unofficialImportFromGitlab-PPC/powerpc-laptop-mobo/Xpedition/Mas100n1 ACB_0001_0/Output/AutoCad/CCI02102020_0001 - Copia.jpg

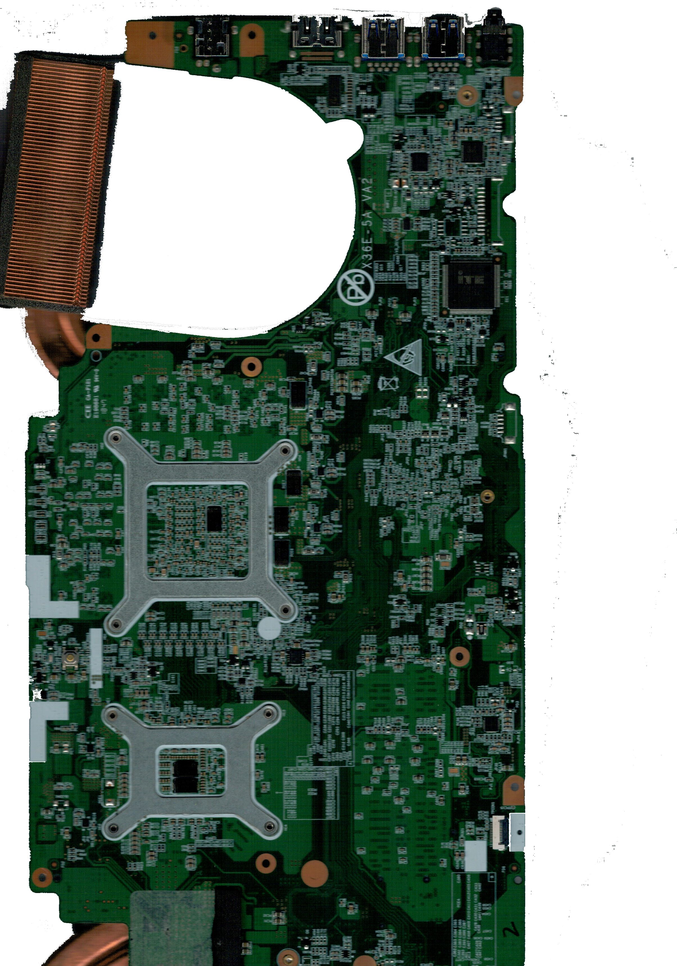
Xpedition/Mas100n1 ACB_0001_0/Output/AutoCad/CCI02102020_0001 - Copia.jpg
