unofficialImportFromGitlab-PPC/powerpc-laptop-mobo/README.md

Open Hardware PowerPC Notebook motherboard
https://www.powerpc-notebook.org/
https://www.powerprogress.org/
Copyright (C) 2018-2019-2020, Power Progress Community
CERN Open Hardware Licence v1.2
