unofficialImportFromGitlab-PPC/powerpc-laptop-mobo/Xpedition/Mas100n1 ACB_0001_0/Config/CCZSettings.txt

.FILETYPE CCZ_EXPORT_SETTINGS
.VERSION "VB99.1"
.DATE "02/20/2021 19:18:10"

!  This file contains settings for the most recent CCZ export session

.OUTPUT_FILE "D:\\PD-Master\\Mas\\Mas100n1 ACB_0001_0\\Output\\PCB Simulation\\Mas100n1 ACUBE_PORTABILE R_0.cce"
.UNITS mm

.CELL_LIBRARY 1

.HAZARDS 0

.MATERIALS 1

.UID 0

.INSTANCE_SPECIFIC_CELLS 1

.VARIANTS 1

.SCHEME "Default"
 ..SCHEME_LOCATION Local

 ..SCHEME_CHANGED 0
