unofficialImportFromGitlab-PPC/powerpc-laptop-mobo/Xpedition/Mas100n1 ACB_0001_0/Config/DXFSettings.txt

.FILETYPE DXF_EXPORT_SETTINGS
.VERSION "VB99.1"
.DATE "11/17/2020 17:44:55"

!  This file contains settings for the most recent DXF export session

.UNITS mm

.SCHEME "Default"
 ..SCHEME_LOCATION Local

.FILL_PADS 0

.BOARD_CONTENTS 0

.MIRROR_OUTPUT 0

.ITEM "Assembly Outlines Top"
 ..LAYER "Assembly_Outlines_Top"
 ..EXPORT 1

.ITEM "Board Outline"
 ..LAYER "Board_Outline"
 ..EXPORT 1
