unofficialImportFromGitlab-PPC/powerpc-laptop-mobo/Xpedition/Mas100n1 ACB_0001_0/Logic/classi segnali.docx

ddr3:

LEGGERE IL DOCUMENTO

Hardware and Layout Design Considerations for DDR3 SDRAM Memory Interfaces

EGNALI SD

SD_D0-SD_D3

SD_CLKS

SD-CMD

SEGNALI SD CON LUNGHEZZA INFERIORE A 10CM.

USB: Segnali USB a 90 ohm differenziali.

USB1_DP

USB1_DP

USB2_DP

USB2_DP

HUB_USB1_DP

HUB_USB1_DN

HUB_USB2_DP

HUB_USB2_DN

HUB_USB3_DP

HUB_USB3_DN

HUB_USB4_DP

HUB_USB4_DN

Segnali ethernet 100 ohm differenziali.

Segnali Ethernet:

TXRXP_A

TXRXM_A

TXRXP_B

TXRXM_B

TXRXP_C

TXRXM_C

TXRXP_D

TXRXM_D

Segnali PCIe

Segnali USB a 100 ohm differenziali.

USB3 90 OHM DIFFERENIALE

Video:

Display Port 100 ohm diferenziale.
