unofficialImportFromGitlab-PPC/powerpc-laptop-mobo/Xpedition/Mas100n1 ACB_0001_0/Logic/commenti/COMMENTI.docx

LAYER7

USB2_DP/DN è a 100 va fatta a 90 ohm

a 90 OHM VANNO FATTI ANCHE QUESTI:

HUB_USB1_DP/DN 90 OHM VANNO

USB_CAM_DN/DP

USB1_DN/DP

USB2_DN/DP

U2DM4/U2DP4

U2DM3/U2DP3

U2DM2/U2DP2

U2DM1/U2DP1

U3TXDP1/U3TXDN1

U3TXDP2/U3TXDN2

U3RXDP1/U3RXDN1

U3RXDP2/U3RXDN2

I CONDENSTATORI SOTTOSTANTI VANNO PIAZZATI VICINO A U1:

SEGNALI SATA, VANNO FATTI A 100 OHM

SATA_PCIE_RX0P/N

SATA_PCIE_RX1P/N

SEGNALI

PTX_0P/N E SATA_PCIE_TX0P/N

PTX_1PN E SATA_PCIE_TX1P/N

SATA_PECLKP/N

S3_TXP/N

S3_RXP/N

S2_TXP/N

S2_RXP/N

S1_TXP/N

S1_RXP/N

S0_TXP/N

S0_RXP/N
