unofficialImportFromGitlab-PPC/powerpc-laptop-mobo/Xpedition/Mas100n1 ACB_0001_0/Output/AutoCad/MisureSchedeSmartbook.pdf

## pin-out

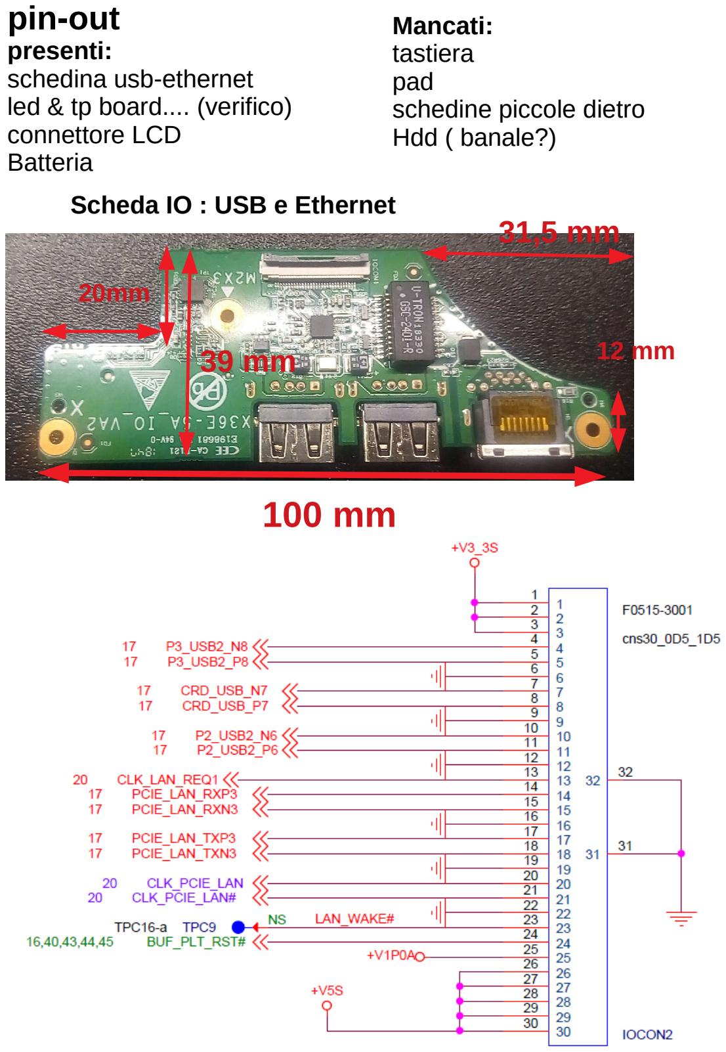
[picture p3: page 1]

presenti:
schedina usb-ethernet
led & tp board.... (verifico) connettore LCD
Batteria
Scheda IO : USB e Ethernet

100 mm

### 12 mm 39 mm

31,5 mm

20mm

Mancati:
tastiera
pad
schedine piccole dietro
Hdd ( banale?)

165 mm

8.5

LED & Touch Pad Board (davanti)

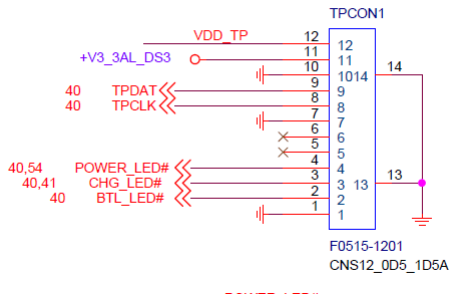
[picture p4: figure]

MXM 3.0 A 82x70mm

AMD E9172 MXM

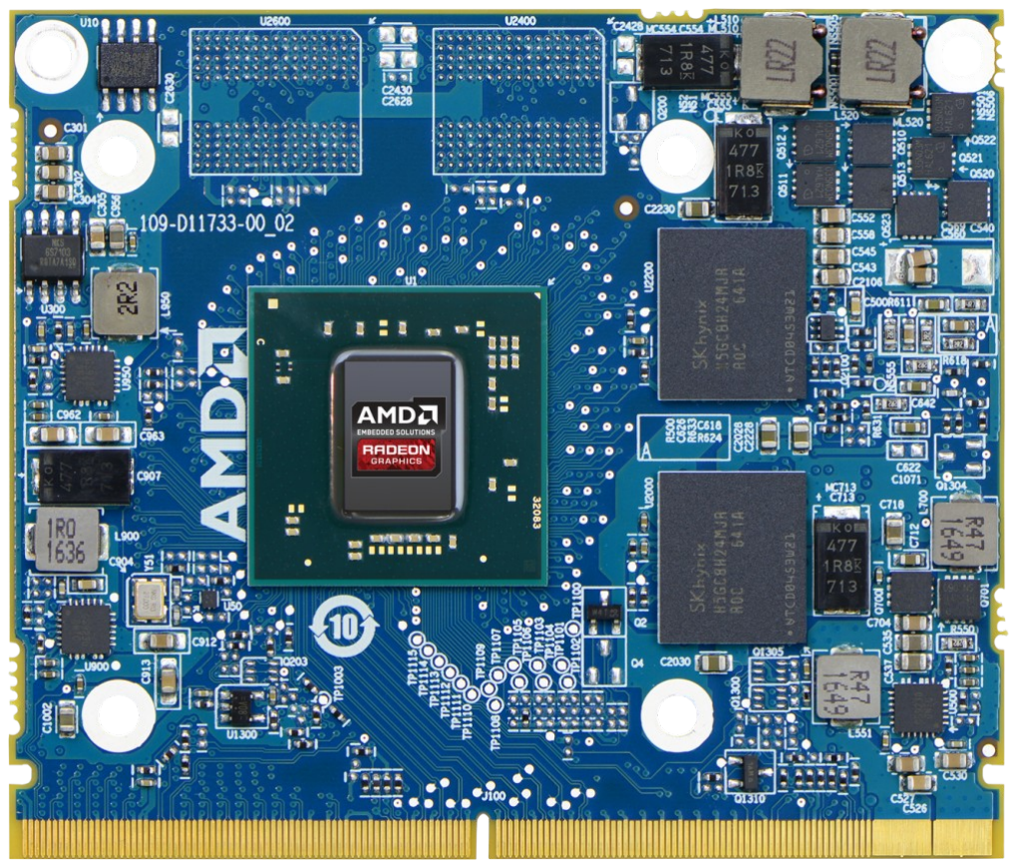
[picture p5: figure]

## Main Board

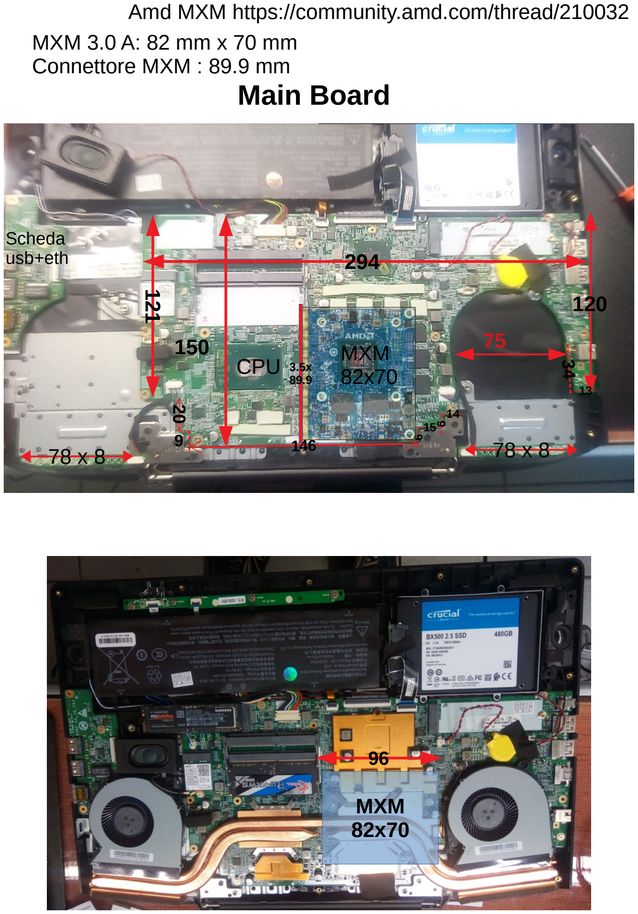
[picture p6: page 4]

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
MXM 3.0 A: 82 mm x 70 mm
Connettore MXM : 89.9 mm

96

Amd MXM https://community.amd.com/thread/210032

MXM
82x70

CPU

78 x 8 | 78 x 8

Scheda
usb+eth

MXM
82x70 ³.5x
89.9

pinout of LCD connector

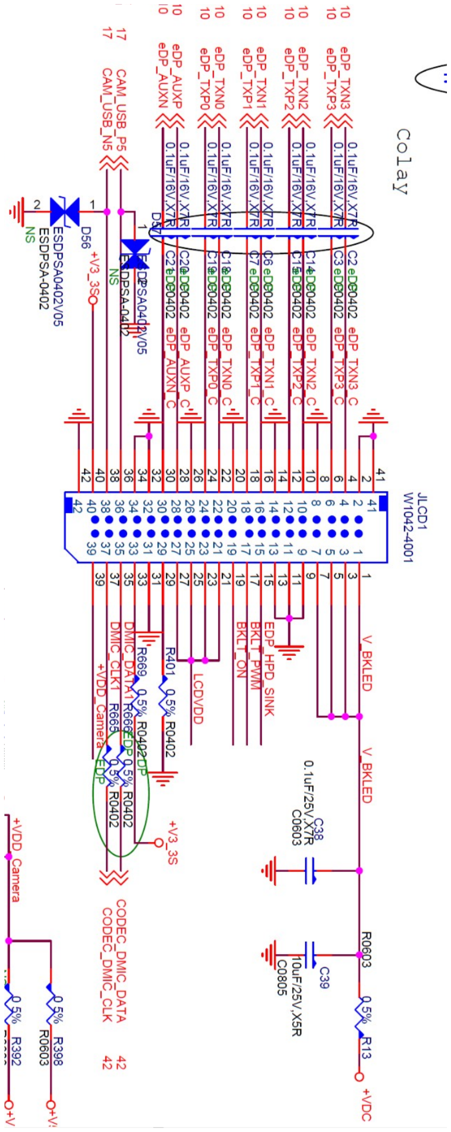
[picture p7: figure]
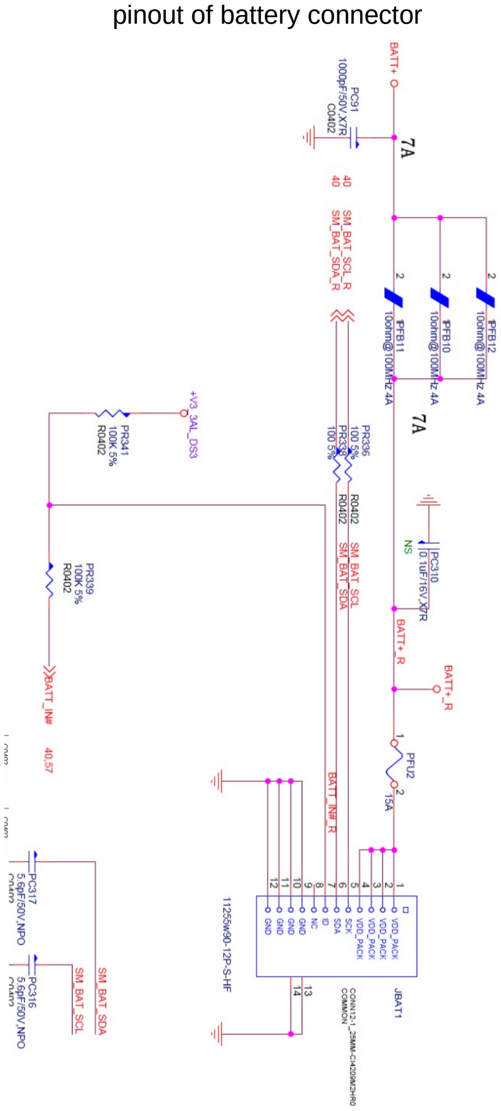
[picture p8: page 6]

pinout of battery connector

## Dissipatori

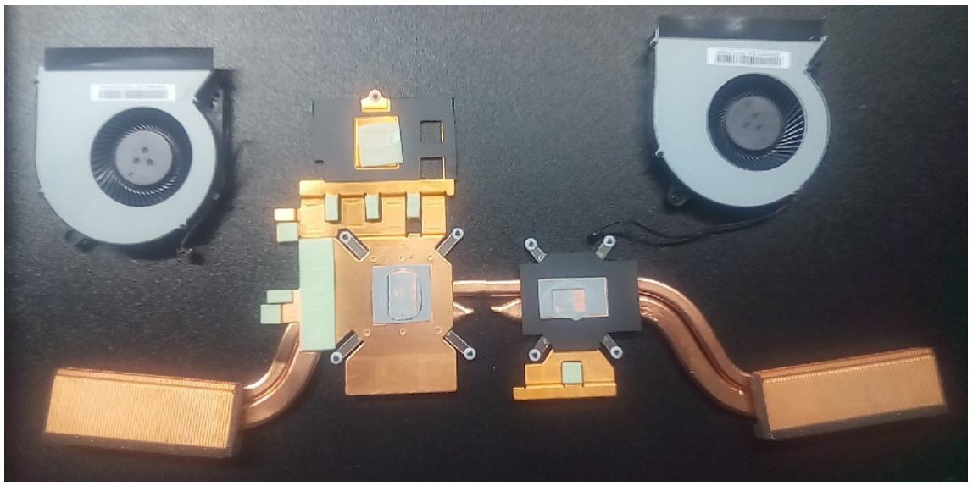
[picture p9: figure]
