unofficialImportFromGitlab-PPC/powerpc-laptop-mobo/Xpedition/Mas100n1 ACB_0001_0/Logic/commenti/LAN_PCIE_RXP_N.png

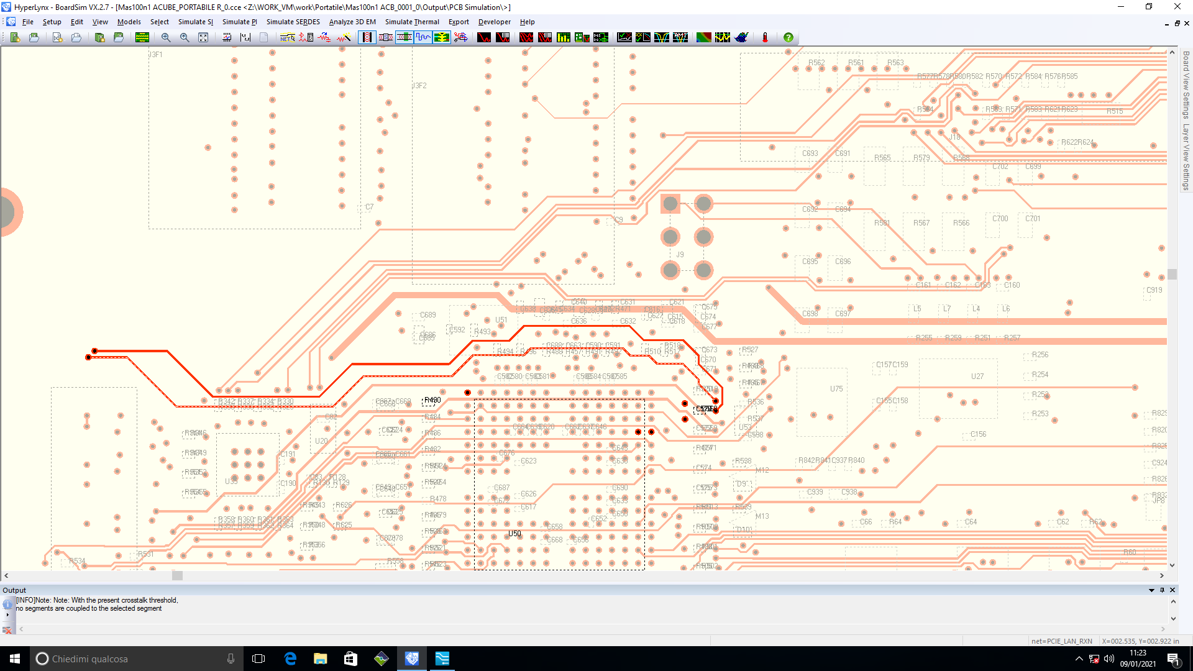
Xpedition/Mas100n1 ACB_0001_0/Logic/commenti/LAN_PCIE_RXP_N.png
