unofficialImportFromGitlab-PPC/powerpc-laptop-mobo/Xpedition/Mas100n1 ACB_0001_0/Logic/commenti/LAYER_10_NET2_FORO.png

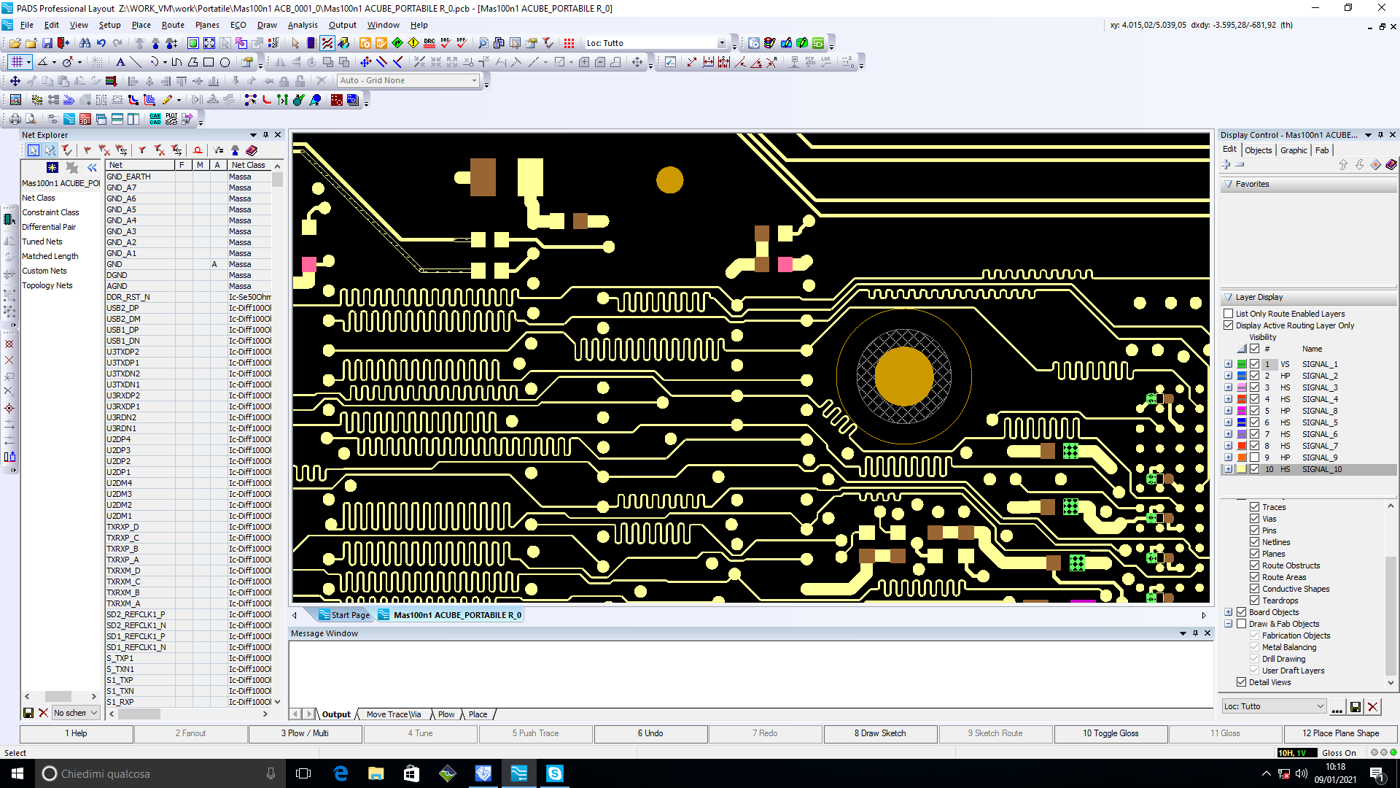
Xpedition/Mas100n1 ACB_0001_0/Logic/commenti/LAYER_10_NET2_FORO.png
