unofficialImportFromGitlab-PPC/powerpc-laptop-mobo/Xpedition/Mas100n1 ACB_0001_0/Logic/commenti/LFE_NET2_BORDO.png

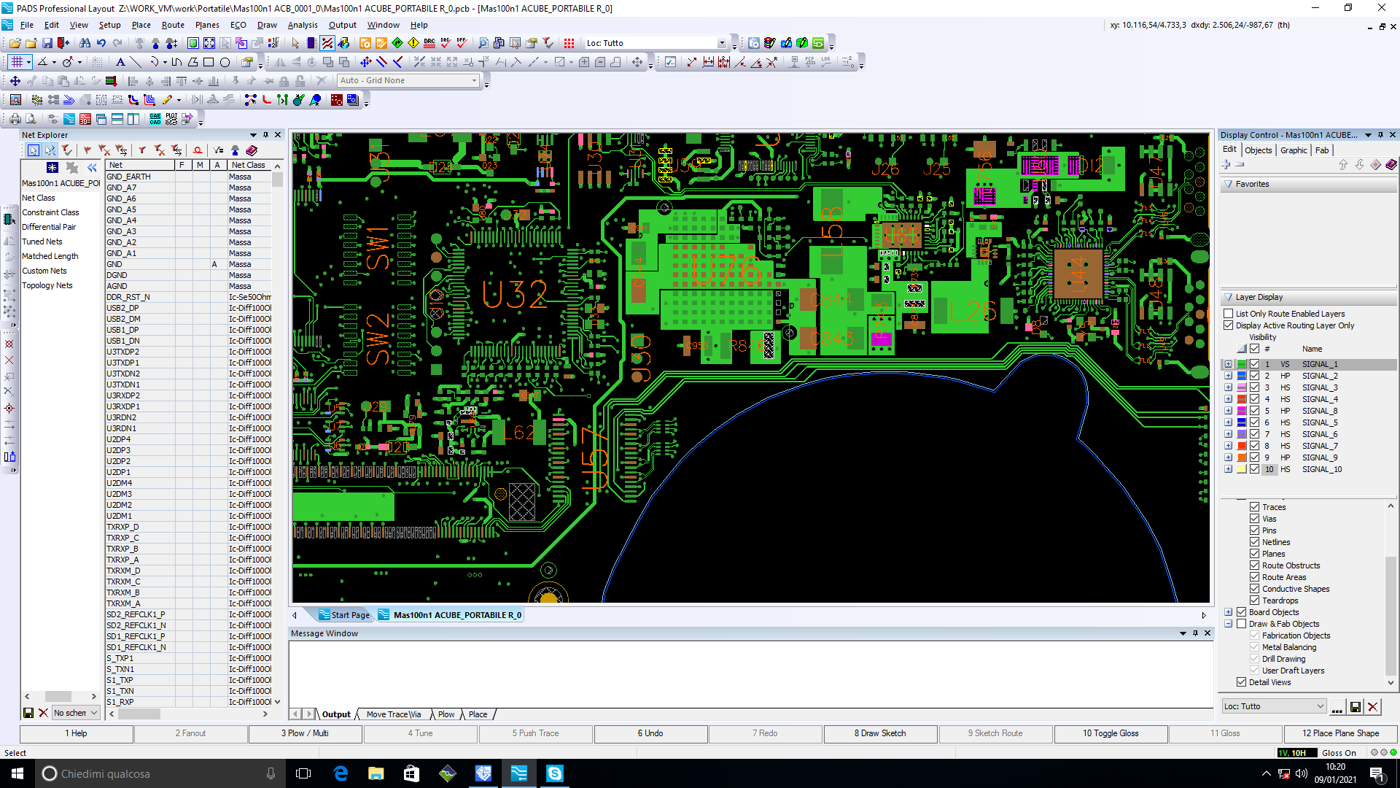
Xpedition/Mas100n1 ACB_0001_0/Logic/commenti/LFE_NET2_BORDO.png
