unofficialImportFromGitlab-PPC/powerpc-laptop-mobo/Xpedition/Mas100n1 ACB_0001_0/Logic/bom_portatile.ods

Item Number | Quantity | Part Reference | Value | Description | PCB Footprint | Manufacturer 1 | Manufacturer Part Number 1 | Distributor 1
1 | 9 | BATT1 BTH1 JP1 JP3 JP4 JP5 JP6 JP7 JP8 | 3V 5mAh | BATTERY LITHIUM COIN 3V 6.8mm Rechargable |  | Panasonic - BSG | ML-621S/ZTN | DIGIKEY (P007-ND)
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
16 | 4 | C209 C225 C235 C259 | 4,7nF | COND.CER. 4,7nF 50V 0402 X7R SMD | SMD_0402 | MURATA | GRM155R71H472KA01D | DIGIKEY(490-1308-2-ND)
17 | 23 | C211 C212 C214 C215 C216 C217 C218 C221 C226 C227 C231 C232 C233 C248 C249 C272 C273 C555 C588 C589 C985 C988 C990 | 100nF | COND.CER.100NF 50V 0603 X7R SMD | SMD_0603 | PANASONIC | ECJ1VB1H104K | CLAITRON LASI SILVESTAR S.R.L.
18 | 31 | C222 C223 C250 C251 C252 C274 C275 C276 C277 C278 C279 C283 C284 C288 C289 C290 C291 C292 C293 C294 C295 C296 C297 C298 C299 C300 C301 C302 C306 C307 C308 | 100NF | LCC - SMD/SMT 0201 0.1uF 10volts X7S +/-10% | SMD_0201 | TDK | C0603X7S1A104K030BC | MOUSER(810-C0603X7S1A104K )
19 | 10 | C229 C230 C245 C246 C267 C268 C345 C346 C366 C367 | 2.2UF | CAP CER 2.2UF 25V X5R 0402 | SMD_0402 | MURATA | GRM155R61E225ME15D | DIGIKEY(490-10457-2-ND)
20 | 6 | C247 C271 C347 C368 C845 C983 | 3,3NF | COND.CER. 3,3NF 50V 0402 X7R SMD | SMD_0402
21 | 12 | C282 C287 C305 C311 C703 C704 C705 C706 C707 C708 C709 C710 | 220NF | COND.CER. 220NF 10V 0402 X7R SMD | SMD_0402 | MURATA | GRM155R61A224KE19 | MURATA ELETTRONICA SPA
22 | 2 | C387 C392 | 27PF | CAP CER 27PF 50V 5% NP0 0402 | SMD_0402 | TDK | C1005C0G1H270J | DIGIKEY (445-1240-1-ND)
23 | 49 | C390 C395 C396 C397 C400 C401 C402 C405 C406 C409 C412 C413 C414 C415 C416 C417 C446 C450 C454 C458 C462 C468 C472 C473 C474 C475 C477 C478 C479 C482 C486 C531 C532 C533 C534 C535 C536 C537 C538 C539 C540 C541 C542 C543 C544 C545 C548 C549 C968 | 10NF | COND.CER. 10NF 50V 0402 X7R SMD | SMD_0402 | KEMET | C0402C103K5RACTU | TTI ITALY SRL
24 | 8 | C447 C451 C455 C459 C463 C469 C483 C487 | 1NF | COND.CER. 1NF 50V 0402 NPO SMD | SMD_0402 | YAGEO | 223858715523 | CLAITRON LASI SILVESTAR S.R.L.
25 | 2 | C464 C465 | 18PF | CAP CER 18PF 50V 5% NP0 0402 | SMD_0402 | TDK | C1005C0G1H180J | DIGIKEY (445-1238-1-ND)
26 | 1 | C488 | 100uF | CAP CER 100UF 6.3V 20% X5R 0805 | SMD_0805 | MURATA | GRM21BR60J107ME15L | FARNELL(2494476)
27 | 2 | C558 C559 | 8pF | CAP CER 8PF 50V C0G/NPO 0402 | SMD_0402 | yageo | CC0402DRNPO9BN8R0 | DIGIKEY (311-1639-1-ND)
28 | 1 | C597 | 150PF | COND.CER. 150PF 50V 0402 5% COG SMD | SMD_0402 | MURATA | GRM1555C1H151JD01D | MURATA ELETTRONICA SPA
29 | 4 | C599 C600 C601 C602 | 100uF | COND.CER.100uF 6,3V 1210 X5R 20% SMD | SMD_1210 | MURATA | GRM32ER60J107ME20L | MURATA ELETTRONICA SPA
30 | 4 | C609 C610 C611 C614 | 33PF | COND.CER. 33PF 50V 0402 5% COG SMD | SMD_0402 | Murata | GRM1555C1H330JZ01D_ | MURATA ELETTRONICA SPA
31 | 4 | C680 C764 C958 C981 | 22PF | COND.CER. 22PF 50V 0402 NPO 5% SMD | SMD_0402 | MURATA | GRM1555C1H220JZ01 | MURATA ELETTRONICA SPA
32 | 1 | C740 | 1NF | CAP CER 1000PF 2KV 20% X7R 1808 | SMD_1808 | AVX | 1808GC102MAT1A | DIGIKEY(709-1040-1-ND)
33 | 2 | C744 C761 | 10uF | COND.CER.10uF 6,3V 10% 0805 X5R SMD | SMD_0805 | KEMET | C0805C106K9PA!A | TTI ITALY SRL
34 | 2 | C745 C746 | 20PF | COND.CER. 20PF 50V 0402 NP0 SMD | SMD_0402 | MURATA | GRM1555C1H200JZ01D | MURATA ELETTRONICA SPA
35 | 1 | C756 | 220uF | CAP TANT 220UF 16V 10% 2917 | SMD_CASE_D | Kemet | T491D227K016ZT | DIGIKEY (399-5124-1-ND)
36 | 5 | C767 C768 C770 C771 C773 | 1uF | CAP CER 1UF 10V 10% X5R 0402 | SMD_0402 | MURATA | GRM155R61A105KE15D | DIGIKEY (490-3890-1-ND)
37 | 14 | C780 C781 C787 C789 C790 C791 C794 C795 C888 C891 C907 C908 C923 C924 | 100PF | COND.CER. 100PF 50V 0402 NPO 5% SMD | SMD_0402 | MURATA | GRM1555C1H101JD01D | MURATA ELETTRONICA SPA
38 | 2 | C783 C785 | 1UF | CAP CER 1.0UF 6.3V 10% X5R 0402 | SMD_0402 | MURATA | GRM155R60J105KE19D | DIGIKEY (490-1320-2-ND)
39 | 2 | C786 C788 | 100PF | 0402 100pF 50volts C0G 5% | SMD_0402 | MURATA | GRM1555C1H101JZ01D | MOUSER(81-GRM1555C1H101JZ1D)
40 | 8 | C796 C797 C798 C799 C833 C951 C956 C957 | 100uF | CAP CER 100UF 16V 20% X5R 1210 | SMD_1210 | Taiyo Yuden | EMK325ABJ107MM-T | DIGIKEY (587-3152-2-ND)
41 | 2 | C810 C811 | 2pF | CAP CER 2PF 50V C0G/NPO 0402 | SMD_0402 | yageo | CC0402CRNPO9BN2R0D | DIGIKEY(311-1006-2-ND)
42 | 2 | C838 C852 | 330pF | CAP CER 330PF 50V 5% C0G 0402 HiRel | SMD_0402 | TDK | CGJ2B2C0G1H331J050BA | DIGIKEY(445-8059-1-ND)
43 | 4 | C841 C843 C844 C846 | 470uF | COND.TANT. 470uF 2v CASE-GX SMD | SMD_CASE_GX | PANASONIC | EEF-GX0D471R | MOUSER(667-EEFGX0D471R)
44 | 3 | C847 C848 C849 | 22UF | CAP CER 22UF 16V 10% X5R 1206 | SMD_1206 | SAMSUNG | CL31A226KOHNNNE | DIGIKEY (1276-3048-2-ND)
45 | 1 | C850 | 2,2UF | CAP CER 2.2UF 25V X5R 0402 | SMD_0402 | Murata | GRM155R61E225ME15D | DIGIKEY ( 490-10457-2-N)
46 | 1 | C851 | 4,7UF | CAP CER 4.7UF 10V 20% X5R 0402 | SMD_0402 | TDK | C1005X5R1A475M050BC | DIGIKEY (445-8023-1-ND)
47 | 1 | C944 | 100uF | CAP ALUM 100UF 35V 20% SMD | SMD_6.3X6.3x6.1 | Panasonic | EEE-FT1V101AP | MOUSER (667-EEE-FT1V101AP)
48 | 3 | C962 C970 C973 | 100nF | COND.CER.100NF 25V 0603 X7R SMD | SMD_0603 | PHILIPS | PHY223891615649 | CAMEL ELETTRONICA SRL #
49 | 1 | C969 | 1,5nF | COND.CER. 1,5nF 50V 0402 X7R SMD | SMD_0402 | YAGEO | 04022R152J9B20D | CLAITRON LASI SILVESTAR S.R.L.
50 | 1 | C971 | 68NF | COND.CER. 68NF 50V 0402 X7R SMD | SMD_0402 | MURATA | GRM155R61C683KA01J | MURATA ELETTRONICA SPA
51 | 1 | C972 | 150NF | CAP CER 0.15UF 16V 10% X7R 0402 | SMD_0402 | TDK | C1005X7R1C154K050BC | DIGIKEY(445-5934-1-ND)
52 | 1 | C982 | 100uF | CAP ALUM 100UF 35V 20% SMD | SMD_8.3X8.3 | United chemi-Con | EMVY350ADA101MHA0G | DIGIKEY (565-2477-1-ND)
53 | 1 | C991 | 220NF | COND.CER. 220NF 10V 0402 X5R SMD | SMD_0402 | TAIYO YUDEN | LMK105BJ224KV-F | DIGIKEY(587-1228-1-ND)
54 | 2 | CN1 CN2 | 0483950003 | CONN RCP USB3.0 TYPEA 9POS TH RA MID mount | 9 PIN PTH | molex | 0483950003 | DIGIKEY(WM10415TR-ND)
55 | 11 | D1 D3 D4 D7 D9 D10 D13 D17 D18 D19 D22 | LED VERDE | LED CHIPLED VERDE 40mcd 570nm | SMD_0603 | DIALIGHT | 598-8070-107F | MOUSER(645-598-8070-107F)
56 | 1 | D2 | BAS116 | DIODO, ALTA VELOCITÀ, SOD123 | SOD123 | NXP | BAS116H,115 | FARNELL(2319131)
57 | 3 | D5 D6 D11 | BAT54 | DIODE SCHOTTKY 30V 200MA SOT-23 | SOT-23 | ZETEX | BAT54 | FARNELL (1467516)
58 | 1 | D8 | BAS70LT1G | DIODE SCHOTTKY 70V SOT23 | SOT-23 | ON_SEMI | BAS70LT1G | DIGIKEY (BAS70LT1GOSCT-ND)
59 | 1 | D12 | B340B-13-F | DIODE SCHOTTKY 40V 3A SMB | SMB | DIODES | B340B-13-F | DIGIKEY(B340B-FDIDKR-ND)
60 | 1 | D14 | MMBZ18 | DIODO, TVS ZENER DUAL, 18V, 40W, SOT23 | SOT_23 | MOTOROLA | MMBZ18VALT1G | DIGIKEY(MMBZ18VALT1GOSCT-ND)
61 | 1 | D15 | MBR140SFT1G | DIODE SCH PWR RECT 1A 40V SOD123 | sod123lf | ON SEMICONDUCTOR | MBR140SFT1G | DIGIKEY(MBR140SFT1GOSTR-ND)
62 | 1 | D16 | LED GIALLO | LED CHIPLED GIALLO 160Deg 6.5mcd | SMD_0603 | VISHAY | TLMY1000-GS08 | MOUSER(78-TLMY1000)
63 | 1 | D20 | LED ROSSO | LED CHIPLED ROSSO | SMD_0603 | KINGBRIGHT | APT1608SRCPRV | MOUSER(604-APT1608SRCPRV)
64 | 1 | D21 | BAS70-05-7-F | DIODE SCHOTTKY 70V 70MA SOT23 | SOT-23 | DIODES | BAS70-05-7-F | DIGIKEY(BAS70-05FDICT-ND)
65 | 3 | D23 D24 D25 | B130LAW-7-F | DIODE SCHOTTKY 30V 1A SOD123 | SOD-123 | DIODES | B130LAW-7-F | DIGIKEY (B130LAW-FDICT-ND)
66 | 1 | D26 | 1.5SMC36CA | 1.5SMC36A VARISTORE BIDIREZION. 36V SMD | SMC | LITTLEFUSE | 1.5SMC36CA | EBV ELEKTRONIK S.R.L.
67 | 2 | FL1 FL2 | NFM18PC105R0J3D | FILTER LC HIGH FREQ 1UF 0603 | SMD_0603 | MURATA | NFM18PC105R0J3D | DIGIKEY(490-6970-1-ND)
68 | 10 | FL3 FL4 FL5 FL6 FL7 FL8 FL9 FL10 FL11 FL12 | DLP11SN161SL2 | CHOKE COMMON MODE 90 OHM 0805 | SMD | MURATA | DLW21HN900SQ2L | DIGIKEY(490-1064-1-ND)
69 | 2 | FL13 FL14 | MCZ2010CH900L4T | CHOKE COMM MODE 90 OHM SMD HDMI | SMD | TDK | MCZ2010CH900L4T | DIGIKEY(445-9345-1-ND)
70 | 1 | FUSE1 | 0470.500DR | Surface Mount Fuses SMD FA 0.5A | SMD | LITTLEFUSE | 0470.500DR | MOUSER(576-0470.500DR )
71 | 1 | J1 | JMP 3 | STRIP MASC.1x3P CS.p=2 mm | PTH | 3M | 951103-8622-AR | DIGIKEY(3M9322-ND)
72 | 1 | J2 | DM3AT | CONN MICRO SD R/A PUSH-PULL SMD | SMD 9 PIN | HIROSE | DM3AT-SF | DIGIKEY (HR1964CT-ND)
73 | 1 | J3 | STRIP 16 | STRIP MASCH.2x8P CS.p=2.0mm SMT | 8X2P=2.0mm SMT | SAMTEC | TMMH-108-01-L-DV | FARNELL(2024017)
74 | 1 | J4 | SFW30R-1STE9LF | FFC e FPC 30P SIDE ENTRY SMT 1MM LOWER CONTACT | 30 PIN PASSO 1mm | AMPHENOL | SFW30R-1STE9LF | MOUSER(649-SFW30R-1STE9LF)
75 | 1 | J5 | 5051101292 | CONN FPC BOTTOM 12POS .5MM R/A | 12 PIN PASSO 0.5mm | MOLEX | 5051101292 | DIGIKEY(WM12368TR-ND)
76 | 1 | J6 | 0527460471 | CONN FFC/FPC 0.5MM 4POS R/A BOT CONT SMD | 4 PIN PASSO 0.5mm | MOLEX | 0527460471 | DIGIKEY(WM6768TR-ND)
77 | 2 | J7 J8 | SM12B-SRSS-TB(LF)(SN) | CONN HEADER FOT FPC 12x1POS 1MM SMD | 12 pin smd p=1mm | JST | SM12B-SRSS-TB(LF)(SN) | DIGIKEY(455-1812-2-ND)
78 | 1 | J9 | STRIP 2x3 | STRIP MASC.2x3P CS.p=2.54mm | 2.54mm | TE CONNECTIVITY / AMP | 9689567RL
79 | 1 | J10 | STRIP 8 | STRIP MASC.1x8P CS.p=2.54mm | PTH | SAMTEC | TSW-108-24-T-S | CLAITRON LASI SILVESTAR S.R.L.
80 | 1 | J11 | STRIP_14 | STRIP MASCH 1X14P p=2.54mm PTH | PTH | MOLEX | 0022284143 | DIGIKEY(WM50016-14-ND)
81 | 1 | J12 | MCV 1,5/12-G-3,5 | 12X1 3.5 | 12X1 3.5 | PHOENIX | MCV 1,5/12-G-3,5 | SAMTEC
82 | 1 | J13 | MDT180M01001 | Connettori PCI Express/PCI 67P SMT RCPT H1.8 M Key | 67 PIN PASSO 0.5mm | AMPHENOL | MDT180M01001 | MOUSER(523-MDT180M01001)
83 | 1 | J14 | 54132-3062 | CONN FPC/FFC .50mm 30 pos bot contact | 30 PIN PASSO 0.5mm | MOLEX | 54132-3062 | MOUSER(538-54132-3062)
84 | 1 | J15 | MDT180E01001 | Connettori PCI Express/PCI 67P SMT RCPT H1.8 E Key | 67 PIN PASSO 0.5mm | AMPHENOL | MDT180E01001 | MOUSER(523-MDT180E01001)
85 | 1 | J16 | MDT180B01001 | Connettori PCI Express/PCI 67P SMT RCPT H1.8 B Key | 67 PIN PASSO 0.5mm | AMPHENOL | MDT180B01001 | MOUSER(523-MDT180B01001)
86 | 1 | J17 | SIM Holder 6p | CONNECTOR SIM CARD W/OUT BOSS | SMD 6 PIN | AVX | 045036006211862+ | Mouser(581-045036006211862+)
87 | 1 | J18 | MM70-314-310B1-2-R300 | MXM3.0 CARD EDGE CONNECTOR | 324 PIN 0.5mm | JAE ELECTRONICS | MM70-314-310B1-2-R300 | MOUSER(656-MM70314310B12R)
88 | 1 | J19 | 2041481-1 | HDMI TYPE A RECEPT RA SMD OFFSET CONN | 19 PIN SMD | TE | 2041481-1 | MOUSER (571-2041481-1)
89 | 1 | J20 | DF13A-40DP-1.25V(55) | Terminali e capicorda 1.25MM V PIN HEADER 40P SMT | SMD 2X20 P_125MM | HIROSE | DF13A-40DP-1.25V(55) | DIGIKEY(H10166-ND)
90 | 1 | J21 | SJ-43504-SMT-TR | 3.5 PHONEJACK TRRS MID Mount | SMT | CUI Inc | SJ-43504-SMT-TR | DIGIKEY(CP-43504SJCT-ND - Cut )
91 | 3 | J22 J23 J24 | 0533980271 | HDR 2 CKT VERTICAL 1.25MM | 2P SMD | MOLEX | 0533980271 | DIGIKEY(WM7606CT-ND)
92 | 2 | J25 J26 | POM-5046P-C3310-R | MIC COND ANALOG OMNI -46DB 6MM D | 6X5_2 (mm) | PUI AUDIO | POM-5046P-C3310-R | DIGIKEY(668-1677-ND)
93 | 1 | J27 | 53780-1270 | Terminali e capicorda 1.25 WtB ssy 12Ckt | 1X12 1.25mm smd | MOLEX | 53780-1270 | MOUSER(538-53780-1270)
94 | 2 | J28 JP9 | JMP 3 | STRIP MASC.1x3P CS.p=2.54mm | PTH | SAMTEC | TLW-103-05-G-S | FARNELL(1668490)
95 | 3 | J29 J32 J33 | JMP 2 | STRIP MASC.1x2P P=2.54 H=7.62 | PTH | SAMTEC | TLW-102-05-G-S | FARNELL(1668488)
96 | 2 | J30 J31 | B3B-XH-A (LF)(SN) | CONN WIRE TO BOARD HEADER. VERTICAL. 3WAY | 3_PIN_PASSO_2.5mm | JST | B3B-XH-A (LF)(SN) | FARNELL (1516277)
97 | 1 | J34 | 694105309102 | CC WR-DC PwrJk CtrPnTHT Right Angled | JACK_PTH | WURTH | 694105309102 | MOUSER(710-694105309102)
98 | 1 | J3F1 | 2013022-1 | Connettori DIMM SEMI-HARD TRAY DDR3 204P 4H STD | 204 PIN PASSO 0.6mm | TE CONNECTIVITY | 2013022-1 | MOUSER(571-2013022-1)
99 | 1 | J3F2 | 2-2013310-1 | DIMM EMBOSS TAPE DDR3 204P 9.2H STD | 204 PIN PASSO 0.6mm | TE | 2-2013310-1 | MOUSER(571-2-2013310-1)
100 | 1 | JPS1 | SOLDER JUMPER X 2 | SODER JUMPER SU PCB | PCB
101 | 30 | L1 L2 L3 L4 L5 L6 L7 L8 L9 L10 L23 L27 L28 L29 L30 L32 L44 L45 L46 L47 L48 L49 L50 L51 L52 L53 L54 L55 L56 L57 | BLM18EG601SN1 | FERRITE BEAD 600ohm 500mA 0603 SMD | SMD_0603 | MURATA | BLM18EG601SN1 SMD | MURATA ELETTRONICA SPA
102 | 5 | L11 L12 L13 L14 L15 | HF70ACB201209-T | FERRITE CHIP 10 OHM 600MA 0805 | SMD_0805 | TDK | HF70ACB201209-T | DIGIKEY (445-6180-1-ND)
103 | 8 | L16 L17 L18 L20 L21 L22 L24 L25 | BLM15GG471SN1D | FERRITE CHIP 470 OHM 200MA 0402 | SMD_0402 | MURATA | BLM15GG471SN1D | DIGIKEY ( 490-5198-1-ND)
104 | 1 | L19 | 7427927161 | FERRITE BEAD 600R 0.25A 0402 | SMD_0402 | WURTH | 7427927161 | FARNELL (1961693)
105 | 1 | L26 | 3.3uH | INDUCTOR SHIELD PWR 3.3UH SMD | SMD_SRU1028 | BOURNS INC. | SRU1028-3R3Y | DIGIKEY (SRU1028-3R3YCT-ND)
106 | 1 | L31 | 1uH | Induttori fissi 1.0uH 2.08A 68mOhms Pwr Circuit Inductor | Ind_2016 | TDK | VLS201612CX-1R0M | MOUSER(810-VLS201612CX-1R0M )
107 | 1 | L33 | 15uH | INDUCTOR POWER .68UH 17A SMD 6.90mm x 6.90mm | SMD | WURTH | 744311068 | DIGIKEY(732-1149-1-ND)
108 | 10 | L34 L35 L36 L37 L38 L39 L40 L41 L42 L43 | BLM15AG121SN1D | FERRITE CHIP 120 OHM 500MA 0402 | SMD_0402 | MURATA | BLM15AG121SN1D | DIGIKEY (490-1005-2-ND)
109 | 1 | L58 | 270nH | Induttori fissi 270nH Shld 20% 35.5A 228mOhms | SMD_7_65X11mm | COILCRAFT | SLC1175-271MEB | MOUSER(994-SLC1175-271MEB)
110 | 4 | L60 L61 L62 L65 | 1uH | FIXED IND 1UH 11A 16.5 Mohm SMD | SMD | VISHAY | IHLP2525CZER1R0M01 | MOUSER(70-IHLP2525CZER1R0M0)
111 | 2 | L63 L64 | 2.2uH | FIXED IND 2.2UH 7A 16.5 Mohm SMD | SMD | VISHAY | IHLP2525CZER2R2M1 | MOUSER(70-IHLP2525CZER2R2)
112 | 1 | L66 | 10uH | Induttori fissi WE-HCI Flat 1050 10uH 7.2A | SMD_10_2X10_5 | WURTH | 7443251000 | MOUSER(710-7443251000)
113 | 1 | L67 | 22uH | INDUTTANZA 22uH 1,67A DR73-220 SMD | SMD_DR73 | COILTRONICS | DR73-220-R | CLAITRON LASI SILVESTAR S.R.L.
114 | 1 | L68 | ACM1513-551-2PL-TLHF | CHOKE COMM MODE 550 OHM 10A SMD | SMD | TDK | ACM1513-551-2PL-TLHF | DIGIKEY(445-9331-1-ND)
115 | 1 | M1 | MT8KTF51264HZ-1G6 |  | none
116 | 1 | M2 | MT8KTF51264HZ-1G6 |  | none
117 | 7 | M3 M4 M5 M6 M7 M8 M9 | DMN3730U-7 | DMN3730U-7 N 750mA 30V POWER MOS | SOT23 | DIOES | DMN3730U-7 | DIGIKEY(DMN3730U-7DICT-ND)
118 | 5 | M10 M11 M12 M13 M14 | FDV301N | FDV301N N CHANNEL DIGITAL FET | SOT23 | FAIRCHILD | FDV301N (ROHS COMPLIANT) | CLAITRON LASI SILVESTAR S.R.L
119 | 9 | Q1 Q2 Q14 Q15 Q16 Q17 Q18 Q19 Q20 | 2N7002L | TRAN NMOS 60V 115MA SOT23 | SOT23 | ON SEMICONDUCTORS | 2N7002LT1G | DIGIKEY(2N7002LT3GOSCT-ND)
120 | 1 | Q11 | SI4925DY | Trans MOSFET P-CH 30V 5.3A 8-Pin SOIC | SOIC_8 | ON SEMICONDUCTOR | SI4431ADY-T1 | ARROW (SI4431ADY-T1)
121 | 1 | Q3 | BC856BLT1G | TRANS PNP 65V 0.1A SOT23 | SOT_23 | ON SEMICONDUCTOR | BC856BLT1G | DIGIKEY(BC856BLT1GOSCT-ND)
122 | 1 | Q4 | BC847ALT1G | TRANS NPN 45V 0.1A SOT23 | SOT_23 | ON SEMI | BC847ALT1G | DIGIKEY (BC847ALT1GOSCT-ND)
123 | 4 | Q5 Q6 Q7 Q8 | NDC7002N | MOSFET 2N-CH 50V 0.51A SSOT6 | SSOT_6 | ON SEMI | NDC7002N | DIGIKEY (NDC7002NCT-ND)
124 | 1 | Q9 | BSR17A | TRANS NPN 40V 0.2A SOT-23 | SOT_23 | ON SEMI | BSR17A | DIGIKEY(BSR17ATR-ND)
125 | 1 | Q12 | SI4431ADY-T1 | Trans MOSFET P-CH 30V 5.3A 8-Pin SOIC | SOIC_8 | VISHAY | SI4431ADY-T1 | ARROEW (FDC645N)
126 | 1 | Q13 | FDC655BN | MOSFET N-CH 30V 6.3A 6-Pin TSOT-23 | TSOT-23 | ON SEMI | FDC655BN | ARROW (FDC655BN)
127 | 3 | Q21 Q22 Q23 | IRLML6346TRPBF | MOSFET N-CH 30V 3.4A SOT23 | SOT-23 | ON SEMI | IRLML6346TRPBF | DIGIKEY (IRLML6346TRPBFCT-ND)
128 | 2 | Q24 Q25 | SiR870DP | MOSFET 100V 60A 20W 6mohm @ 4.5V | PowerPAK-1212-8 | VISHAY | SiR870DP-T1-GE3 | DIGIKEY(SiR870DP-T1-GE3CT-ND)
129 | 85 | R1 R7 R8 R10 R12 R14 R16 R18 R20 R23 R24 R25 R26 R27 R28 R29 R30 R31 R32 R33 R34 R38 R39 R48 R50 R51 R52 R53 R54 R55 R60 R63 R71 R72 R73 R74 R76 R77 R78 R79 R80 R81 R82 R83 R84 R85 R86 R87 R88 R89 R90 R91 R92 R93 R94 R95 R100 R103 R104 R105 R106 R107 R108 R109 R116 R119 R120 R121 R126 R127 R129 R130 R158 R167 R182 R183 R184 R238 R262 R263 R419 R593 R594 R879 R881 | 4,7K | RESIS.CHIP 4,7K 5% 0402 SMD | SMD_0402 | ROYAL OHM | RESIS.CHIP 4,7K 5% 0402 SMD | CAMEL ELETTRONICA SRL #
130 | 30 | R2 R5 R56 R97 R98 R135 R193 R260 R401 R402 R403 R404 R409 R410 R411 R412 R544 R671 R672 R683 R684 R685 R691 R702 R704 R720 R722 R725 R834 R836 | 1K | RESIS.CHIP 1K 1% 0402 SMD | SMD_0402 | ROYAL OHM | RESIS.CHIP 1K 1% 0402 SMD | CAMEL ELETTRONICA SRL #
131 | 2 | R3 R4 | 187 | RESIS.CHIP 187R 1% 0402 SMD | SMD_0402 | BOURNS | CR0402-FX-1870GLF | DIGIKEY(CR0402-FX-1870GLF-ND)
132 | 27 | R6 R9 R11 R13 R15 R17 R19 R21 R22 R57 R58 R59 R65 R66 R67 R68 R69 R70 R646 R654 R742 R784 R791 R804 R807 R821 R825 | 20K | RESIS.CHIP 20K 1% 0402 SMD | SMD_0402 | YAGEO | RC0402FR-1320KL | MOUSER(603-RC0402FR-1320KL)
133 | 31 | R35 R36 R37 R40 R41 R42 R43 R44 R45 R46 R47 R61 R75 R194 R279 R473 R475 R476 R477 R478 R479 R480 R481 R483 R485 R487 R489 R491 R492 R703 R705 | 33 | RESIS.CHIP 33R 5% 0402 SMD | SMD_0402 | ROYAL OHM | RESIS.CHIP 33R 5% 0402 SMD | CAMEL ELETTRONICA SRL #
134 | 14 | R49 R62 R64 R110 R132 R133 R134 R136 R137 R138 R156 R733 R734 R835 | 10 | RESIS.CHIP 10R 5% 0402 SMD | SMD_0402 | ROYAL OHM | RESIS.CHIP 10R 5% 0402 SMD | CAMEL ELETTRONICA SRL #
135 | 6 | R96 R430 R538 R539 R833 R877 | 510 | RESIS.CHIP 510R 1% 0402 SMD | SMD_0402 | ROYAL OHM | RESIS.CHIP 510R 1% 0402 SMD | CAMEL ELETTRONICA SRL #
136 | 138 | R99 R111 R112 R113 R114 R115 R118 R122 R189 R197 R198 R199 R200 R204 R205 R206 R207 R217 R218 R223 R224 R225 R226 R278 R323 R326 R327 R339 R340 R341 R353 R356 R382 R385 R396 R397 R398 R399 R400 R405 R406 R407 R408 R415 R416 R422 R431 R447 R448 R452 R453 R482 R484 R486 R488 R490 R493 R494 R496 R497 R498 R499 R500 R501 R502 R503 R504 R505 R506 R507 R508 R509 R510 R511 R512 R513 R516 R517 R518 R519 R520 R521 R522 R523 R524 R525 R526 R527 R528 R529 R533 R535 R537 R543 R548 R564 R569 R583 R585 R591 R636 R642 R687 R688 R696 R697 R781 R788 R789 R790 R792 R794 R795 R796 R799 R803 R805 R808 R809 R811 R812 R813 R814 R818 R823 R827 R828 R829 R830 R831 R832 R839 R840 R842 R861 R867 R882 R883 | 10K | RESIS.CHIP 10K 1% 0402 SMD | SMD_0402 | ROYAL OHM | RESIS.CHIP 10K 1% 0402 SMD | CAMEL ELETTRONICA SRL #
137 | 4 | R101 R117 R125 R128 | 220K | RESIS.CHIP 220K 5% 0402 SMD | SMD_0402 | ROYAL OHM | RESIS.CHIP 220K 5% 0402 SMD | CAMEL ELETTRONICA SRL #
138 | 278 | R102 R123 R124 R139 R140 R141 R142 R143 R144 R145 R148 R149 R150 R151 R152 R153 R154 R155 R174 R175 R176 R177 R178 R179 R180 R181 R185 R186 R187 R188 R212 R215 R216 R220 R222 R227 R228 R231 R232 R233 R234 R235 R236 R237 R239 R240 R241 R242 R243 R244 R245 R246 R247 R248 R249 R250 R252 R253 R254 R256 R258 R265 R266 R267 R268 R269 R270 R271 R272 R273 R274 R275 R276 R277 R280 R281 R282 R283 R284 R285 R286 R287 R288 R289 R290 R291 R292 R293 R294 R295 R296 R297 R298 R299 R300 R301 R302 R303 R304 R305 R306 R307 R308 R309 R310 R311 R312 R313 R314 R315 R316 R317 R318 R319 R320 R321 R322 R324 R325 R328 R329 R330 R331 R332 R333 R334 R335 R336 R337 R338 R342 R343 R344 R345 R346 R347 R348 R349 R350 R351 R352 R354 R355 R357 R358 R359 R360 R361 R362 R363 R364 R370 R372 R383 R384 R386 R417 R418 R420 R421 R423 R425 R427 R428 R429 R432 R433 R434 R435 R436 R437 R441 R442 R443 R444 R445 R451 R454 R455 R456 R514 R515 R530 R531 R532 R534 R536 R545 R546 R547 R549 R550 R551 R552 R553 R554 R555 R556 R557 R570 R572 R576 R577 R578 R580 R582 R584 R586 R587 R590 R597 R598 R610 R611 R612 R613 R614 R615 R616 R617 R618 R619 R620 R621 R622 R623 R624 R625 R626 R627 R628 R629 R630 R631 R633 R634 R635 R637 R641 R644 R647 R648 R649 R650 R651 R656 R657 R667 R679 R681 R693 R695 R699 R701 R706 R709 R712 R713 R714 R716 R719 R721 R726 R727 R730 R731 R738 R745 R752 R754 R755 R756 R780 R785 R798 R802 R817 R822 | 0 | RESIS.CHIP 0R 5% 0402 SMD | SMD_0402 | ROYAL OHM | RESIS.CHIP 0R 5% 0402 SMD | CAMEL ELETTRONICA SRL #
139 | 2 | R146 R166 | 200 | RES 200 OHM 1/10W 1% 0402 SMD | SMD_0402 | PANASONIC | ERJ-2RKF2000X | DIGIKEY (P200LCT-ND)
140 | 2 | R147 R165 | 698R | RESIS.CHIP 698R 1% 0402 SMD | SMD_0402 | ROYAL OHM | RESIS.CHIP 698R 1% 0402 SMD | CAMEL ELETTRONICA SRL #
141 | 1 | R157 | 1,5K | RES 1,5K OHM 1/10W 1% 0402 SMD | SMD_0402
142 | 4 | R159 R160 R161 R163 | 82R | RESIS.CHIP 82R 1% 0402 SMD | SMD_0402 | Vishay/Dale | CRCW040282R0FKED | DIGIKEY(541-82.0LTR-ND)
143 | 4 | R162 R164 R168 R169 | 150R | RESIS.CHIP 150R 1% 0402 SMD | SMD_0402 | YAGEO | RC0402FR-07150RL | DIGIKEY(311-150LRTR-ND)
144 | 4 | R170 R171 R172 R173 | 130 | RESIS.CHIP 130R 1% 0402 SMD | SMD_0402 | BOURNS | CR0402-FX-1300GLF | DIGIKEY(CR0402-FX-1300GLFTR-ND)
145 | 37 | R190 R191 R192 R459 R460 R461 R462 R463 R464 R465 R466 R467 R468 R469 R470 R471 R472 R707 R708 R710 R711 R715 R717 R718 R723 R724 R728 R729 R732 R736 R737 R782 R786 R800 R806 R819 R820 | 49,9 | RESIS.CHIP 49,9R 1% 0402 SMD | SMD_0402 | NIC | NCR04F49R9TRF | MODULI ELETTRONICI E COMPONENTI spa
146 | 6 | R195 R668 R669 R674 R675 R885 | 22K | RESIS.CHIP 22K 5% 0402 SMD | SMD_0402 | ROYAL OHM | RESIS.CHIP 22K 5% 0402 SMD | CAMEL ELETTRONICA SRL #
147 | 13 | R196 R446 R558 R595 R596 R677 R680 R689 R690 R692 R694 R698 R700 | 47K | RESIS.CHIP 47K 1% 0402 SMD | SMD_0402 | ROYAL OHM | RESIS.CHIP 47K 1% 0402 SMD | CAMEL ELETTRONICA SRL #
148 | 12 | R201 R208 R209 R210 R211 R541 R542 R571 R749 R837 R852 R886 | 100K | RESIS.CHIP 100K 5% 0402 SMD | SMD_0402 | ROYAL OHM | RESIS.CHIP 100K 5% 0402 SMD | CAMEL ELETTRONICA SRL #
149 | 2 | R202 R387 | 12,1K | RESIS.CHIP 12,1K 1% 0402 SMD | SMD_0402 | ROYAL OHM | RESIS.CHIP 12,1K 1% 0402 SMD | CAMEL ELETTRONICA SRL #
150 | 2 | R203 R632 | 1M | RESIS.CHIP 1M 1% 0402 SMD | SMD_0402 | ROYAL OHM | RESIS.1M 1% 0402 SMD | CAMEL ELETTRONICA SRL #
151 | 4 | R213 R214 R219 R221 | 330 | RESIS.CHIP 330R 5% 0603 1/10W SMD | SMD_0603 | NIC | NRC06J331TRF | MODULI ELETTRONICI E COMPONENTI spa
152 | 12 | R229 R230 R376 R378 R380 R662 R870 R871 R872 R873 R874 R875 | 330 | RESIS.CHIP 330R 5% 0402 SMD | SMD_0402 | ROYAL OHM | RESIS.CHIP 330R 5% 0402 SMD | CAMEL ELETTRONICA SRL #
153 | 14 | R251 R255 R257 R259 R261 R264 R413 R414 R424 R608 R639 R863 R876 R880 | 100 | RESIS.CHIP 100R 5% 0402 SMD | SMD_0402 | ROYAL OHM | RESIS.CHIP 100R 5% 0402 SMD | CAMEL ELETTRONICA SRL #
154 | 4 | R365 R366 R367 R368 | 330m | Resistori rilevatori di corrente - SMD 1/8watt .33ohms 1% | SMD_0402 | VISHAY DALE | RCWE0402R330FKEA | MOUSER(71-RCWE0402R330FKEA)
155 | 4 | R369 R371 R373 R374 | 5.1 | RESIS.CHIP 5,1 1% 0402 SMD | SMD_0402 | yageo | RES SMD 5.1 OHM 1% 1/16W 0402 | Digikey(YAG3370TR-ND )
156 | 31 | R375 R377 R379 R438 R540 R561 R562 R563 R565 R566 R567 R568 R573 R574 R575 R579 R581 R588 R589 R609 R735 R779 R783 R797 R801 R815 R816 R847 R848 R849 R878 | 0 | RESIS. 0R 1/4W 1206 SMD E96 | SMD_1206 | ASJ | CR32000ZL | DIGIKEY(311-0.0ERTR-ND)
157 | 11 | R381 R388 R389 R390 R391 R392 R393 R394 R395 R658 R659 | 22 | RESIS.CHIP 22R 5% 0402 SMD | SMD_0402 | ROYAL OHM | RESIS.CHIP 22R 5% 0402 SMD | CAMEL ELETTRONICA SRL #
158 | 2 | R426 R864 | 6,04K | RESIS.CHIP 6K04 1% 0603 SMD | SMD_0603 | ROYAL OHM | RESIS.CHIP 6K04 1% 0603 SMD | CAMEL ELETTRONICA SRL #
159 | 1 | R439 | 51K | RESIS.CHIP 51K 1% 0402 SMD | SMD_0402 | ROYAL OHM | RESIS.CHIP 51K 1% 0402 SMD | CAMEL ELETTRONICA SRL #
160 | 1 | R440 | 68K | RESIS.CHIP 68K 1% 0402 SMD | SMD_0402 | ROYAL OHM | RESIS.68K 1% 0402 SMD | CAMEL ELETTRONICA SRL #
161 | 1 | R449 | 1,65K | RESIS.CHIP 1K65 1% 0402 SMD | SMD_0402 | PANASONIC | ERJ-2RKF1651X | DIGIKEY (P1.65KLTR-ND)
162 | 1 | R450 | 680 | RES SMD 680 OHM 1% 1/16W 0402 | SMD_0402 | YAGEO | RC0402FR-07680RL | DIGIKEY(311-680LRCT-ND)
163 | 3 | R457 R458 R474 | 1,43K | RESIS.CHIP 1,43K 1% 0402 SMD | SMD_0402 | ROYAL OHM | RESIS.CHIP 1,43K 1% 0402 SMD | CAMEL ELETTRONICA SRL #
164 | 1 | R495 | 475R | RESIS.CHIP 475R 1% 0402 SMD | SMD_0402 | PANASONIC ECG | ERJ-2RKF4750X ( COMP.) | DIGIKEY (P475LTR-ND)
165 | 1 | R559 | 120K | RESIS.CHIP 120K 1% 0402 SMD | SMD_0402 | WALSIN | WR04W1203FTL | MODULI ELETTRONICI E COMPONENTI spa
166 | 1 | R560 | 180K | RESIS.CHIP 180K 1% 0402 SMD | SMD_0402 | ROYAL OHM | RESIS.CHIP 180K 1% 0402 SMD | CAMEL ELETTRONICA SRL #
167 | 3 | R592 R855 R856 | 15K | RESIS.CHIP 15K 1% 0402 SMD | SMD_0402 | ROYAL OHM | RESIS.CHIP 15K 1% 0402 SMD | CAMEL ELETTRONICA SRL #
168 | 1 | R599 | 27K | RESIS.CHIP 27K 1% 0402 SMD | SMD_0402 | ROYAL OHM | RESIS.CHIP 27K 1% 0402 SMD | CAMEL ELETTRONICA SRL #
169 | 8 | R600 R601 R602 R603 R604 R605 R606 R607 | 5R6 | RESIS.CHIP 5.6 ohm 5% 0402 SMD | SMD_0402 | YAGEO | RC0402JR-075R6L | DIGIKEY(311-5.6JRDKR-ND)
170 | 1 | R638 | 39K | RESIS.CHIP 39K 1% 0402 SMD | SMD_0402 | BOURNS | CR0402-FX-3902GLF | DIGIKEY(CR0402-FX-3902GLF-ND)
171 | 8 | R640 R643 R645 R660 R661 R664 R682 R686 | 4,7K | RES 4.7K OHM 1/10W 1% 0402 SMD | SMD_0402 | PANASONIC | ERJ-2RKF4701X | DIGIKEY (P4.70KLCT-ND)
172 | 3 | R652 R850 R854 | 5,1K | RES SMD 5.1K OHM 1% 1/16W 0402 | SMD_0402 | Yageo | RC0402FR-075K1L | DIGIKEY (311-5.10KLRCT-ND)
173 | 1 | R653 | 10,7K | RESIS.CHIP 10,7K 1% 0603 E96 | SMD_0603 | ROYAL OHM | RESIS.CHIP 10,7K 1% 0603 E96 | CAMEL ELETTRONICA SRL #
174 | 2 | R655 R858 | 1,21K | RESIS.CHIP 1,21K 1% 0603 SMD | SMD_0603 | ROYAL OHM | RES.1K21 1% 0603 SMD | CAMEL ELETTRONICA SRL #
175 | 1 | R663 | 2K | RESIS.CHIP 2K 1% 0402 SMD | SMD_0402 | ROYAL OHM | RESIS.CHIP 2K 1% 0402 SMD | CAMEL ELETTRONICA SRL #
176 | 4 | R665 R666 R676 R678 | 75 | RESIS.CHIP 75R 1% 0402 SMD | SMD_0402 | KAMAYA | RMC1/16SK75R0FTH | MODULI ELETTRONICI E COMPONENTI spa
177 | 2 | R670 R673 | 2K2 | RESIS.CHIP2K2 1% 0402 SMD | SMD_0402 | yageo | RT0402DRD072K2L | DIGIKEY(RT0402DRD072K2L-ND )
178 | 3 | R739 R750 R751 | 10K | RESIS.CHIP 10K 5% 0402 SMD | SMD_0402 | ROYAL OHM | RESIS.CHIP 10K 5% 0402 SMD | CAMEL ELETTRONICA SRL #
179 | 2 | R740 R741 | 1,5 | RESIS.CHIP 1,5OHM 1% 0402 SMD | SMD_0402 | WELWYN | ASC0402-1R5FT10 | FARNELL(2078842 )
180 | 1 | R743 | 0R | RESIS. CHIP 0R 1/4W 1% 2010 SMD | SMD_2010 | VISHAY | CRCW20100000Z0EF | FARNELL(1653190)
181 | 1 | R744 | 30,1K | RESIS.CHIP 30K1 1% 0402 SMD | SMD_0402 | ROYAL OHM | RESIS.CHIP 30K1 1% 0402 SMD | CAMEL ELETTRONICA SRL #
182 | 3 | R746 R747 R748 | 1K | RESIS.CHIP 1K 5% 0402 SMD | SMD_0402 | ROYAL OHM | RESIS.CHIP 1K 5% 0402 SMD | CAMEL ELETTRONICA SRL #
183 | 1 | R753 | 56,2K | RESIS.CHIP 56,2K 1% 0402 SMD | SMD_0402 | ROYAL OHM | RESIS.CHIP 56,2K 1% 0402 SMD | CAMEL ELETTRONICA SRL #
184 | 1 | R787 | 7,5K | RES 7,5K OHM 1/10W 1% 0402 SMD | SMD_0402 | BOURNS | CR0402-FX-7501GLF | DIGIKEY (CR0402-FX-7501GLFTR-ND)
185 | 1 | R793 | 12,4K | RESIS.CHIP 12,4K 1% 0402 SMD | SMD_0402 | ROYAL OHM | RESIS.CHIP 12,4K 1% 0402 SMD | CAMEL ELETTRONICA SRL #
186 | 1 | R810 | 31,6K | RESIS.CHIP 31,6K 1% 0402 SMD | SMD_0402 | VISHAY/DALE | CRCW040231K6FKED | DIGIKEY (541-31.6KLCT-ND)
187 | 1 | R824 | 45,3K | RESIS.CHIP 45,3K 1% 0402 SMD | SMD_0402 | panasonic | ERJ-2RKF4532X | DIGIKEY(P45.3KLCT-ND)
188 | 1 | R826 | 73,2K | RESIS.CHIP 73K2 1% 0402 SMD | SMD_0402 | PANASONIC | ERJ-2RKF7322X | DIGIKEY (P73.2KLCT-ND)
189 | 1 | R838 | 4,32K | RESIS.CHIP 4,32K 0402 1% SMD | SMD_0402 | PANASONIC | ERJ-2RKF4321X | DIGIKEY (P4.32KLDKR-ND)
190 | 1 | R841 | 30.9K | RESIS.CHIP 30.9K 1% 0402 SMD | SMD_0402 | BOURNS | ERJ-1GNF3092C | DIGIKEY( P122921CT-ND)
191 | 2 | R843 R846 | 0R | Thick Film Resistors 0OHM 1WATT 5% | SMD_2512 | bourns | CR2512-J/-000ELF | MOUSER(652-CR2512-J/-000ELF)
192 | 2 | R844 R845 | 51,1K | RESIS.CHIP 51K1 1% 0402 SMD | SMD_0402 | ROYAL OHM | CAMEL ELETTRONICA SRL #
193 | 1 | R851 | 392K | RES 392K OHM 1/10W 1% 0402 SMD | SMD_0402 | VISHAY | CRCW0402392KFKED | DIGIKEY(541-392KLTR-ND)
194 | 1 | R853 | 28mOhm | Current Sense Resistors - SMD 0.028 Ohm 1% 1W | SMD_2512 | VISHAY | WSL2512R0280FEA18 | DIGIKEY(WSLH-.028TR-ND)
195 | 1 | R857 | 13,7K | RESIS.CHIP 13,7K 1% 0402 SMD | SMD_0402 | PANASONIC | ERJ-2RKF1372X | DIGIKEY(P13.7KLCT-ND)
196 | 1 | R859 | 25mOhm | Current Sense Resistors - SMD 0.025 Ohm 1% 1W | SMD_2512 | VISHAY | WSL2512R0250FEA18 | DIGIKEY(WSLH-.025CT-ND)
197 | 1 | R860 | 54,9K | RESIS.CHIP 54,9K 1% 0603 SMD E96 | SMD_0603 | ROYAL OHM | CHIP RES.54K9 0603 1% | CAMEL ELETTRONICA SRL #
198 | 1 | R862 | 1,13K | RESIS.CHIP 1,13K 1% 0402 SMD | SMD_0402 | YAGEO | RC0402FR-071K13L | DIGIKEY(YAG3032CT-ND)
199 | 1 | R865 | 10K | RESIS.CHIP 10K 1% 0603 SMD | SMD_0603 | ROYAL OHM | RES.10K 0603 1% SMD | CAMEL ELETTRONICA SRL #
200 | 2 | R866 R868 | 33,2K | RESIS.CHIP 33K2 1% 0603 SMD | SMD_0603 | ROYAL OHM | RESIS.CHIP 33K2 1% 0603 SMD | CAMEL ELETTRONICA SRL #
201 | 1 | R869 | 10 | RESIS.CHIP 10R 1% 0603 SMD | SMD_0603 | ROYAL OHM | RESIS.CHIP 10R 1% 0603 SMD | CAMEL ELETTRONICA SRL #
202 | 1 | R884 | 0,005 | RES 0.005 OHM 2W 1% 2512 SMD | SMD_2512 | YAGEO | PA2512FKF7W0R005E | DIGIKEY (YAG2145CT-ND)
203 | 1 | R887 | 1,02M | RESIS.CHIP 1,02M 1% 0402 SMD | SMD_0402 | VISHAY | CRCW04021M02FKED | DIGIKEY (541-1.02MLCT-ND)
204 | 1 | R888 | 127K | RESIS.CHIP 127K 1% 0402 SMD | SMD_0402 | PANASONIC | ERJ-2RKF1273X | DIGIKEY (P127KLCT-ND)
205 | 1 | R889 | 22,1K | RESIS.CHIP 22,1K 1% 0402 SMD | SMD_0402 | KAMAYA | RMC1/16SK2212FT | MODULI ELETTRONICI E COMPONENTI spa
206 | 2 | SW1 SW2 | TDA08H0SB1R | SWITCH DIP SIP HALF 8POS SMD | 2X8 PASSO 1.27mm | C&k | TDA08H0SB1R | MOUSER(611-TDA08H0SB1R)
234 | 1 | TVS1 | IP4221CZ6-S,115 | TVS ESD Dual INTEG ESD Protection SPI | XSON-6 | NXP | IP4221CZ6-S,115 | MOUSER(771-IP4221CZ6-S,115 )
235 | 1 | U2 | SN74LVC16373ADGGR | IC TRANS D-TYP LATCH 3ST 48TSSOP | TSSOP-48 | TEXAS | SN74LVC16373ADGGR | DIGIKEY(296-13241-1-ND)
236 | 1 | U3 | MT28EW01GABA1HJS-0AAT | NOR Flash EW-SERIES FLASH NOR SLC 64MX16 TSOP | TSOP-56 | MICRON | MT28EW01GABA1HJS-0AAT | MOUSER(340-279939-TRAY)
237 | 1 | U4 | MT29F4G08ABADAWP-IT:D | IC NAND FLASH 4GB 3.3V 48-TSOP LONGEVITY | TSOP_48 | MICRON | MT29F4G08ABADAWP-IT:D | AVNET EXPRESS
238 | 3 | U5 U6 U7 | SN74LVC1G86DCKT | Porte logiche SNGL 2 Input Exclusive OR Gate | sc70-5 | TEXAS | SN74LVC1G86DCKT | MOUSER(595-SN74LVC1G86DCKT)
239 | 6 | U8 U10 U11 U16 U26 U28 | TXS0104E | BIDIRECTIONAL VOLTAGE-LEVEL TRANSLATOR | TSSOP14 | TEXAS | TXS0104EPWR | TI.COM
240 | 1 | U9 | S25FL256SAGMFI000 | IC FLASH 256M SPI 133MHZ 16SOIC | SOIC_16 | CYPRESS | S25FL256SAGMFI000 | DIGIKEY(1274-1003-ND)
241 | 2 | U12 U13 | RCLAMP0524J.TCT | TVS DIODE 5V 15V SLP2710P8 | 10-UFDFN | SEMTEC | RCLAMP0524J.TCT | DIGIKEY(RCLAMP0524JCT-ND)
242 | \ | U14 U15 | FXLP34P5X | IC TRANSLATOR DUAL 4BIT 16-DQFN | SC70-5 | ON SEMI | FXL4TD245BQX | DIGIKEY (FXL4TD245BQXCT-ND)
243 | 4 | U17 U18 U19 U20 | PCA9306DCT | IC VOLT-LEVEL TRANSLATOR | 8-SSOP | TEXAS | PCA9306DCT | DIGIKEY(296-18509-1-ND)
244 | 1 | U1 | T2080NXN8PTB | QRIQ MPU 1.87GT/s DDR3/3L 4x10GE | BGA896 | NXP | T2080NXN8PTB | MOUSER(841-T2080NXN8PTB)
245 | 1 | U21 | 859S0212BGILF | 2:2 Differential-to-LVPECL/LVDS Clock Multiplexer | TSSOP-16 | RENESAS | 859S0212BGILF | AVNET(859S0212BGILF)
246 | 1 | U22 | 24MHZ | OSCILLATOR 24.000MHZ 1.8-3.3V 50ppm SMD | SMD_5.0x3.2 | ABRACOM | ASFLMB-24.000MHZ-LC-T | DIGIKEY(535-11768-1-ND)
247 | 1 | U23 | USB2514-AEZC | IC USB 2.0 4PORT HUB CTLR 64QFN | QFN36 | MICROCHIP | USB2514B-AEZC | DIGIKEY(886-USB2514B-AEZC)
248 | 1 | U24 | SK5126 | Industrial usb keyborad controller | QFN-48-EP | Sprintek | SK5126-LT AP2191SG-13 | SPRINGTEK
249 | 3 | U25 U39 U40 | SRV05-4 | TVS Diode Array5VWM 17.5VC USB | SOT23-6 | SEMTEC | SRV05-4.TCT | DIGIKEY (SRV05-4CT-ND)
250 | 1 | U27 | MAX3232ECPWR | IC RS232 3V-5.5V DRVR 16-TSSOP | TSSOP16 | TEXAS | MAX3232ECPWR | DIGIKEY (296-19263-2-ND)
251 | 1 | U29 | DS1339U-33+ | IC RTC CLK/CALENDAR I2C 8-USOP | USOP8 | MAXIM | DS1339U-33+ | DIGIKEY(DS1339U-33+-ND)
252 | 1 | U30 | AT24C256C-SSHL-B | EEPROM 256K (32K X 8), 2-WI 1.8V | SOIC-8 | MICROCHIP | AT24C256C-SSHL-B | MOUSER(556-AT24C256C-SSHL-B)
253 | 1 | U31 | ADT7481ARM | 2 CH TEMP SNSR/ALARM 2 WIRE | MSOP-10 | ON SEMI | ADT7481ARMZ-REEL | MOUSER(863-ADT7481ARMZ-REEL)
254 | 1 | U32 | LCMXO640C-3TN100C | CPLD 640 LUTS 74 I/O 100 TQFP | 100-LQFP | LATTICE | LCMXO640C-3TN100C LCMXO256C-3TN100C | MOUSER(842-MXO640C3TN100C)
255 | 1 | U33 | 50MHZ | Oscillator 50Mhz SMD 3.2x2.5mm 4 Pads 1.8V | SMD_3.2x2.5 | ABRACOM | ASE3-50.000MHZ-KT | DIGIKEY(535-9554-1-ND)
256 | 1 | U34 | PCA9532 | LED DRIVER, PWM, 400KHZ, TSSOP-24 | 24-TSSOP | NXP | PCA9532PW,112 | FARNELL(2400469)
257 | 1 | U35 | TCA6424ARGJR | I/O Expander 24 I²C, SMBus 32-UQFN | 32-UQFN | TEXAS | TCA6424ARGJR | DIGIKEY( 296-27844-1-ND)
258 | 1 | U36 | NLSV1T34AMX1TCG | IC XLATOR 1BIT NON-INV 6ULLGA | 6-XFLGA | ON SEMI | NLSV1T34AMX1TCG | DIGIKEY (NLSV1T34AMX1TCGOSTR-ND)
259 | 1 | U37 | TPS72012DRVT | IC REG LDO 1.2V 0.35A 6SON | 6SON | TEXAS | TPS72012DRVT | DIGIKEY (296-25807-2-ND)
260 | 1 | U38 | KSZ9031RNXCA | Gigabit Ethernet Transceiver with RGMII, WOL | QFN48 | MICREL | KSZ9031RNXCA | MOUSER(998-KSZ9031RNXCA)
261 | 1 | U41 | SN74LVC2G07DBVR | Buffer e line driver Dual w/ Open-Drain | SOT-26 | TEXAS | SN74LVC2G07DBVR | MOUSER(595-SN74LVC2G07DBVR)
262 | 1 | U42 | 88SE9235 | Two-Lane PCIe 2.0 to Four-Port 6 | 76-pin QFN LBGA-196 | MARVELL | 88SE9235 | MARVELL(88SE9235A1-NAA2C000) | \
263 | 1 | U43 | RT8058GQW | IC REG BUCK ADJUSTABLE 2A 16WQFN | QFN16 | Richtek | RT8058GQW | DIGIKEY (1028-1000-1-ND)
264 | 1 | U44 | UPD720201K8-701-BAC-A | Speed Host Controller USB 3.0 3.3V | QFN_68 | RENESAS | UPD720201K8-701-BAC-A | ARROW(UPD720201K8-701-BAC-A)
265 | 1 | U45 | MX25L512EMI-10G | IC FLASH 512K SPI 104MHZ 8SOP | SOP-8 | MACRONIX | MX25L512EMI-10G | DIGIKEY(1092-1110-ND)
266 | 2 | U46 U49 | RCLAMP3346P.TNT | High speed ESD protection LOW CAPACITANCE | 7-UDFN | SEMTECH | RCLAMP3346P.TNT | DIGIKEY(RCLAMP3346P.TNTCT-ND)
267 | 2 | U47 U48 | AP2191SG-13 | usb distribuzione alimentazione 1.5A 2.7V-5.5V | SOIC8 | DIODES | AP2191SG-13 | MOUSER(621-AP2191SG-13)
268 | 1 | U50 | PI7C9X2G612GP | PCI 6 Ports 6Lanes PCIE2 Packet Switch | LBGA_196 | DIODES | PI7C9X2G612GPCNJE | MOUSER( 729-PI7C9X2G612GPCNJ )
269 | 1 | U51 | 25AA256 | IC SPI EEPROM 256KBIT 10MHZ 8SOIC | SOIC8 | MICROCHIP | 25AA256-I/SN | DIGIKEY (25AA256-I/SN-ND)
270 | 1 | U52 | TPS79633 | IC REG LDO 3.3V 1A SOT223-6 | SOT223-6 | TEXAS | TPS79633DCQR | DIGIKEY(296-13766-1-ND)
271 | 1 | U53 | 32.768kHZ | Oscillator 32.768kHZ 25ppm 1.8V SMD 3225 | SMD_3.2x2.5 | CTS | TC32M5I32K7680 | DIGIKEY(CTX1181CT-ND)
272 | 1 | U54 | FDC6331L | LOAD SWITCH INT 8VIN SSOT-6 | SOT_6 | FAIRCHILD | FDC6331L | DIGIKEY (FDC6331LCT-ND)
273 | 1 | U55 | m2m air | MIM m2m air Telit | VQFN-8 | Telit
274 | 1 | U56 | TPS62067 | IC REG BUCK SYNC ADJ 2A 8WSON | WSON8 | TEXAS | TPS62067DSGT | DIGIKEY (296-27205-1-ND)
275 | 1 | U57 | CM2020-01TR | IC XMTR HDMI ESD PROTECTION 5V TSSOP38 | tssop38 | ON SEMI | CM2020-01TR | DIGIKEY(CM2020-01TROSCT-ND)
276 | 1 | U58 | CM9882A | CODEC AUDIO CM9882A | LQFP48 | CMEDIA | CM9882A | CMEDIA
277 | 1 | U59 | M24C32 | EEPROM EEPROM S I2C 32k | SOIC8 | ST | M24C32-WMN6TP | MOUSER(511-M24C32-WMN6TP)
278 | 1 | U60 | TPS5430MDDAREP | IC REG BUCK ADJ 3A 8SOPWRPAD HiRel | 8-SOIC | TEXAS | TPS5430MDDAREP | DIGIKEY (ey 296-24266-1-ND)
279 | 1 | U61 | CM8828 | High Performance PCI Express Audio Processor | LQFP-80 | CMEDIA | CM8828 | CMEDIA
280 | 1 | U62 | 66,6MHZ | MEMS OSC XO 66.6600MHZ H/LV-CMOS | SMD_3.2x2.5 | SiTIME | SIT1602BC-23-18S-66.660000D | DIGIKEY(1473-SIT1602BC-23-18S-66.660000D-ND)
281 | 1 | U63 | 133,33MHZ | MEMS OSC XO 133.3300MHZ LVCMOS | SMD_2.5x2.0 | SiTIME | SIT8009AC-12-18E-133.330000E | DIGIKEY(1473-SIT8009AC-12-18E-133.330000E-ND)
282 | 1 | U64 | 9FGV0641 | PCIe Gen1–4 clock generation for Riser Cards | 40-VFQFPN | IDT | 9FGV0641 | IDT
283 | 1 | U65 | TPS544B20RVFT | IC REG BUCK ADJ 20A 40LQFN | LQFN40 | TEXAS | TPS544B20RVFT | DIGIKEY(296-37876-1-ND)
284 | 6 | U67 U68 U69 U70 U71 U72 | TPS56637RPAR | 4.5-V to 28-V input, 6-A synchronous buck | VQFN10 | TEXAS | TPS56637RPAR | MOUSER(595-TPS56637RPAR)
285 | 1 | U73 | TPS51200DRCR | IC CONV DDR DDR2 DDR3 10SON | SON10 | TEXAS | TPS51200DRCR | DIGIKEY (296-26978-1-ND)
286 | 1 | U74 | MIC47100YMME | LDO 1A High Speed, Low Vin LDO | MSOP8 | microchip | MIC47100YMME | MOUSER(998-MIC47100YMME)
287 | 1 | U75 | MIC39102YM | LDO 1.0A 1.0% Fixed Voltage LDO | SOIC8 | microchip | MIC39102YM | MOUSER(998-MIC39102YM)
288 | 1 | U76 | LTM4613IV#PBF | Ultralow EMI, 36V, 8A Step-down Module | LGA-133 | ANALOG | LTM4613IV#PBF | MOUSER(584-LTM4613IV#PBF)
289 | 1 | U77 | LTC4100EG#PBF | IC SMART BATTERY CHARGER 24-SSOP | 24-SSOP | ANALOG | LTC4100EG#PBF LTC4100EG#PBF | DIGIKEY(LTC4100EG#PBF-ND)
290 | 1 | U78 | LT1129CS8-3.3#PBF | IC REG LINEAR 3.3V 700MA 8SOIC | SOIC8 | ANALOG | LT1129CS8-3.3#PBF | DIGIKEY(LT1129CS8-3.3#PBF-ND)
291 | 1 | U79 | NCP571SN09T1G | IC REG LINEAR 0.9V 150MA 5TSOP | SOT-223 | ON SEMI | NCP571SN09T1G | DIGIKEY (NCP571SN09T1GOSCT-ND)
292 | 1 | U80 | MIC811SUY-TR | MPU VOLTAGE MONITOR | SOT-143 | MICROCHIP | MIC811SUY-TR | DIGIKEY(576-1325-6-ND)
293 | 1 | U81 | LTC4368CDD-1#PBF | SURGE SUPPRESSIONE ADJ | 10DFN | LINEAR | LTC4368CDD-1#PBF | DIGIKEY(LTC4368CDD-1#PBF-ND)
294 | 2 | XJP1 XJP2 | SHUNT | SHUNT | NONE
295 | 2 | Y1 Y5 | 24MHz | CRYSTAL 24MHZ 10PF SMD | SMD_2.5x3.2 | CTS | 403C11A24M00000 | DIGIKEY(CTX849CT-ND)
296 | 1 | Y2 | 32,768KHz | CRYSTAL 32.768KHZ 12.5PF SMD | SMD_3215 | TXC | 9HT10-32.768KBZF-T | DIGIKEY(887-1573-1-ND)
297 | 3 | Y3 Y4 Y7 | 25MHz | CRYSTAL 25.000 MHZ 20PF SMD | SMD_5.0x3.2 | ECS | ECS-250-20-30B-TR (ROHS COMPLIANT) | DIGIKEY (XC1124CT-ND)
298 | 1 | Y6 | 24,576MHz | QUARZO 24,576MHz HC49/USM4 CL16 FUNZ.SMD | SMD_HC49/US | MEGATEC (Cod.Forn:QSXTM24576UG55LSF) | HC49/USM4-024M5760000UR (ROHS COMPLIANT) | MODULI ELETTRONICI E COMPONENTI spa
