unofficialImportFromGitlab-PPC/powerpc-laptop-mobo/Xpedition/Mas100n1 ACB_0001_0/Logic/PORTATILE_1_1_BOM_new.ods

Sheet: MAIN_BOM
 |  |  | Project | Description |  | Version | Revision
 |  |  | JCB_000_1 | Jcube Jetson Nano Carrier Board |  | 1 | 1
 |  |  |  |  |  |  |  | Name / Signature |  |  |  |  |  |  | Date
 |  |  |  |  |  |  | Revised | S.mascetti
Revision history |  |  |  |  |  |  | Verified | S.mascetti
Rev. |  | Date | Description |  |  |  | Approved | S.mascetti
 |  |  |  |  |  |  |  | Number of boards in production: |  |  |  |  |  |  | 10
 |  |  |  |  |  |  |  |  |  |  | TOT. | TOT. |  | TOT. | TOT.
 |  |  |  |  |  |  |  |  |  |  | € 0,000 | 0,000% |  | € 0,000 | 0,000%
 |  |  |  |  |  |  |  |  |  |  |  |  |  |  |  | STOCK STATUS
ITEM | QTY | DESIGN REFERENCE | VALUE | DESCRIPTION | PACKAGE | MANUFACTURER | MANUFACTURER P/N | DISTRIBUTOR | DISTRIBUTOR P/N | SINGLE ITEM PRICE | BOARD ITEM PRICE | ITEM INCIDENCE | SINGLE ITEM PRICE | BOARD ITEM PRICE | ITEM INCIDENCE | ITEMS | ITEMS | ITEMS | NOTES
 |  |  |  |  |  |  |  |  |  | (200 pcs.) | (200 pcs.) | (200 pcs.) | (1K pcs.) | (1K pcs.) | (1K pcs.) | to ORDER | in ORDER | in STOCK
1 | 2 | BATT1 BTH1 | 3V 5mAh | BATTERY LITHIUM COIN 3V 6.8mm Rechargable |  | Panasonic - BSG | ML-621S/ZTN | DIGIKEY (P007-ND)
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
26 | 1 | C594 | 1NF | CAP CER 1000PF 2KV 20% X7R 1808 | SMD_1808 | AVX | 1808GC102MAT1A | DIGIKEY(709-1040-1-ND)
27 | 2 | C686 C687 | 2pF | CAP CER 2PF 50V C0G/NPO 0402 | SMD_0402 | yageo | CC0402CRNPO9BN2R0D | DIGIKEY(311-1006-2-ND)
28 | 9 | C914 C1207 C1208 C1209 C1210 C1261 C1262 C1322 C1345 | 100uF | CAP CER 100UF 16V 20% X5R 1210 | SMD_1210 | Taiyo Yuden | EMK325ABJ107MM-T | DIGIKEY (587-3152-2-ND)
29 | 3 | C927 C935 C938 | 100nF | COND.CER.100NF 25V 0603 X7R SMD | SMD_0603 | PHILIPS | PHY223891615649 | CAMEL ELETTRONICA SRL #
30 | 1 | C934 | 1,5nF | COND.CER. 1,5nF 50V 0402 X7R SMD | SMD_0402 | YAGEO | 04022R152J9B20D | CLAITRON LASI SILVESTAR S.R.L.
31 | 1 | C936 | 68NF | COND.CER. 68NF 50V 0402 X7R SMD | SMD_0402 | MURATA | GRM155R61C683KA01J | MURATA ELETTRONICA SPA
32 | 1 | C937 | 150NF | CAP CER 0.15UF 16V 10% X7R 0402 | SMD_0402 | TDK | C1005X7R1C154K050BC | DIGIKEY(445-5934-1-ND)
33 | 4 | C946 C1179 C1239 C1263 | 22PF | COND.CER. 22PF 50V 0402 NPO 5% SMD | SMD_0402 | MURATA | GRM1555C1H220JZ01 | MURATA ELETTRONICA SPA
34 | 1 | C947 | 100uF | CAP ALUM 100UF 35V 20% SMD | SMD_8.3X8.3 | United chemi-Con | EMVY350ADA101MHA0G | DIGIKEY (565-2477-1-ND)
35 | 1 | C956 | 220NF | COND.CER. 220NF 10V 0402 X5R SMD | SMD_0402 | TAIYO YUDEN | LMK105BJ224KV-F | DIGIKEY(587-1228-1-ND)
36 | 7 | C977 C983 C996 C1039 C1041 C1126 C1158 | 1UF | CAP CER 1UF 6.3V 10% X5R 0402 AUTOMOTIVE | SMD_0402 | Taiyo Yuden | JMK105BJ105KVHF | DIGIKEY (587-3766-1-ND)
37 | 1 | C1043 | 150PF | COND.CER. 150PF 50V 0402 5% COG SMD | SMD_0402 | MURATA | GRM1555C1H151JD01D | MURATA ELETTRONICA SPA
38 | 4 | C1075 C1076 C1077 C1078 | 100uF | COND.CER.100uF 6,3V 1210 X5R 20% SMD | SMD_1210 | MURATA | GRM32ER60J107ME20L | MURATA ELETTRONICA SPA
39 | 4 | C1081 C1082 C1083 C1086 | 33PF | COND.CER. 33PF 50V 0402 5% COG SMD | SMD_0402 | Murata | GRM1555C1H330JZ01D_ | MURATA ELETTRONICA SPA
40 | 2 | C1159 C1176 | 10uF | COND.CER.10uF 6,3V 10% 0805 X5R SMD | SMD_0805 | KEMET | C0805C106K9PA!A | TTI ITALY SRL
41 | 2 | C1160 C1161 | 20PF | COND.CER. 20PF 50V 0402 NP0 SMD | SMD_0402 | MURATA | GRM1555C1H200JZ01D | MURATA ELETTRONICA SPA
42 | 1 | C1171 | 220uF | CAP TANT 220UF 16V 10% 2917 | SMD_CASE_D | Kemet | T491D227K016ZT | DIGIKEY (399-5124-1-ND)
43 | 5 | C1182 C1183 C1185 C1186 C1188 | 1uF | CAP CER 1UF 10V 10% X5R 0402 | SMD_0402 | MURATA | GRM155R61A105KE15D | DIGIKEY (490-3890-1-ND)
44 | 14 | C1195 C1196 C1199 C1200 C1201 C1202 C1205 C1206 C1283 C1284 C1299 C1300 C1315 C1316 | 100PF | COND.CER. 100PF 50V 0402 NPO 5% SMD | SMD_0402 | MURATA | GRM1555C1H101JD01D | MURATA ELETTRONICA SPA
45 | 2 | C1226 C1227 | 12PF | COND.CER.12PF 50V 0402 NPO/COG SMD | SMD_0402 | MURATA | GRM1555C1H120JZ01D | MURATA ELETTRONICA SPA
46 | 1 | C1254 | 100uF | CAP ALUM 100UF 35V 20% SMD | SMD_6.3X6.3x6.1 | Panasonic | EEE-FT1V101AP | MOUSER (667-EEE-FT1V101AP)
47 | 2 | C1265 C1266 | 1UF | CAP CER 1.0UF 6.3V 10% X5R 0402 | SMD_0402 | MURATA | GRM155R60J105KE19D | DIGIKEY (490-1320-2-ND)
48 | 2 | C1267 C1268 | 100PF | 0402 100pF 50volts C0G 5% | SMD_0402 | MURATA | GRM1555C1H101JZ01D | MOUSER(81-GRM1555C1H101JZ1D)
49 | 4 | C1327 C1339 C1350 C1362 | 330pF | CAP CER 330PF 50V 5% C0G 0402 HiRel | SMD_0402 | TDK | CGJ2B2C0G1H331J050BA | DIGIKEY(445-8059-1-ND)
50 | 6 | C1328 C1329 C1351 C1352 C1363 C1364 | 470uF | COND.TANT. 470uF 2v CASE-GX SMD | SMD_CASE_GX | PANASONIC | EEF-GX0D471R | MOUSER(667-EEFGX0D471R)
51 | 6 | C1330 C1331 C1333 C1354 C1355 C1356 | 22UF | CAP CER 22UF 16V 10% X5R 1206 | SMD_1206 | SAMSUNG | CL31A226KOHNNNE | DIGIKEY (1276-3048-2-ND)
52 | 2 | C1337 C1360 | 2,2UF | CAP CER 2.2UF 25V X5R 0402 | SMD_0402 | Murata | GRM155R61E225ME15D | DIGIKEY ( 490-10457-2-N)
53 | 2 | C1338 C1361 | 4,7UF | CAP CER 4.7UF 10V 20% X5R 0402 | SMD_0402 | TDK | C1005X5R1A475M050BC | DIGIKEY (445-8023-1-ND)
54 | 2 | CN3 CN4 | SS-52000-01 | CONN RCPT USB3.0 TYPEA 9POS R/A | 9 PIN PTH | STEWARD | BT | DIGIKEY(380-1409-ND)
55 | 11 | D1 D21 D22 D23 D25 D32 D33 D37 D38 D39 D40 | LED VERDE | LED CHIPLED VERDE 40mcd 570nm | SMD_0603 | DIALIGHT | 598-8070-107F | MOUSER(645-598-8070-107F)
56 | 3 | D4 D5 D11 | BAT54 | DIODE SCHOTTKY 30V 200MA SOT-23 | SOT-23 | ZETEX | BAT54 | FARNELL (1467516)
57 | 1 | D6 | BAS70LT1G | DIODE SCHOTTKY 70V SOT23 | SOT-23 | ON_SEMI | BAS70LT1G | DIGIKEY (BAS70LT1GOSCT-ND)
58 | 1 | D17 | MMBZ18 | DIODO, TVS ZENER DUAL, 18V, 40W, SOT23 | SOT_23 | MOTOROLA | MMBZ18VALT1G | DIGIKEY(MMBZ18VALT1GOSCT-ND)
59 | 1 | D18 | MBR140SFT1G | DIODE SCH PWR RECT 1A 40V SOD123 | sod123lf | ON SEMICONDUCTOR | MBR140SFT1G | DIGIKEY(MBR140SFT1GOSTR-ND)
60 | 1 | D19 | BAS70-05-7-F | DIODE SCHOTTKY 70V 70MA SOT23 | SOT-23 | DIODES | BAS70-05-7-F | DIGIKEY(BAS70-05FDICT-ND)
61 | 1 | D20 | LED GIALLO | LED CHIPLED GIALLO 160Deg 6.5mcd | SMD_0603 | VISHAY | TLMY1000-GS08 | MOUSER(78-TLMY1000)
62 | 1 | D24 | LED ROSSO | LED CHIPLED ROSSO | SMD_0603 | KINGBRIGHT | APT1608SRCPRV | MOUSER(604-APT1608SRCPRV)
63 | 3 | D26 D27 D28 | B130LAW-7-F | DIODE SCHOTTKY 30V 1A SOD123 | SOD-123 | DIODES | B130LAW-7-F | DIGIKEY (B130LAW-FDICT-ND)
64 | 1 | D29 | 1.5SMC36CA | 1.5SMC36A VARISTORE BIDIREZION. 36V SMD | SMC | LITTLEFUSE | 1.5SMC36CA | EBV ELEKTRONIK S.R.L.
65 | 1 | D41 | B340B-13-F | DIODE SCHOTTKY 40V 3A SMB | SMB | DIODES | B340B-13-F | DIGIKEY(B340B-FDIDKR-ND)
66 | 1 | D42 | BAS116 | DIODO, ALTA VELOCITÀ, SOD123 | SOD123 | NXP | BAS116H,115 | FARNELL(2319131)
67 | 2 | FL1 FL2 | MCZ2010CH900L4T | CHOKE COMM MODE 90 OHM SMD HDMI | SMD | TDK | MCZ2010CH900L4T | DIGIKEY(445-9345-1-ND)
68 | 10 | FL4 FL6 FL8 FL10 FL11 FL12 FL14 FL17 FL18 FL19 | DLP11SN161SL2 | CHOKE COMMON MODE 90 OHM 0805 | SMD | MURATA | DLW21HN900SQ2L | DIGIKEY(490-1064-1-ND)
69 | 2 | FL20 FL21 | NFM18PC105R0J3D | FILTER LC HIGH FREQ 1UF 0603 | SMD_0603 | MURATA | NFM18PC105R0J3D | DIGIKEY(490-6970-1-ND)
70 | 1 | FUSE1 | 0470.500DR | Surface Mount Fuses SMD FA 0.5A | SMD | LITTLEFUSE | 0470.500DR | MOUSER(576-0470.500DR )
71 | 1 | J1 | JMP 3 | STRIP MASC.1x3P CS.p=2 mm | PTH | 3M | 951103-8622-AR | DIGIKEY(3M9322-ND)
72 | 1 | J2 | SD Card Socket | SD Card Socket TYCO | SMD 9 PIN | MOLEX | 54794-0978 | CLAITRON LASI SILVESTAR S.R.L.
73 | 1 | J3 | STRIP 16 | STRIP MASCH.2x8P CS.p=2.0mm SMT | 8X2P=2.0mm SMT | SAMTEC | TMMH-108-01-L-DV | FARNELL(2024017)
74 | 2 | J3F1 J3F2 | 2013022-1 | Connettori DIMM SEMI-HARD TRAY DDR3 204P 4H STD | 204 PIN PASSO 0.6mm | TE CONNECTIVITY | 2013022-1 | MOUSER(571-2013022-1)
75 | 1 | J5 | STRIP 2x3 | STRIP MASC.2x3P CS.p=2.54mm | 2.54mm | TE CONNECTIVITY / AMP | 9689567RL
76 | 1 | J11 | MM70-314-310B1-2-R300 | MXM3.0 CARD EDGE CONNECTOR | 324 PIN 0.5mm | JAE ELECTRONICS | MM70-314-310B1-2-R300 | MOUSER(656-MM70314310B12R)
77 | 1 | J12 | DF13A-40DP-1.25V(55) | Terminali e capicorda 1.25MM V PIN HEADER 40P SMT | SMD 2X20 P_125MM | HIROSE | DF13A-40DP-1.25V(55) | DIGIKEY(H10166-ND)
78 | 1 | J13 | 10029449-111RLF | HDMI TYPE A RECEPT RA SMD | 19 PIN SMD | FCI | 10029449-111RLF | MOUSER (649-10029449-111RLF)
79 | 1 | J19 | 53780-1270 | Terminali e capicorda 1.25 WtB ssy 12Ckt | 1X12 1.25mm smd | MOLEX | 53780-1270 | MOUSER(538-53780-1270)
80 | 3 | J20 J22 J25 | JMP 2 | STRIP MASC.1x2P P=2.54 H=7.62 | PTH | SAMTEC | TLW-102-05-G-S | FARNELL(1668488)
81 | 2 | J21 J23 | B3B-XH-A (LF)(SN) | CONN WIRE TO BOARD HEADER. VERTICAL. 3WAY | 3_PIN_PASSO_2.5mm | JST | B3B-XH-A (LF)(SN) | FARNELL (1516277)
82 | 1 | J27 | PJ-002AH-SMT-TR | CONN POWER JACK 2.1X5.5MM HI CUR | Jack SMD 2.1x5.5 PJ-037A | CUI | PJ-002AH-SMT-TR PJ-037A | DIGIKEY(CP-002AHPJTR-ND)
83 | 1 | J29 | MDT180M01001 | Connettori PCI Express/PCI 67P SMT RCPT H1.8 M Key | 67 PIN PASSO 0.5mm | AMPHENOL | MDT180M01001 | MOUSER(523-MDT180M01001)
84 | 2 | J31 J32 | POM-5246P-R | MIC COND ANALOG OMNI -48DB | PTH_2_PIN | PUI INC | POM-5246P-R | DIGIKEY(668-1312-ND)
85 | 3 | J33 J50 J55 | DS1020-02-02MVT1 | HDR 2 CKT Right-Angle 1.25MM | 2P SMD | CONNFLY | DS1020-02-02MVT1 | Rudcom
86 | 1 | J40 | MDT180E01001 | Connettori PCI Express/PCI 67P SMT RCPT H1.8 E Key | 67 PIN PASSO 0.5mm | AMPHENOL | MDT180E01001 | MOUSER(523-MDT180E01001)
87 | 1 | J41 | STRIP 8 | STRIP MASC.1x8P CS.p=2.54mm | PTH | SAMTEC | TSW-108-24-T-S | CLAITRON LASI SILVESTAR S.R.L.
88 | 1 | J42 | MDT180B01001 | Connettori PCI Express/PCI 67P SMT RCPT H1.8 B Key | 67 PIN PASSO 0.5mm | AMPHENOL | MDT180B01001 | MOUSER(523-MDT180B01001)
89 | 1 | J43 | SIM Holder 6p | CONNECTOR SIM CARD W/OUT BOSS | SMD 6 PIN | AVX | 045036006211862+ | Mouser(581-045036006211862+)
90 | 1 | J44 | SFW30R-1STE9LF | FFC e FPC 30P SIDE ENTRY SMT 1MM LOWER CONTACT | 30 PIN PASSO 1mm | AMPHENOL | SFW30R-1STE9LF | MOUSER(649-SFW30R-1STE9LF)
91 | 1 | J45 | HEADER 12 | STRIP FEMM.1x12P CS.p=2.54mm SMT | 12X1P=2.54mm SMT | SAMTEC | SSM-112-L-SV | DIGIKEY(SAM1148-12-ND )
92 | 1 | J46 | F1013-0402 | STRIP MASC.1x6P CS.p=2.54mm | PTH | SAMTEC | TSW-106-24-T-S | CLAITRON LASI SILVESTAR S.R.L.
93 | 1 | J47 | MCV 1,5/12-G-3,5 | 12X1 3.5 | 12X1 3.5 | PHOENIX | MCV 1,5/12-G-3,5 | SAMTEC
94 | 1 | J48 | SJ-435107RS | 3.5 PHONEJACK TRRS WITH SWITCH | PTH | CUI Inc | SJ-435107RS | MOUSER(490-SJ-435107RS)
95 | 2 | J51 J52 | SWF-0810H17 | STRIP MASCH.1x12P CS.p=2.0mm SMT | 12X1P=2.0mm SMT | SAMTEC | TMM-112-01-G-S | FARNELL(1668553)
96 | 1 | J53 | 54132-3062 | CONN FPC/FFC .50mm 30 pos bot contact | 30 PIN PASSO 0.5mm | MOLEX | 54132-3062 | MOUSER(538-54132-3062)
97 | 1 | J54 | STRIP_14 | STRIP MASCH 1X14P p=2.54mm PTH | PTH | MOLEX | 0022284143 | DIGIKEY(WM50016-14-ND)
98 | 2 | J56 JP1 | JMP 3 | STRIP MASC.1x3P CS.p=2.54mm | PTH | SAMTEC | TLW-103-05-G-S | FARNELL(1668490)
99 | 1 | JPS1 | SOLDER JUMPER X 2 | SODER JUMPER SU PCB | PCB
100 | 5 | L3 L4 L5 L6 L7 | HF70ACB201209-T | FERRITE CHIP 10 OHM 600MA 0805 | SMD_0805 | TDK | HF70ACB201209-T | DIGIKEY (445-6180-1-ND)
101 | 8 | L8 L9 L10 L11 L12 L13 L15 L16 | BLM15GG471SN1D | FERRITE CHIP 470 OHM 200MA 0402 | SMD_0402 | MURATA | BLM15GG471SN1D | DIGIKEY ( 490-5198-1-ND)
102 | 30 | L14 L44 L56 L57 L58 L59 L60 L61 L62 L63 L64 L66 L67 L68 L69 L70 L71 L72 L73 L74 L75 L76 L77 L78 L80 L81 L82 L83 L84 L85 | BLM18EG601SN1 | FERRITE BEAD 600ohm 500mA 0603 SMD | SMD_0603 | MURATA | BLM18EG601SN1 SMD | MURATA ELETTRONICA SPA
103 | 1 | L17 | 3.3uH | INDUCTOR SHIELD PWR 3.3UH SMD | SMD_SRU1028 | BOURNS INC. | SRU1028-3R3Y | DIGIKEY (SRU1028-3R3YCT-ND)
104 | 1 | L40 | 10uH | Induttori fissi WE-HCI Flat 1050 10uH 7.2A | SMD_10_2X10_5 | WURTH | 7443251000 | MOUSER(710-7443251000)
105 | 1 | L41 | 22uH | INDUTTANZA 22uH 1,67A DR73-220 SMD | SMD_DR73 | COILTRONICS | DR73-220-R | CLAITRON LASI SILVESTAR S.R.L.
106 | 1 | L42 | ACM1513-551-2PL-TLHF | CHOKE COMM MODE 550 OHM 10A SMD | SMD | TDK | ACM1513-551-2PL-TLHF | DIGIKEY(445-9331-1-ND)
107 | 1 | L45 | 15uH | INDUCTOR POWER .68UH 17A SMD 6.90mm x 6.90mm | SMD | WURTH | 744311068 | DIGIKEY(732-1149-1-ND)
108 | 10 | L46 L47 L48 L49 L50 L51 L52 L53 L54 L55 | BLM15AG121SN1D | FERRITE CHIP 120 OHM 500MA 0402 | SMD_0402 | MURATA | BLM15AG121SN1D | DIGIKEY (490-1005-2-ND)
109 | 1 | L65 | 1uH | Induttori fissi 1.0uH 2.08A 68mOhms Pwr Circuit Inductor | Ind_2016 | TDK | VLS201612CX-1R0M | MOUSER(810-VLS201612CX-1R0M )
110 | 4 | L86 L87 L88 L91 | 1uH | FIXED IND 1UH 11A 16.5 Mohm SMD | SMD | VISHAY | IHLP2525CZER1R0M01 | MOUSER(70-IHLP2525CZER1R0M0)
111 | 2 | L89 L90 | 2.2uH | FIXED IND 2.2UH 7A 16.5 Mohm SMD | SMD | VISHAY | IHLP2525CZER2R2M1 | MOUSER(70-IHLP2525CZER2R2)
112 | 1 | L92 | 7427927161 | FERRITE BEAD 600R 0.25A 0402 | SMD_0402 | WURTH | 7427927161 | FARNELL (1961693)
113 | 2 | L93 L94 | 270nH | Induttori fissi 270nH Shld 20% 35.5A 228mOhms | SMD_7_65X11mm | COILCRAFT | SLC1175-271MEB | MOUSER(994-SLC1175-271MEB)
114 | 1 | M1 | MT8KTF51264HZ-1G6 |  | none
115 | 5 | M2 M3 M13 M14 M15 | FDV301N | FDV301N N CHANNEL DIGITAL FET | SOT23 | FAIRCHILD | FDV301N (ROHS COMPLIANT) | CLAITRON LASI SILVESTAR S.R.L
116 | 1 | M16 | MT8KTF51264HZ-1G6 |  | none
117 | 7 | M17 M18 M19 M20 M21 M22 M23 | DMN3730U-7 | DMN3730U-7 N 750mA 30V POWER MOS | SOT23 | DIOES | DMN3730U-7 | DIGIKEY(DMN3730U-7DICT-ND)
118 | 1 | Q6 | SI4431ADY-T1 | Trans MOSFET P-CH 30V 5.3A 8-Pin SOIC | SOIC_8 | VISHAY | SI4431ADY-T1 | ARROEW (FDC645N)
119 | 1 | Q7 | FDC655BN | MOSFET N-CH 30V 6.3A 6-Pin TSOT-23 | TSOT-23 | ON SEMI | FDC655BN | ARROW (FDC655BN)
120 | 9 | Q8 Q9 Q10 Q11 Q12 Q13 Q14 Q21 Q22 | 2N7002L | TRAN NMOS 60V 115MA SOT23 | SOT23 | ON SEMICONDUCTORS | 2N7002LT1G | DIGIKEY(2N7002LT3GOSCT-ND)
121 | 3 | Q16 Q17 Q18 | IRLML6346TRPBF | MOSFET N-CH 30V 3.4A SOT23 | SOT-23 | ON SEMI | IRLML6346TRPBF | DIGIKEY (IRLML6346TRPBFCT-ND)
122 | 2 | Q19 Q20 | SiR870DP | MOSFET 100V 60A 20W 6mohm @ 4.5V | PowerPAK-1212-8 | VISHAY | SiR870DP-T1-GE3 | DIGIKEY(SiR870DP-T1-GE3CT-ND)
123 | 1 | Q23 | BC856BLT1G | TRANS PNP 65V 0.1A SOT23 | SOT_23 | ON SEMICONDUCTOR | BC856BLT1G | DIGIKEY(BC856BLT1GOSCT-ND)
124 | 1 | Q24 | BC847ALT1G | TRANS NPN 45V 0.1A SOT23 | SOT_23 | ON SEMI | BC847ALT1G | DIGIKEY (BC847ALT1GOSCT-ND)
125 | 4 | Q25 Q26 Q27 Q28 | NDC7002N | MOSFET 2N-CH 50V 0.51A SSOT6 | SSOT_6 | ON SEMI | NDC7002N | DIGIKEY (NDC7002NCT-ND)
126 | 2 | Q29 Q30 | BSR17A | TRANS NPN 40V 0.2A SOT-23 | SOT_23 | ON SEMI | BSR17A | DIGIKEY ( DIGIKEY(BSR17ATR-ND)
127 | 1 | Q5 | SI4925DY | Trans MOSFET P-CH 30V 5.3A 8-Pin SOIC | SOIC_8 | ON SEMICONDUCTOR | SI4431ADY-T1 | ARROW (SI4431ADY-T1)
128 | 85 | R1 R5 R7 R9 R11 R13 R15 R17 R19 R22 R23 R24 R25 R26 R27 R28 R29 R30 R31 R32 R33 R38 R39 R47 R49 R50 R51 R52 R53 R54 R59 R69 R70 R71 R73 R74 R75 R76 R77 R78 R81 R82 R83 R84 R85 R86 R87 R88 R89 R90 R91 R92 R93 R98 R99 R100 R101 R102 R103 R107 R110 R113 R115 R137 R150 R167 R168 R169 R187 R188 R246 R336 R337 R649 R651 R736 R737 R739 R740 R742 R743 R952 R1217 R1218 R1219 | 4,7K | RESIS.CHIP 4,7K 5% 0402 SMD | SMD_0402 | ROYAL OHM | RESIS.CHIP 4,7K 5% 0402 SMD | CAMEL ELETTRONICA SRL #
129 | 30 | R2 R55 R95 R96 R118 R178 R186 R227 R228 R229 R230 R235 R236 R237 R238 R428 R430 R453 R455 R458 R593 R598 R688 R694 R845 R938 R1103 R1104 R1115 R1116 | 1K | RESIS.CHIP 1K 1% 0402 SMD | SMD_0402 | ROYAL OHM | RESIS.CHIP 1K 1% 0402 SMD | CAMEL ELETTRONICA SRL #
130 | 2 | R3 R4 | 187 | RESIS.CHIP 187R 1% 0402 SMD | SMD_0402 | BOURNS | CR0402-FX-1870GLF | DIGIKEY(CR0402-FX-1870GLF-ND)
131 | 28 | R6 R8 R10 R12 R14 R16 R18 R20 R21 R56 R57 R58 R63 R64 R65 R66 R67 R68 R1079 R1086 R1229 R1236 R1248 R1252 R1265 R1270 R1291 R1313 | 20K | RESIS.CHIP 20K 1% 0402 SMD | SMD_0402 | YAGEO | RC0402FR-1320KL | MOUSER(603-RC0402FR-1320KL)
132 | 31 | R34 R35 R36 R37 R40 R41 R42 R43 R44 R45 R46 R60 R72 R179 R429 R431 R778 R962 R963 R964 R965 R966 R967 R968 R969 R970 R971 R973 R974 R975 R988 | 33 | RESIS.CHIP 33R 5% 0402 SMD | SMD_0402 | ROYAL OHM | RESIS.CHIP 33R 5% 0402 SMD | CAMEL ELETTRONICA SRL #
133 | 14 | R48 R61 R62 R105 R119 R120 R121 R122 R123 R124 R135 R466 R467 R589 | 10 | RESIS.CHIP 10R 5% 0402 SMD | SMD_0402 | ROYAL OHM | RESIS.CHIP 10R 5% 0402 SMD | CAMEL ELETTRONICA SRL #
134 | 6 | R94 R647 R907 R908 R909 R910 | 510 | RESIS.CHIP 510R 1% 0402 SMD | SMD_0402 | ROYAL OHM | RESIS.CHIP 510R 1% 0402 SMD | CAMEL ELETTRONICA SRL #
135 | 138 | R97 R104 R106 R108 R109 R111 R112 R114 R174 R207 R210 R222 R223 R224 R225 R226 R231 R232 R233 R234 R242 R243 R247 R260 R261 R274 R275 R318 R320 R324 R327 R333 R602 R605 R608 R636 R652 R653 R662 R703 R705 R731 R777 R830 R831 R832 R838 R844 R849 R895 R898 R923 R925 R927 R929 R930 R931 R942 R943 R992 R993 R994 R995 R996 R998 R1004 R1006 R1007 R1009 R1012 R1015 R1016 R1017 R1018 R1019 R1020 R1042 R1043 R1044 R1069 R1074 R1118 R1119 R1126 R1127 R1132 R1150 R1151 R1152 R1153 R1157 R1158 R1159 R1160 R1165 R1166 R1176 R1177 R1178 R1179 R1180 R1181 R1182 R1183 R1184 R1185 R1186 R1187 R1188 R1189 R1190 R1191 R1192 R1226 R1232 R1234 R1235 R1237 R1239 R1240 R1241 R1246 R1249 R1251 R1253 R1254 R1256 R1257 R1258 R1259 R1263 R1267 R1272 R1273 R1274 R1275 R1276 R1277 | 10K | RESIS.CHIP 10K 1% 0402 SMD | SMD_0402 | ROYAL OHM | RESIS.CHIP 10K 1% 0402 SMD | CAMEL ELETTRONICA SRL #
136 | 285 | R117 R198 R199 R208 R209 R211 R244 R245 R248 R250 R252 R253 R254 R273 R277 R281 R315 R316 R317 R322 R323 R325 R328 R329 R330 R331 R334 R340 R341 R440 R441 R444 R445 R448 R449 R452 R454 R459 R460 R463 R464 R663 R665 R666 R701 R704 R707 R708 R716 R732 R733 R744 R745 R746 R747 R748 R749 R750 R751 R752 R753 R754 R755 R756 R757 R758 R759 R760 R761 R762 R763 R764 R765 R766 R767 R768 R769 R770 R771 R772 R773 R774 R775 R776 R779 R780 R781 R782 R783 R784 R785 R786 R787 R788 R789 R790 R791 R792 R793 R794 R795 R796 R797 R798 R801 R802 R803 R804 R805 R806 R807 R808 R811 R812 R813 R814 R815 R816 R817 R818 R819 R820 R821 R822 R823 R824 R829 R833 R834 R836 R837 R846 R847 R848 R851 R852 R853 R854 R855 R856 R857 R858 R859 R860 R870 R873 R874 R876 R878 R879 R880 R881 R882 R883 R884 R885 R886 R887 R888 R889 R890 R891 R892 R893 R894 R896 R897 R899 R900 R901 R902 R903 R904 R905 R906 R911 R912 R913 R914 R915 R916 R917 R918 R919 R920 R921 R922 R924 R926 R928 R932 R933 R940 R946 R947 R948 R949 R950 R951 R953 R954 R955 R956 R957 R958 R959 R960 R961 R1029 R1032 R1047 R1048 R1049 R1050 R1051 R1052 R1053 R1054 R1055 R1056 R1057 R1060 R1061 R1062 R1063 R1065 R1066 R1068 R1071 R1075 R1077 R1080 R1081 R1082 R1088 R1089 R1099 R1111 R1113 R1123 R1125 R1129 R1131 R1133 R1134 R1143 R1144 R1145 R1146 R1147 R1167 R1168 R1169 R1170 R1171 R1193 R1215 R1216 R1220 R1221 R1222 R1223 R1225 R1231 R1242 R1247 R1262 R1266 R1278 R1279 R1280 R1281 R1282 R1287 R1293 R1299 R1302 R1303 R1304 R1309 R1315 R1322 R1324 R1325 R1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 | 0 | RESIS.CHIP 0R 5% 0402 SMD | SMD_0402 | ROYAL OHM | RESIS.CHIP 0R 5% 0402 SMD | CAMEL ELETTRONICA SRL #
137 | 2 | R131 R146 | 200 | RES 200 OHM 1/10W 1% 0402 SMD | SMD_0402 | PANASONIC | ERJ-2RKF2000X | DIGIKEY (P200LCT-ND)
138 | 2 | R132 R147 | 698R | RESIS.CHIP 698R 1% 0402 SMD | SMD_0402 | ROYAL OHM | RESIS.CHIP 698R 1% 0402 SMD | CAMEL ELETTRONICA SRL #
139 | 1 | R136 | 1,5K | RES 1,5K OHM 1/10W 1% 0402 SMD | SMD_0402
140 | 4 | R140 R141 R142 R144 | 82R | RESIS.CHIP 82R 1% 0402 SMD | SMD_0402 | Vishay/Dale | CRCW040282R0FKED | DIGIKEY(541-82.0LTR-ND)
141 | 4 | R143 R145 R148 R149 | 150R | RESIS.CHIP 150R 1% 0402 SMD | SMD_0402 | YAGEO | RC0402FR-07150RL | DIGIKEY(311-150LRTR-ND)
142 | 4 | R151 R152 R153 R154 | 130 | RESIS.CHIP 130R 1% 0402 SMD | SMD_0402 | BOURNS | CR0402-FX-1300GLF | DIGIKEY(CR0402-FX-1300GLFTR-ND)
143 | 39 | R175 R176 R177 R439 R442 R443 R446 R447 R450 R451 R456 R457 R461 R462 R465 R976 R977 R978 R979 R980 R981 R982 R983 R984 R985 R986 R987 R989 R990 R1227 R1233 R1244 R1250 R1264 R1268 R1284 R1286 R1306 R1308 | 49,9 | RESIS.CHIP 49,9R 1% 0402 SMD | SMD_0402 | NIC | NCR04F49R9TRF | MODULI ELETTRONICI E COMPONENTI spa
144 | 14 | R180 R181 R182 R183 R189 R190 R239 R240 R249 R343 R632 R645 R650 R1072 | 100 | RESIS.CHIP 100R 5% 0402 SMD | SMD_0402 | ROYAL OHM | RESIS.CHIP 100R 5% 0402 SMD | CAMEL ELETTRONICA SRL #
145 | 4 | R193 R194 R195 R196 | 330m | Resistori rilevatori di corrente - SMD 1/8watt .33ohms 1% | SMD_0402 | VISHAY DALE | RCWE0402R330FKEA | MOUSER(71-RCWE0402R330FKEA)
146 | 4 | R197 R200 R201 R202 | 5.1 | RESIS.CHIP 5,1 1% 0402 SMD | SMD_0402 | yageo | RES SMD 5.1 OHM 1% 1/16W 0402 | Digikey(YAG3370TR-ND )
147 | 12 | R203 R204 R205 R639 R640 R641 R642 R643 R644 R944 R945 R1094 | 330 | RESIS.CHIP 330R 5% 0402 SMD | SMD_0402 | ROYAL OHM | RESIS.CHIP 330R 5% 0402 SMD | CAMEL ELETTRONICA SRL #
148 | 11 | R206 R214 R215 R216 R217 R218 R219 R220 R221 R1090 R1091 | 22 | RESIS.CHIP 22R 5% 0402 SMD | SMD_0402 | ROYAL OHM | RESIS.CHIP 22R 5% 0402 SMD | CAMEL ELETTRONICA SRL #
149 | 2 | R212 R1155 | 12,1K | RESIS.CHIP 12,1K 1% 0402 SMD | SMD_0402 | ROYAL OHM | RESIS.CHIP 12,1K 1% 0402 SMD | CAMEL ELETTRONICA SRL #
150 | 2 | R251 R633 | 6,04K | RESIS.CHIP 6K04 1% 0603 SMD | SMD_0603 | ROYAL OHM | RESIS.CHIP 6K04 1% 0603 SMD | CAMEL ELETTRONICA SRL #
151 | 32 | R256 R321 R332 R648 R841 R1045 R1046 R1194 R1195 R1196 R1197 R1198 R1199 R1200 R1201 R1202 R1203 R1204 R1205 R1206 R1207 R1208 R1209 R1210 R1224 R1228 R1243 R1245 R1260 R1261 R1283 R1305 | 0 | RESIS. 0R 1/4W 1206 SMD E96 | SMD_1206 | YAGEO | RC1206JR-070RL | DIGIKEY(311-0.0ERTR-ND)
152 | 1 | R257 | 51K | RESIS.CHIP 51K 1% 0402 SMD | SMD_0402 | ROYAL OHM | RESIS.CHIP 51K 1% 0402 SMD | CAMEL ELETTRONICA SRL #
153 | 1 | R258 | 68K | RESIS.CHIP 68K 1% 0402 SMD | SMD_0402 | ROYAL OHM | RESIS.68K 1% 0402 SMD | CAMEL ELETTRONICA SRL #
154 | 13 | R259 R338 R339 R1109 R1112 R1120 R1121 R1122 R1124 R1128 R1130 R1149 R1172 | 47K | RESIS.CHIP 47K 1% 0402 SMD | SMD_0402 | ROYAL OHM | RESIS.CHIP 47K 1% 0402 SMD | CAMEL ELETTRONICA SRL #
155 | 1 | R262 | 1,65K | RESIS.CHIP 1K65 1% 0402 SMD | SMD_0402 | PANASONIC | ERJ-2RKF1651X | DIGIKEY (P1.65KLTR-ND)
156 | 1 | R263 | 680 | RES SMD 680 OHM 1% 1/16W 0402 | SMD_0402 | YAGEO | RC0402FR-07680RL | DIGIKEY(311-680LRCT-ND)
157 | 3 | R289 R972 R1175 | 1,43K | RESIS.CHIP 1,43K 1% 0402 SMD | SMD_0402 | ROYAL OHM | RESIS.CHIP 1,43K 1% 0402 SMD | CAMEL ELETTRONICA SRL #
158 | 1 | R299 | 475R | RESIS.CHIP 475R 1% 0402 SMD | SMD_0402 | PANASONIC ECG | ERJ-2RKF4750X ( COMP.) | DIGIKEY (P475LTR-ND)
159 | 13 | R326 R599 R622 R656 R842 R843 R1154 R1161 R1162 R1163 R1164 R1297 R1319 | 100K | RESIS.CHIP 100K 5% 0402 SMD | SMD_0402 | ROYAL OHM | RESIS.CHIP 100K 5% 0402 SMD | CAMEL ELETTRONICA SRL #
160 | 3 | R335 R625 R626 | 15K | RESIS.CHIP 15K 1% 0402 SMD | SMD_0402 | ROYAL OHM | RESIS.CHIP 15K 1% 0402 SMD | CAMEL ELETTRONICA SRL #
161 | 1 | R342 | 27K | RESIS.CHIP 27K 1% 0402 SMD | SMD_0402 | ROYAL OHM | RESIS.CHIP 27K 1% 0402 SMD | CAMEL ELETTRONICA SRL #
162 | 1 | R600 | 4,32K | RESIS.CHIP 4,32K 0402 1% SMD | SMD_0402 | PANASONIC | ERJ-2RKF4321X | DIGIKEY (P4.32KLDKR-ND)
163 | 1 | R606 | 30.9K | RESIS.CHIP 30.9K 1% 0402 SMD | SMD_0402 | BOURNS | ERJ-1GNF3092C | DIGIKEY( P122921CT-ND)
164 | 2 | R609 R610 | 0R | Thick Film Resistors 0OHM 1WATT 5% | SMD_2512 | bourns | CR2512-J/-000ELF | MOUSER(652-CR2512-J/-000ELF)
165 | 1 | R623 | 28mOhm | Current Sense Resistors - SMD 0.028 Ohm 1% 1W | SMD_2512 | VISHAY | WSL2512R0280FEA18 | DIGIKEY(WSLH-.028TR-ND)
166 | 3 | R624 R1083 R1213 | 5,1K | RES SMD 5.1K OHM 1% 1/16W 0402 | SMD_0402 | Yageo | RC0402FR-075K1L | DIGIKEY (311-5.10KLRCT-ND)
167 | 1 | R627 | 13,7K | RESIS.CHIP 13,7K 1% 0402 SMD | SMD_0402 | PANASONIC | ERJ-2RKF1372X | DIGIKEY(P13.7KLCT-ND)
168 | 2 | R628 R1087 | 1,21K | RESIS.CHIP 1,21K 1% 0603 SMD | SMD_0603 | ROYAL OHM | RES.1K21 1% 0603 SMD | CAMEL ELETTRONICA SRL #
169 | 1 | R629 | 25mOhm | Current Sense Resistors - SMD 0.025 Ohm 1% 1W | SMD_2512 | VISHAY | WSL2512R0250FEA18 | DIGIKEY(WSLH-.025CT-ND)
170 | 1 | R630 | 54,9K | RESIS.CHIP 54,9K 1% 0603 SMD E96 | SMD_0603 | ROYAL OHM | CHIP RES.54K9 0603 1% | CAMEL ELETTRONICA SRL #
171 | 1 | R631 | 1,13K | RESIS.CHIP 1,13K 1% 0402 SMD | SMD_0402 | YAGEO | RC0402FR-071K13L | DIGIKEY(YAG3032CT-ND)
172 | 1 | R634 | 10K | RESIS.CHIP 10K 1% 0603 SMD | SMD_0603 | ROYAL OHM | RES.10K 0603 1% SMD | CAMEL ELETTRONICA SRL #
173 | 2 | R635 R637 | 33,2K | RESIS.CHIP 33K2 1% 0603 SMD | SMD_0603 | ROYAL OHM | RESIS.CHIP 33K2 1% 0603 SMD | CAMEL ELETTRONICA SRL #
174 | 1 | R638 | 10 | RESIS.CHIP 10R 1% 0603 SMD | SMD_0603 | ROYAL OHM | RESIS.CHIP 10R 1% 0603 SMD | CAMEL ELETTRONICA SRL #
175 | 1 | R654 | 0,005 | RES 0.005 OHM 2W 1% 2512 SMD | SMD_2512 | YAGEO | PA2512FKF7W0R005E | DIGIKEY (YAG2145CT-ND)
176 | 6 | R655 R1100 R1101 R1106 R1107 R1148 | 22K | RESIS.CHIP 22K 5% 0402 SMD | SMD_0402 | ROYAL OHM | RESIS.CHIP 22K 5% 0402 SMD | CAMEL ELETTRONICA SRL #
177 | 1 | R657 | 1,02M | RESIS.CHIP 1,02M 1% 0402 SMD | SMD_0402 | VISHAY | CRCW04021M02FKED | DIGIKEY (541-1.02MLCT-ND)
178 | 1 | R658 | 127K | RESIS.CHIP 127K 1% 0402 SMD | SMD_0402 | PANASONIC | ERJ-2RKF1273X | DIGIKEY (P127KLCT-ND)
179 | 1 | R659 | 22,1K | RESIS.CHIP 22,1K 1% 0402 SMD | SMD_0402 | KAMAYA | RMC1/16SK2212FT | MODULI ELETTRONICI E COMPONENTI spa
180 | 4 | R709 R710 R939 R941 | 330 | RESIS.CHIP 330R 5% 0603 1/10W SMD | SMD_0603 | NIC | NRC06J331TRF | MODULI ELETTRONICI E COMPONENTI spa
181 | 4 | R734 R735 R738 R741 | 220K | RESIS.CHIP 220K 5% 0402 SMD | SMD_0402 | ROYAL OHM | RESIS.CHIP 220K 5% 0402 SMD | CAMEL ELETTRONICA SRL #
182 | 2 | R1064 R1156 | 1M | RESIS.CHIP 1M 1% 0402 SMD | SMD_0402 | ROYAL OHM | RESIS.1M 1% 0402 SMD | CAMEL ELETTRONICA SRL #
183 | 1 | R1070 | 39K | RESIS.CHIP 39K 1% 0402 SMD | SMD_0402 | BOURNS | CR0402-FX-3902GLF | DIGIKEY(CR0402-FX-3902GLF-ND)
184 | 8 | R1073 R1076 R1078 R1092 R1093 R1097 R1114 R1117 | 4,7K | RES 4.7K OHM 1/10W 1% 0402 SMD | SMD_0402 | PANASONIC | ERJ-2RKF4701X | DIGIKEY (P4.70KLCT-ND)
185 | 1 | R1084 | 10,7K | RESIS.CHIP 10,7K 1% 0603 E96 | SMD_0603 | ROYAL OHM | RESIS.CHIP 10,7K 1% 0603 E96 | CAMEL ELETTRONICA SRL #
186 | 1 | R1095 | 2K | RESIS.CHIP 2K 1% 0402 SMD | SMD_0402 | ROYAL OHM | RESIS.CHIP 2K 1% 0402 SMD | CAMEL ELETTRONICA SRL #
187 | 4 | R1096 R1098 R1108 R1110 | 75 | RESIS.CHIP 75R 1% 0402 SMD | SMD_0402 | KAMAYA | RMC1/16SK75R0FTH | MODULI ELETTRONICI E COMPONENTI spa
188 | 2 | R1102 R1105 | 2K2 | RESIS.CHIP2K2 1% 0402 SMD | SMD_0402 | yageo | RT0402DRD072K2L | DIGIKEY(RT0402DRD072K2L-ND )
189 | 8 | R1135 R1136 R1137 R1138 R1139 R1140 R1141 R1142 | 5R6 | RESIS.CHIP 5.6 ohm 5% 0402 SMD | SMD_0402 | YAGEO | RC0402JR-075R6L | DIGIKEY(311-5.6JRDKR-ND)
190 | 1 | R1173 | 120K | RESIS.CHIP 120K 1% 0402 SMD | SMD_0402 | WALSIN | WR04W1203FTL | MODULI ELETTRONICI E COMPONENTI spa
191 | 1 | R1174 | 180K | RESIS.CHIP 180K 1% 0402 SMD | SMD_0402 | ROYAL OHM | RESIS.CHIP 180K 1% 0402 SMD | CAMEL ELETTRONICA SRL #
192 | 2 | R1211 R1212 | 51,1K | RESIS.CHIP 51K1 1% 0402 SMD | SMD_0402 | ROYAL OHM | CAMEL ELETTRONICA SRL #
193 | 1 | R1214 | 392K | RES 392K OHM 1/10W 1% 0402 SMD | SMD_0402 | VISHAY | CRCW0402392KFKED | DIGIKEY(541-392KLTR-ND)
194 | 1 | R1230 | 7,5K | RES 7,5K OHM 1/10W 1% 0402 SMD | SMD_0402 | BOURNS | CR0402-FX-7501GLF | DIGIKEY (CR0402-FX-7501GLFTR-ND)
195 | 1 | R1238 | 12,4K | RESIS.CHIP 12,4K 1% 0402 SMD | SMD_0402 | ROYAL OHM | RESIS.CHIP 12,4K 1% 0402 SMD | CAMEL ELETTRONICA SRL #
196 | 1 | R1255 | 31,6K | RESIS.CHIP 31,6K 1% 0402 SMD | SMD_0402 | VISHAY/DALE | CRCW040231K6FKED | DIGIKEY (541-31.6KLCT-ND)
197 | 1 | R1269 | 45,3K | RESIS.CHIP 45,3K 1% 0402 SMD | SMD_0402 | panasonic | ERJ-2RKF4532X | DIGIKEY(P45.3KLCT-ND)
198 | 1 | R1271 | 73,2K | RESIS.CHIP 73K2 1% 0402 SMD | SMD_0402 | PANASONIC | ERJ-2RKF7322X | DIGIKEY (P73.2KLCT-ND)
199 | 2 | R1285 R1307 | 0R | RESIS. CHIP 0R 1/4W 1% 2010 SMD | SMD_2010 | VISHAY | CRCW20100000Z0EF | FARNELL(1653190)
200 | 6 | R1288 R1298 R1300 R1310 R1320 R1321 | 10K | RESIS.CHIP 10K 5% 0402 SMD | SMD_0402 | ROYAL OHM | RESIS.CHIP 10K 5% 0402 SMD | CAMEL ELETTRONICA SRL #
201 | 4 | R1289 R1290 R1311 R1312 | 1,5 | RESIS.CHIP 1,5OHM 1% 0402 SMD | SMD_0402 | WELWYN | ASC0402-1R5FT10 | FARNELL(2078842 )
202 | 2 | R1292 R1314 | 30,1K | RESIS.CHIP 30K1 1% 0402 SMD | SMD_0402 | ROYAL OHM | RESIS.CHIP 30K1 1% 0402 SMD | CAMEL ELETTRONICA SRL #
203 | 6 | R1294 R1295 R1296 R1316 R1317 R1318 | 1K | RESIS.CHIP 1K 5% 0402 SMD | SMD_0402 | ROYAL OHM | RESIS.CHIP 1K 5% 0402 SMD | CAMEL ELETTRONICA SRL #
204 | 2 | R1301 R1323 | 56,2K | RESIS.CHIP 56,2K 1% 0402 SMD | SMD_0402 | ROYAL OHM | RESIS.CHIP 56,2K 1% 0402 SMD | CAMEL ELETTRONICA SRL #
205 | 2 | SW1 SW2 | TDA08H0SB1R | SWITCH DIP SIP HALF 8POS SMD | 2X8 PASSO 1.27mm | C&k | TDA08H0SB1R | MOUSER(611-TDA08H0SB1R)
233 | 1 | TVS1 | IP4221CZ6-S,115 | TVS ESD Dual INTEG ESD Protection SPI | XSON-6 | NXP | IP4221CZ6-S,115 | MOUSER(771-IP4221CZ6-S,115 )
234 | 1 | U1 | 88SE9235 | Two-Lane PCIe 2.0 to Four-Port 6 | 76-pin QFN | MARVELL | 88SE9235 | MARVELL(88SE9235A1-NAA2C000)
235 | 1 | U105 | PI7C9X2G612GP | PCI 6 Ports 6Lanes PCIE2 Packet Switch | LBGA_196 | DIODES | PI7C9X2G612GPCNJE | MOUSER( 729-PI7C9X2G612GPCNJ )
236 | 1 | U2 | SN74LVC16373ADGGR | IC TRANS D-TYP LATCH 3ST 48TSSOP | TSSOP-48 | TEXAS | SN74LVC16373ADGGR | DIGIKEY(296-13241-1-ND)
237 | 1 | U3 | MT28EW01GABA1HJS-0AAT | NOR Flash EW-SERIES FLASH NOR SLC 64MX16 TSOP | TSOP-56 | MICRON | MT28EW01GABA1HJS-0AAT | MOUSER(340-279939-TRAY)
238 | 1 | U4 | MT29F4G08ABADAWP-IT:D | IC NAND FLASH 4GB 3.3V 48-TSOP LONGEVITY | TSOP_48 | MICRON | MT29F4G08ABADAWP-IT:D | AVNET EXPRESS
239 | 3 | U5 U6 U7 | SN74LVC1G86DCKT | Porte logiche SNGL 2 Input Exclusive OR Gate | sc70-5 | TEXAS | SN74LVC1G86DCKT | MOUSER(595-SN74LVC1G86DCKT)
240 | 6 | U8 U10 U12 U17 U24 U97 | TXS0104E | BIDIRECTIONAL VOLTAGE-LEVEL TRANSLATOR | TSSOP14 | TEXAS | TXS0104EPWR | TI.COM
241 | 1 | U9 | S25FL256SAGMFI000 | IC FLASH 256M SPI 133MHZ 16SOIC | SOIC_16 | CYPRESS | S25FL256SAGMFI000 | DIGIKEY(1274-1003-ND)
242 | 2 | U13 U14 | RCLAMP0524J.TCT | TVS DIODE 5V 15V SLP2710P8 | 10-UFDFN | SEMTEC | RCLAMP0524J.TCT | DIGIKEY(RCLAMP0524JCT-ND)
243 | 2 | U15 U16 | FXLP34P5X | IC TRANSLATOR DUAL 4BIT 16-DQFN | SC70-5 | ON SEMI | FXL4TD245BQX | DIGIKEY (FXL4TD245BQXCT-ND)
244 | 1 | U23 | MAX3232ECPWR | IC RS232 3V-5.5V DRVR 16-TSSOP | TSSOP16 | TEXAS | MAX3232ECPWR | DIGIKEY (296-19263-2-ND)
245 | 1 | U25 | DS1339U-33+ | IC RTC CLK/CALENDAR I2C 8-USOP | USOP8 | MAXIM | DS1339U-33+ | DIGIKEY(DS1339U-33+-ND)
246 | 1 | U26 | AT24C256C-SSHL-B | EEPROM 256K (32K X 8), 2-WI 1.8V | SOIC-8 | MICROCHIP | AT24C256C-SSHL-B | MOUSER(556-AT24C256C-SSHL-B)
247 | 1 | U27 | ADT7481ARM | 2 CH TEMP SNSR/ALARM 2 WIRE | MSOP-10 | ON SEMI | ADT7481ARMZ-REEL | MOUSER(863-ADT7481ARMZ-REEL)
248 | 1 | U28 | NLSV1T34AMX1TCG | IC XLATOR 1BIT NON-INV 6ULLGA | 6-XFLGA | ON SEMI | NLSV1T34AMX1TCG | DIGIKEY (NLSV1T34AMX1TCGOSTR-ND)
249 | 1 | U29 | TPS72012DRVT | IC REG LDO 1.2V 0.35A 6SON | 6SON | TEXAS | TPS72012DRVT | DIGIKEY (296-25807-2-ND)
250 | 1 | U30 | KSZ9031RNXCA | Gigabit Ethernet Transceiver with RGMII, WOL | QFN48 | MICREL | KSZ9031RNXCA | MOUSER(998-KSZ9031RNXCA)
251 | 3 | U31 U32 U103 | SRV05-4 | TVS Diode Array5VWM 17.5VC USB | SOT23-6 | SEMTEC | SRV05-4.TCT | DIGIKEY (SRV05-4CT-ND)
252 | 1 | U33 | SN74LVC2G07DBVR | Buffer e line driver Dual w/ Open-Drain | SOT-26 | TEXAS | SN74LVC2G07DBVR | MOUSER(595-SN74LVC2G07DBVR)
253 | 1 | U35 | RT8058GQW | IC REG BUCK ADJUSTABLE 2A 16WQFN | QFN16 | Richtek | RT8058GQW | DIGIKEY (1028-1000-1-ND)
254 | 1 | U36 | UPD720201K8-701-BAC-A | Speed Host Controller USB 3.0 3.3V | QFN_68 | RENESAS | UPD720201K8-701-BAC-A | ARROW(UPD720201K8-701-BAC-A)
255 | 1 | U37 | MX25L512EMI-10G | IC FLASH 512K SPI 104MHZ 8SOP | SOP-8 | MACRONIX | MX25L512EMI-10G | DIGIKEY(1092-1110-ND)
256 | 2 | U40 U41 | AP2191SG-13 | usb distribuzione alimentazione 1.5A 2.7V-5.5V | SOIC8 | DIODES | AP2191SG-13 | MOUSER(621-AP2191SG-13)
257 | 1 | U46 | CM2020-01TR | IC XMTR HDMI ESD PROTECTION 5V TSSOP38 | tssop38 | ON SEMI | CM2020-01TR | DIGIKEY(CM2020-01TROSCT-ND)
258 | 1 | U54 | 9FGV0641 | PCIe Gen1–4 clock generation for Riser Cards | 40-VFQFPN | IDT | 9FGV0641 | IDT
259 | 1 | U68 | TPS51200DRCR | IC CONV DDR DDR2 DDR3 10SON | SON10 | TEXAS | TPS51200DRCR | DIGIKEY (296-26978-1-ND)
260 | 1 | U69 | MIC47100YMME | LDO 1A High Speed, Low Vin LDO | MSOP8 | microchip | MIC47100YMME | MOUSER(998-MIC47100YMME)
261 | 1 | U72 | MIC39102YM | LDO 1.0A 1.0% Fixed Voltage LDO | SOIC8 | microchip | MIC39102YM | MOUSER(998-MIC39102YM)
262 | 1 | U74 | LTC4100EG#PBF | IC SMART BATTERY CHARGER 24-SSOP | 24-SSOP | ANALOG | LTC4100EG#PBF LTC4100EG#PBF | DIGIKEY(LTC4100EG#PBF-ND)
263 | 1 | U75 | LT1129CS8-3.3#PBF | IC REG LINEAR 3.3V 700MA 8SOIC | SOIC8 | ANALOG | LT1129CS8-3.3#PBF | DIGIKEY(LT1129CS8-3.3#PBF-ND)
264 | 1 | U76 | NCP571SN09T1G | IC REG LINEAR 0.9V 150MA 5TSOP | SOT-223 | ON SEMI | NCP571SN09T1G | DIGIKEY (NCP571SN09T1GOSCT-ND)
265 | 1 | U77 | MIC811SUY-TR | MPU VOLTAGE MONITOR | SOT-143 | MICROCHIP | MIC811SUY-TR | DIGIKEY(576-1325-6-ND)
266 | 1 | U78 | LTC4368CDD-1#PBF | SURGE SUPPRESSIONE ADJ | 10DFN | LINEAR | LTC4368CDD-1#PBF | DIGIKEY(LTC4368CDD-1#PBF-ND)
267 | 2 | U80 U82 | RCLAMP3346P.TNT | High speed ESD protection LOW CAPACITANCE | 7-UDFN | SEMTECH | RCLAMP3346P.TNT | DIGIKEY(RCLAMP3346P.TNTCT-ND)
268 | 1 | U90 | TPS79633 | IC REG LDO 3.3V 1A SOT223-6 | SOT223-6 | TEXAS | TPS79633DCQR | DIGIKEY(296-13766-1-ND)
269 | 4 | U91 U92 U93 U94 | PCA9306DCT | IC VOLT-LEVEL TRANSLATOR | 8-SSOP | TEXAS | PCA9306DCT | DIGIKEY(296-18509-1-ND)
270 | 1 | U95 | LCMXO640C-3TN100C | CPLD 640 LUTS 74 I/O 100 TQFP | 100-LQFP | LATTICE | LCMXO640C-3TN100C LCMXO256C-3TN100C | MOUSER(842-MXO640C3TN100C)
271 | 1 | U96 | 50MHZ | Oscillator 50Mhz SMD 3.2x2.5mm 4 Pads 1.8V | SMD_3.2x2.5 | ABRACOM | ASE3-50.000MHZ-KT | DIGIKEY(535-9554-1-ND)
272 | 1 | U98 | 32.768kHZ | Oscillator 32.768kHZ 25ppm 1.8V SMD 3225 | SMD_3.2x2.5 | CTS | TC32M5I32K7680 | DIGIKEY(CTX1181CT-ND)
273 | 1 | U99 | FDC6331L | LOAD SWITCH INT 8VIN SSOT-6 | SOT_6 | FAIRCHILD | FDC6331L | DIGIKEY (FDC6331LCT-ND)
274 | 1 | U100 | m2m air | MIM m2m air Telit | VQFN-8 | Telit
275 | 1 | U101 | TCA6424ARGJR | I/O Expander 24 I²C, SMBus 32-UQFN | 32-UQFN | TEXAS | TCA6424ARGJR | DIGIKEY( 296-27844-1-ND)
276 | 1 | U102 | PCA9532 | LED DRIVER, PWM, 400KHZ, TSSOP-24 | 24-TSSOP | NXP | PCA9532PW,112 | FARNELL(2400469)
277 | 1 | U104 | SK5126 | Industrial usb keyborad controller | QFN-48 | Sprintek | SK5126-LT AP2191SG-13 | SPRINGTEK
278 | 1 | U106 | 25AA256 | IC SPI EEPROM 256KBIT 10MHZ 8SOIC | SOIC8 | MICROCHIP | 25AA256-I/SN | DIGIKEY (25AA256-I/SN-ND)
279 | 1 | U107 | CM9882A | CODEC AUDIO CM9882A | LQFP48 | CMEDIA | CM9882A | CMEDIA
280 | 1 | U108 | M24C32 | EEPROM EEPROM S I2C 32k | SOIC8 | ST | M24C32-WMN6TP | MOUSER(511-M24C32-WMN6TP)
281 | 1 | U109 | TPS5430MDDAREP | IC REG BUCK ADJ 3A 8SOPWRPAD HiRel | 8-SOIC | TEXAS | TPS5430MDDAREP | DIGIKEY (ey 296-24266-1-ND)
282 | 1 | U110 | CM8828 | High Performance PCI Express Audio Processor | LQFP-80 | CMEDIA | CM8828 | CMEDIA
283 | 1 | U111 | USB2514-AEZC | IC USB 2.0 4PORT HUB CTLR 64QFN | QFN36 | MICROCHIP | USB2514B-AEZC | DIGIKEY(886-USB2514B-AEZC)
284 | 1 | U112 | TPS62067 | IC REG BUCK SYNC ADJ 2A 8WSON | WSON8 | TEXAS | TPS62067DSGT | DIGIKEY (296-27205-1-ND)
285 | 1 | U113 | LTM4613IV#PBF | Ultralow EMI, 36V, 8A Step-down Module | LGA-133 | ANALOG | LTM4613IV#PBF | MOUSER(584-LTM4613IV#PBF)
286 | 1 | U114 | 859S0212BGILF | 2:2 Differential-to-LVPECL/LVDS Clock Multiplexer | TSSOP-16 | RENESAS | 859S0212BGILF | AVNET(859S0212BGILF)
287 | 1 | U116 | 66,6MHZ | MEMS OSC XO 66.6600MHZ H/LV-CMOS | SMD_3.2x2.5 | SiTIME | SIT1602BC-23-18S-66.660000D | DIGIKEY(1473-SIT1602BC-23-18S-66.660000D-ND)
288 | 1 | U117 | 133,33MHZ | MEMS OSC XO 133.3300MHZ LVCMOS | SMD_2.5x2.0 | SiTIME | SIT8009AC-12-18E-133.330000E | DIGIKEY(1473-SIT8009AC-12-18E-133.330000E-ND)
289 | 6 | U118 U119 U120 U121 U122 U123 | TPS56637RPAR | 4.5-V to 28-V input, 6-A synchronous buck | VQFN10 | TEXAS | TPS56637RPAR | MOUSER(595-TPS56637RPAR)
290 | 1 | U124 | 24MHZ | OSCILLATOR 24.000MHZ 1.8-3.3V 50ppm SMD | SMD_5.0x3.2 | ABRACOM | ASFLMB-24.000MHZ-LC-T | DIGIKEY(535-11768-1-ND)
291 | 2 | U125 U126 | TPS544B20RVFT | IC REG BUCK ADJ 20A 40LQFN | LQFN40 | TEXAS | TPS544B20RVFT | DIGIKEY(296-37876-1-ND)
292 | 1 | U1 | T2080NXN8PTB | QRIQ MPU 1.87GT/s DDR3/3L 4x10GE | BGA896 | NXP | T2080NXN8PTB | MOUSER(841-T2080NXN8PTB)
293 | 2 | XJP1 XJP2 | SHUNT | SHUNT | NONE
294 | 1 | Y1 | 32,768KHz | CRYSTAL 32.768KHZ 12.5PF SMD | SMD_3215 | TXC | 9HT10-32.768KBZF-T | DIGIKEY(887-1573-1-ND)
295 | 3 | Y2 Y3 Y7 | 25MHz | CRYSTAL 25.000 MHZ 20PF SMD | SMD_5.0x3.2 | ECS | ECS-250-20-30B-TR (ROHS COMPLIANT) | DIGIKEY (XC1124CT-ND)
296 | 2 | Y4 Y9 | 24MHz | CRYSTAL 24MHZ 10PF SMD | SMD_2.5x3.2 | CTS | 403C11A24M00000 | DIGIKEY(CTX849CT-ND)
297 | 1 | Y10 | 24,576MHz | QUARZO 24,576MHz HC49/USM4 CL16 FUNZ.SMD | SMD_HC49/US | MEGATEC (Cod.Forn:QSXTM24576UG55LSF) | HC49/USM4-024M5760000UR (ROHS COMPLIANT) | MODULI ELETTRONICI E COMPONENTI spa

Sheet: NOT_MOUNTED_COMPONENTS
ITEM | QTY | DESIGN REFERENCE | VALUE | DESCRIPTION | PACKAGE | MANUFACTURER P/N | MANUFACTURER | DISTRIBUTER | DISTRIBUTER P/N | STATUS
83 | 0 | L17 | X | X | X | X | X | X
97 | 0 | R1 R511 R512 R578 R579 R713 R714 R717 R718 R719 R720 R749 R751 R753 R755 R757 R759 R761 R763 R765 R767 | X | X | X | X | X | X
105 | 0 | R11 | X | X | X | X | X | X
124 | 0 | R90 R91 R92 R140 R143 R146 R149 R153 R154 R157 R158 R160 R161 R164 R165 R169 R170 R175 R179 R182 R649 R661 | X | X | X | X | X | X
143 | 0 | R270 R327 R384 | X | X | X | X | X | X
151 | 0 | R457 | X | X | X | X | X | X
158 | 0 | R510 | X | X | X | X | X | X
