unofficialImportFromGitlab-PPC/powerpc-laptop-mobo/KiCAD/openPPCnotebook/Mas100n1 ACUBE_PORTABILE R_0.csv

Id | Designator | Package | Quantity | Designation | Supplier and ref
1 | C114,R370,R755,C136,C368,R215,R514,C933,R196,R751,R362,C113,R166,C57,C552,R594,C556,R320,C577,C123,R605,R607,R351,C578,C557,R100,R606,R199,R879,R157,C134,R527,R185,C898,R665,C304,R345,R284,R217,C528,R86,R505,C934,R146,R852,R507,R288,R240,R837,R500,R482,R23,C149,R178,C319,R50,R273,R287,C65,R51,C513,R483,C553,R104,R235,C509,C579,R538,R192,R636,C120,C894,R129,R492,C561,R224,R77,R55,C907,R195,R752,R454,R742,R663,C521,R267,R481,R856,R134,C845,R608,R189,R4,R476,R496,R239,R493,R516,C58,R299,R440,R357,R317,R498,R643,R443,R313,R753,C634,R232,R559,C653,R158,C773,C267,R671,R53,R365,R165,R117,C575,C531,R333,R446,R526,C247,R9,C936,C129,C310,R200,C963,R181,C574,R804,R294,R188,R98,R198,C118,R462,R455,R477,R639,C512,R220,R364,R229,R89,C164,R625,R444,R658,R153,C511,C570,R101,R11,R202,R353,R140,R241,R329,C576,R445,C115,R480,R736,R520,C975,R367,R13,R656,R236,C418,R22,R81,C130,R218,R19,C801,R309,C547,R510,R756,R230,R626,C137,C895,C143,R327,C789,R137,R522,R491,R347,R350,R154,R338,R517,C771,L39,R490,R344,R754,R132,R803,C655,R359,C766,C535,R228,R275,R441,C642,R838,C151,C638,C117,R839,R156,R800,C805,C622,C781,R172,R237,R508,C140,C287,R204,R811,C311,R372,R471,R133,R495,C121,R511,R85,R366,R227,R670,C546,R539,C851,R280,R238,C282,R504,R336,C595,R173,R604,R634,R862,C116,C150,R265,C765,R461,C61,R601,R809,R855,R234,R488,C852,R78,C148,R484,R141,R197,R332,R207,R447,R354,R136,R290,C681,R602,R130,R222,R737,R186,C514,R190,R603,R525,R80,R494,C127,R666,R458,C128,R315,R535,R6,R798,R835,C733,R302,R799,R125,R497,R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 | RC0402 | 1420 | RC0402
2 | C194,C208,C941,C258,C192,C930,C312,C313,C744,C198,C684,C224,C199,C315,C682,C234,C897,C314,C761,C202,C203,C905,C683,C27,L14,C699,C564,C711,C201,C950,C989,C918,C913,C917,C831,C701,C942,C25,C949,C197,C692,C693,C702,C885,C832,C713,C741,C896,C518,C196,C200,C195,C26,C488,C193,C953,C714,C2,C691,C3,C696,C694,C880,L15,C698,C881,L13,C4,C984,C952,C497,C566,C517,C563,C946,C700,C496,C947,C986,C567,C504,C712,C886,C519,C697,L11,C904,C695,C987,L12,C931,C912 | RC0805 | 92 | RC0805
3 | C782,C215,L54,C829,C679,C248,C628,C615,C231,L53,C211,C926,C927,C321,C273,L30,C758,C309,C762,C666,C179,C635,C660,C674,R860,C589,C977,L2,C216,C935,C892,L45,C685,C834,C670,C588,C212,L44,C976,R653,C893,C654,C362,L46,L28,C520,L55,C303,L29,R858,C641,C142,C759,C555,L52,C177,C757,C233,C962,C280,L8,L1,L48,L10,C792,L27,C793,C648,L32,L9,C784,C285,C210,L4,C990,C221,C966,C877,L7,C166,R219,C260,C938,C214,C985,C272,R866,C916,C249,C922,R214,R426,C227,L50,C188,C830,R869,C218,L23,C388,C967,C411,C839,C217,R865,R864,C320,C878,L49,C960,C236,C973,C965,C835,C750,C884,C970,C974,R213,C228,C737,C925,L51,C979,C748,L57,C909,L47,R655,C814,C964,C394,C399,R221,C822,L3,C408,C404,C915,C226,C889,C522,C902,C232,C988,C753,L6,L56,C186,C901,C181,C131,R868,C825,L5 | RC0603 | 155 | RC0603
4 | TP119,TP13,TP19,TP27,TP73,TP110,TP14,TP99,TP65,TP112,TP17,TP29,TP16,TP121,TP69,TP111,TP133,TP74,TP33,TP31,TP67,TP72,TP71,TP34,TP94,TP100,TP64,TP113,TP68,TP20,TP24,TP124,TP114,TP98,TP25,TP28,TP116,TP30,TP97,TP12,TP21,TP115,TP32,TP117,TP95,TP131,TP120,TP101,TP123,TP130,TP122,TP118,TP127,TP129,TP26,TP128,TP18,TP103,TP126,TP66,TP15,TP70,TP75,TP125,TP96,TP88,TP6,TP77,TP41,TP10,TP57,TP108,TP90,TP23,TP102,TP59,TP49,TP82,TP62,TP47,TP87,TP7,TP109,TP40,TP81,TP60,TP9,TP92,TP36,TP55,TP44,TP107,TP105,TP104,TP45,TP63,TP93,TP106,TP85,TP50,TP91,TP78,TP35,TP3,TP84,TP43,TP86,TP8,TP1,TP132,TP54,TP4,TP51,TP48,TP89,TP46,TP56,TP22,TP53,TP76,TP58,TP37,TP42,TP11,TP80,TP83,TP2,TP61,TP52,TP5,TP79,TP39,TP38 | CMP-TestPoint30 | 133 | AE-TESTPOINT
5 | R375,R377,R379,R735,R878,C847,R849,R779,R588,R797,R847,R848,R609,R540,R801,R783,R816,C849,R565,R575,R566,R589,R568,R438,R581,R563,R573,R610,R515,R579,R561,C848,R815,R567,R574,R562 | RC1206 | 36 | RC1206
6 | D8,M6,Q17,M4,Q22,Q21,Q19,Q15,M7,Q3,M14,D14,Q4,Q18,M9,M3,Q1,M8,Q16,D21,Q23,M5,Q2,Q9,D11,M11,D5,Q20,D6,M10,M13,Q14,M12 | SOT-23 | 33 | SOT-23
7 | U2 | TSSOP-48 | 1 | TSSOP-48
8 | CN1,CN2 | MOLEX-USB-483950003 | 2 | MOLEX-USB-483950003
9 | Q13 | TSOT-6 | 1 | TSOT-6
10 | C95,C100,C110,C98,C94,C109,C93,C88,C92,C86,C99,C90,C97,C87,C84,C104,C89,C112,C96,C111,C85,C592,C264,C220,C668,C658,C251,C242,C327,C302,C265,C361,C279,C102,C623,C676,C278,C360,C277,C354,C672,C243,C383,C330,C650,C349,C377,C307,C581,C295,C292,C299,C290,C238,C626,C585,C250,C294,C322,C374,C372,C261,C348,C637,C244,C329,C375,C107,C276,C270,C324,C334,C274,C297,C105,C223,C323,C219,C643,C283,C376,C369,C275,C262,C306,C664,C213,C269,C359,C652,C293,C353,C106,C584,C630,C101,C583,C331,C662,C325,C384,C351,C371,C103,C288,C289,C255,C301,C363,C381,C328,C687,C254,C646,C266,C580,C241,C253,C357,C352,C656,C350,C582,C690,C639,C379,C333,C373,C326,C587,C308,C336,C298,C256,C370,C380,C364,C239,C252,C296,C620,C291,C240,C257,C108,C222,C356,C378,C358,C335,C332,C237,C300,C355,C284,C617,C633,C586,C263 | RC0201 | 159 | RC0201
11 | U19,U17,U18,U20 | SSOP-8 | 4 | SSOP-8
12 | U49,U46 | RCLAMP3346P | 2 | RCLAMP3346P
13 | U26,U16,U28,U11,U10,U8 | TSSOP-14 | 6 | TSSOP-14
14 | D10,D1,D7,D20,D3,D17,D22,D9,D4,D18,D19,D13,D16 | LED0603-AK | 13 | LED0603-AK
15 | U74 | MSOP-8-EP | 1 | MSOP-8-EP
16 | U77 | SSOP-24 | 1 | SSOP-24
17 | FL14,FL13 | EMI-MCZ2010CH | 2 | EMI-MCZ2010CH
18 | FL3,FL4,FL7,FL5,FL6,FL8,FL12,FL10,FL11,FL9 | EMI-DLW21 | 10 | EMI-DLW21
19 | BTH1 | BATT-BH3098 | 1 | BATT-BH3098
20 | J29,J33,J32 | PIN-100mls-2 | 3 | PIN-100MLS-2
21 | SW1,SW2 | DSW-GDH8 | 2 | DSW-GDH8
22 | ,,,,,,,,,,, | Vite2.4-met | 12 | Comment
23 | ,,,,,,,,,,,, |  | 13
24 | J3F2 | TE-2-2013310-1 | 1 | TE-2-2013310-1
25 | D2,D23,D25,D24 | SOD123-AK | 4 | SOD123-AK
26 | J6 | MOLEX-52746-4 | 1 | MOLEX-52746-4
27 | J12 | MOLEX-52271-12 | 1 | MOLEX-52271-12
28 | Q7,Q8,Q6,Q5 | SSOT6-P-0_95 | 4 | SSOT-6
29 | J13,J15,J16 | FCI-MDT180M01001 | 3 | FCI-MDT180M01001
30 | U50 | LGA-196-15X15-FAN | 1 | LGA-196-15X15
31 | U25,U41,U39,U40 | SOT-23-6 | 4 | SOT-23-6
32 | Q12,U30,U59,Q11,U48,U47,U78,U51,U75 | SO-8 | 9 | SO-8
33 | U21,U27 | TSSOP-16 | 2 | TSSOP-16
34 | J11 | PIN-100mls-14 | 1 | PIN-100MLS-14
35 | L67 | IND-COILTRONICS-DR73 | 1 | IND-COILTRONICS-DR73
36 | C843,C756,C844,C841,C846 | TANT-D | 5 | TANT-D
37 | U44 | QFN-68-EP_8x8 | 1 | QFN-68-EP_8X8
38 | U1 | PBGA896-0_8MM-25X25-FAN | 1 | PBGA896-0_8MM-25X25
39 | U60 | SO-8-EXPOSED-PAD | 1 | SO-8-EXPOSED-PAD
40 | C797,C833,C956,C799,C796,C798,C957,C602,C601,C600,C951,C599 | RC1210 | 12 | RC1210
41 | J31,J30 | JST-B3B-XH-A1-3 | 2 | JST-B3B-XH-A1-3
42 | U61 | LQFP-80-0_4 | 1 | LQFP-80-0_4
43 | J7,J8 | JST-SM12B-SRSS-TB | 2 | JST-SM12B-SRSS-TB
44 | R853,R846,R859,R884,R843 | RC2512 | 5 | RC2512
45 | U56 | WSON-8-2_1x2_1 | 1 | WSON-8-2_1X2_1
46 | U23 | QFN-36-6x6-EP | 1 | QFN-36-6X6-EP
47 | FL2,FL1 | EMI-NFM18-0603 | 2 | EMI-NFM18-0603
48 | U15,U14,U6,U7,U5 | SC-70-5 | 5 | SC-70-5
49 | C944 | CE-6_3x6_3 | 1 | CE-6_3X6_3
50 | J3 | SAMTEC-TMMH-108-01-L-DV-16 | 1 | SAMTEC-TMMH-108-01-L-DV-16
51 |  | qewqw4e | 1 | Comment
52 | J18 | PCI-MM70-314-310B1-2-R300 | 1 | PCI-MM70-314-310B1-2-R300
53 | J1 | PIN-2mm-3 | 1 | PIN-2MM-3
54 | L26 | IND-BOURNS-SRU1028 | 1 | IND-BOURNS-SRU1028
55 | U80 | SOT-143 | 1 | SOT-143
56 | J9 | PIN-100mls-6DL | 1 | PIN-100MLS-6DL
57 | L31 | IND-TDK-VLS-2016 | 1 | IND-TDK-VLS-2016
58 | U57 | TSSOP-38 | 1 | TSSOP-38
59 | U31 | MSOP-10 | 1 | MSOP-10
60 | U79 | TSOP-5 | 1 | TSOP-5
61 | J25,J26 | POM-5046P-C3310-R | 2 | POM-5046P-C3310-R
62 | U3 | TSOP-56 | 1 | TSOP-56
63 | J20 | HIROSE-DF13A-40DP-1_25V | 1 | HIROSE-DF13A-40DP-1_25
64 | J3F1 | TE-2013022-1 | 1 | TE-2013022-1
65 | U35 | QFN-32-EP | 1 | QFN-32-EP
66 | J19 | TE-HDMI-571-2041481-1 | 1 | TE-HDMI-571-2041481-1
67 | J24,J23,J22 | MOLEX-53398-2 | 3 | MOLEX-53398-2
68 | Y1,U62,Y5,U33,U53 | XC-CTS-632 | 5 | XC-CTS-632
69 | U29 | USOP-8 | 1 | USOP-8
70 | J4 | FCI-SFW30R | 1 | FCI-SFW30R
71 | U65 | LQFN-40-EP-7_1X5_1 | 1 | LQFN-40-EP-7_1X5_1
72 | U34 | TSSOP-24 | 1 | TSSOP-24
73 | C740 | RC1808 | 1 | RC1808
74 | L62,L63,L60,L65,L61,L64 | IND-VISHAY-IHLP2525 | 6 | IND-VISHAY-IHLP2525
75 | R743 | RC2010 | 1 | RC2010
76 | L66 | IND-WE-7443251000 | 1 | IND-WE-7443251000
77 | J10 | PIN-100mls-8 | 1 | PIN-100MLS-8
78 | U63 | XC-OSC-NZ2520S | 1 | XC-OSC-NZ2520S
79 | J5 | MOLEX-50511-12 | 1 | MOLEX-50511-12
80 | JP9,J28 | PIN-100mls-3 | 2 | PIN-100MLS-3
81 | U32 | LQfp-100 | 1 | LQFP-100
82 | J34 | WE-JACK-694105309102 | 1 | WE-JACK-694105309102
83 | U52 | SOT-223-6 | 1 | SOT-223-6
84 | U76 | LGA-133-15X15 | 1 | LGA-133-15X15
85 | U73 | VSON-10-3_1x3_1 | 1 | VSON-10-3_1X3_1
86 | J27 | MOLEX-53780-12 | 1 | MOLEX-53780-12
87 | C982 | CE-8x8_3 | 1 | CE-8X8_3
88 | Y6 | XC-HC49S | 1 | XC-HC49S
89 | D12 | SMB-AK | 1 | SMB-AK
90 | U24,U38 | QFN-48-EP | 2 | QFN-48-EP
91 | J21 | CUI-SJ-43504-SMT-TR | 1 | CUI-SJ-43504-SMT-TR
92 | U69,U72,U71,U70,U68,U67 | VQFN-10-3_1x3_1 | 6 | VQFN-10-3_1X3_1
93 | U22 | XC-ABM3B | 1 | XC-ABM3B
94 | U43 | QFN-16-3X3-EP | 1 | QFN-16-3X3-EP
95 | U58 | LQFP-48 | 1 | LQFP-48
96 | Y2 | XC-ABS07 | 1 | XC-ABS07
97 | L58 | IND-BOURNS-SLC1175 | 1 | IND-BOURNS-SLC1175
98 | J2 | HIROSE-DM3-AT | 1 | HIROSE-DM3-AT
99 | U4 | TSop-48 | 1 | TSOP-48
100 | JP6,JP5,JP4,JP7,JP3,JP1,JP8 | NODO_50-buried | 7 | NODO
101 | U37 | WSON-6-2_1X2_1 | 1 | WSON-6-2_1X2_1
102 | U64 | QFN-40-5X5-P0_4-EP | 1 | QFN-40-5X5-P0_4-EP
103 | U36 | ULLGA-6-1_45X1 | 1 | ULLGA-6-1_45X1
104 | Y7,Y4,Y3 | XC-CSX2 | 3 | XC-CSX2
105 | D26 | SMC-AK | 1 | SMC-AK
106 | JPS1 | JPS2-MINI | 1 | JMPS2
107 | U13,U12 | SLP2710 | 2 | SLP2710
108 | U55 | VQFN-8-5X6 | 1 | VQFN-8-5X6
109 | Q25,Q24 | QFN-8-POWERPAK | 2 | QFN-8-POWERPAK
110 | L33 | IND-WE-744311068 | 1 | IND-WE-744311068
111 | U9 | SO-16 | 1 | SO-16
112 | TVS1 | SOT-886 | 1 | SOT-886
113 | D15 | SOD123-F-AK-NXP | 1 | SOD123-F-AK-NXP
114 | U45 | SOP-8 | 1 | SOP-8
115 | U54 | SSOT6-P-0_95 | 1 | SSOT6-P-0_95
116 | J14 | MOLEX-54132-060-30 | 1 | MOLEX-54132-060-30
117 | J17 | AVX-SIM-045036006211862 | 1 | AVX-SIM-045036006211862
118 | U81 | DFN-10-3_0x3_0 | 1 | DFN-10-3_0X3_0
119 | FUSE1 | FUSE-SMF-430 | 1 | FUSE-SMF-430
120 | U42 | QFN-76-EP_9x9 | 1 | QFN-76-EP_9X9
121 | L68 | IND-TDK-ACM1513 | 1 | IND-TDK-ACM1513
