unofficialImportFromGitlab-PPC/powerpc-laptop-mobo/Xpedition/Mas100n1 ACB_0001_0/Output/AutoCad/DIMA_max.dxf

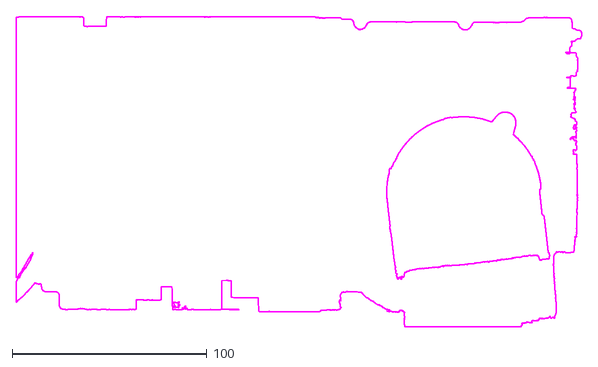
[picture p14: CAD file, 2022-08-12]
Xpedition/Mas100n1 ACB_0001_0/Output/AutoCad/DIMA_max.dxf
290.7 x 159.4
