unofficialImportFromGitlab-PPC/powerpc-laptop-mobo/Xpedition/Mas100n1 ACB_0001_0/Output/AutoCad/CCI02102020_0001-Copia.dxf

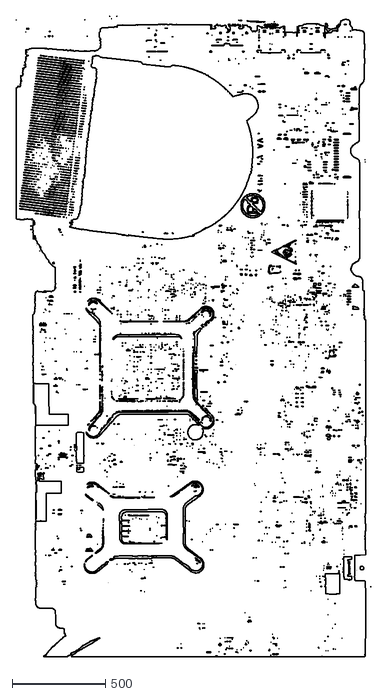
[picture p15: CAD file, 2022-08-12]
Xpedition/Mas100n1 ACB_0001_0/Output/AutoCad/CCI02102020_0001-Copia.dxf
1897.0 x 3427.0
