unofficialImportFromGitlab-PPC/powerpc-laptop-mobo/(list of files, cad)

Other CAD files:
Xpedition/Mas100n1 ACB_0001_0/Logic/DataSheet/Print2CAD-Amphenol_CMDT180XXX001-1-1157111.dwg
Xpedition/Mas100n1 ACB_0001_0/Logic/DataSheet/Amphenol_CMDT180XXX001-1-1157111.dxf
Xpedition/Mas100n1 ACB_0001_0/Output/AutoCad/Mas100n1 ACUBE_PORTABILE R_0.dxf
Xpedition/Mas100n1 ACB_0001_0/Output/AutoCad/dima.dxf
OrCAD/symbols/avx-sim-045036006211862.psm
OrCAD/symbols/batt-bh3098.psm
OrCAD/symbols/ce-6_3x6_3.psm
OrCAD/symbols/ce-8x8_3.psm
OrCAD/symbols/cmp-testpoint30.psm
OrCAD/symbols/cui-sj-43504-smt-tr.psm
OrCAD/symbols/dfn-10-3_0x3_0.psm
OrCAD/symbols/dsw-gdh8.psm
OrCAD/symbols/emi-dlw21.psm
OrCAD/symbols/emi-mcz2010ch.psm
OrCAD/symbols/emi-nfm18-0603.psm
OrCAD/symbols/fci-mdt180m01001.psm
OrCAD/symbols/fci-sfw30r.psm
OrCAD/symbols/fuse-smf-430.psm
OrCAD/symbols/hirose-df13a-40dp-1_25v.psm
OrCAD/symbols/hirose-dm3-at.psm
OrCAD/symbols/ind-bourns-slc1175.psm
OrCAD/symbols/ind-bourns-sru1028.psm
OrCAD/symbols/ind-coiltronics-dr73.psm
OrCAD/symbols/ind-tdk-acm1513.psm
OrCAD/symbols/ind-tdk-vls-2016.psm
OrCAD/symbols/ind-vishay-ihlp2525.psm
OrCAD/symbols/ind-we-744311068.psm
OrCAD/symbols/ind-we-7443251000.psm
OrCAD/symbols/jps2-mini.psm
OrCAD/symbols/jst-b3b-xh-a1-3.psm
OrCAD/symbols/jst-sm12b-srss-tb.psm
OrCAD/symbols/led0603-ak.psm
OrCAD/symbols/lga-133-15x15.psm
OrCAD/symbols/lga-196-15x15-fan.psm
OrCAD/symbols/lqfn-40-ep-7_1x5_1.psm
OrCAD/symbols/lqfp-100.psm
OrCAD/symbols/lqfp-48.psm
OrCAD/symbols/lqfp-80-0_4.psm
OrCAD/symbols/molex-50511-12.psm
OrCAD/symbols/molex-52271-12.psm
OrCAD/symbols/molex-52746-4.psm
OrCAD/symbols/molex-53398-2.psm
OrCAD/symbols/molex-53780-12.psm
OrCAD/symbols/molex-54132-060-30.psm
OrCAD/symbols/molex-usb-483950003.psm
OrCAD/symbols/msop-10.psm
OrCAD/symbols/msop-8-ep.psm
OrCAD/symbols/nodo_50-buried.psm
OrCAD/symbols/pbga896-0_8mm-25x25-fan.psm
OrCAD/symbols/pci-mm70-314-310b1-2-r300.psm
OrCAD/symbols/pin-100mls-14.psm
OrCAD/symbols/pin-100mls-2.psm
OrCAD/symbols/pin-100mls-3.psm
OrCAD/symbols/pin-100mls-6dl.psm
OrCAD/symbols/pin-100mls-8.psm
OrCAD/symbols/pin-2mm-3.psm
OrCAD/symbols/pom-5046p-c3310-r.psm
OrCAD/symbols/qfn-16-3x3-ep.psm
OrCAD/symbols/qfn-32-ep.psm
OrCAD/symbols/qfn-36-6x6-ep.psm
OrCAD/symbols/qfn-40-5x5-p0_4-ep.psm
OrCAD/symbols/qfn-48-ep.psm
OrCAD/symbols/qfn-68-ep_8x8.psm
OrCAD/symbols/qfn-76-ep_9x9.psm
OrCAD/symbols/qfn-8-powerpak.psm
OrCAD/symbols/rc0201.psm
OrCAD/symbols/rc0402.psm
OrCAD/symbols/rc0603.psm
OrCAD/symbols/rc0805.psm
OrCAD/symbols/rc1206.psm
OrCAD/symbols/rc1210.psm
OrCAD/symbols/rc1808.psm
OrCAD/symbols/rc2010.psm
OrCAD/symbols/rc2512.psm
OrCAD/symbols/rclamp3346p.psm
OrCAD/symbols/samtec-tmmh-108-01-l-dv-16.psm
OrCAD/symbols/sc-70-5.psm
OrCAD/symbols/slp2710.psm
OrCAD/symbols/smb-ak.psm
OrCAD/symbols/smc-ak.psm
OrCAD/symbols/so-16.psm
OrCAD/symbols/so-8-exposed-pad.psm
OrCAD/symbols/so-8.psm
OrCAD/symbols/sod123-ak.psm
OrCAD/symbols/sod123-f-ak-nxp.psm
OrCAD/symbols/sop-8.psm
OrCAD/symbols/sot-143.psm
OrCAD/symbols/sot-223-6.psm
OrCAD/symbols/sot-23-6.psm
OrCAD/symbols/sot-23.psm
OrCAD/symbols/sot-886.psm
OrCAD/symbols/ssop-24.psm
OrCAD/symbols/ssop-8.psm
OrCAD/symbols/ssot6-p-0_95.psm
OrCAD/symbols/tant-d.psm
OrCAD/symbols/te-2-2013310-1.psm
OrCAD/symbols/te-2013022-1.psm
OrCAD/symbols/te-hdmi-571-2041481-1.psm
OrCAD/symbols/tsop-48.psm
OrCAD/symbols/tsop-5.psm
OrCAD/symbols/tsop-56.psm
OrCAD/symbols/tsot-6.psm
OrCAD/symbols/tssop-14.psm
OrCAD/symbols/tssop-16.psm
OrCAD/symbols/tssop-24.psm
OrCAD/symbols/tssop-38.psm
OrCAD/symbols/tssop-48.psm
OrCAD/symbols/ullga-6-1_45x1.psm
OrCAD/symbols/usop-8.psm
OrCAD/symbols/vqfn-10-3_1x3_1.psm
OrCAD/symbols/vqfn-8-5x6.psm
OrCAD/symbols/vson-10-3_1x3_1.psm
OrCAD/symbols/we-jack-694105309102.psm
OrCAD/symbols/wson-6-2_1x2_1.psm
OrCAD/symbols/wson-8-2_1x2_1.psm
OrCAD/symbols/xc-abm3b.psm
OrCAD/symbols/xc-abs07.psm
OrCAD/symbols/xc-csx2.psm
OrCAD/symbols/xc-cts-632.psm
OrCAD/symbols/xc-hc49s.psm
OrCAD/symbols/xc-osc-nz2520s.psm
