unofficialImportFromGitlab-PPC/powerpc-laptop-mobo/PDF_design/PPC_notebook_electrical_schematics_v0.6.pdf

# Version Control

# Version

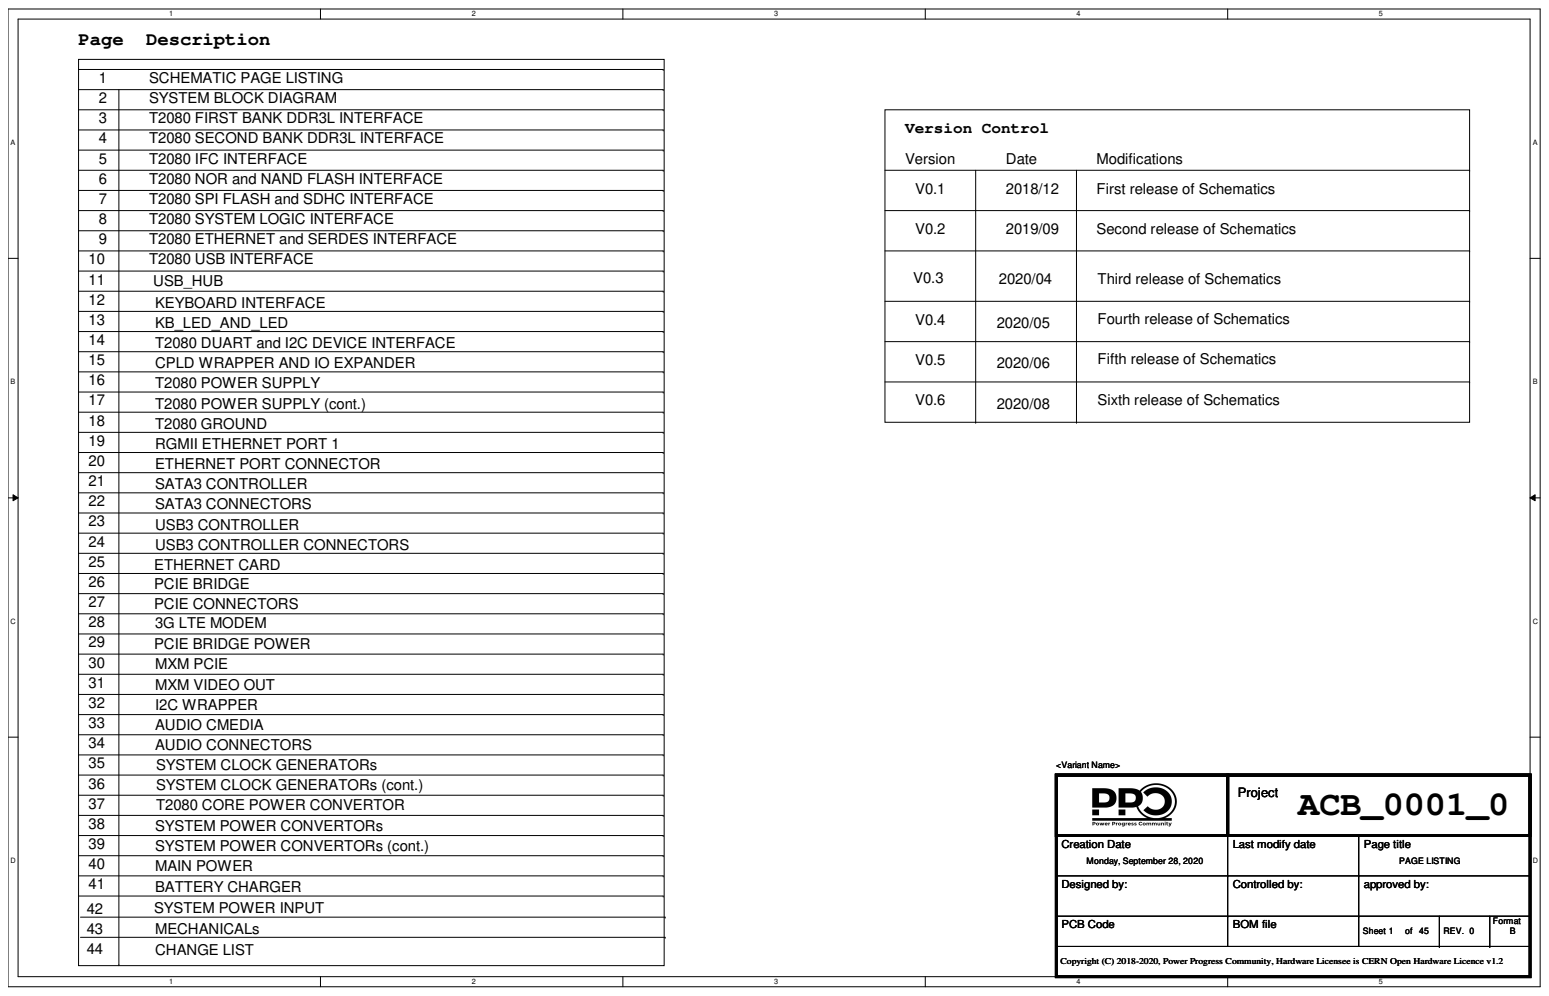
[picture p16: page 1]
Date; Modifications; Page; Description; SCHEMATIC PAGE LISTING; ACB_0001_0; Second release of Schematics; USB_HUB; Third release of Schematics; Fourth release of Schematics; Sixth release of Schematics; Project; Creation Date; Last modify date; Designed by:; Controlled by:; approved by:; PCB Code; BOM file; Sheet; REV.; Format; Page title; PAGE LISTING; Monday, September 28, 2020; <Variant Name>

SYSTEM BLOCK DIAGRAM
T2080 FIRST BANK DDR3L INTERFACE
T2080 SECOND BANK DDR3L INTERFACE
T2080 IFC INTERFACE
T2080 NOR and NAND FLASH INTERFACE
T2080 SPI FLASH and SDHC INTERFACE
T2080 SYSTEM LOGIC INTERFACE
T2080 ETHERNET and SERDES INTERFACE
T2080 USB INTERFACE
KEYBOARD INTERFACE
KB_LED_AND_LED
T2080 DUART and I2C DEVICE INTERFACE
CPLD WRAPPER AND IO EXPANDER
T2080 POWER SUPPLY
T2080 POWER SUPPLY (cont.)
T2080 GROUND
RGMII ETHERNET PORT 1
ETHERNET PORT CONNECTOR
SATA3 CONTROLLER
SATA3 CONNECTORS
USB3 CONTROLLER
USB3 CONTROLLER CONNECTORS
ETHERNET CARD
PCIE BRIDGE
PCIE CONNECTORS
3G LTE MODEM
PCIE BRIDGE POWER
MXM PCIE
MXM VIDEO OUT
I2C WRAPPER
AUDIO CMEDIA
AUDIO CONNECTORS
SYSTEM CLOCK GENERATORs
SYSTEM CLOCK GENERATORs (cont.)
T2080 CORE POWER CONVERTOR
SYSTEM POWER CONVERTORs
SYSTEM POWER CONVERTORs (cont.)

First release of Schematics

Fifth release of Schematics

MAIN POWER
BATTERY CHARGER
SYSTEM POWER INPUT
MECHANICALs
CHANGE LIST

Copyright (C) 2018-2020, Power Progress Community, Hardware Licensee is CERN Open Hardware Licence v1.2

# SYSTEM BLOCK DIAGRAM

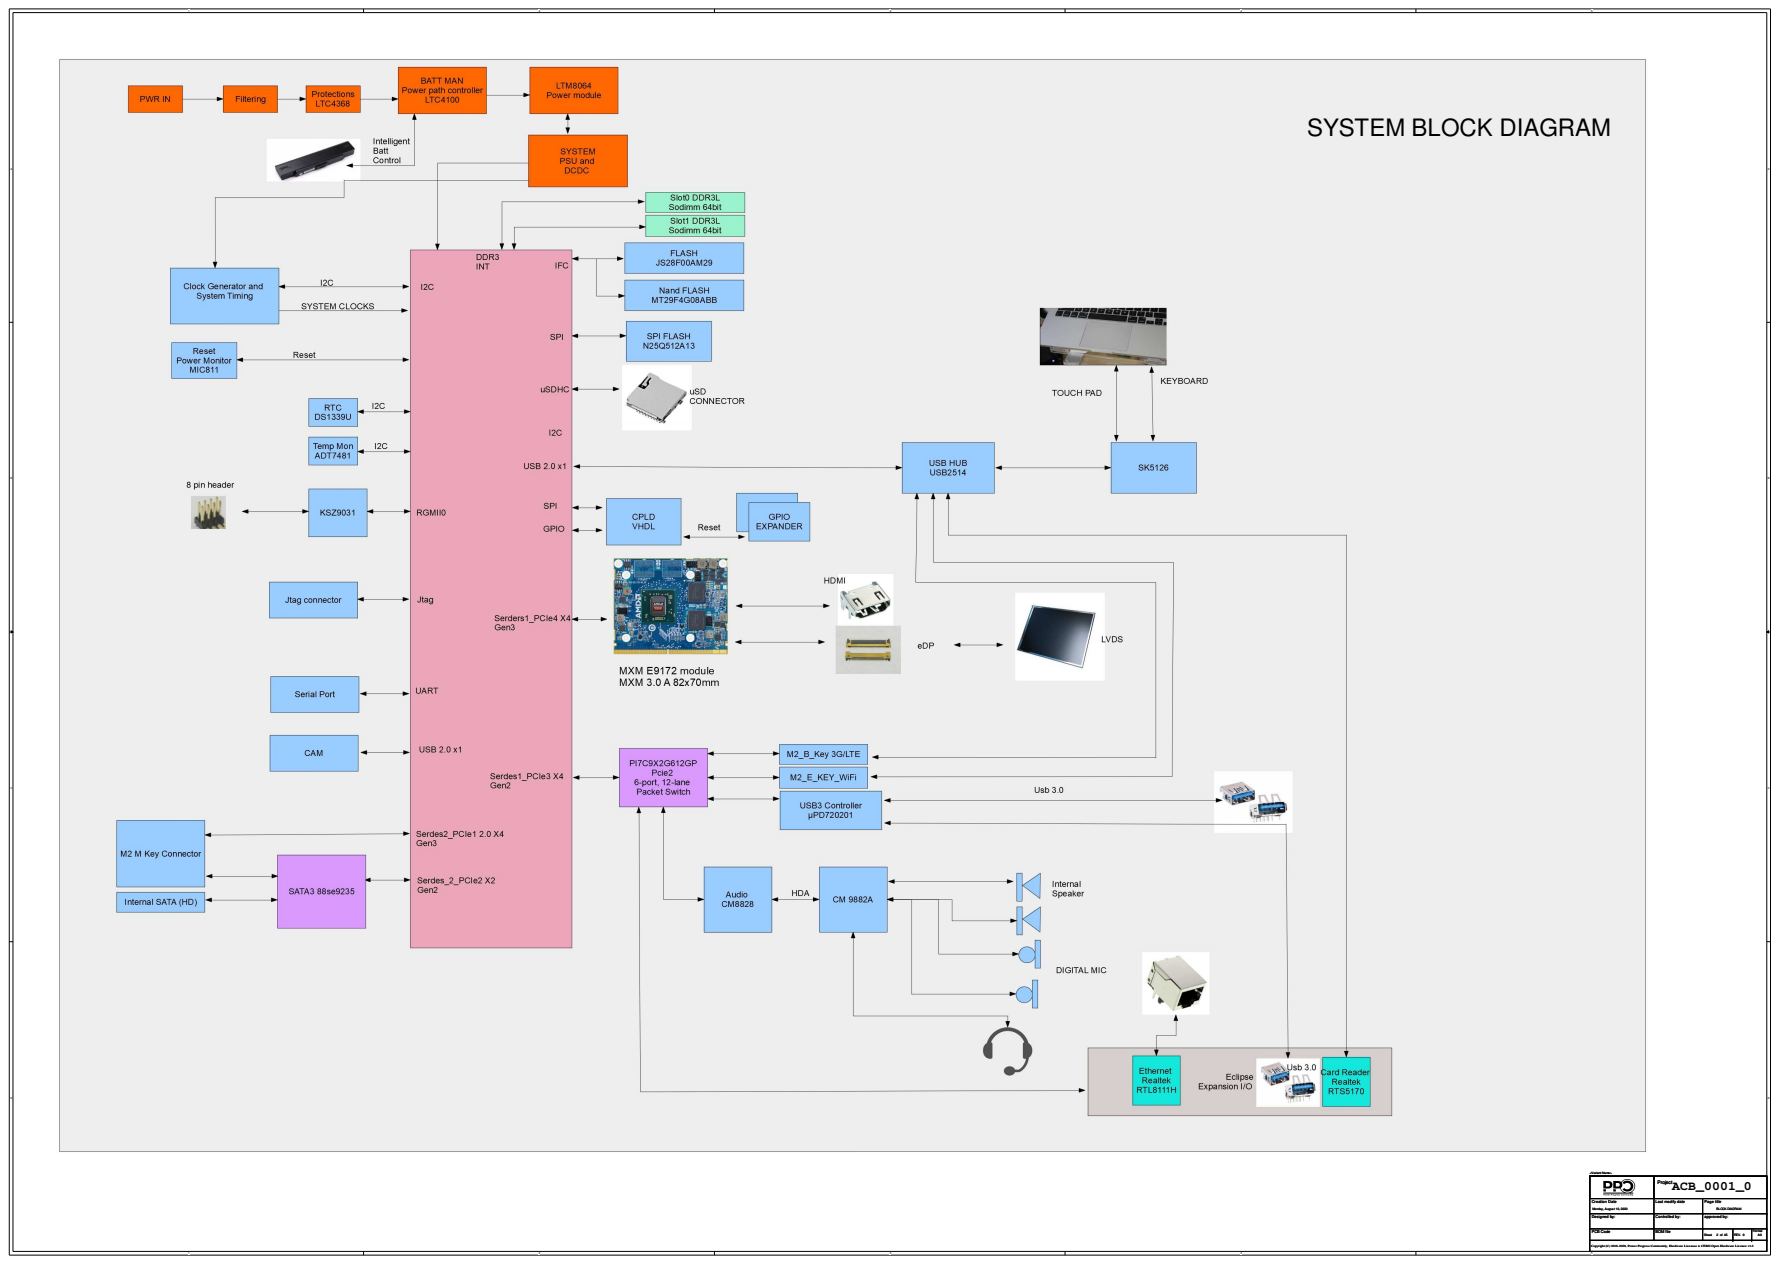
[picture p17: page 2]
ACB_0001_0 Project; Creation Date; Last modify date; Designed by:; Controlled by:; approved by:; PCB Code; BOM file; Sheet; REV.; Format; Page title; BLOCK DIAGRAM; Monday, August 10, 2020; <Variant Name>; Project

Copyright (C) 2018-2020, Power Progress Community, Hardware Licensee is CERN Open Hardware Licence v1.2

# T2080 DDR3L MEMORY INTERFACE

## 1.35V DDR3L SDRAM SODIMM

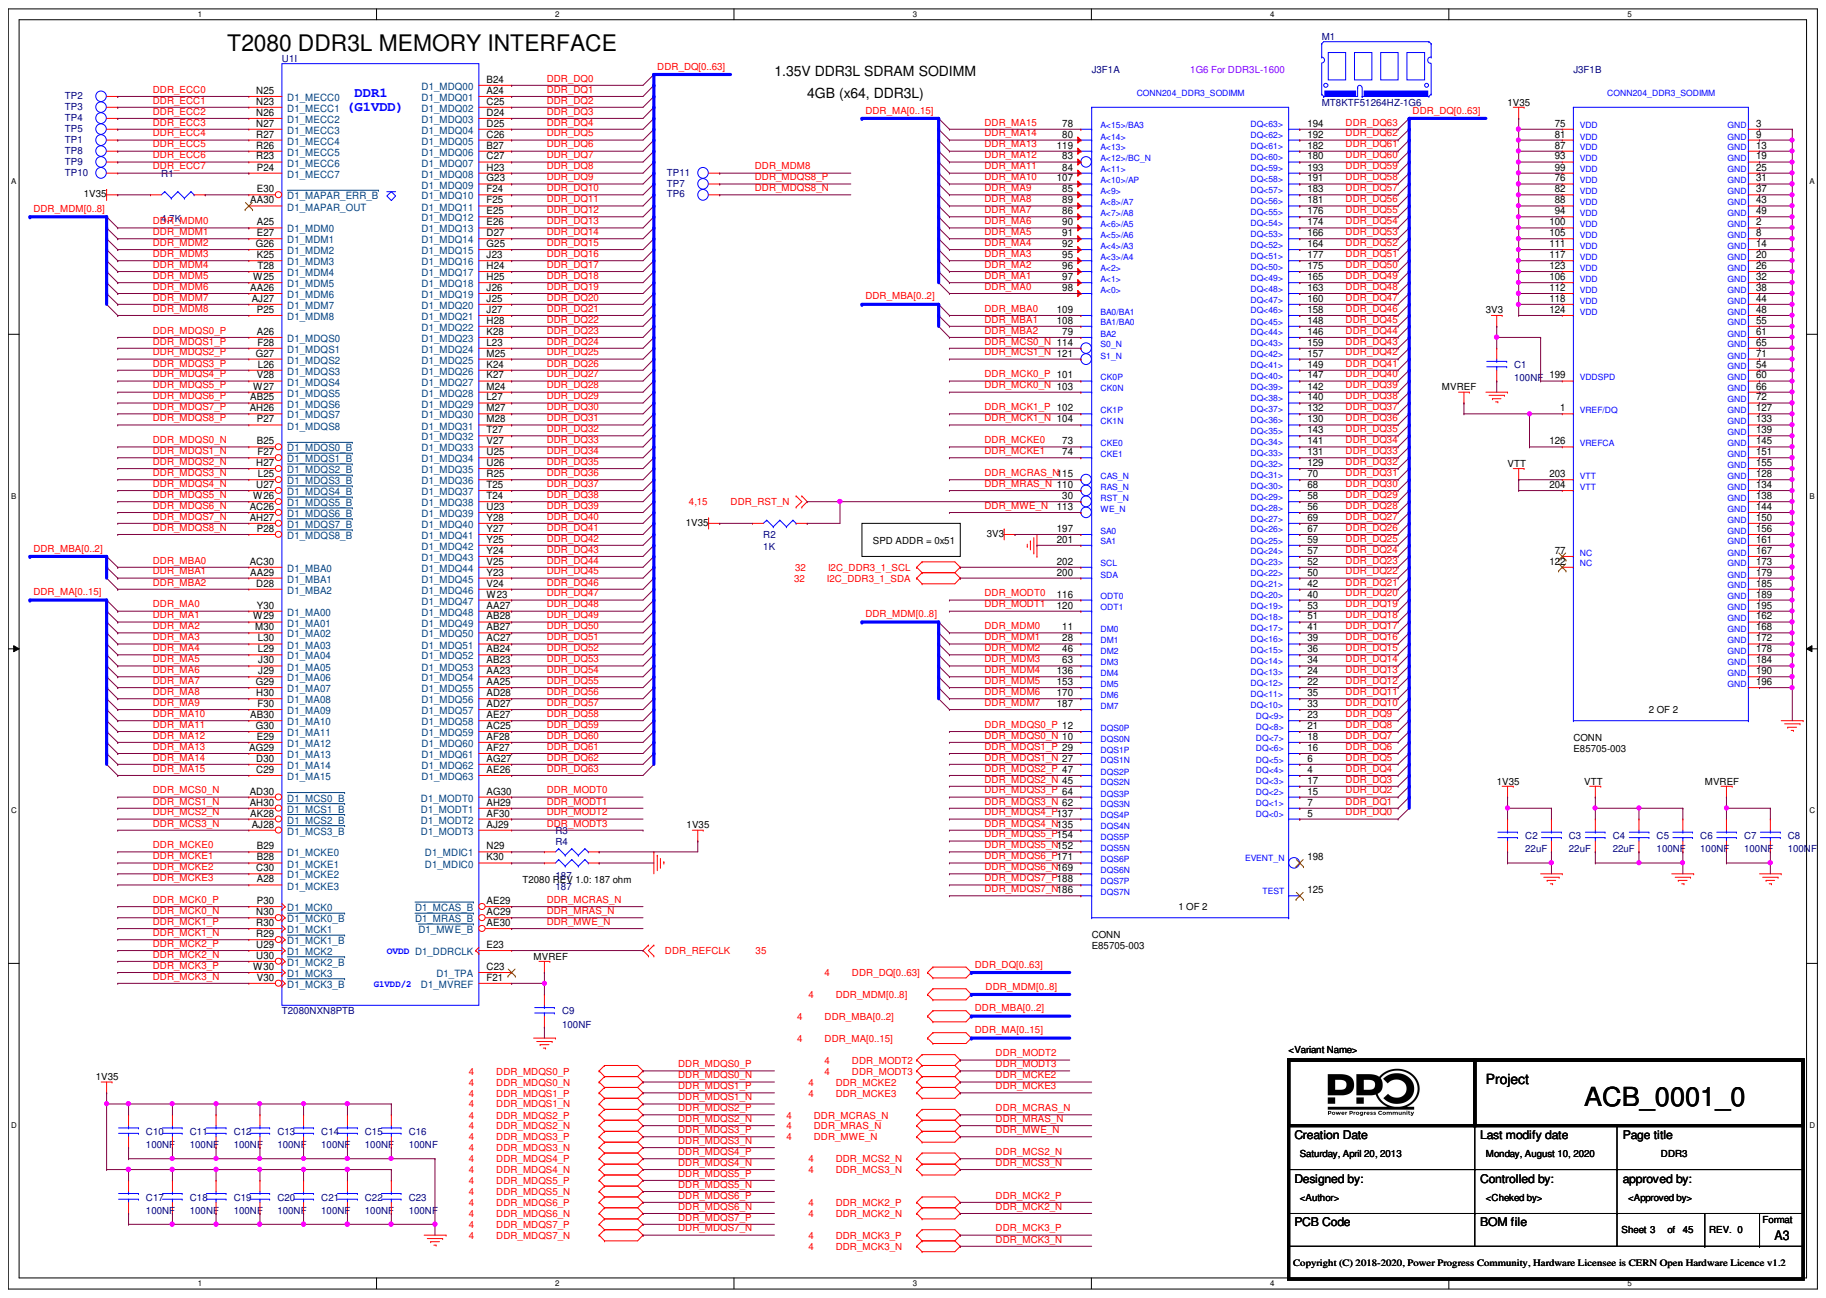
[picture p18: page 3]

81 | 9
87 | 13
93 | 19
99 | 25
76 | 31
82 | 37
88 | 43
94 | 49
100 | 2
105 | 8
111 | 14
117 | 20
123 | 26
106 | 32
112 | 38
118 | 44
124 | 48

Copyright (C) 2018-2020, Power Progress Community, Hardware Licensee is CERN Open Hardware Licence v1.2

A | A

## 4GB (x64, DDR3L)

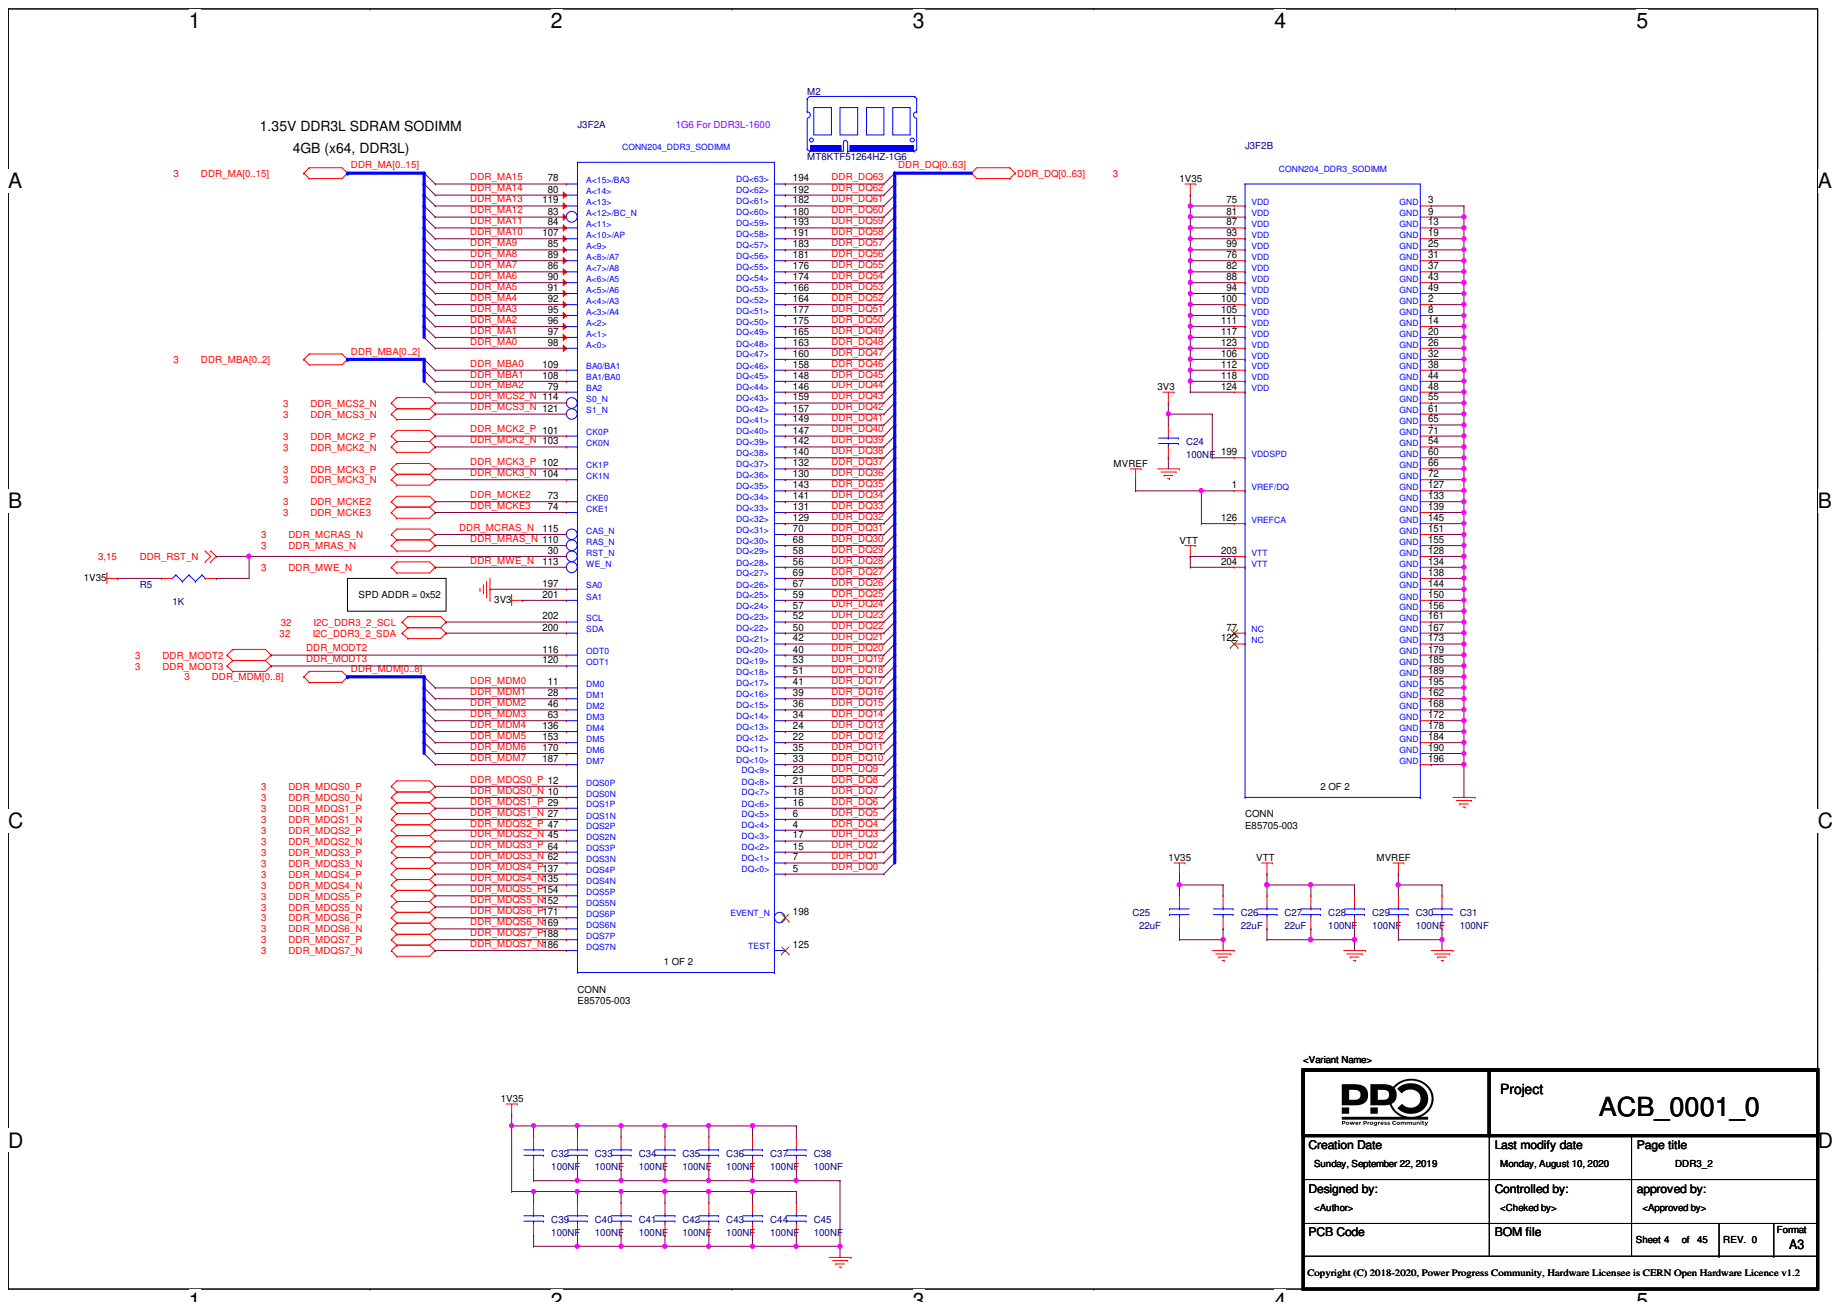
[picture p19: page 4]
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

# T2080 IFC INTERFACE

## T2080 RESET CONFIGURATION

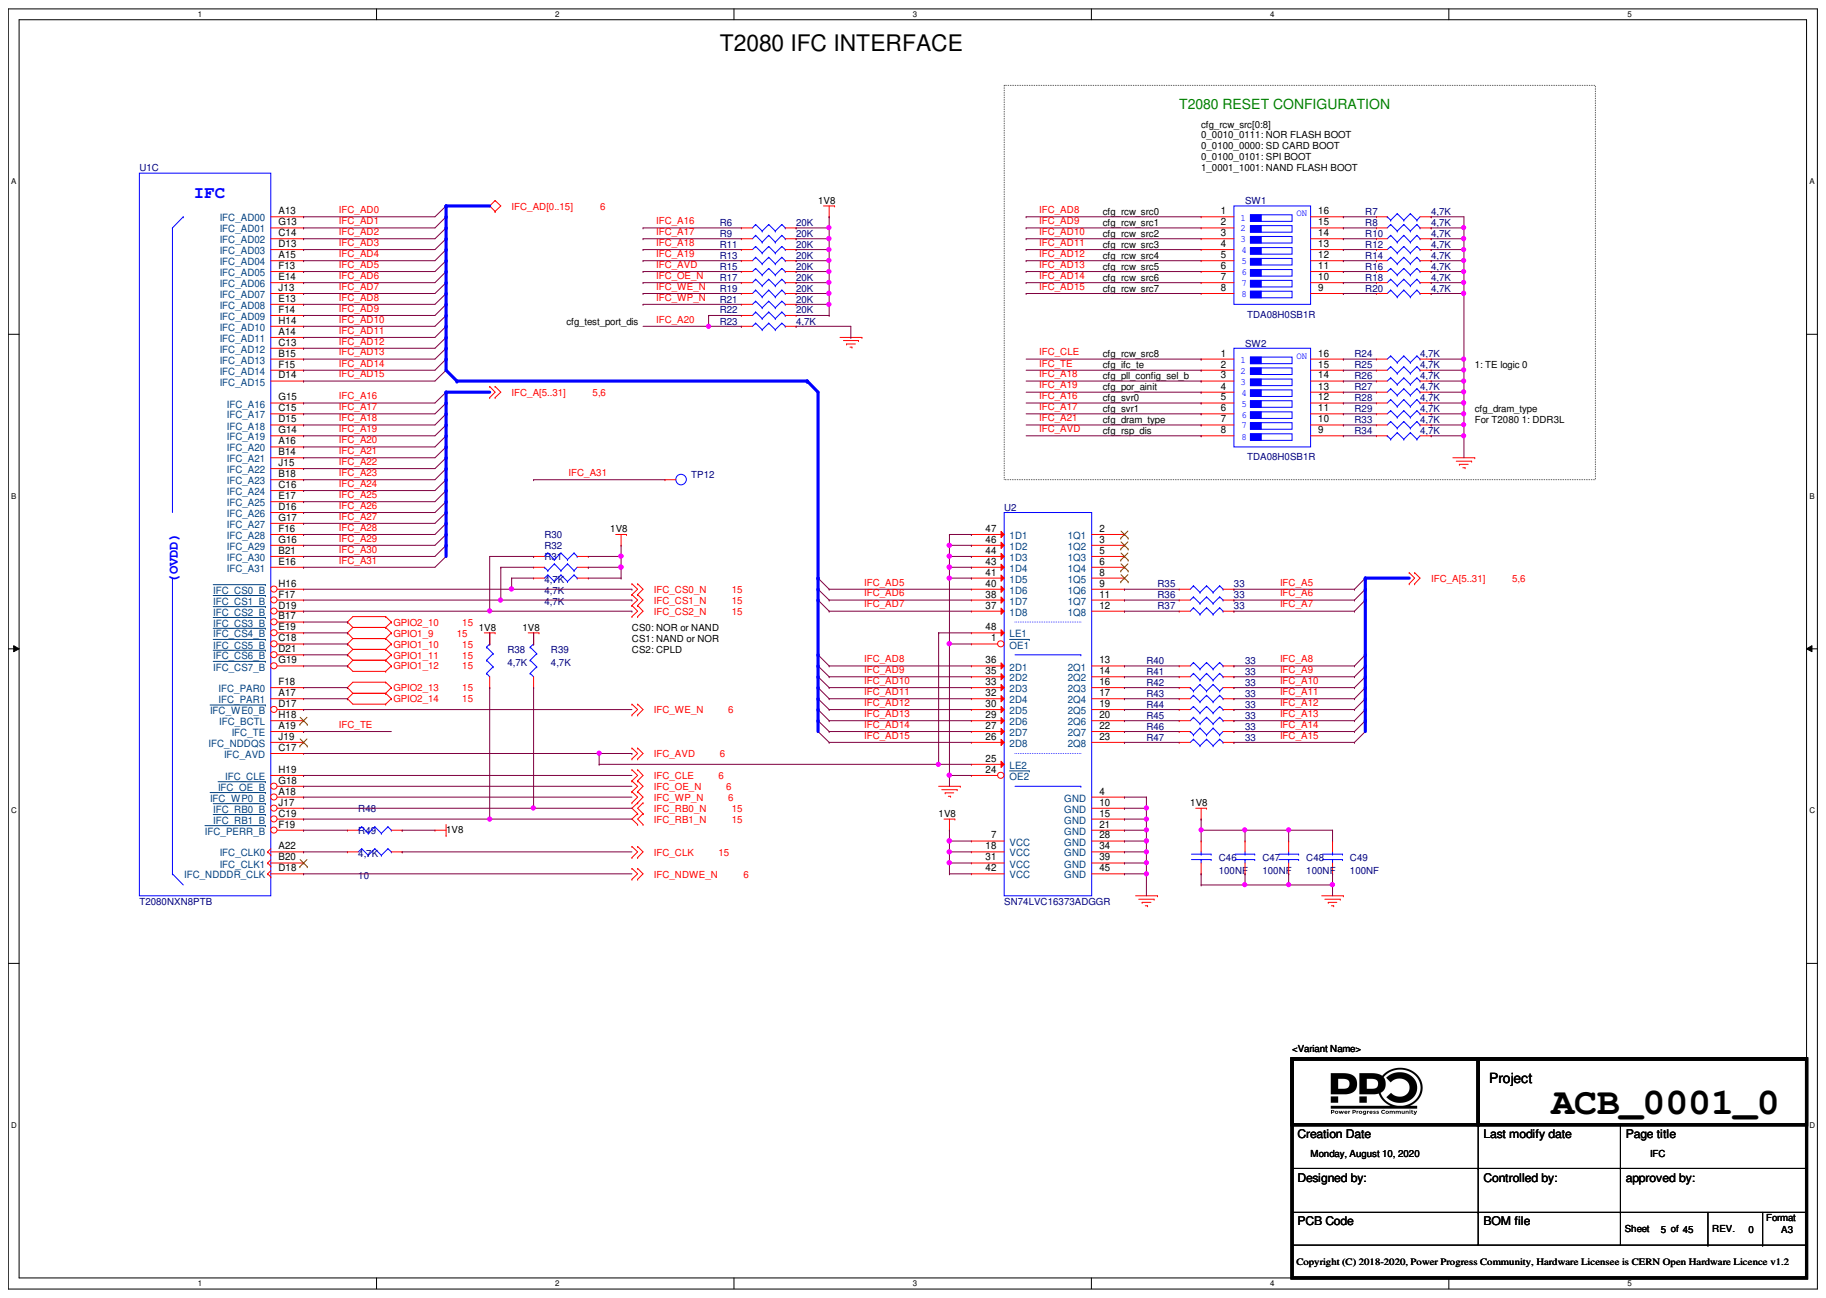
[picture p20: page 5]

## 128MB 16-BIT NOR FLASH

# T2080 NOR and NAND FLASH INTERFACE

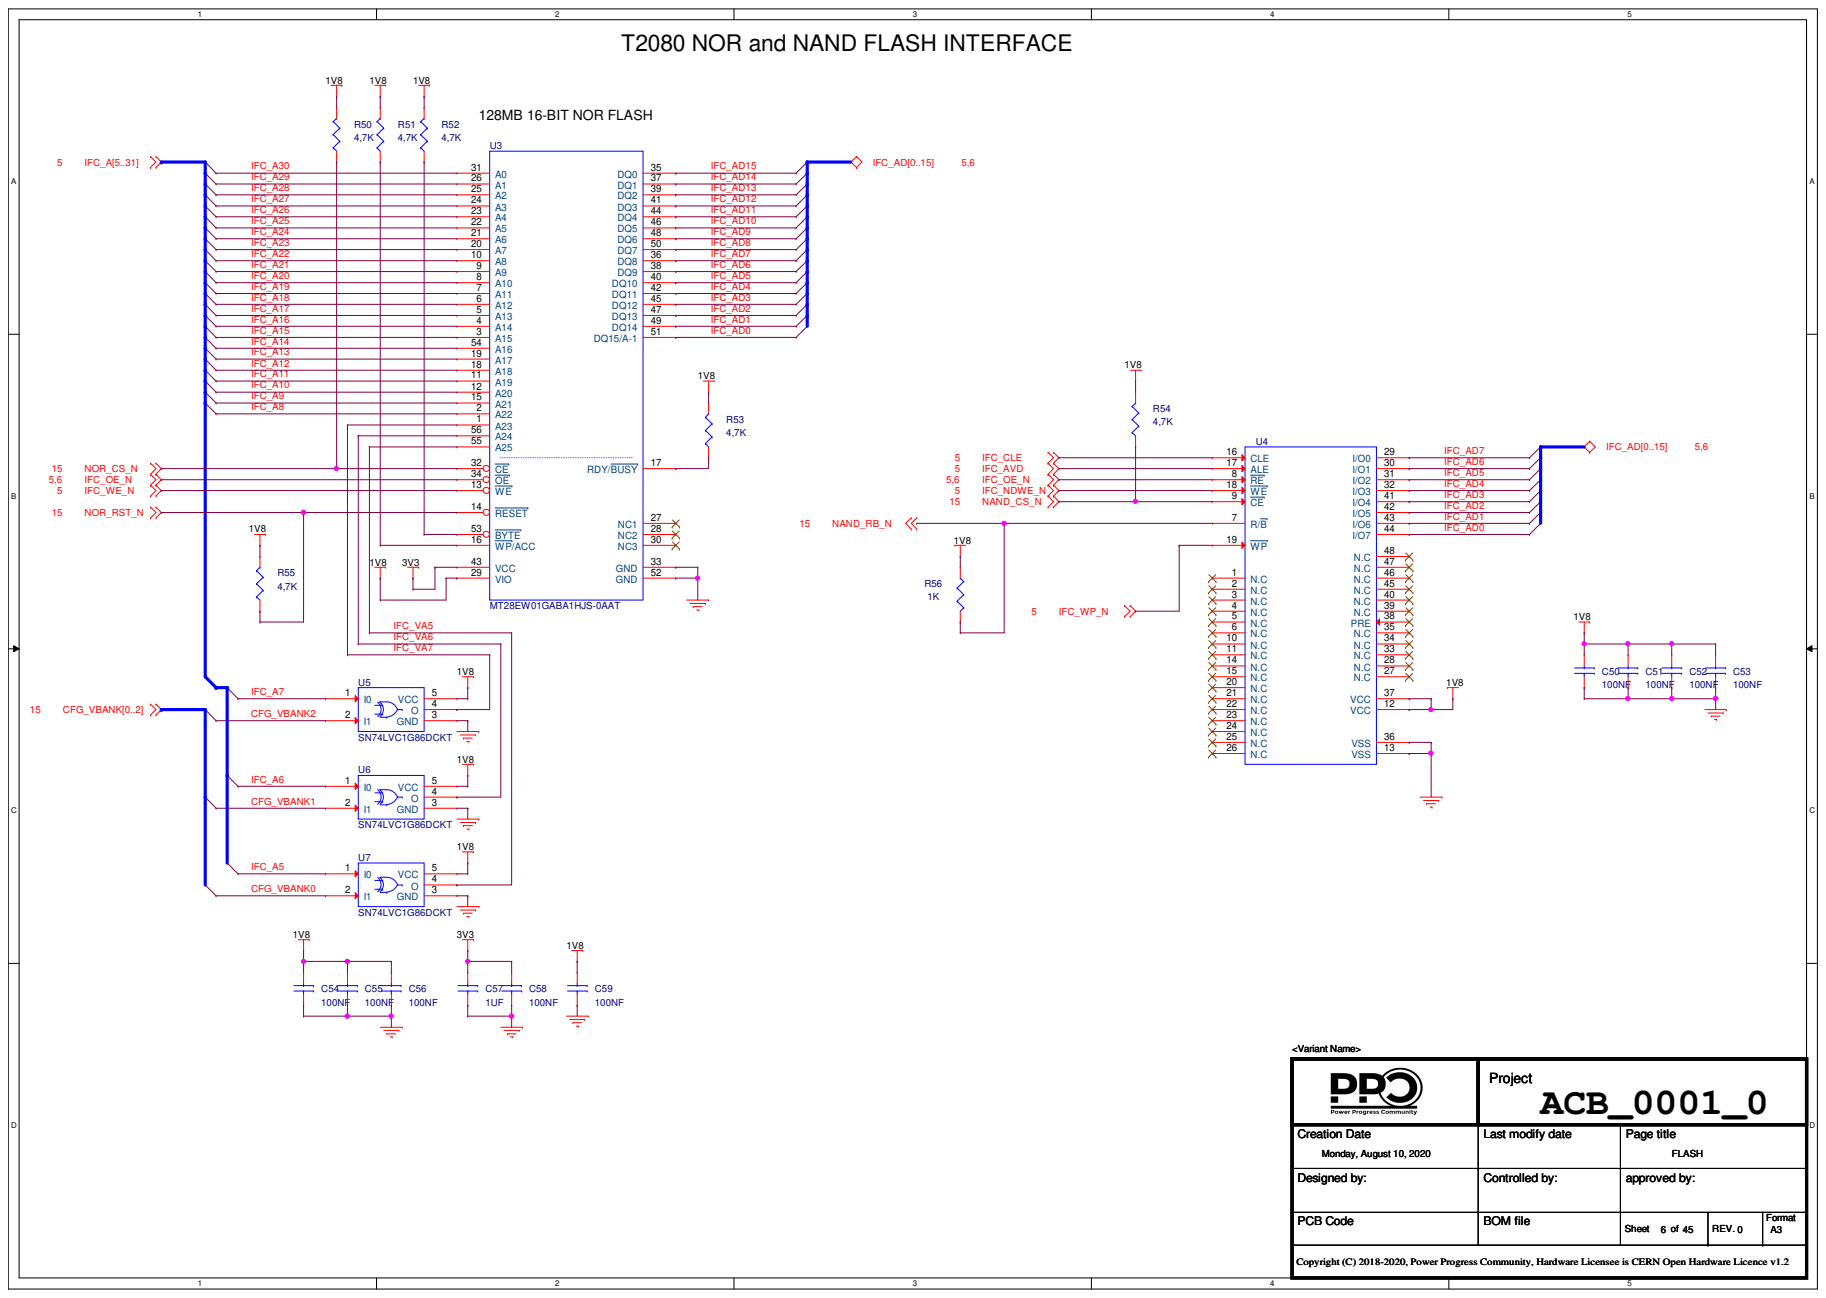
[picture p21: page 6]

## 64MB SERIAL FLASH

# T2080 SPI FLASH and SDHC INTERFACE

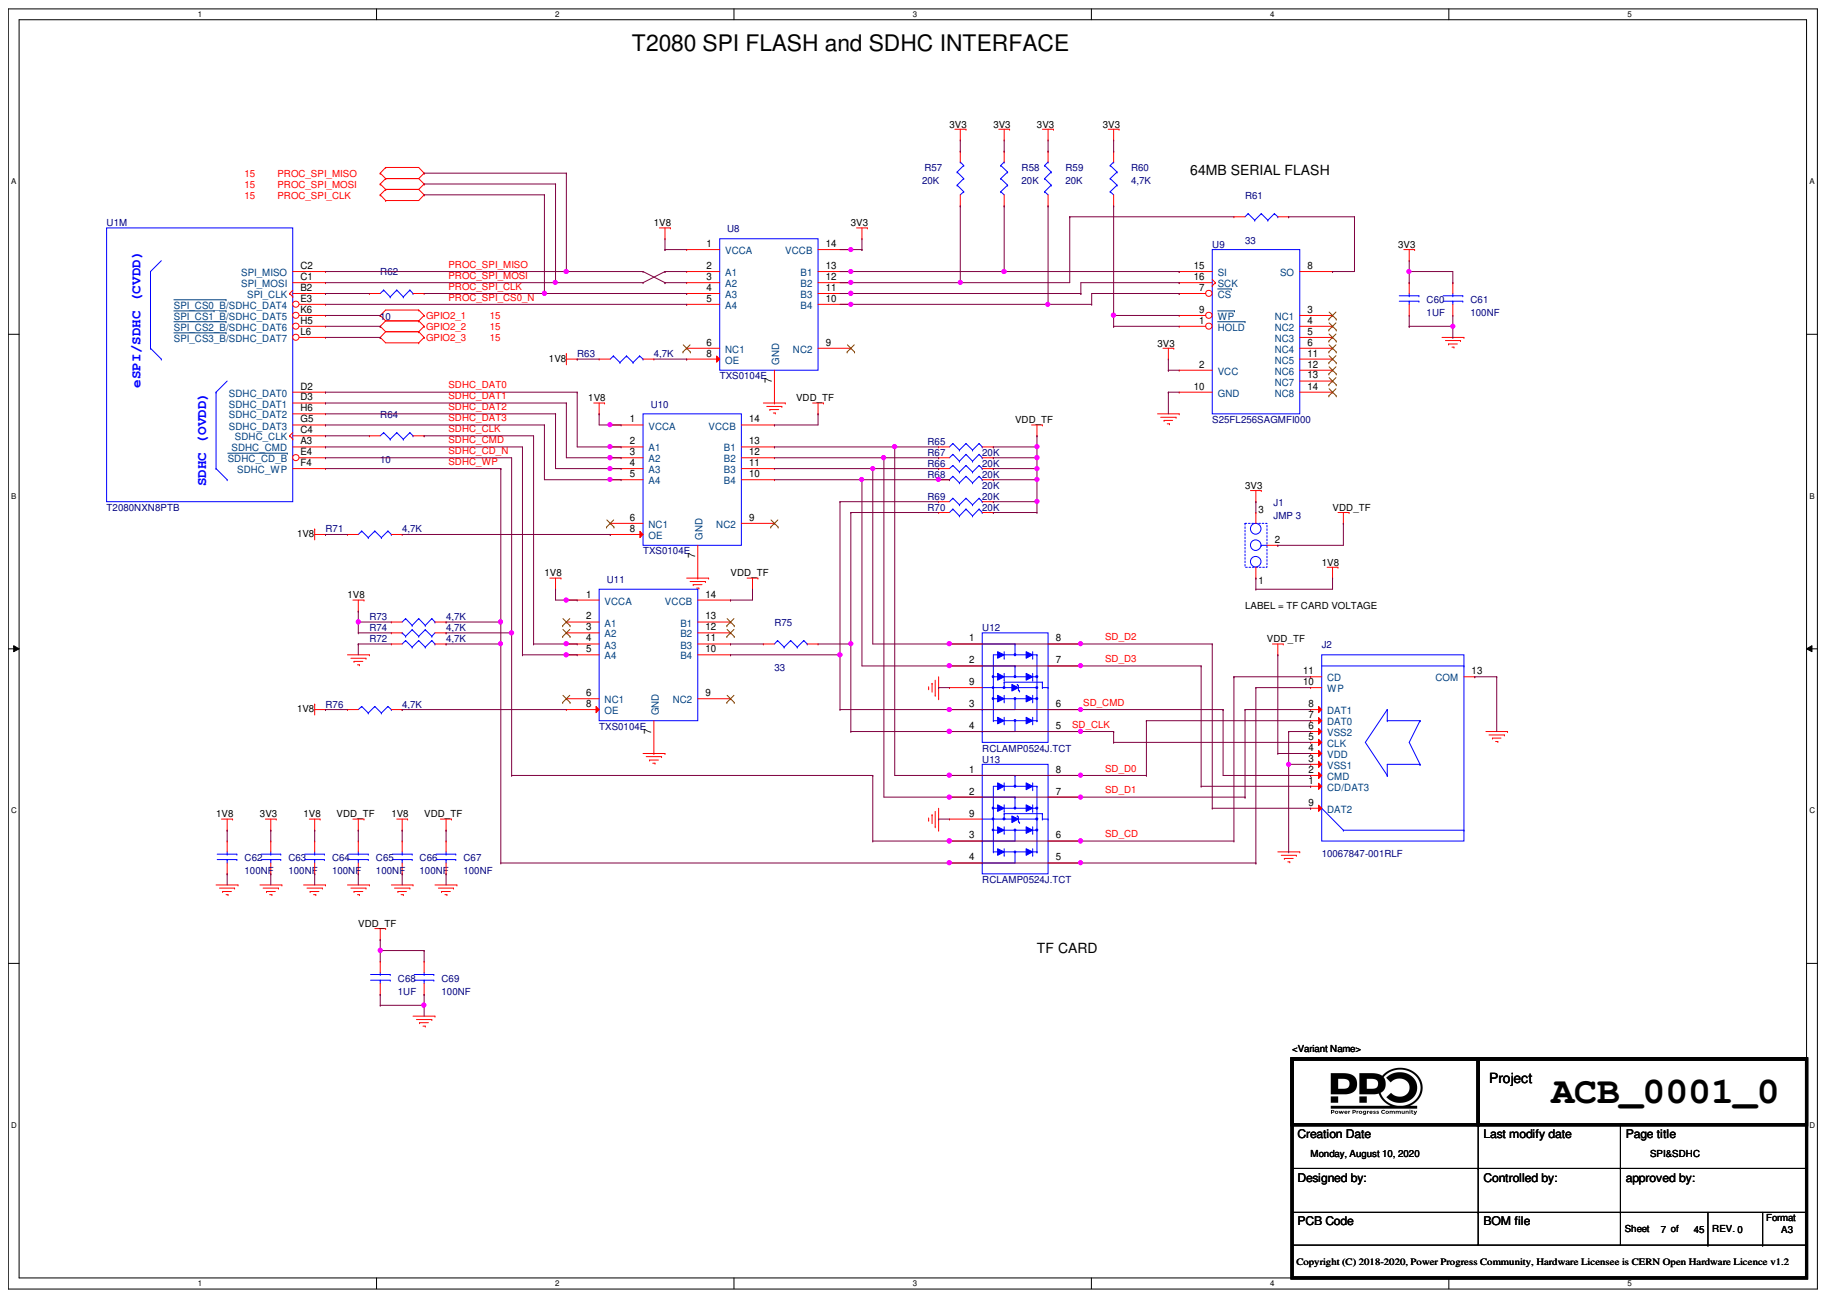
[picture p22: page 7]

LABEL = TF CARD VOLTAGE

# T2080 SYSTEM LOGIC INTERFACE

# CNTR & MISC

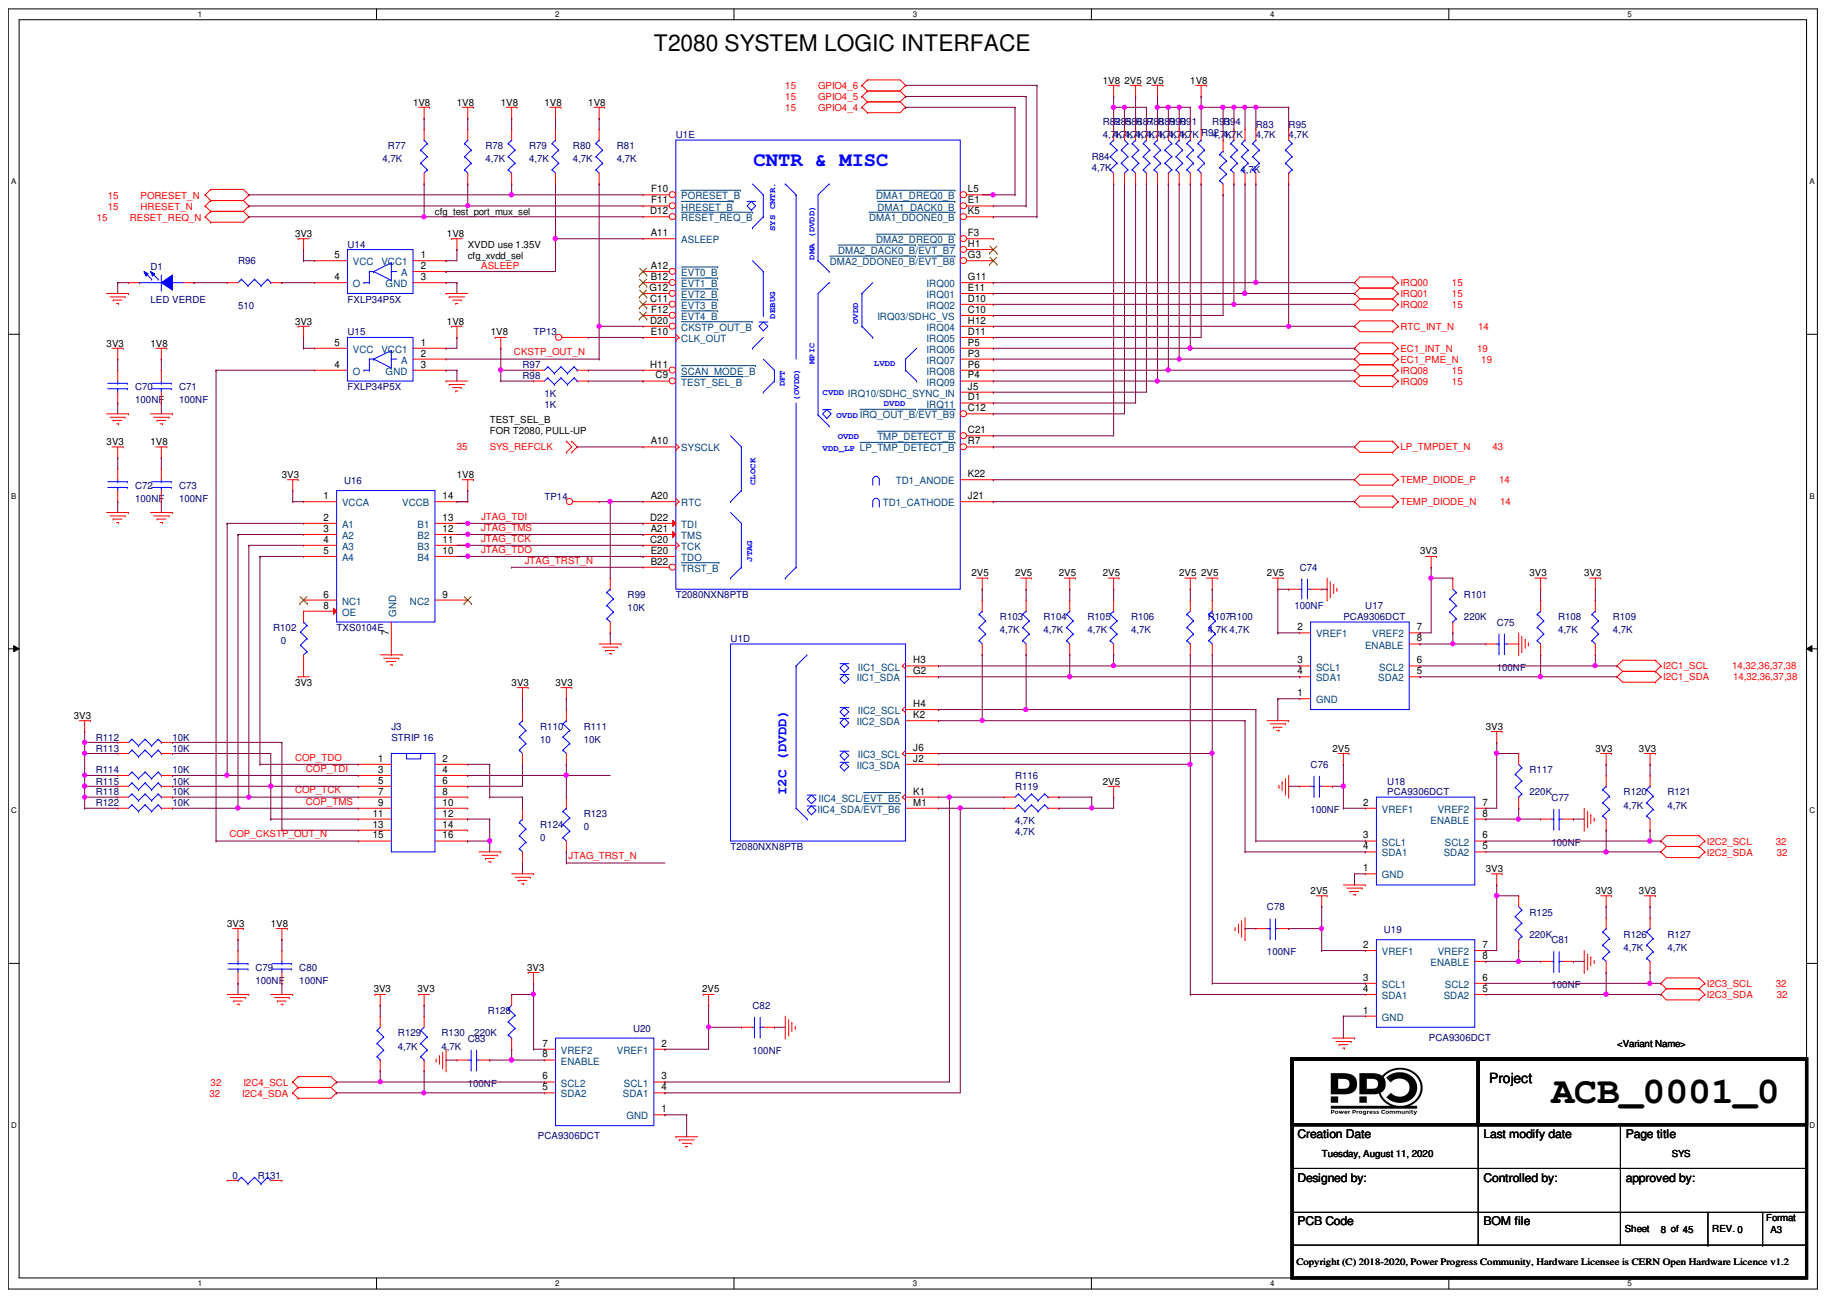
[picture p23: page 8]

COP_TCK 7
COP_TMS 9

# T2080 ETHERNET and SERDES INTERFACE

### SERDES 1

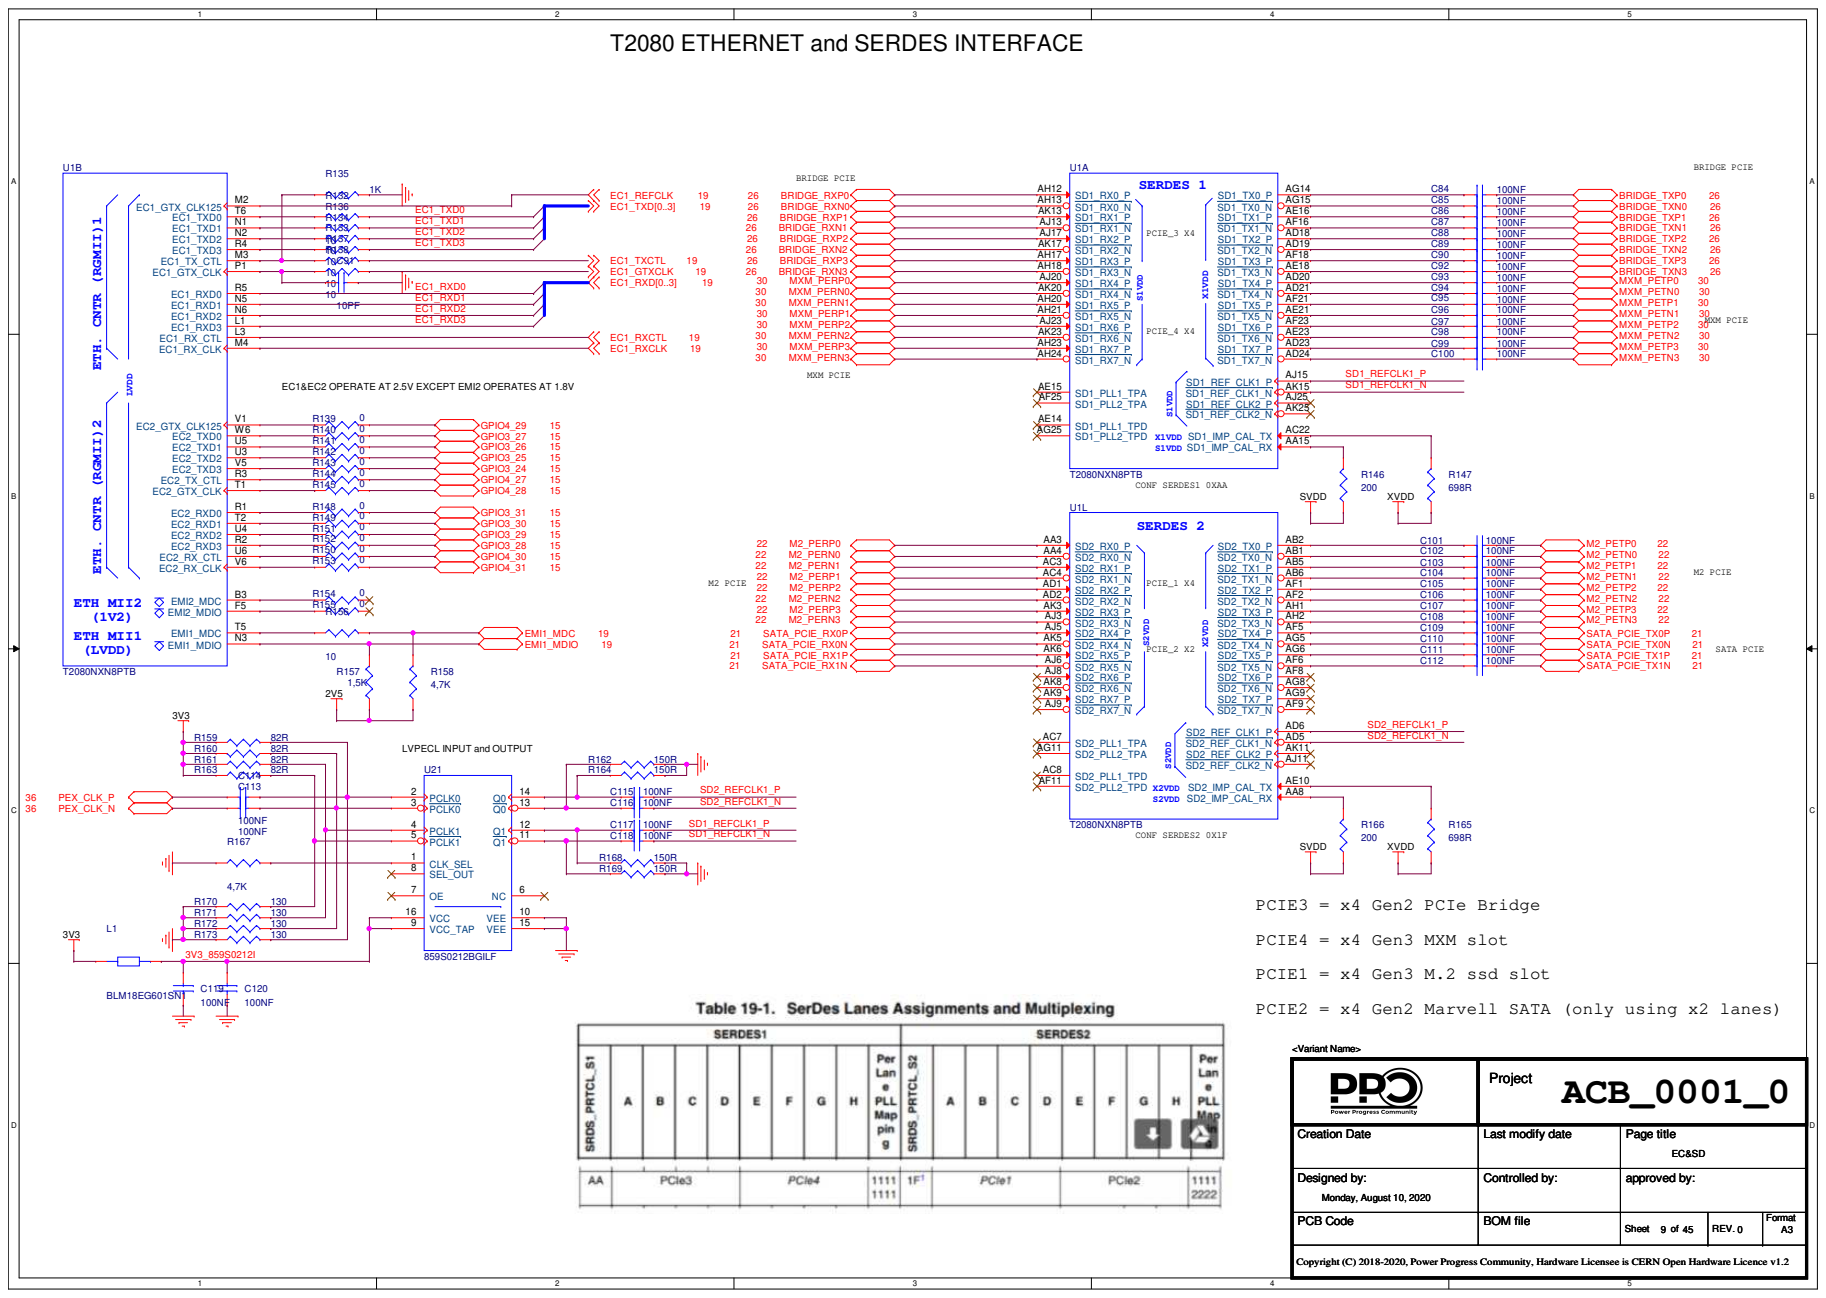
[picture p24: page 9]

ETH. CNTR (RGMII)1 ETH. CNTR (RGMII)2

EC1&EC2 OPERATE AT 2.5V EXCEPT EMI2 OPERATES AT 1.8V

LVPECL INPUT and OUTPUT

PCIE2 = x4 Gen2 Marvell SATA (only using x2 lanes)

# T2080 USB INTERFACE

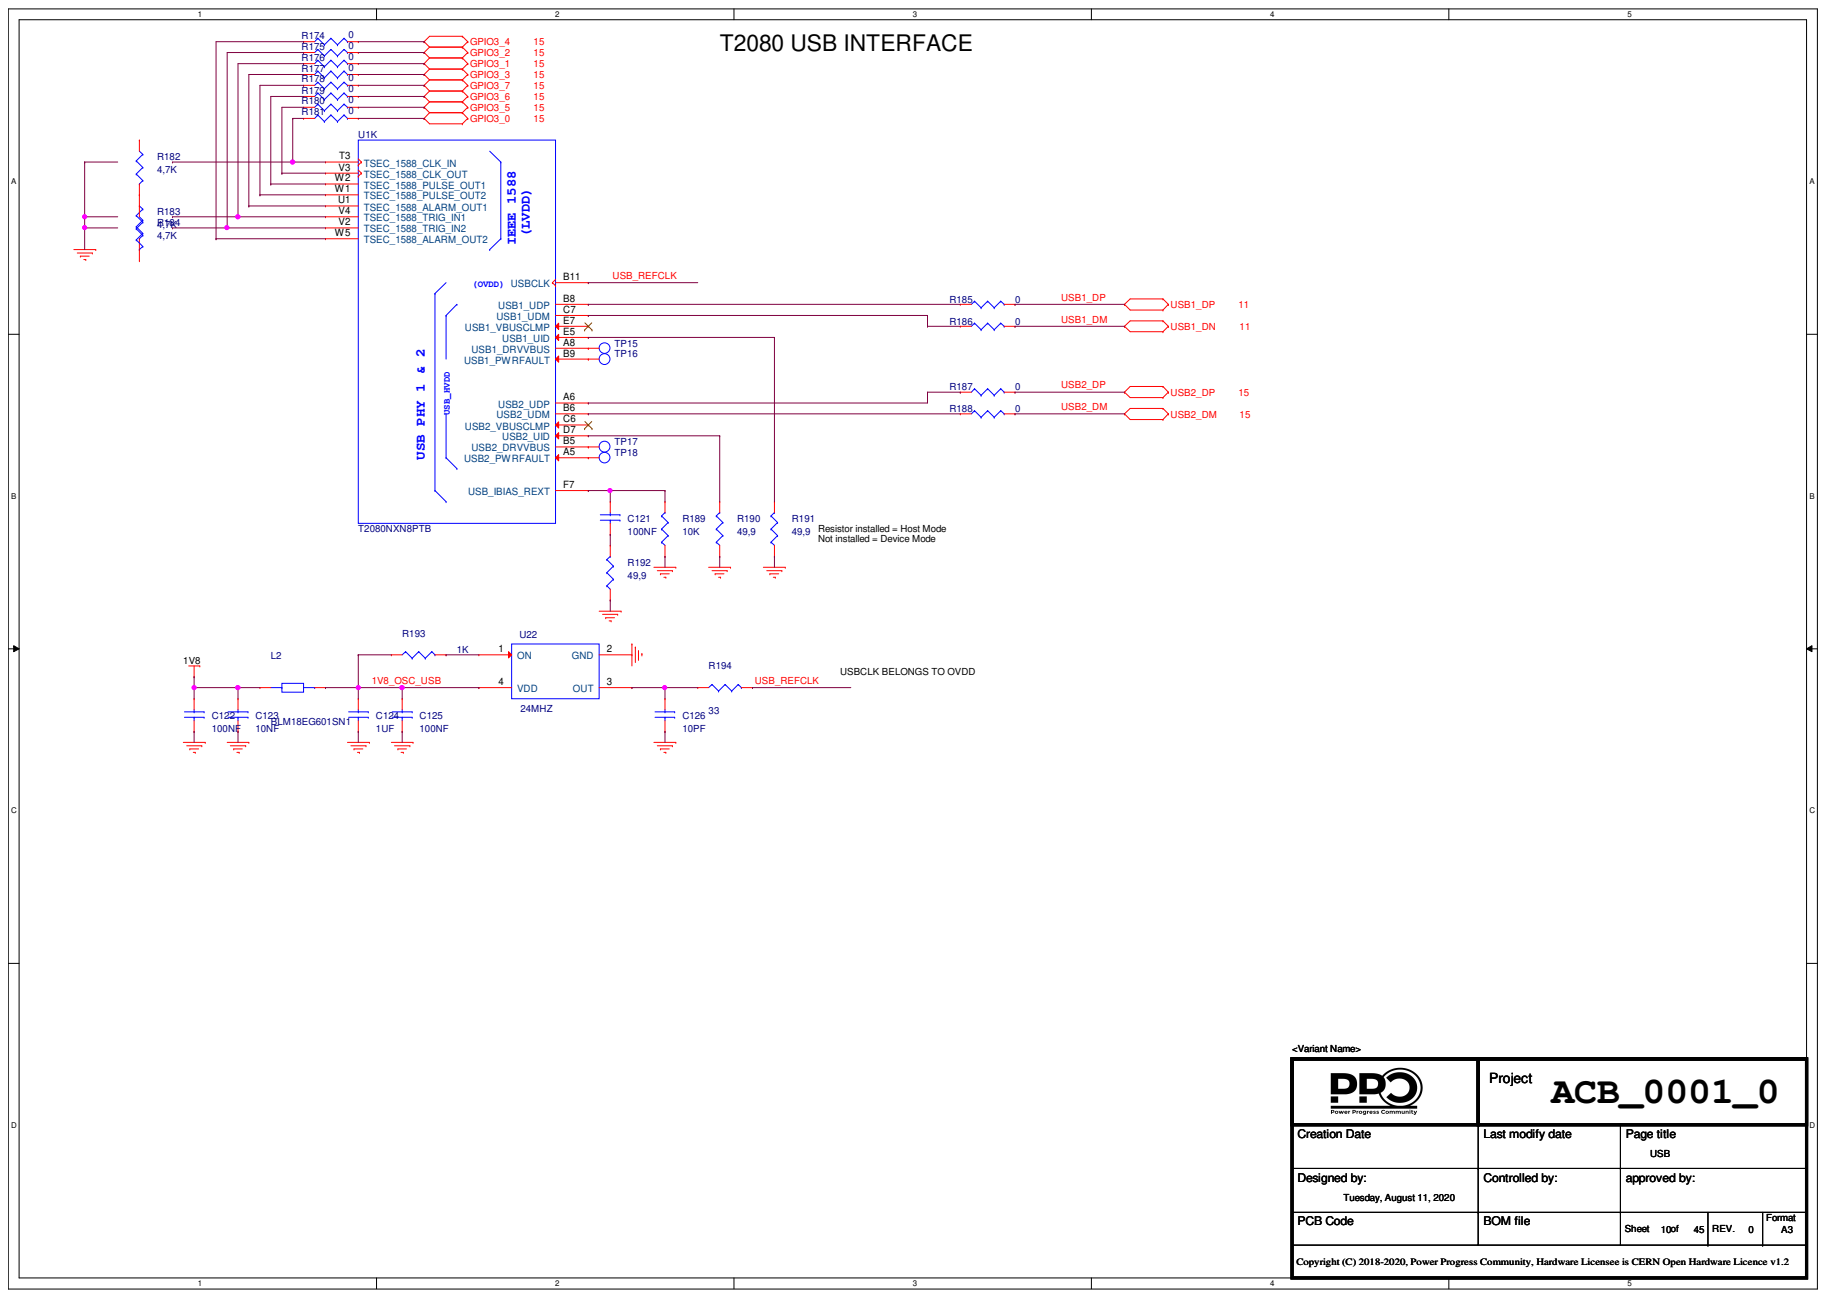
[picture p25: page 10]

Resistor installed = Host Mode
Not installed = Device Mode

USBCLK BELONGS TO OVDD

# HUB USB

# KB CONTROLLER

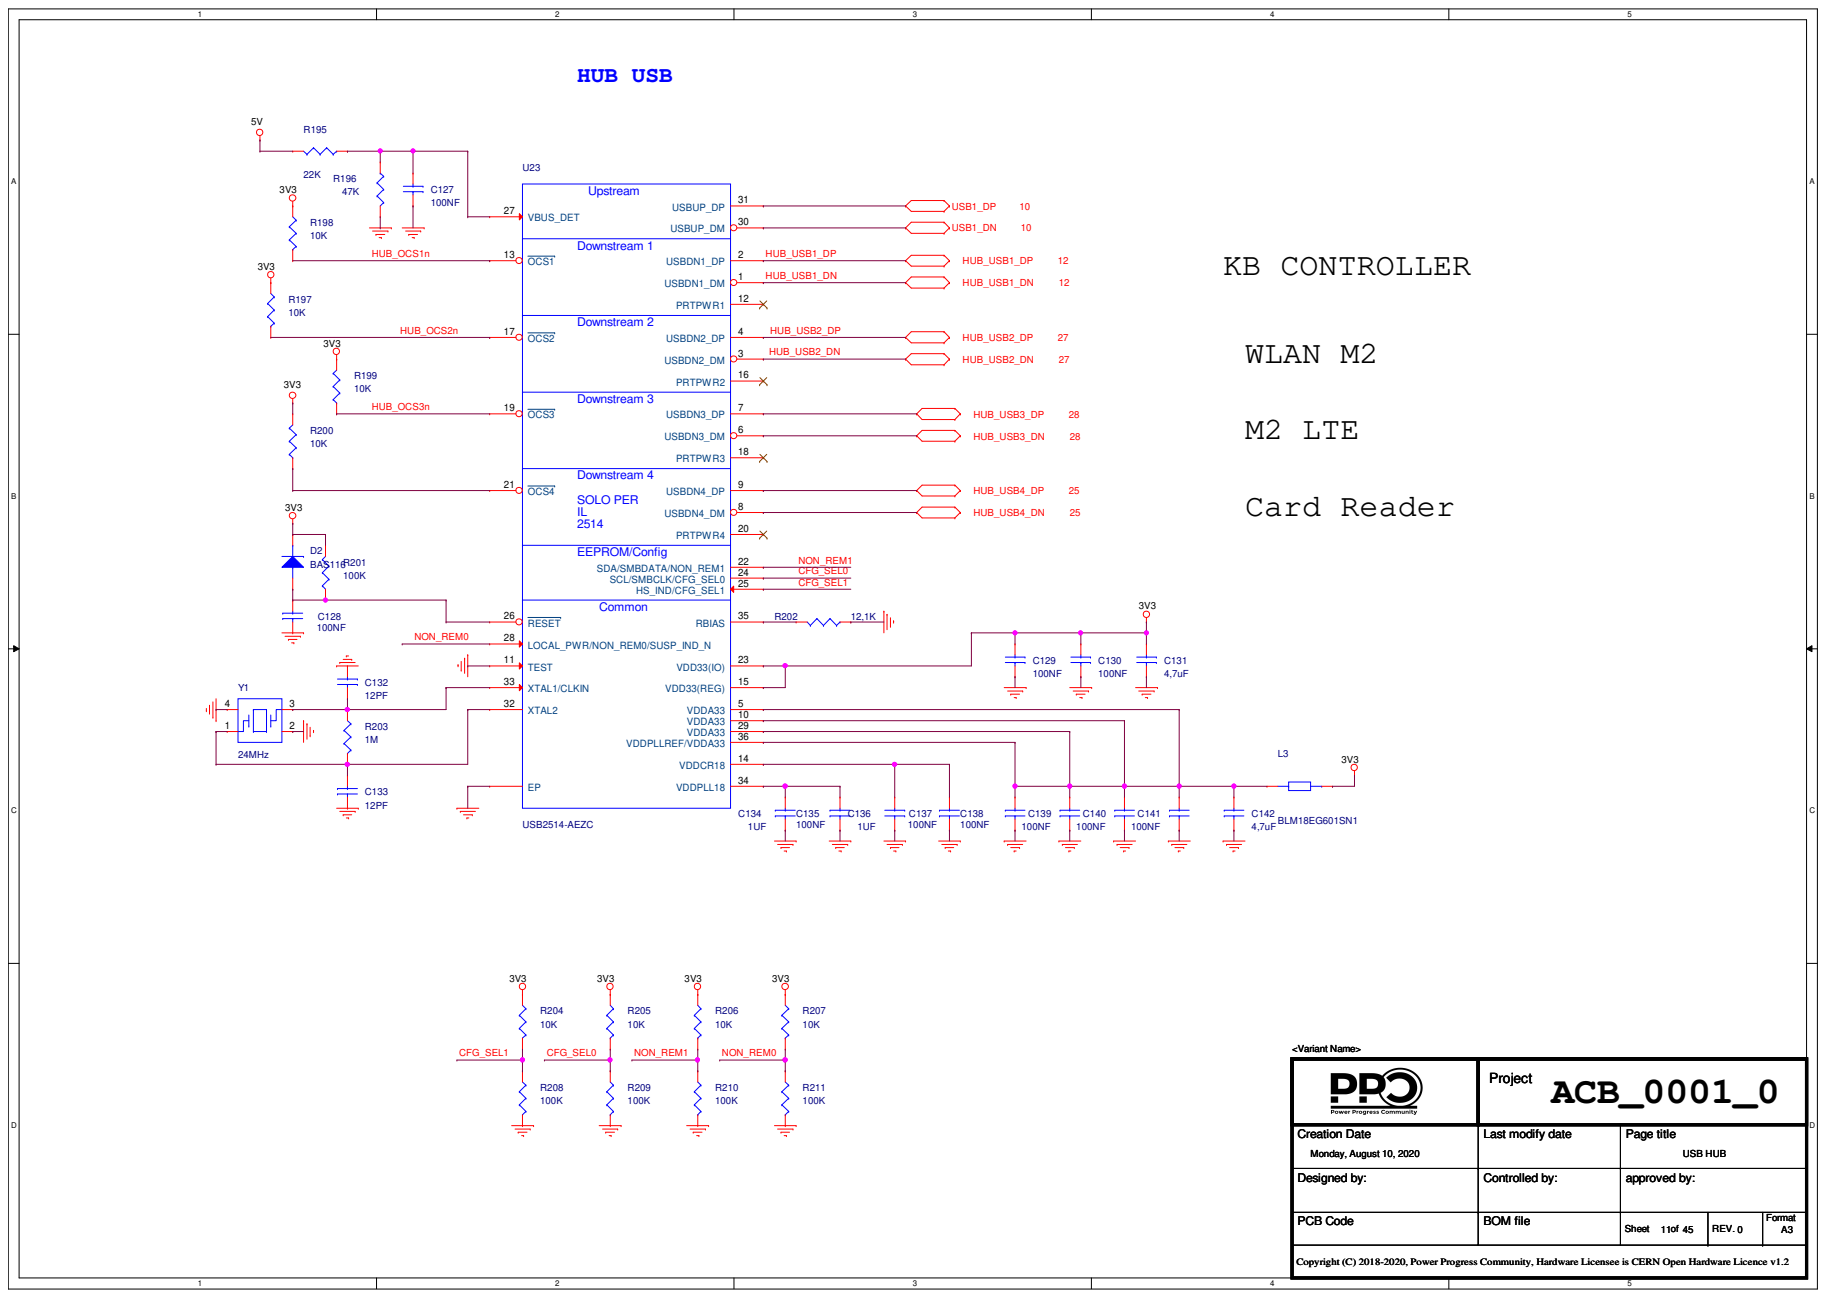
[picture p26: page 11]

A | A

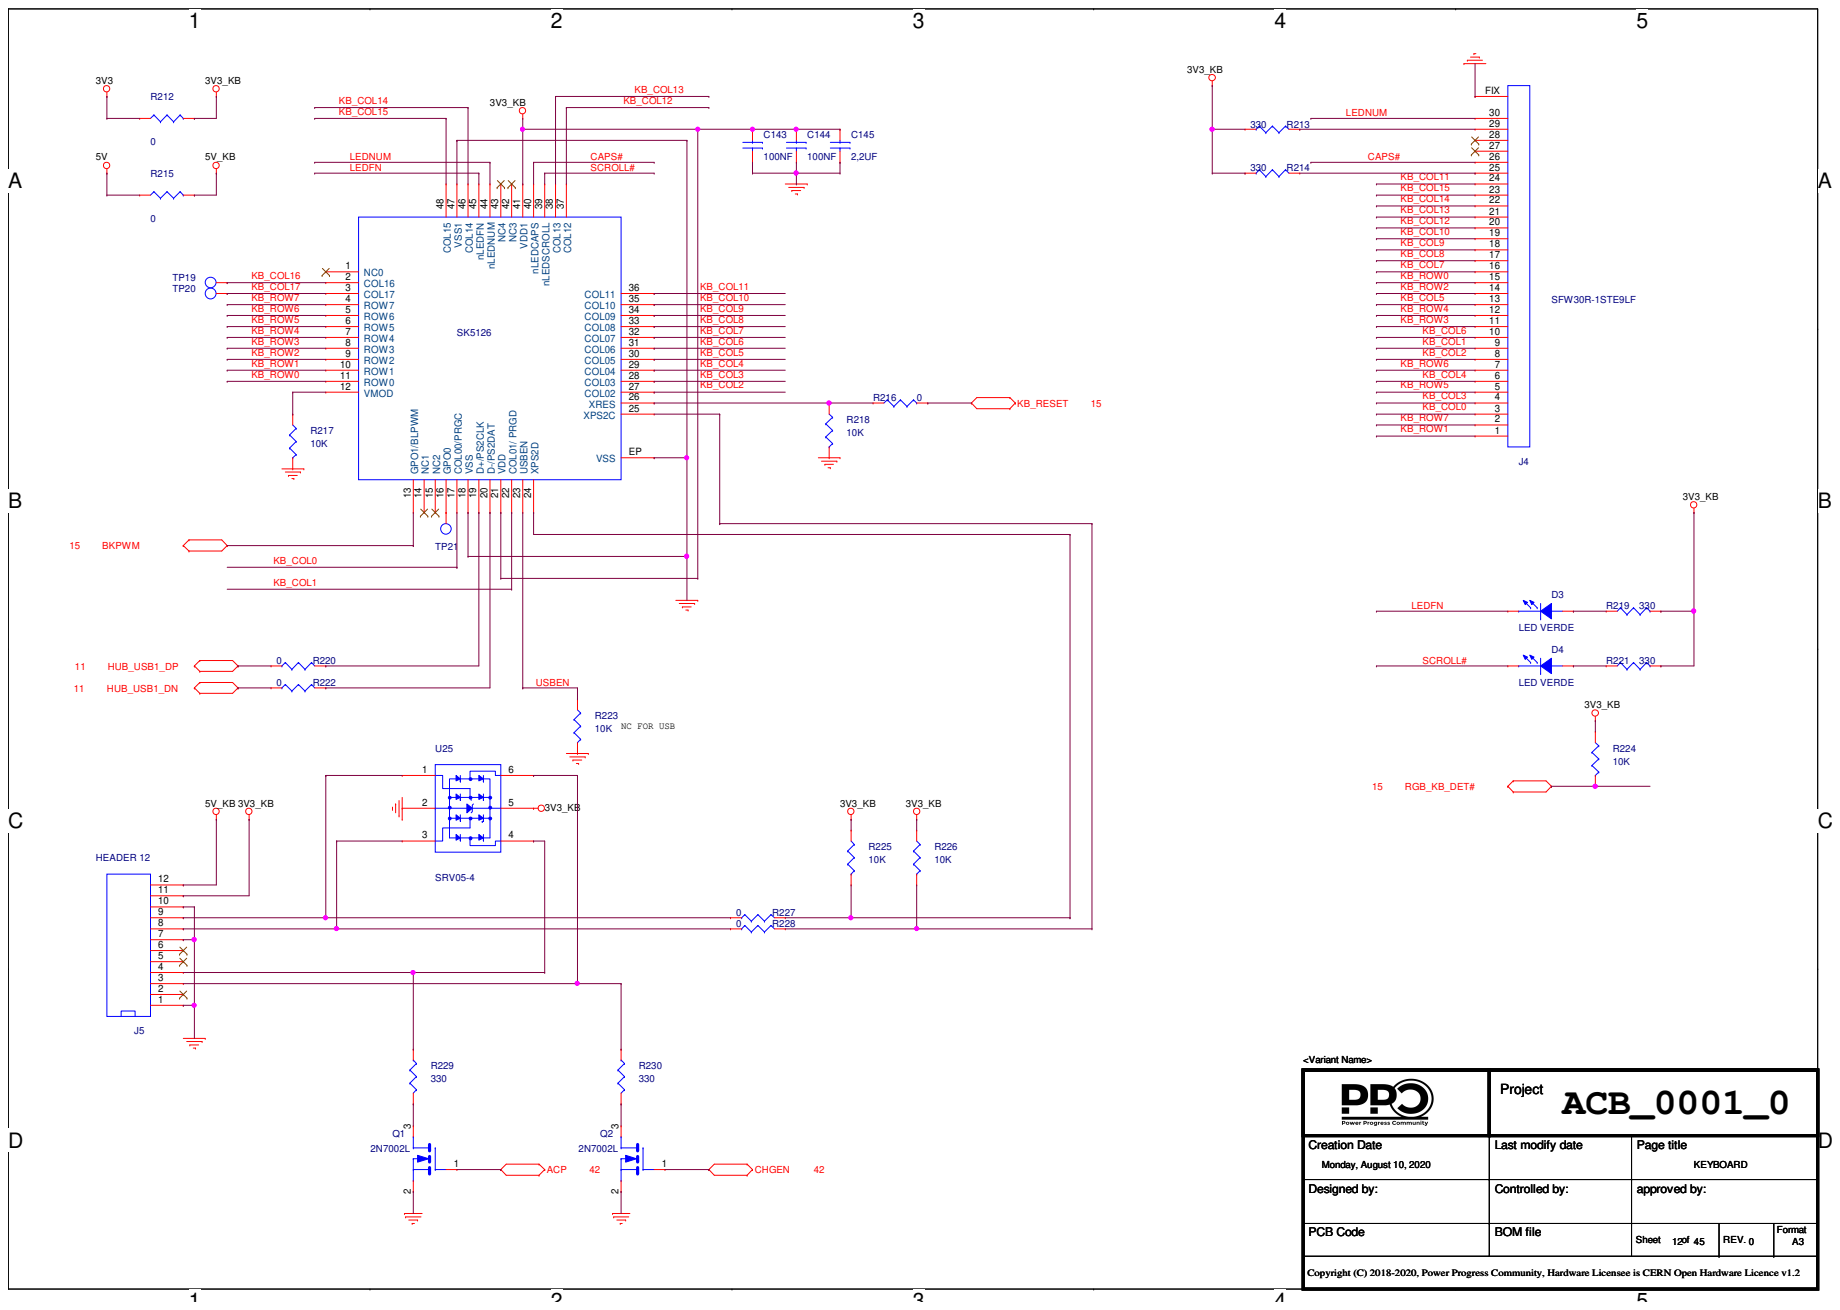
[picture p27: page 12]

A | A

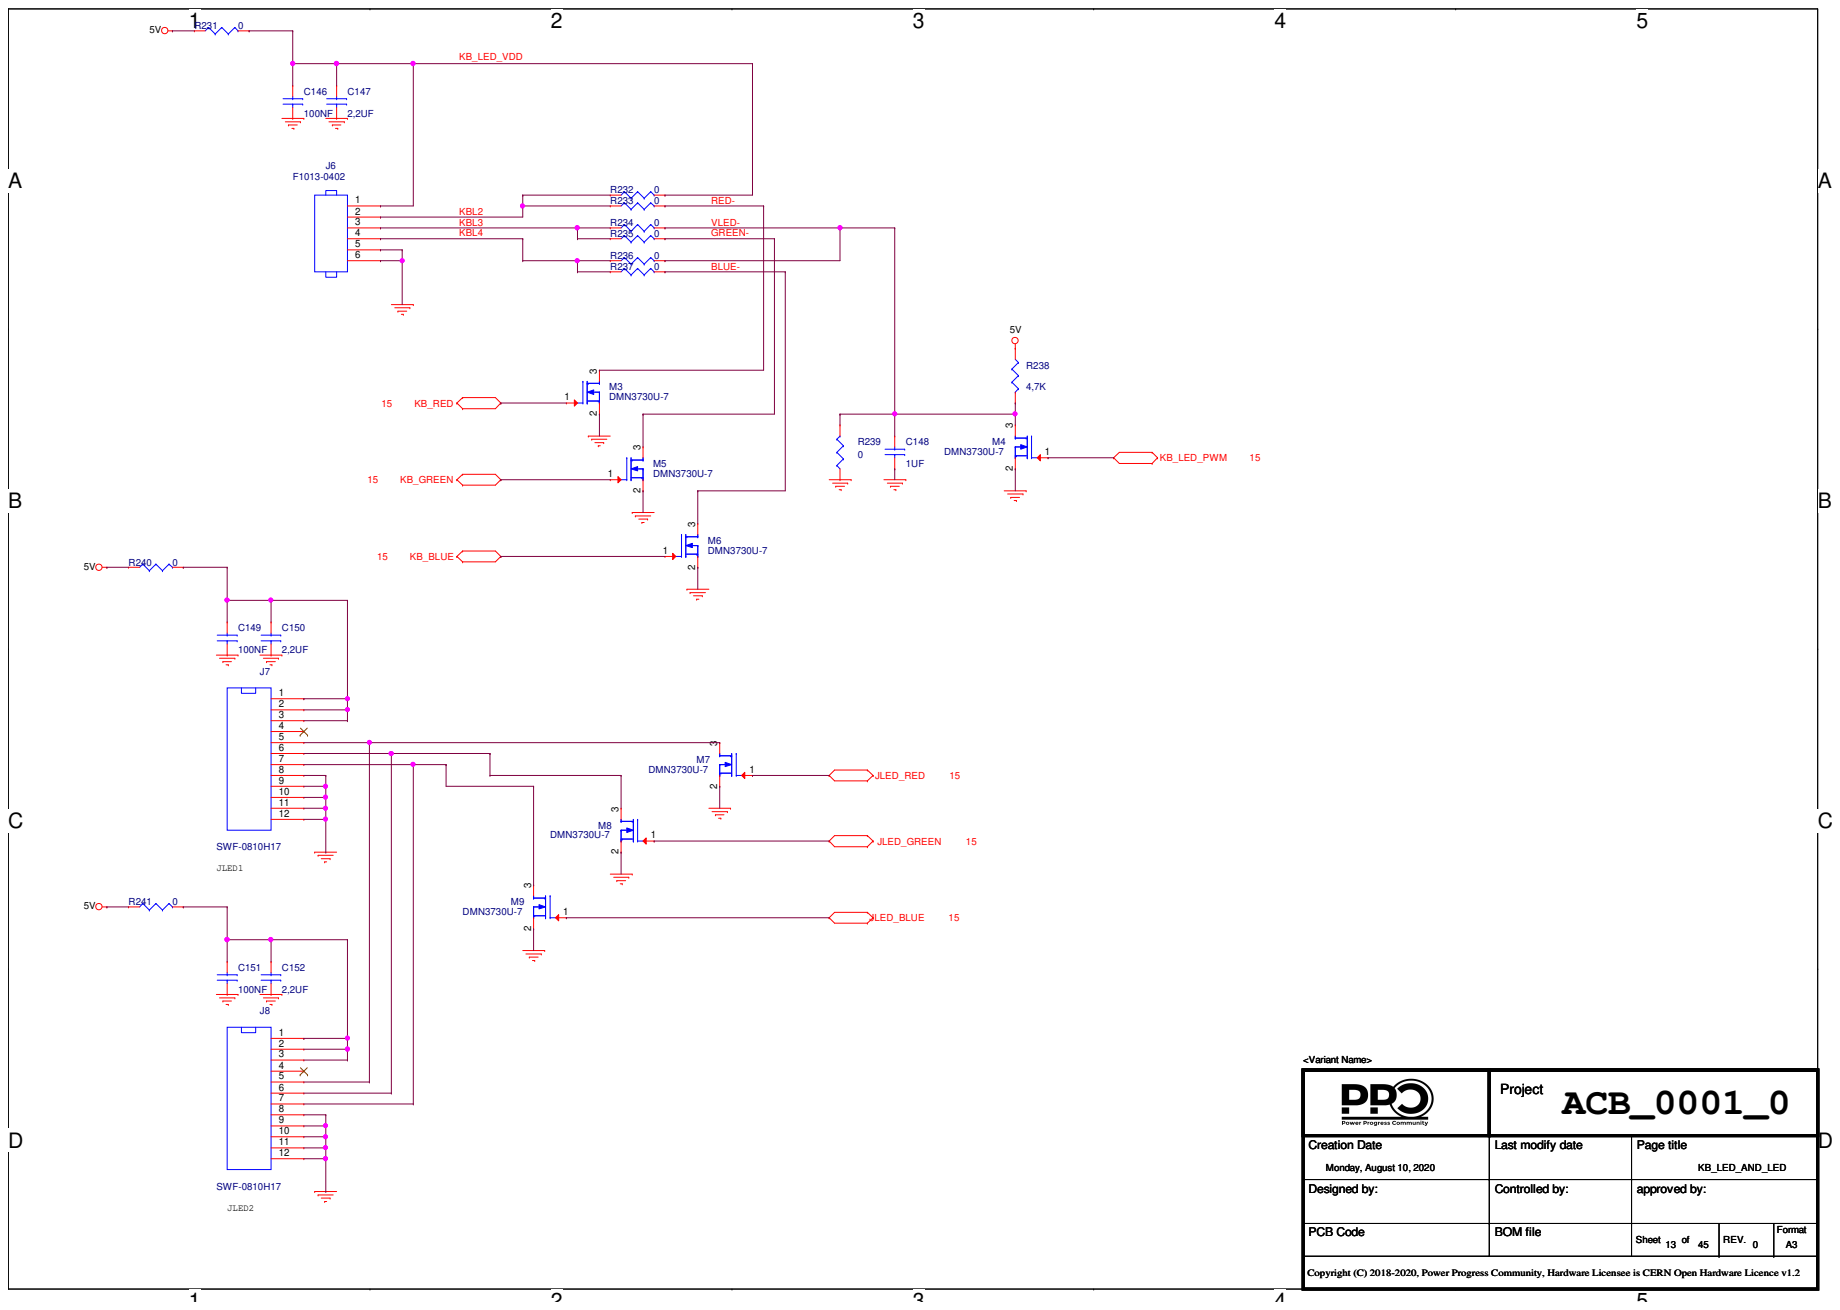
[picture p28: page 13]

# T2080 DUART and I2C DEVICE INTERFACE

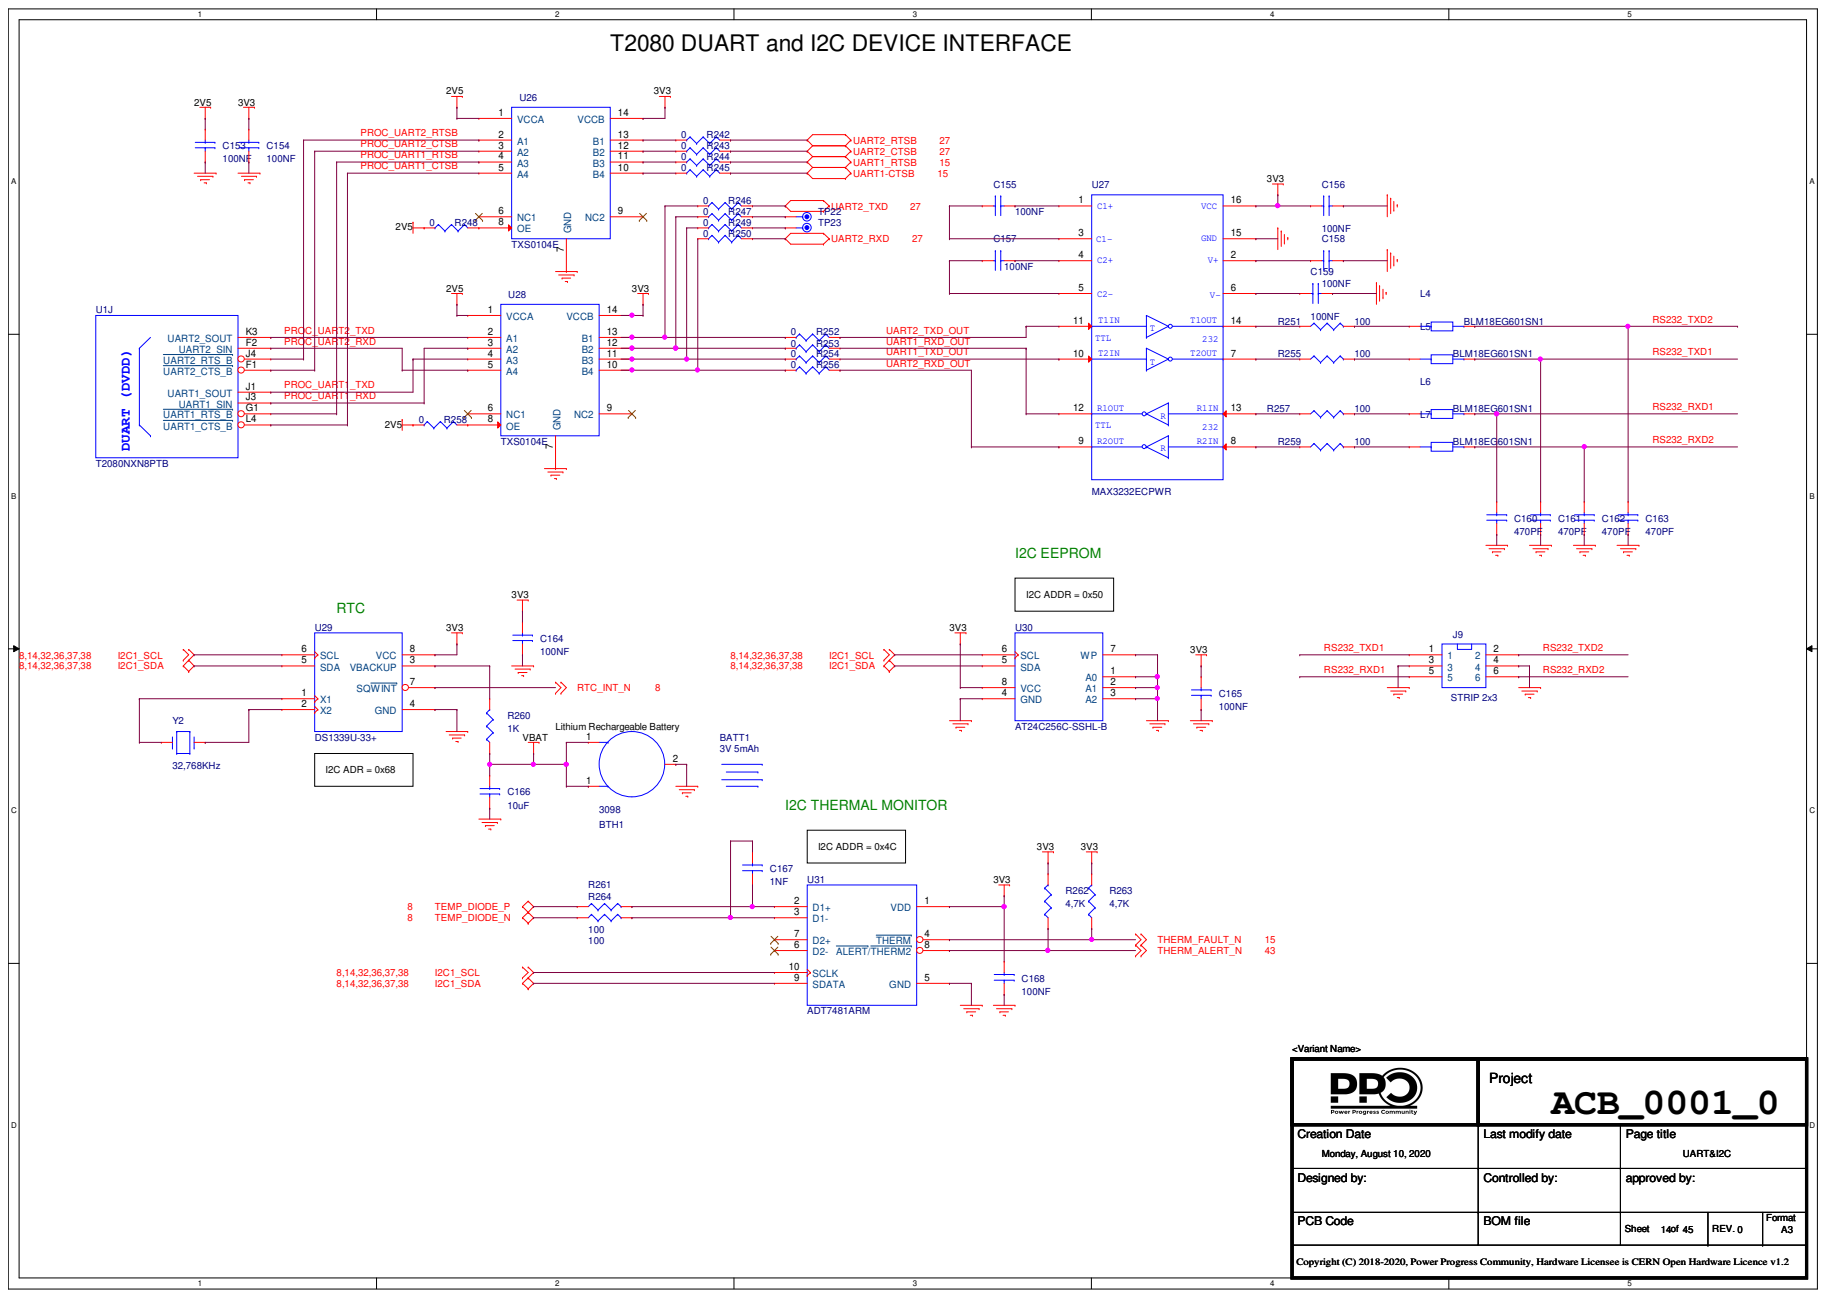
[picture p29: page 14]

A

A

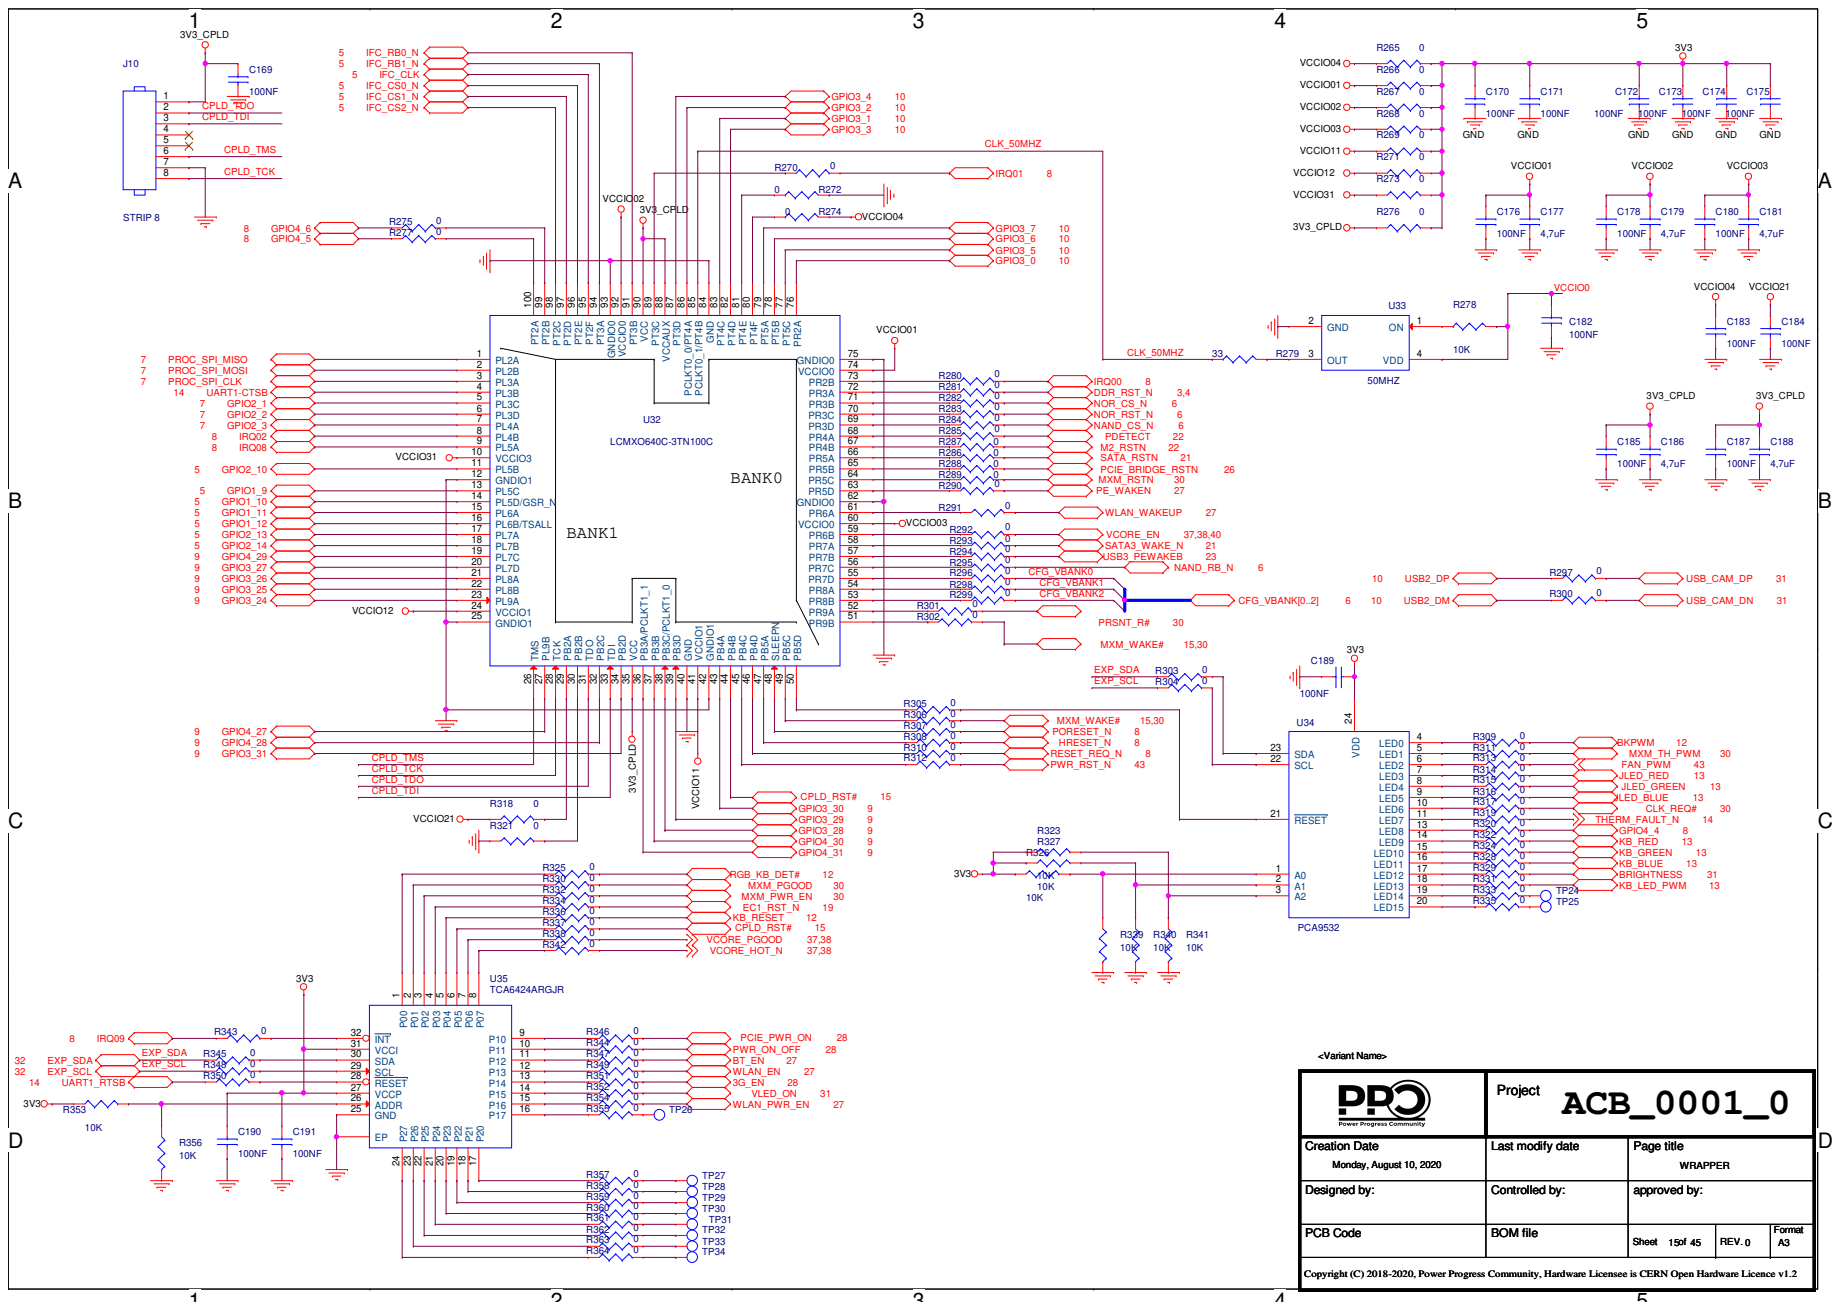
[picture p30: page 15]

# T2080 POWER SUPPLY

PS

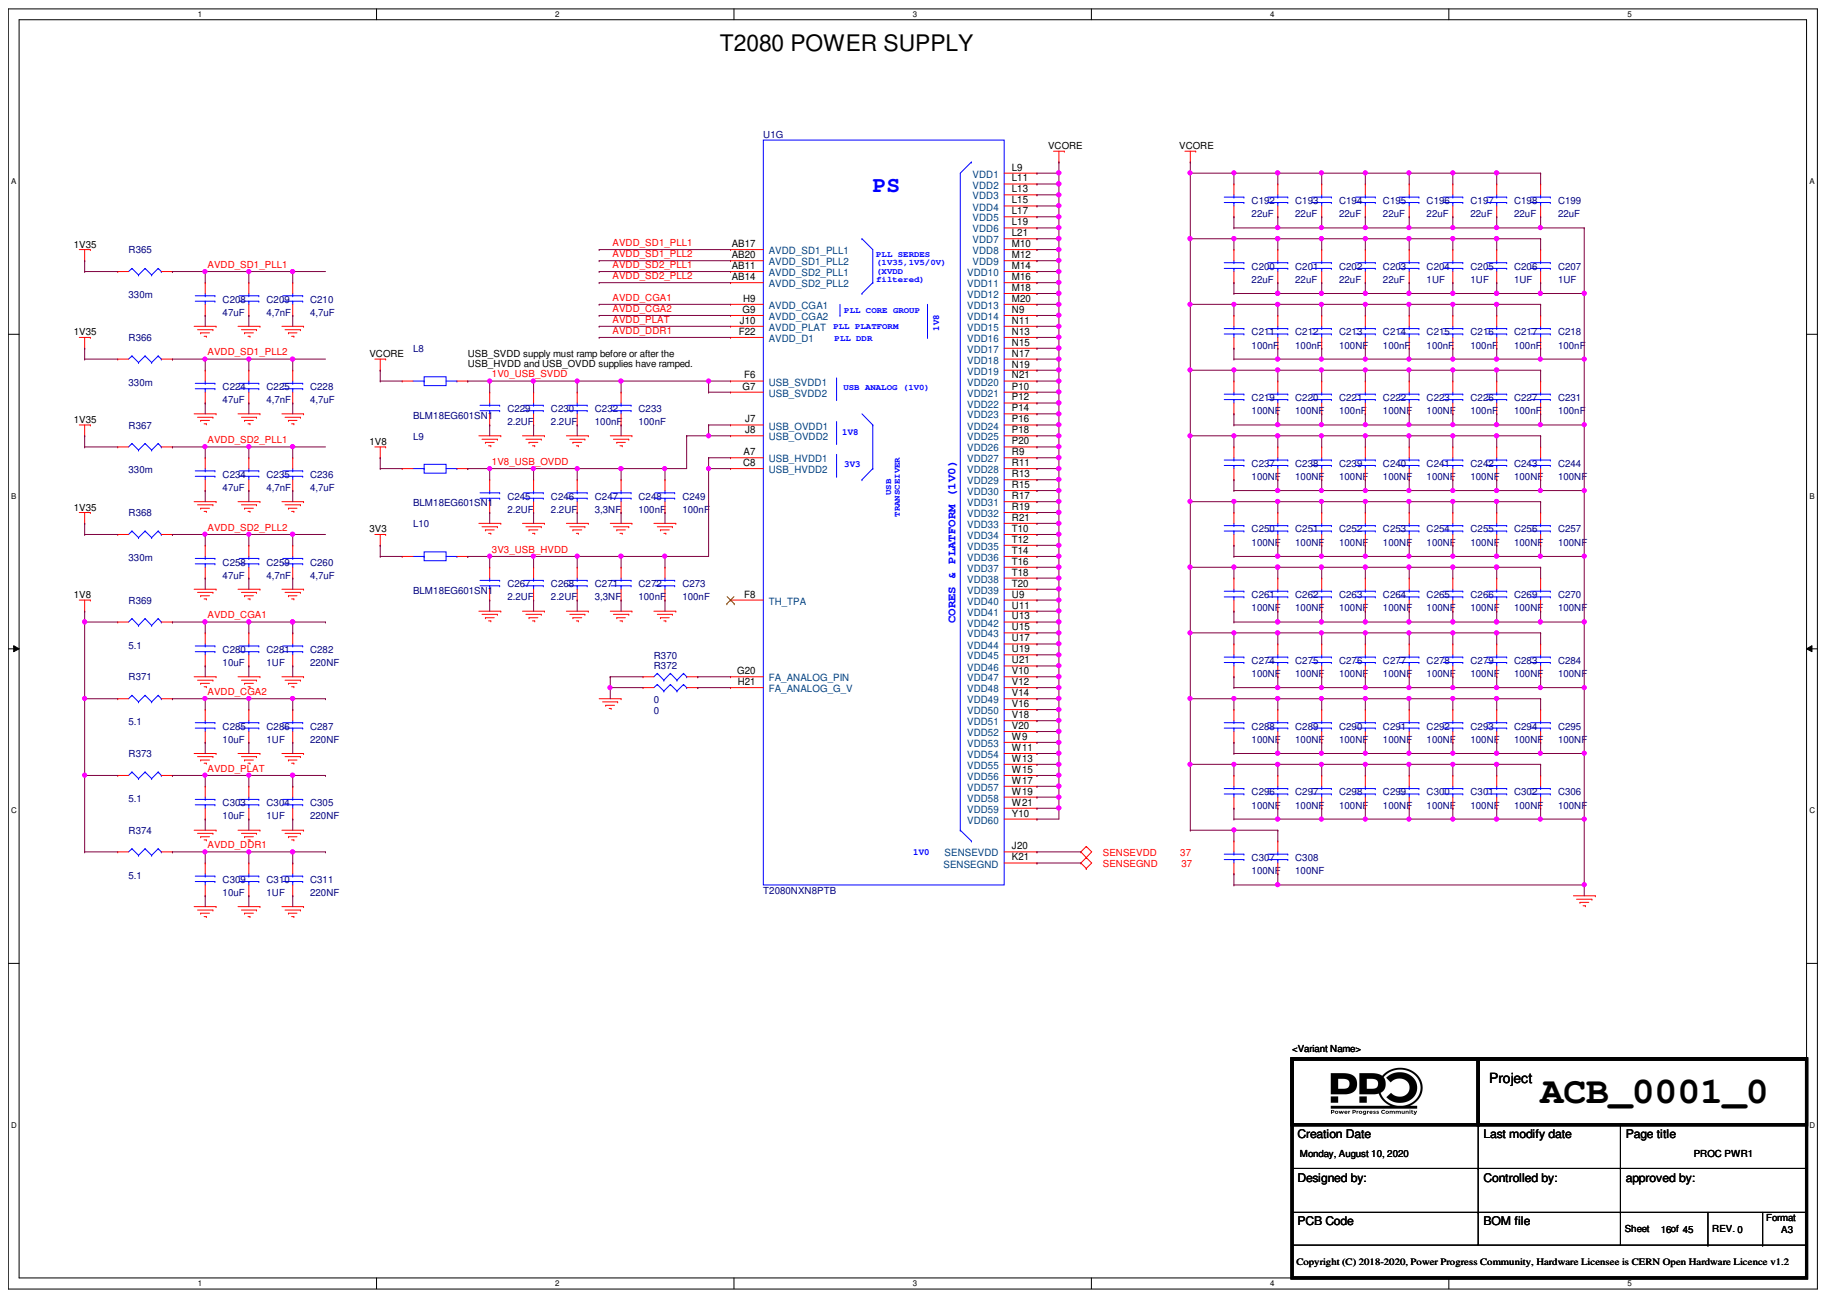
[picture p31: page 16]

USB_SVDD supply must ramp before or after the
USB_HVDD and USB_OVDD supplies have ramped.
1V0_USB_SVDD

# T2080 POWER SUPPLY (cont.)

PS

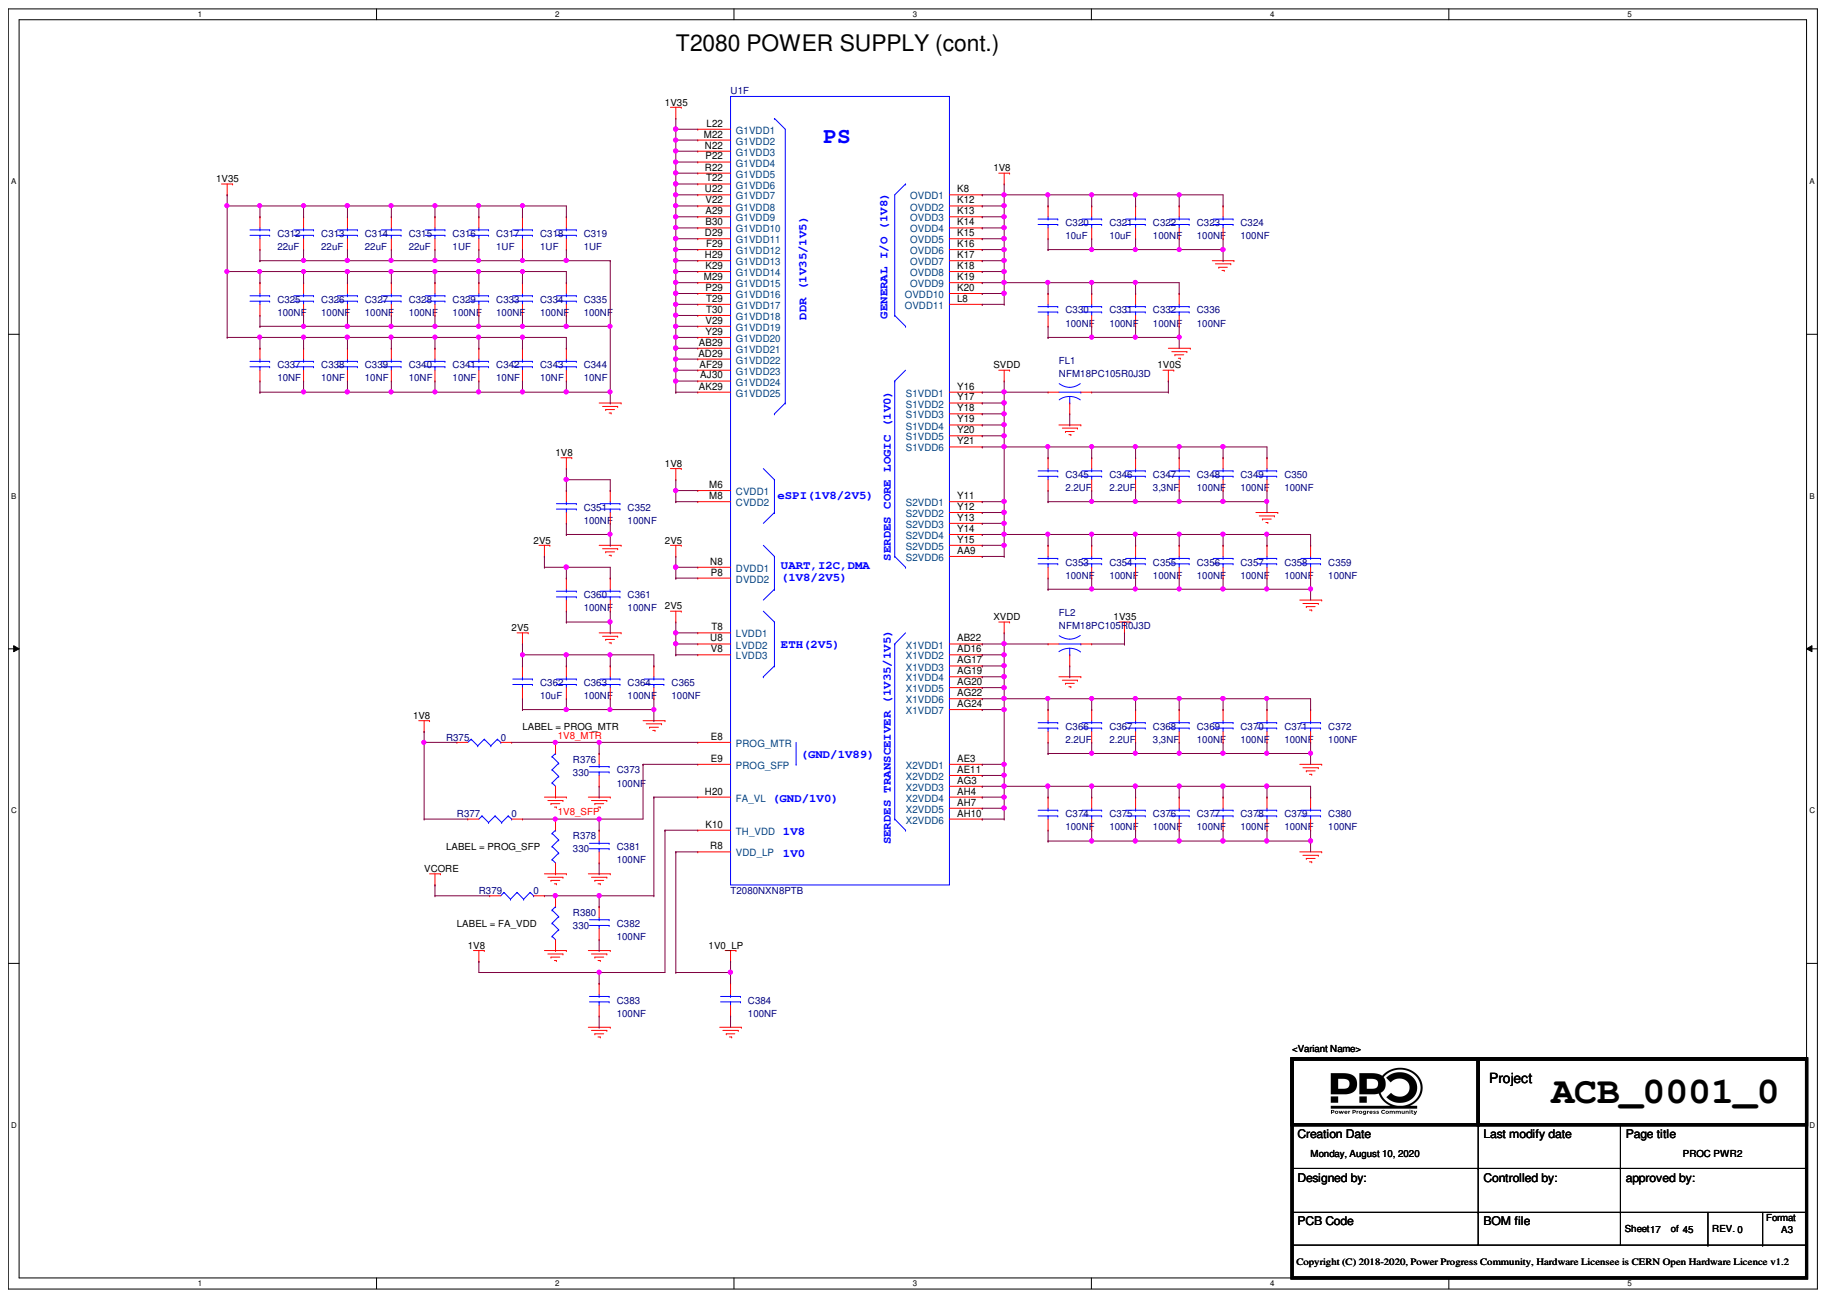
[picture p32: page 17]

GENERAL I/O (1V8) SERDES CORE LOGIC (1V0) SERDES TRANSCEIVER (1V35/1V5) (GND/1V89) (GND/1V0)

# T2080 GROUND

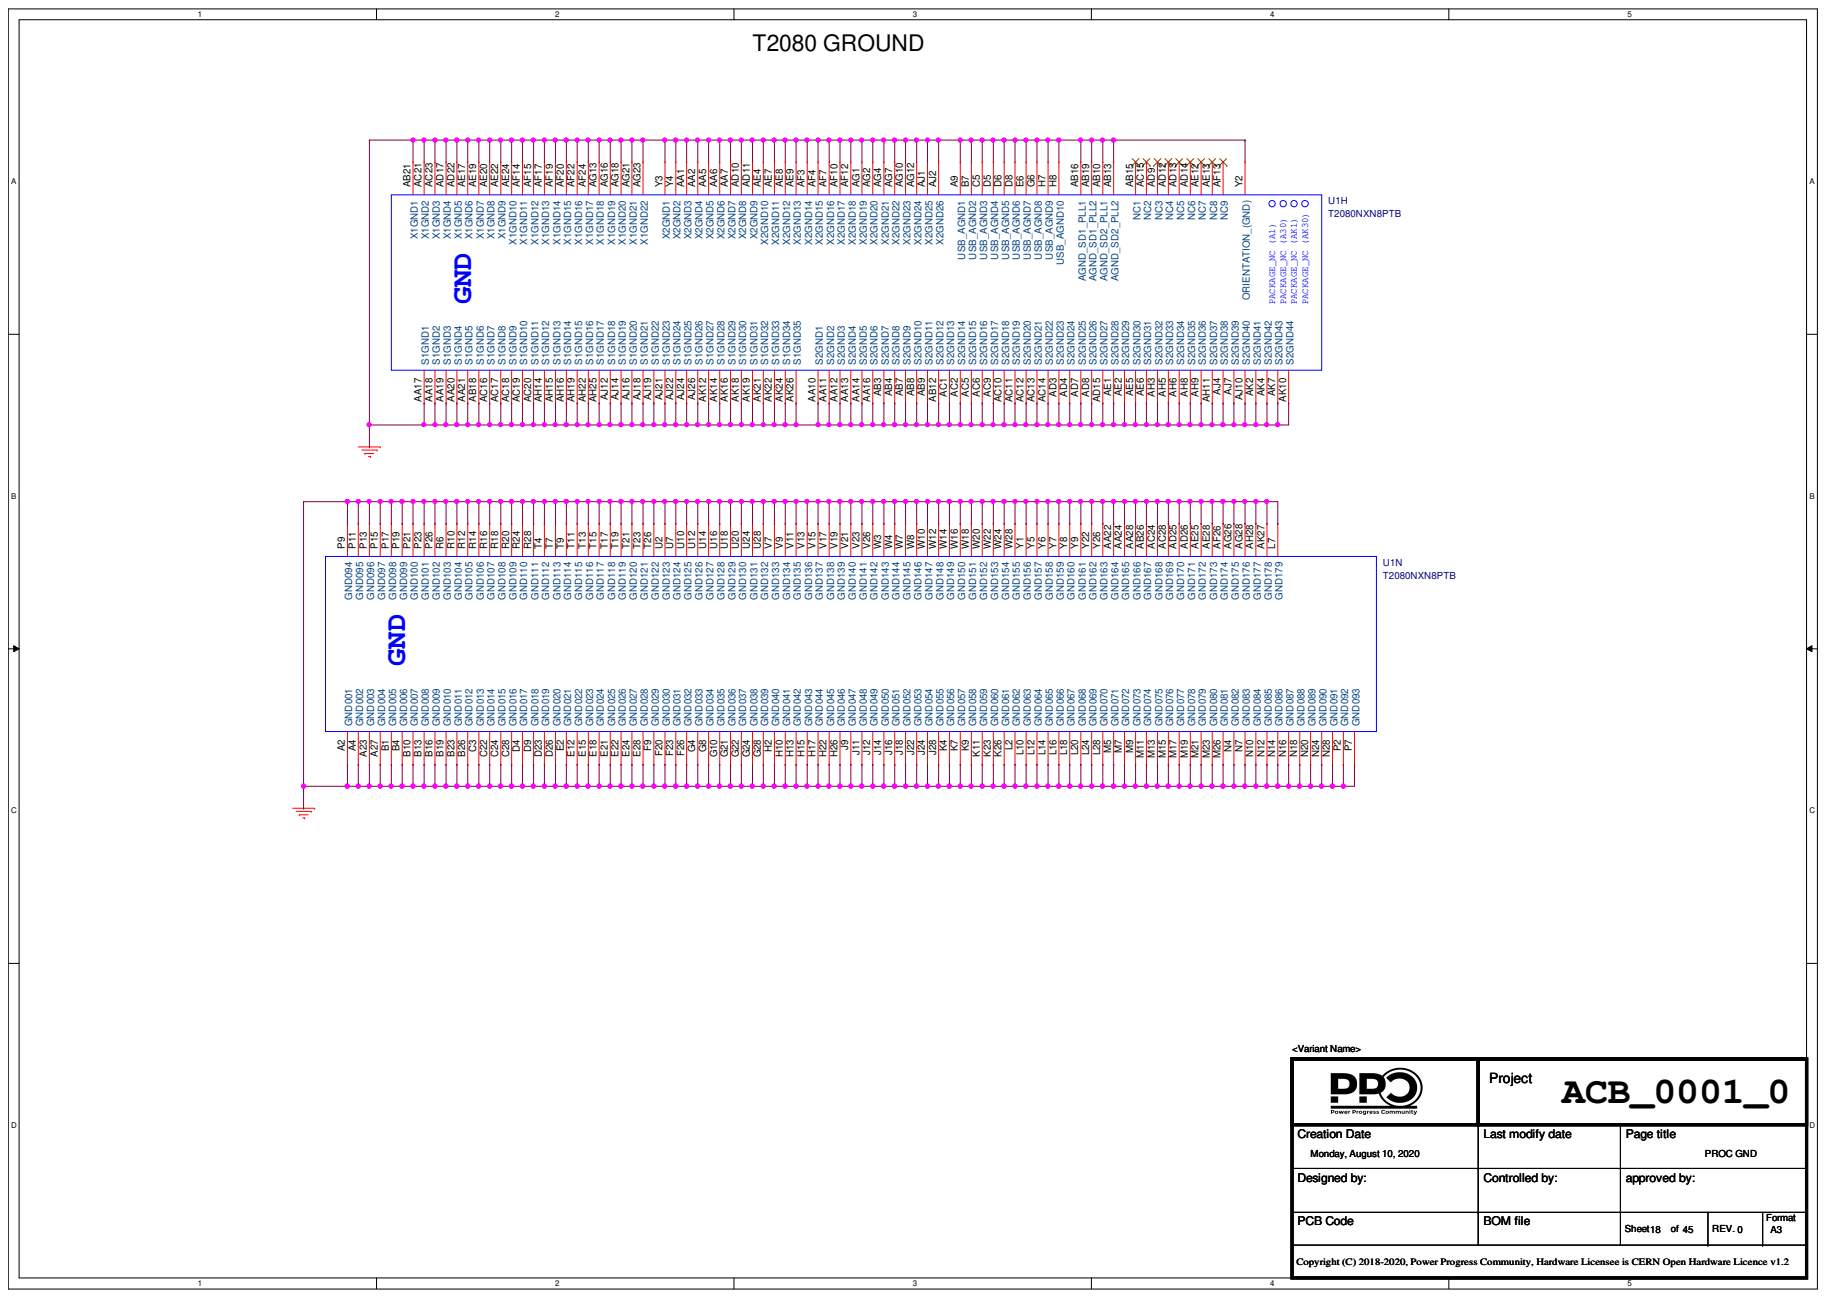
[picture p33: page 18]

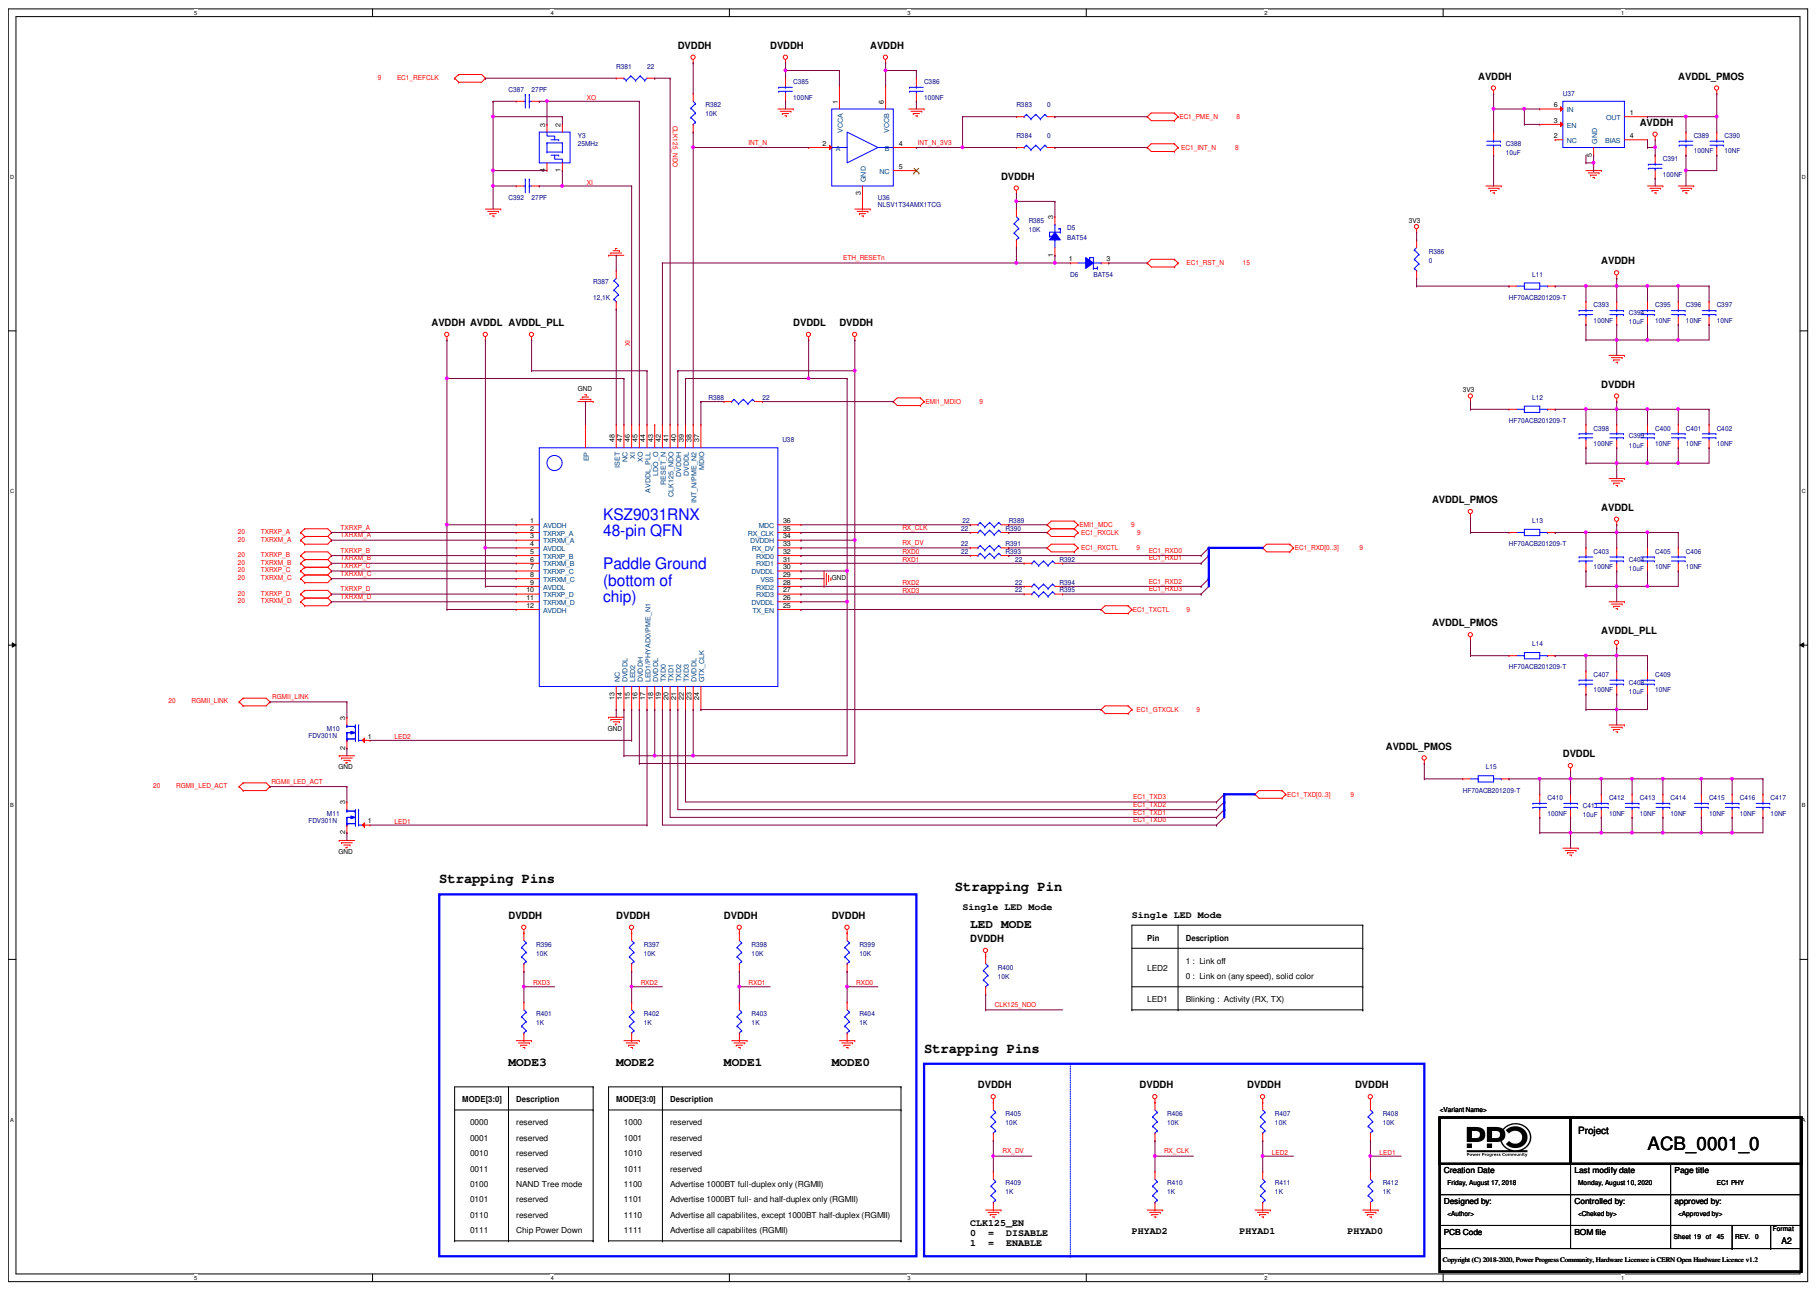
[picture p34: page 19]

Pin | Description

LED2 | 1 : Link off 0 : Link on (any speed), solid color

Blinking : Activity (RX, TX)

reserved
Advertise 1000BT full-duplex only (RGMII)
Advertise 1000BT full- and half-duplex only (RGMII)
Advertise all capabilites, except 1000BT half-duplex (RGMII)

D | D

# Gigabit Ethernet

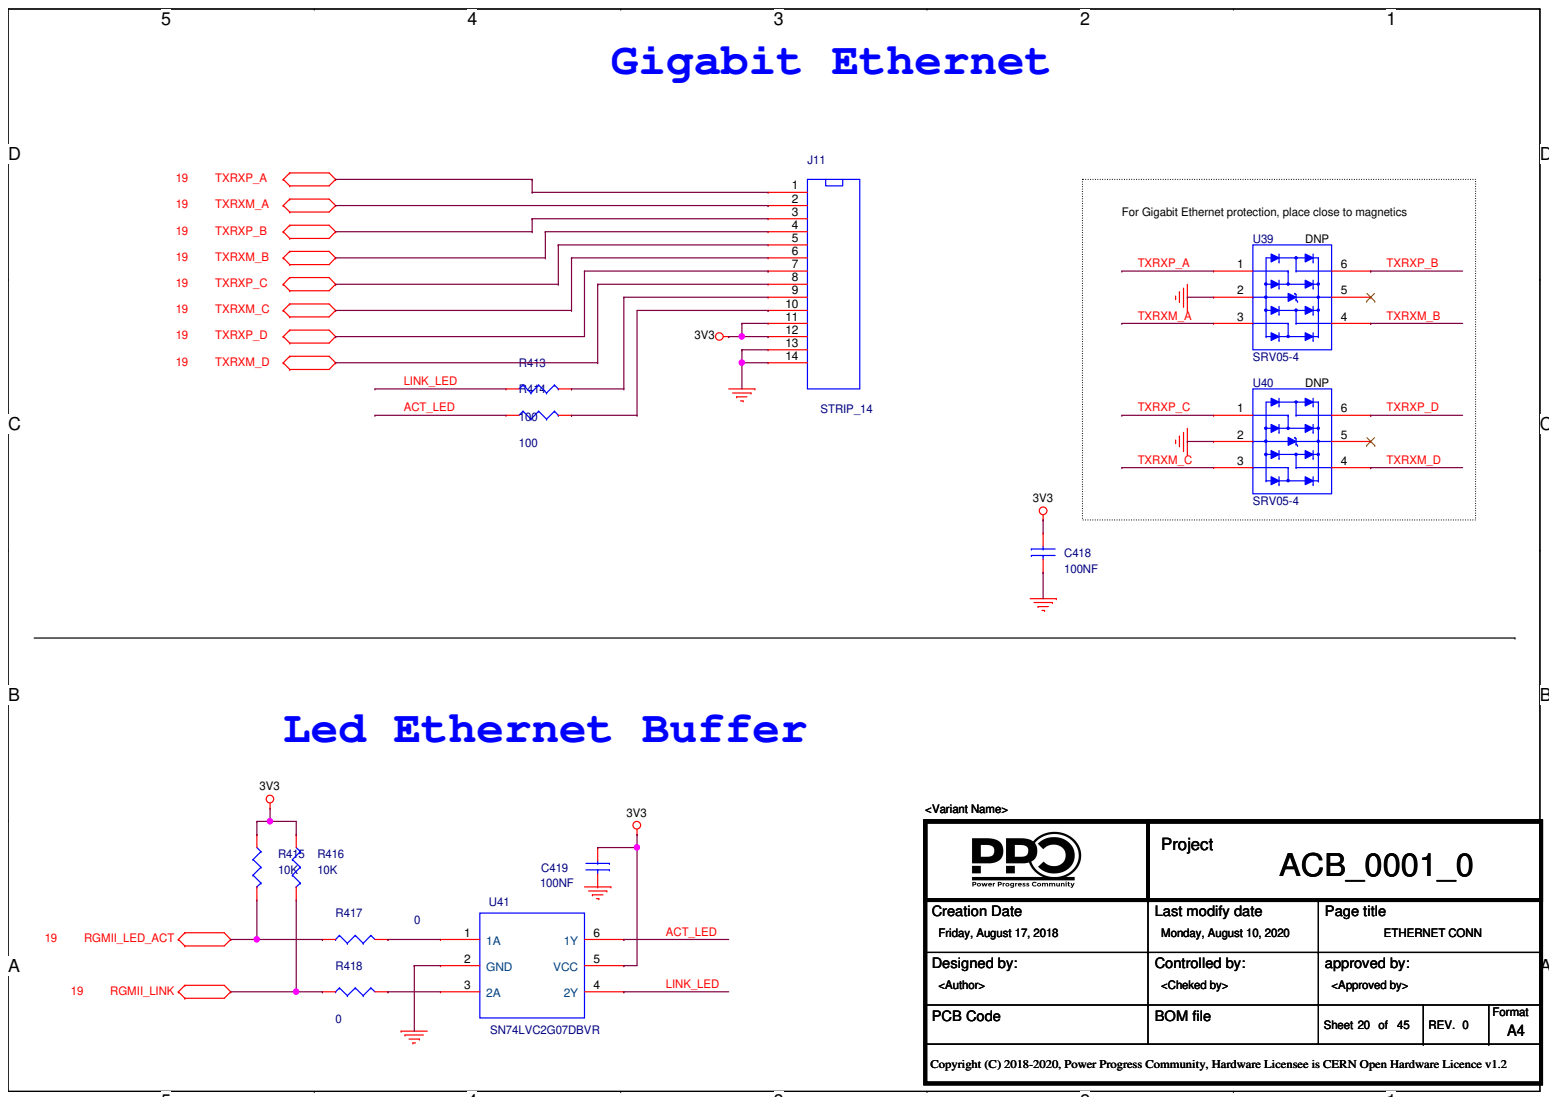
[picture p35: page 20]

For Gigabit Ethernet protection, place close to magnetics

# MagniPlus -SATA Interface

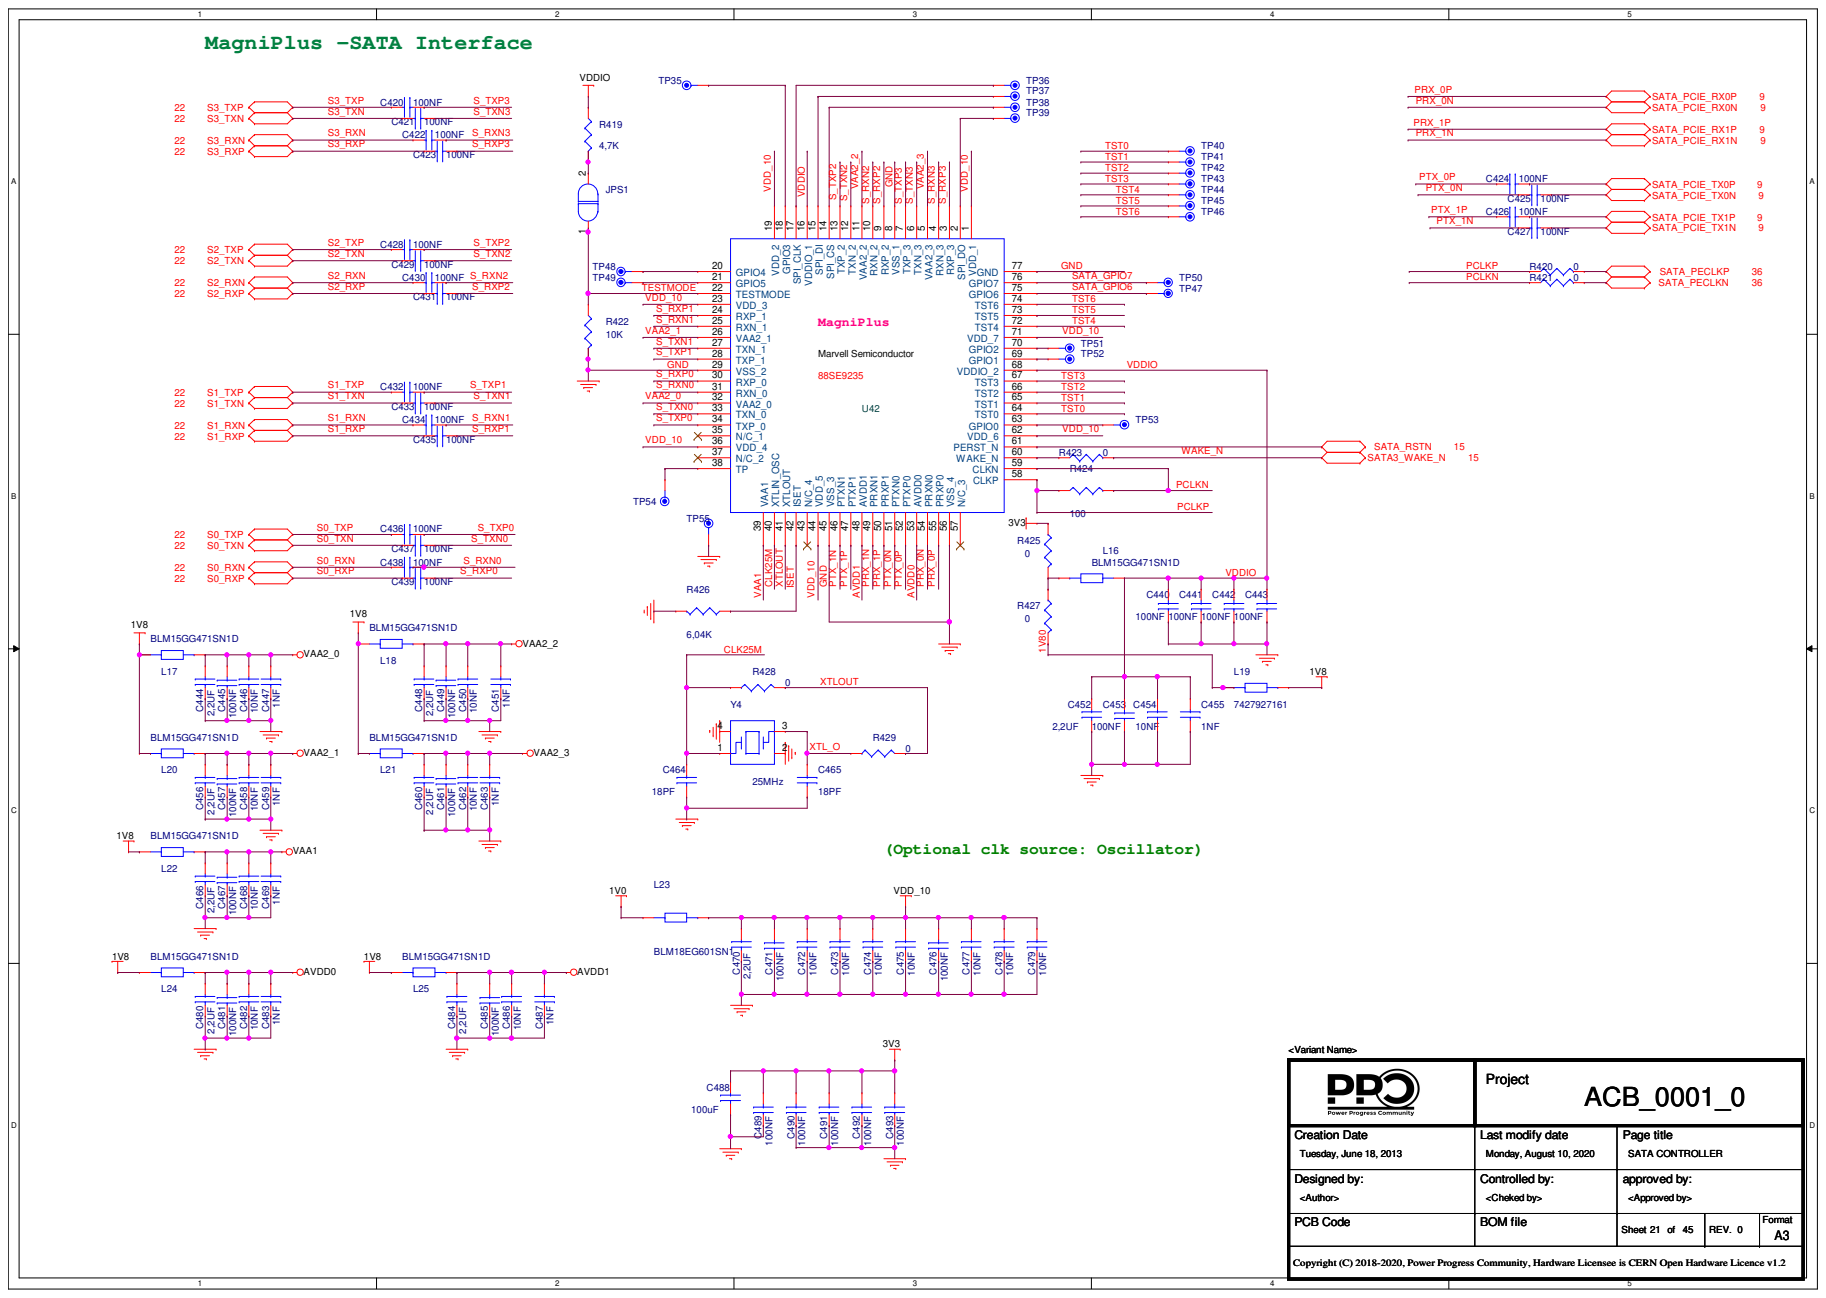
[picture p36: page 21]

(Optional clk source: Oscillator)

A | A

# HDD CONNECTOR

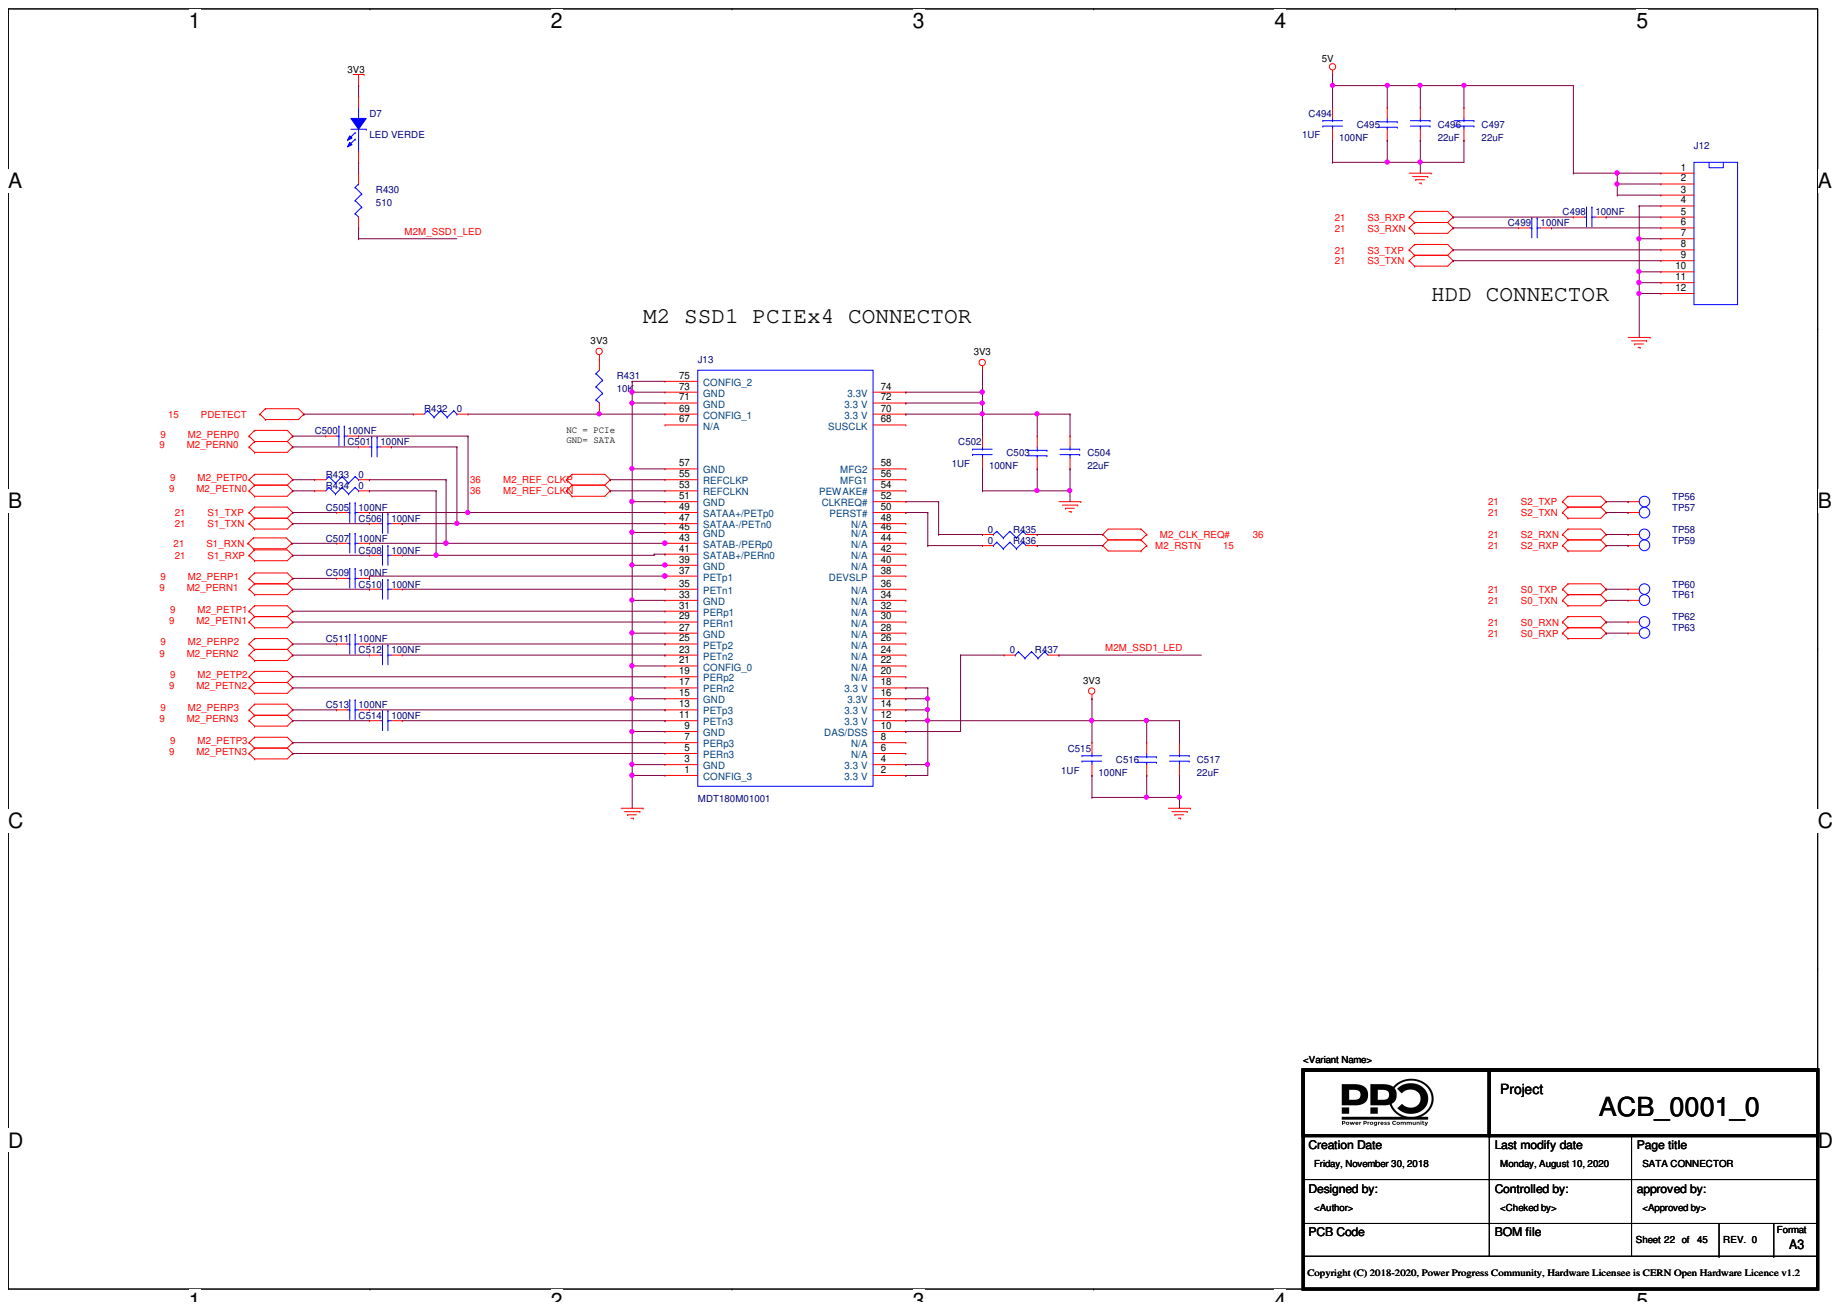
[picture p37: page 22]

### Power Regulator

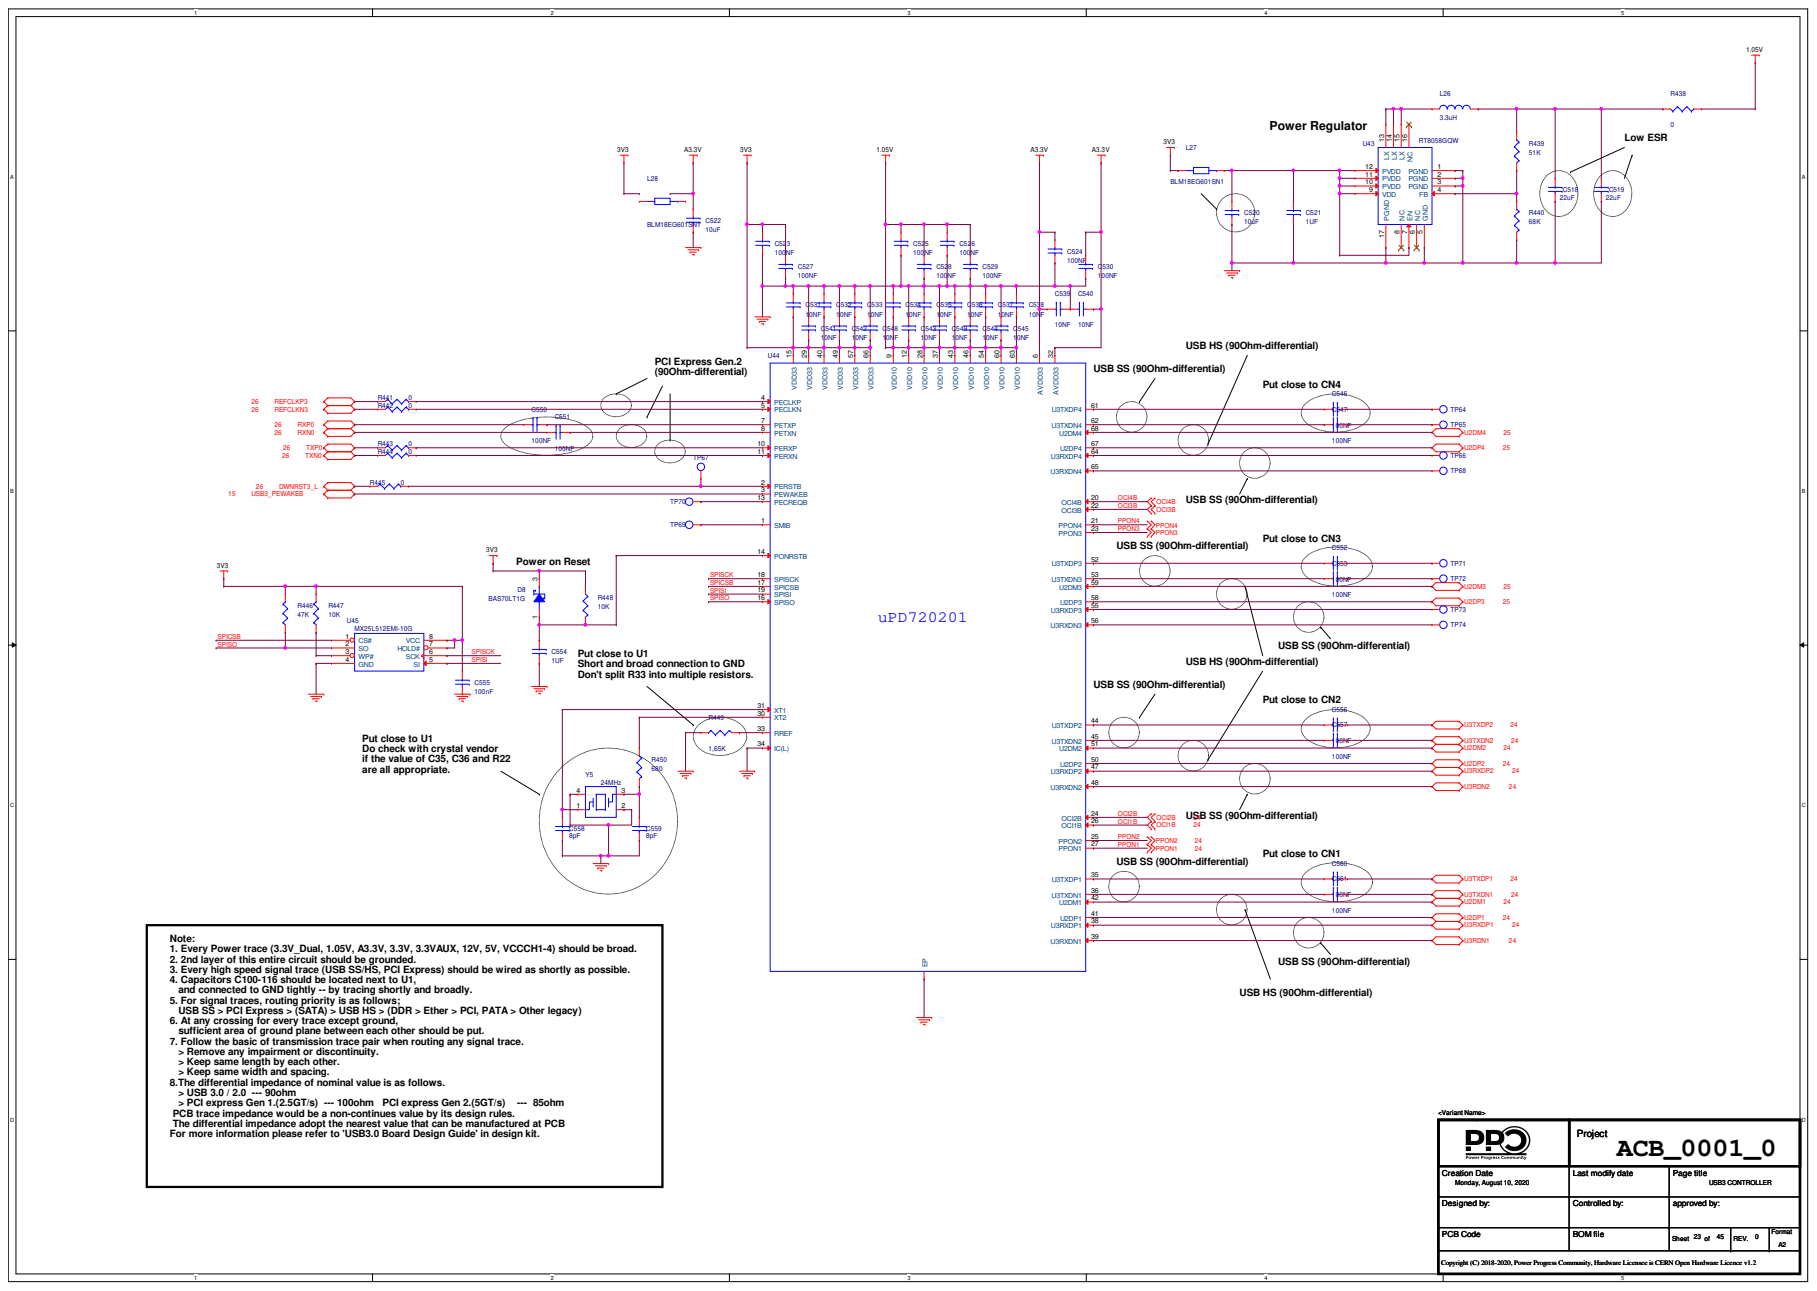
[picture p38: page 23]

Put close to U1
Short and broad connection to GND
Don't split R33 into multiple resistors.

Do check with crystal vendor
if the value of C35, C36 and R22
are all appropriate.

Note:
1. Every Power trace (3.3V_Dual, 1.05V, A3.3V, 3.3V, 3.3VAUX, 12V, 5V, VCCCH1-4) should be broad.
2. 2nd layer of this entire circuit should be grounded.
3. Every high speed signal trace (USB SS/HS, PCI Express) should be wired as shortly as possible.
4. Capacitors C100-116 should be located next to U1,
and connected to GND tightly -- by tracing shortly and broadly.
5. For signal traces, routing priority is as follows;
USB SS > PCI Express > (SATA) > USB HS > (DDR > Ether > PCI, PATA > Other legacy)
6. At any crossing for every trace except ground,
sufficient area of ground plane between each other should be put.
7. Follow the basic of transmission trace pair when routing any signal trace.
> Remove any impairment or discontinuity.
> Keep same length by each other.
> Keep same width and spacing.
8.The differential impedance of nominal value is as follows.
> USB 3.0 / 2.0 --- 90ohm
PCB trace impedance would be a non-continues value by its design rules.
The differential impedance adopt the nearest value that can be manufactured at PCB
For more information please refer to 'USB3.0 Board Design Guide' in design kit.

# SS/CL

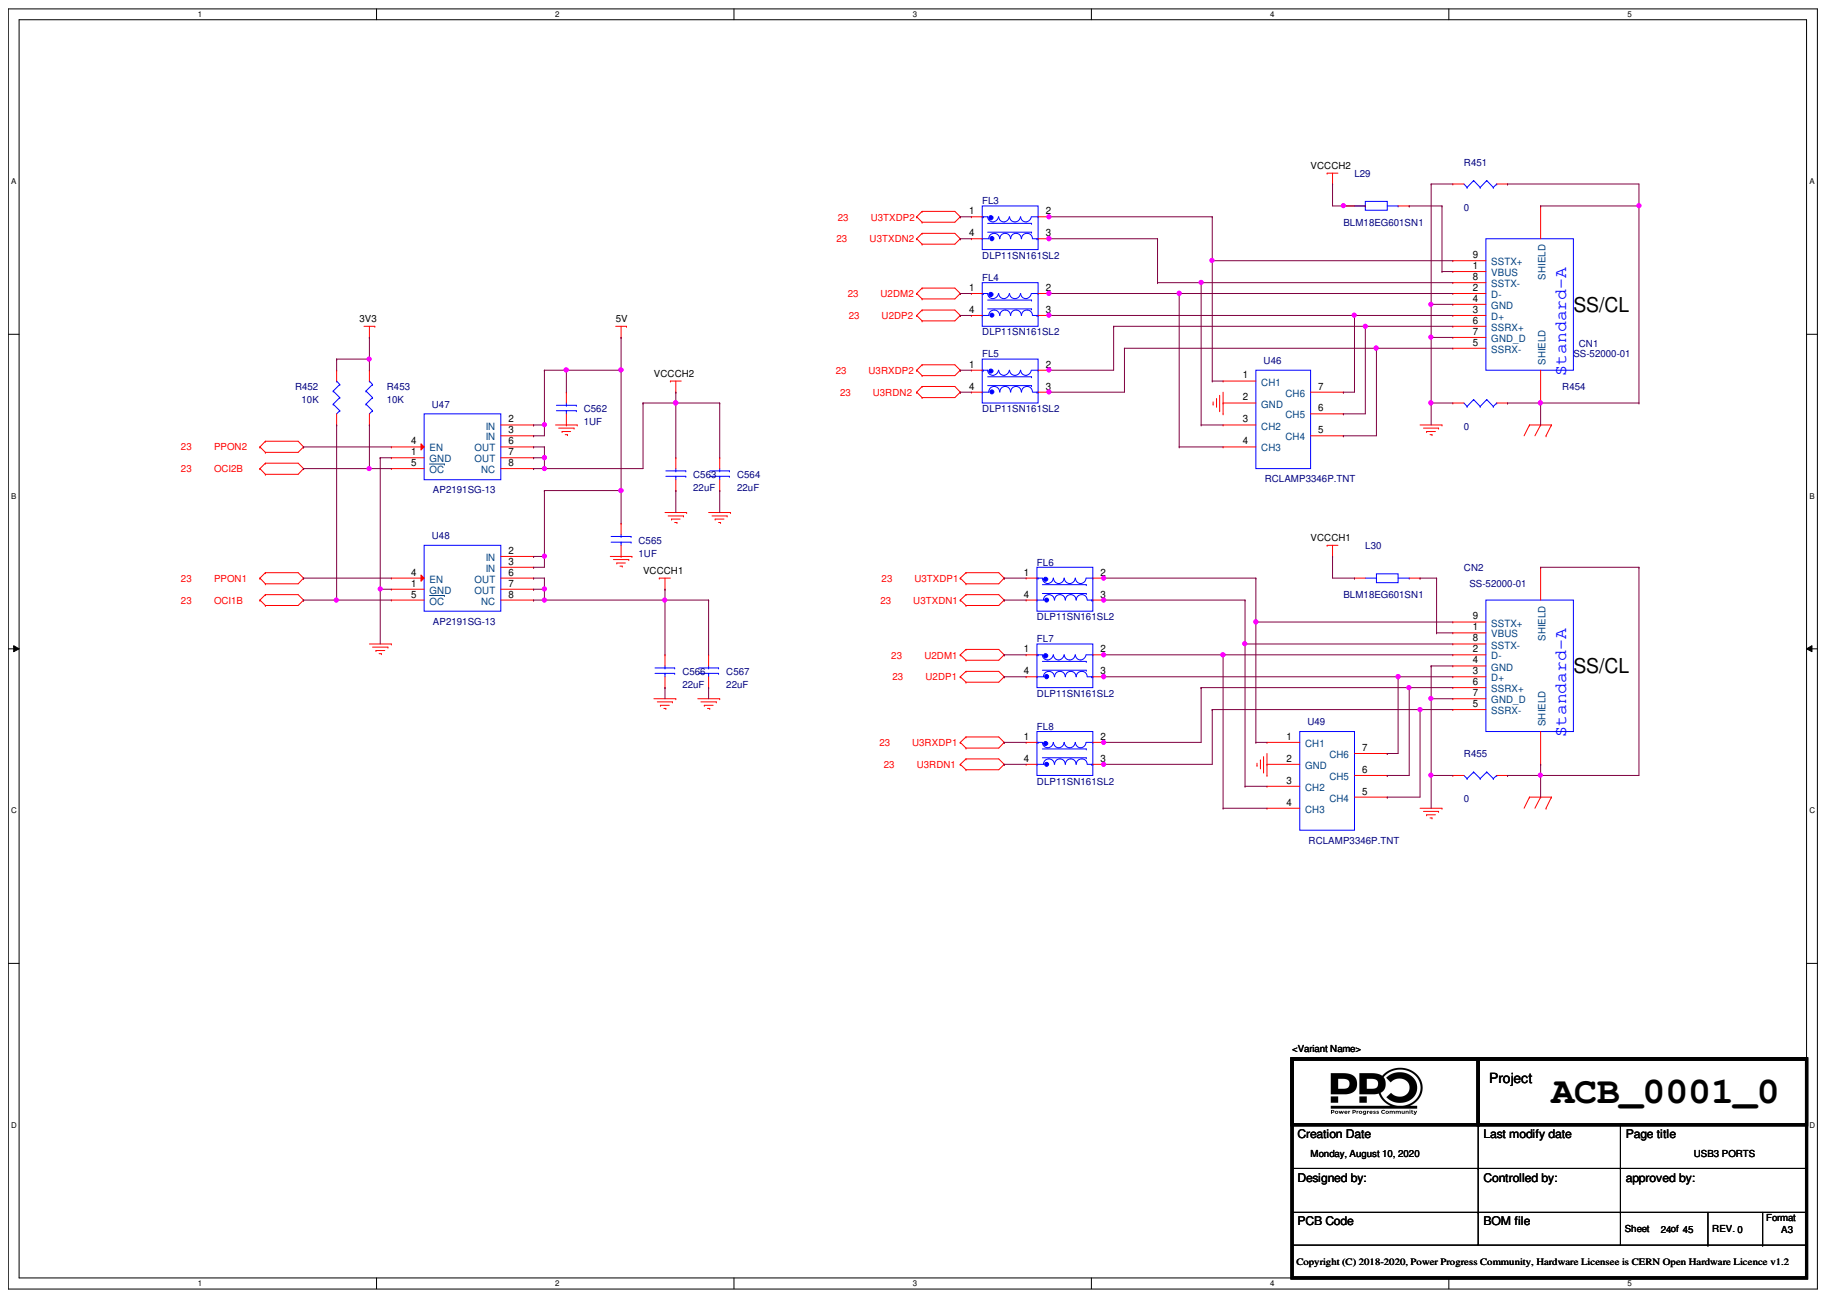
[picture p39: page 24]

Standard-A CN1 SS-52000-01 VBUS 1 D- 2 D+ 3 GND_D 7 SSRX- 5 SSRX+ 6 GND 4 SSTX- 8 SSTX+ 9

3V3

## 23 U2DM4

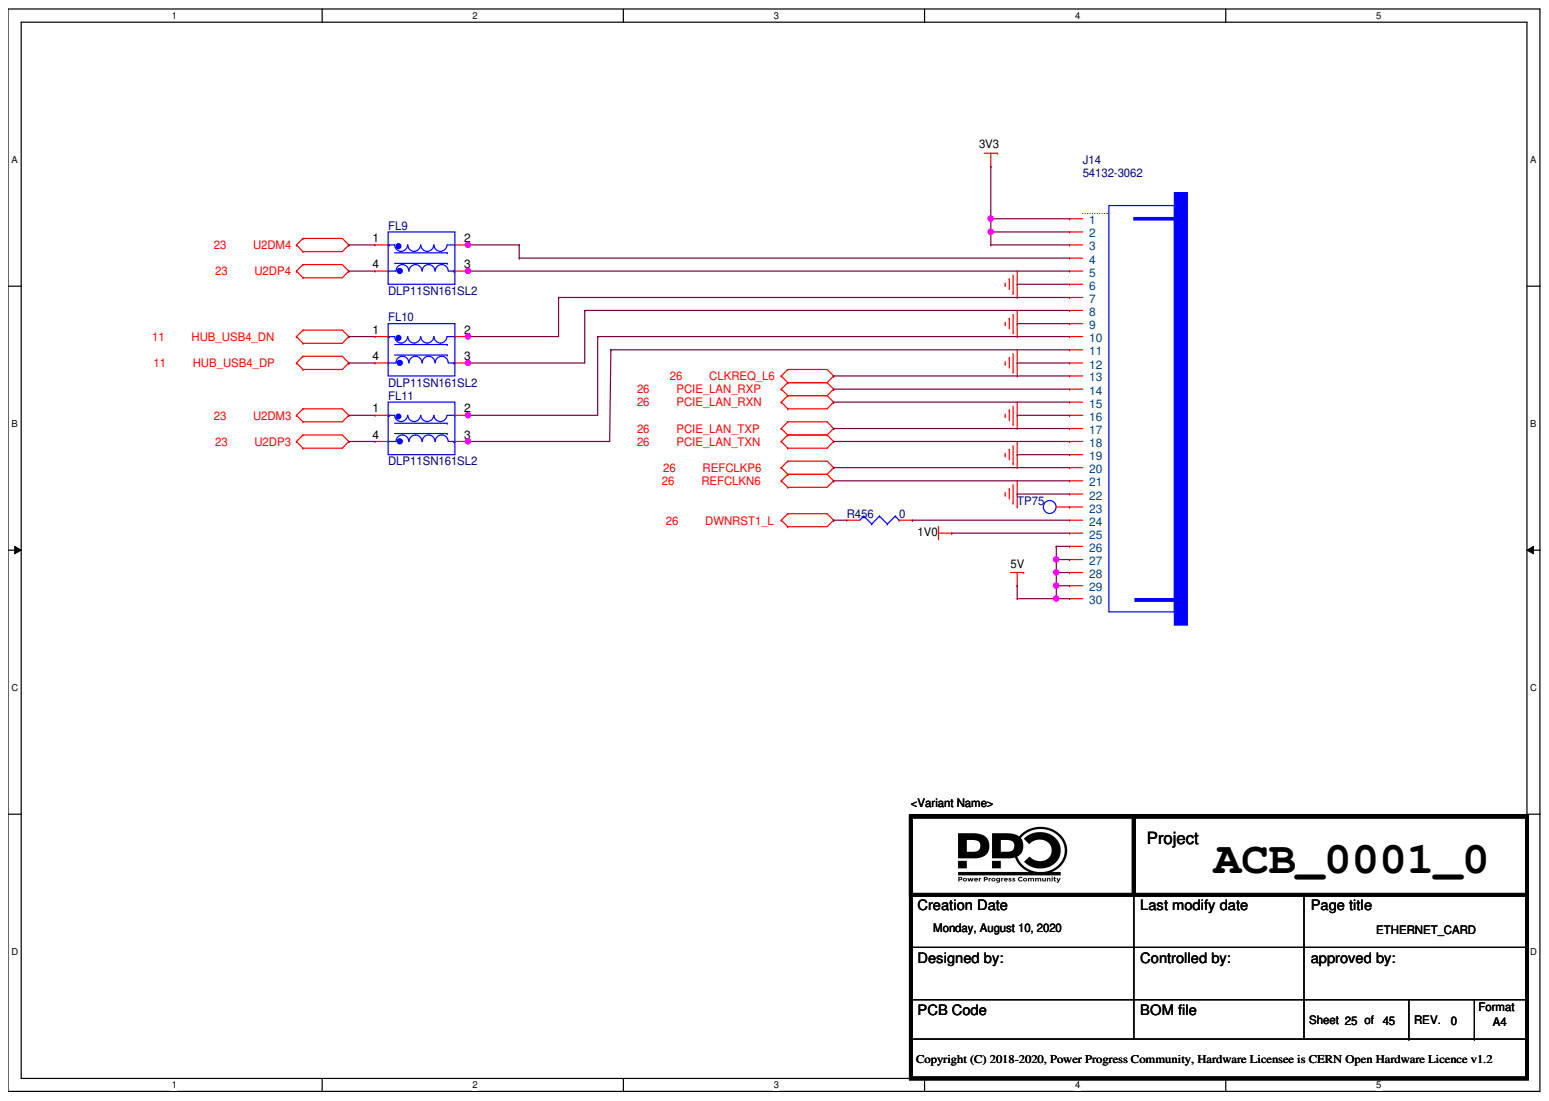
[picture p40: page 25]
ACB_0001_0; PCIE_LAN_RXP; PCIE_LAN_RXN; PCIE_LAN_TXP; PCIE_LAN_TXN; REFCLKN6; REFCLKP6; CLKREQ_L6; DWNRST1_L; HUB_USB4_DN; HUB_USB4_DP; Project; Creation Date; Last modify date; Designed by:; Controlled by:; approved by:; PCB Code; BOM file; Sheet; REV.; Format; Page title; ETHERNET_CARD; Monday, August 10, 2020; <Variant Name>; DLP11SN161SL2

### DOWN_STREAM_PORT

### Port1: lane4-7

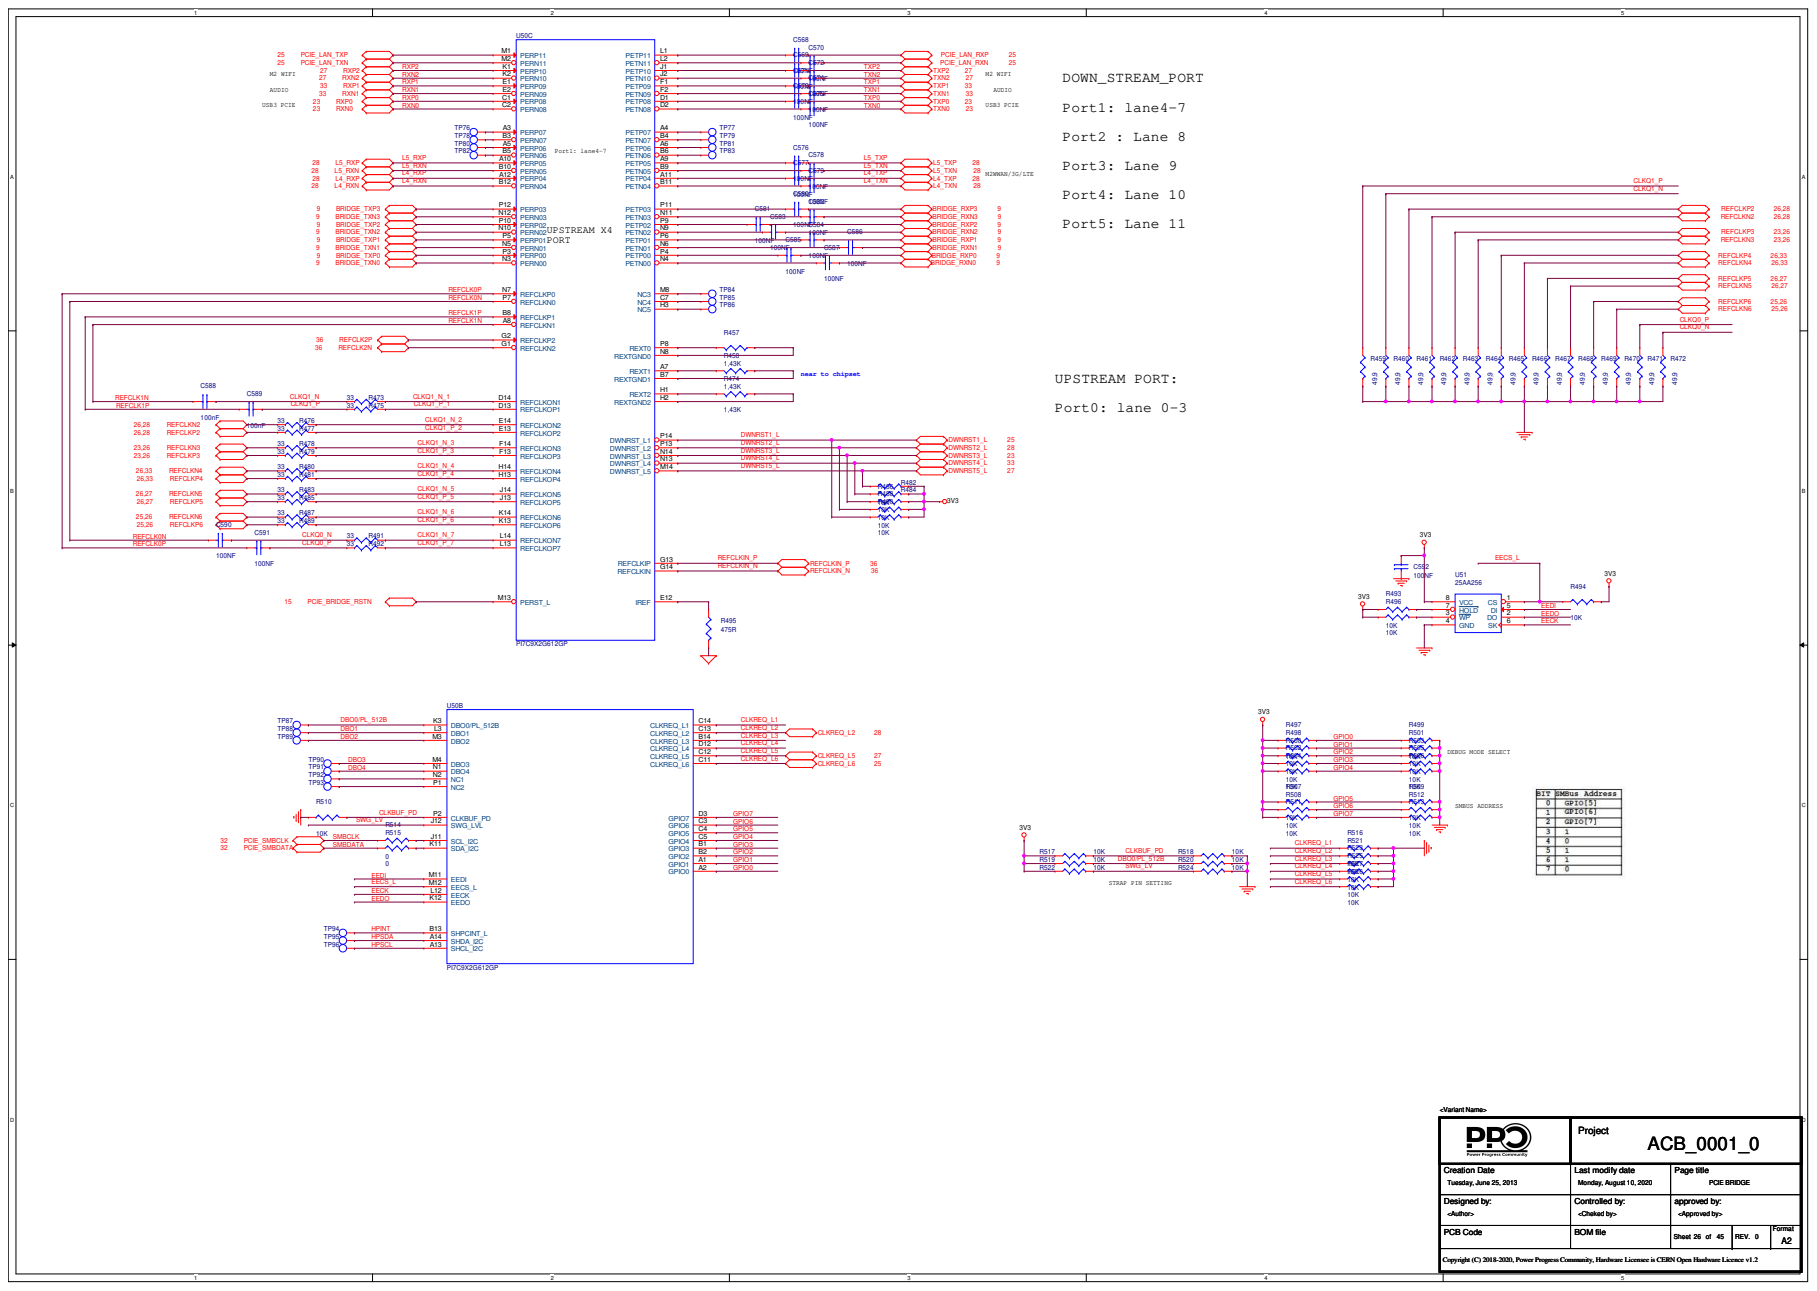
[picture p41: page 26]

A | A

# M2 WLAN+BT PCIEx1 CONNECTOR

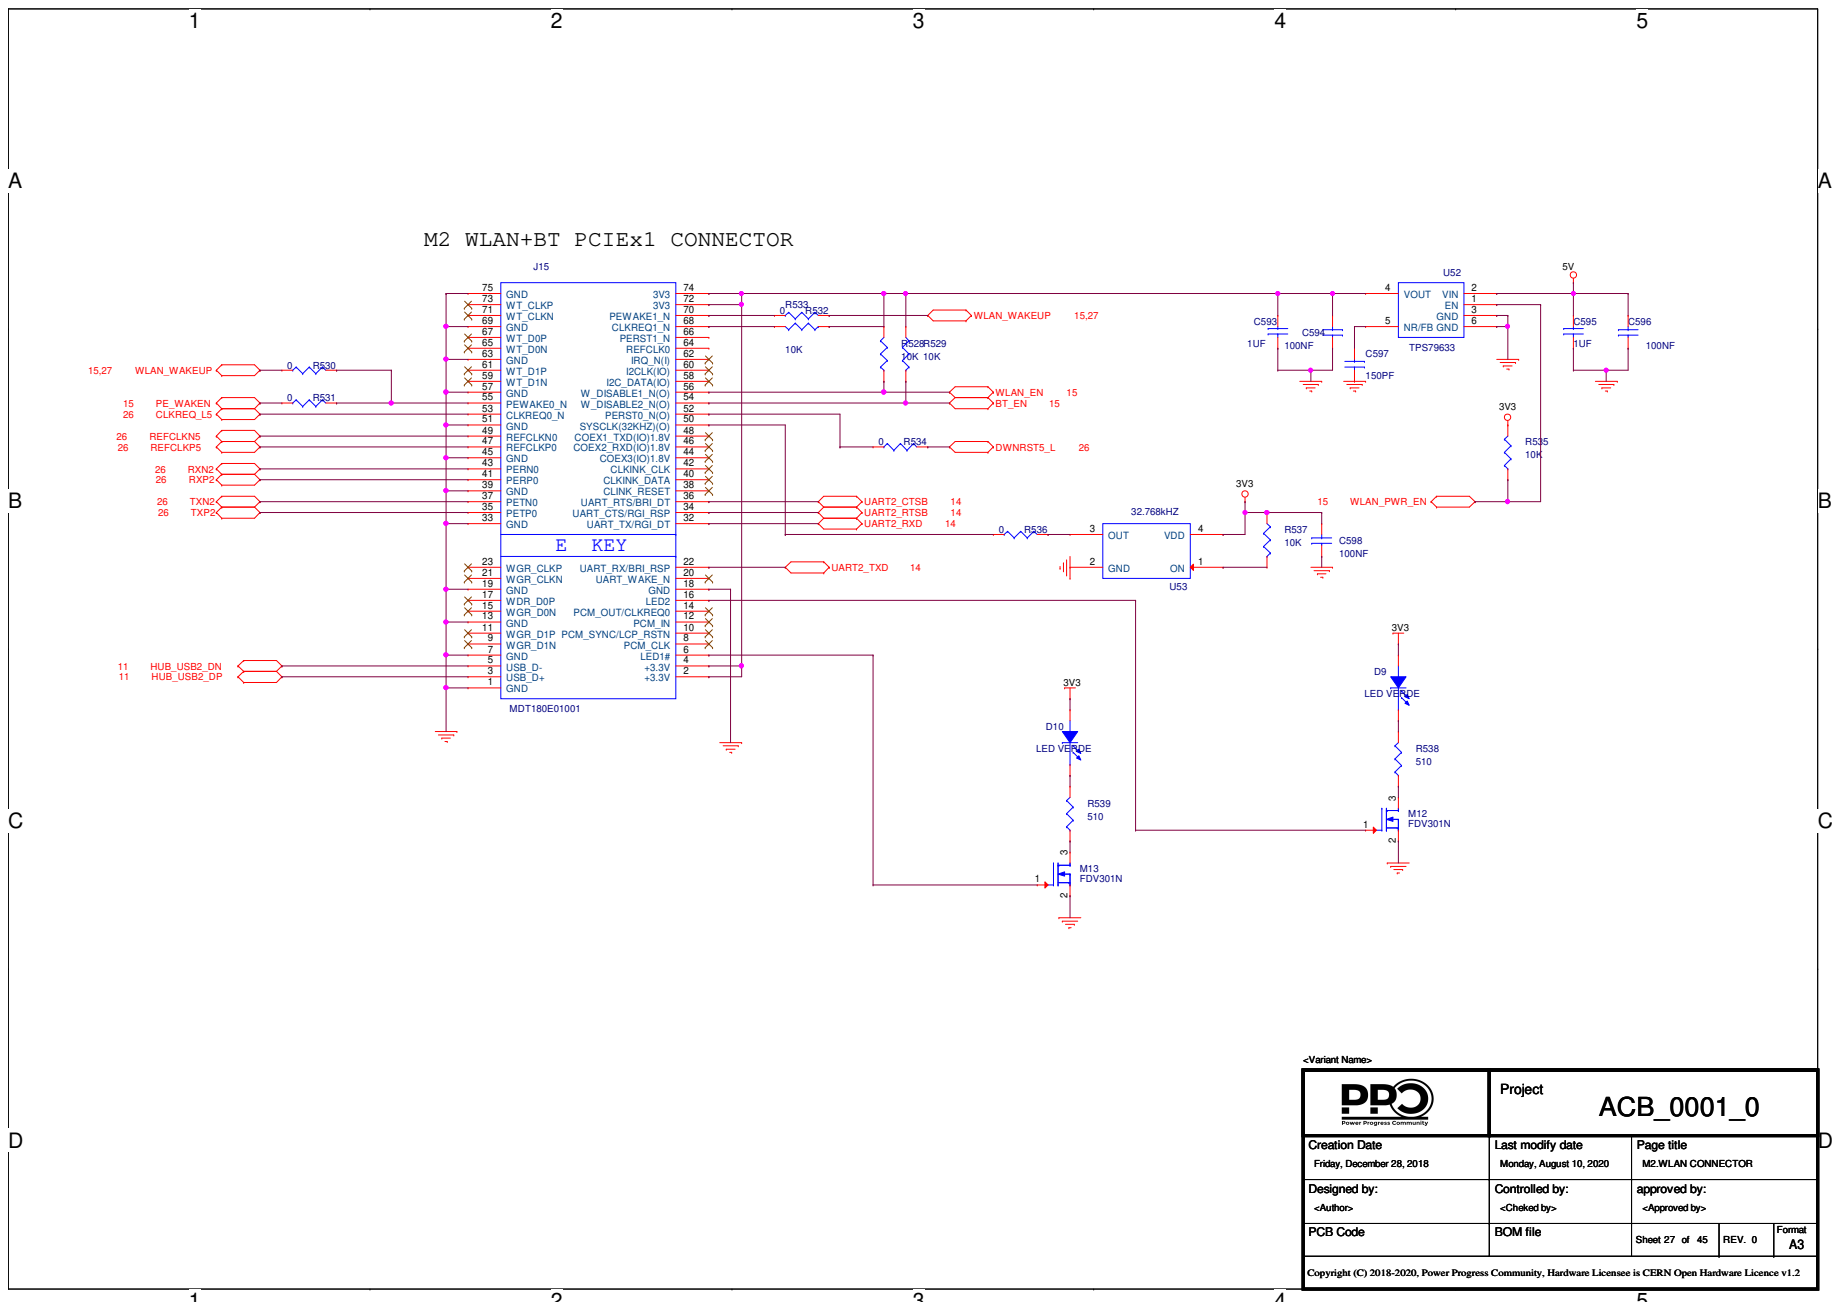
[picture p42: page 27]

A | A

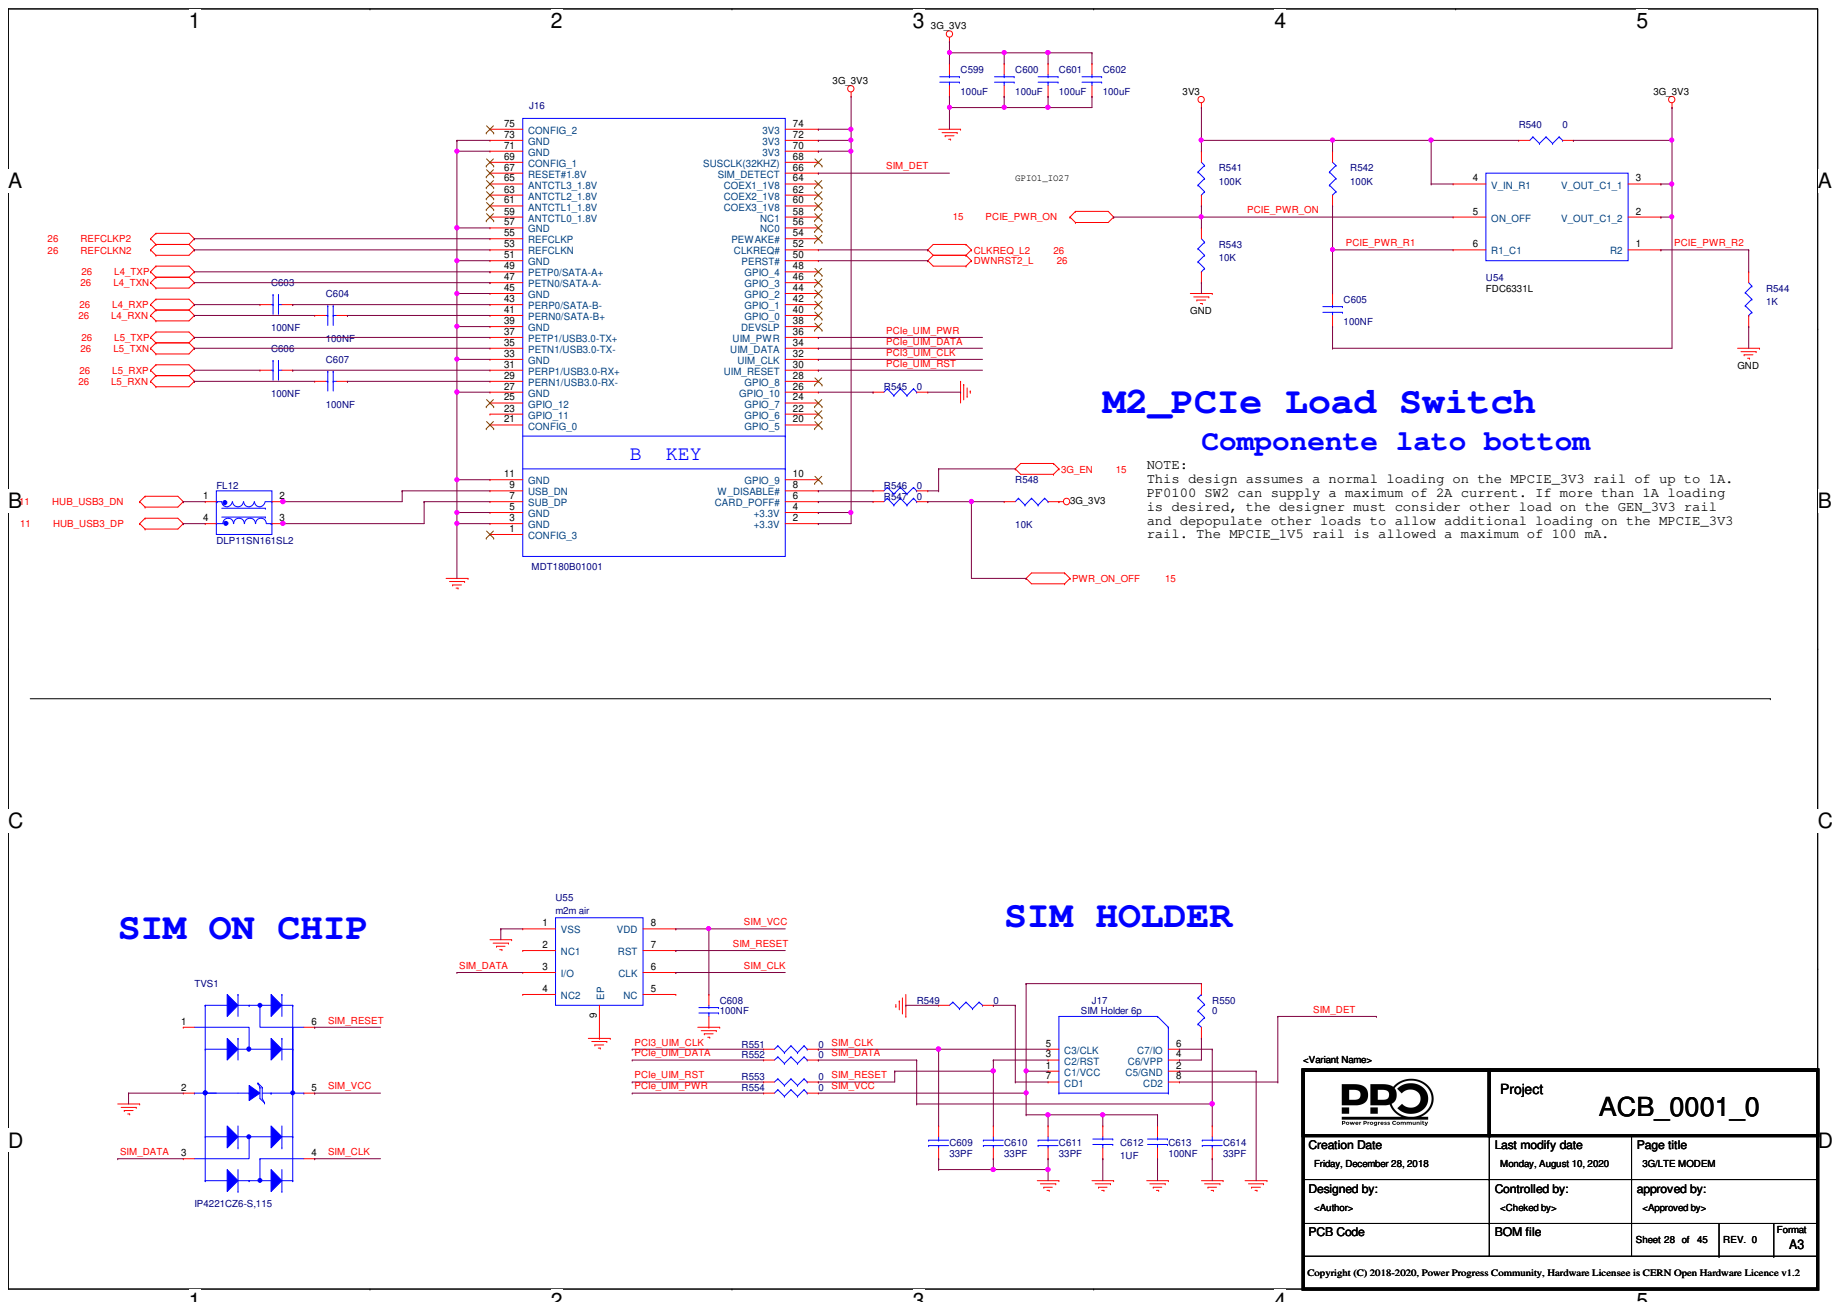
[picture p43: page 28]

NOTE:
This design assumes a normal loading on the MPCIE_3V3 rail of up to 1A.
PF0100 SW2 can supply a maximum of 2A current. If more than 1A loading
is desired, the designer must consider other load on the GEN_3V3 rail
and depopulate other loads to allow additional loading on the MPCIE_3V3
rail. The MPCIE_1V5 rail is allowed a maximum of 100 mA.

# 1.0V Decoupling Capacitors

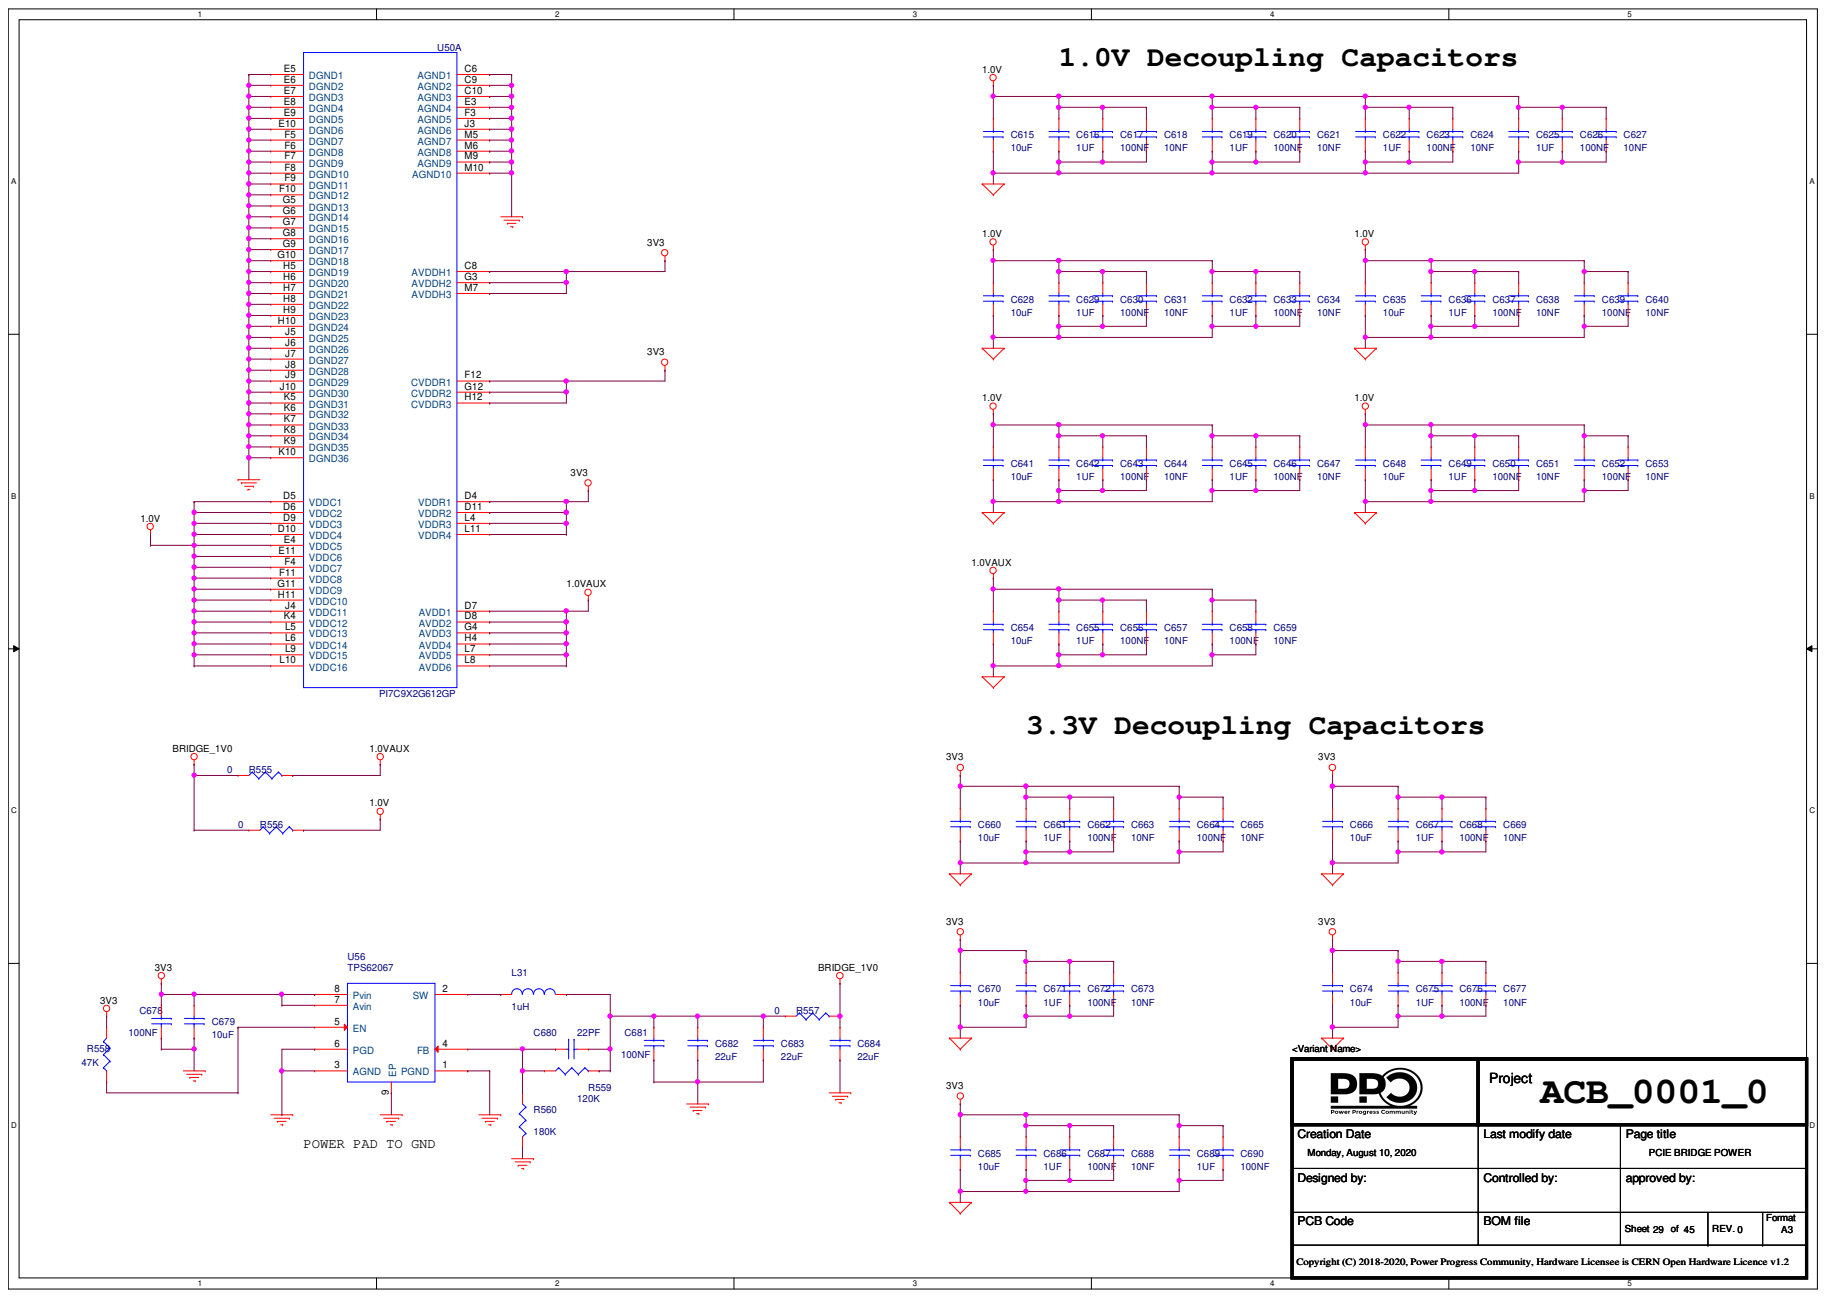
[picture p44: page 29]

POWER PAD TO GND

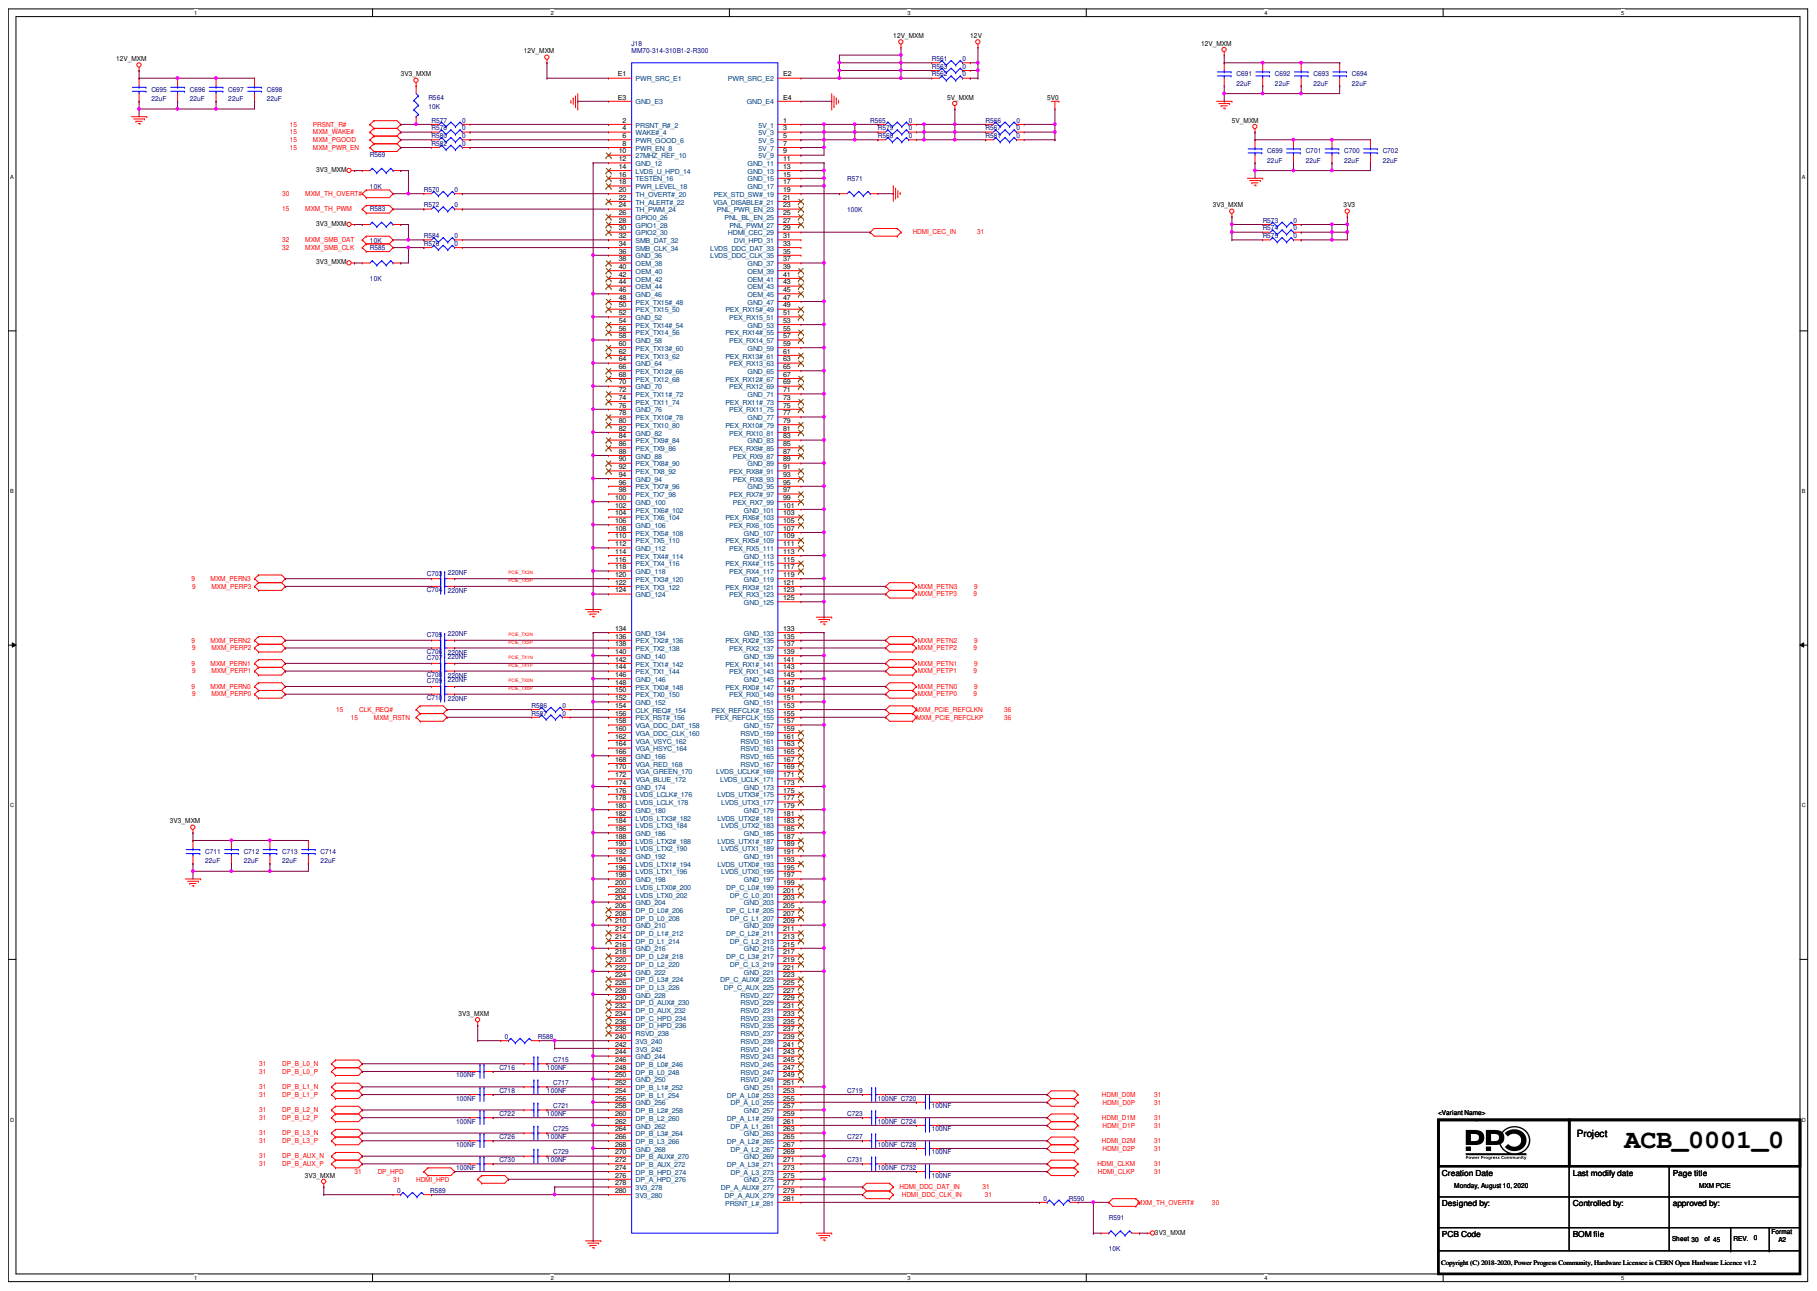
[picture p45: page 30]

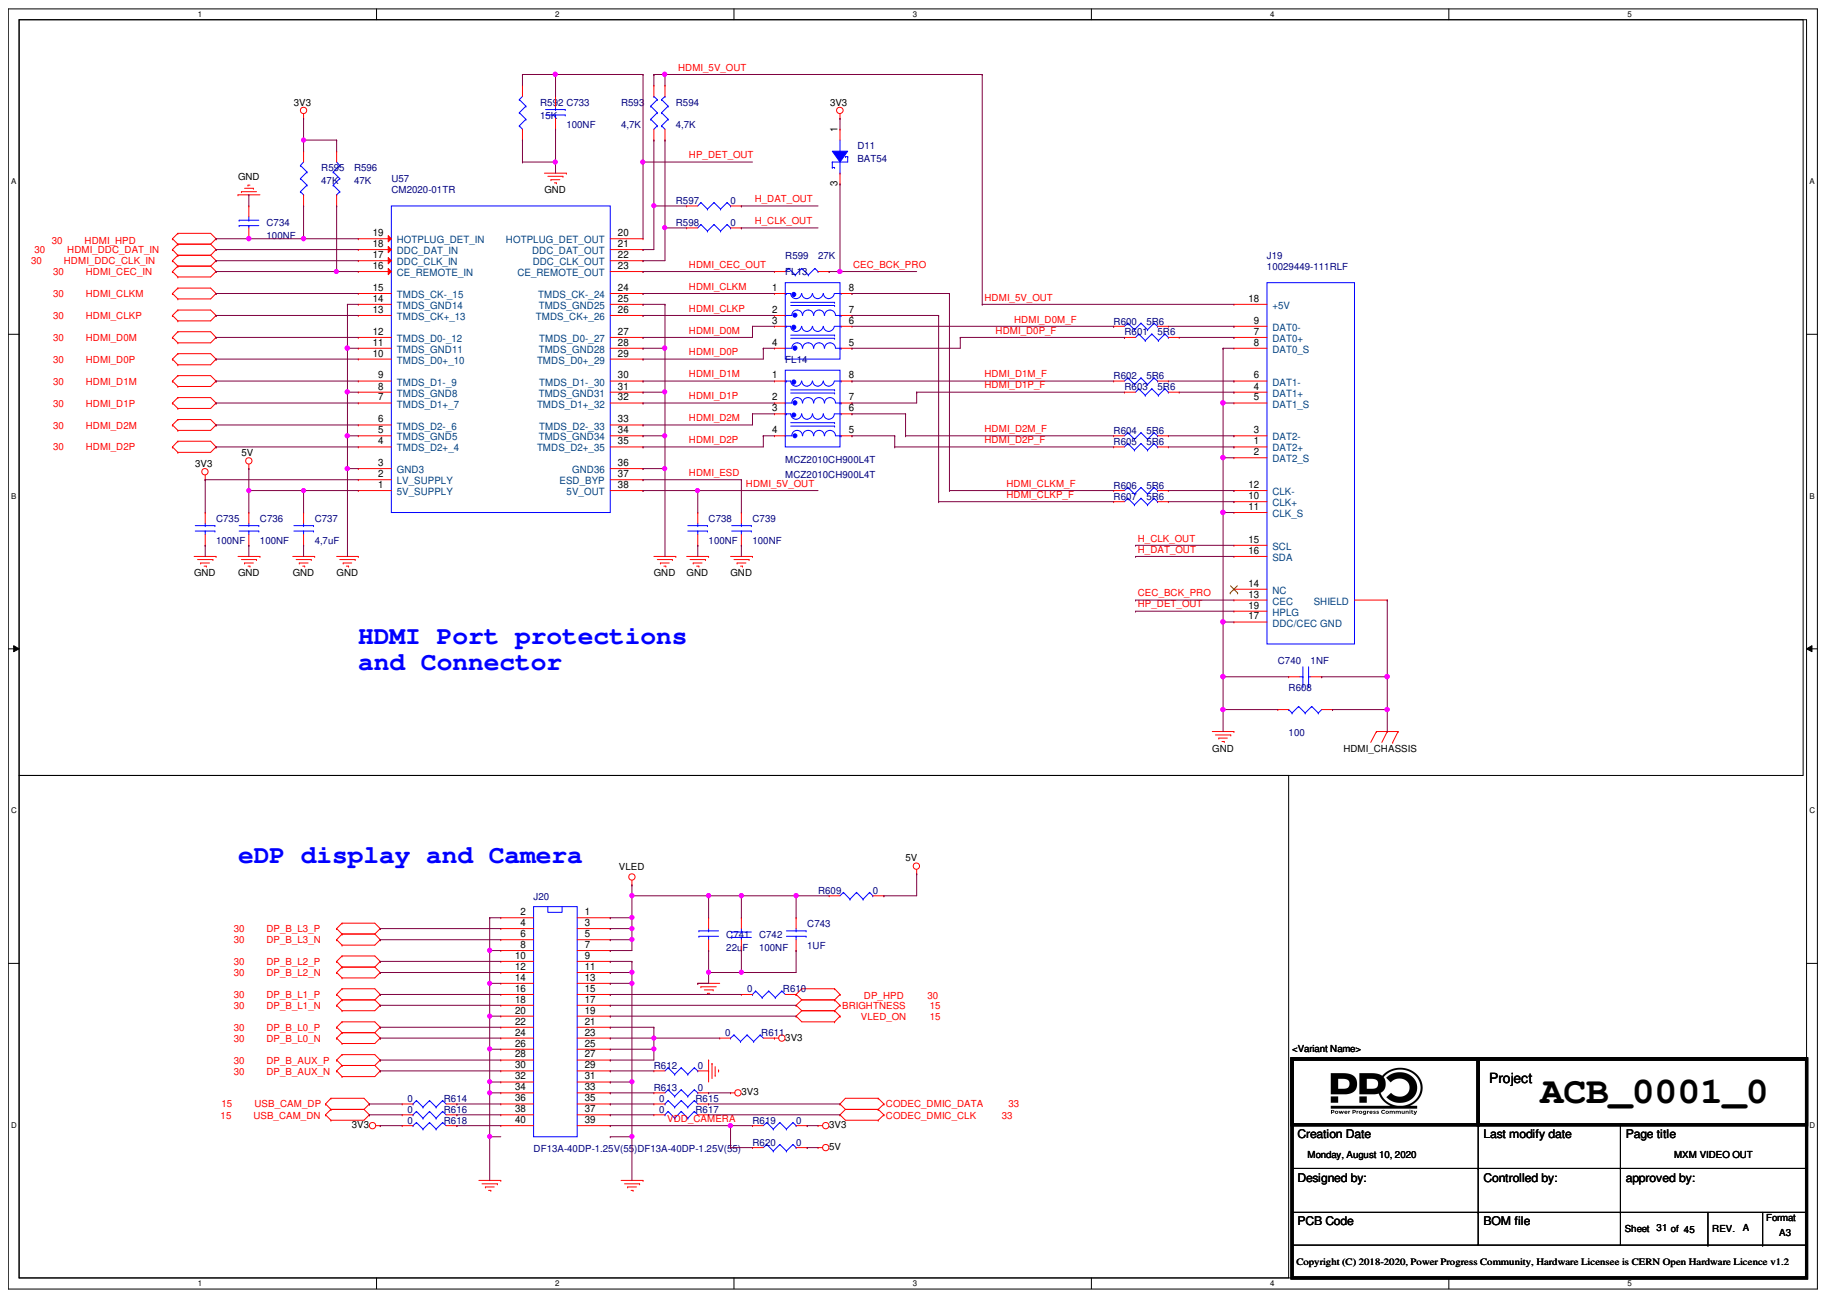
[picture p46: page 31]

eDP display and Camera

8 | I2C2_SCL
8 | I2C2_SDA

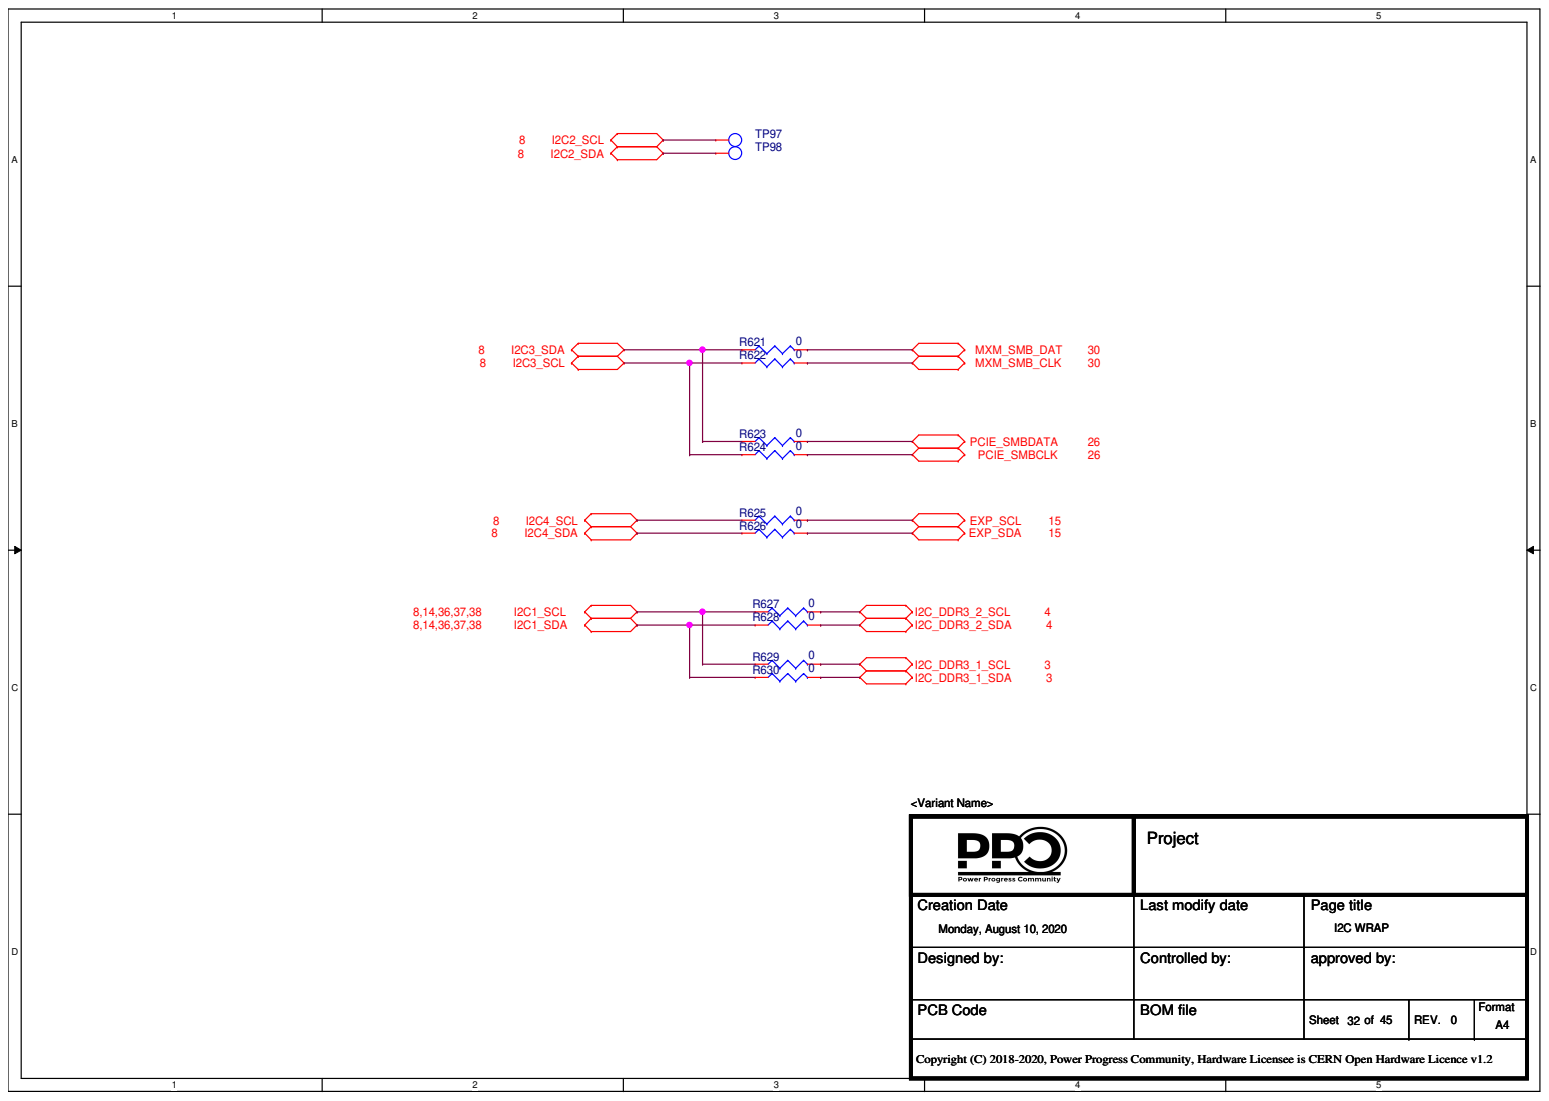
[picture p47: page 32]

Anti-pop noise Ctrl.

## CRYSTAL

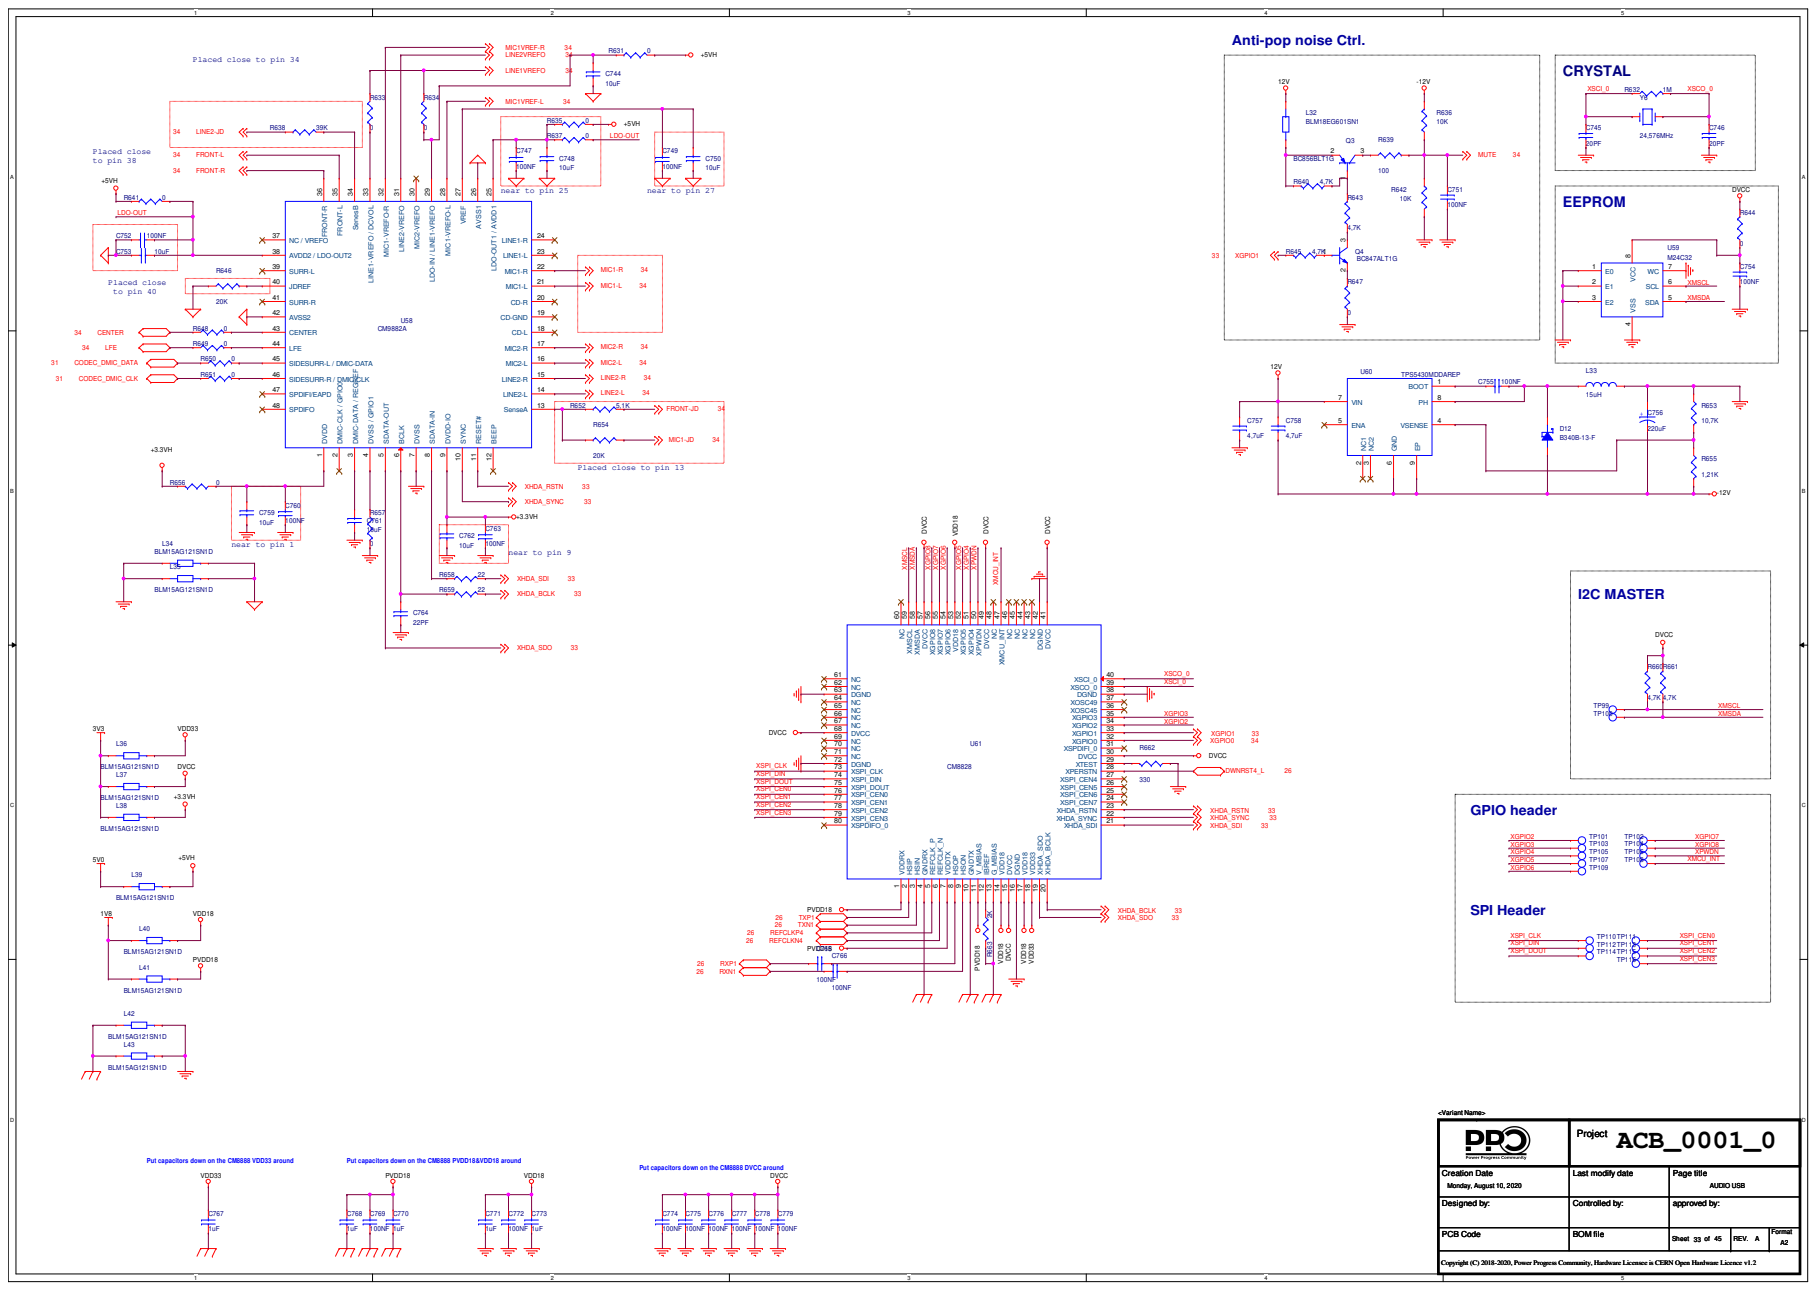
[picture p48: page 33]

Placed close to pin 34

Placed close to pin 13

Put capacitors down on the CM8888 VDD33 around

Put capacitors down on the CM8888 PVDD18&VDD18 around

Put capacitors down on the CM8888 DVCC around

# EXTERNAL JACK

# EXT MIC IN

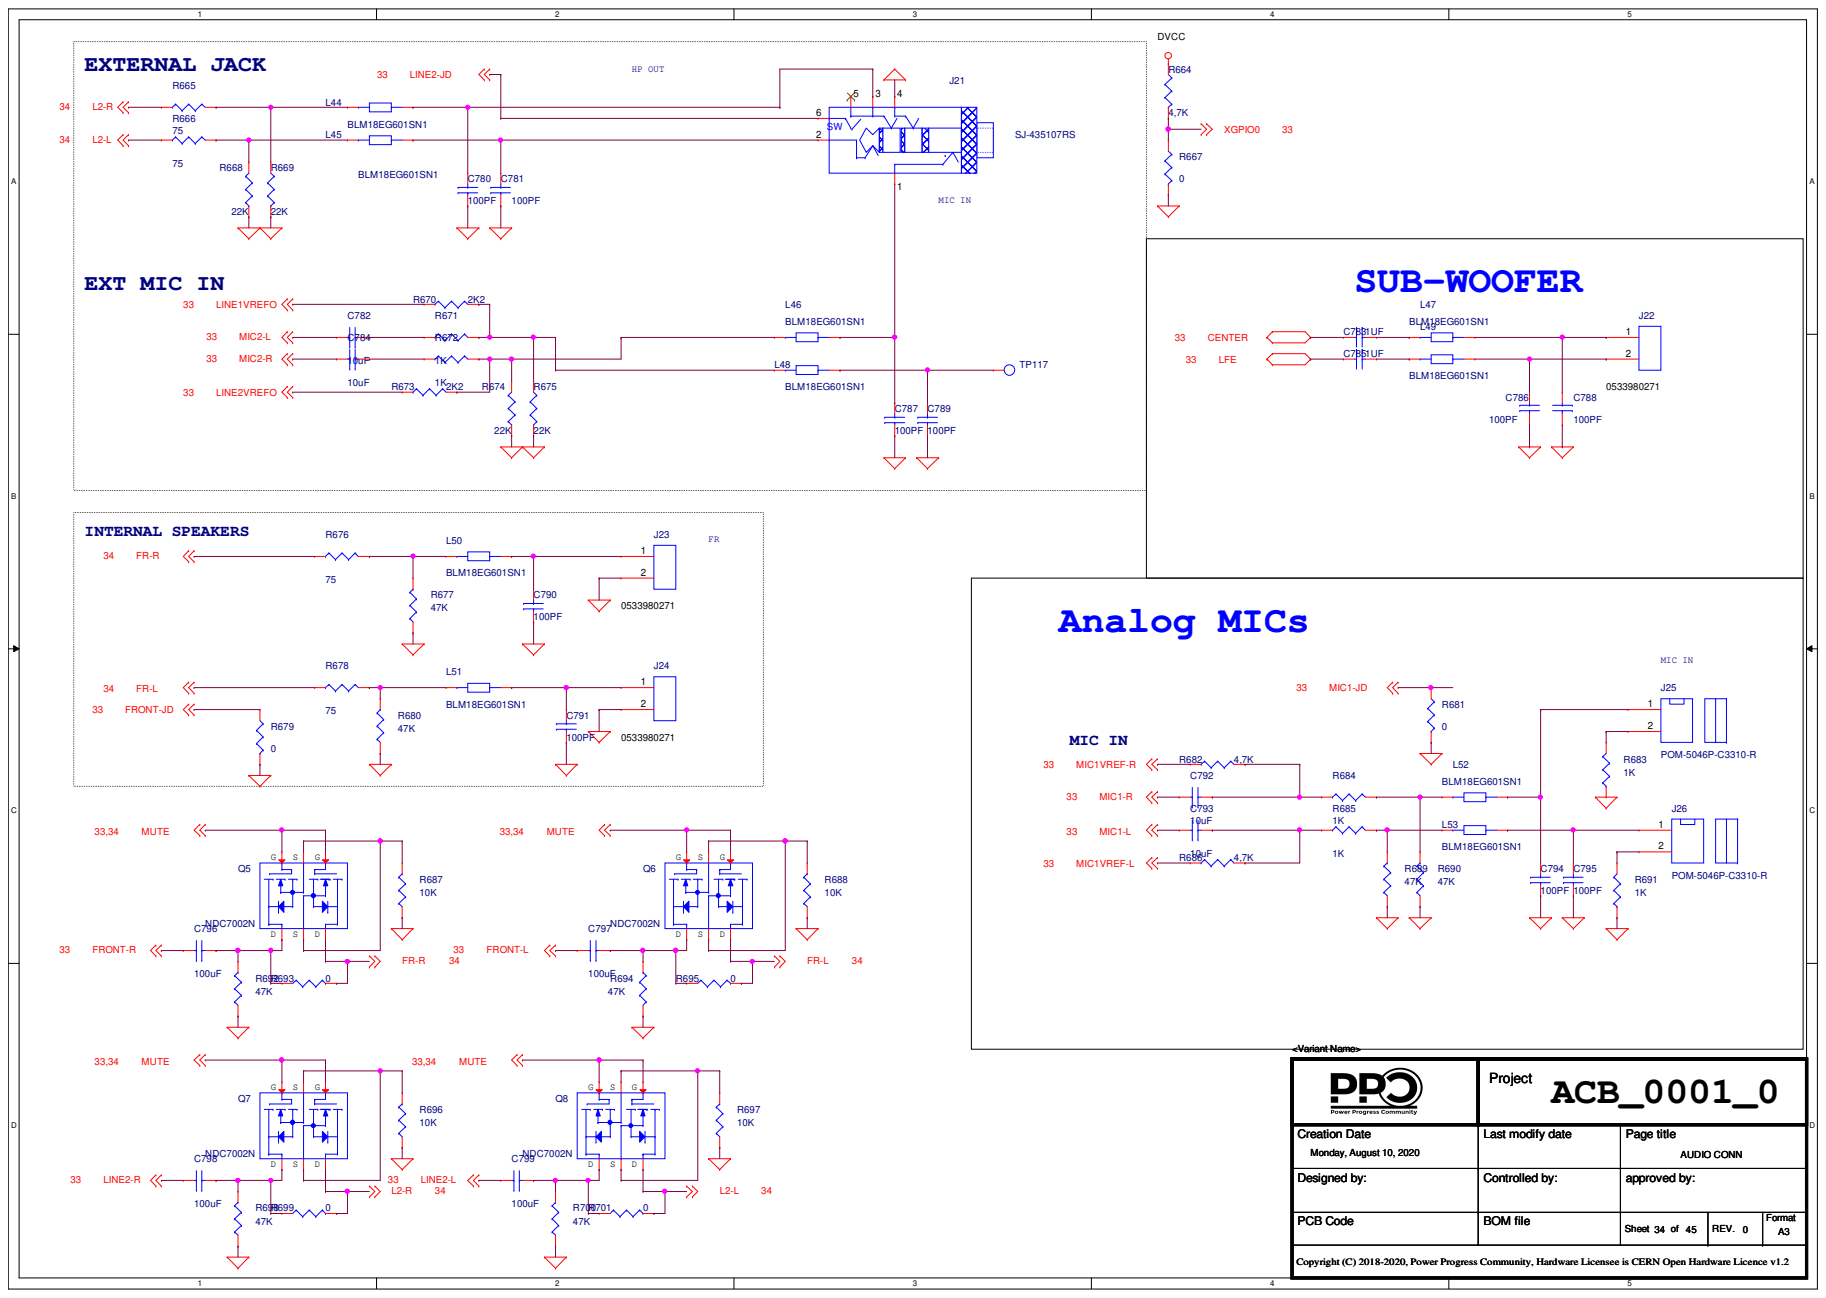
[picture p49: page 34]

# SYSTEM CLOCK GENERATORs

1V8

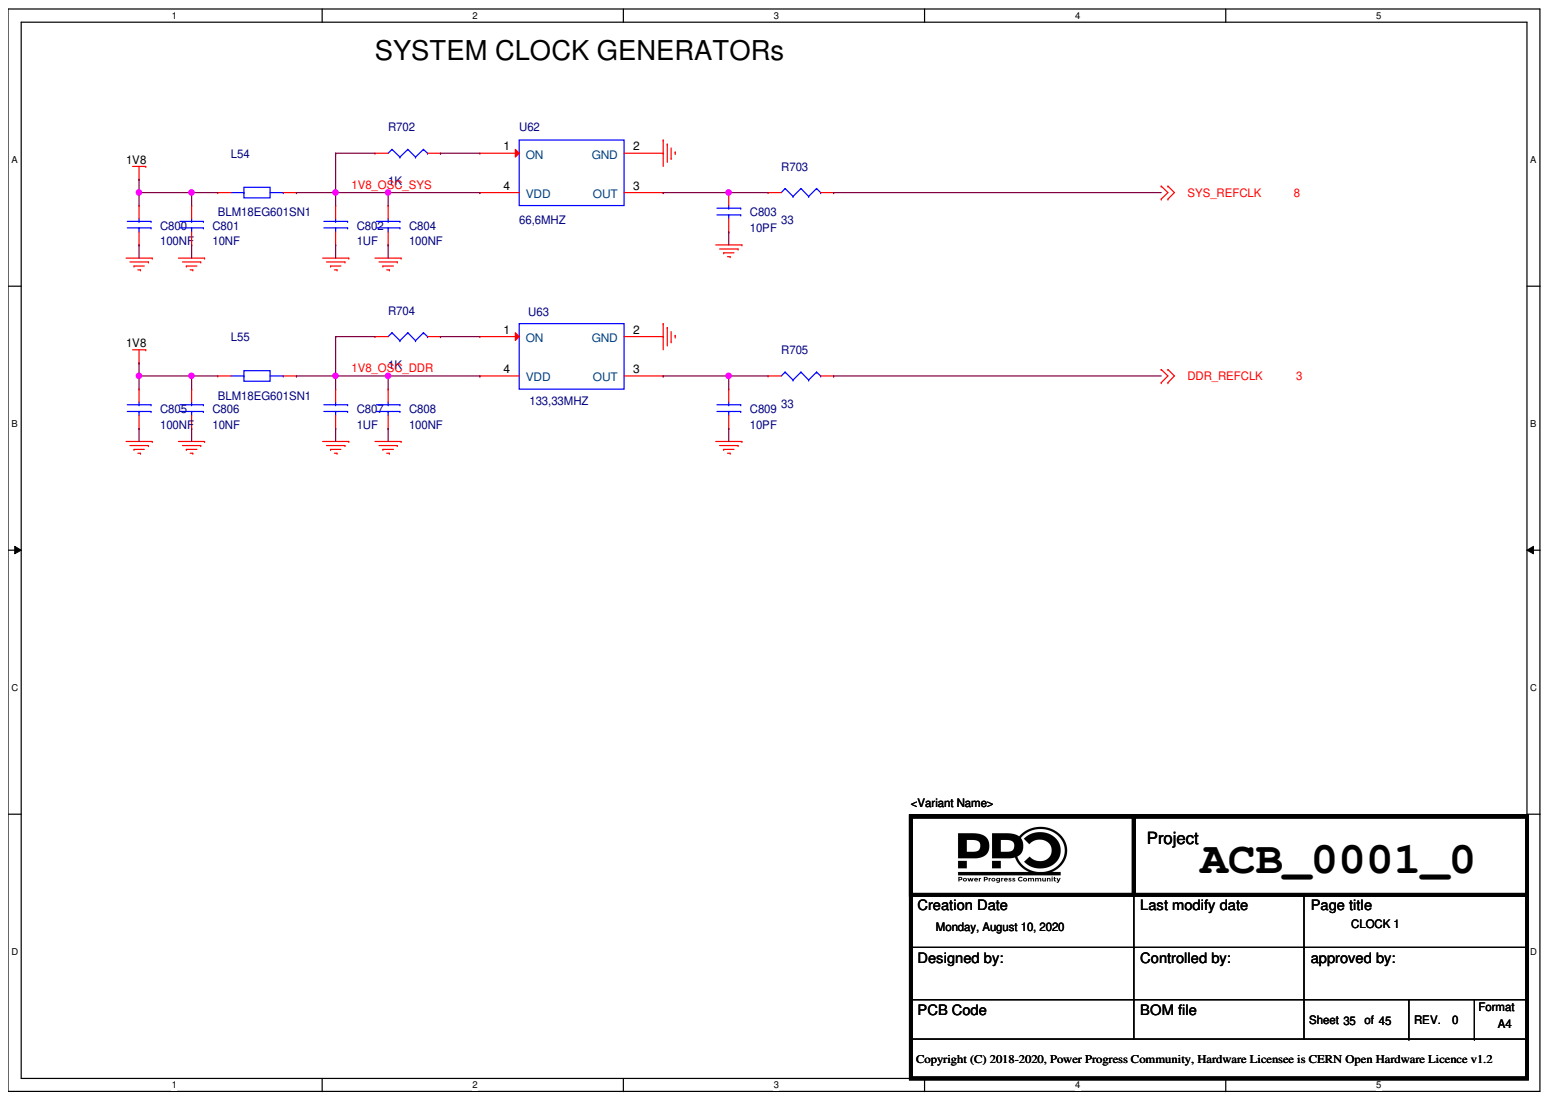
[picture p50: page 35]

# SYSTEM CLOCK GENERATORs (cont.)

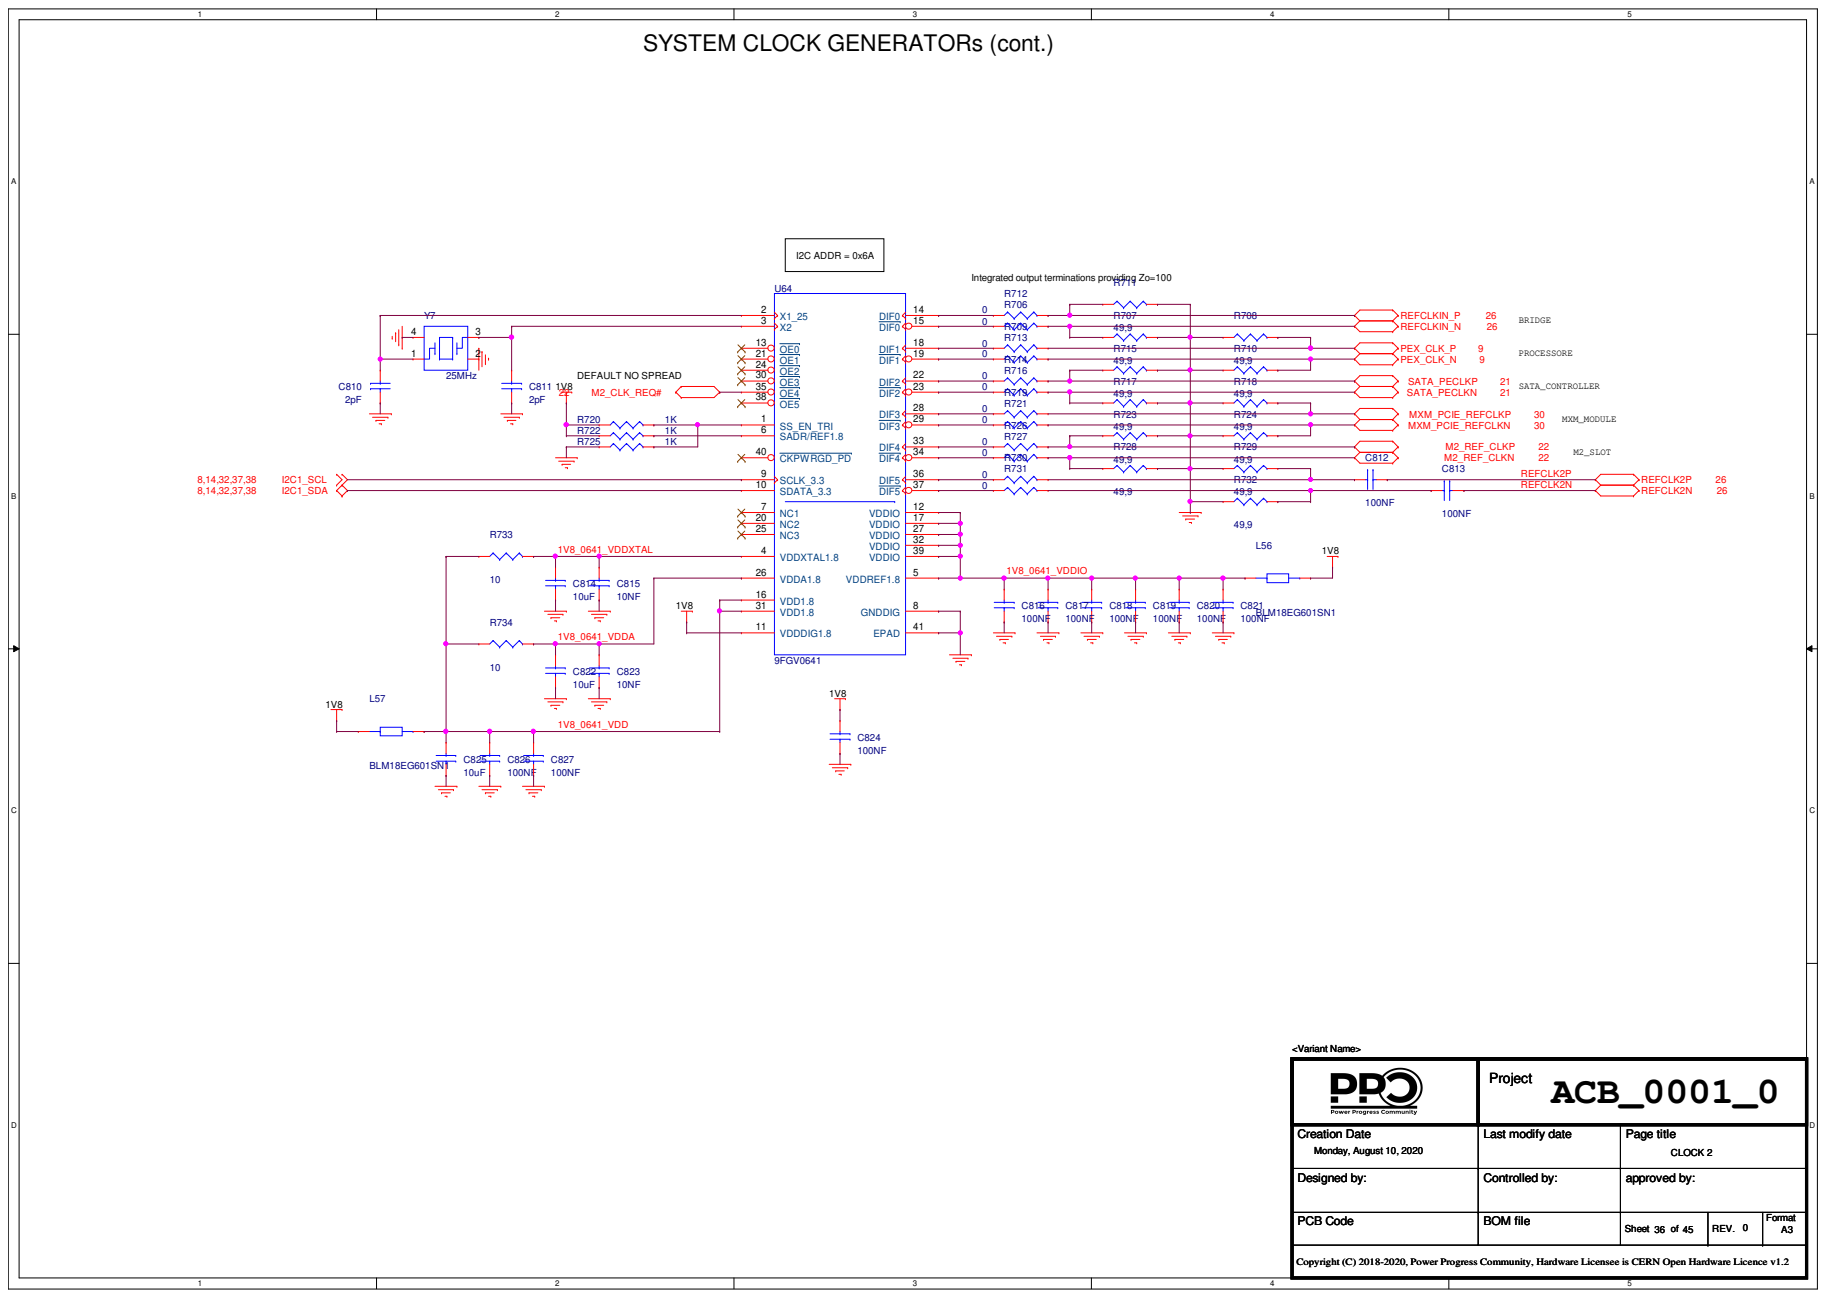
[picture p51: page 36]

Integrated output terminations providing Zo=100

# T2080 CORE POWER CONVERTOR

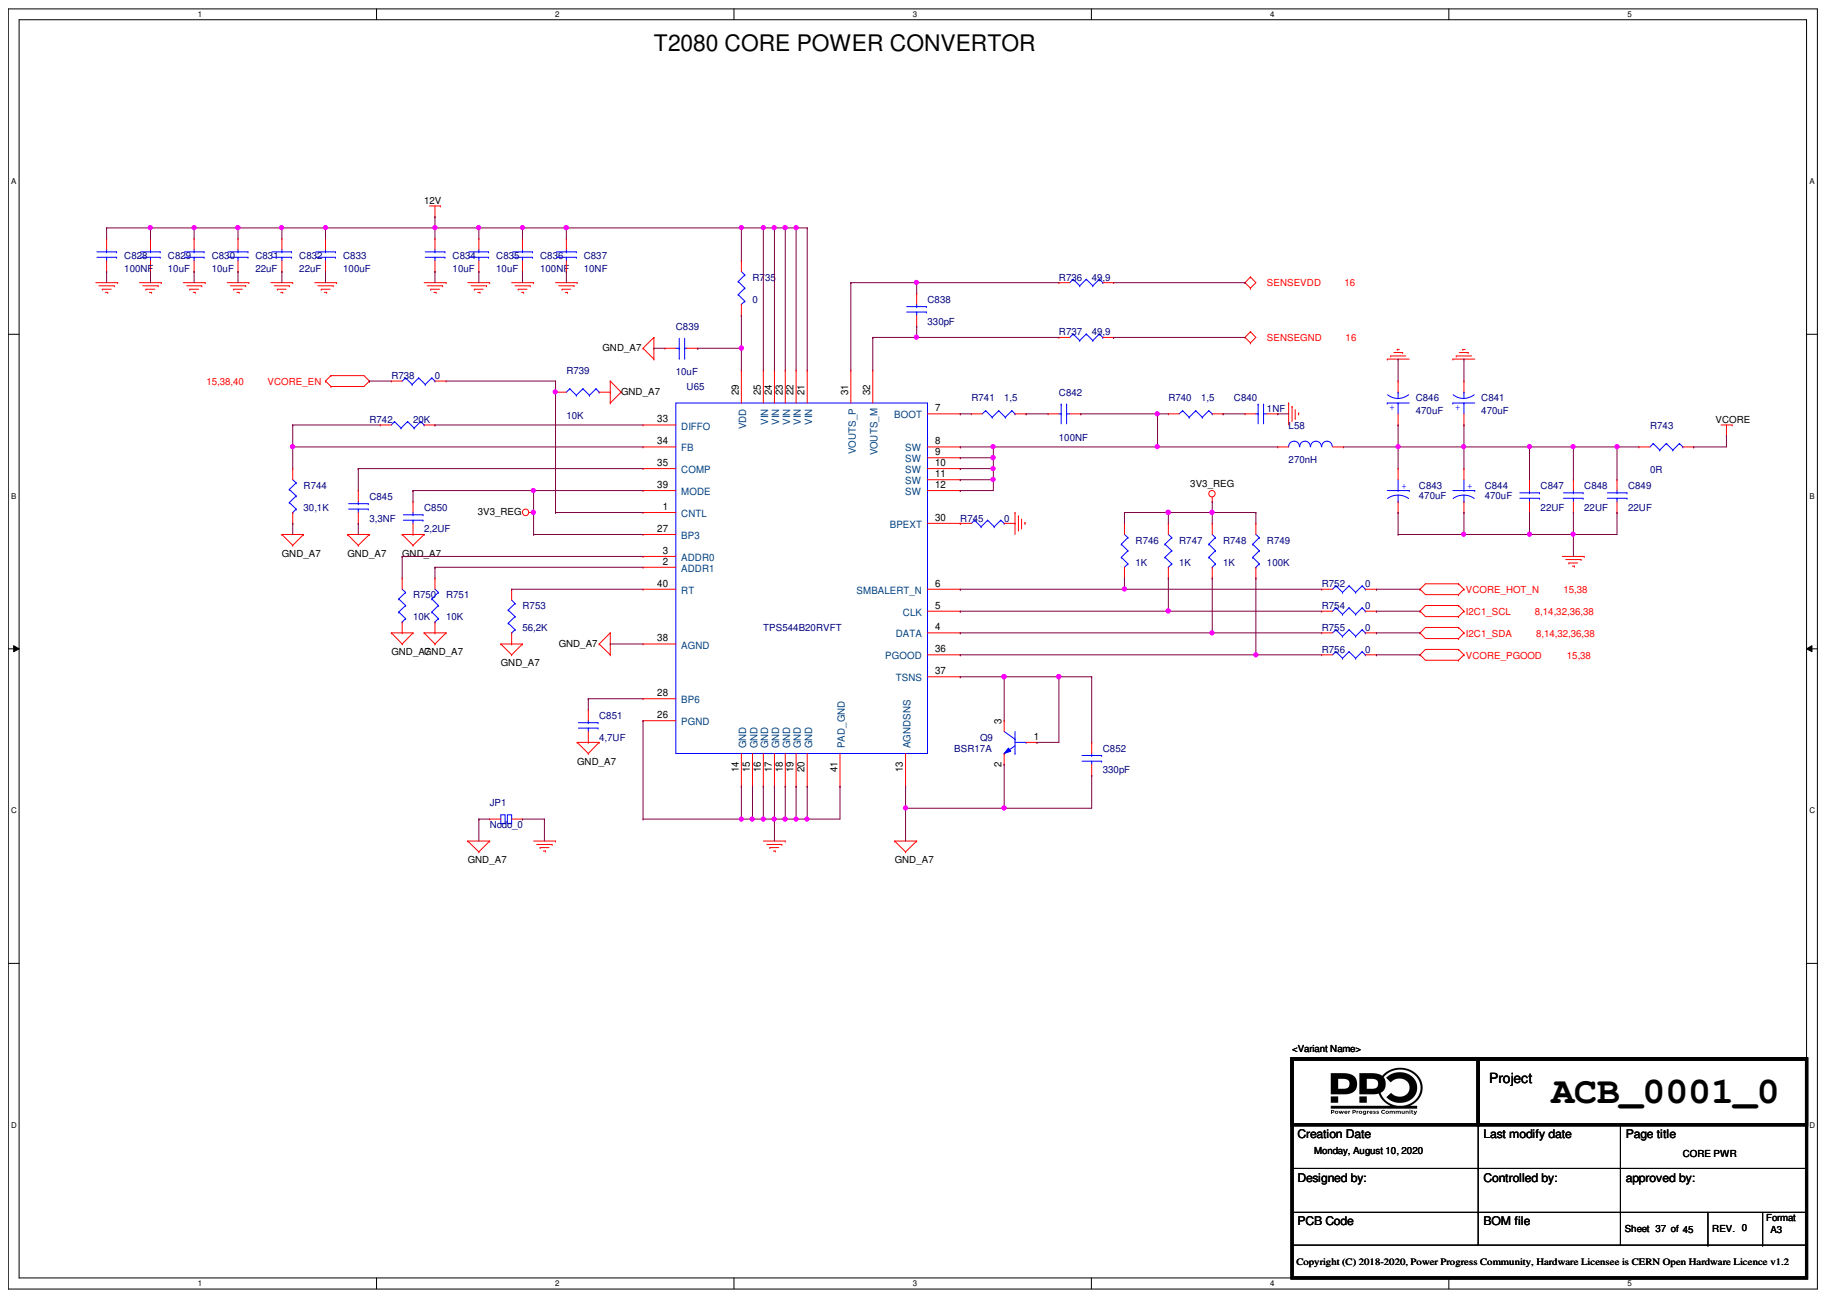
[picture p52: page 37]

# SYSTEM POWER CONVERTORs

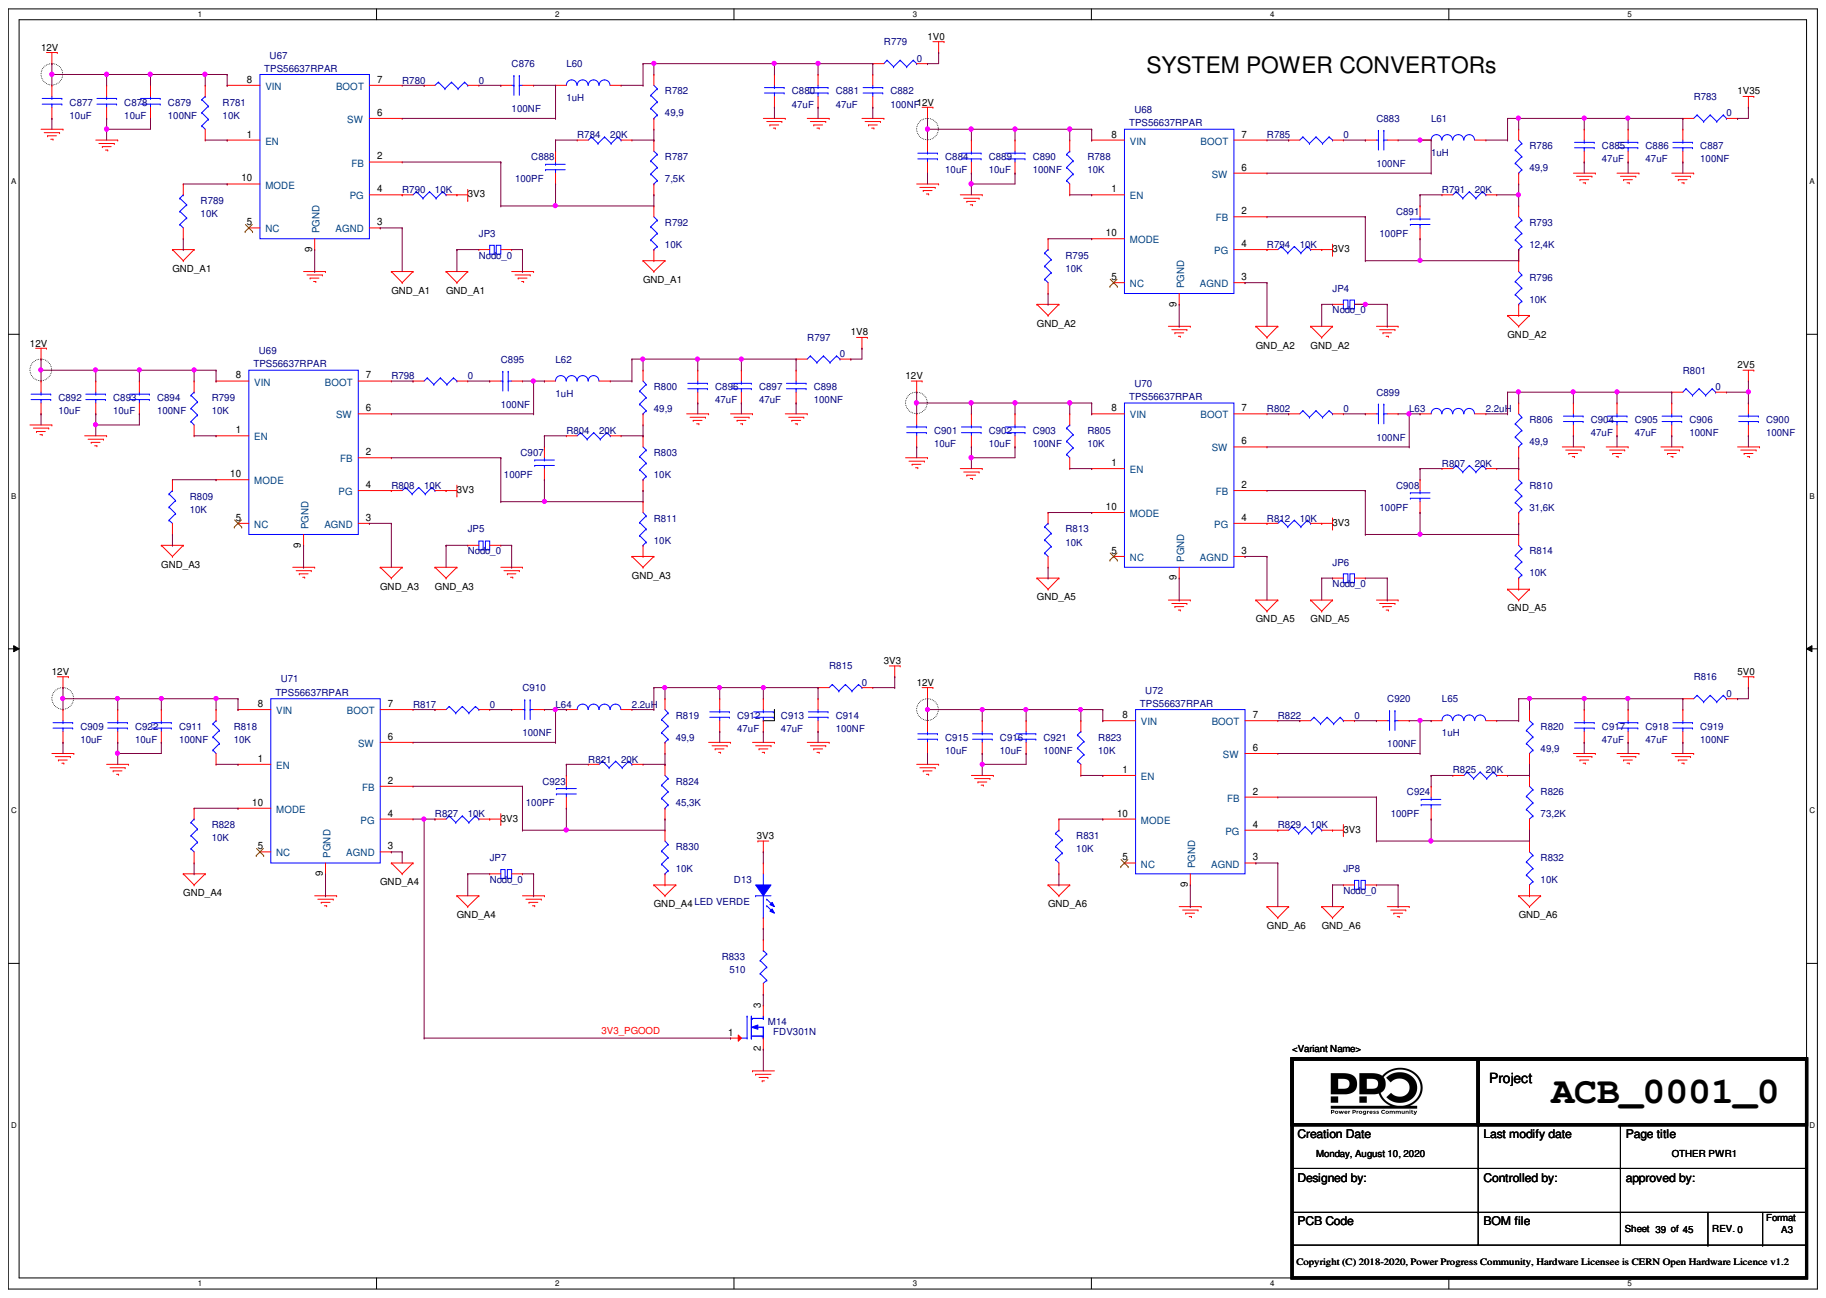
[picture p53: page 38]

# SYSTEM POWER CONVERTORs (cont.)

## COPPER ISLAND

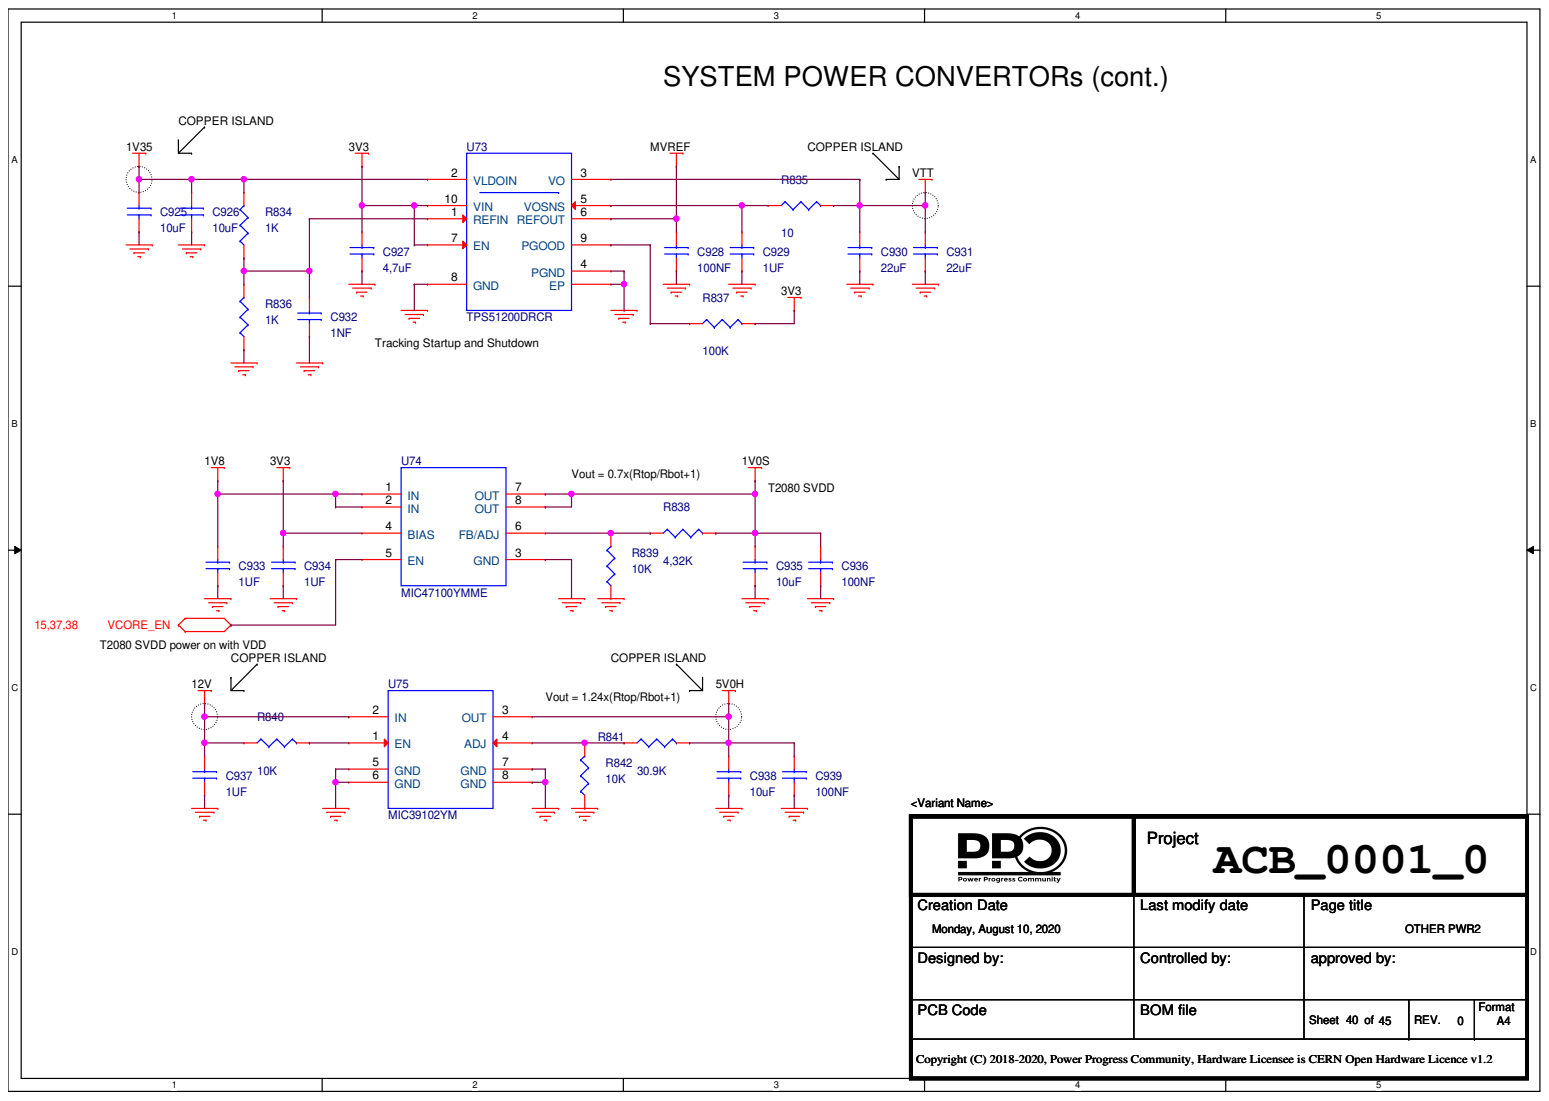
[picture p54: page 39]

Tracking Startup and Shutdown

T2080 SVDD power on with VDD

12V 8A

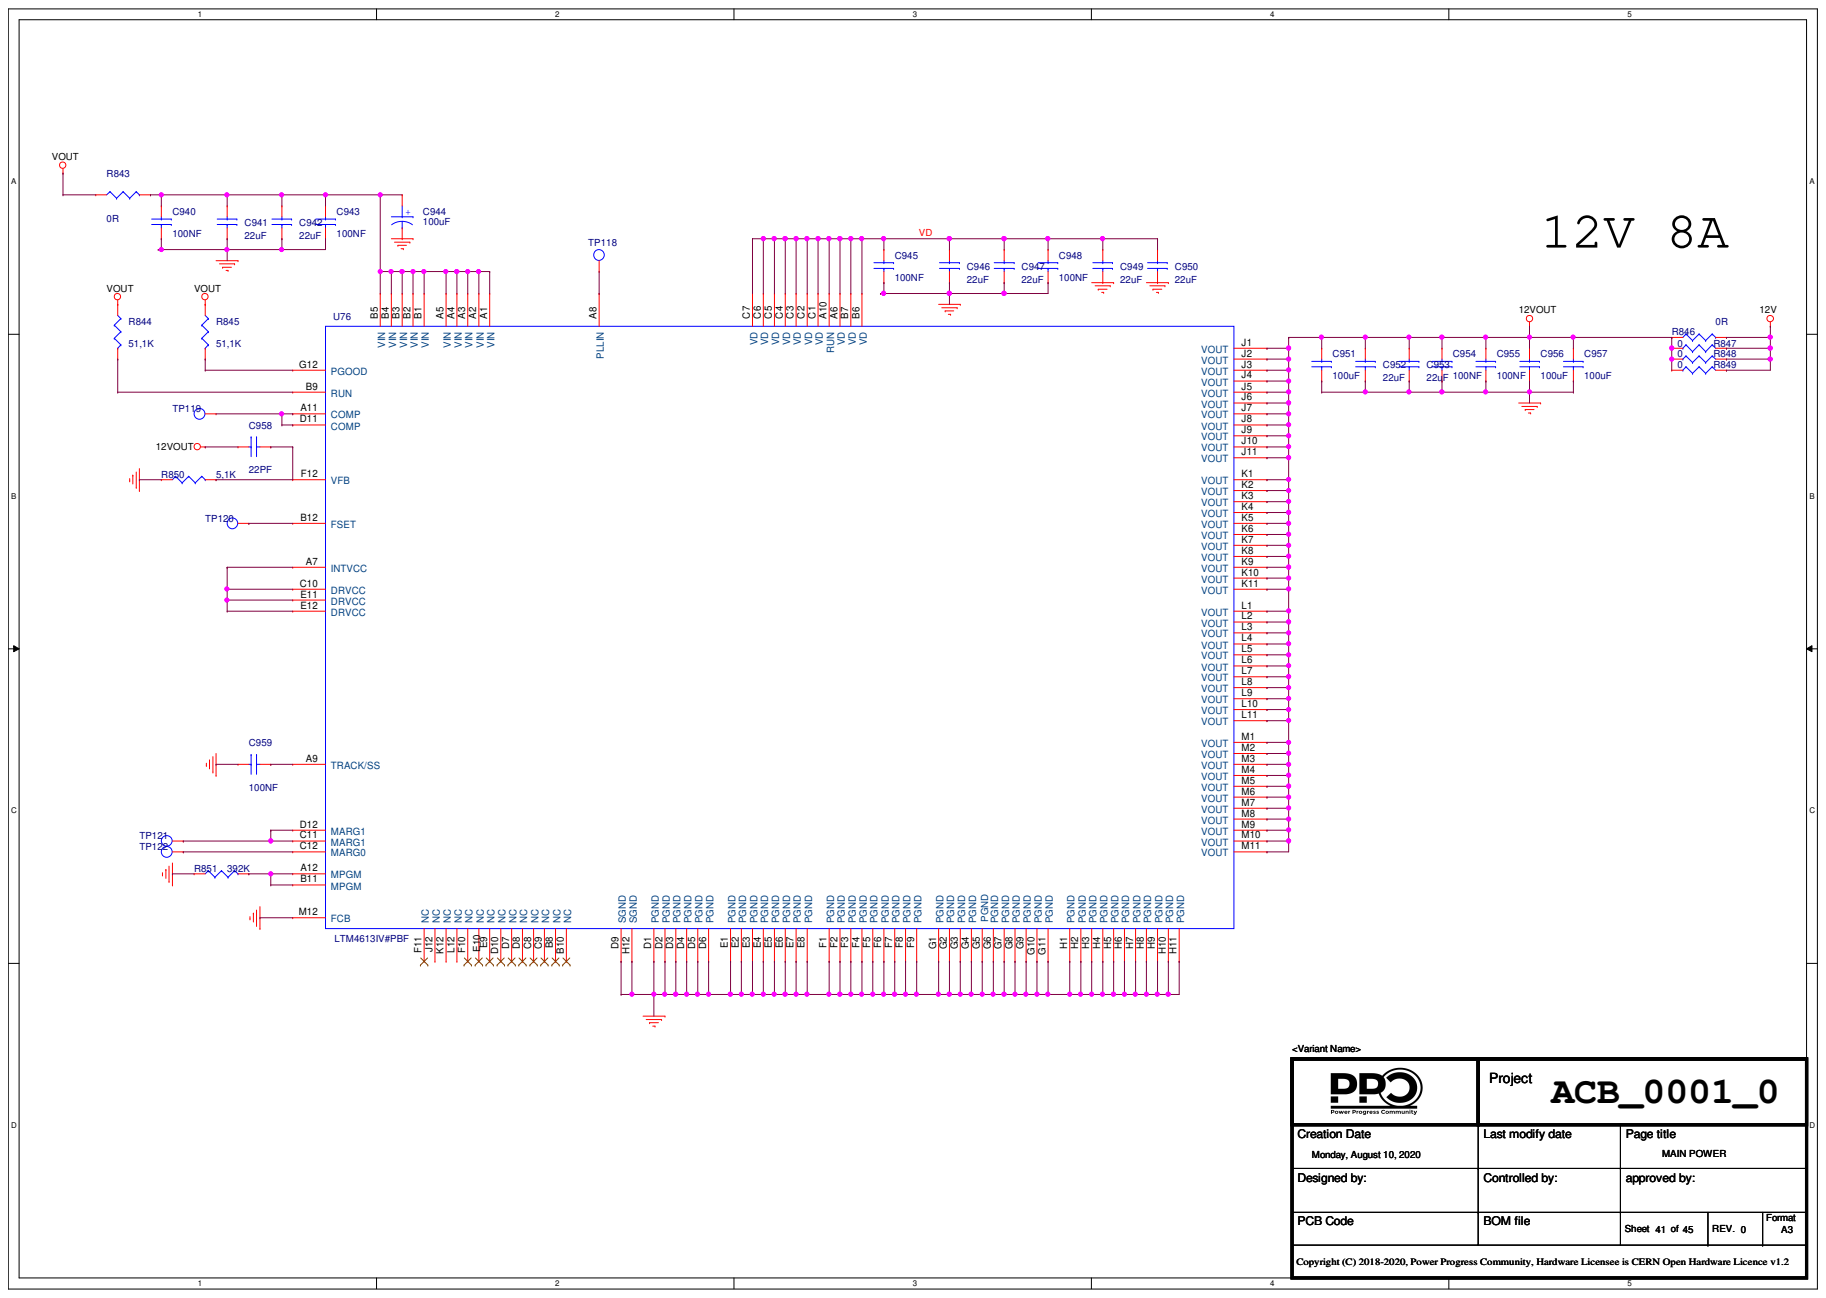
[picture p55: page 40]

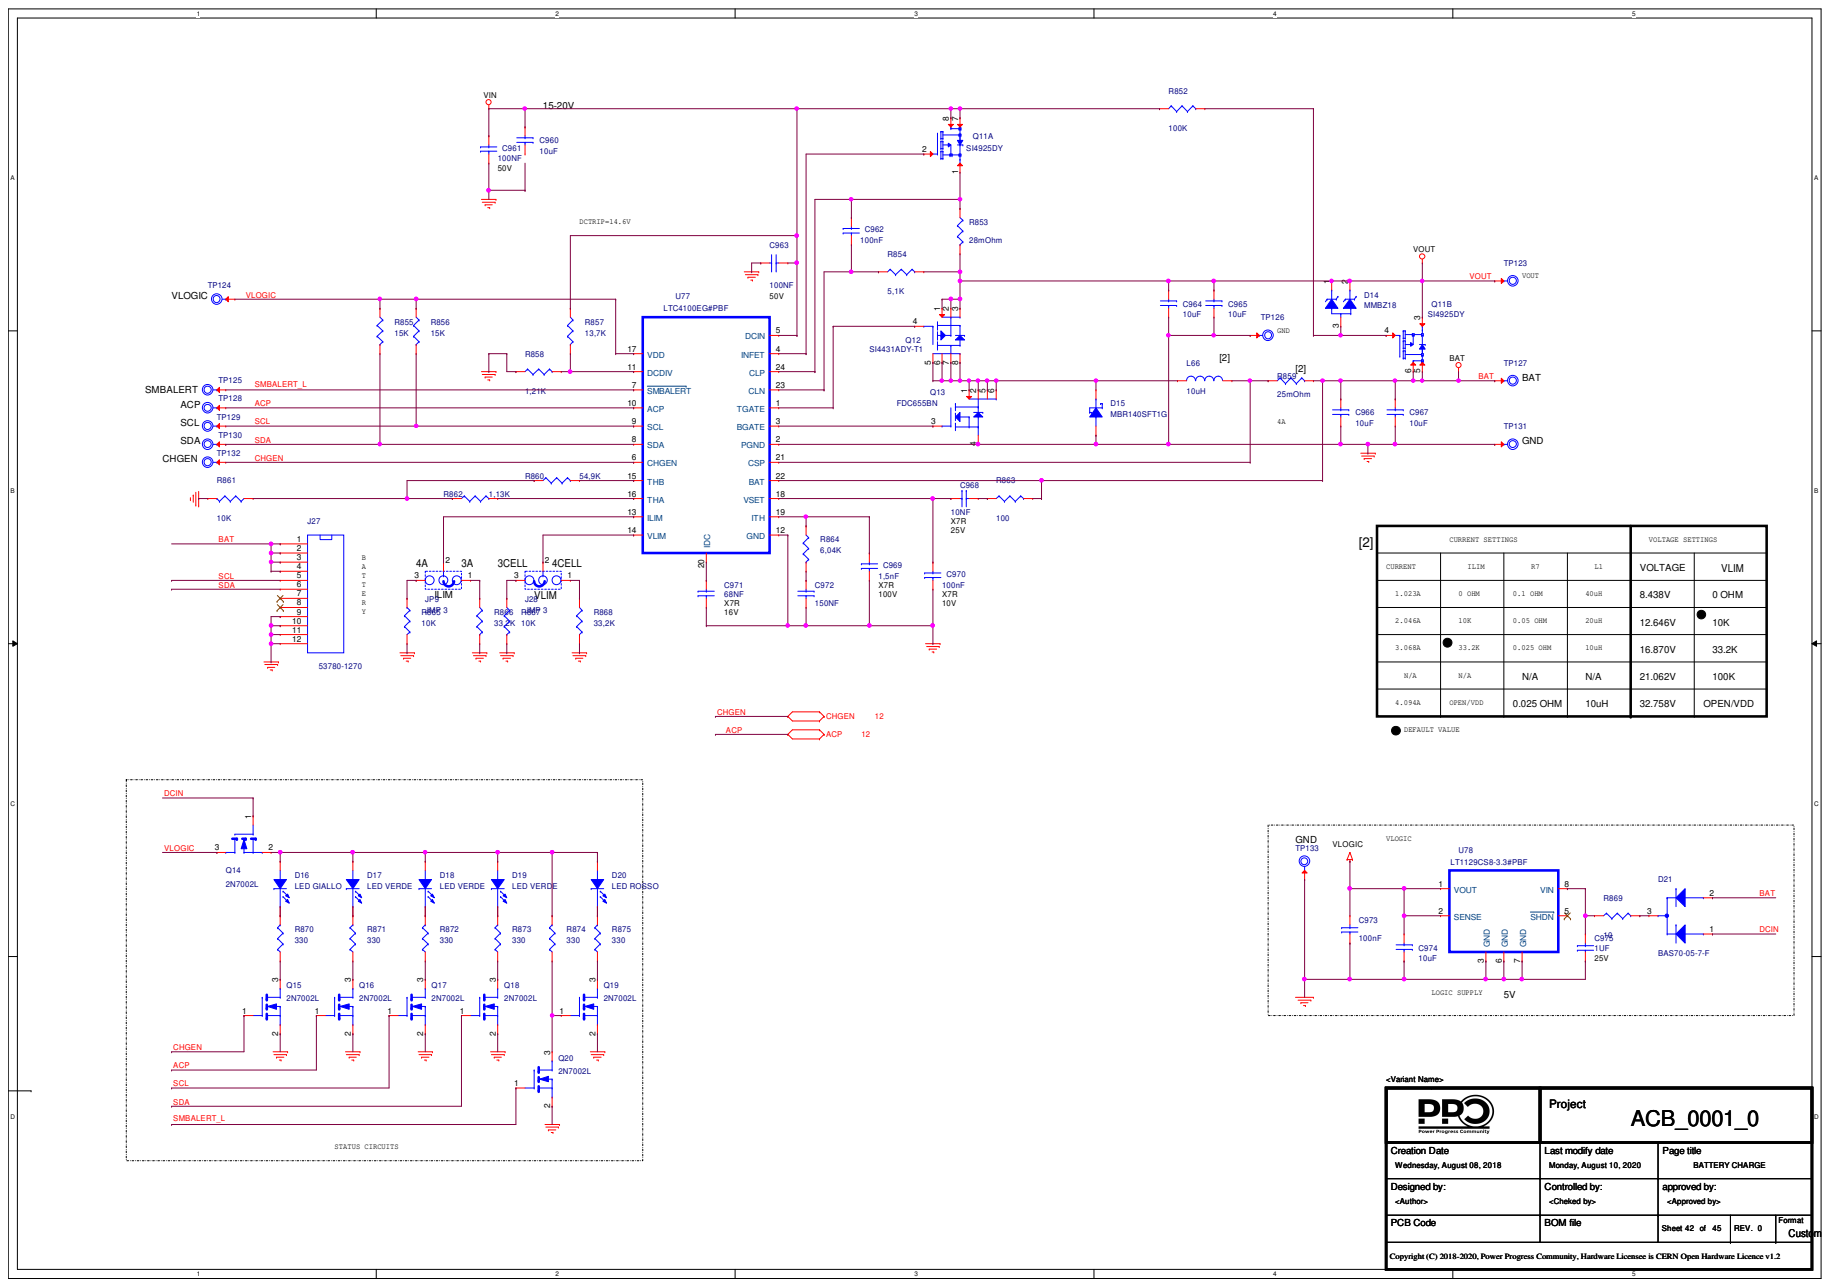
[picture p56: page 41]

# SYSTEM POWER INPUT

## REMOTE RESET

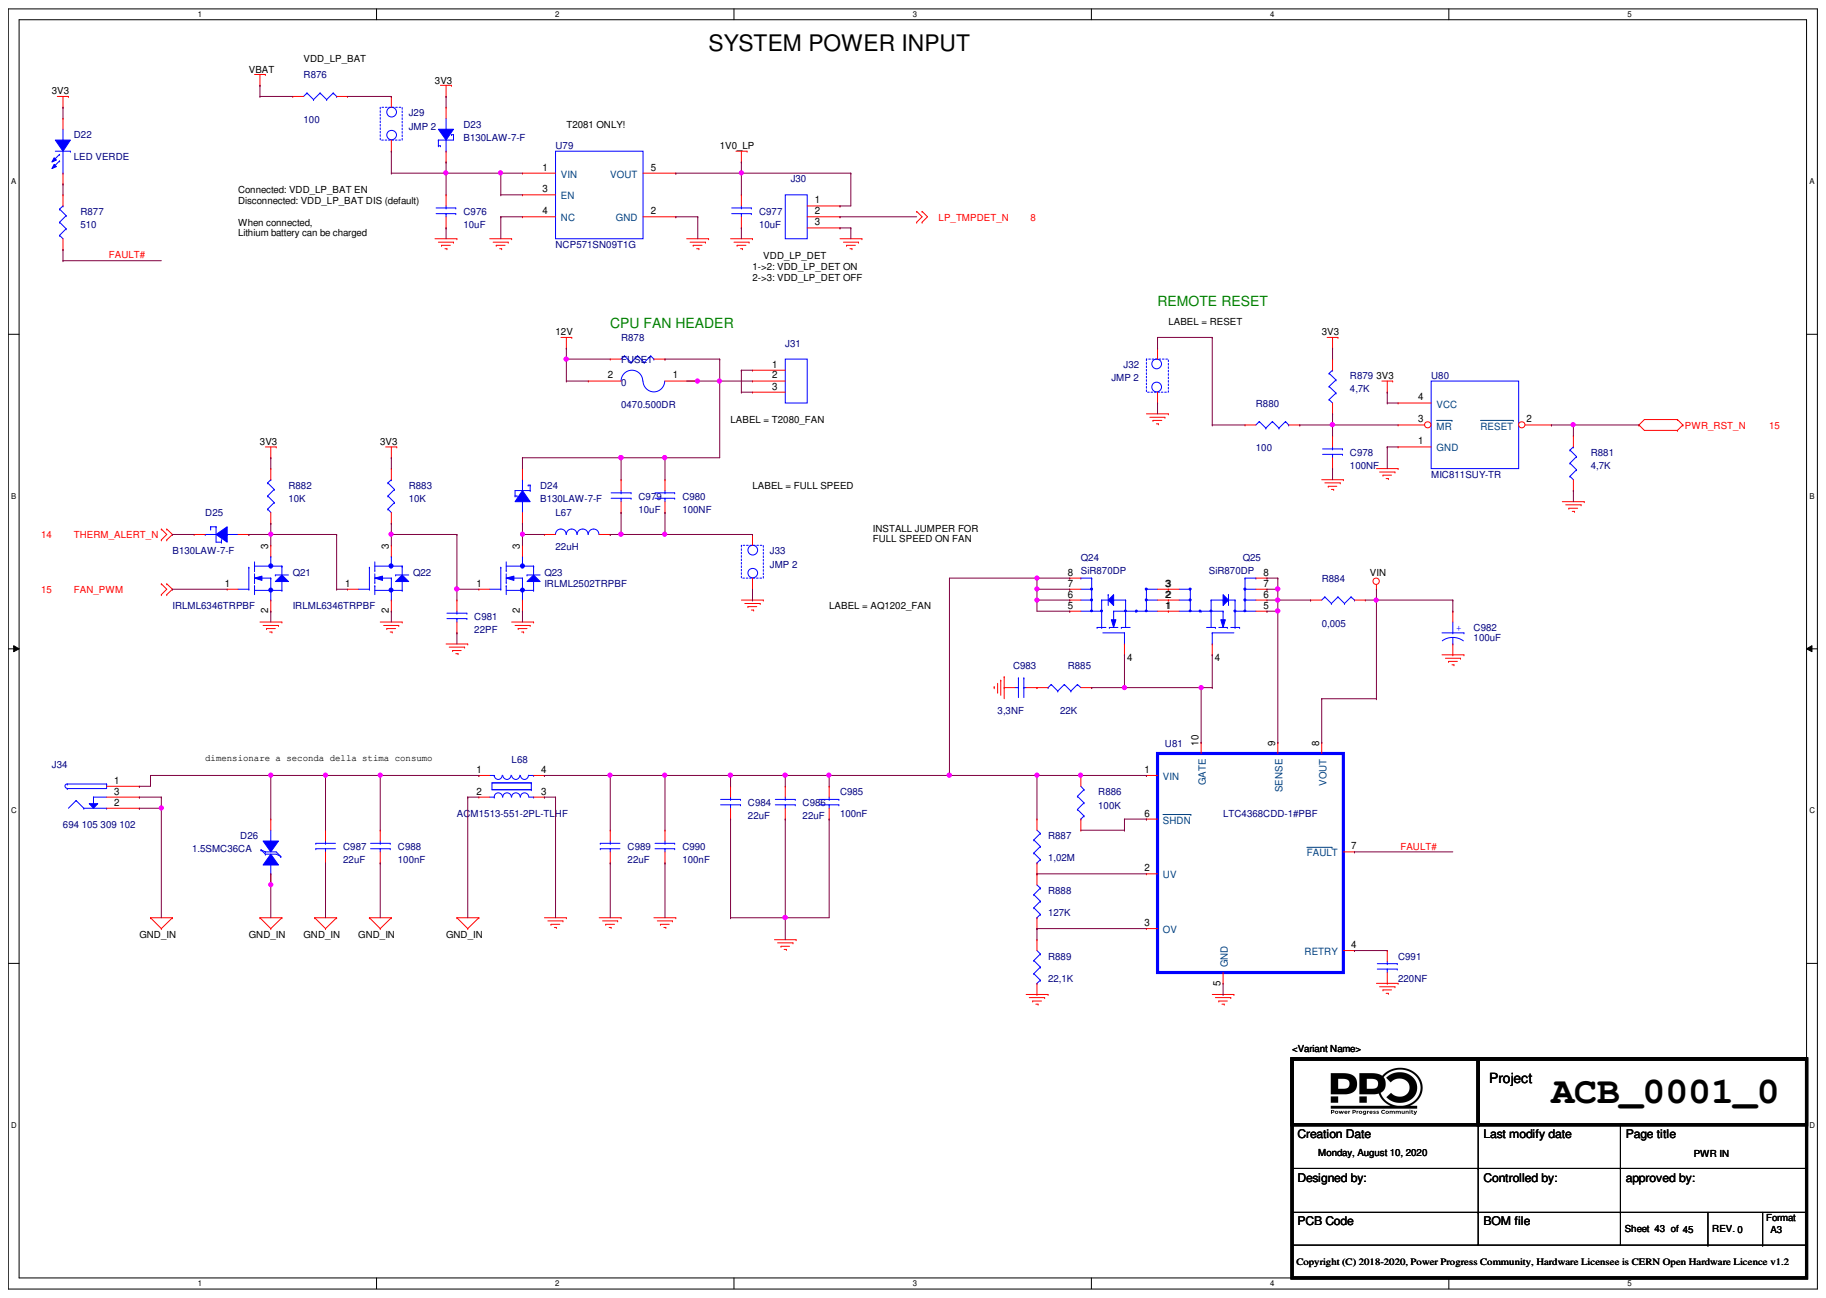
[picture p57: page 42]

When connected,
Lithium battery can be charged

INSTALL JUMPER FOR
FULL SPEED ON FAN

dimensionare a seconda della stima consumo

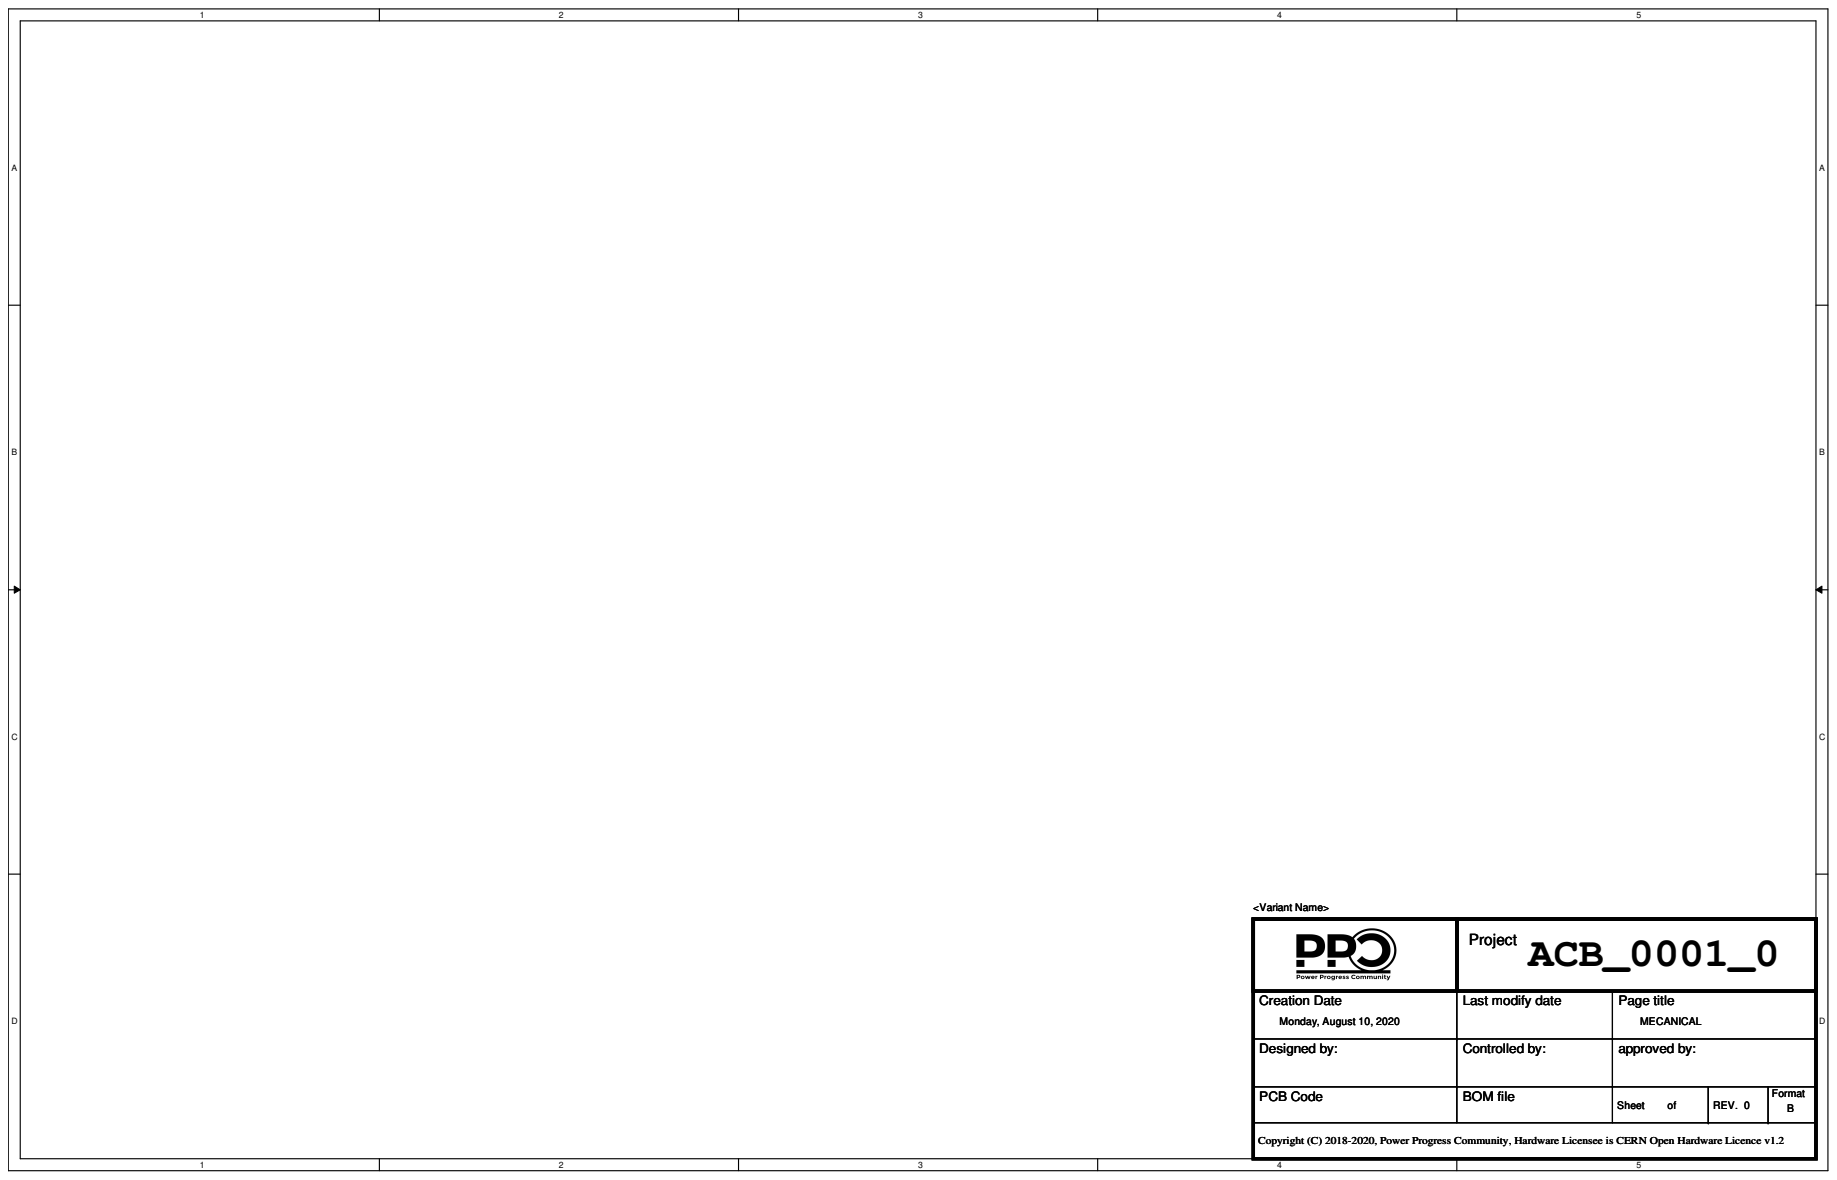
[picture p58: page 43]
ACB_0001_0 Project; Creation Date; Last modify date; Designed by:; Controlled by:; approved by:; PCB Code; BOM file; Sheet; REV.; Format; Page title; MECANICAL; Monday, August 10, 2020; <Variant Name>; Project

Copyright (C) 2018-2020, Power Progress Community, Hardware Licensee is CERN Open Hardware Licence v1.2

# CHANGE LIST

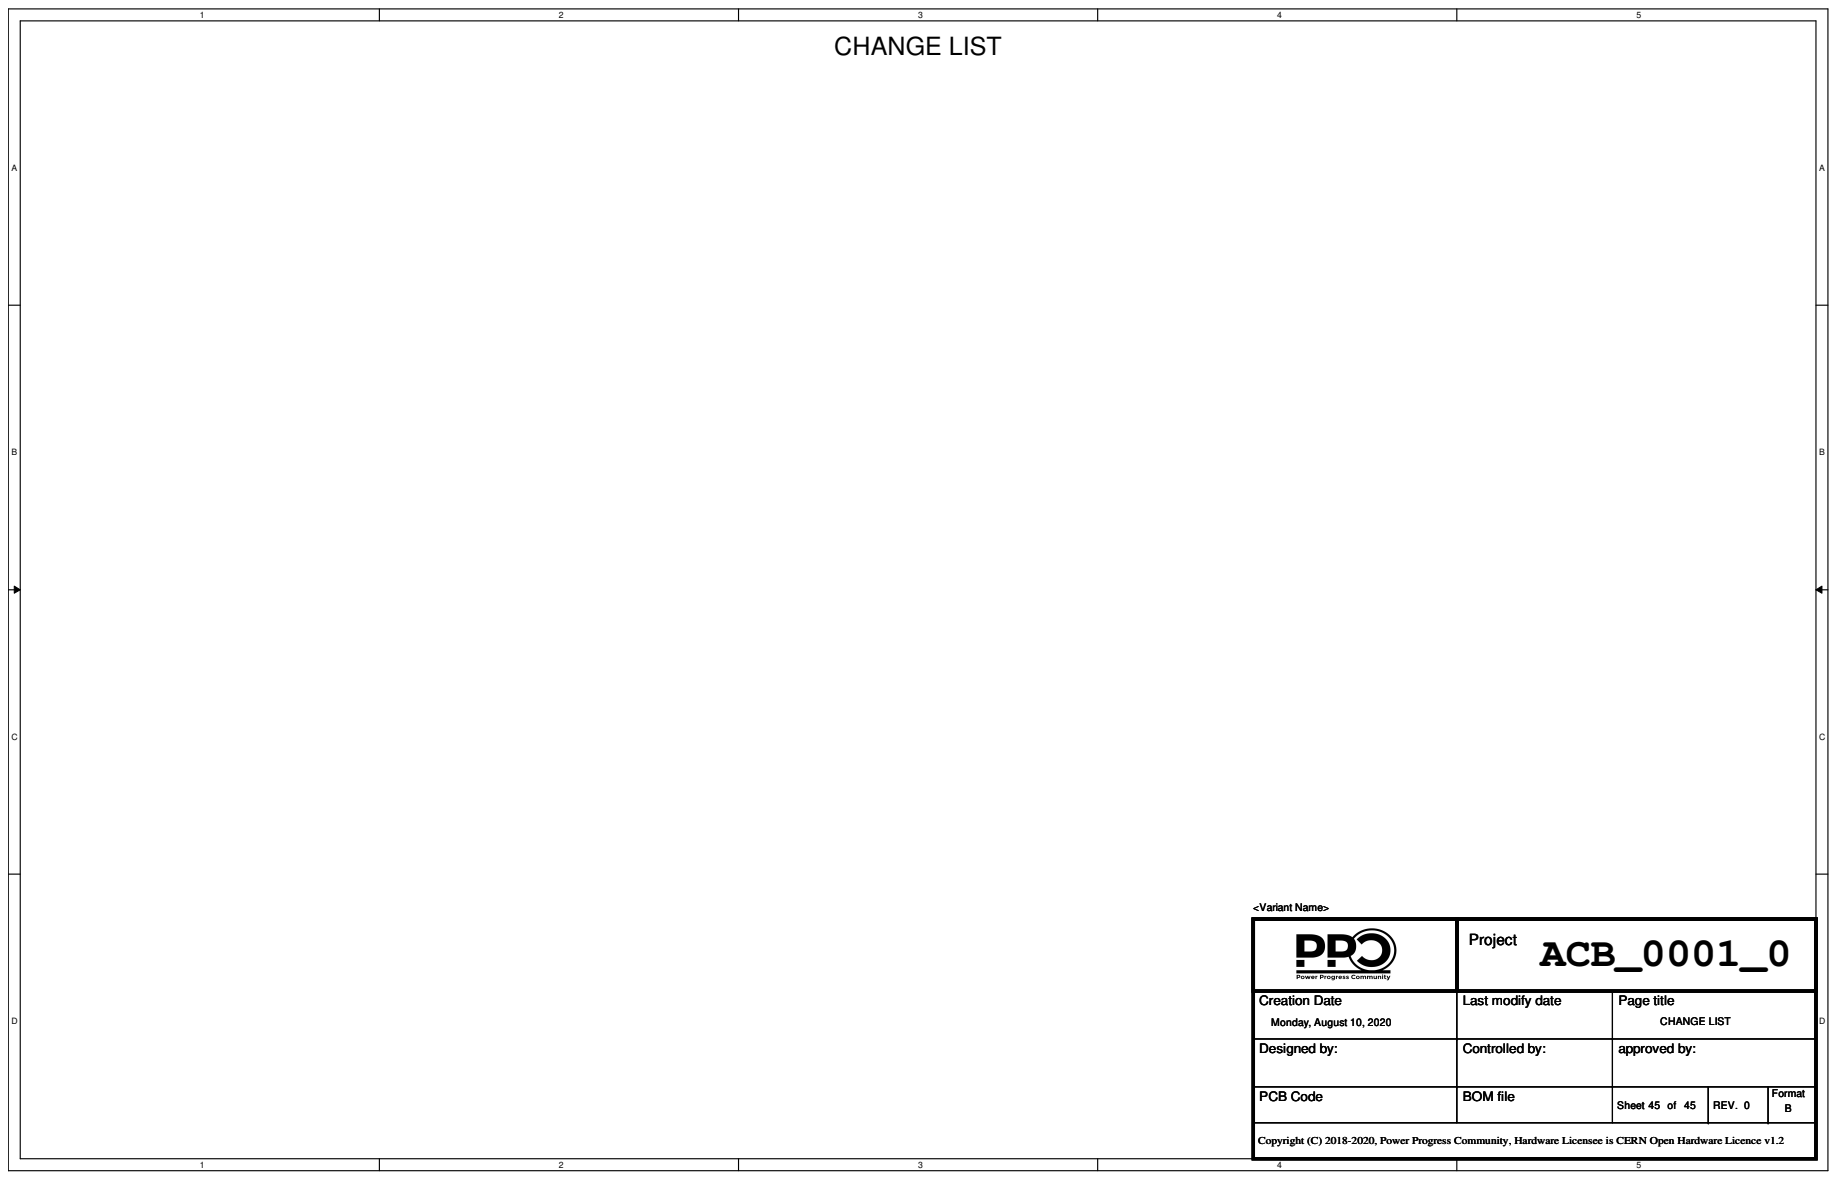
[picture p59: page 44]
ACB_0001_0 Project; Creation Date; Last modify date; Designed by:; Controlled by:; approved by:; PCB Code; BOM file; Sheet; REV.; Format; Page title; CHANGE LIST; Monday, August 10, 2020; <Variant Name>; Project

Copyright (C) 2018-2020, Power Progress Community, Hardware Licensee is CERN Open Hardware Licence v1.2
