unofficialImportFromGitlab-PPC/powerpc-laptop-mobo/Xpedition/Mas100n1 ACB_0001_0/Output/AutoCad/Mas100n1 ACUBE_PORTABILE R_0 Model (1).pdf

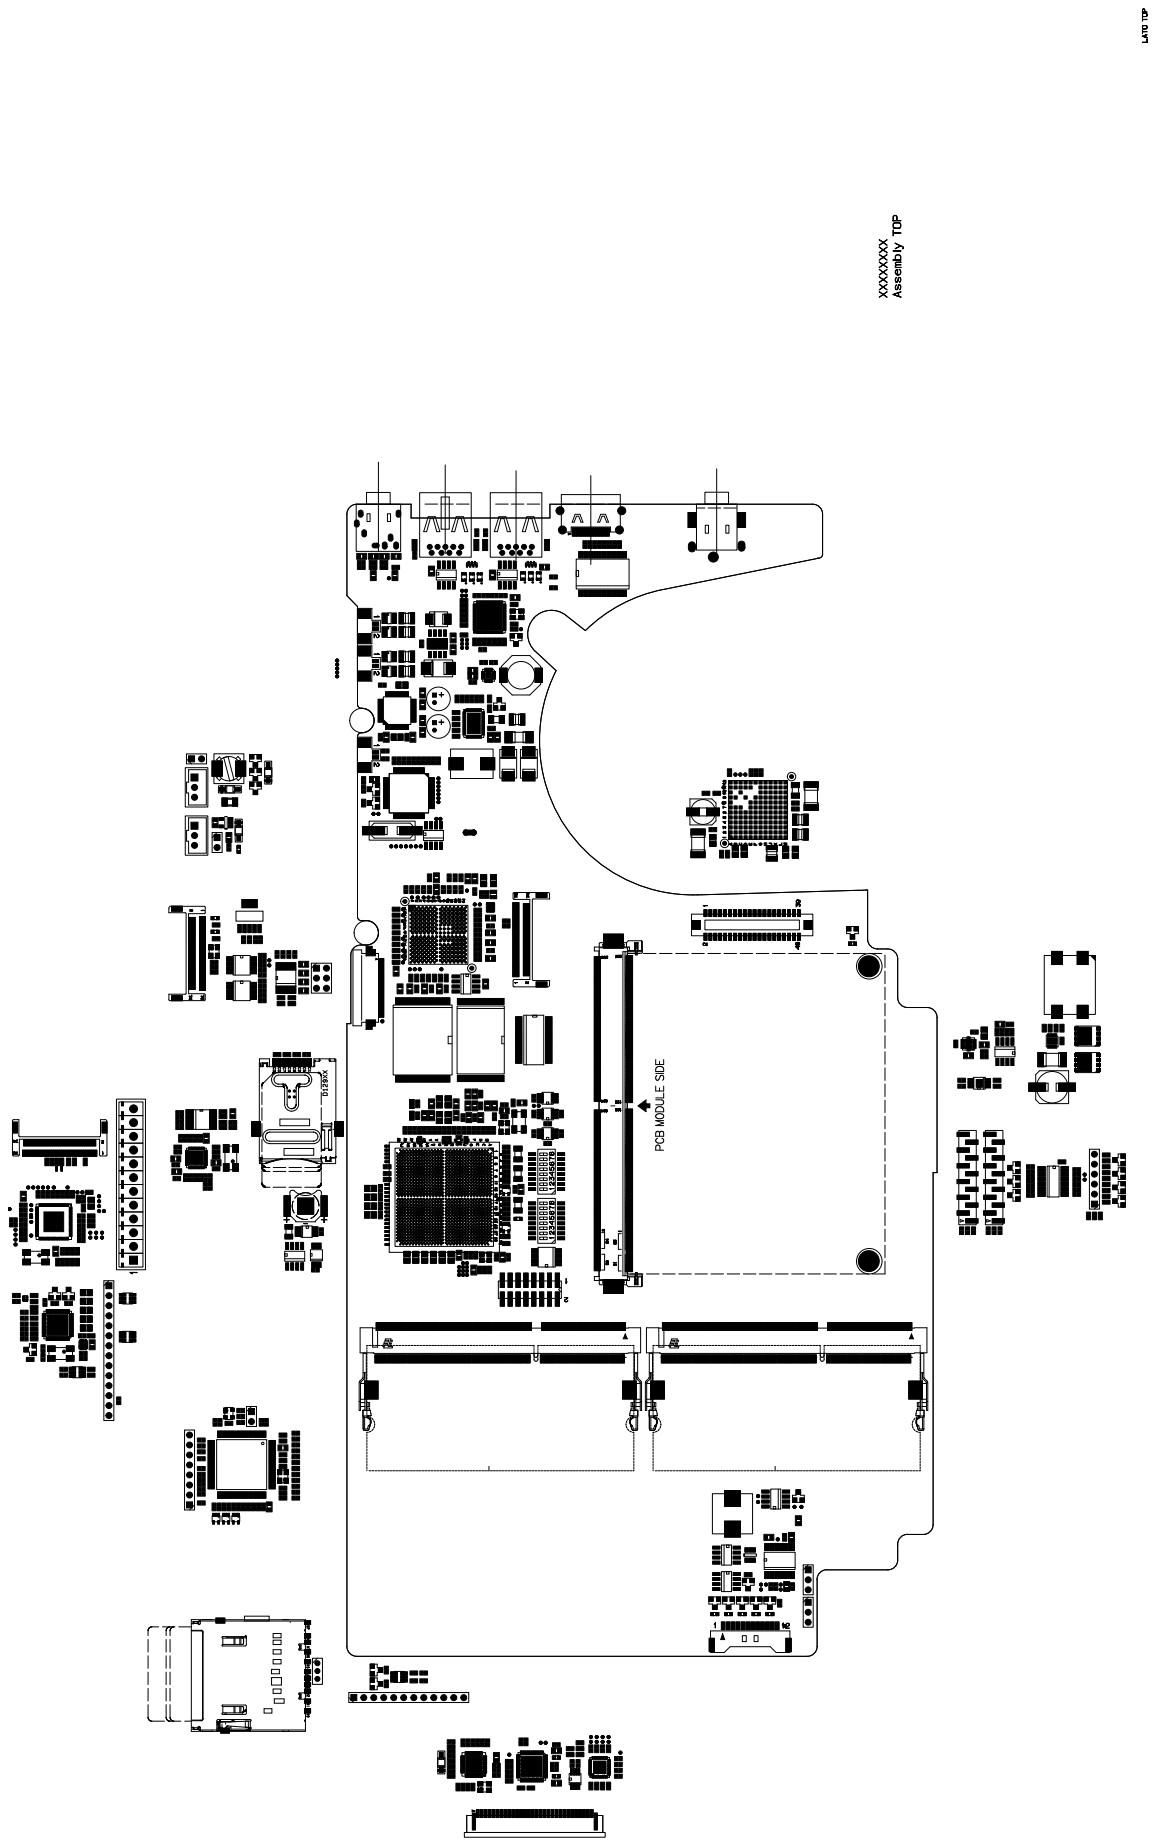
[picture p60: page 1]
LATO TOP; XXXXXXXX; Assembly TOP

PCB MODULE SIDE

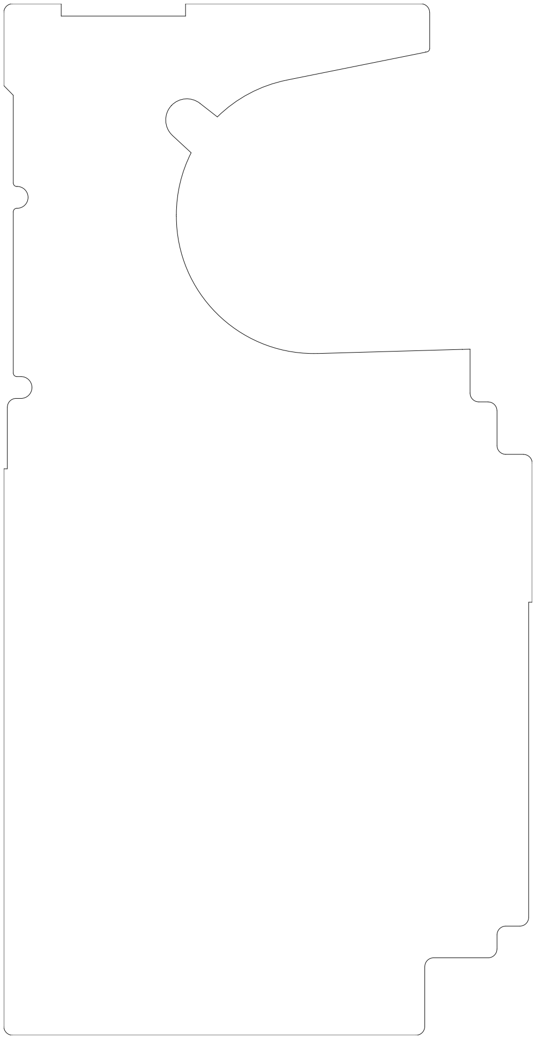
[picture p61: figure]
