unofficialImportFromGitlab-PPC/powerpc-laptop-mobo/PDF_design/PPC_NOTEBOOK_PCB_board_layout_notes.pdf

R735U76

CN1

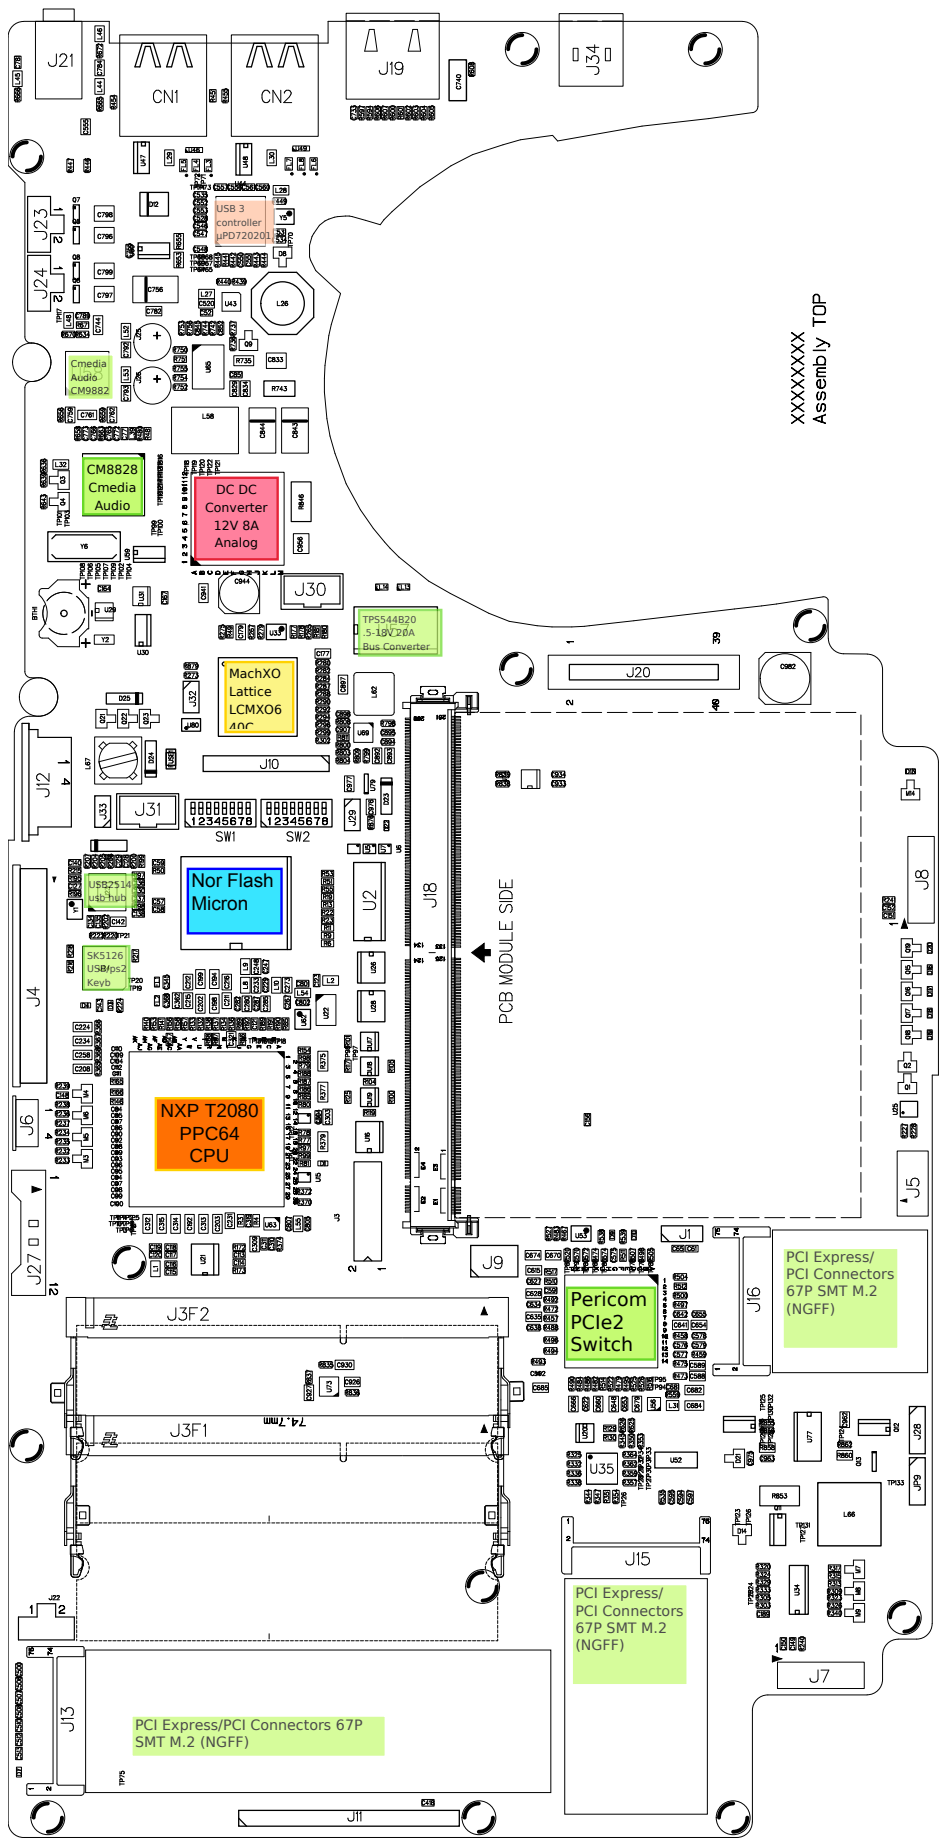
[picture p62: page 1]

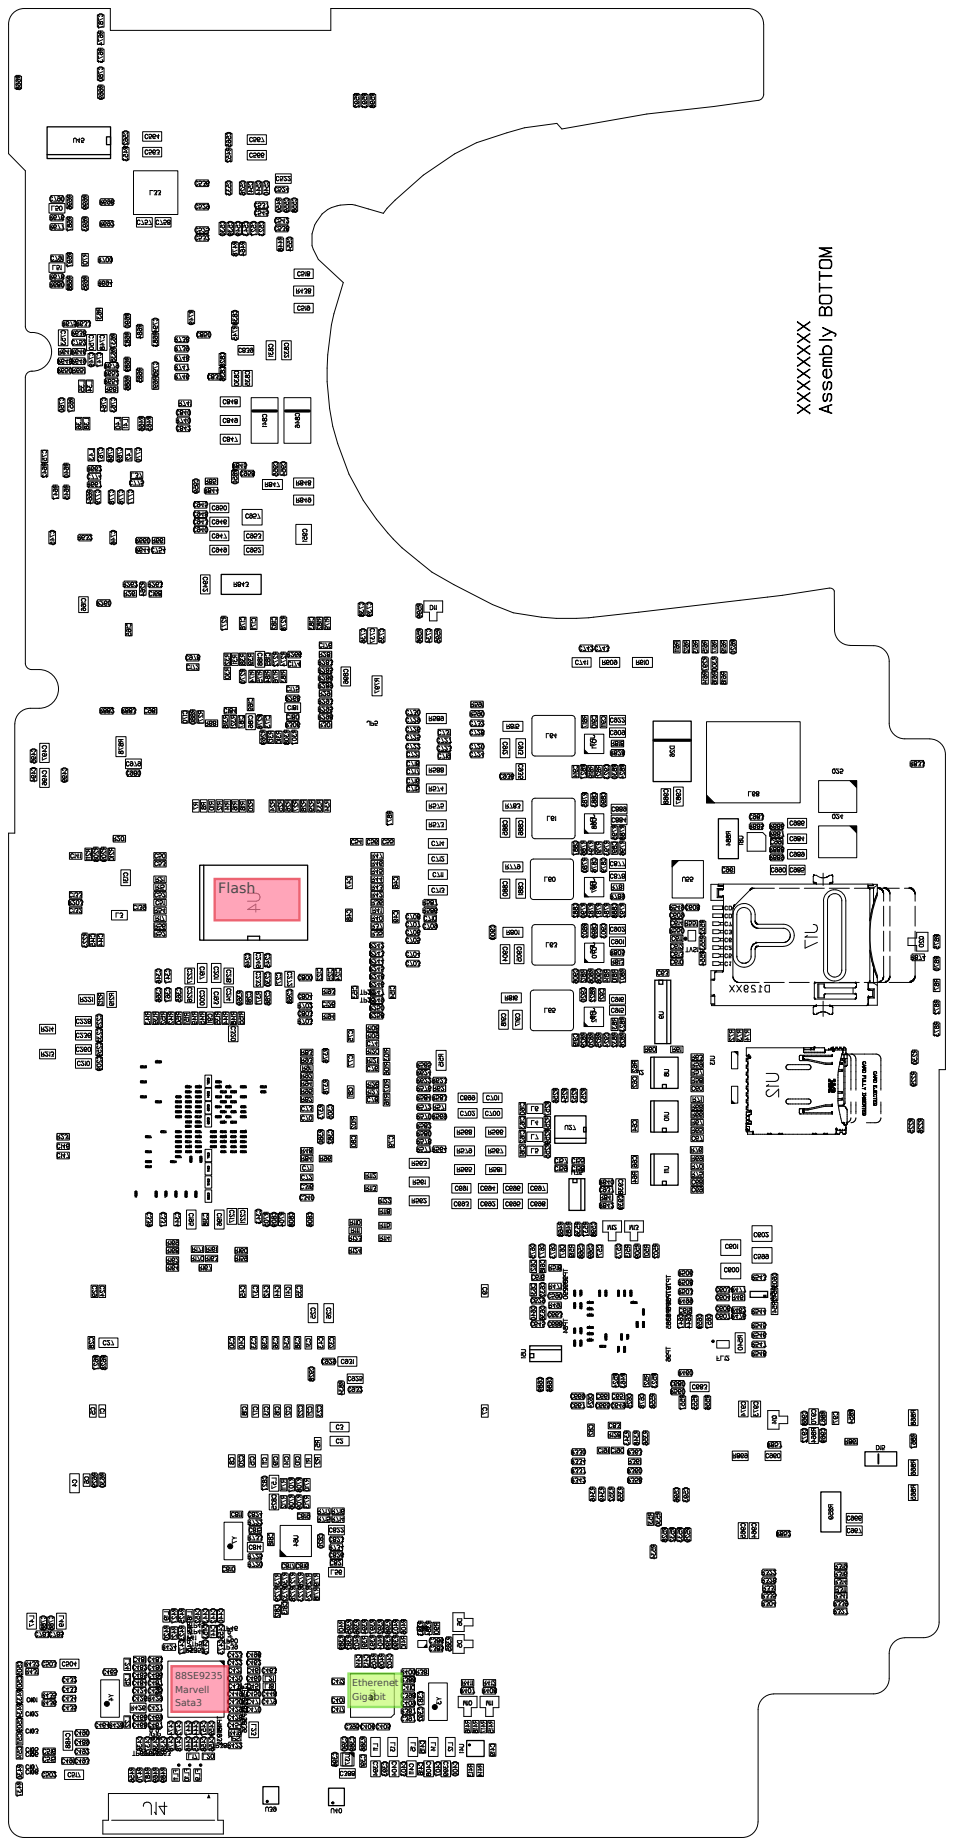
[picture p63: page 2]
