unofficialImportFromGitlab-PPC/powerpc-laptop-mobo/Xpedition/Mas100n1 ACB_0001_0/Output/PDF/Mas100n1 ACUBE_PORTABILE R_0 Montaggio.pdf

L58

C797

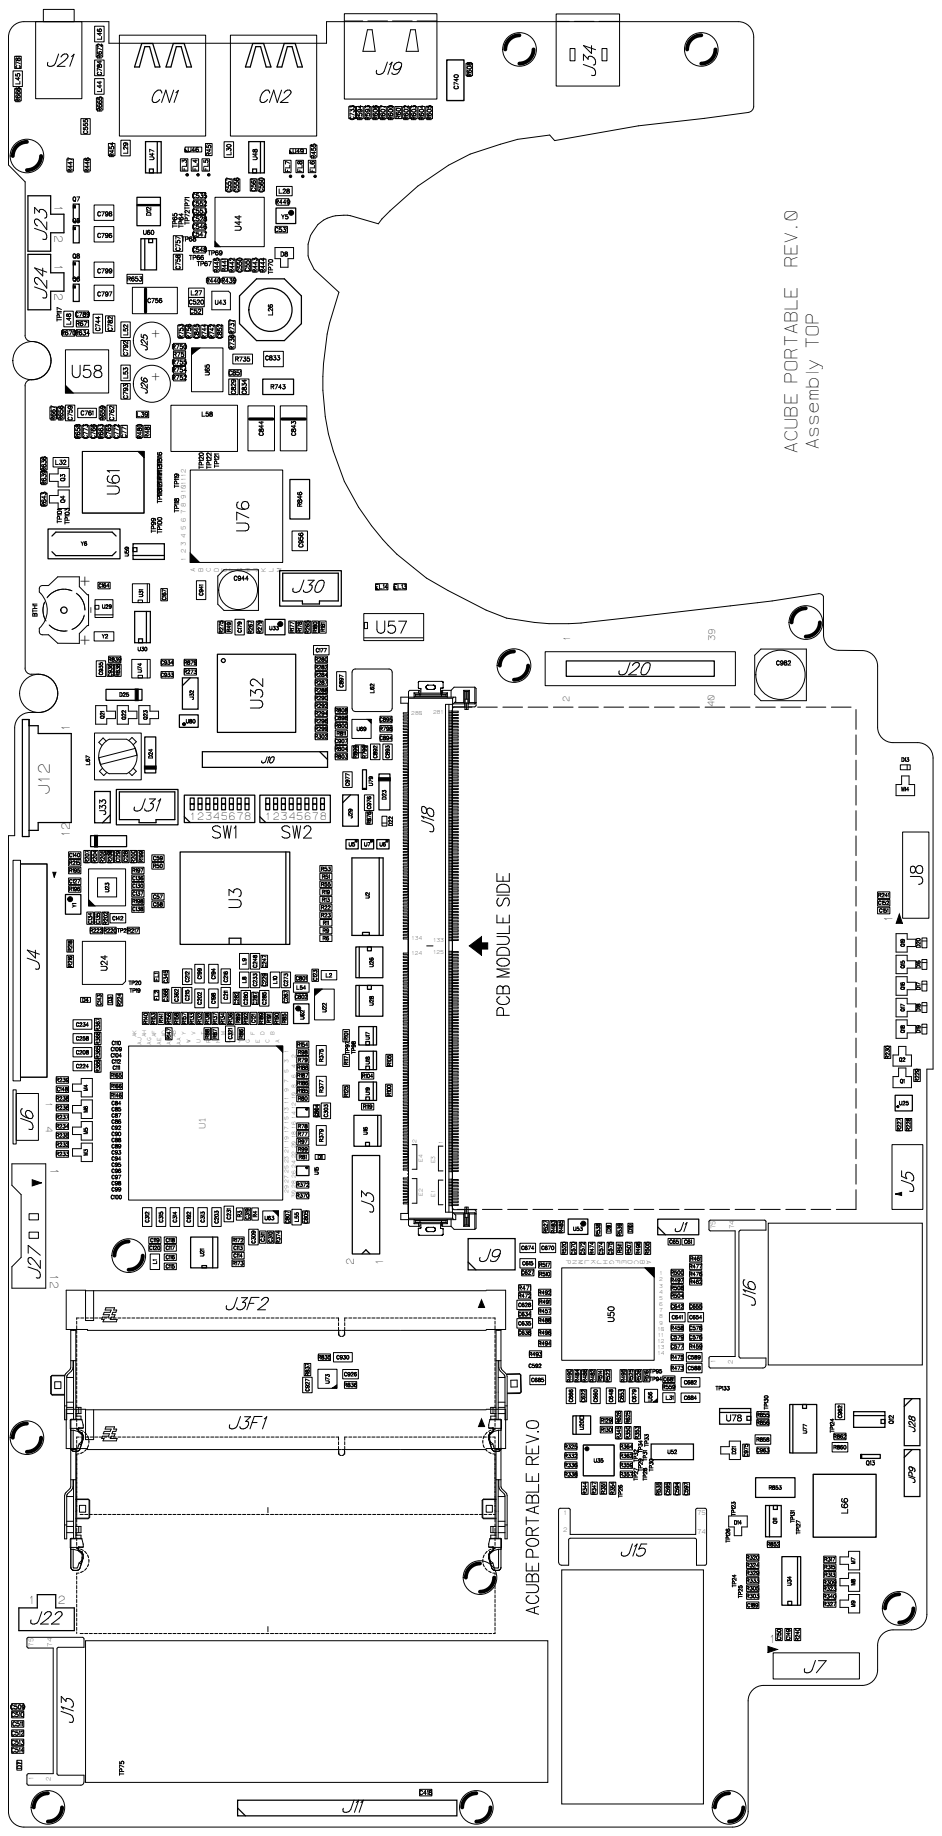
[picture p64: page 1]

R528

C967

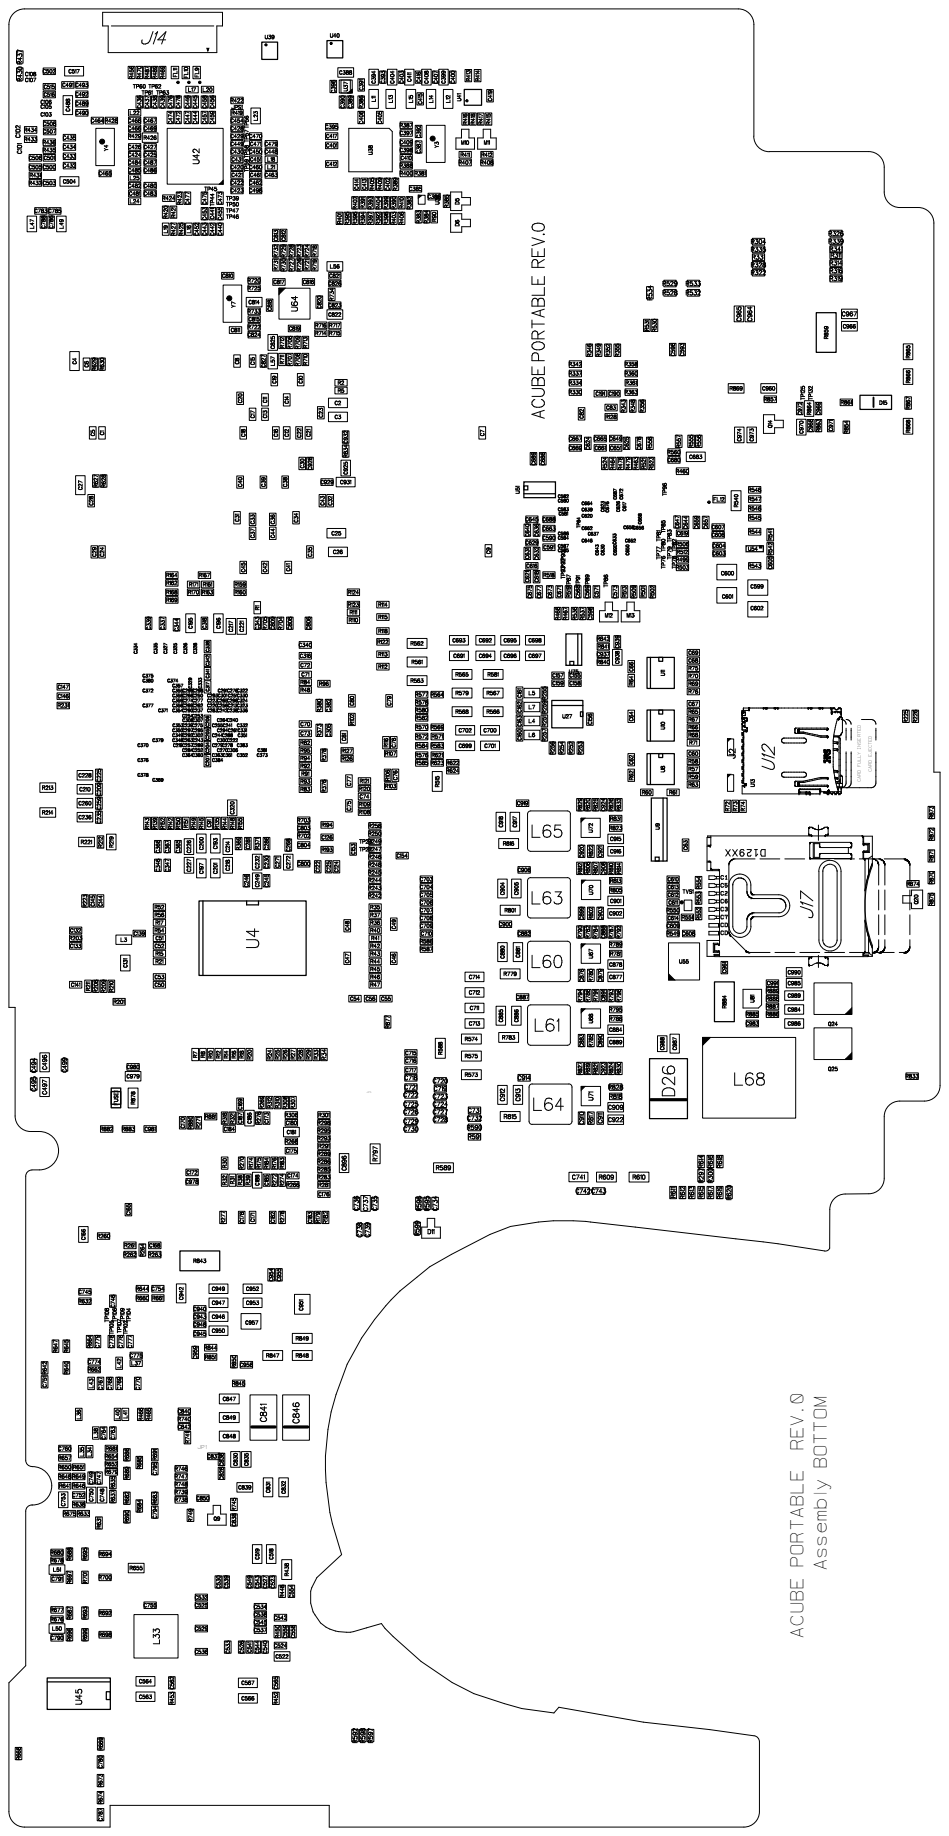
[picture p65: page 2]
