unofficialImportFromGitlab-PPC/powerpc-laptop-mobo/Xpedition/Mas100n1 ACB_0001_0/Output/PDF/Mas100n1 ACUBE_PORTABILE R_0.pdf

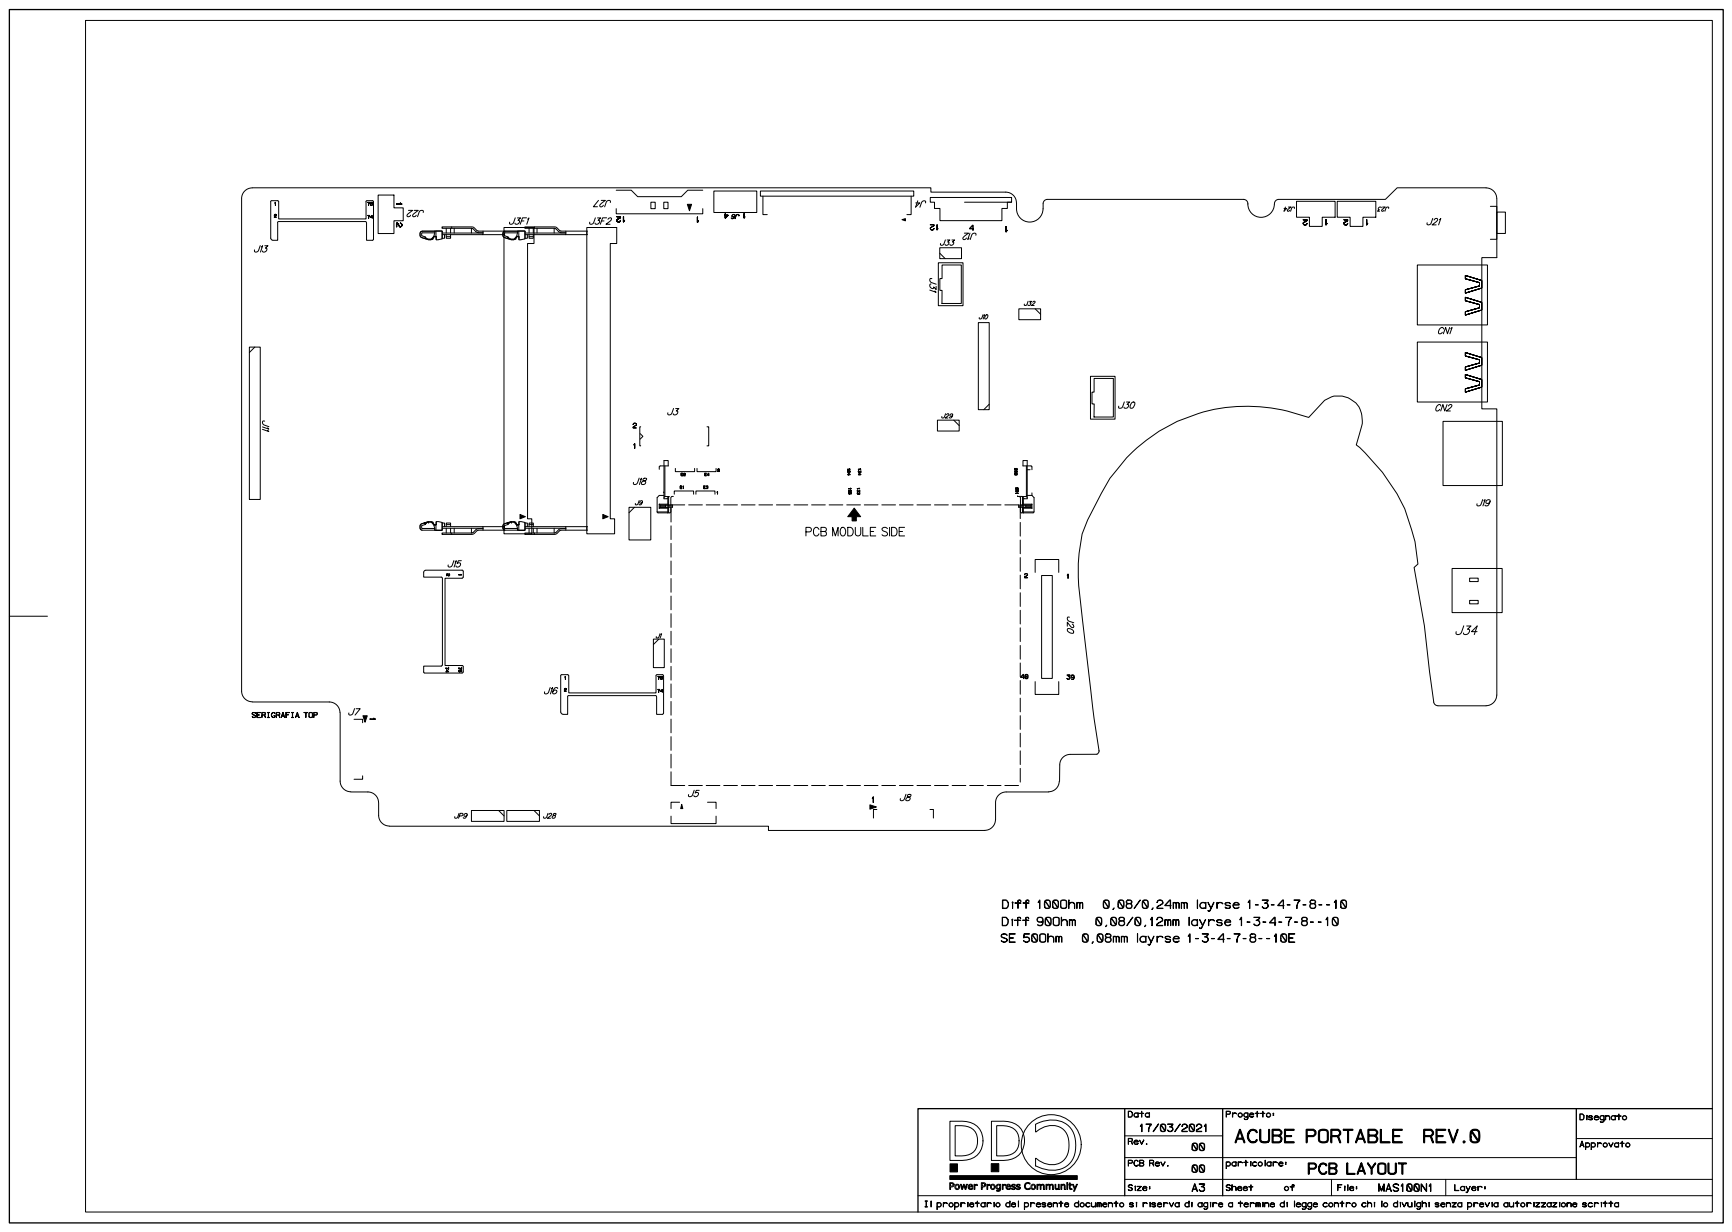
[picture p66: page 1]

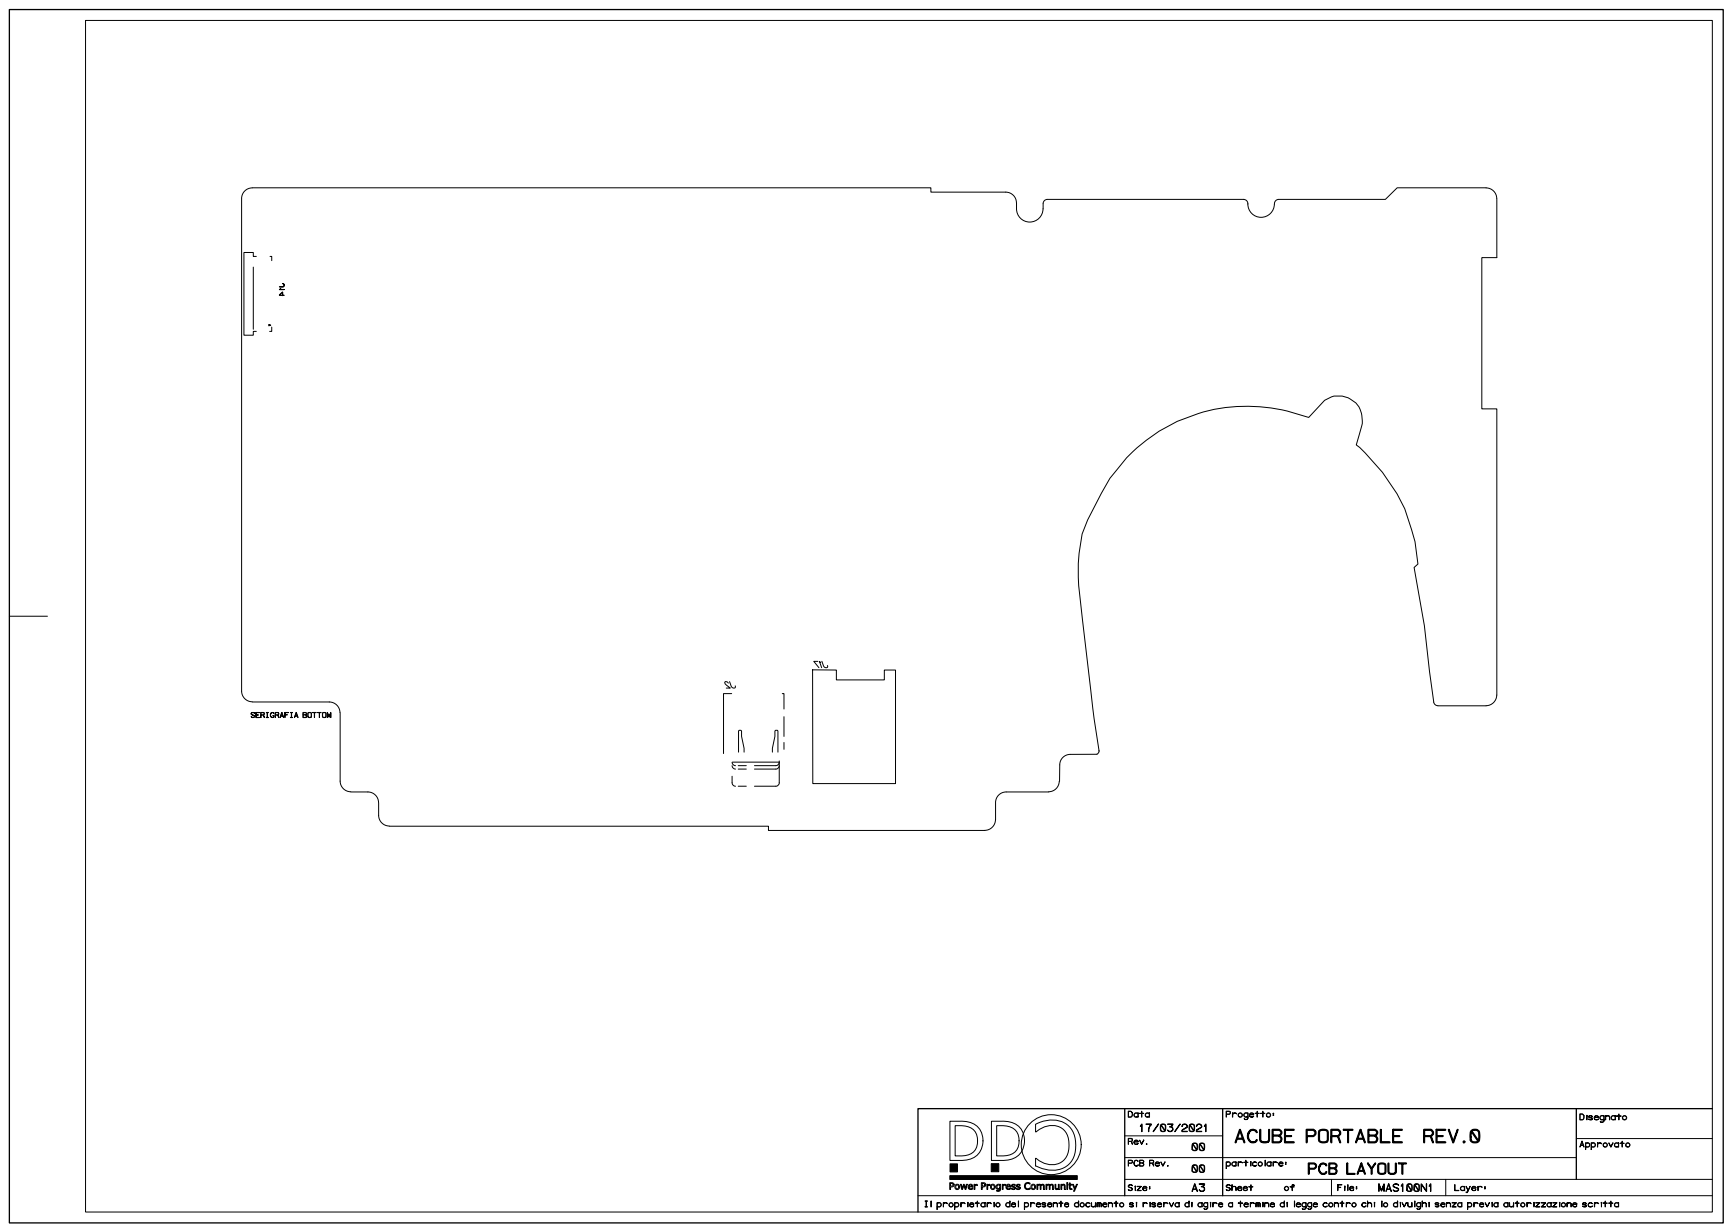
[picture p67: page 2]

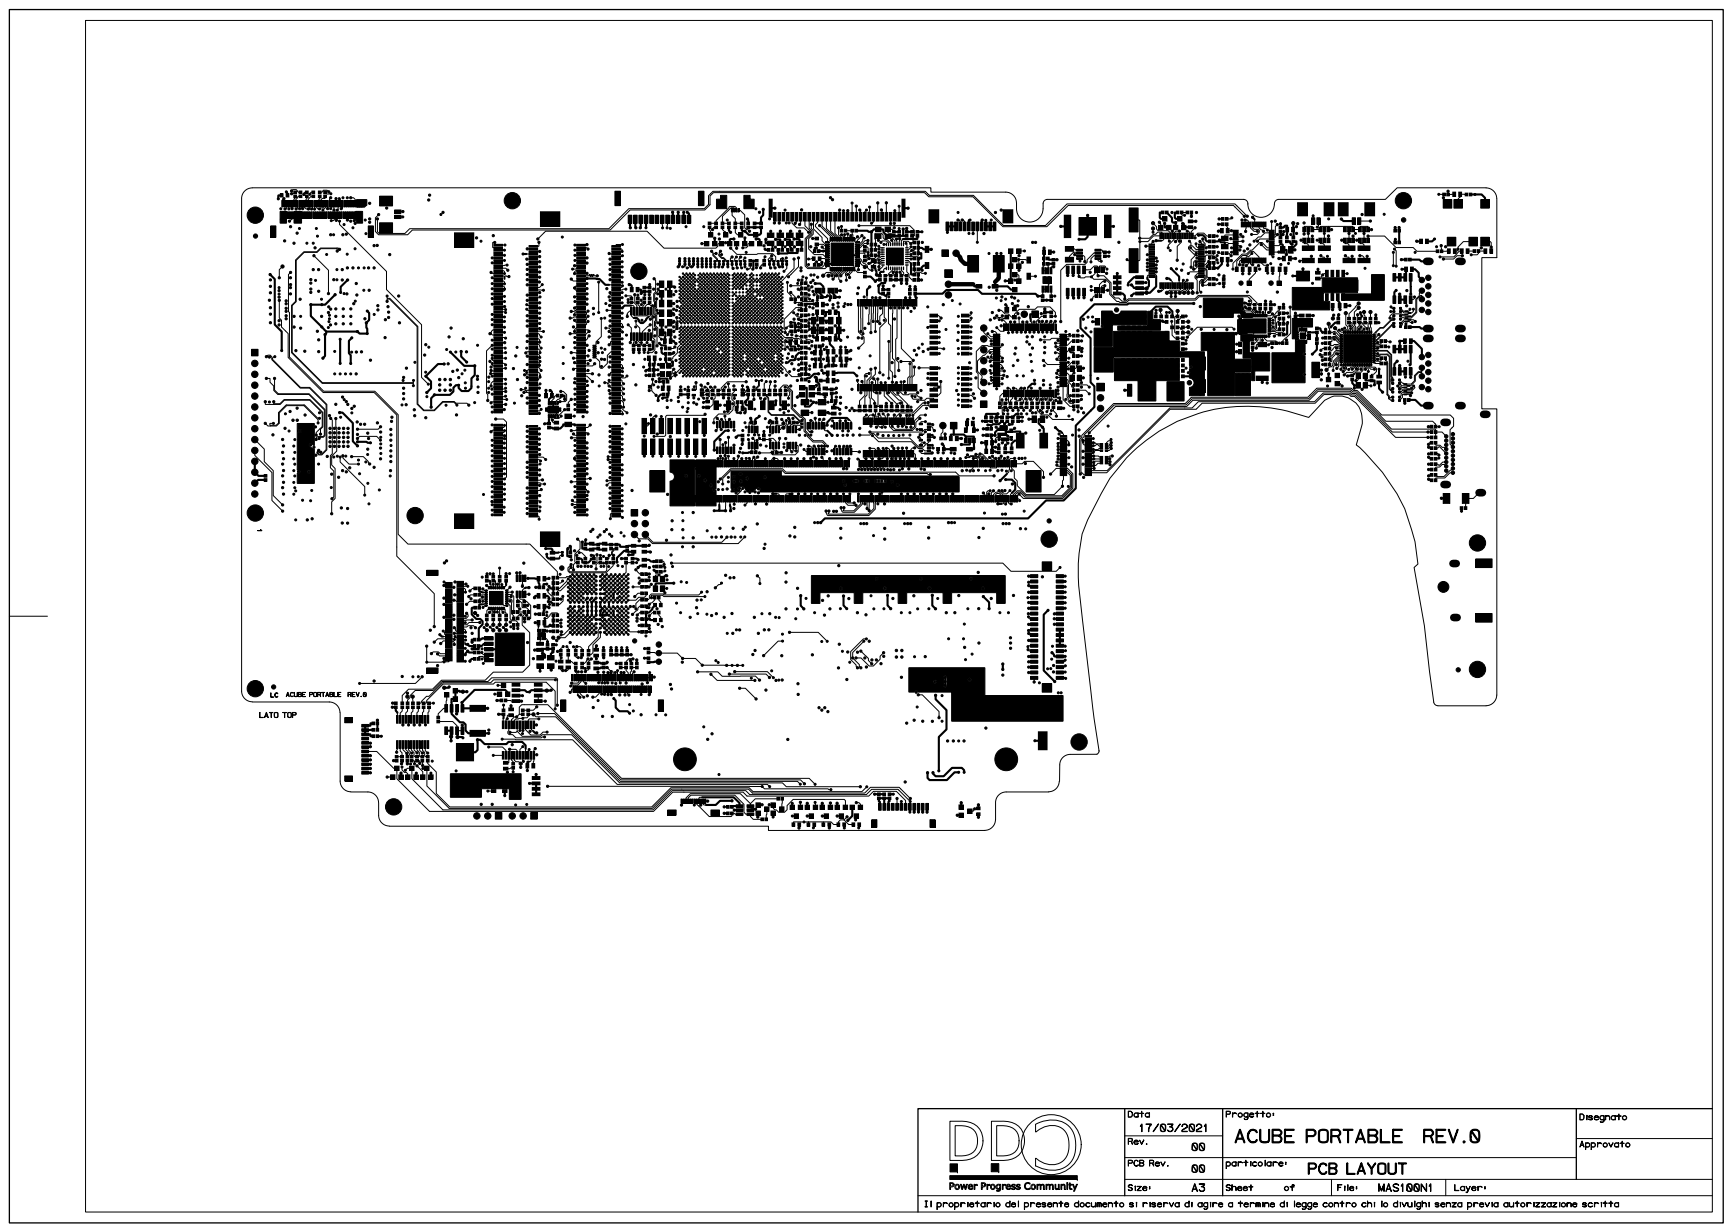
[picture p68: page 3]

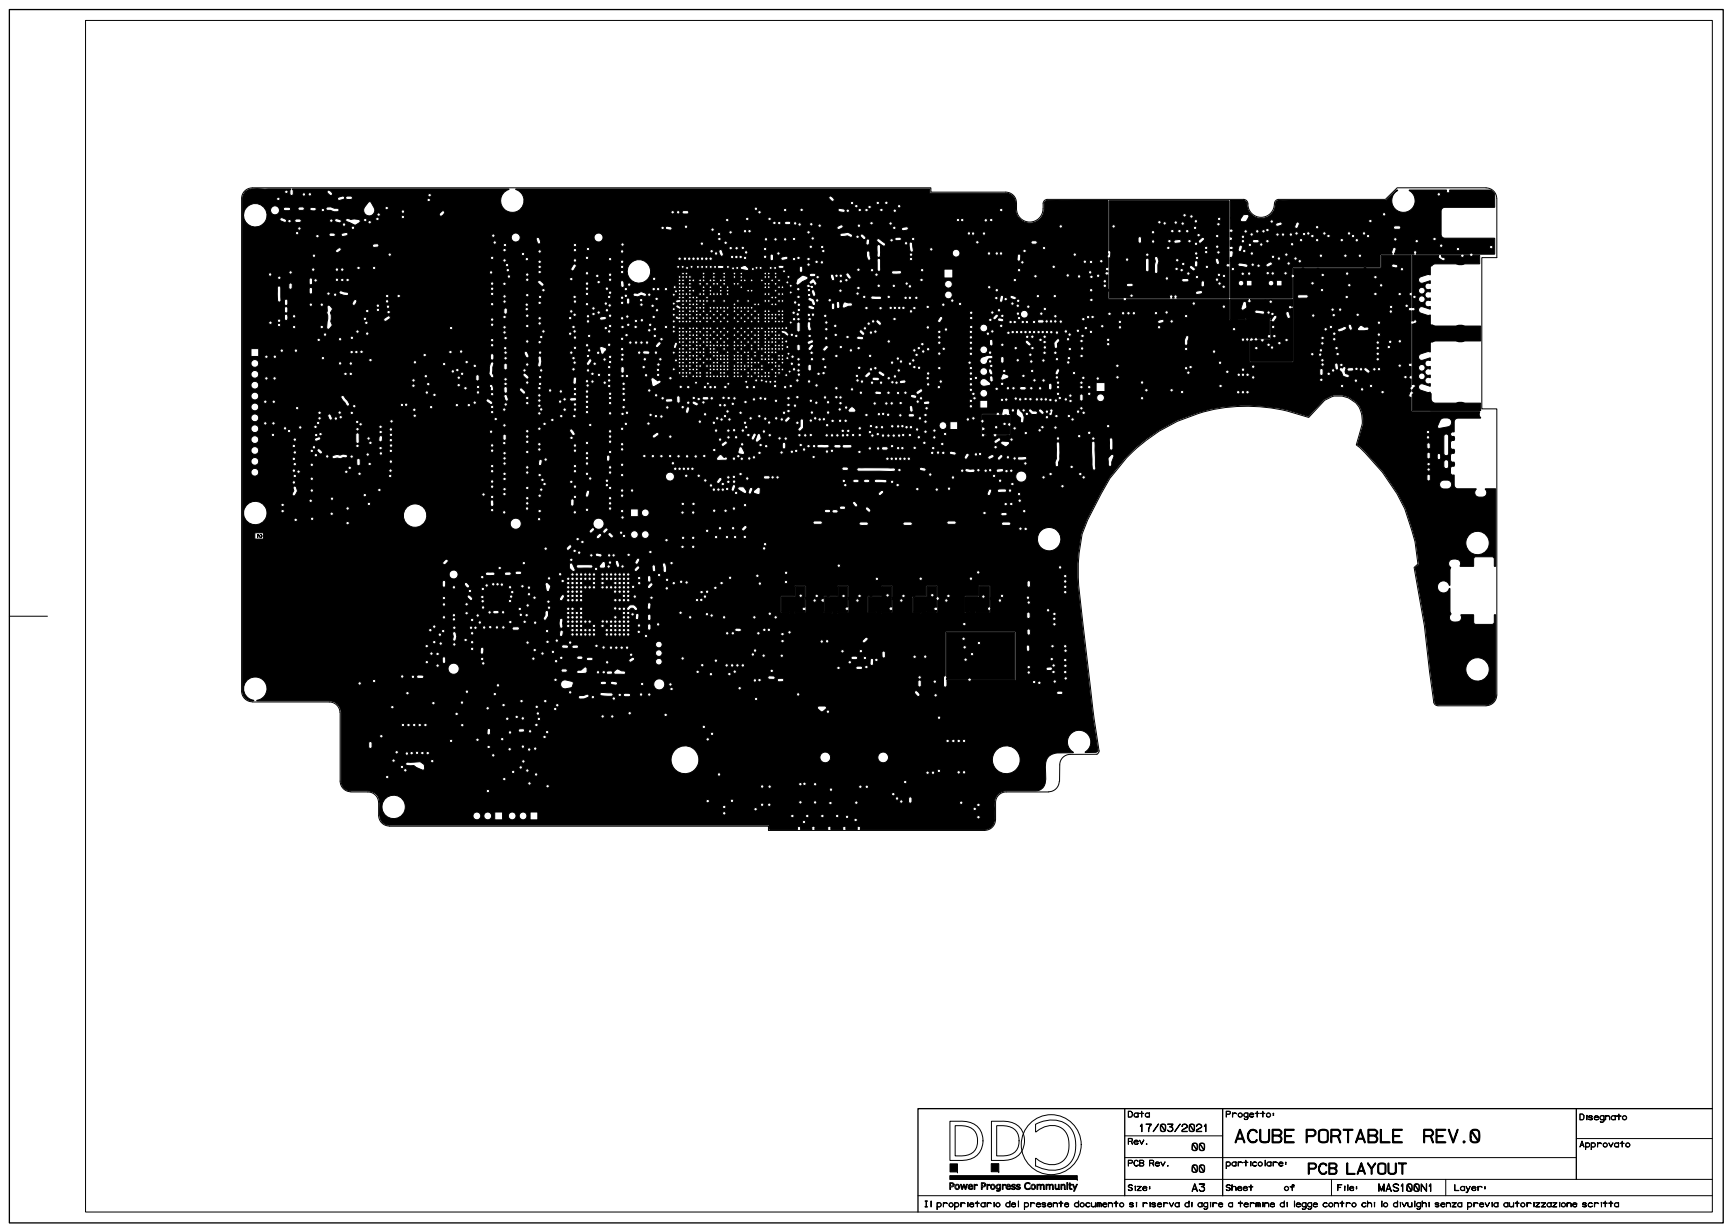
[picture p69: page 4]

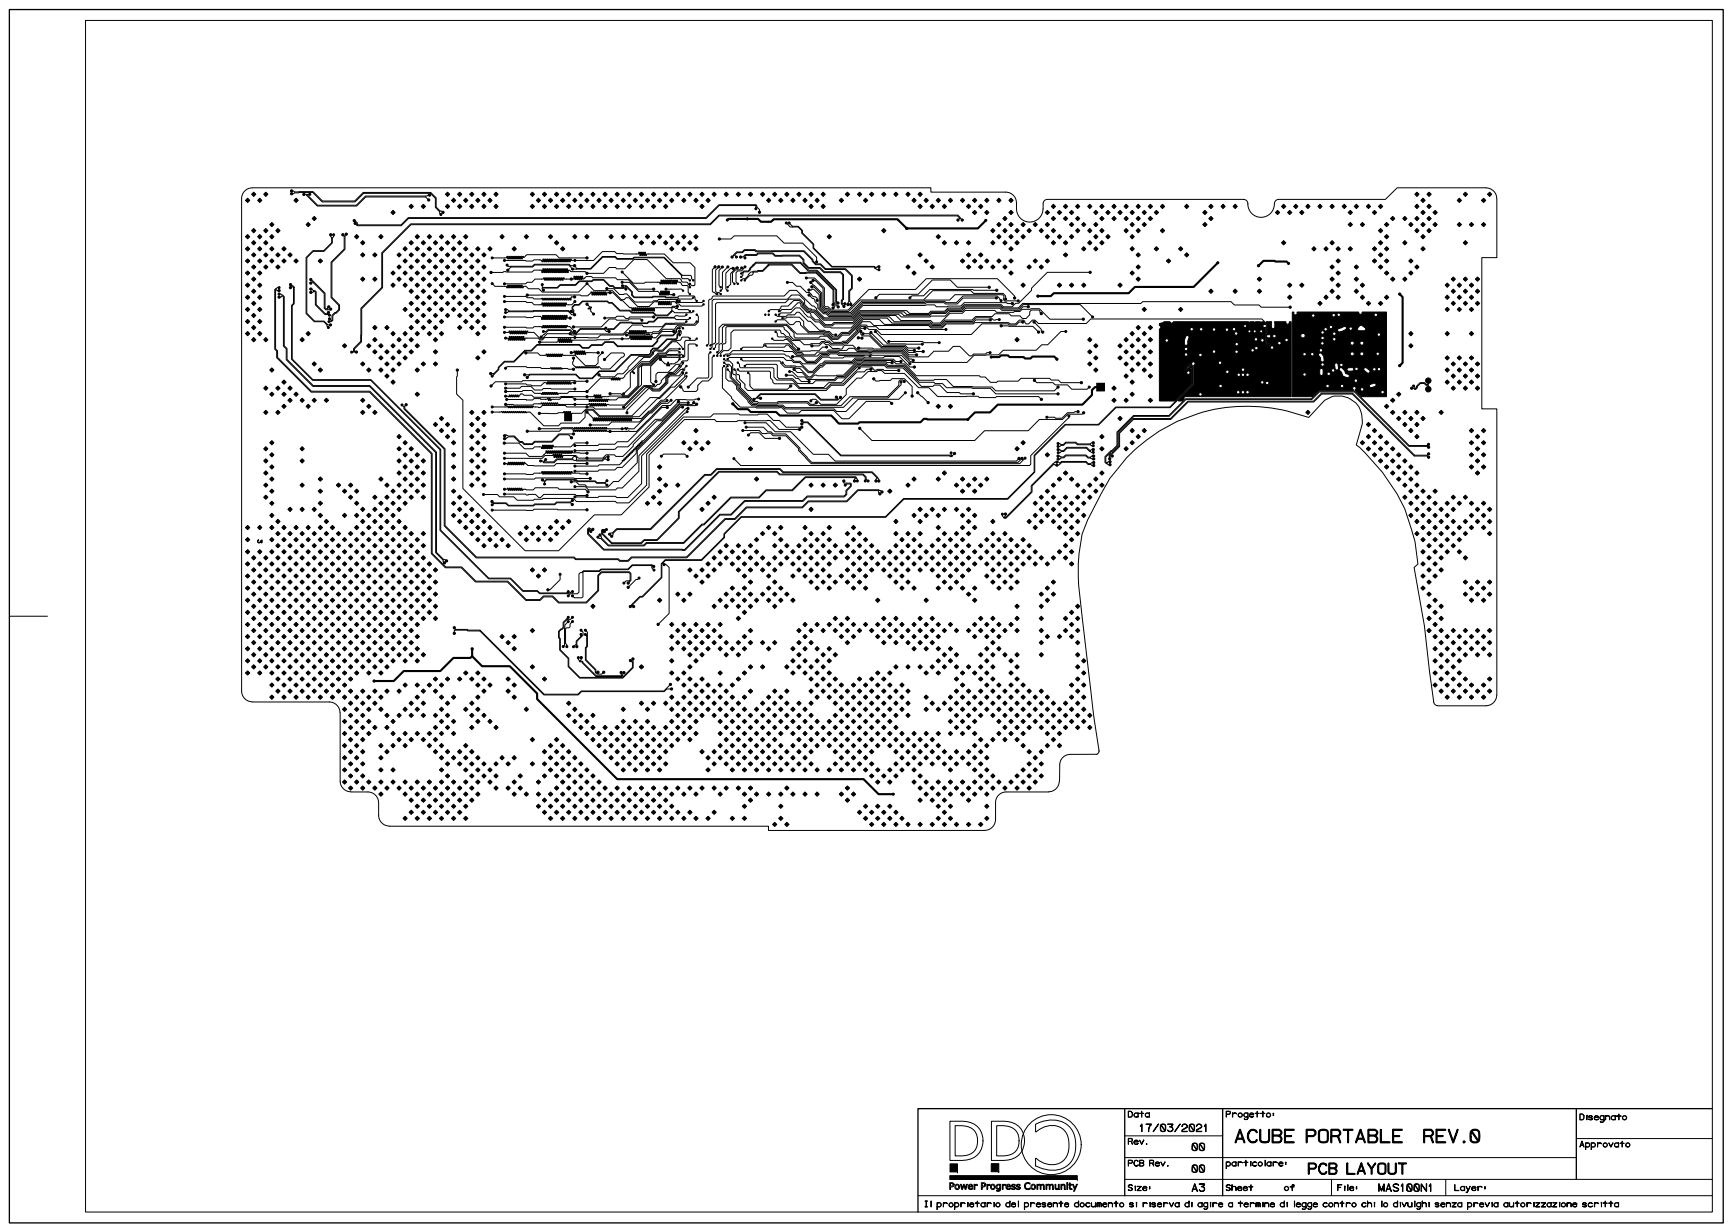
[picture p70: page 5]

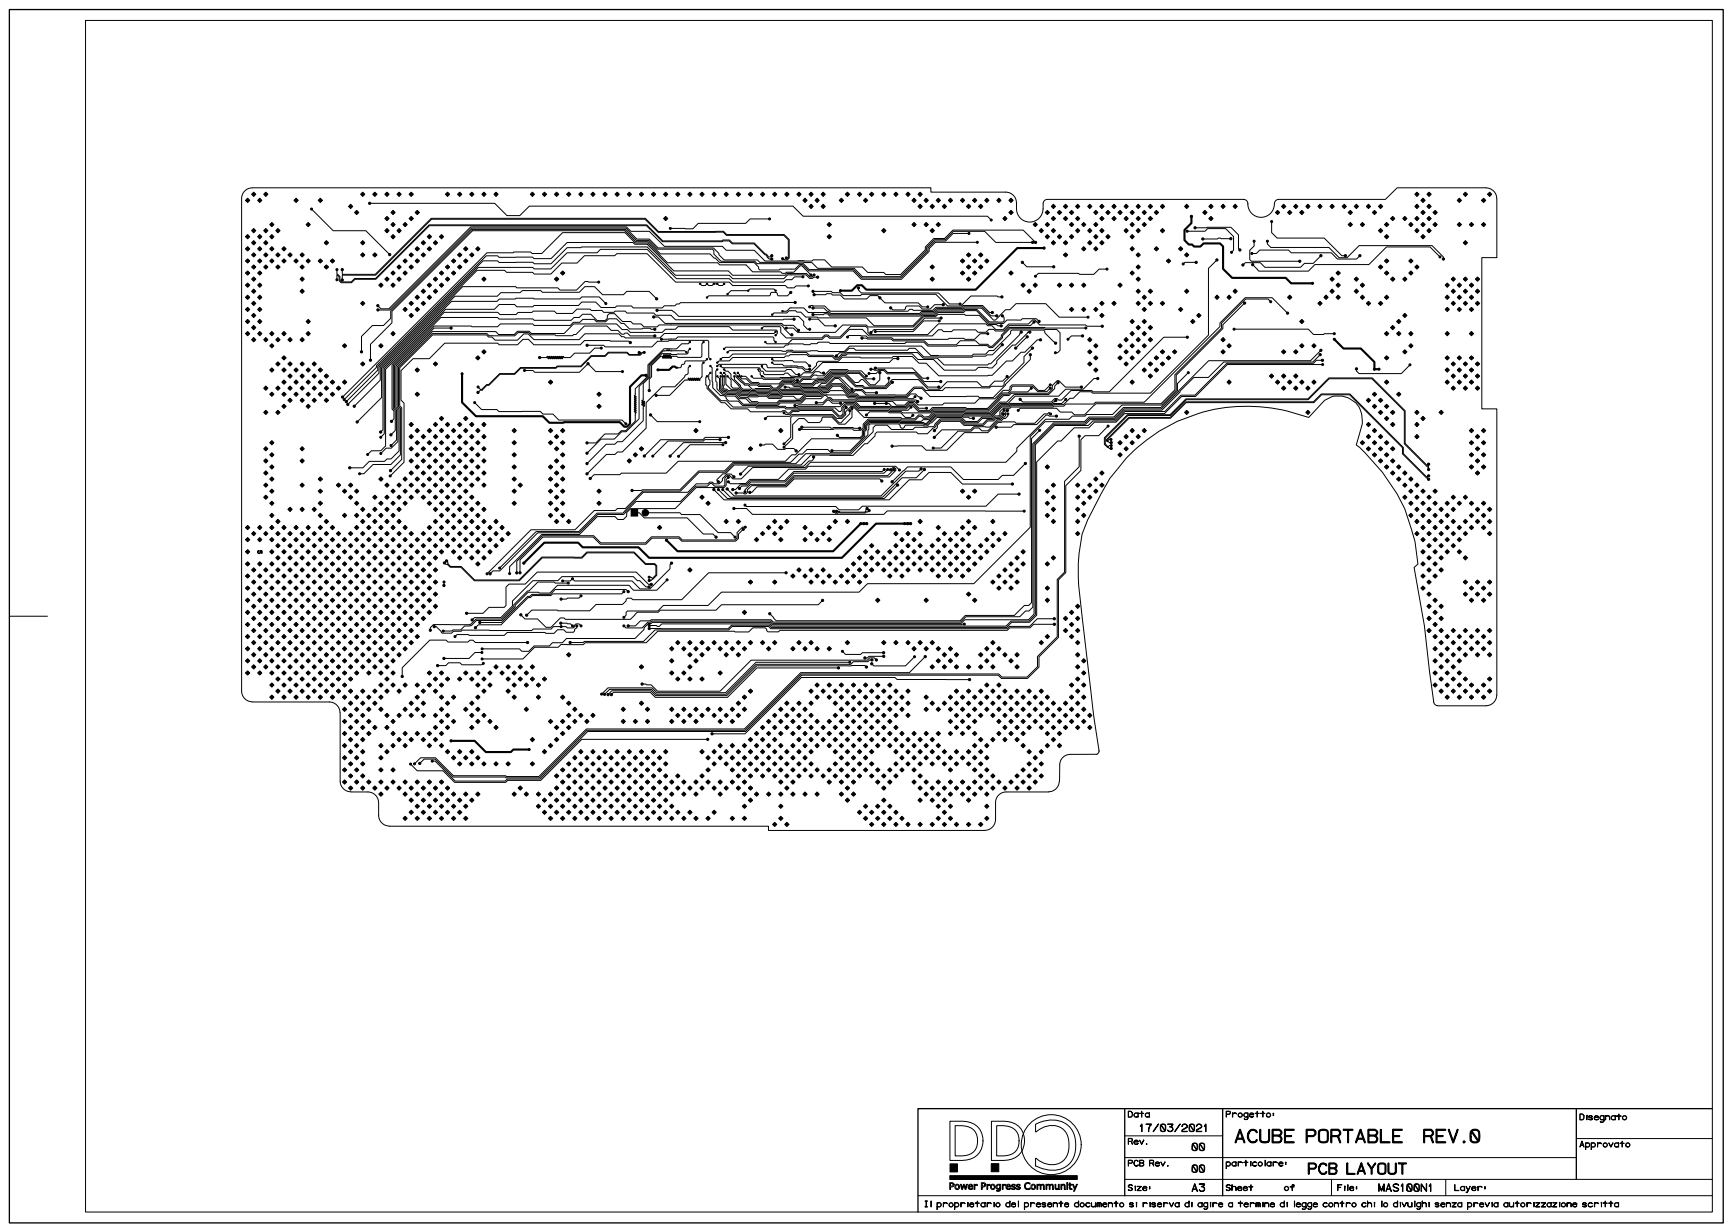
[picture p71: page 6]

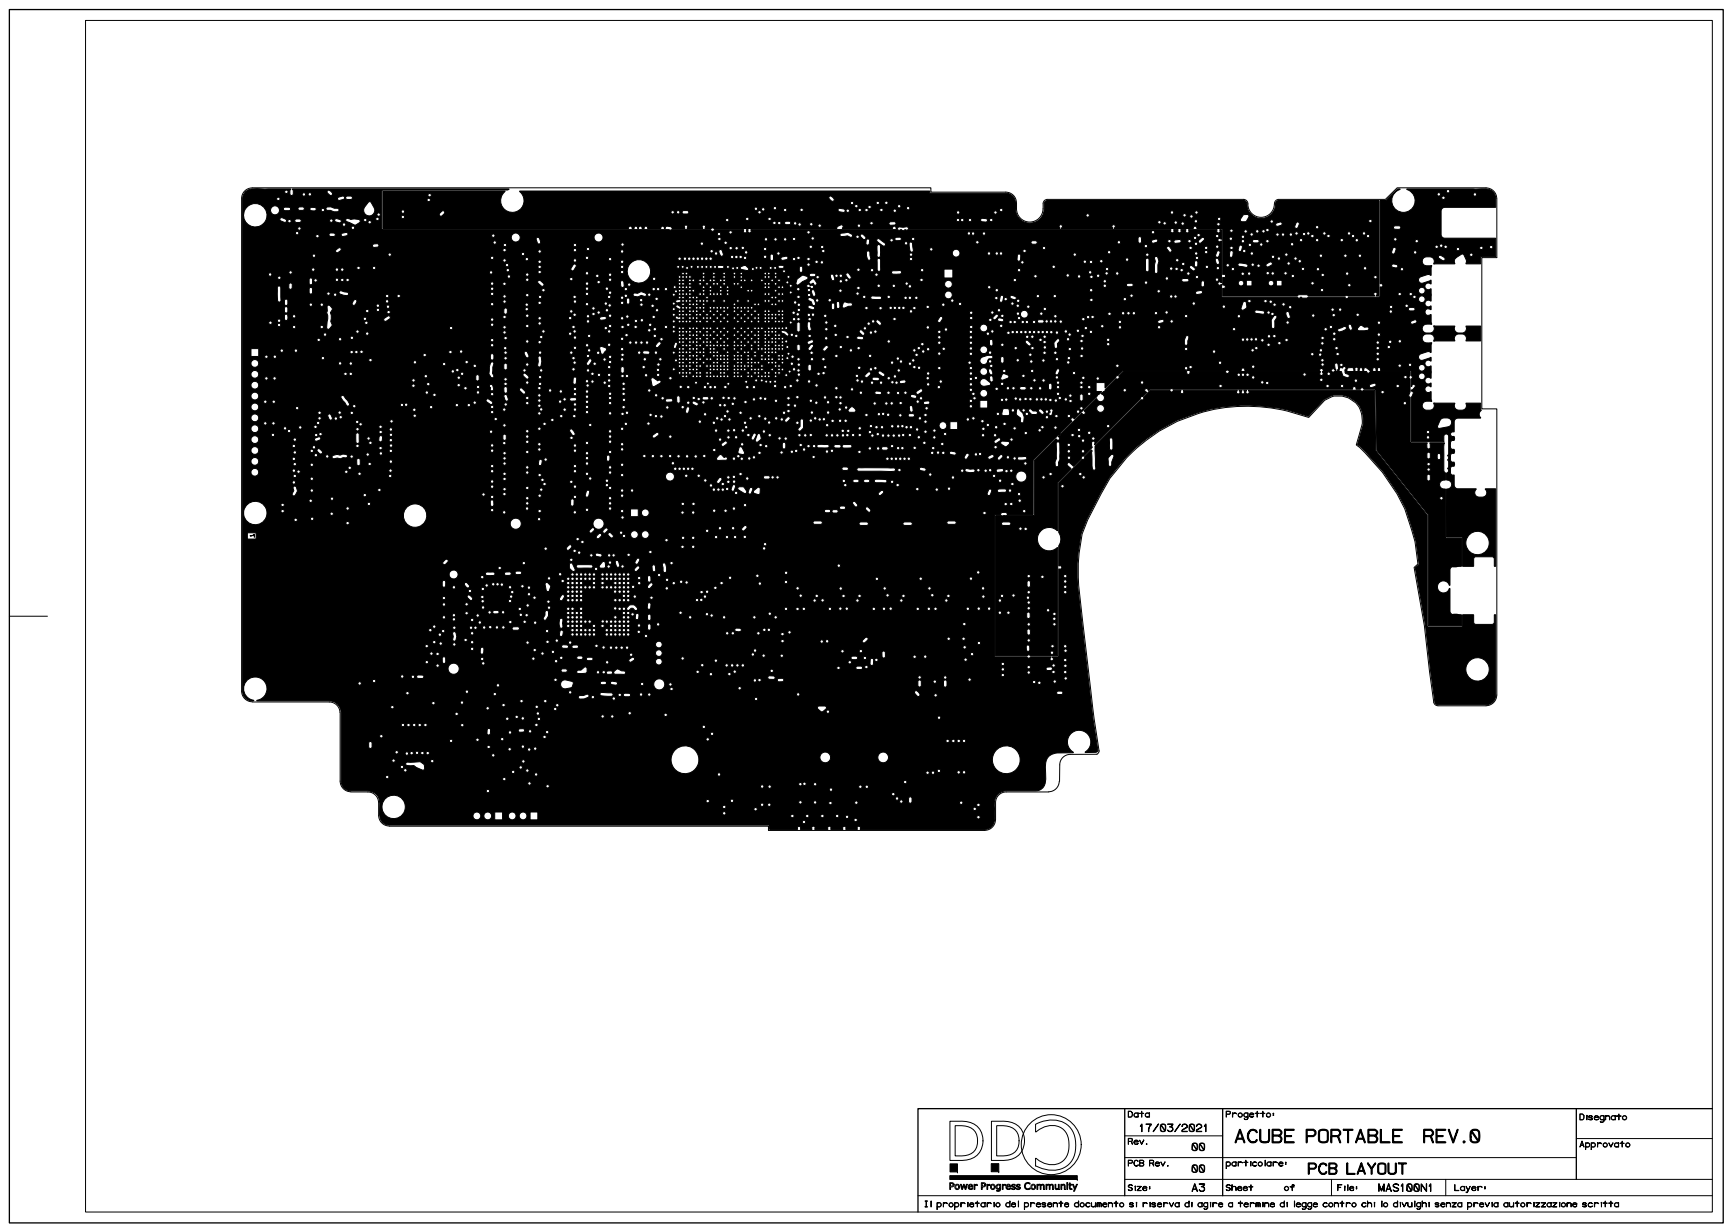
[picture p72: page 7]

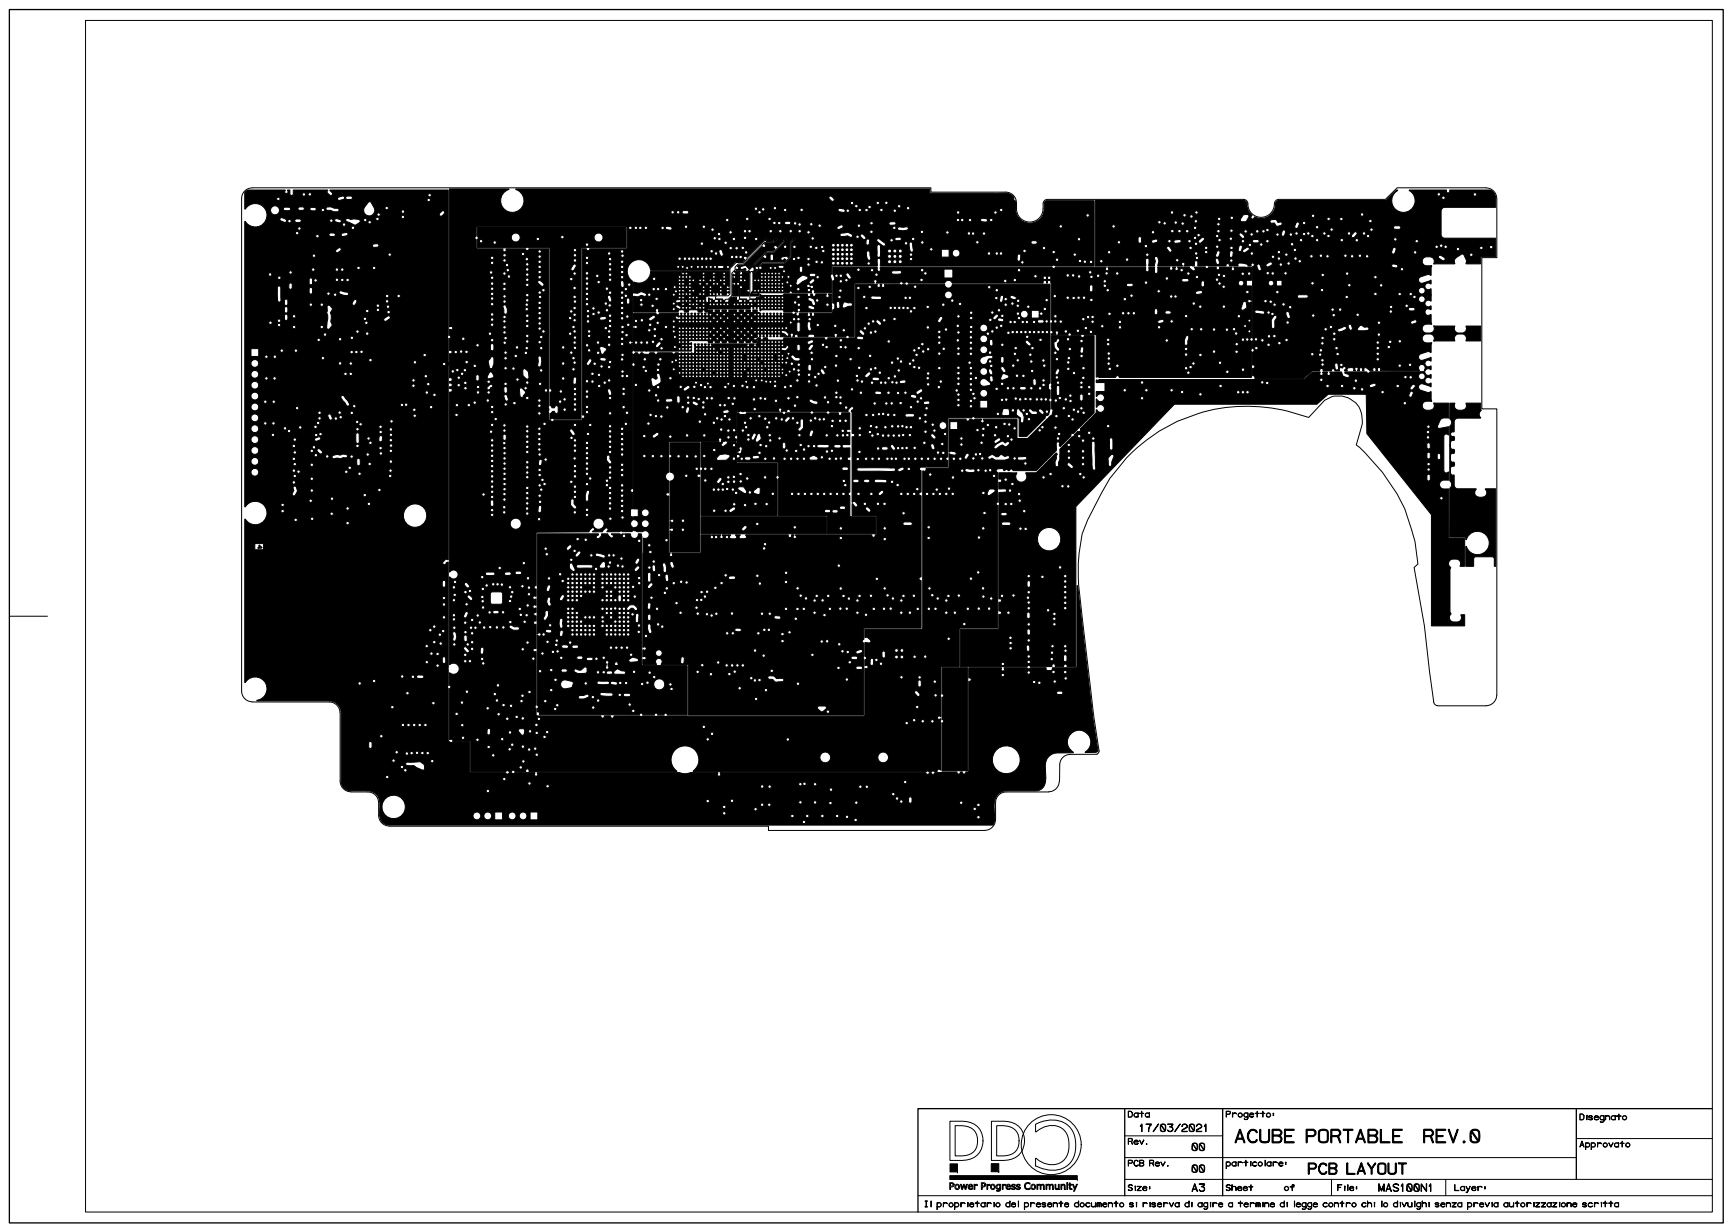
[picture p73: page 8]

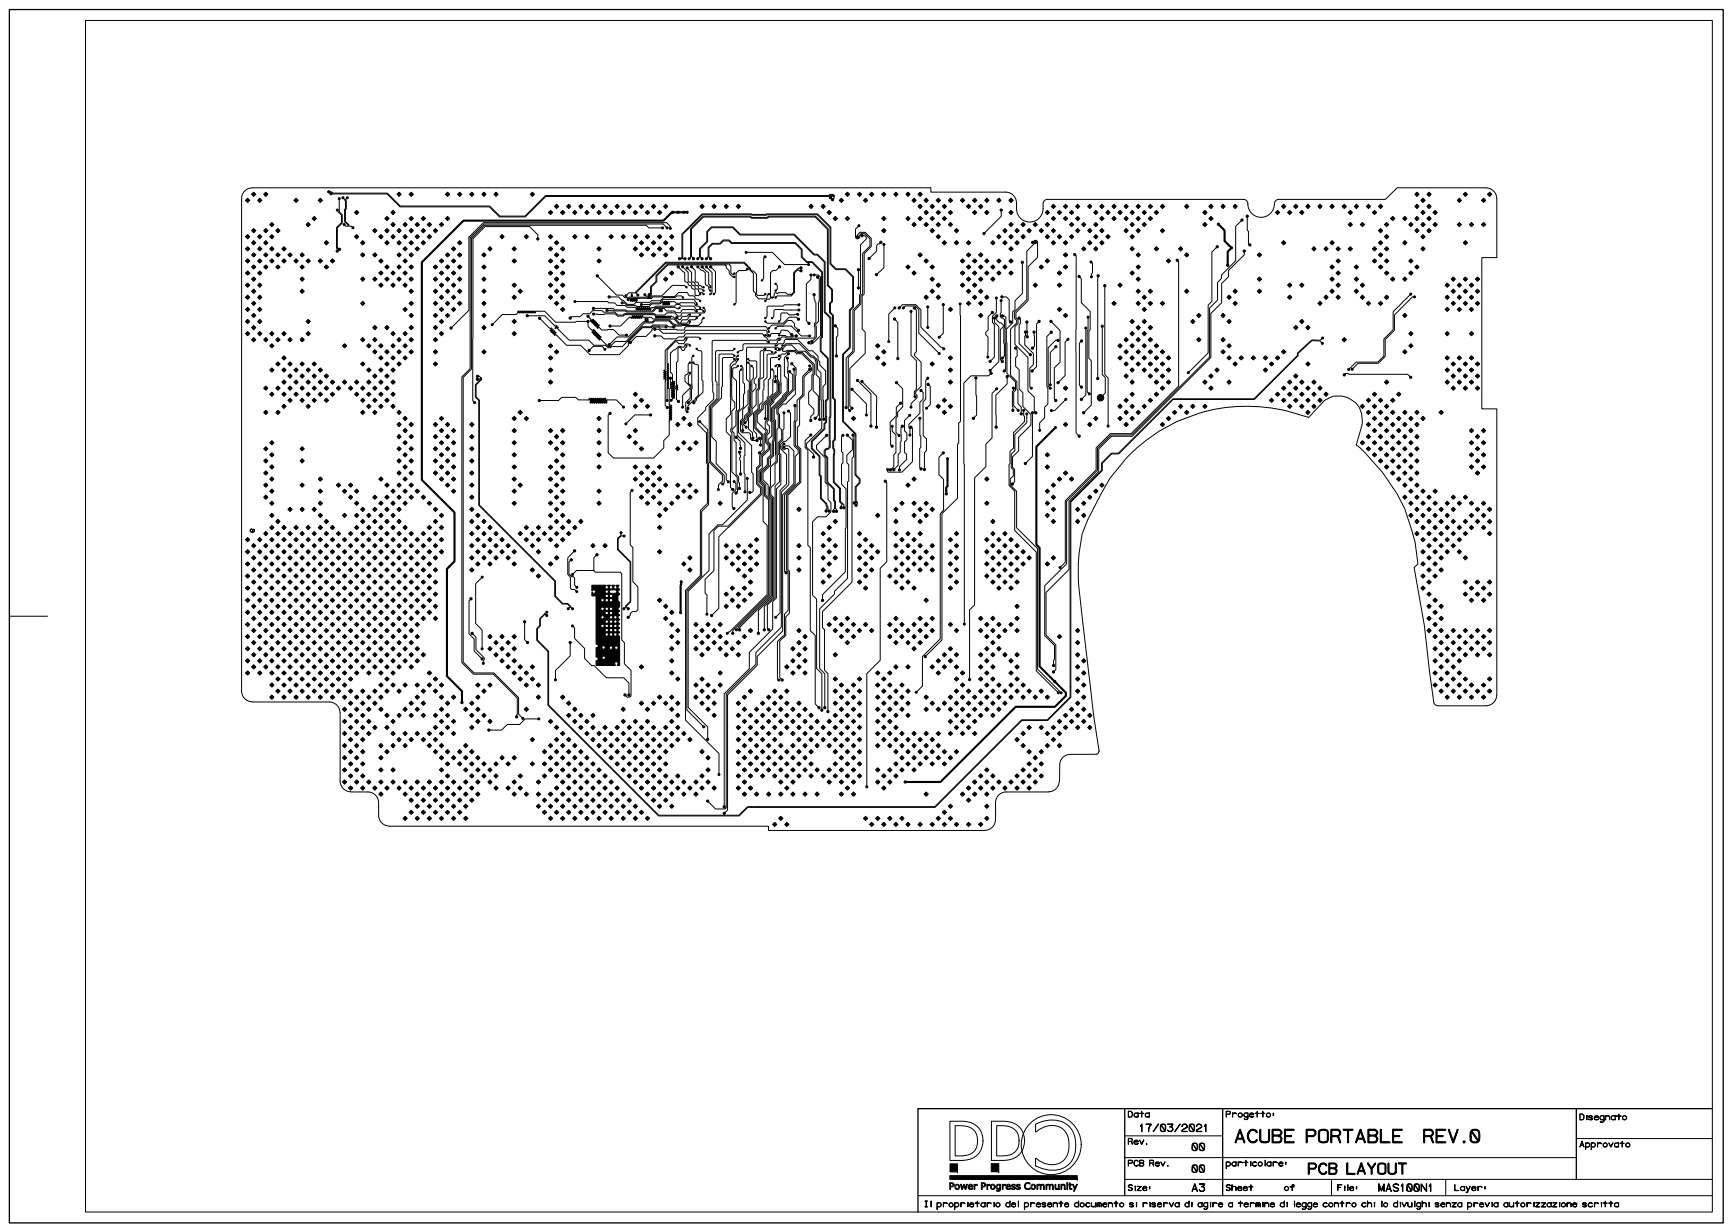
[picture p74: page 9]

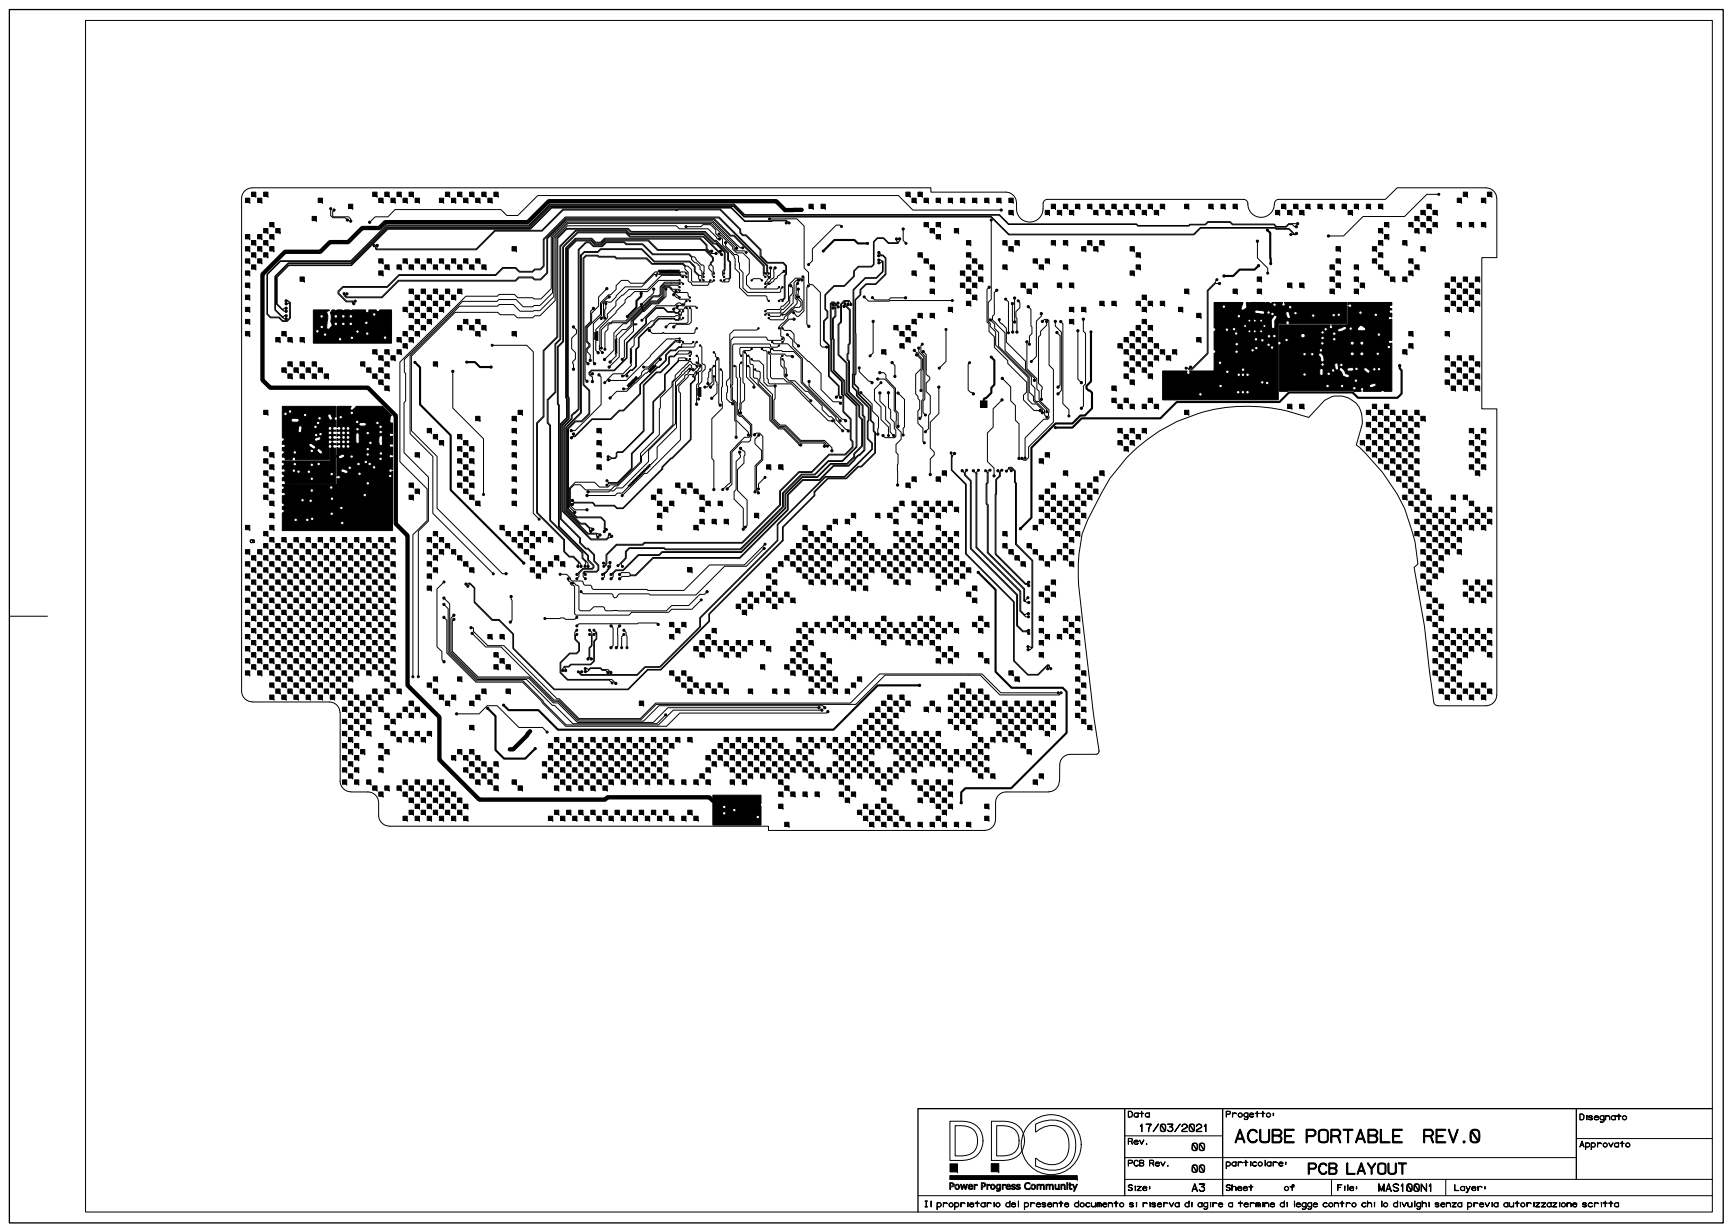
[picture p75: page 10]

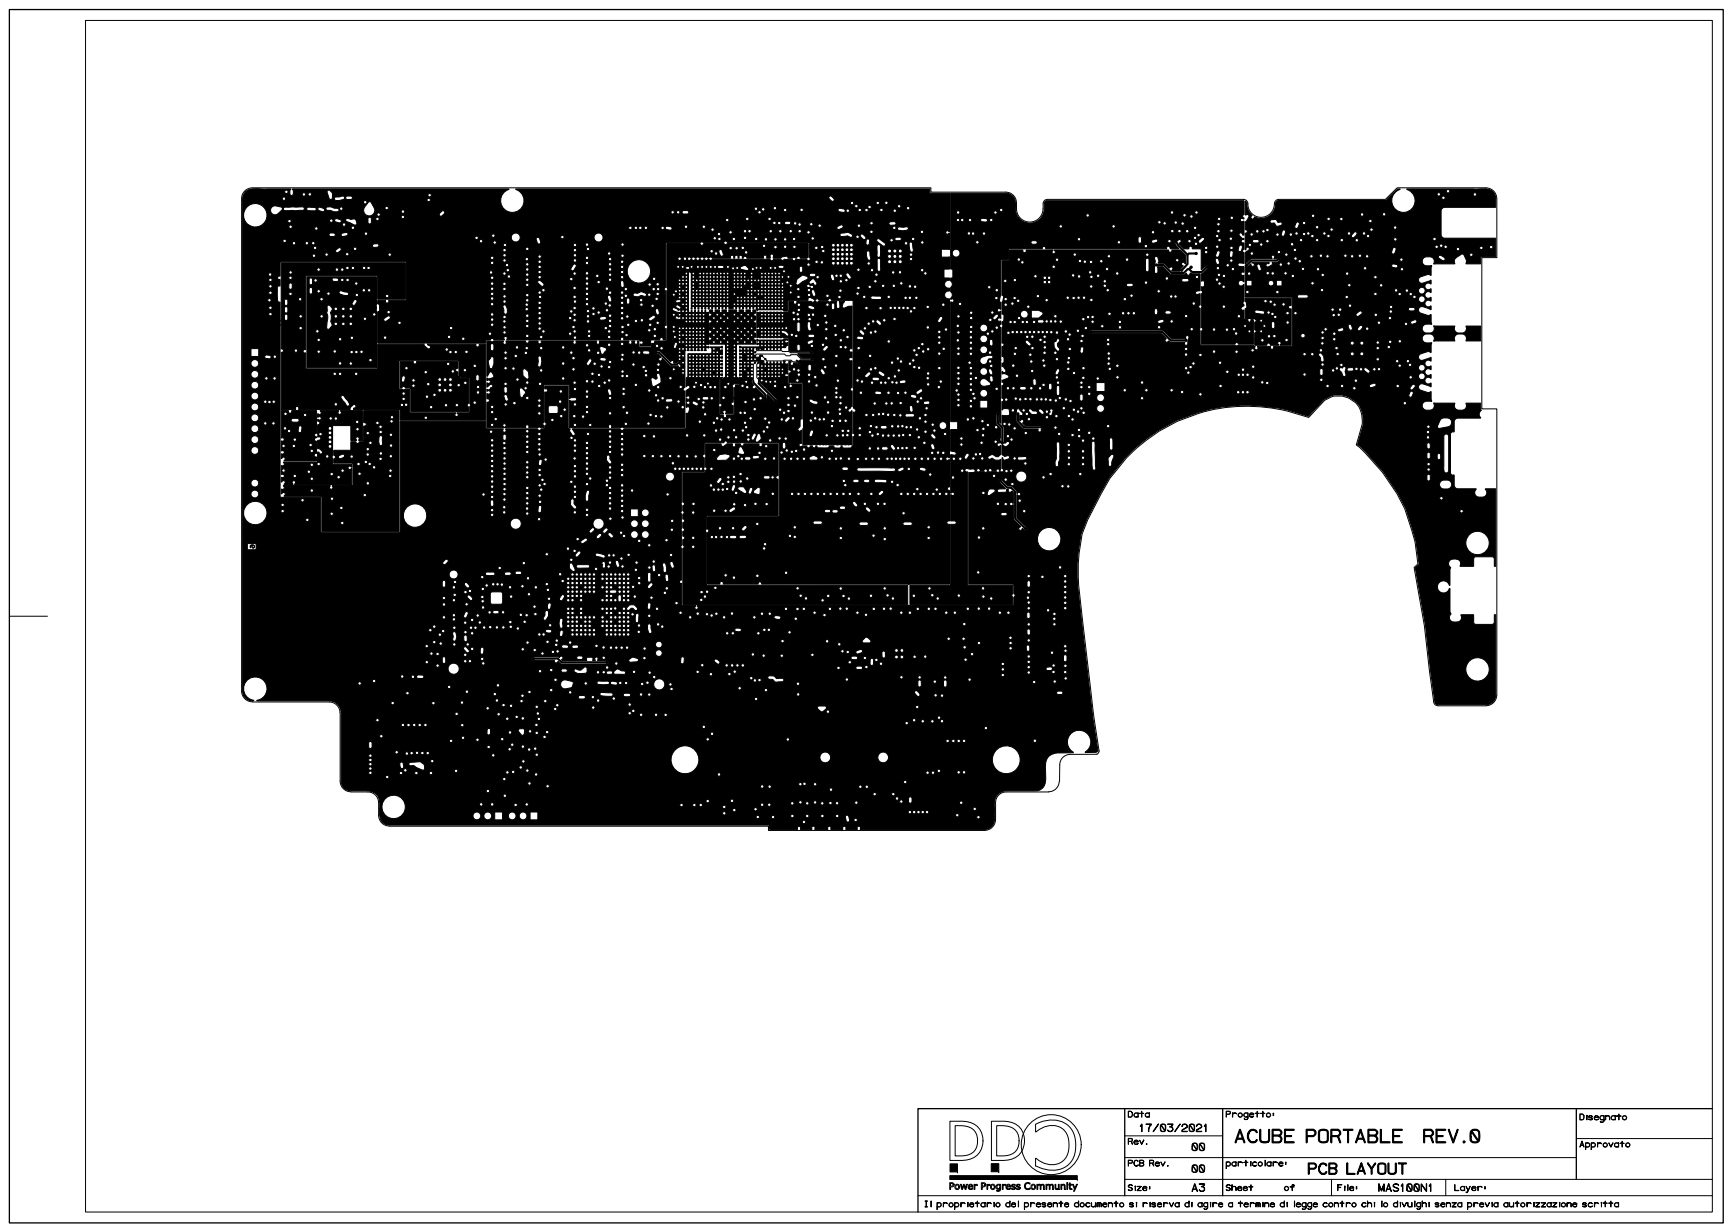
[picture p76: page 11]

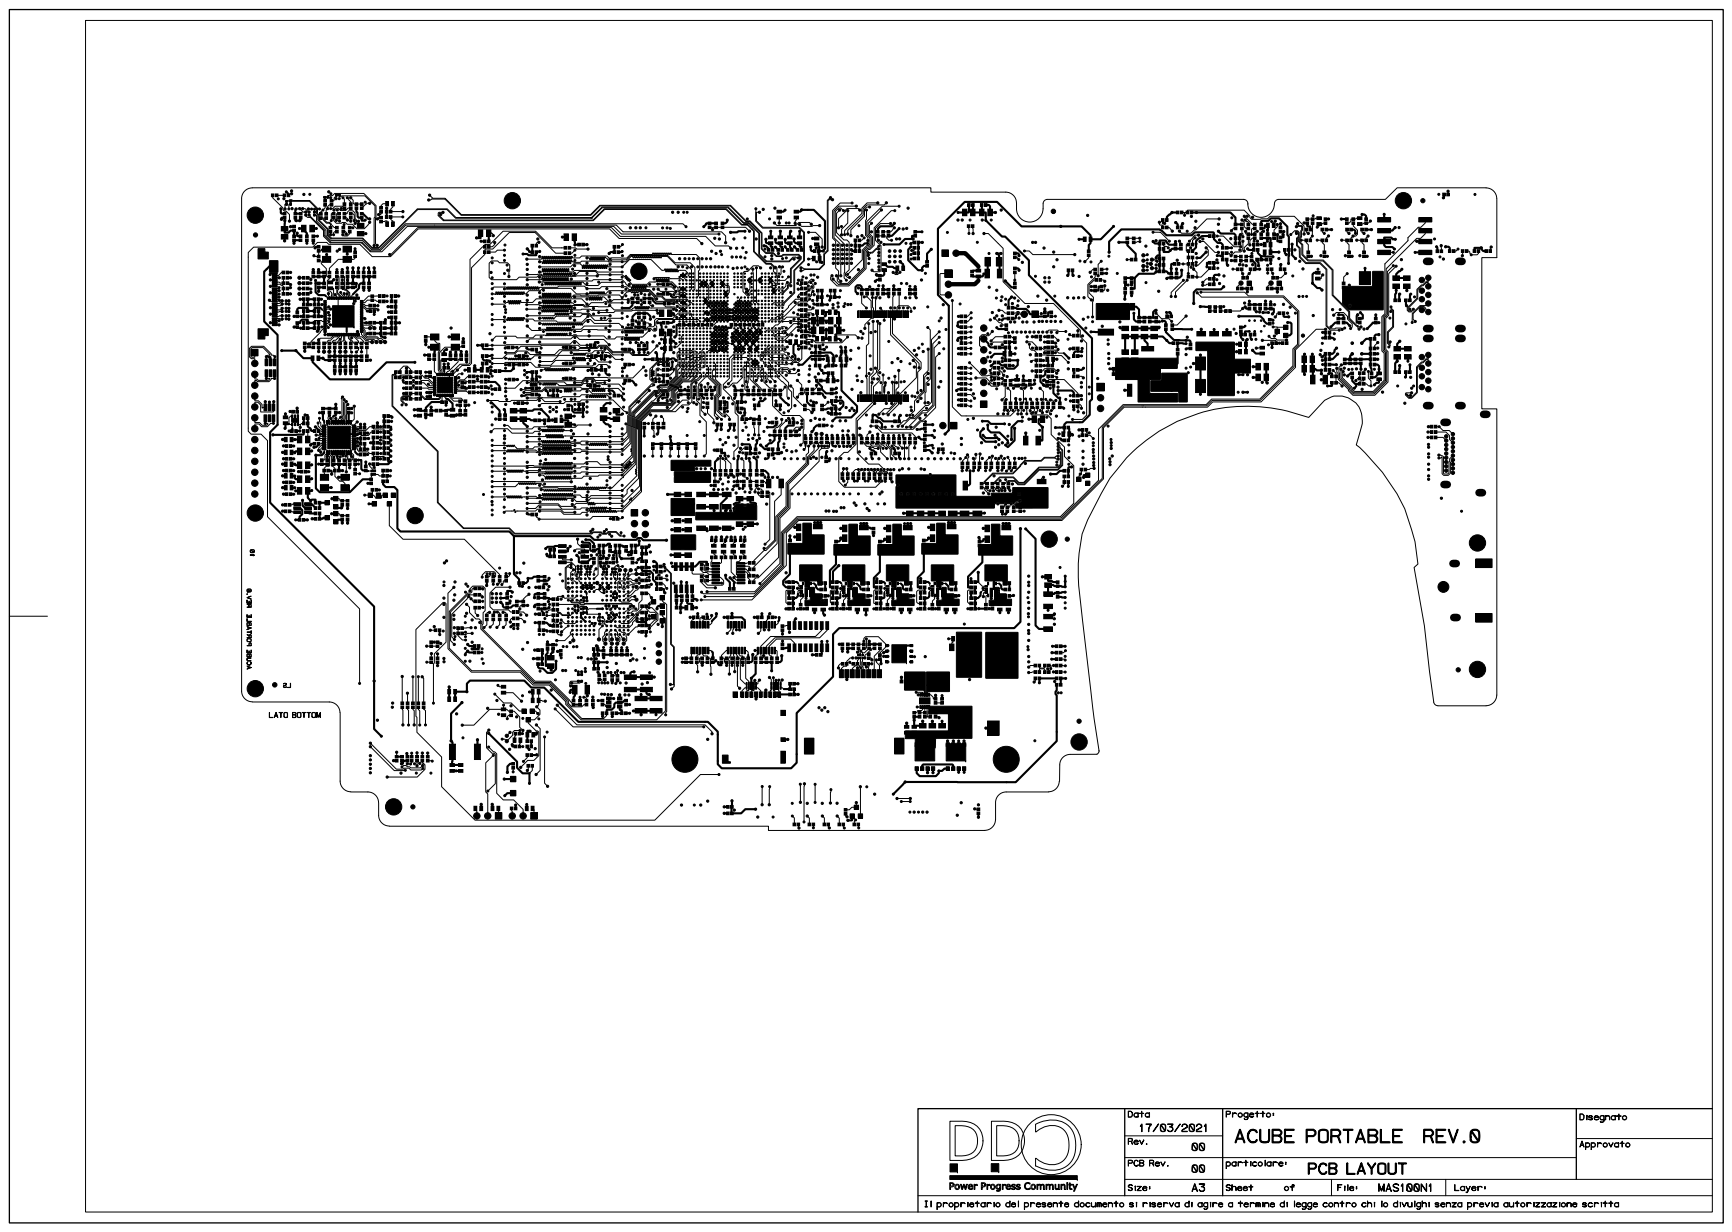
[picture p77: page 12]

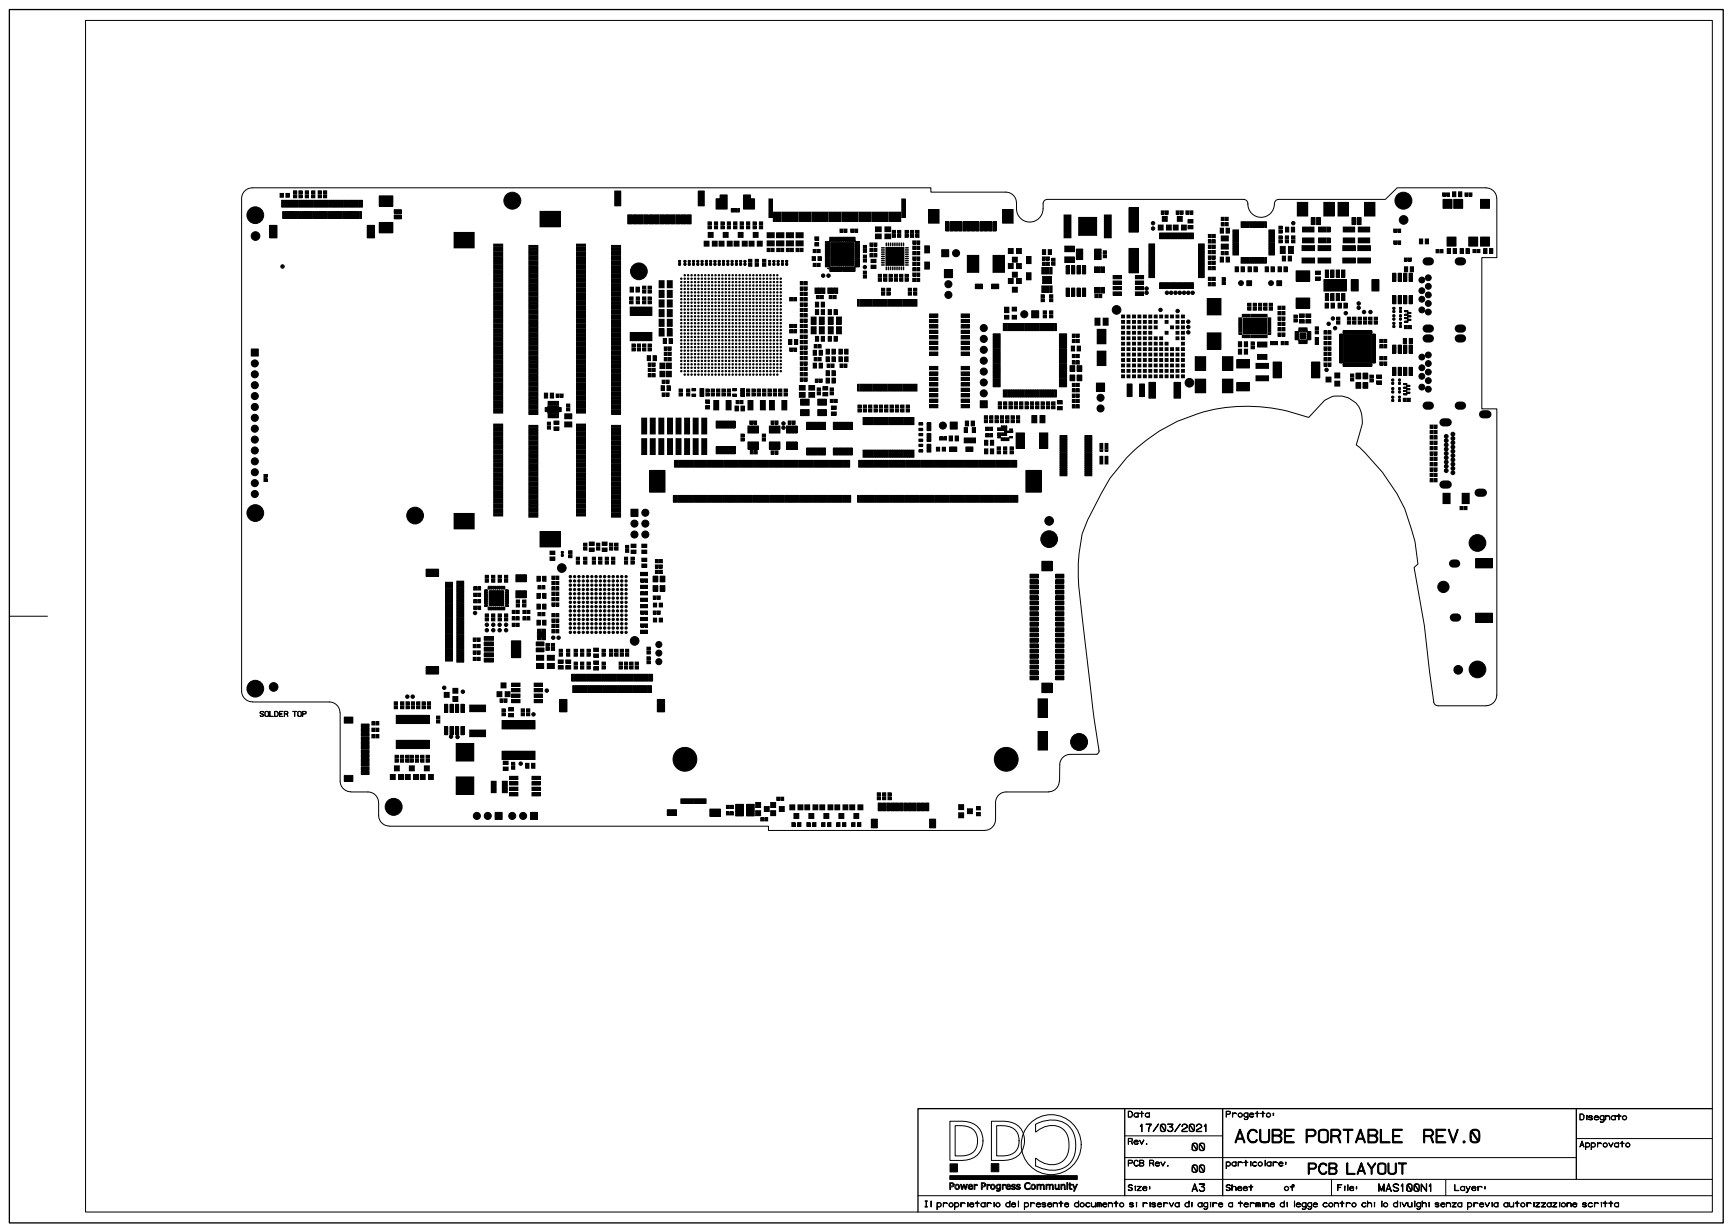
[picture p78: page 13]

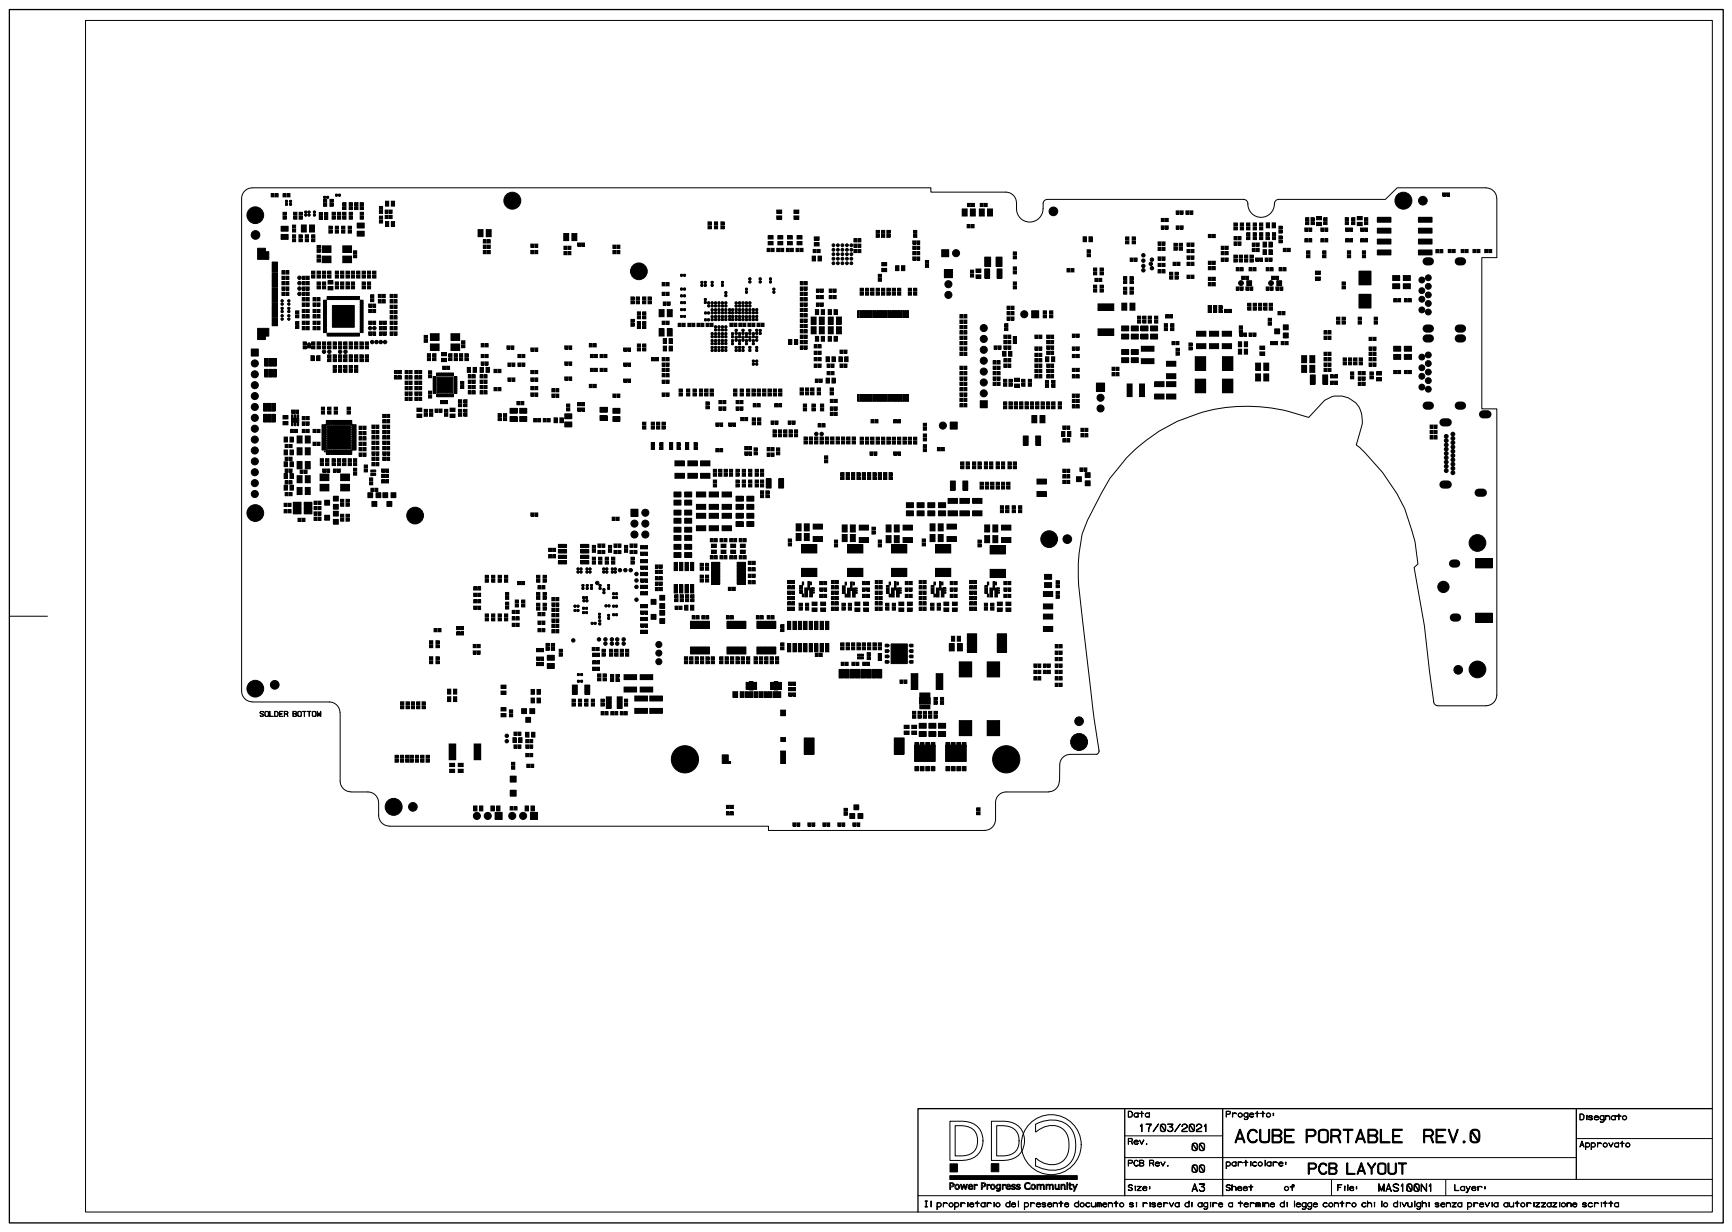
[picture p79: page 14]

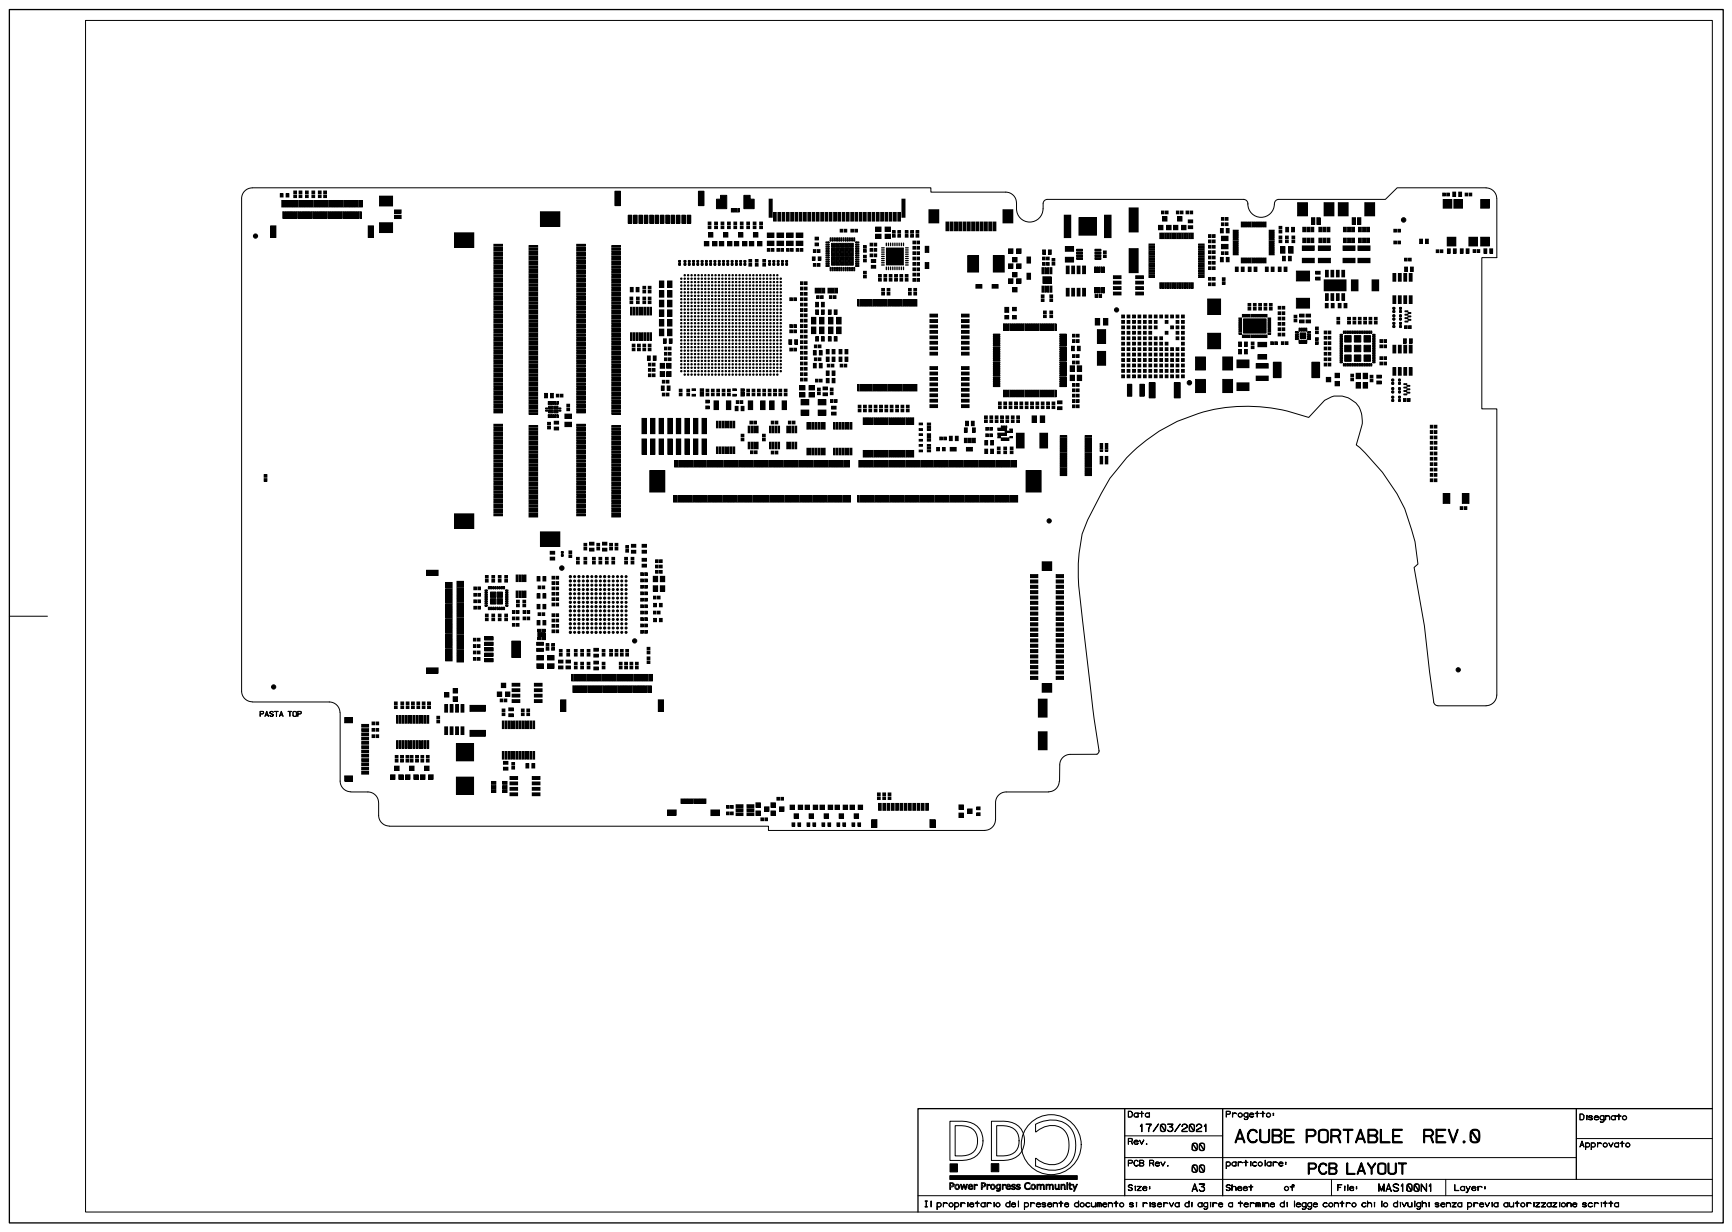
[picture p80: page 15]

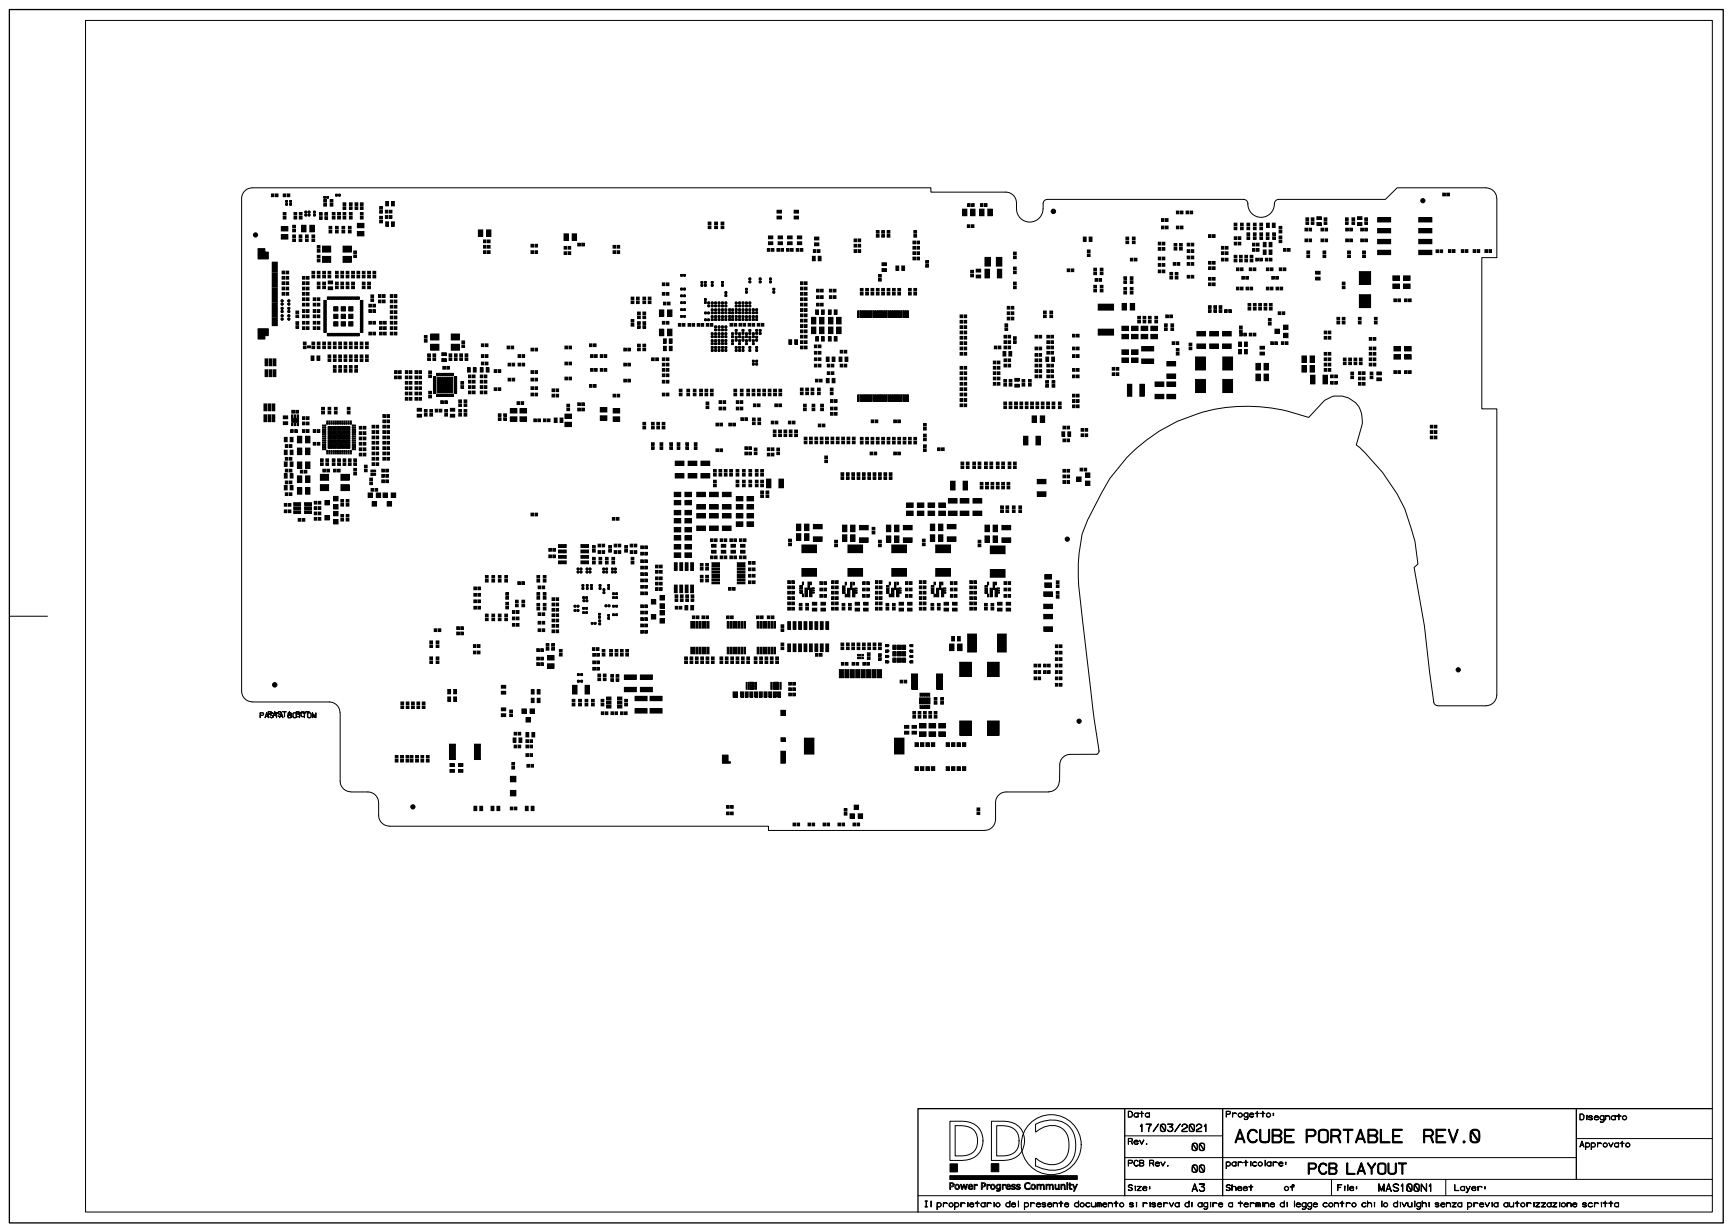
[picture p81: page 16]

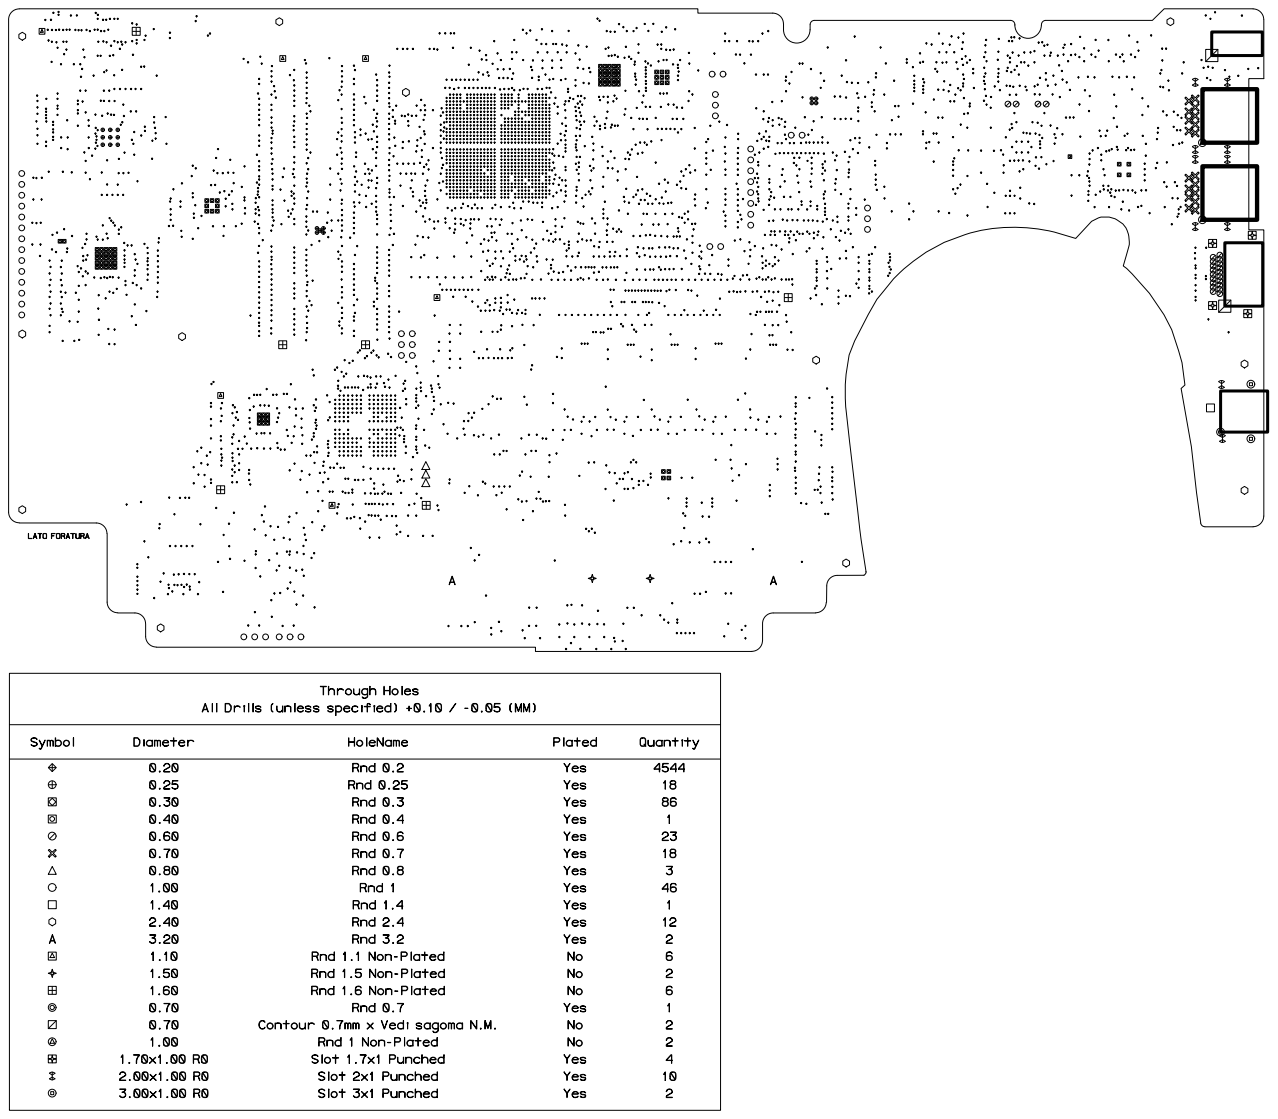
[picture p82: page 17]
