unofficialImportFromGitlab-PPC/powerpc-laptop-mobo/PDF_design/PPC_notebook_electrical_schematics_v0.1.pdf

# Version Control

# Version

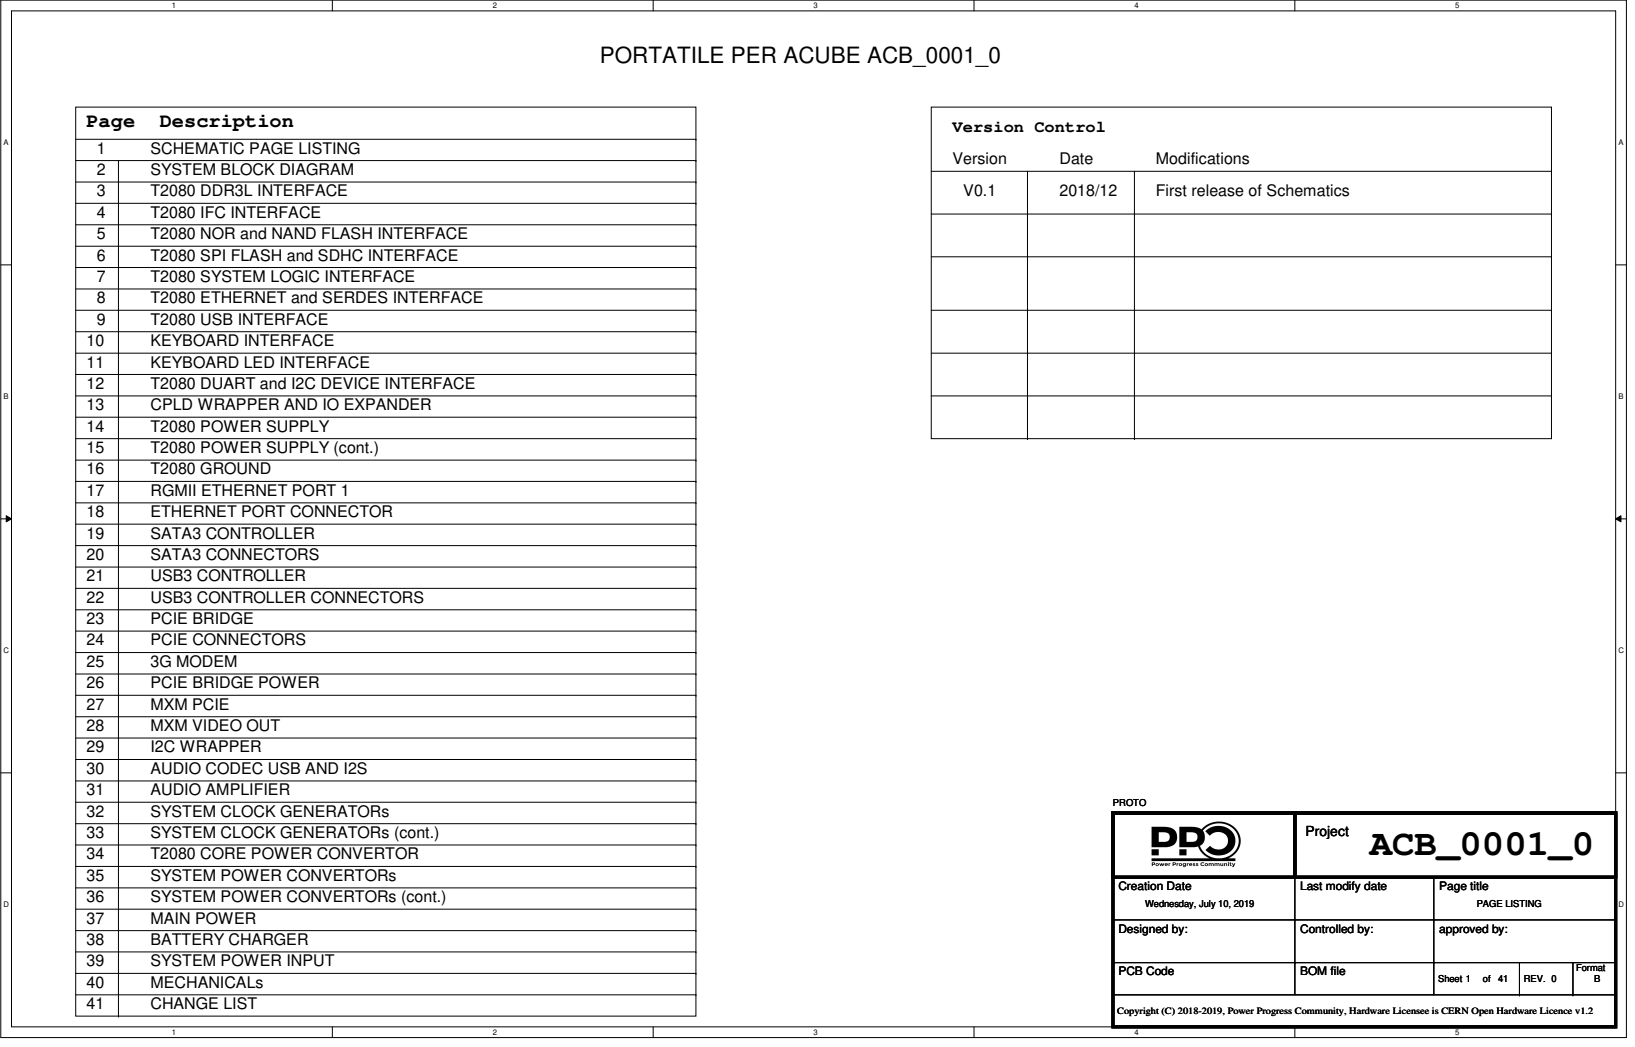
[picture p83: page 1]
Date; Modifications; Page; Description; SCHEMATIC PAGE LISTING; ACB_0001_0; MECHANICALs CHANGE LIST; Project; Creation Date; Last modify date; Designed by:; Controlled by:; approved by:; PCB Code; BOM file; Sheet; REV.; Format; Page title; PAGE LISTING; Wednesday, July 10, 2019; PROTO

PORTATILE PER ACUBE ACB_0001_0

SYSTEM BLOCK DIAGRAM
T2080 DDR3L INTERFACE
T2080 IFC INTERFACE
T2080 NOR and NAND FLASH INTERFACE
T2080 SPI FLASH and SDHC INTERFACE
T2080 SYSTEM LOGIC INTERFACE
T2080 ETHERNET and SERDES INTERFACE
T2080 USB INTERFACE
KEYBOARD INTERFACE
KEYBOARD LED INTERFACE
T2080 DUART and I2C DEVICE INTERFACE
CPLD WRAPPER AND IO EXPANDER
T2080 POWER SUPPLY
T2080 POWER SUPPLY (cont.)
T2080 GROUND
RGMII ETHERNET PORT 1
ETHERNET PORT CONNECTOR
SATA3 CONTROLLER
SATA3 CONNECTORS
USB3 CONTROLLER
USB3 CONTROLLER CONNECTORS
PCIE BRIDGE
PCIE CONNECTORS
3G MODEM
PCIE BRIDGE POWER
MXM PCIE
MXM VIDEO OUT
I2C WRAPPER
AUDIO CODEC USB AND I2S
AUDIO AMPLIFIER
SYSTEM CLOCK GENERATORs
SYSTEM CLOCK GENERATORs (cont.)
T2080 CORE POWER CONVERTOR
SYSTEM POWER CONVERTORs
SYSTEM POWER CONVERTORs (cont.)
MAIN POWER
BATTERY CHARGER
SYSTEM POWER INPUT

First release of Schematics

Copyright (C) 2018-2019, Power Progress Community, Hardware Licensee is CERN Open Hardware Licence v1.2

# SYSTEM BLOCK DIAGRAM

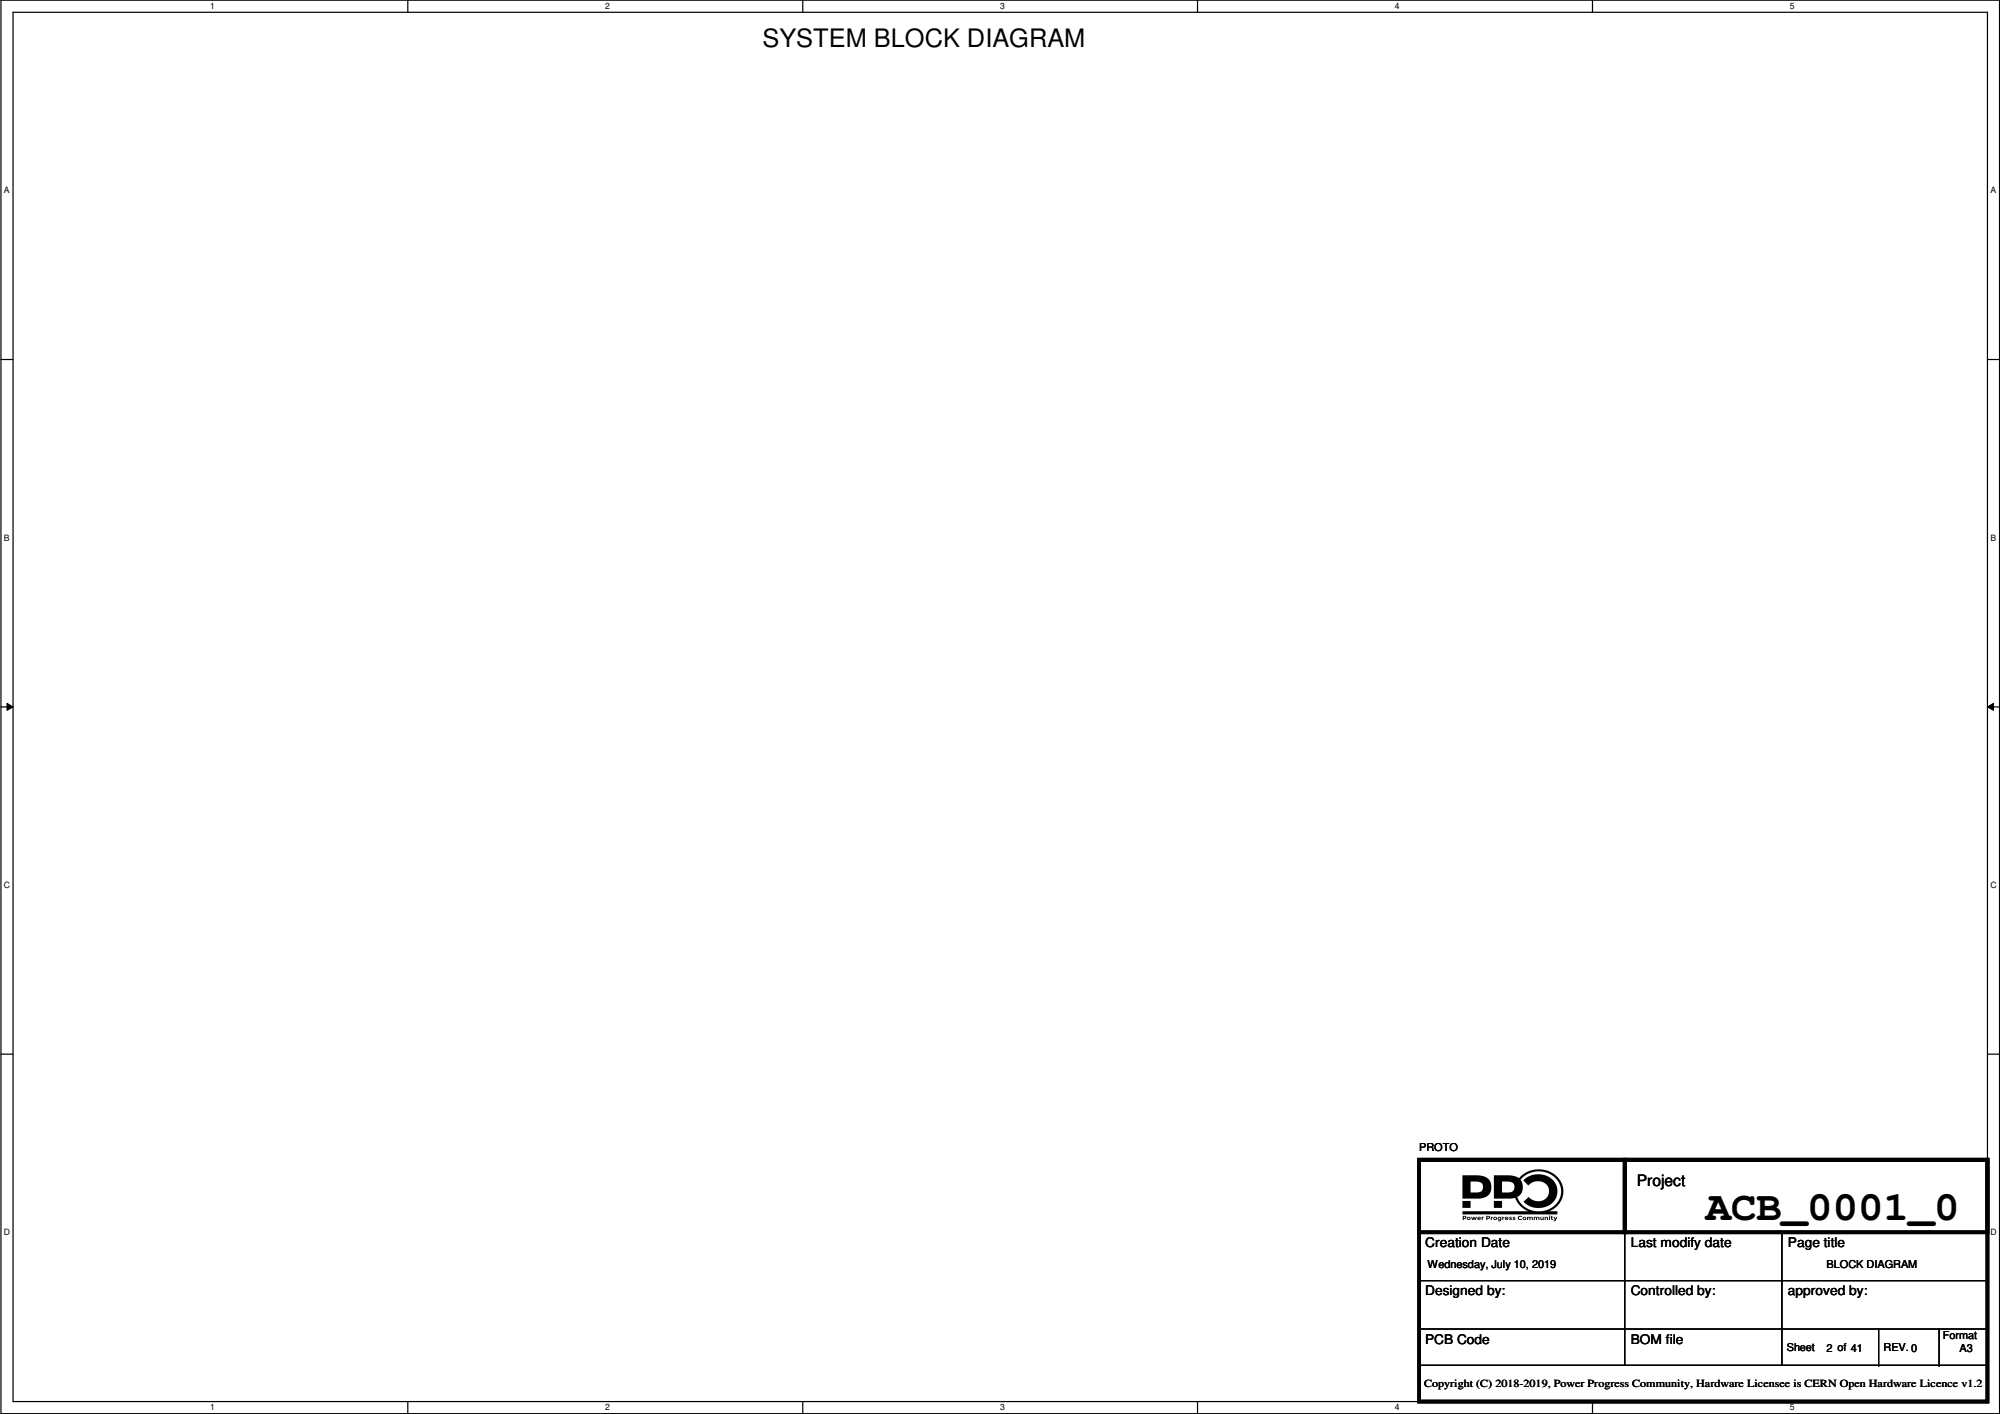
[picture p84: page 2]
ACB_0001_0; Project; Creation Date; Last modify date; Designed by:; Controlled by:; approved by:; PCB Code; BOM file; Sheet; REV.; Format; Page title; BLOCK DIAGRAM; Wednesday, July 10, 2019; PROTO

Copyright (C) 2018-2019, Power Progress Community, Hardware Licensee is CERN Open Hardware Licence v1.2

# T2080 DDR3L MEMORY INTERFACE

## 1.35V DDR3L SDRAM SODIMM

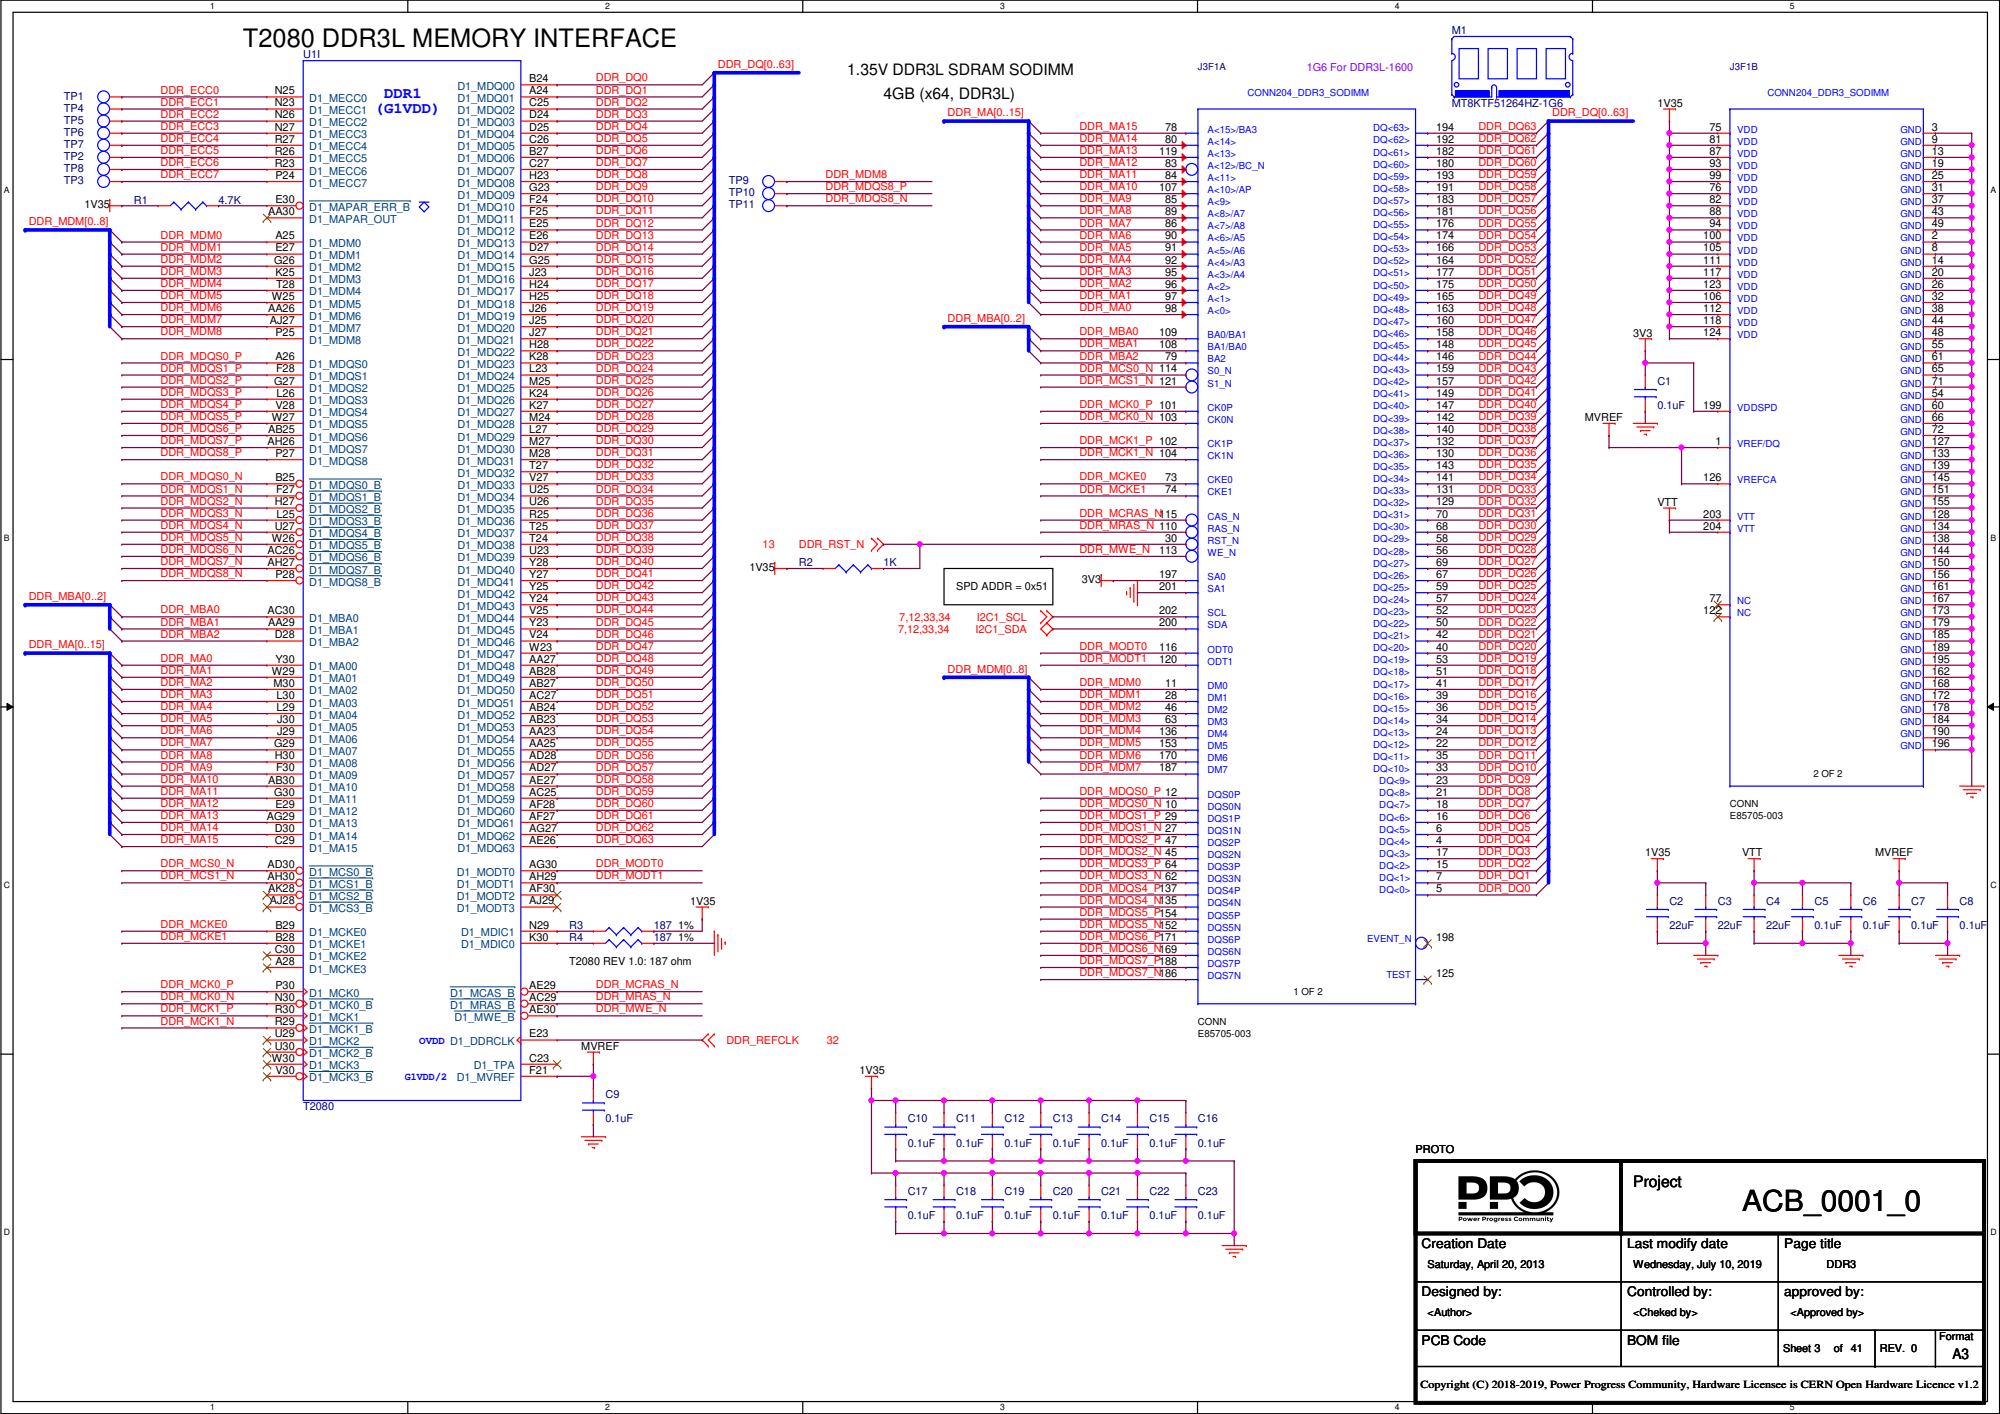
[picture p85: page 3]

# T2080 IFC INTERFACE

## T2080 RESET CONFIGURATION

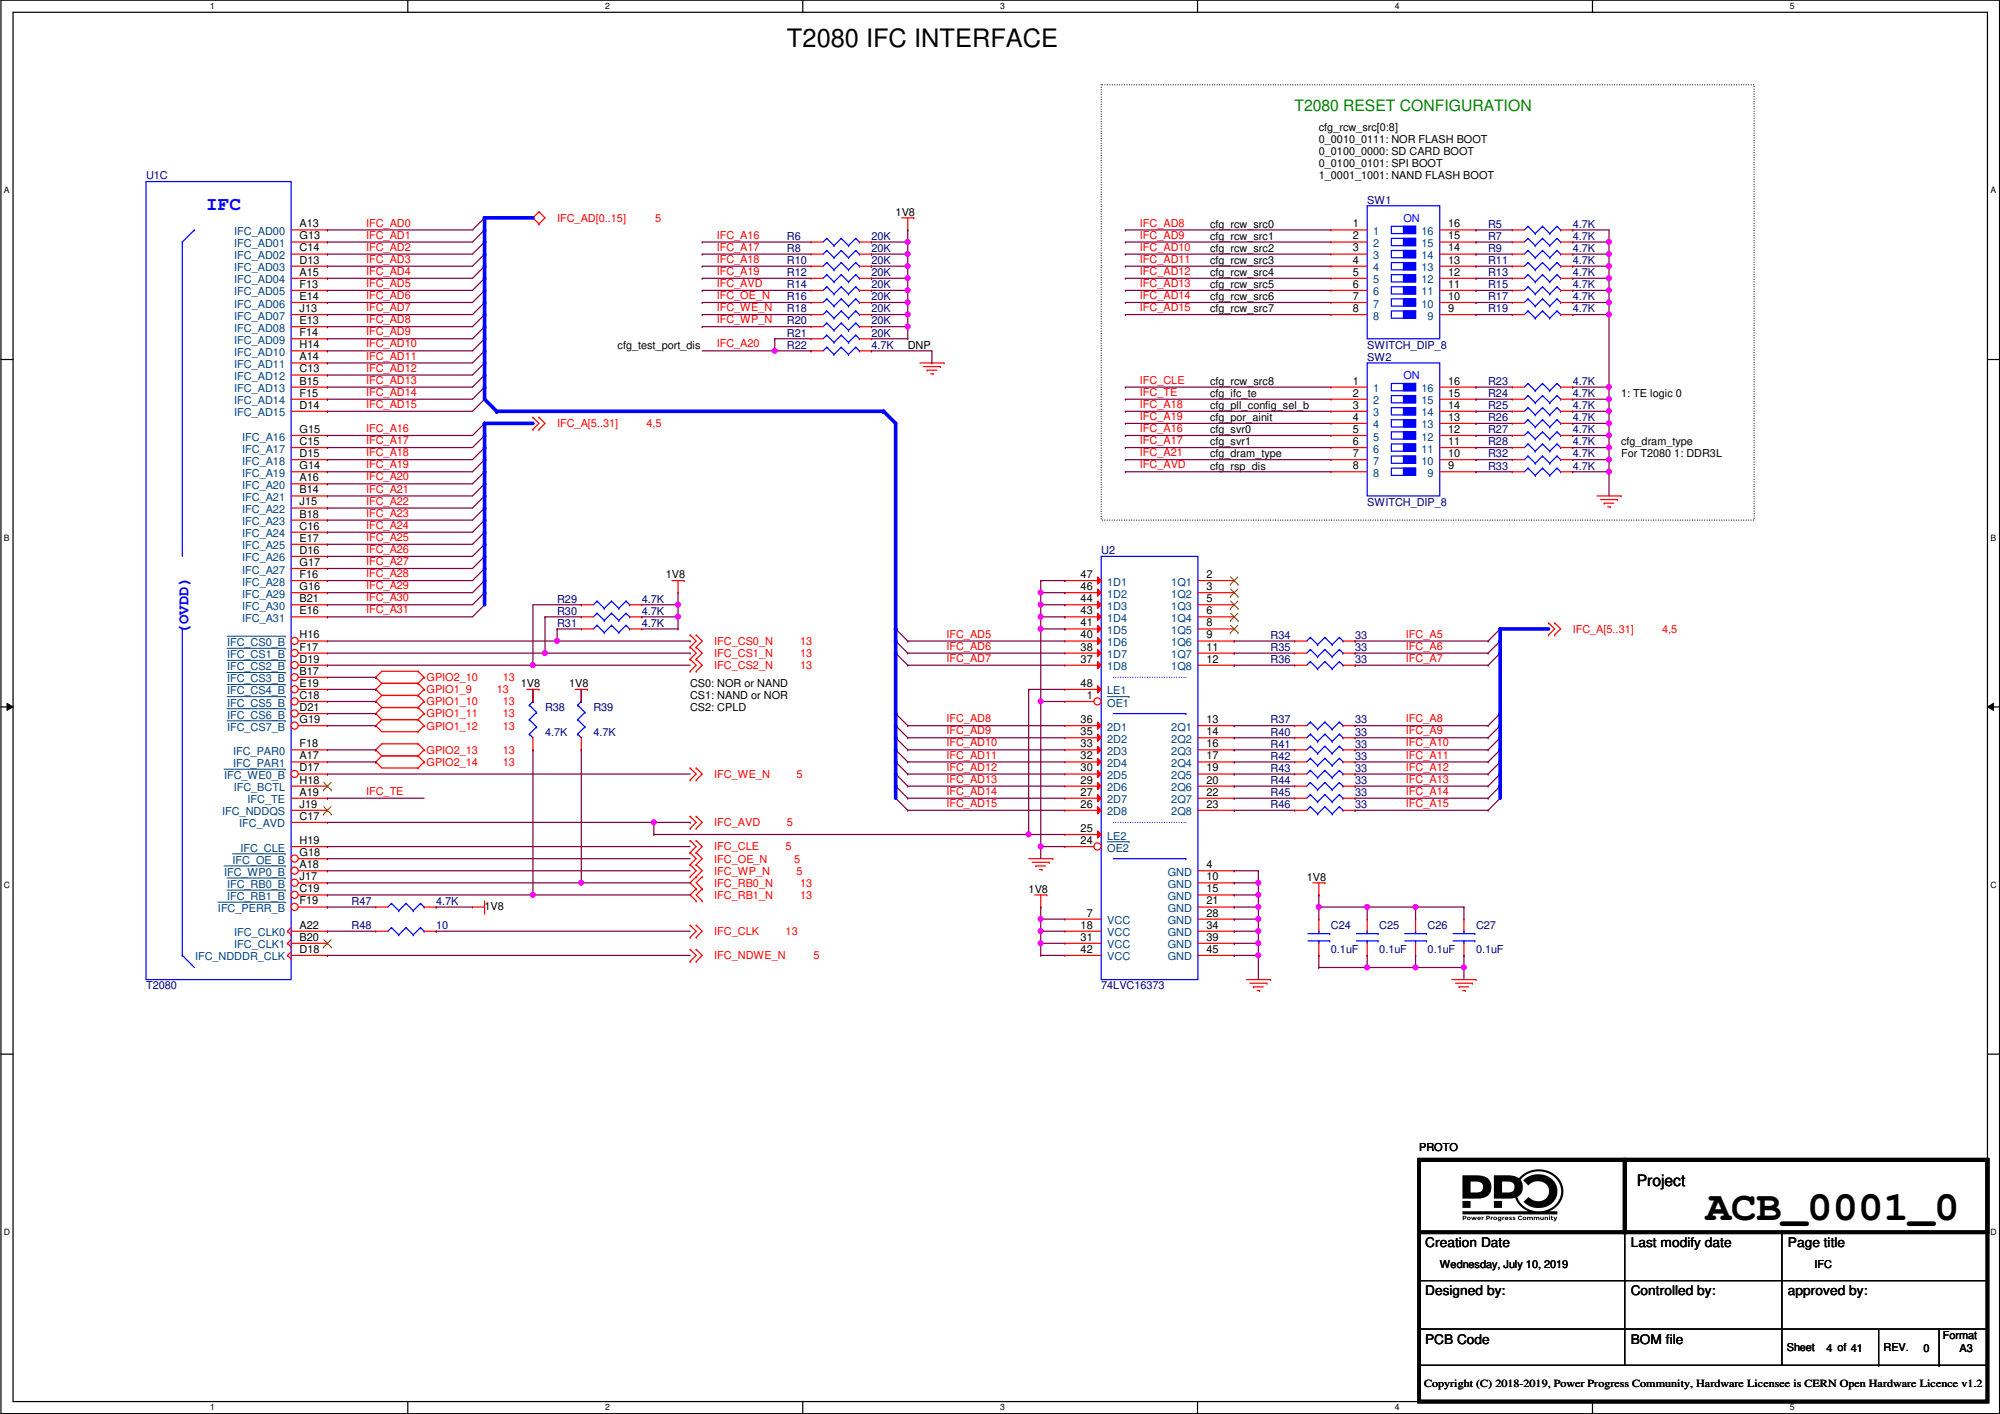
[picture p86: page 4]

## 128MB 16-BIT NOR FLASH

# T2080 NOR and NAND FLASH INTERFACE

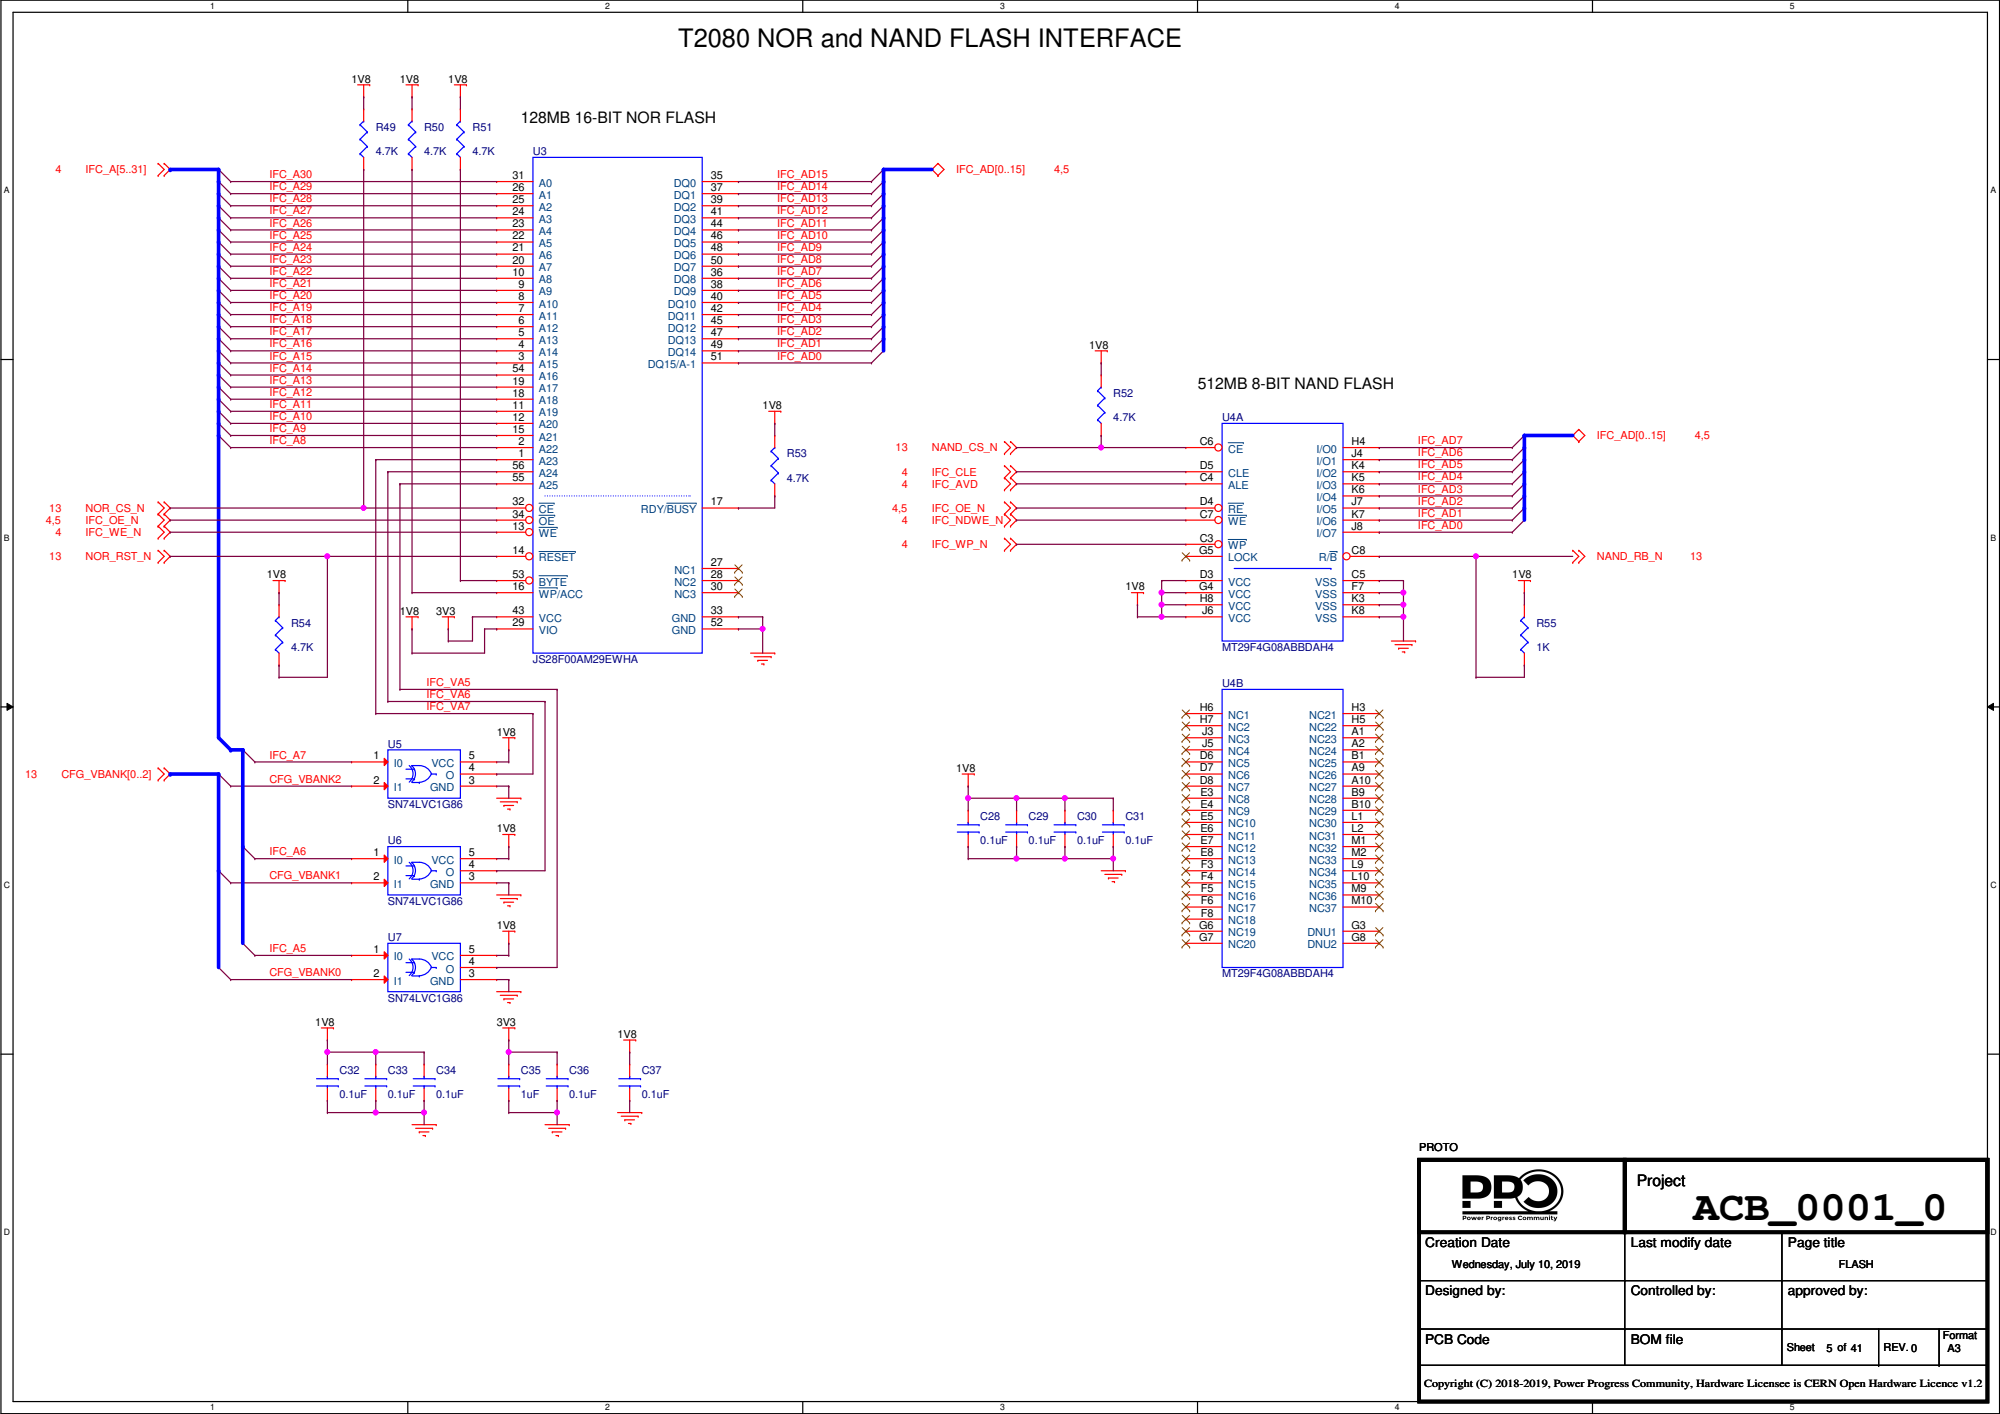
[picture p87: page 5]

## 64MB SERIAL FLASH

# T2080 SPI FLASH and SDHC INTERFACE

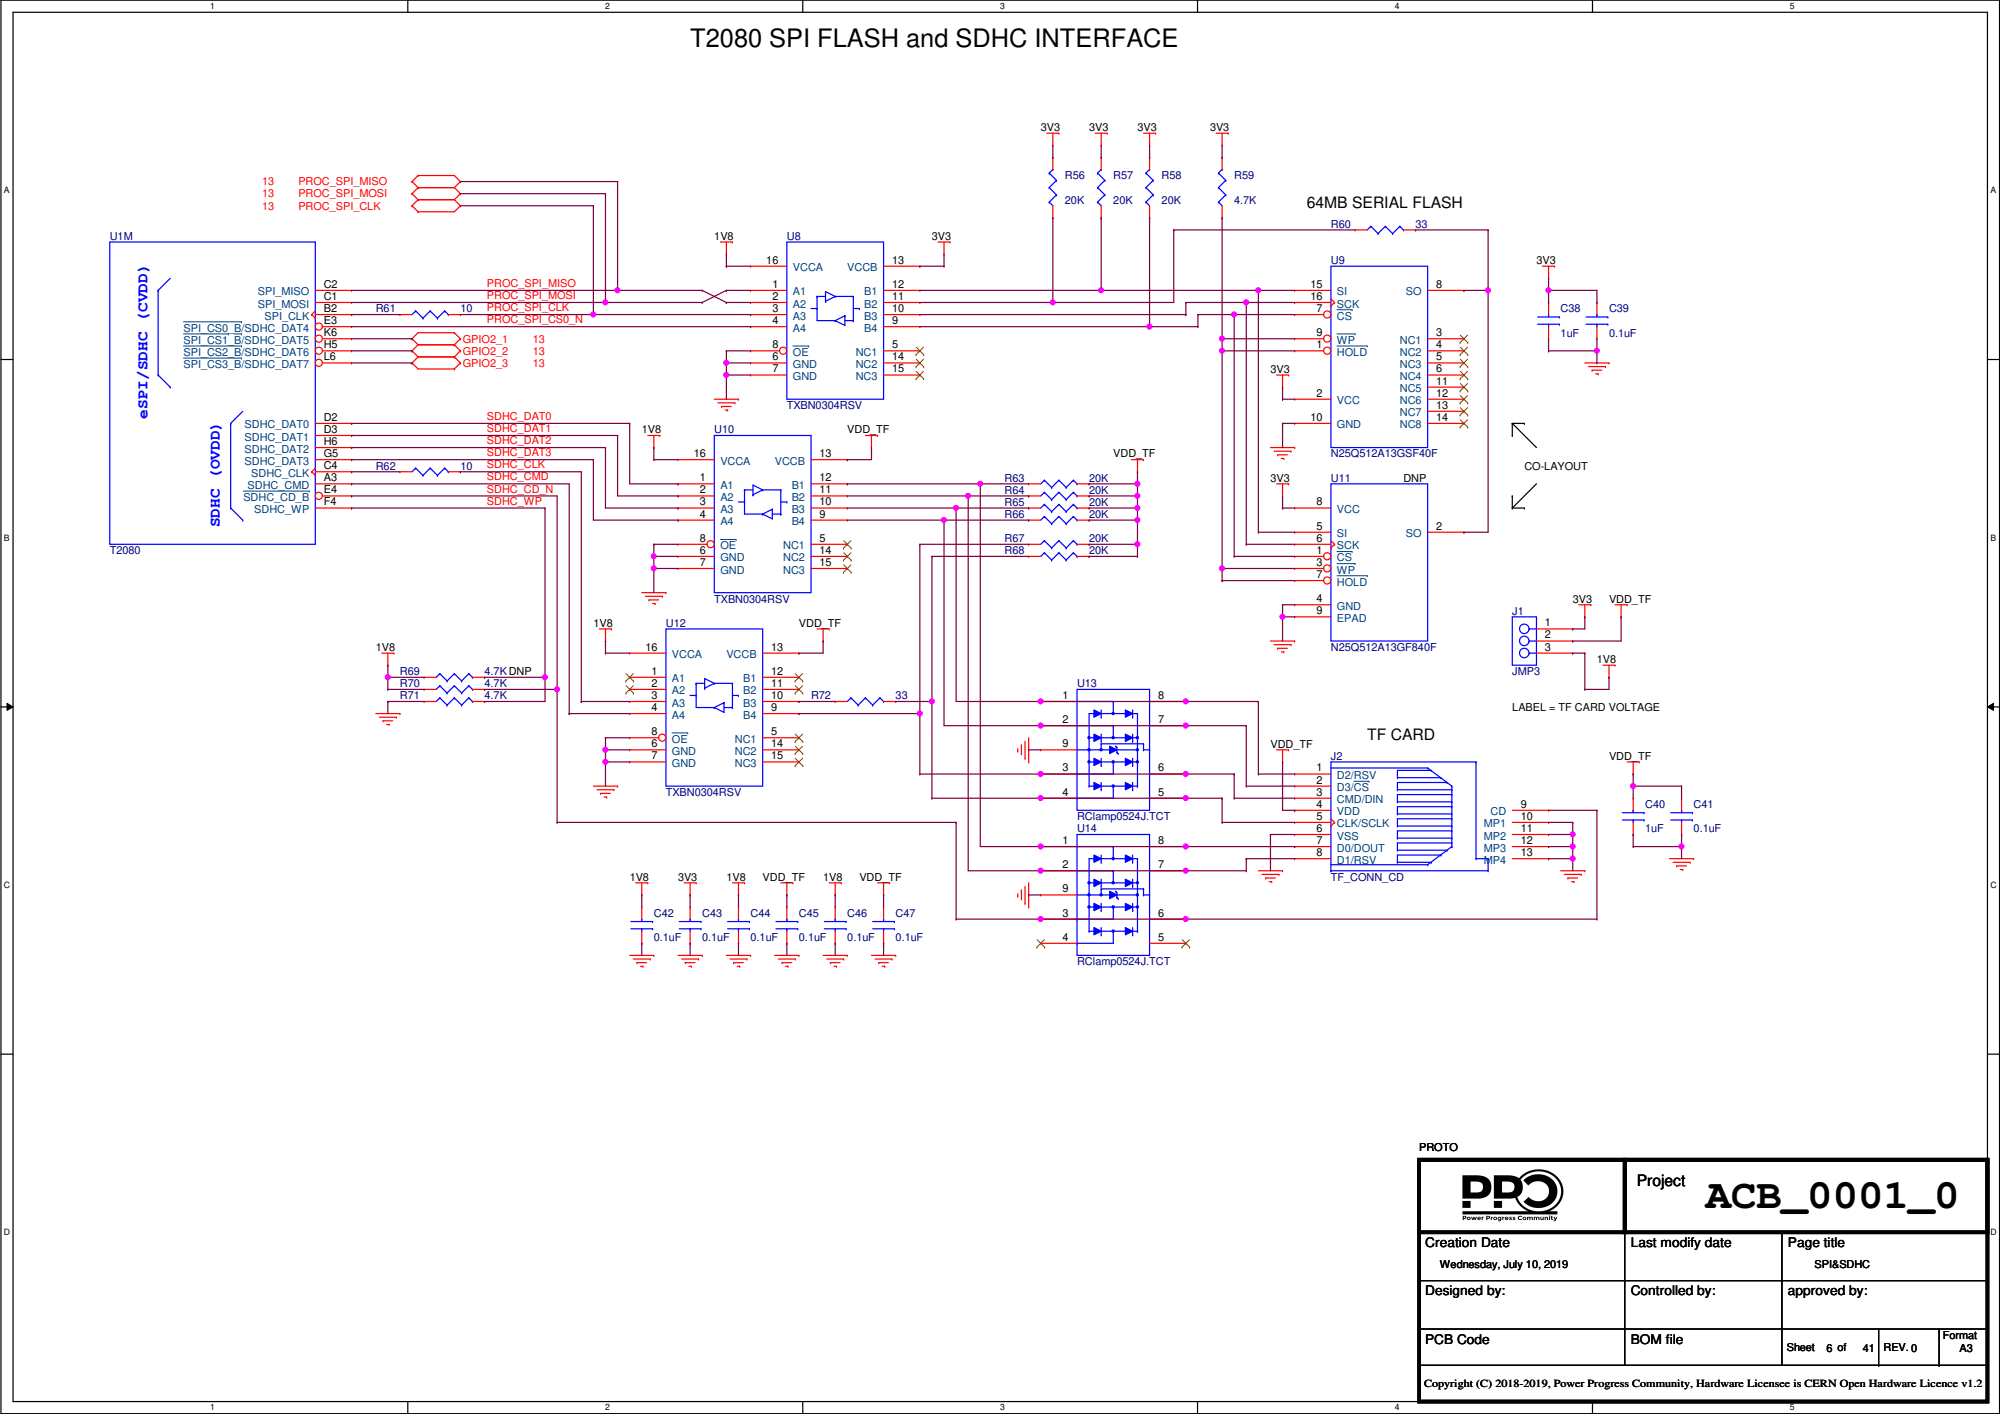
[picture p88: page 6]

SCK 16

CS 7 WP 9 HOLD 1 3V3 3V3

LABEL = TF CARD VOLTAGE

D1/RSV 8

TF_CONN_CD 6

# T2080 SYSTEM LOGIC INTERFACE

# CNTR & MISC

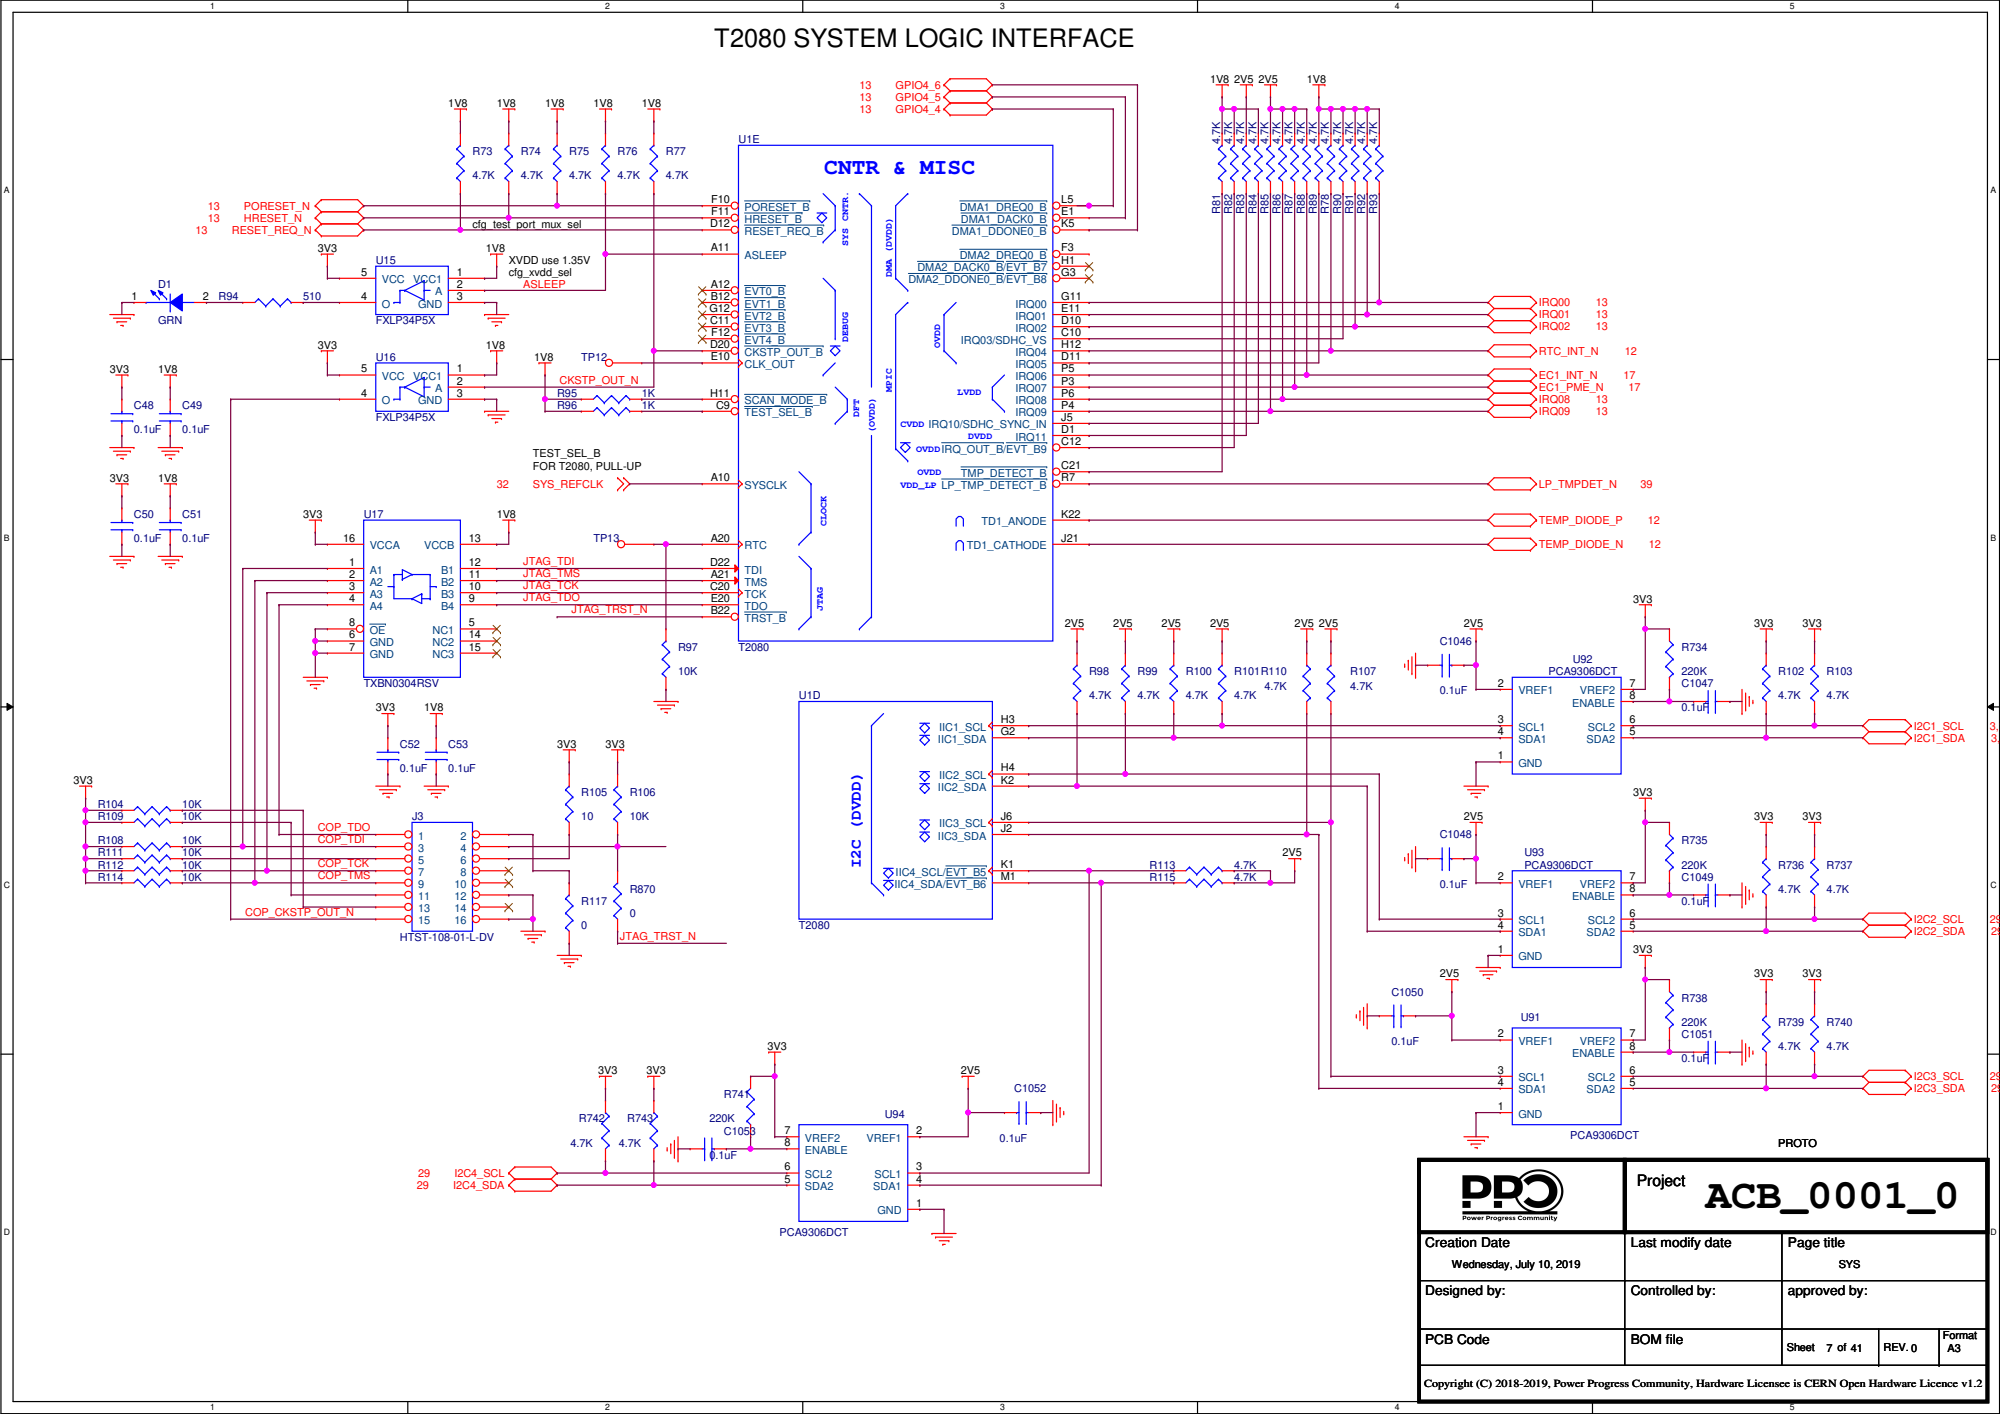
[picture p89: page 7]

COP_TCK
COP_TMS

# T2080 ETHERNET and SERDES INTERFACE

## SERDES 1

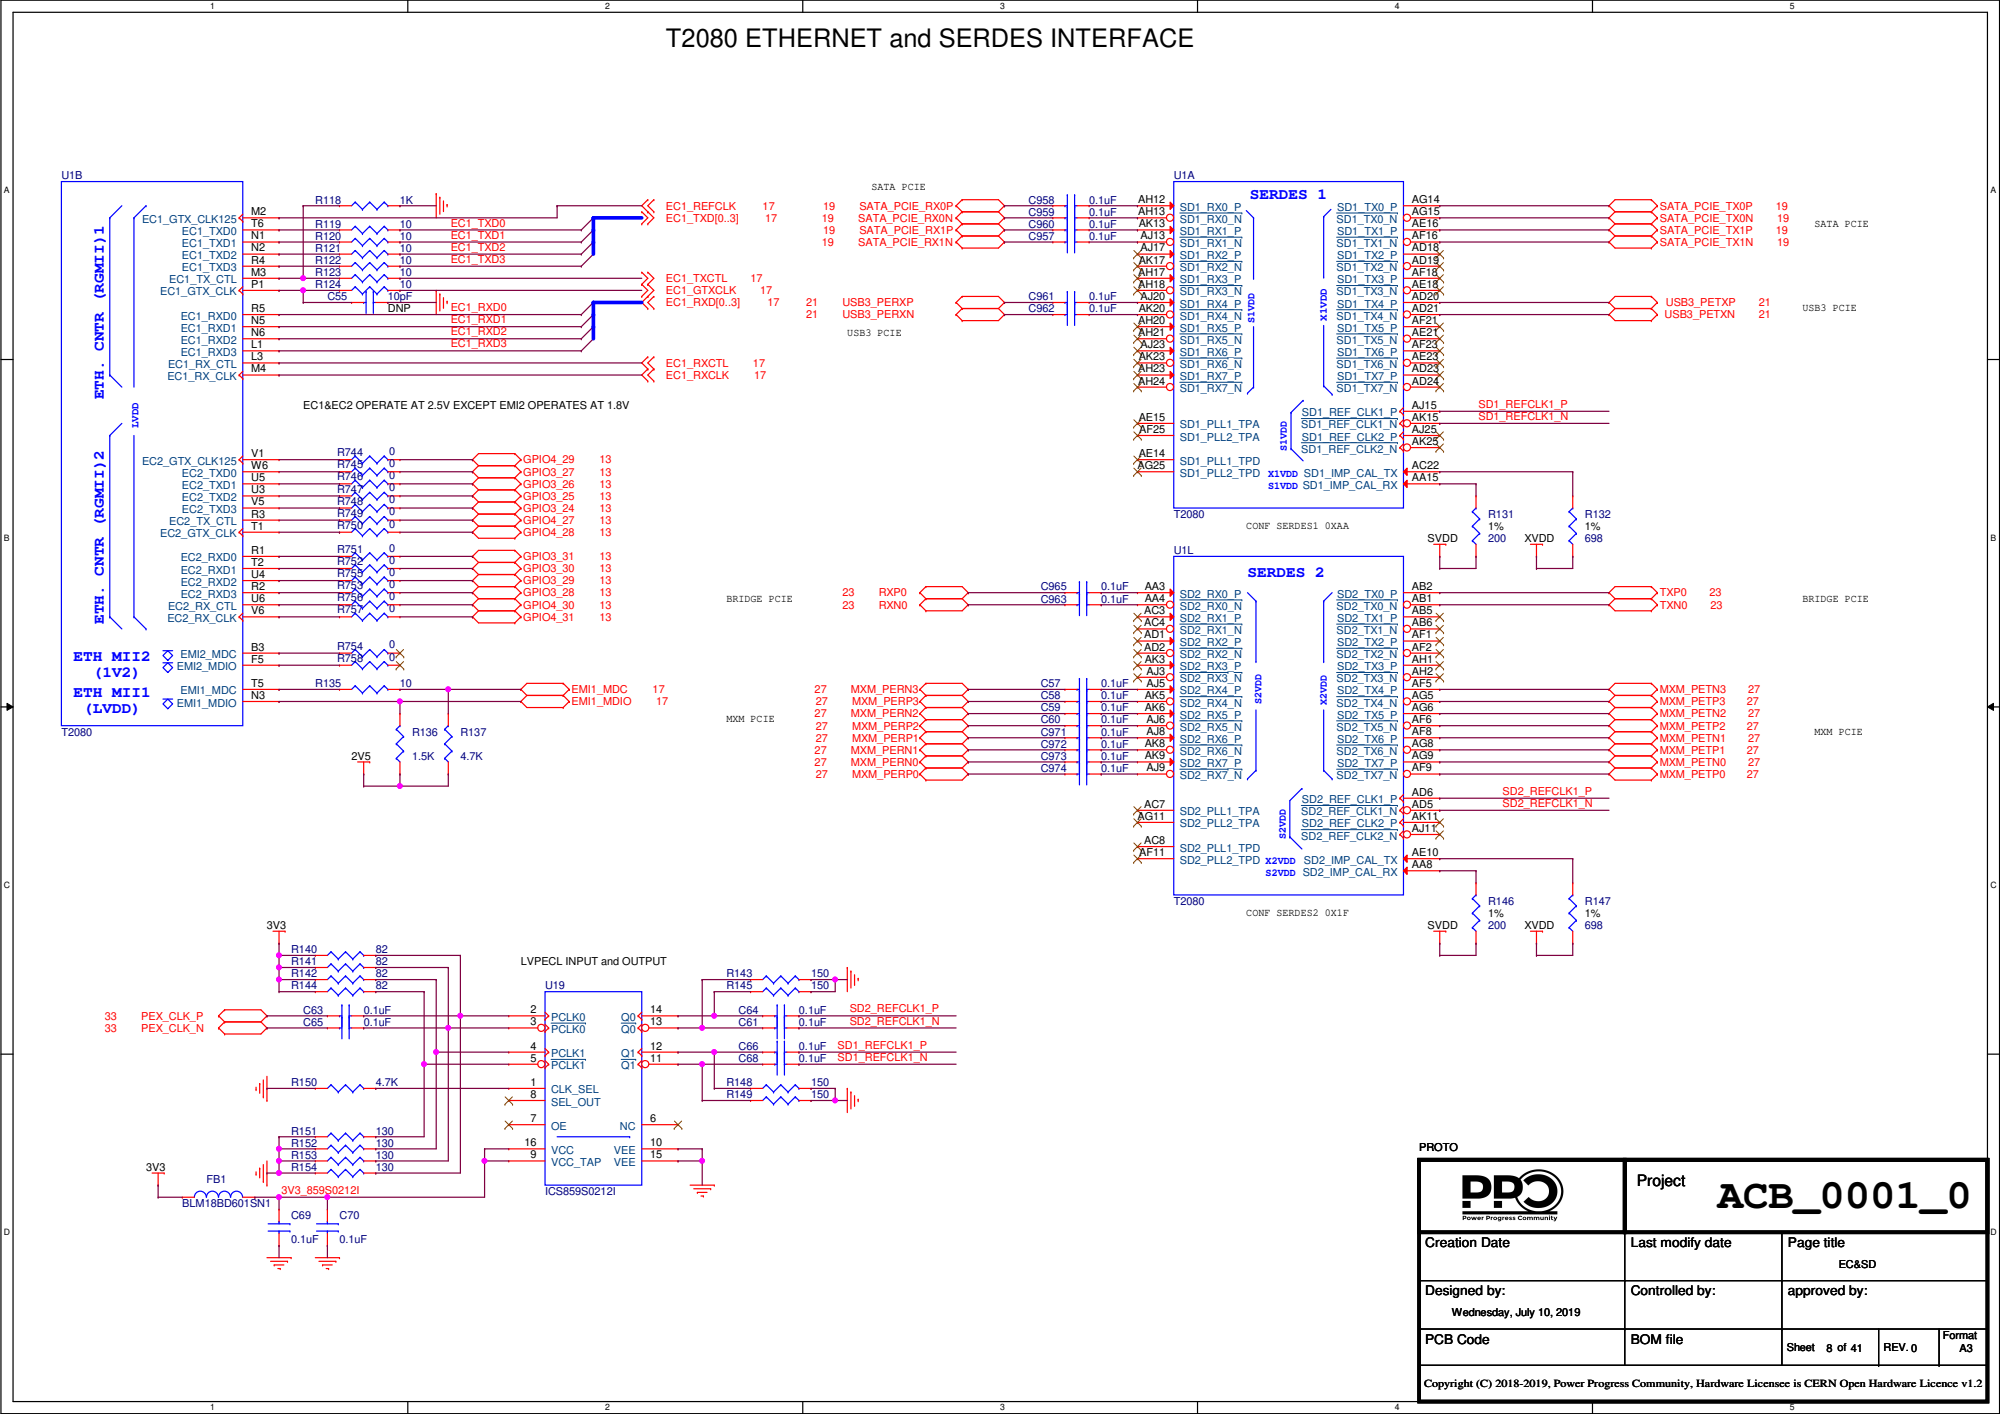
[picture p90: page 8]

ETH. CNTR (RGMII)1 ETH. CNTR (RGMII)2

EC1&EC2 OPERATE AT 2.5V EXCEPT EMI2 OPERATES AT 1.8V

LVPECL INPUT and OUTPUT

# T2080 USB INTERFACE

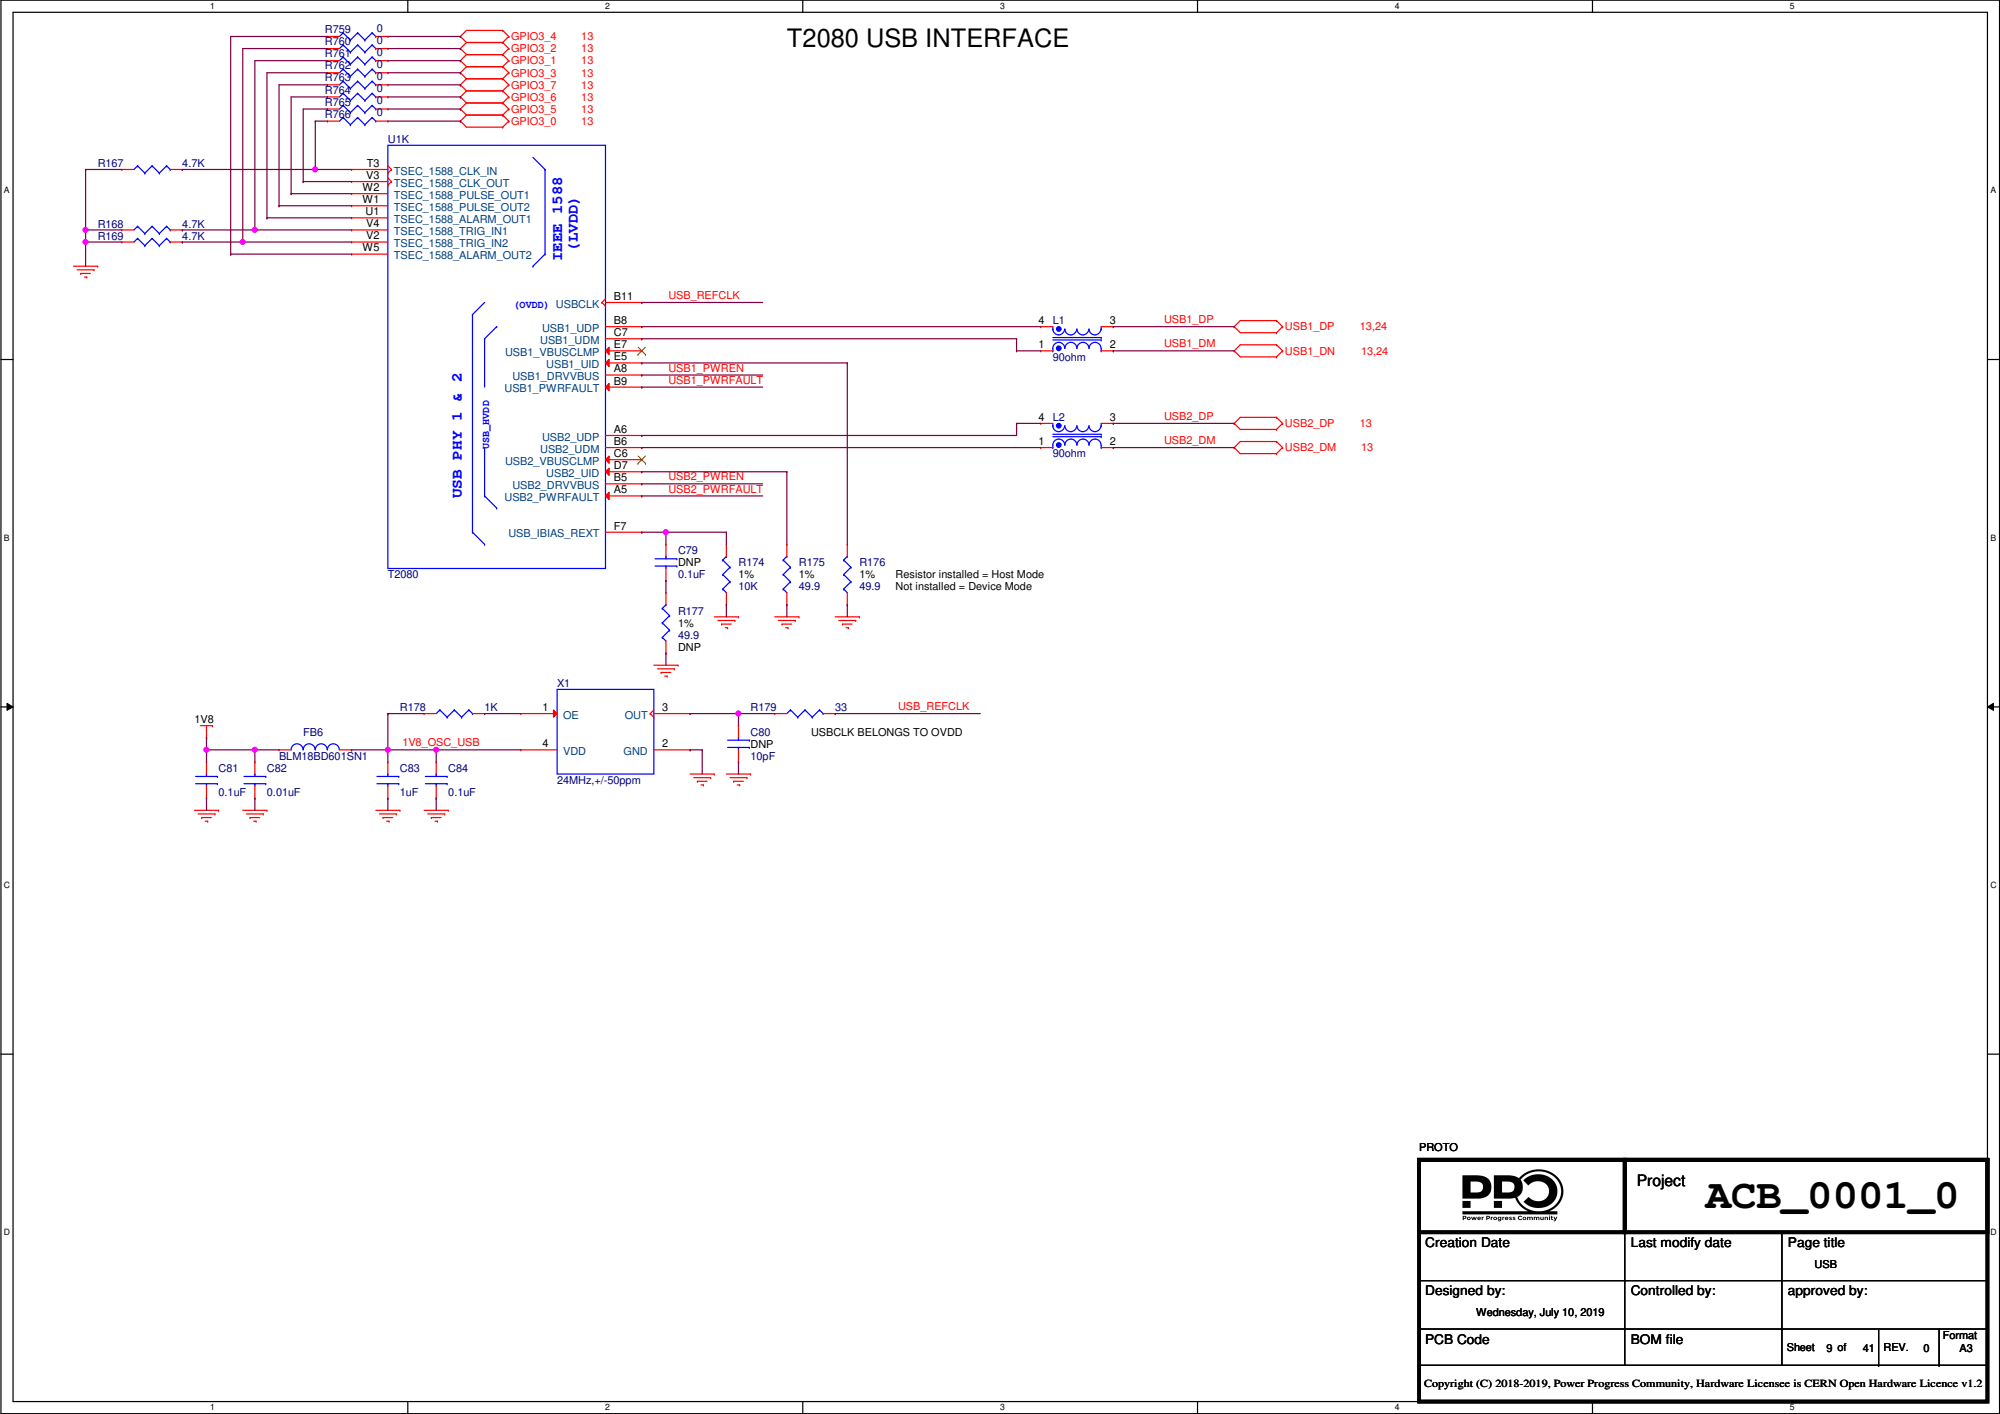
[picture p91: page 9]

Resistor installed = Host Mode
Not installed = Device Mode

USBCLK BELONGS TO OVDD

1 | 2 | 3 | 4 | 5
A | A

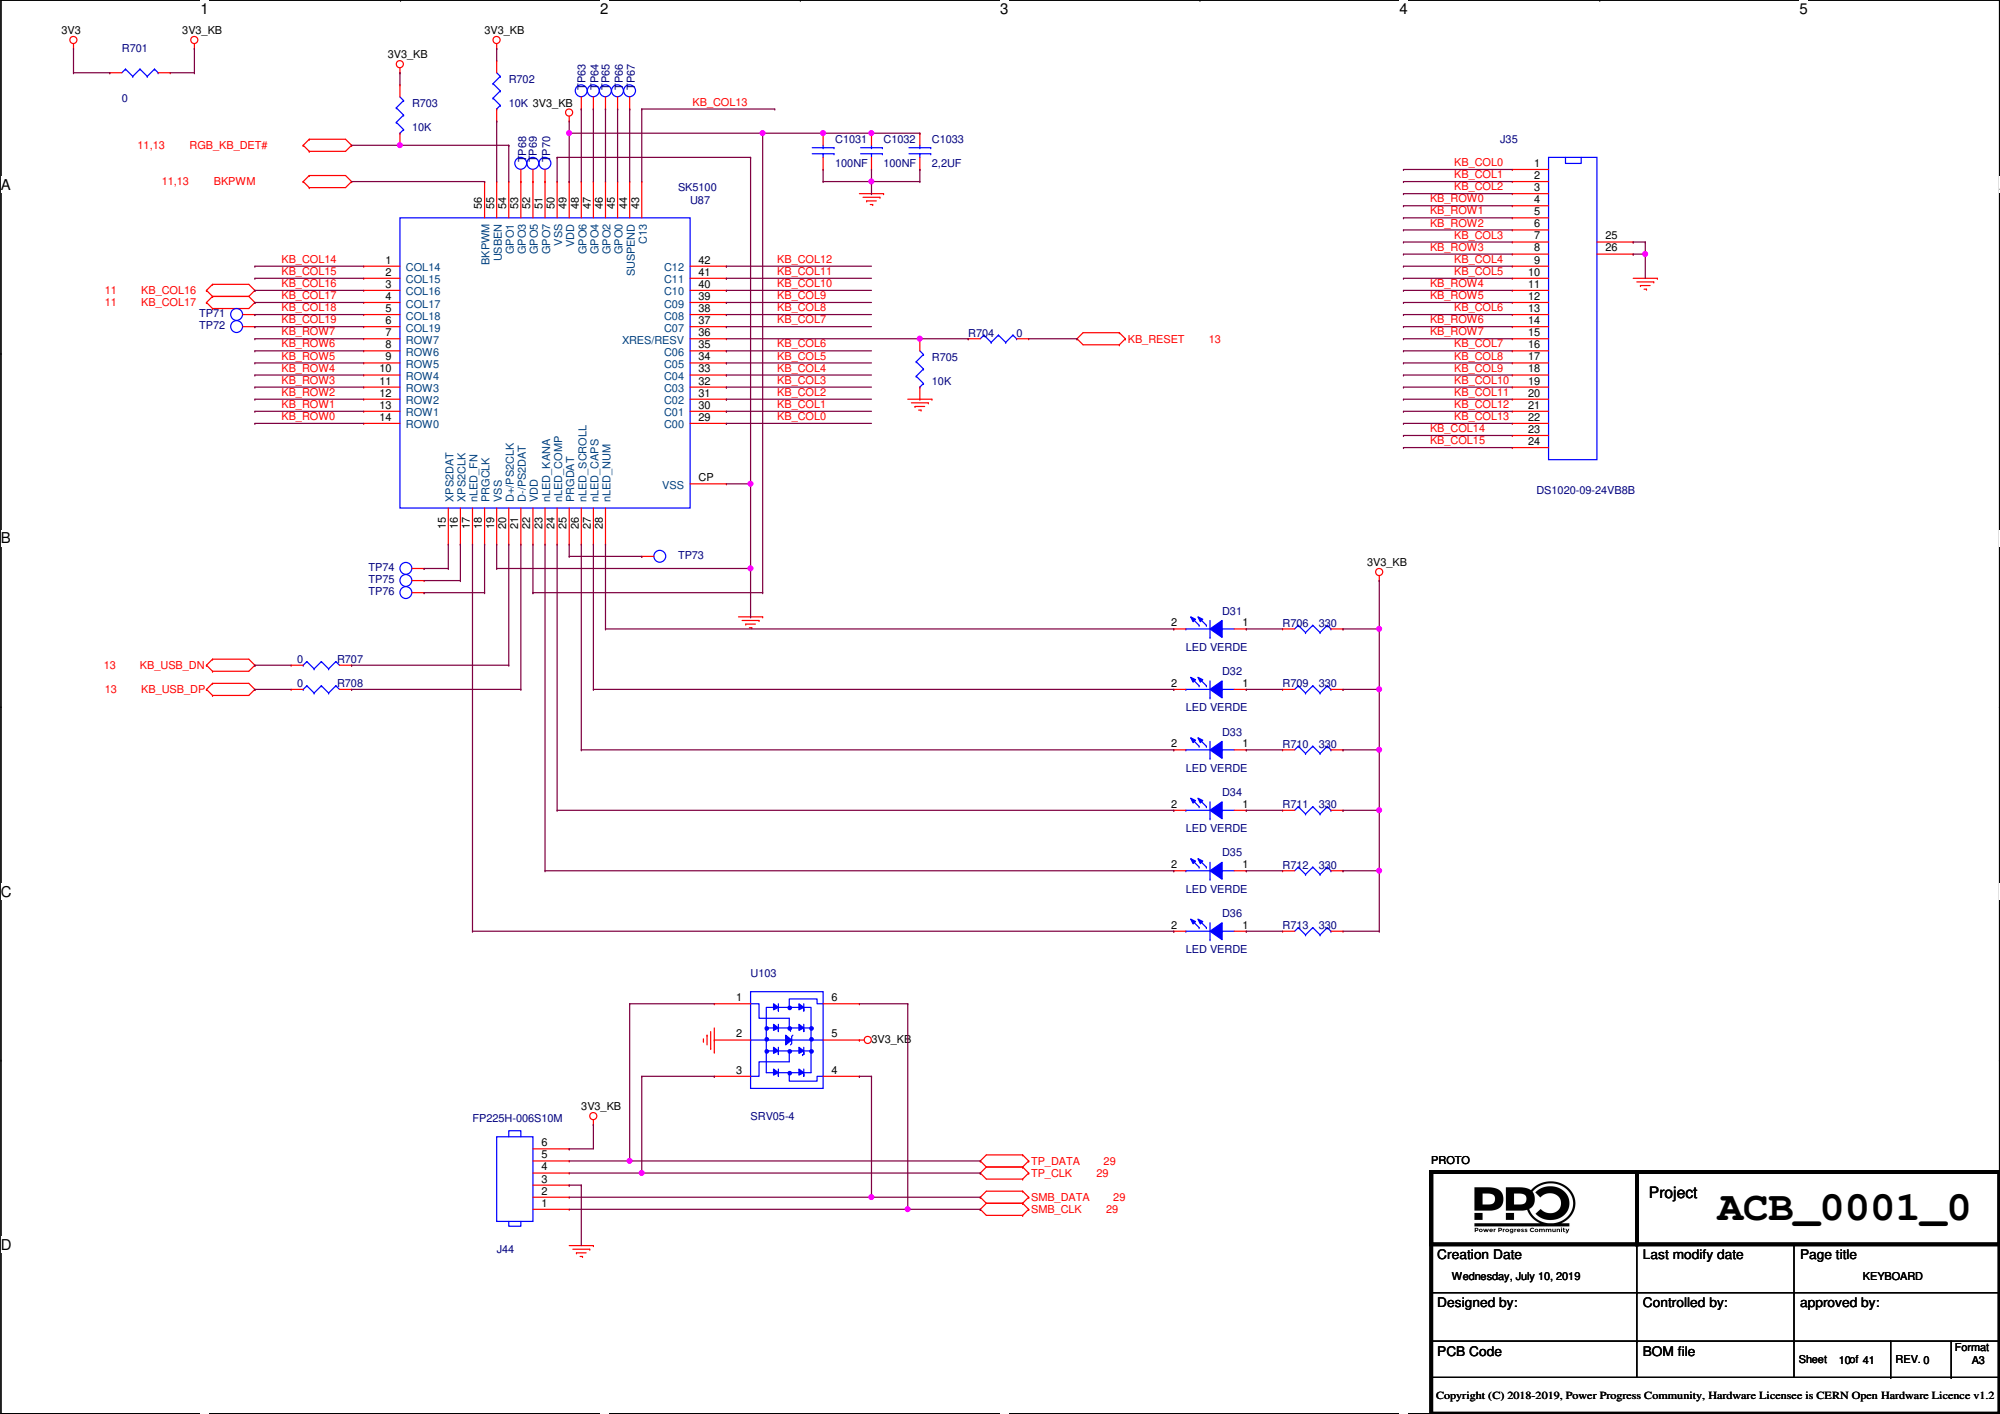
[picture p92: page 10]

A | A
5V

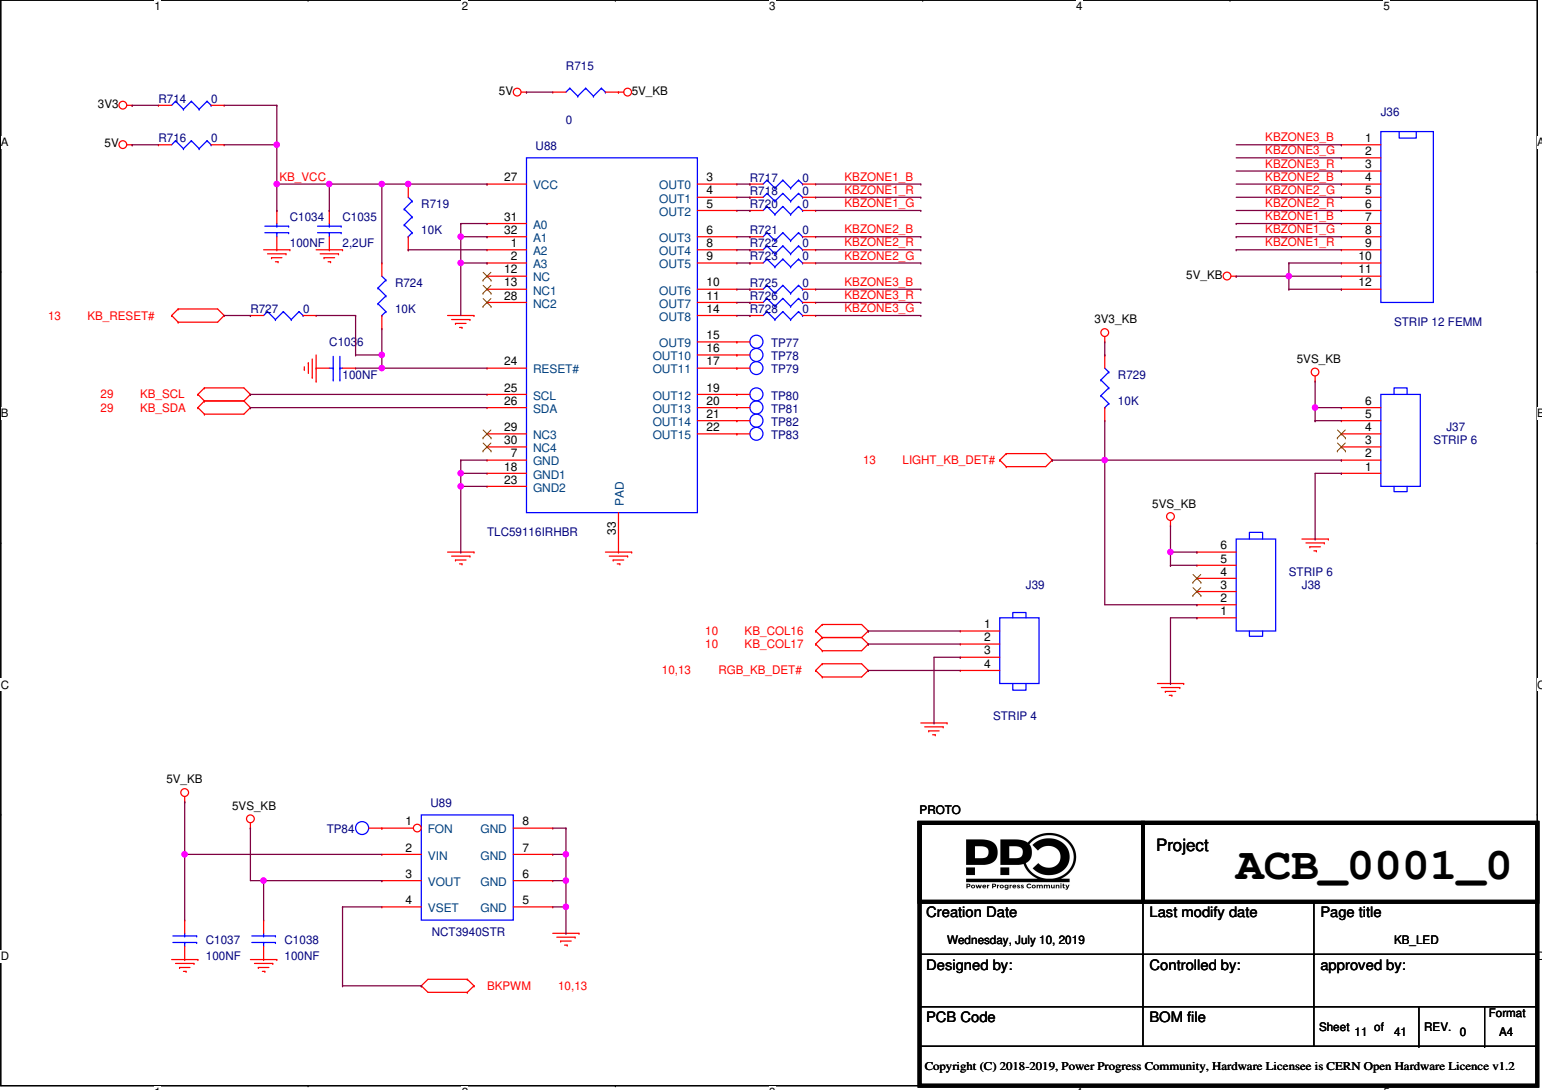
[picture p93: page 11]

# T2080 DUART and I2C DEVICE INTERFACE

### RS-232 XCVR

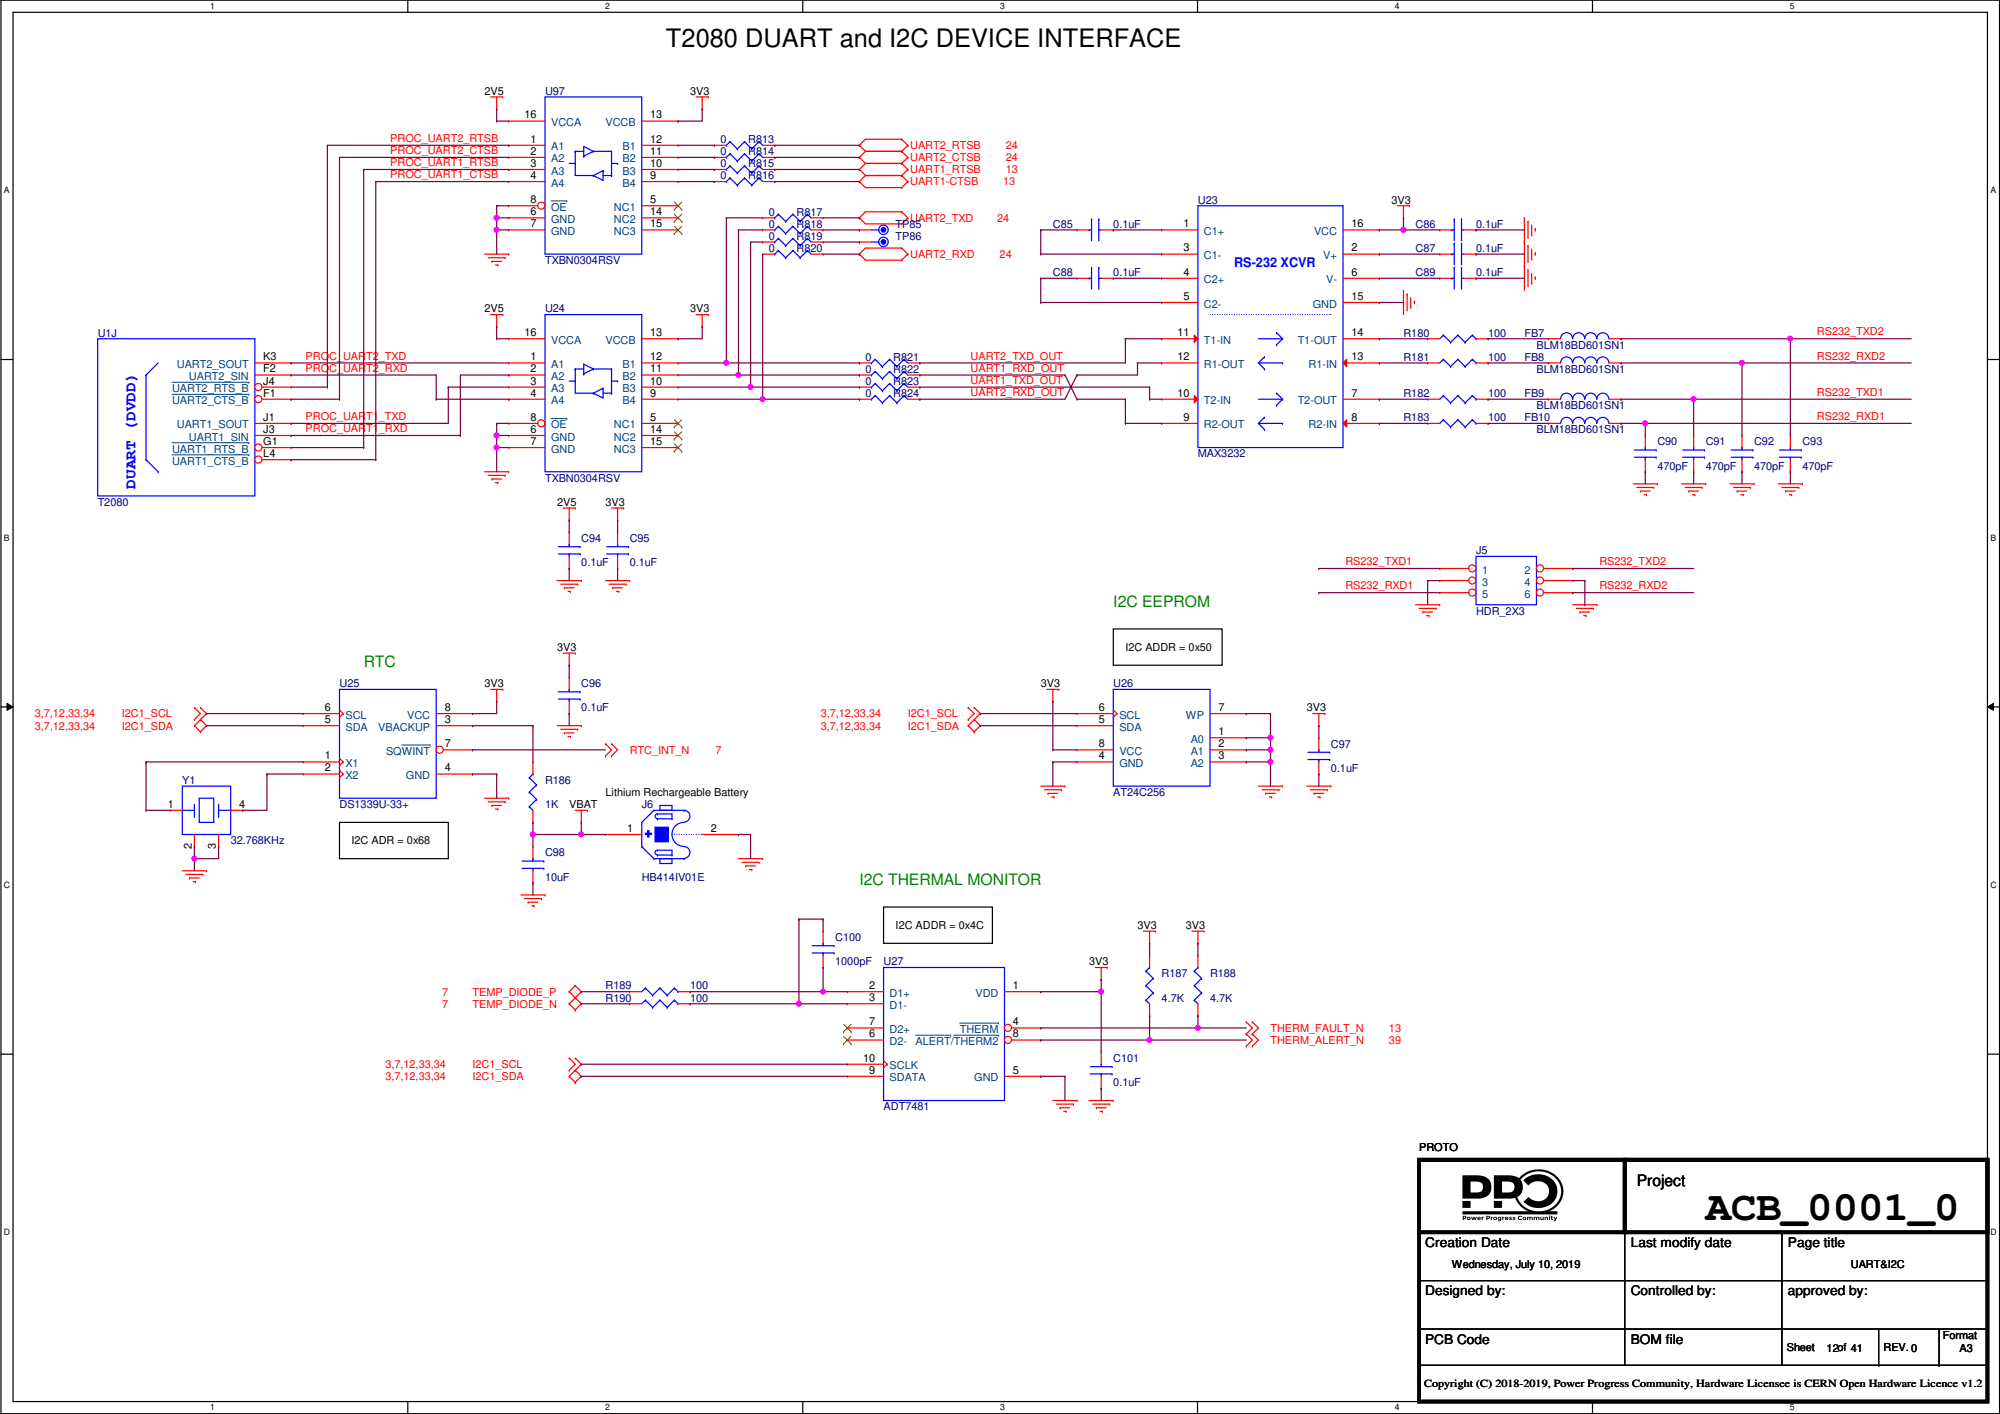
[picture p94: page 12]

1 | 2 | 3 | 4 | 5

A

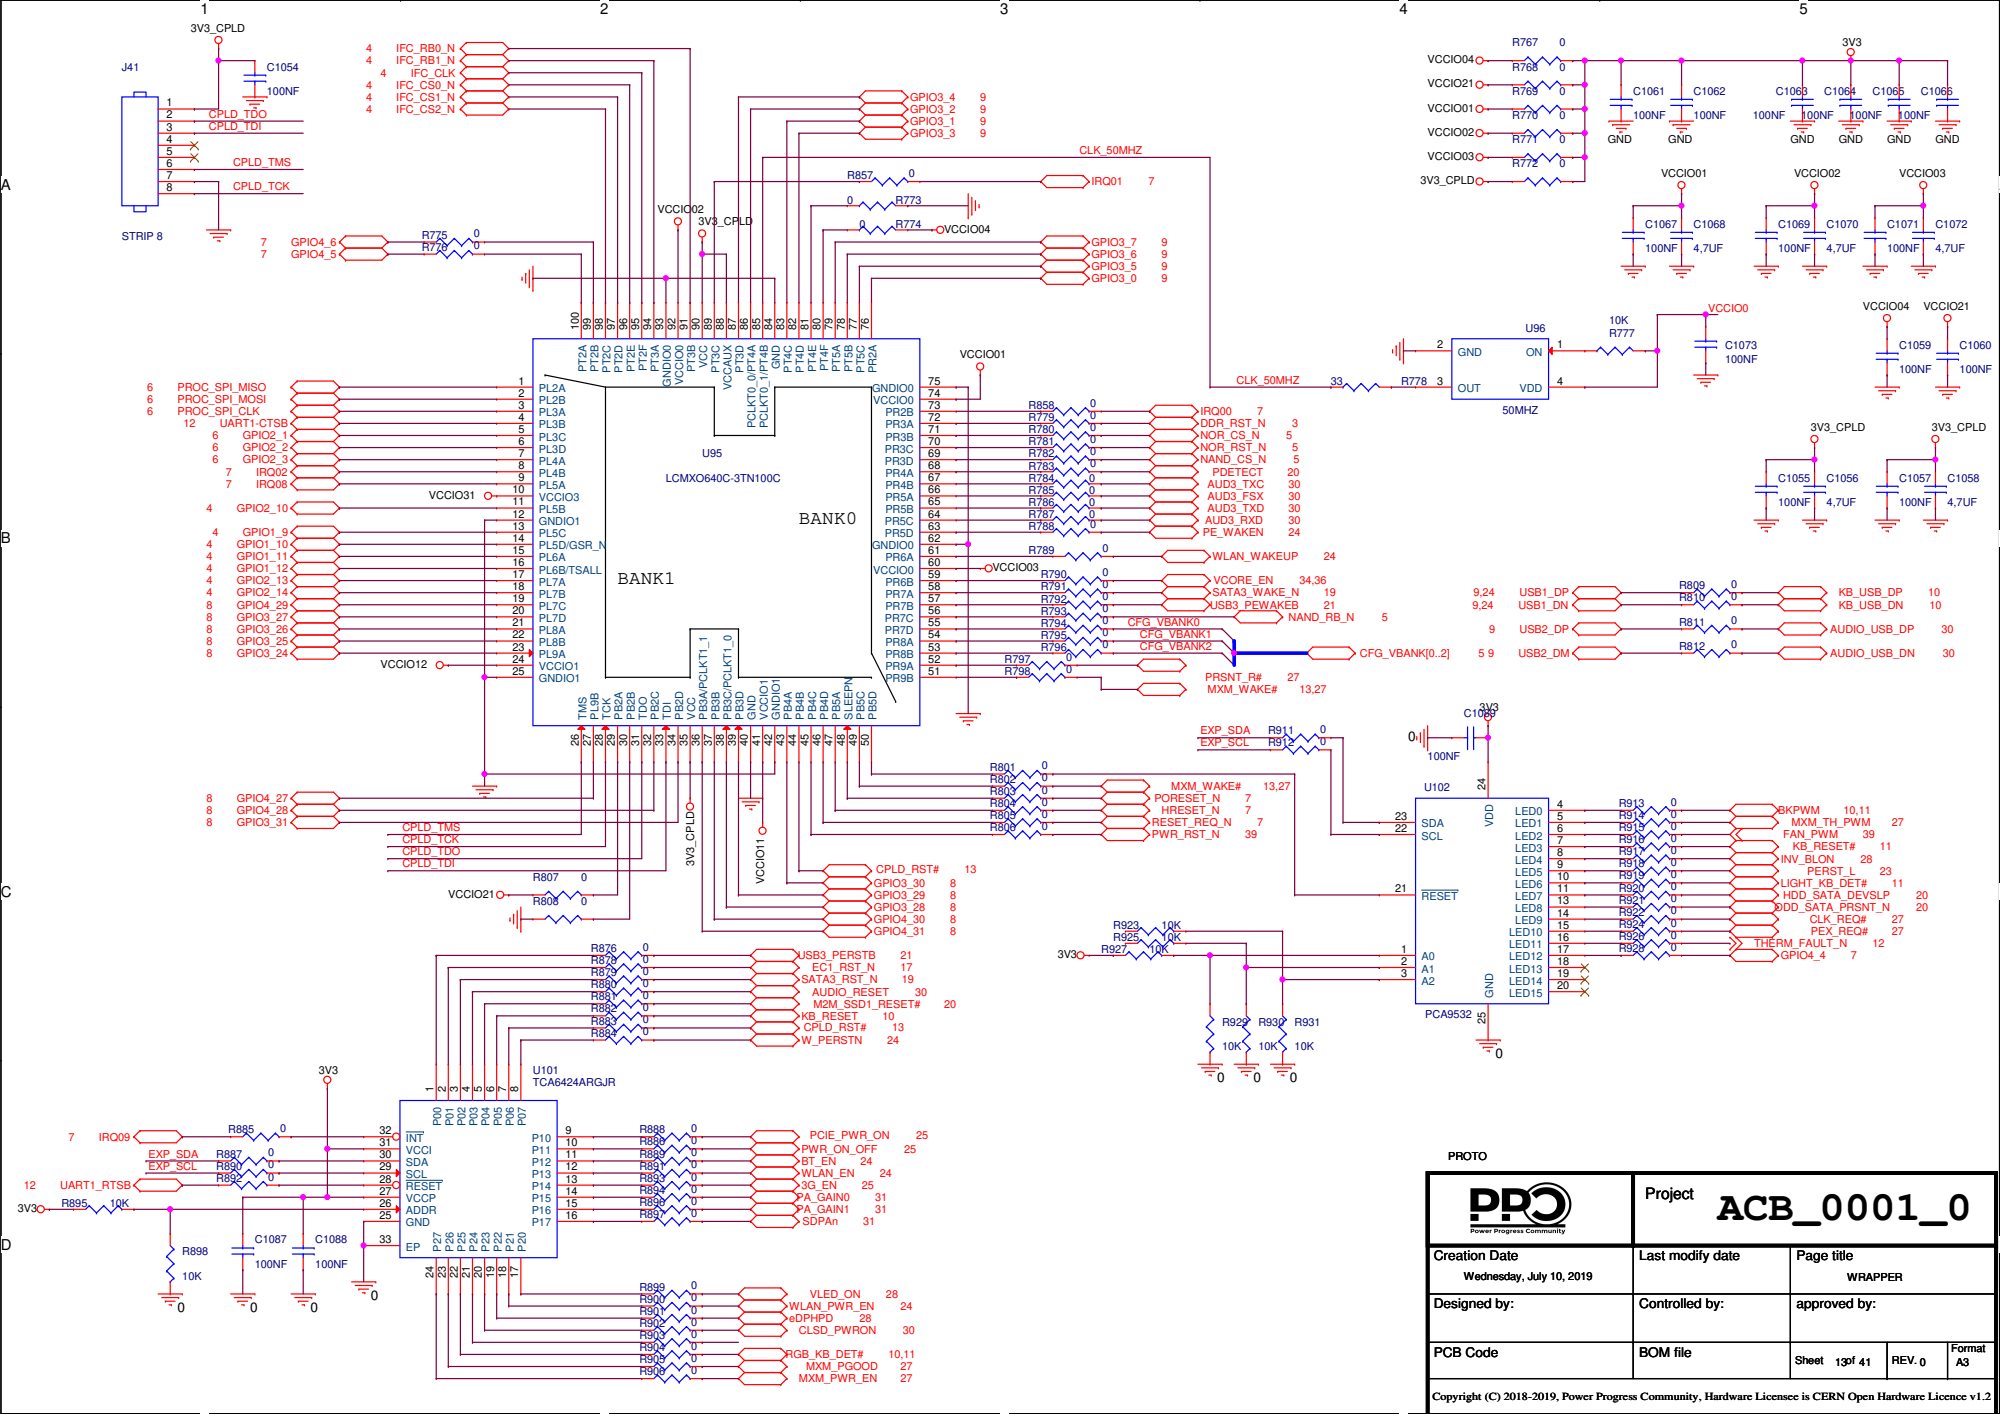
[picture p95: page 13]

# T2080 POWER SUPPLY

PS

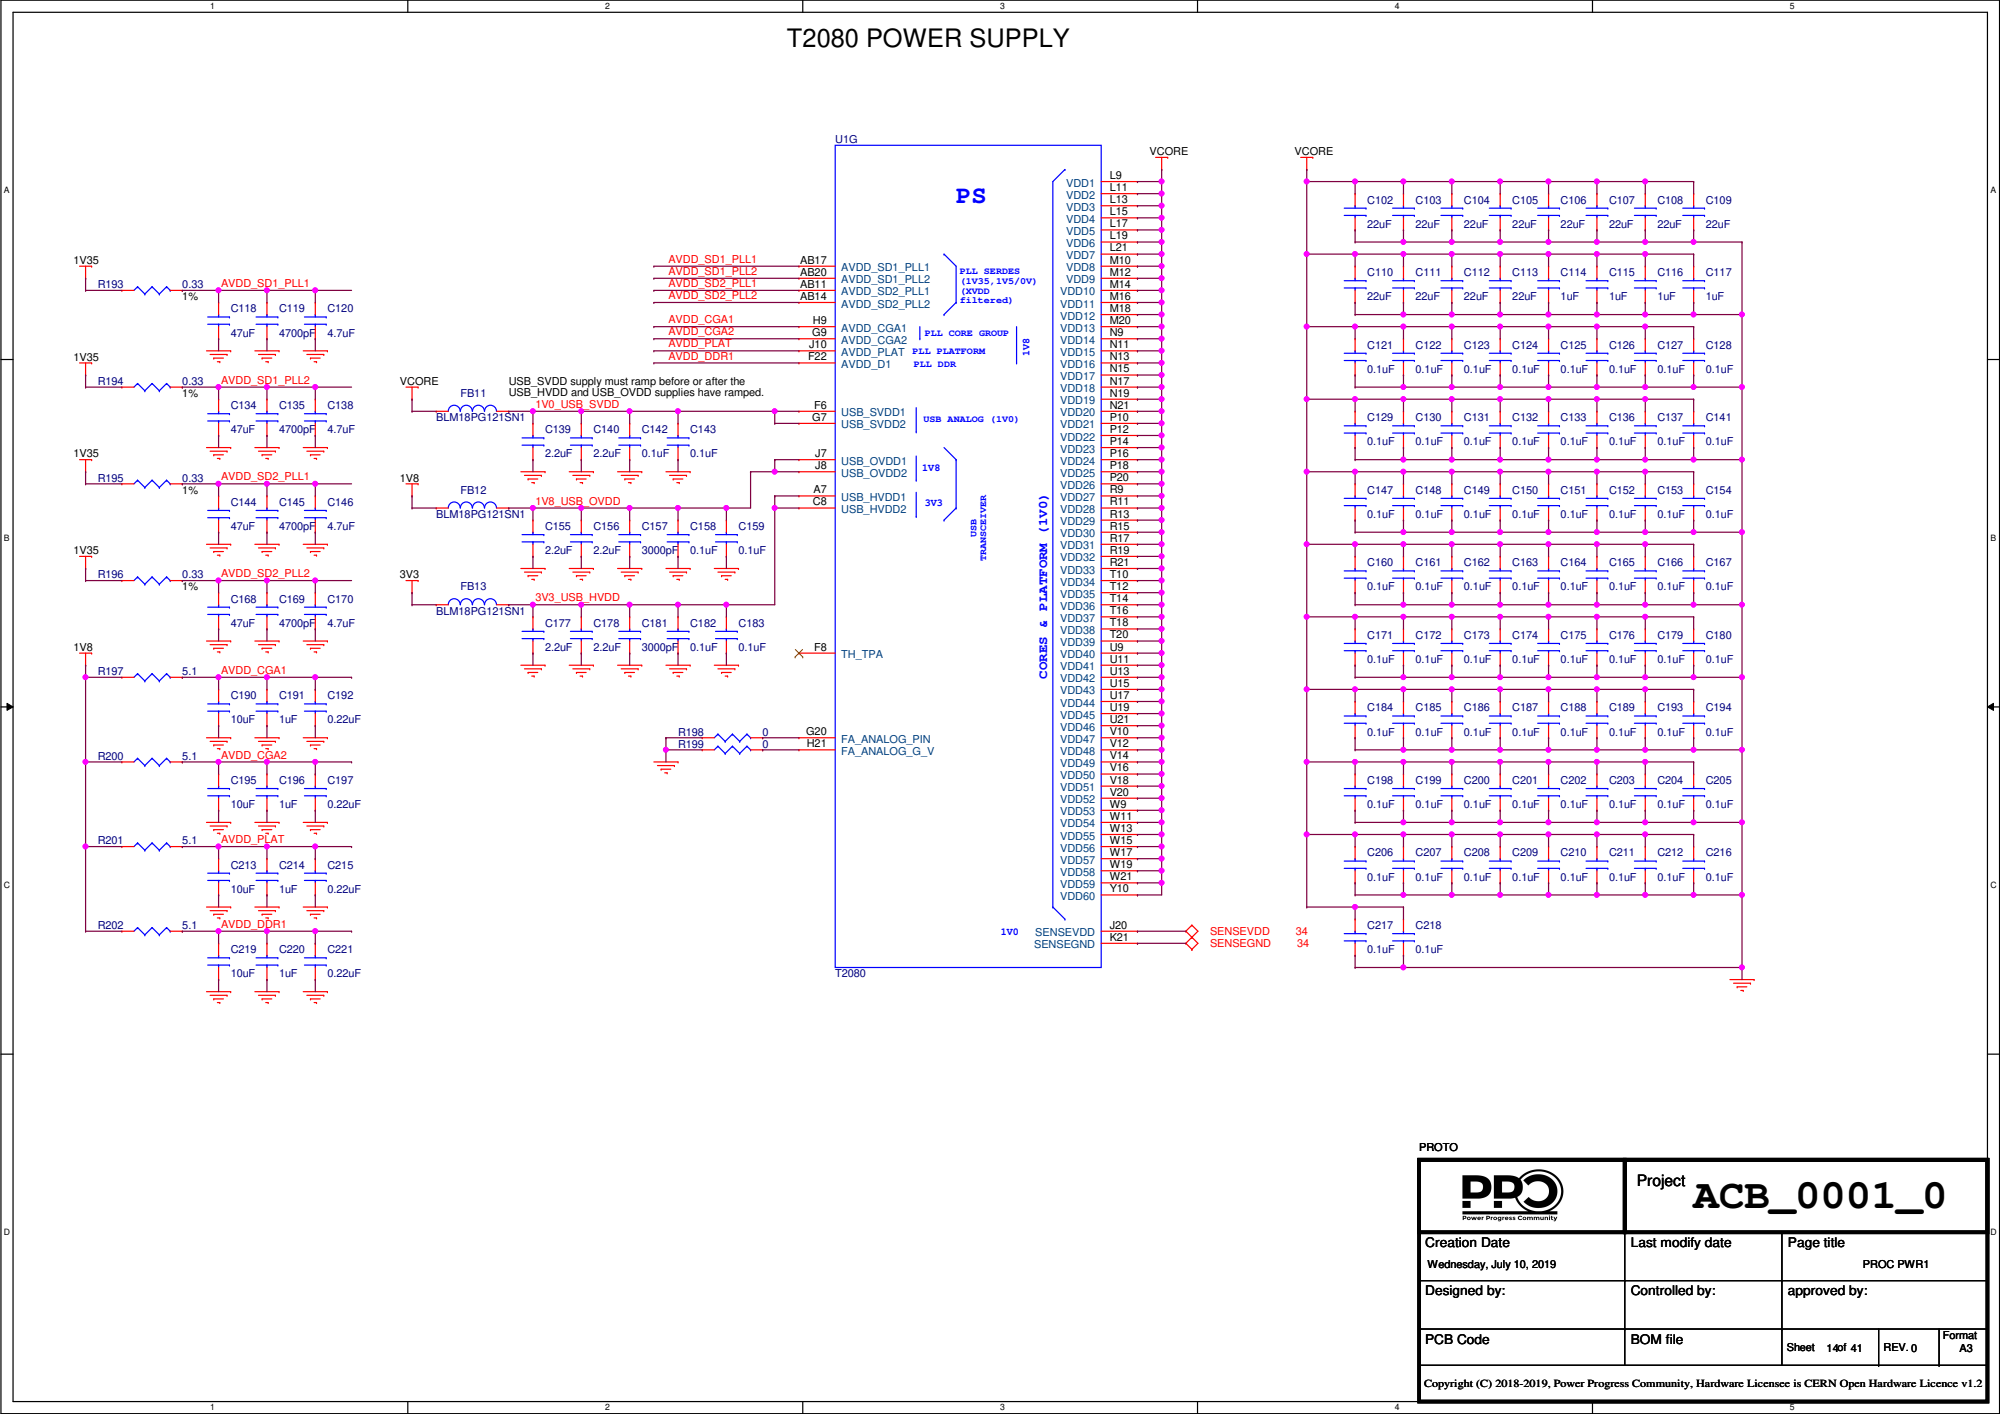
[picture p96: page 14]

USB_SVDD supply must ramp before or after the
USB_HVDD and USB_OVDD supplies have ramped.
1V0_USB_SVDD

# T2080 POWER SUPPLY (cont.)

PS

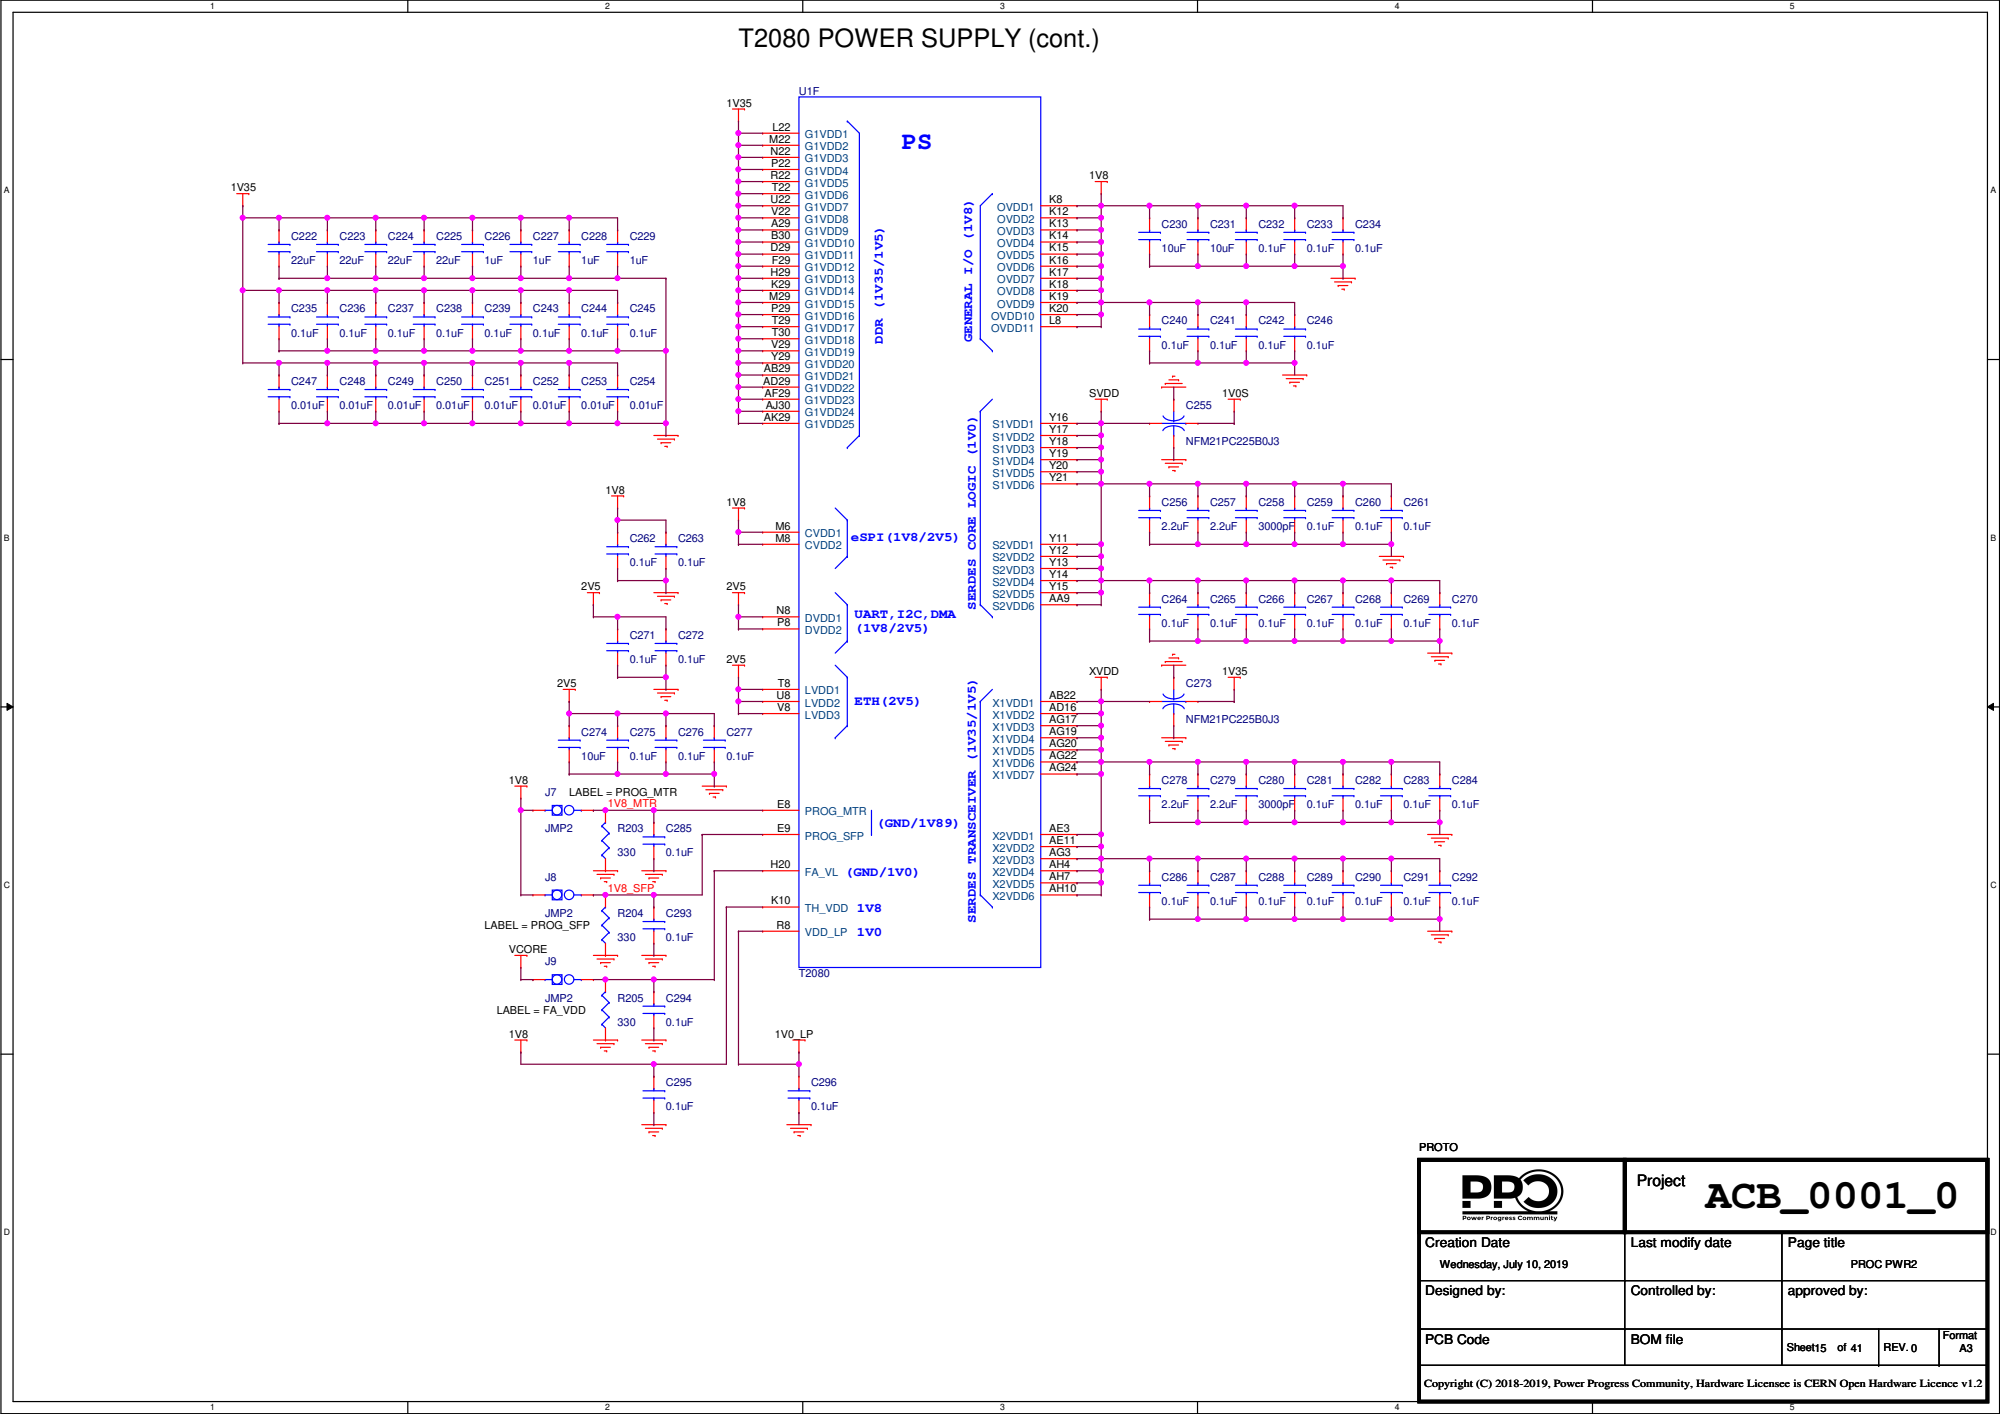
[picture p97: page 15]

GENERAL I/O (1V8) SERDES CORE LOGIC (1V0) SERDES TRANSCEIVER (1V35/1V5) (GND/1V89) (GND/1V0)

# GND

# GND

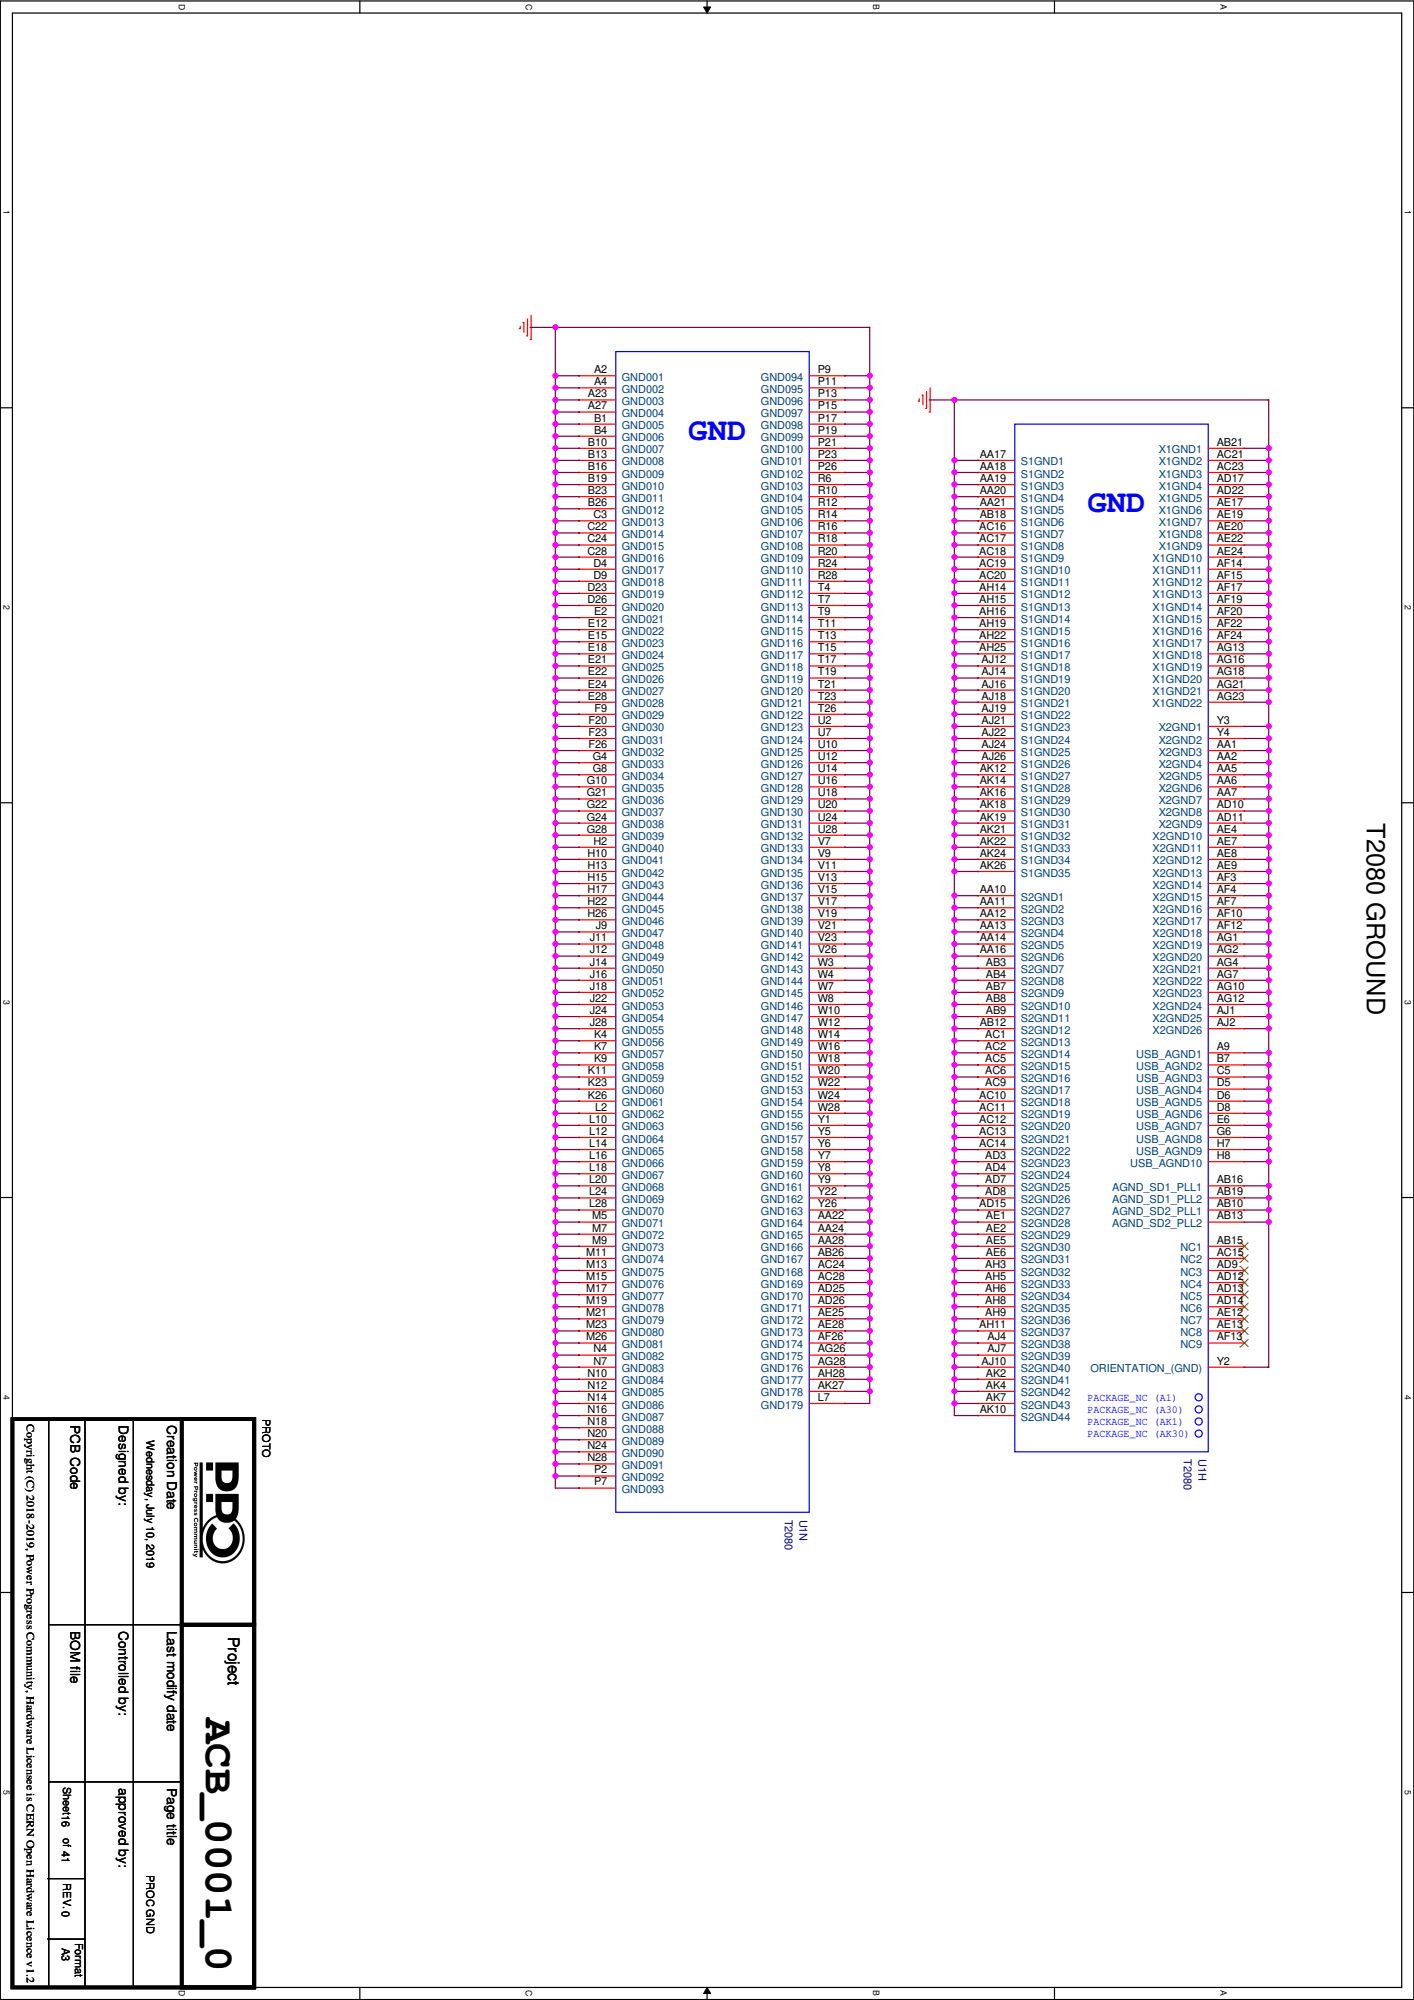
[picture p98: page 16]

Copyright (C) 2018-2019, Power Progress Community, Hardware Licensee is CERN Open Hardware Licence v1.2

PCB Code BOM file

Designed by: Controlled by: approved by:

Creation Date Last modify date

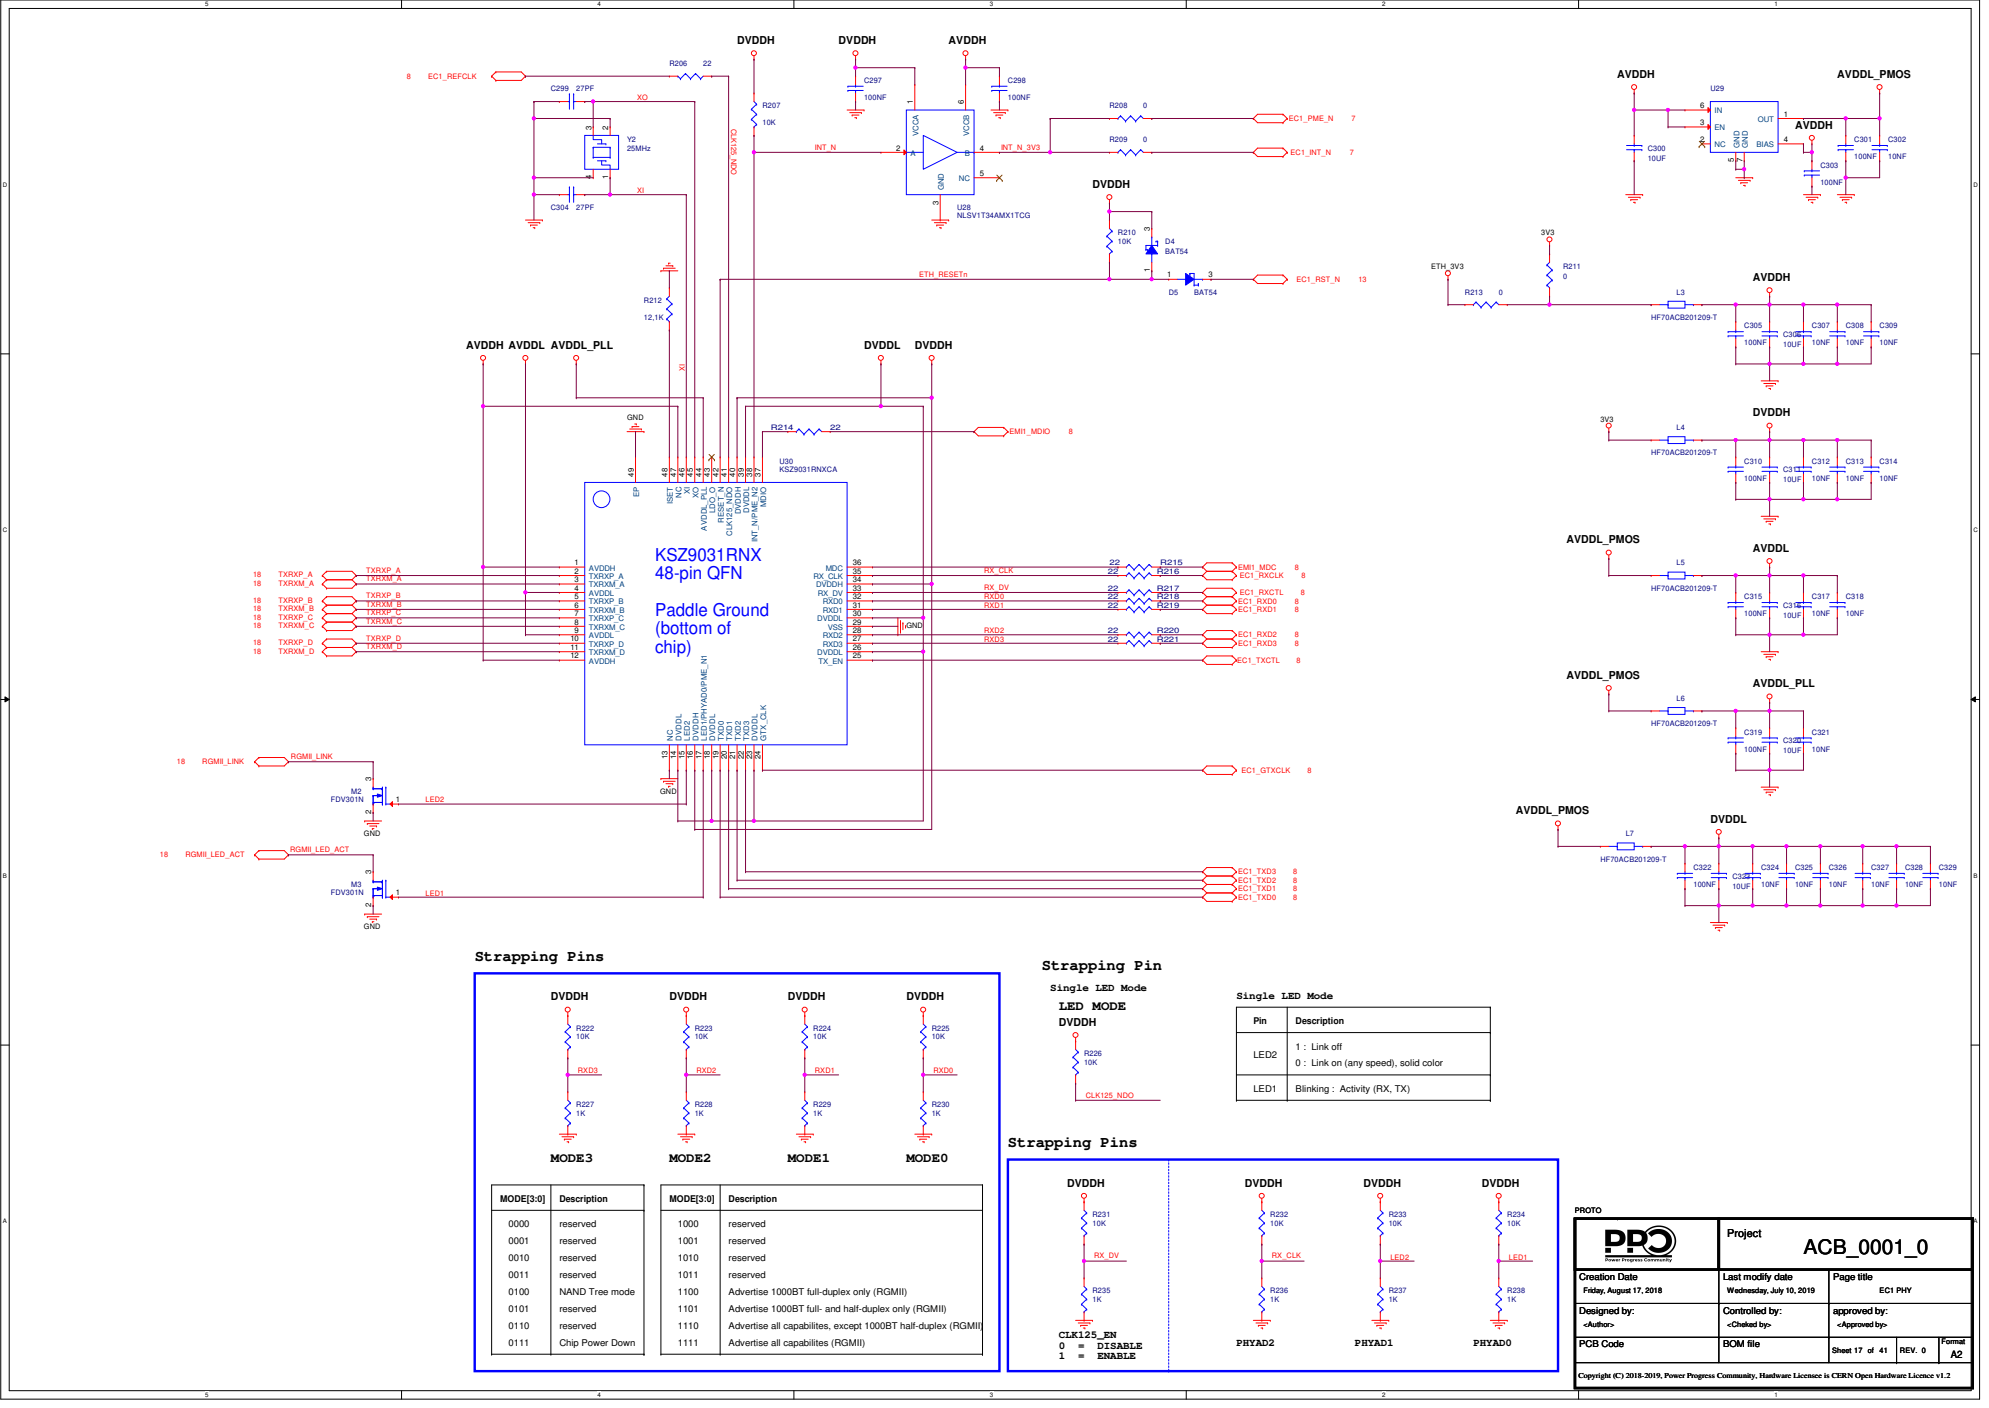
[picture p99: page 17]

Pin | Description

LED2 | 1 : Link off 0 : Link on (any speed), solid color

Blinking : Activity (RX, TX)

reserved
Advertise 1000BT full-duplex only (RGMII)
Advertise 1000BT full- and half-duplex only (RGMII)

Advertise all capabilites, except 1000BT half-duplex (RGMII)

D | D

# Gigabit Ethernet

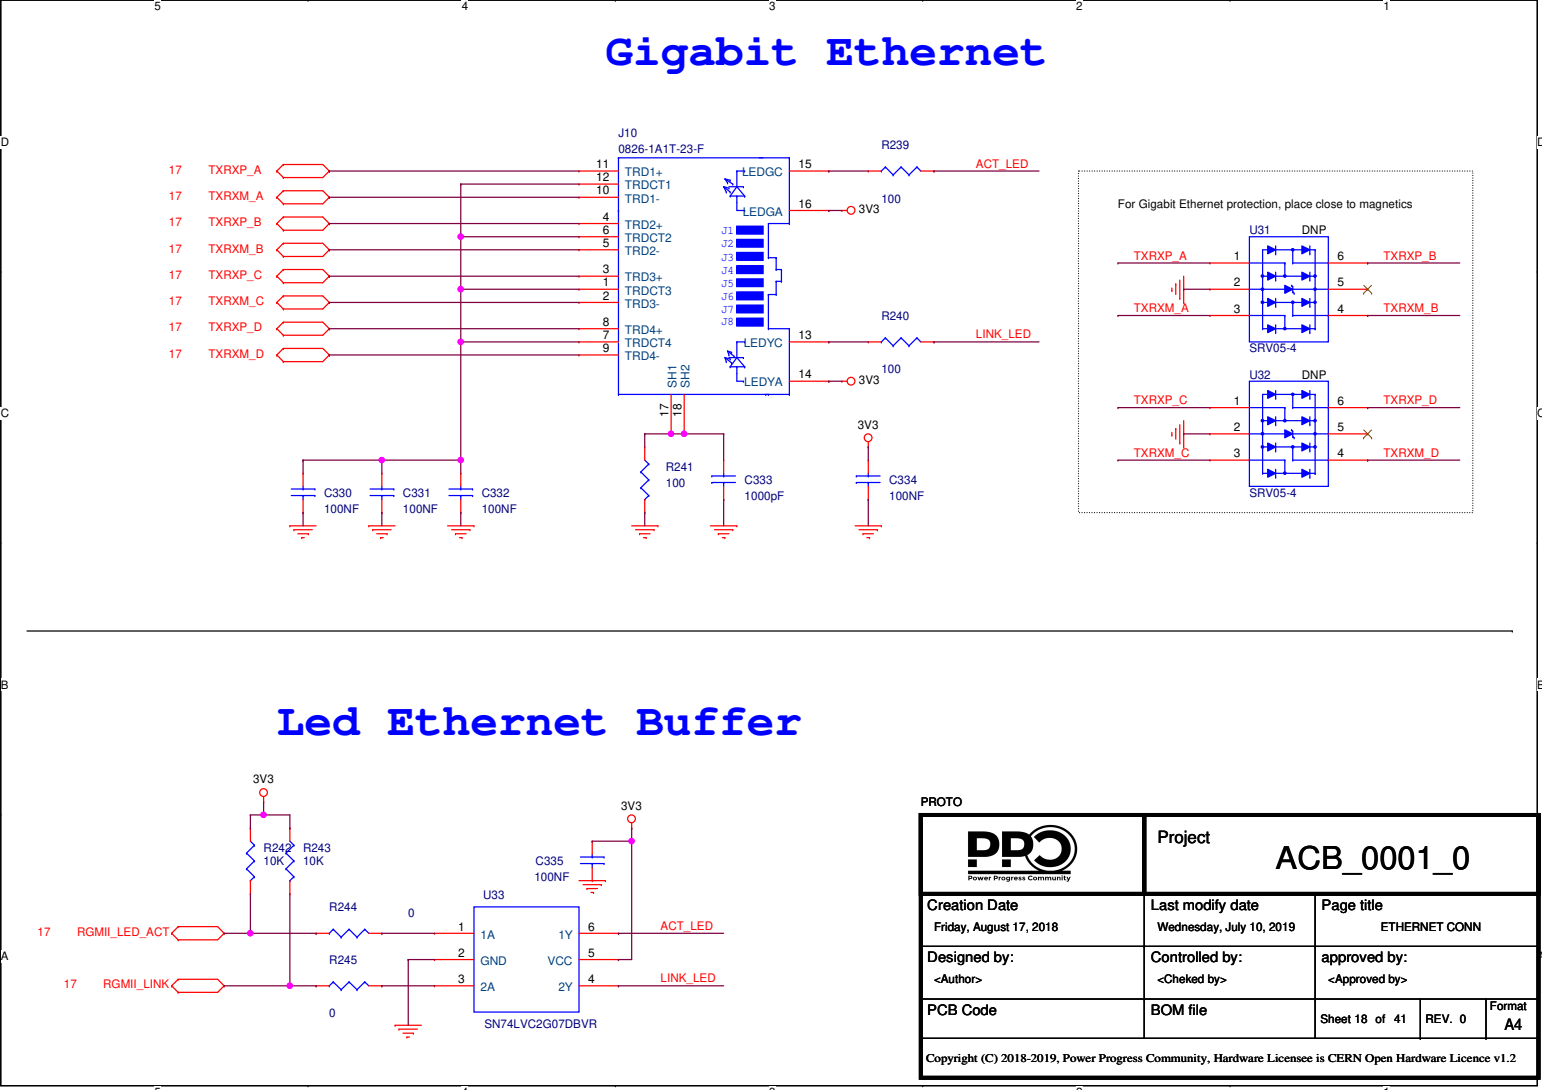
[picture p100: page 18]

For Gigabit Ethernet protection, place close to magnetics

# MagniPlus -SATA Interface

### MagniPlus

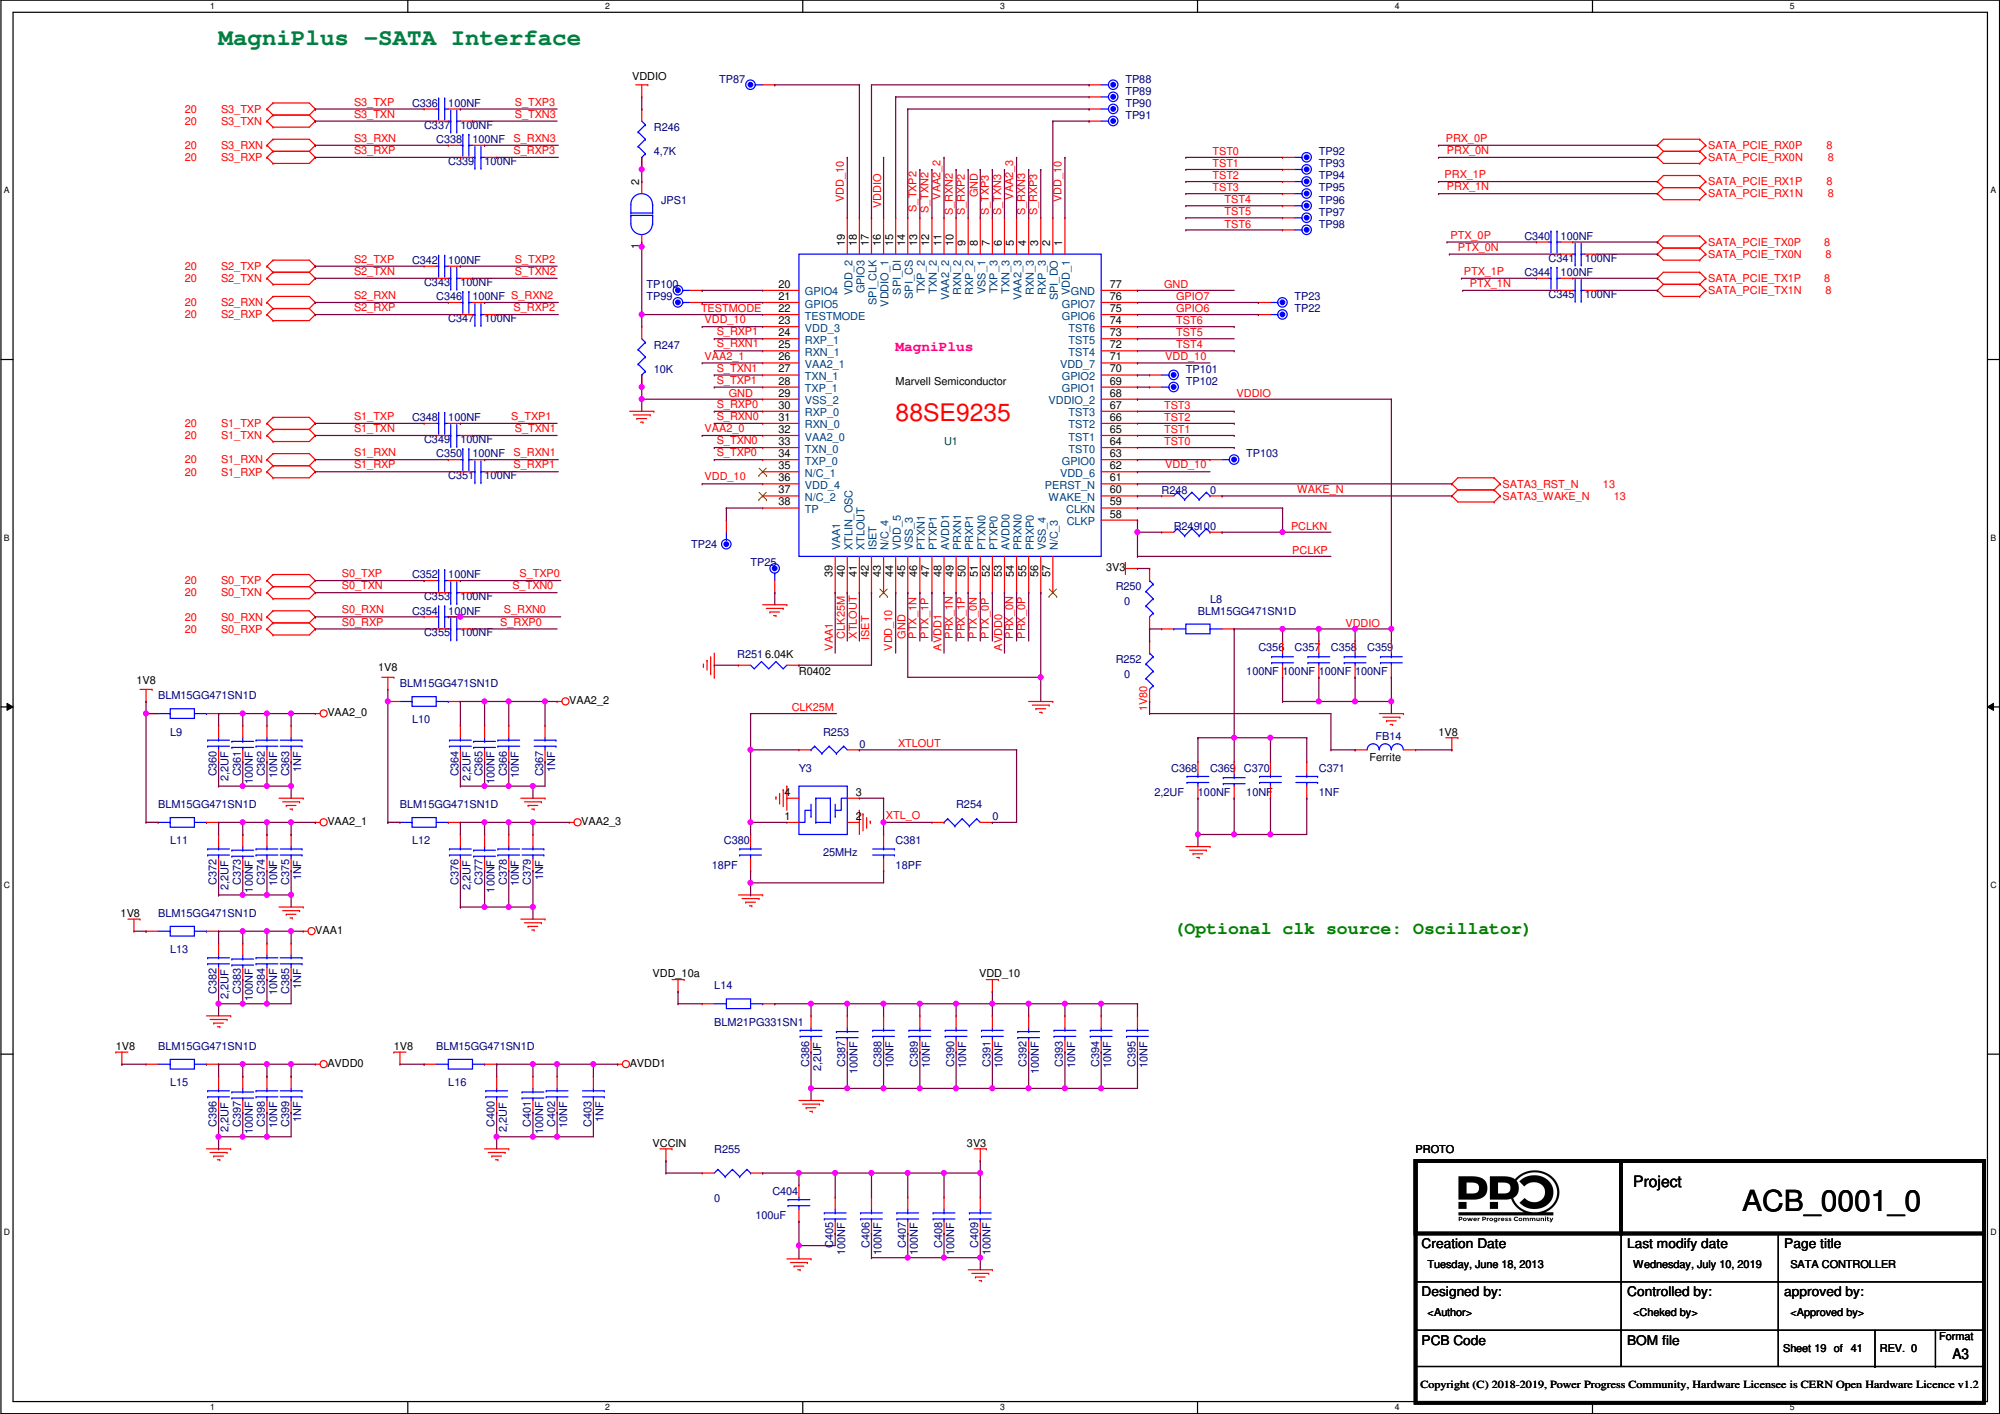
[picture p101: page 19]

(Optional clk source: Oscillator)

1 | 2 | 3 | 4 | 5
A | A

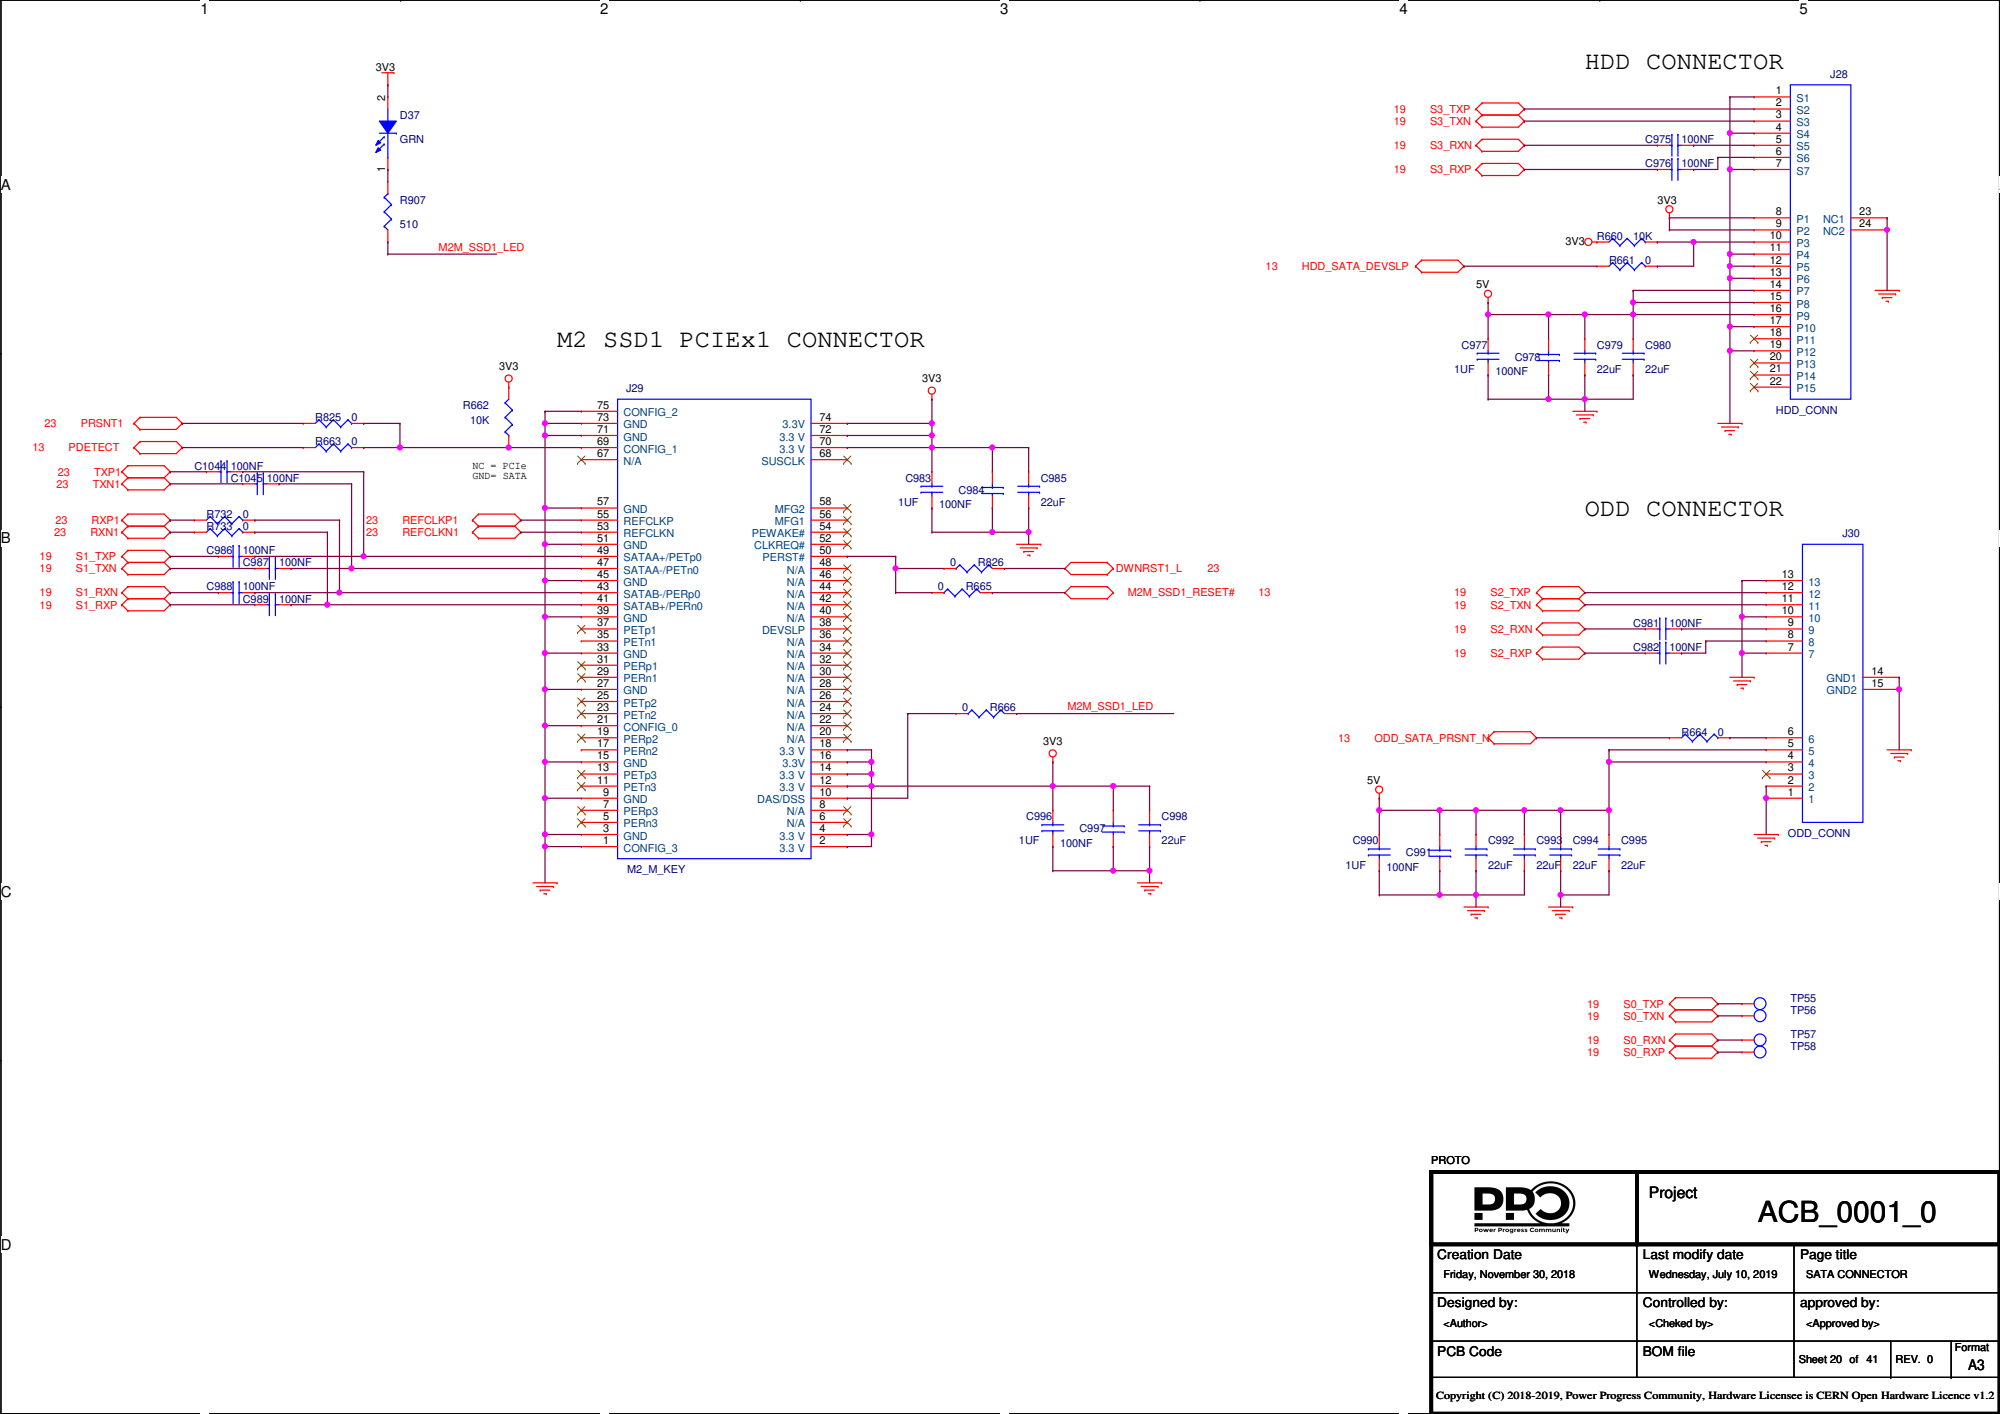
[picture p102: page 20]

### Power Regulator

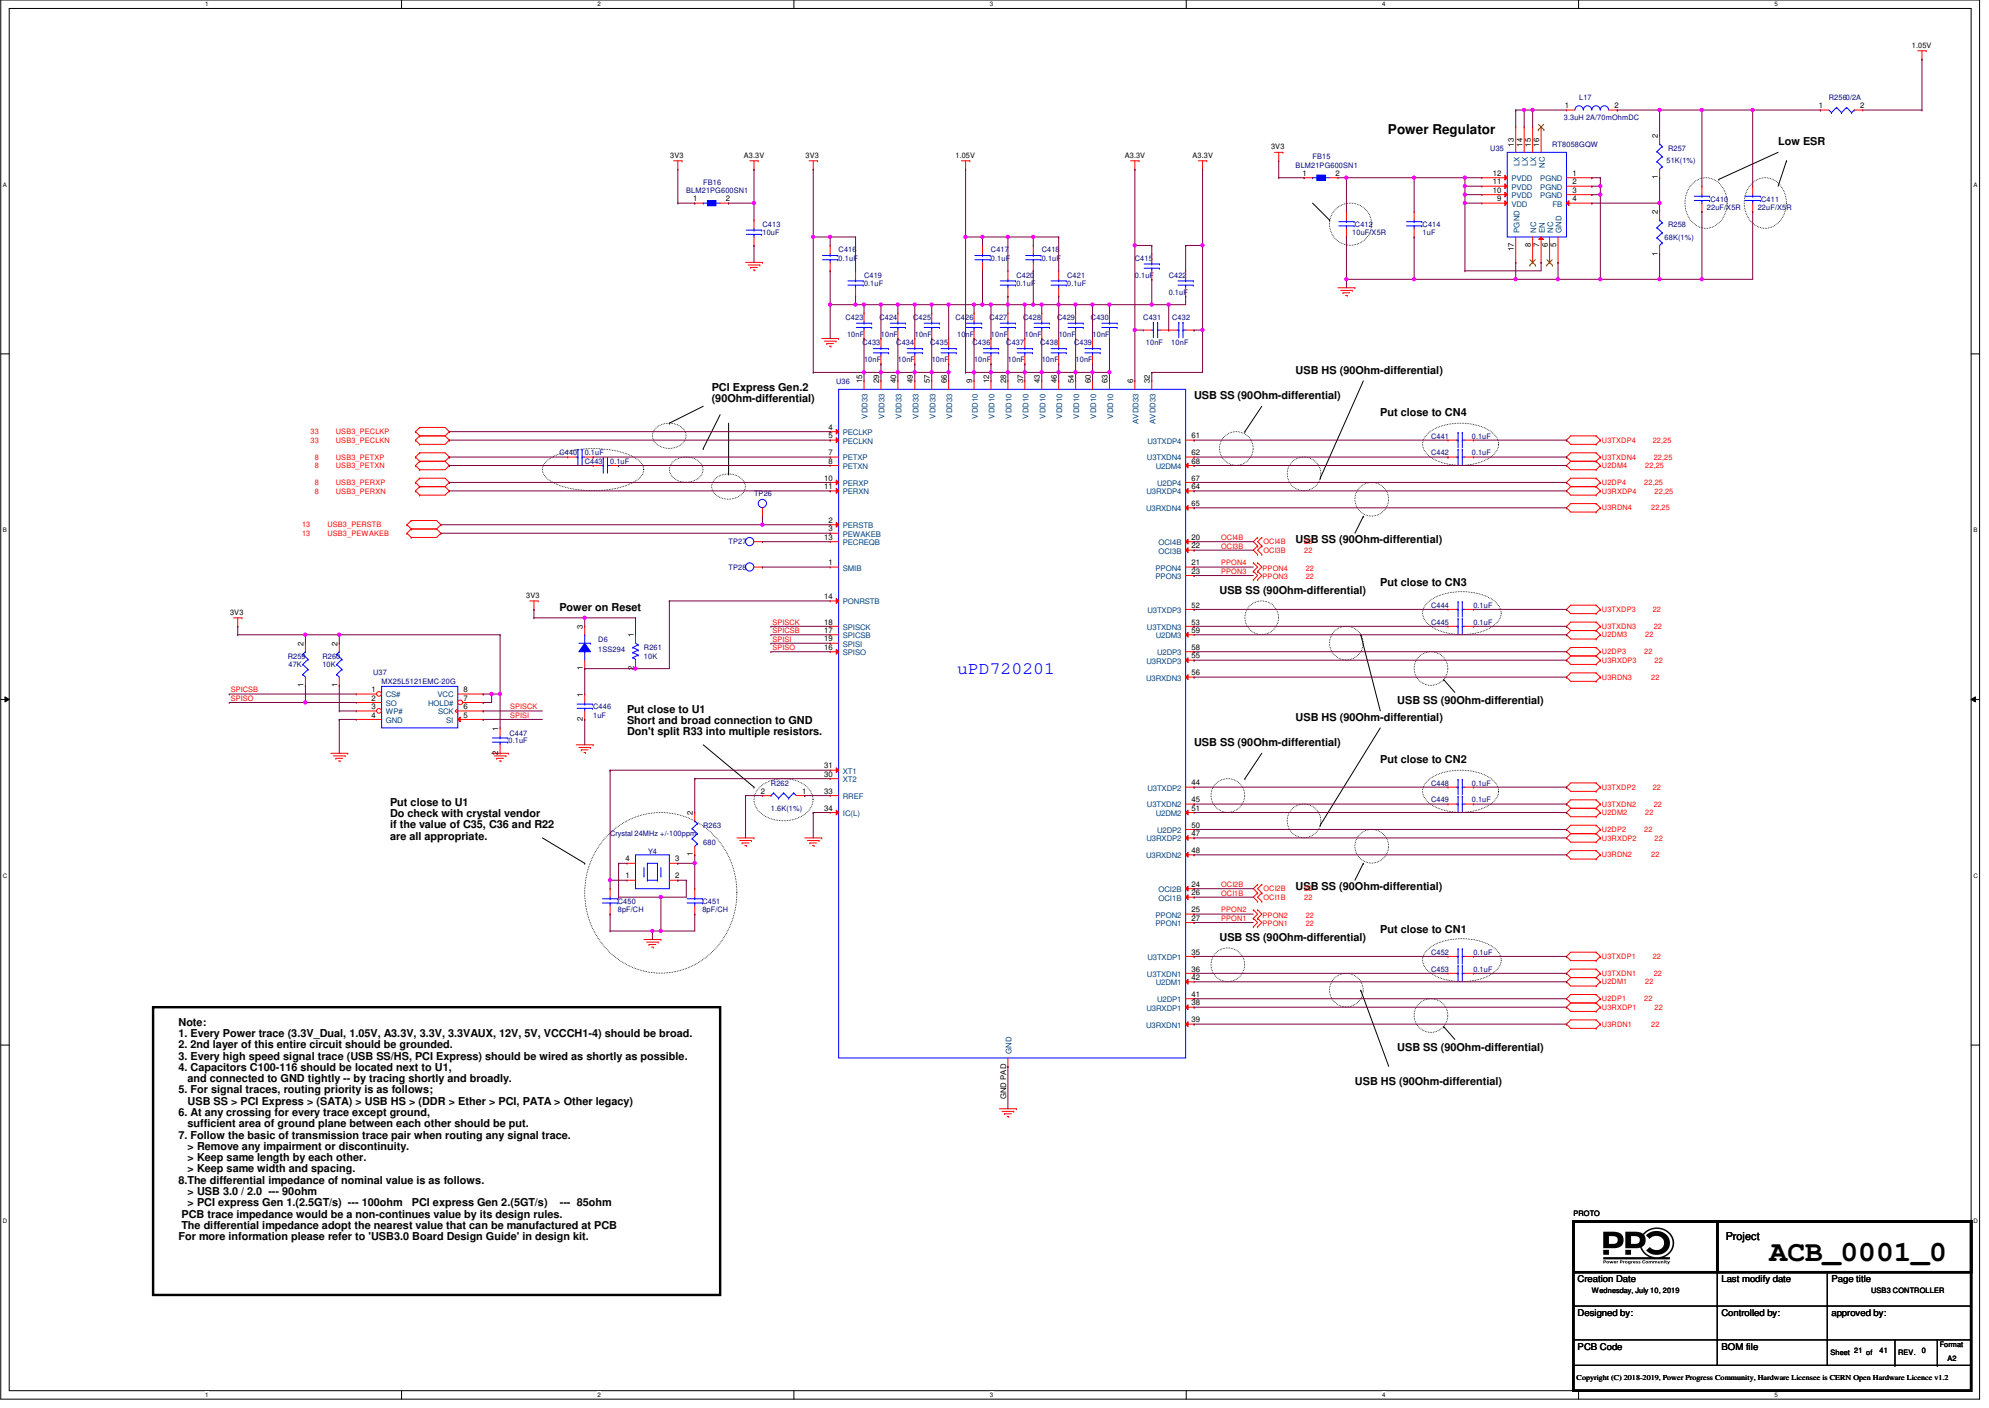
[picture p103: page 21]

Put close to U1
Short and broad connection to GND
Don't split R33 into multiple resistors.

Do check with crystal vendor
if the value of C35, C36 and R22
are all appropriate.

Note:
1. Every Power trace (3.3V_Dual, 1.05V, A3.3V, 3.3V, 3.3VAUX, 12V, 5V, VCCCH1-4) should be broad.
2. 2nd layer of this entire circuit should be grounded.
3. Every high speed signal trace (USB SS/HS, PCI Express) should be wired as shortly as possible.
4. Capacitors C100-116 should be located next to U1,
and connected to GND tightly -- by tracing shortly and broadly.
5. For signal traces, routing priority is as follows;
USB SS > PCI Express > (SATA) > USB HS > (DDR > Ether > PCI, PATA > Other legacy)
6. At any crossing for every trace except ground,
sufficient area of ground plane between each other should be put.
7. Follow the basic of transmission trace pair when routing any signal trace.
> Remove any impairment or discontinuity.
> Keep same length by each other.
> Keep same width and spacing.
8.The differential impedance of nominal value is as follows.
> USB 3.0 / 2.0 --- 90ohm
> PCI express Gen 1.(2.5GT/s) --- 100ohm PCI express Gen 2.(5GT/s) --- 85ohm
PCB trace impedance would be a non-continues value by its design rules.
The differential impedance adopt the nearest value that can be manufactured at PCB
For more information please refer to 'USB3.0 Board Design Guide' in design kit.

# SS/CL

# SS/CL

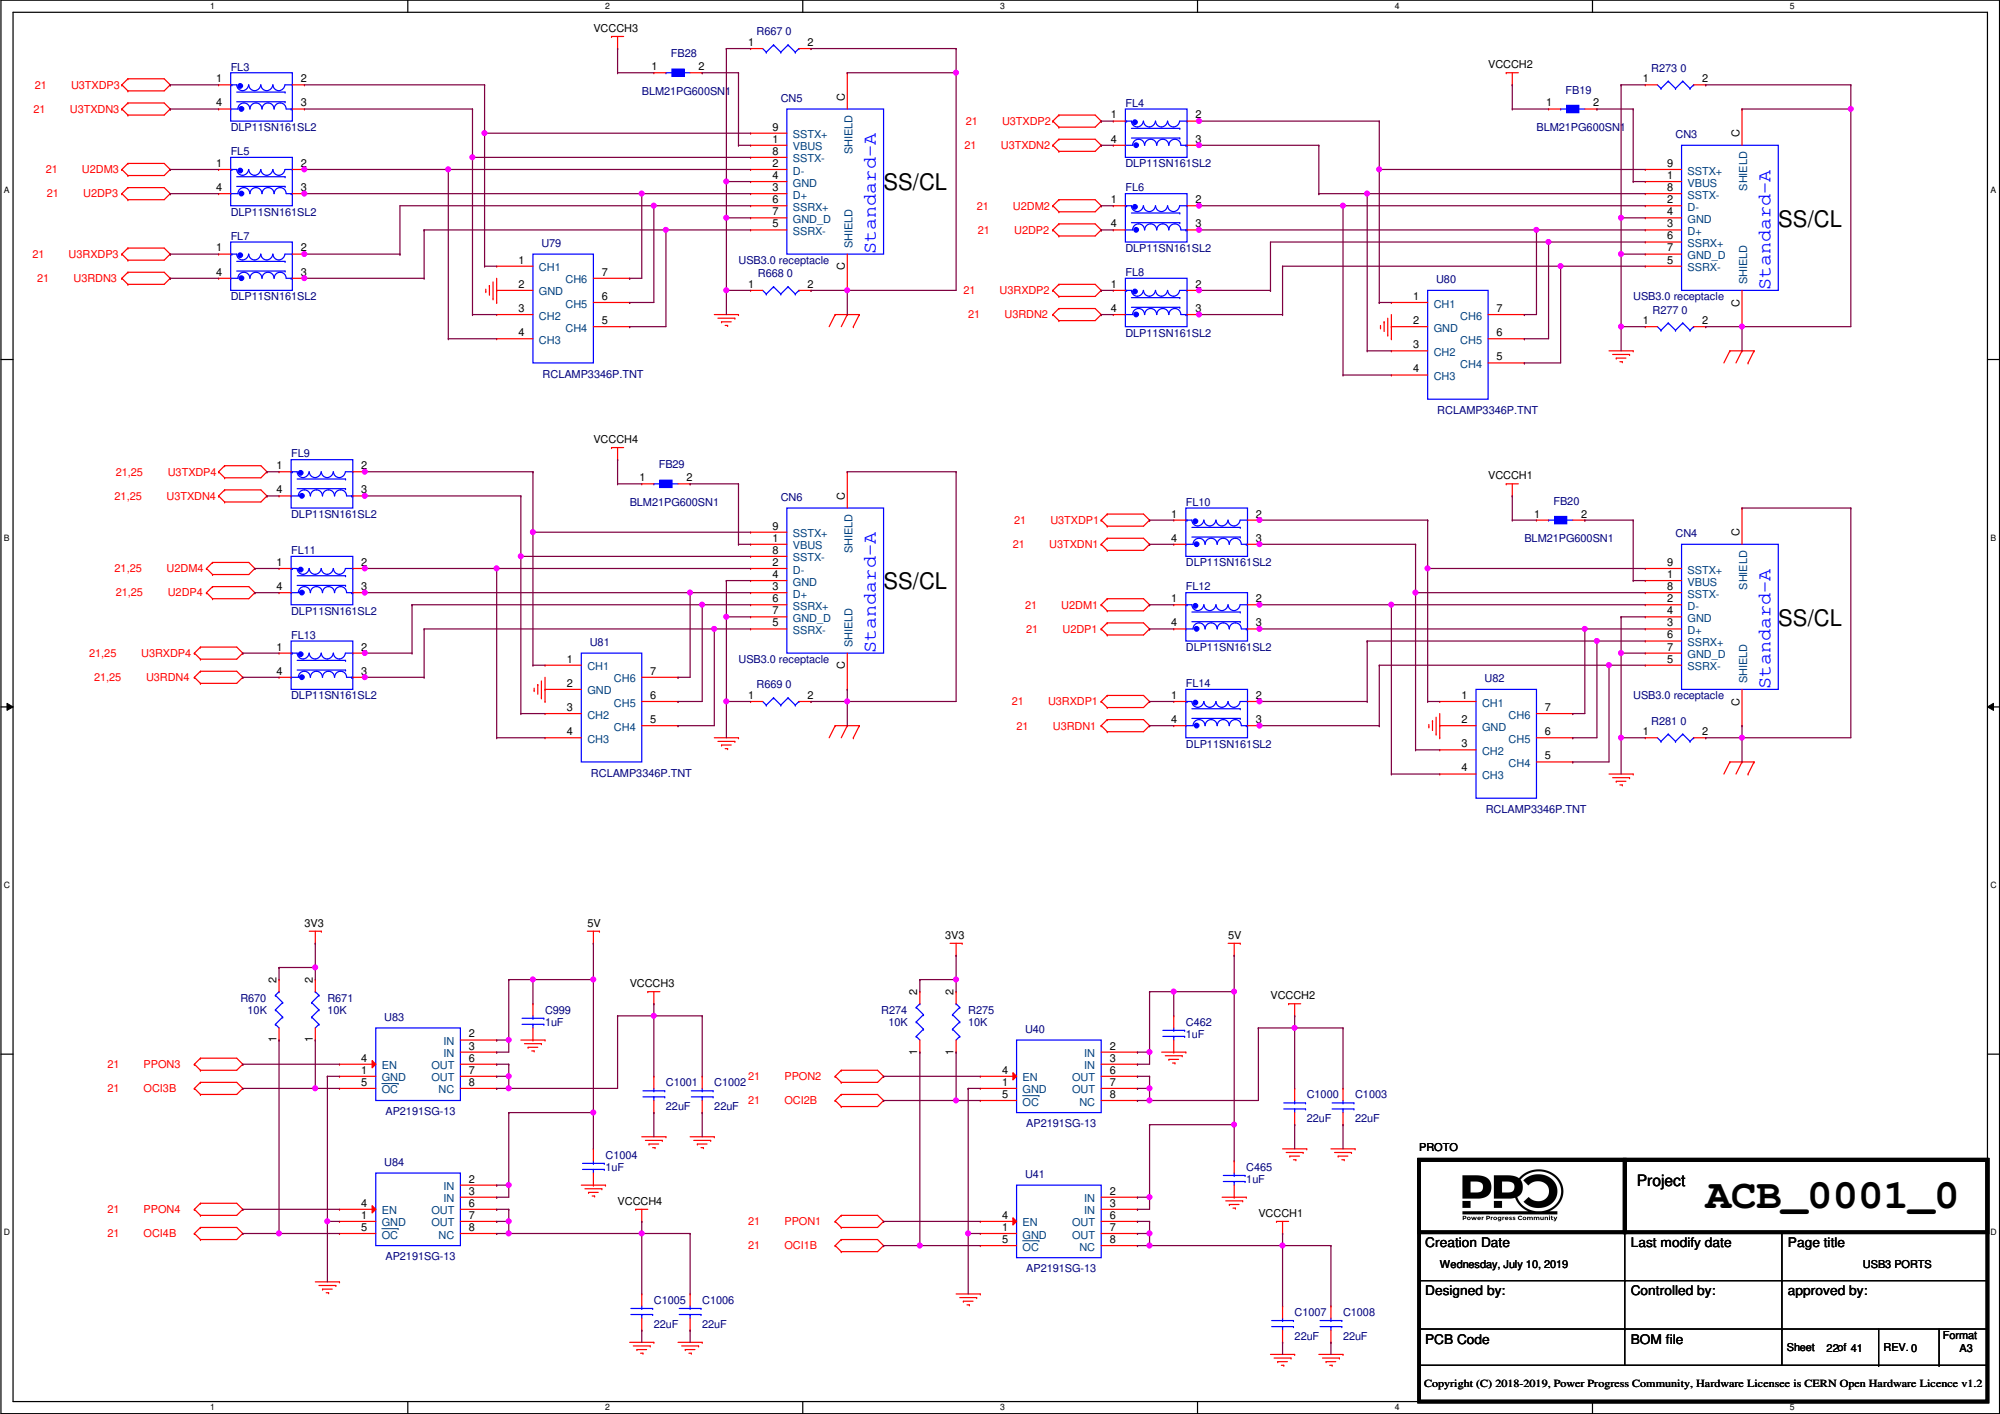
[picture p104: page 22]

## SMBUS

## EEPROM

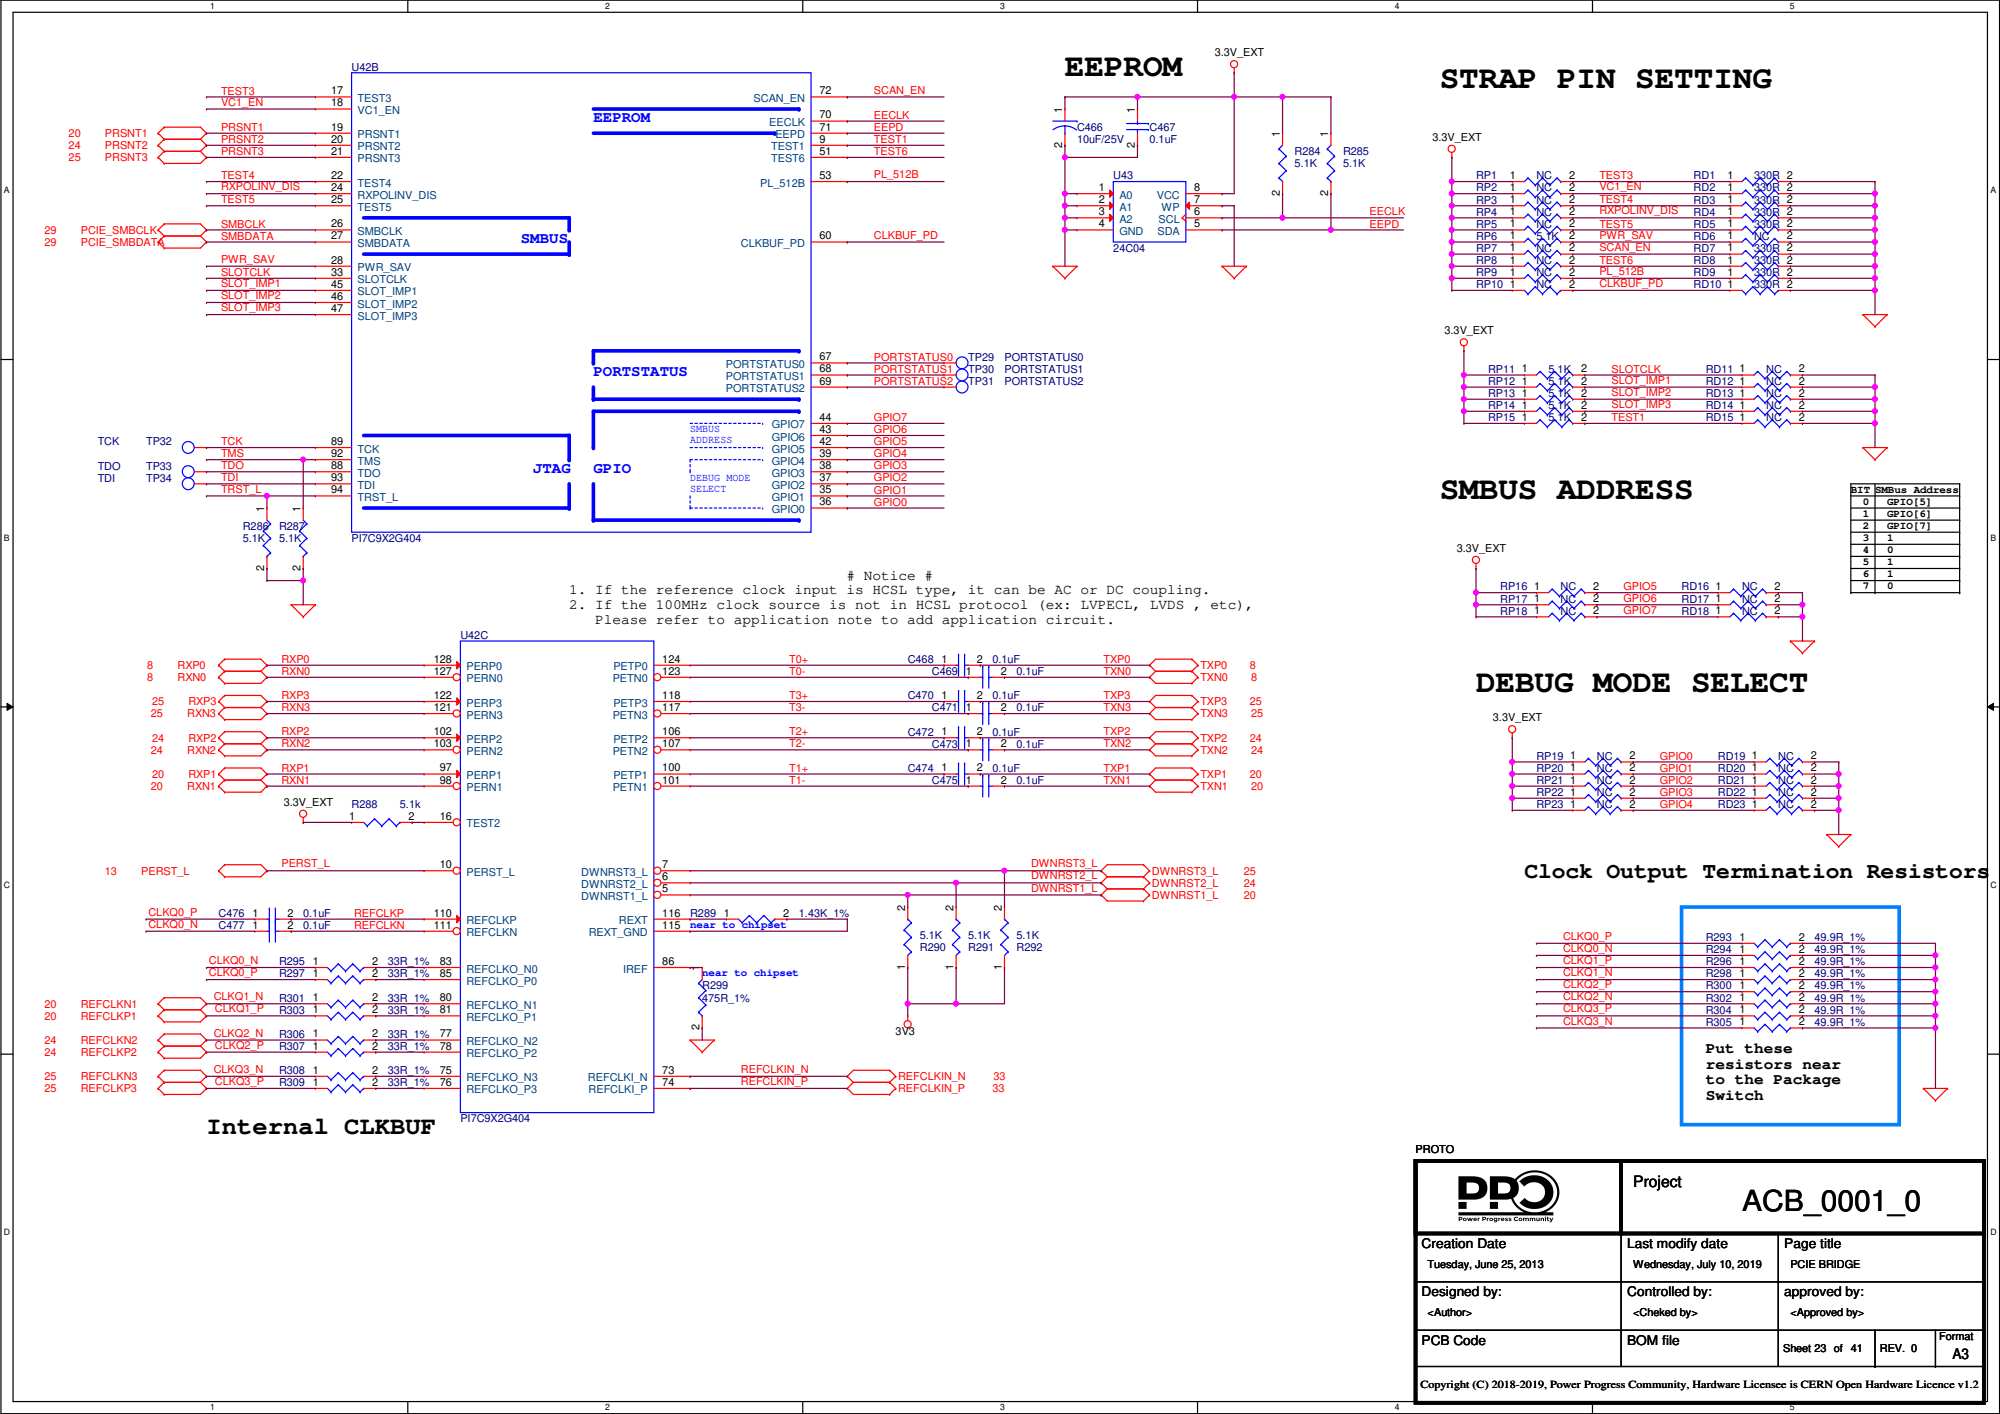
[picture p105: page 23]

BIT | SMBus Address
0 | GPIO[5]
1 | GPIO[6]
2 | GPIO[7]

1. If the reference clock input is HCSL type, it can be AC or DC coupling.
2. If the 100MHz clock source is not in HCSL protocol (ex: LVPECL, LVDS , etc),
Please refer to application note to add application circuit.

Clock Output Termination Resistors

1 | 2 | 3 | 4 | 5
A | A

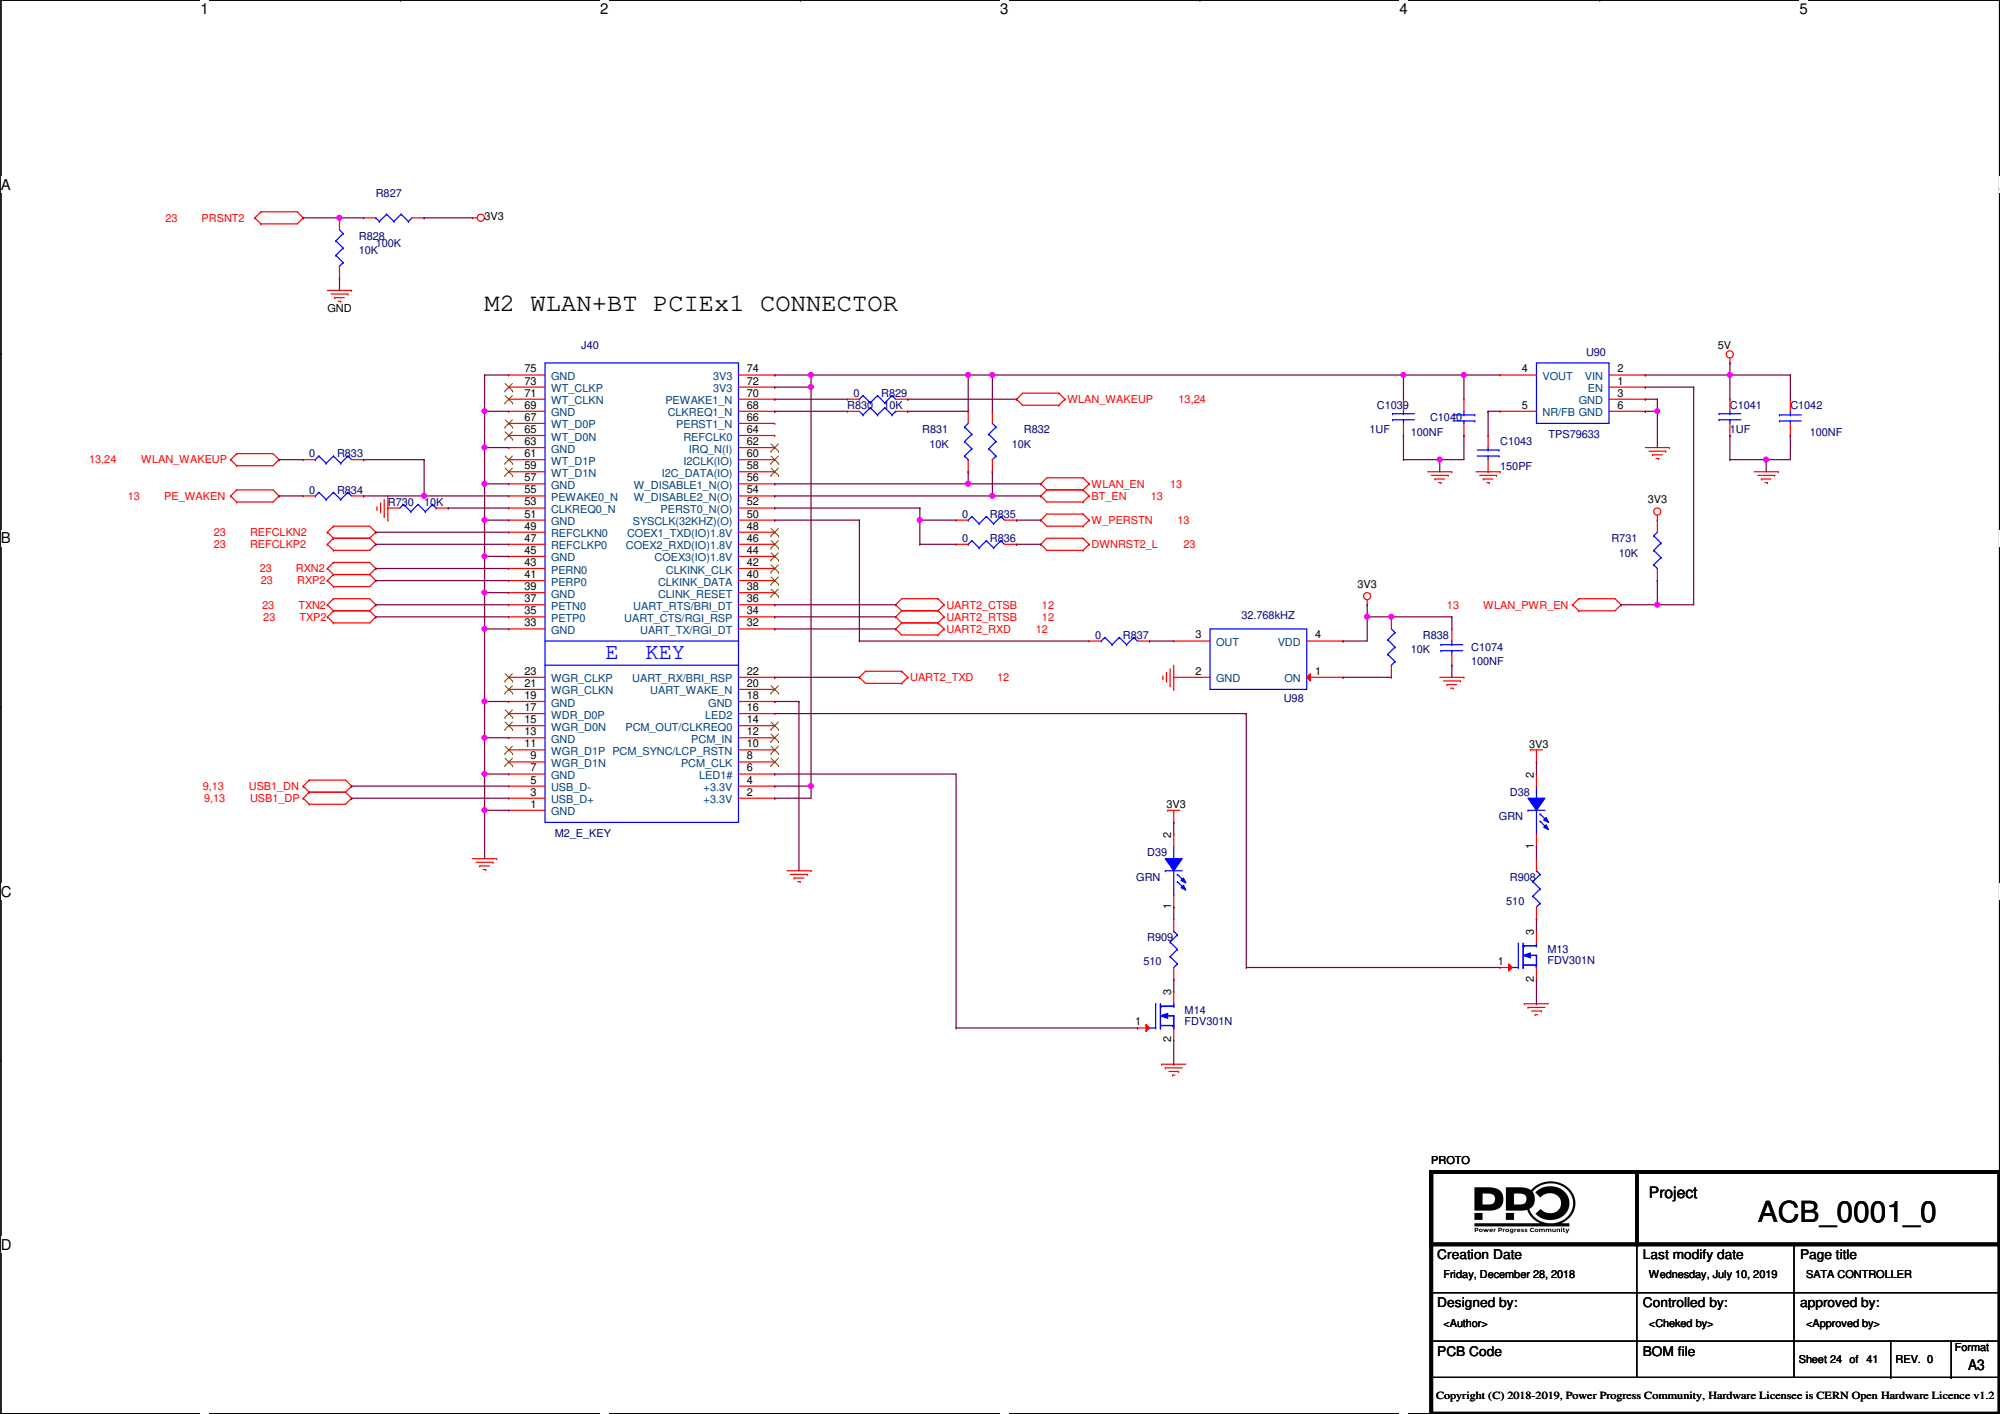
[picture p106: page 24]

1 | 2 | 3 | 4 | 5
A | A

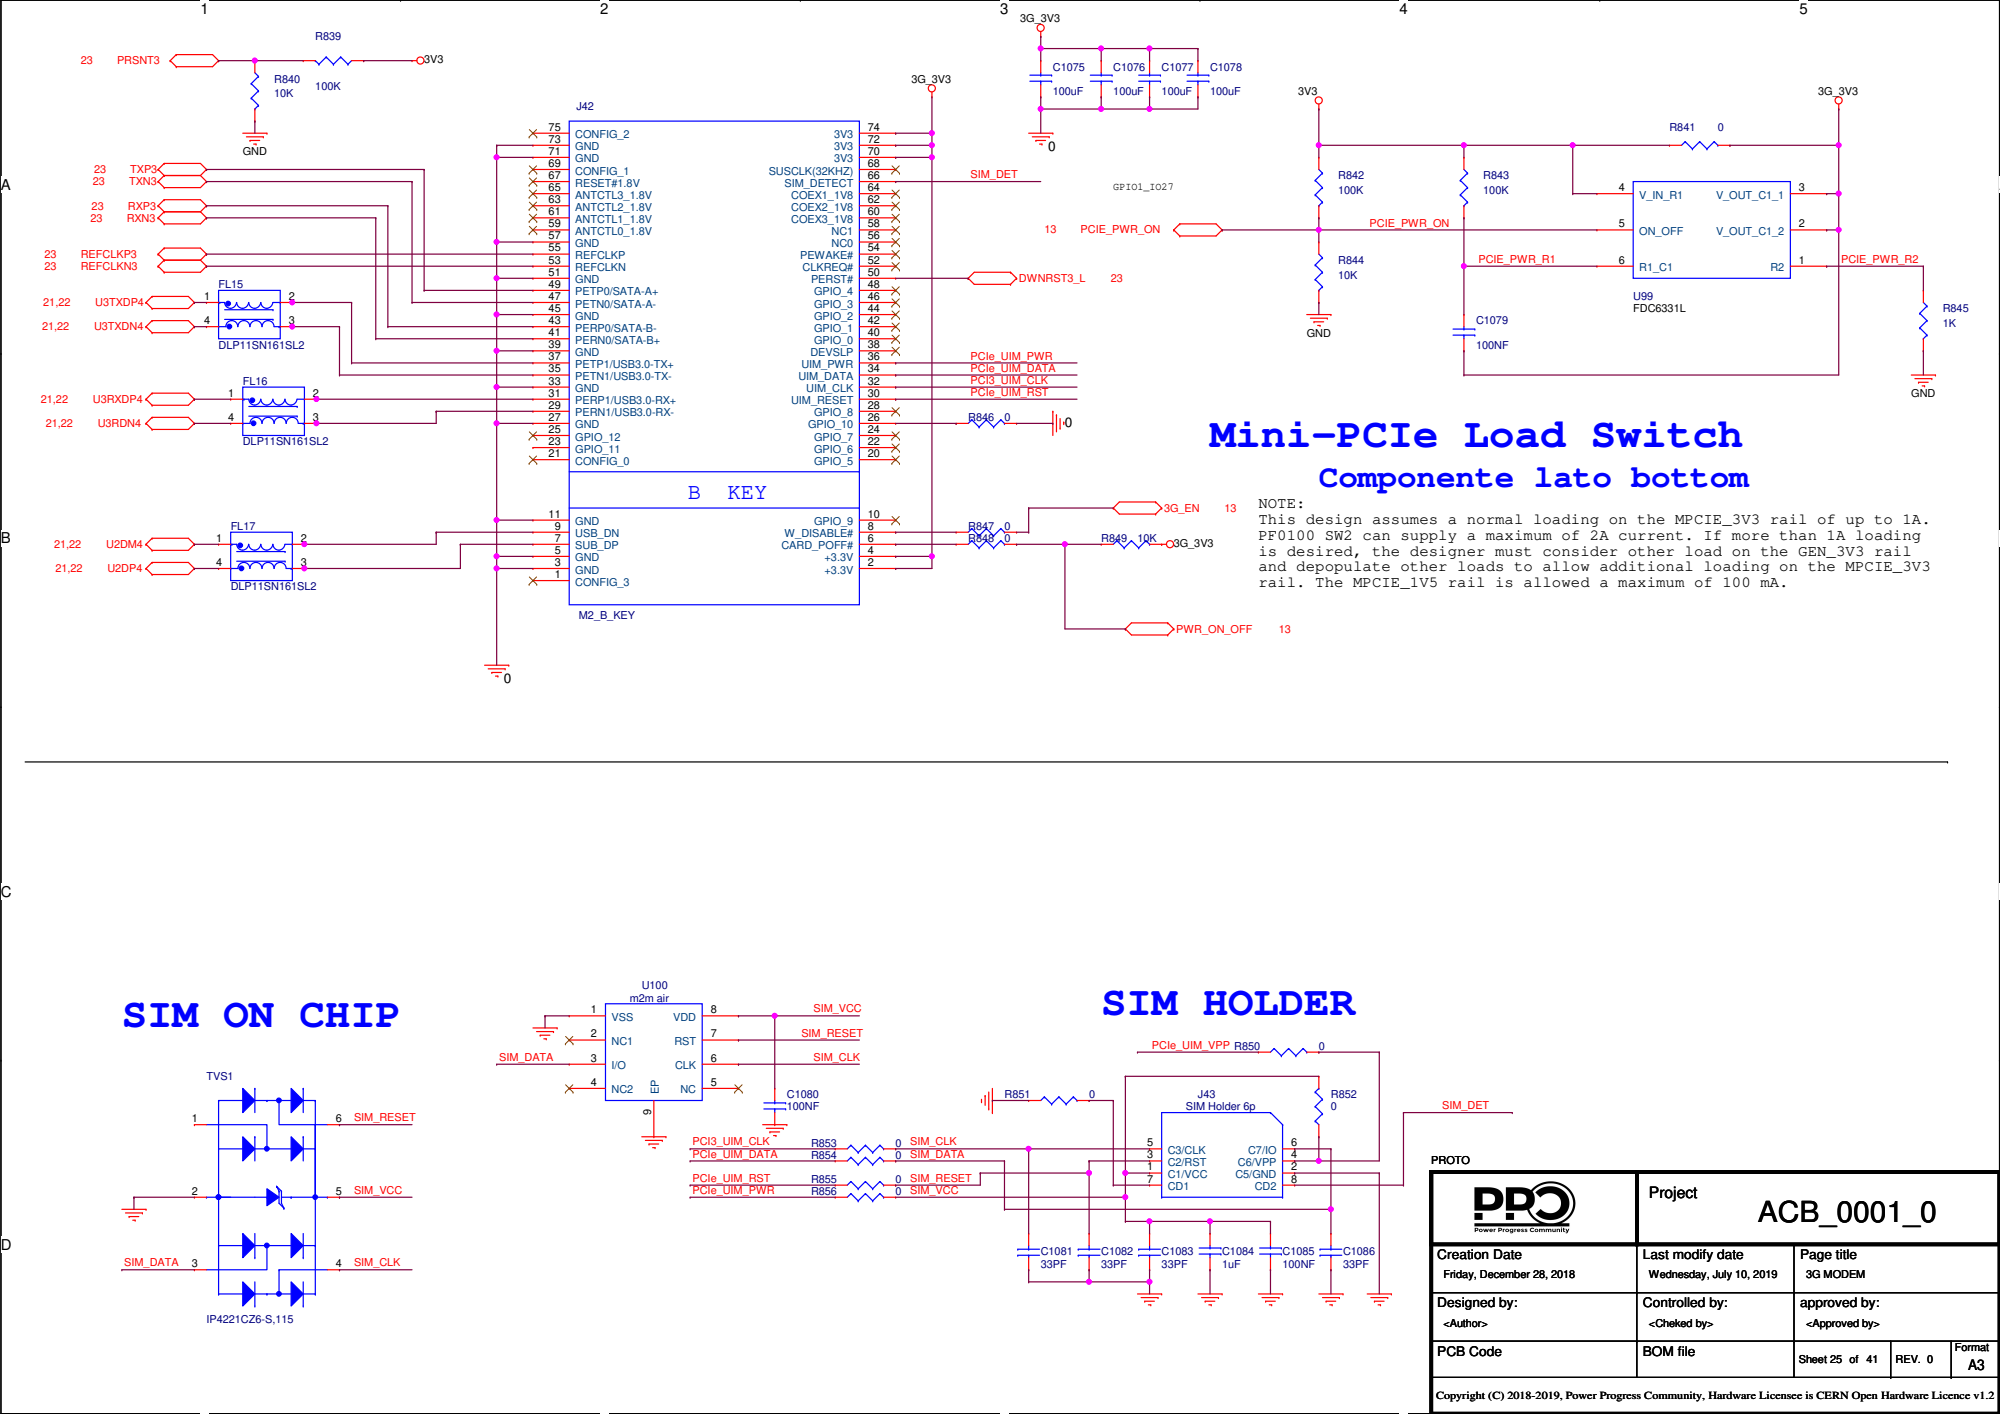
[picture p107: page 25]

Mini-PCIe Load Switch

NOTE:
This design assumes a normal loading on the MPCIE_3V3 rail of up to 1A.
PF0100 SW2 can supply a maximum of 2A current. If more than 1A loading
is desired, the designer must consider other load on the GEN_3V3 rail
and depopulate other loads to allow additional loading on the MPCIE_3V3
rail. The MPCIE_1V5 rail is allowed a maximum of 100 mA.

# 1.0V Decoupling Capacitors

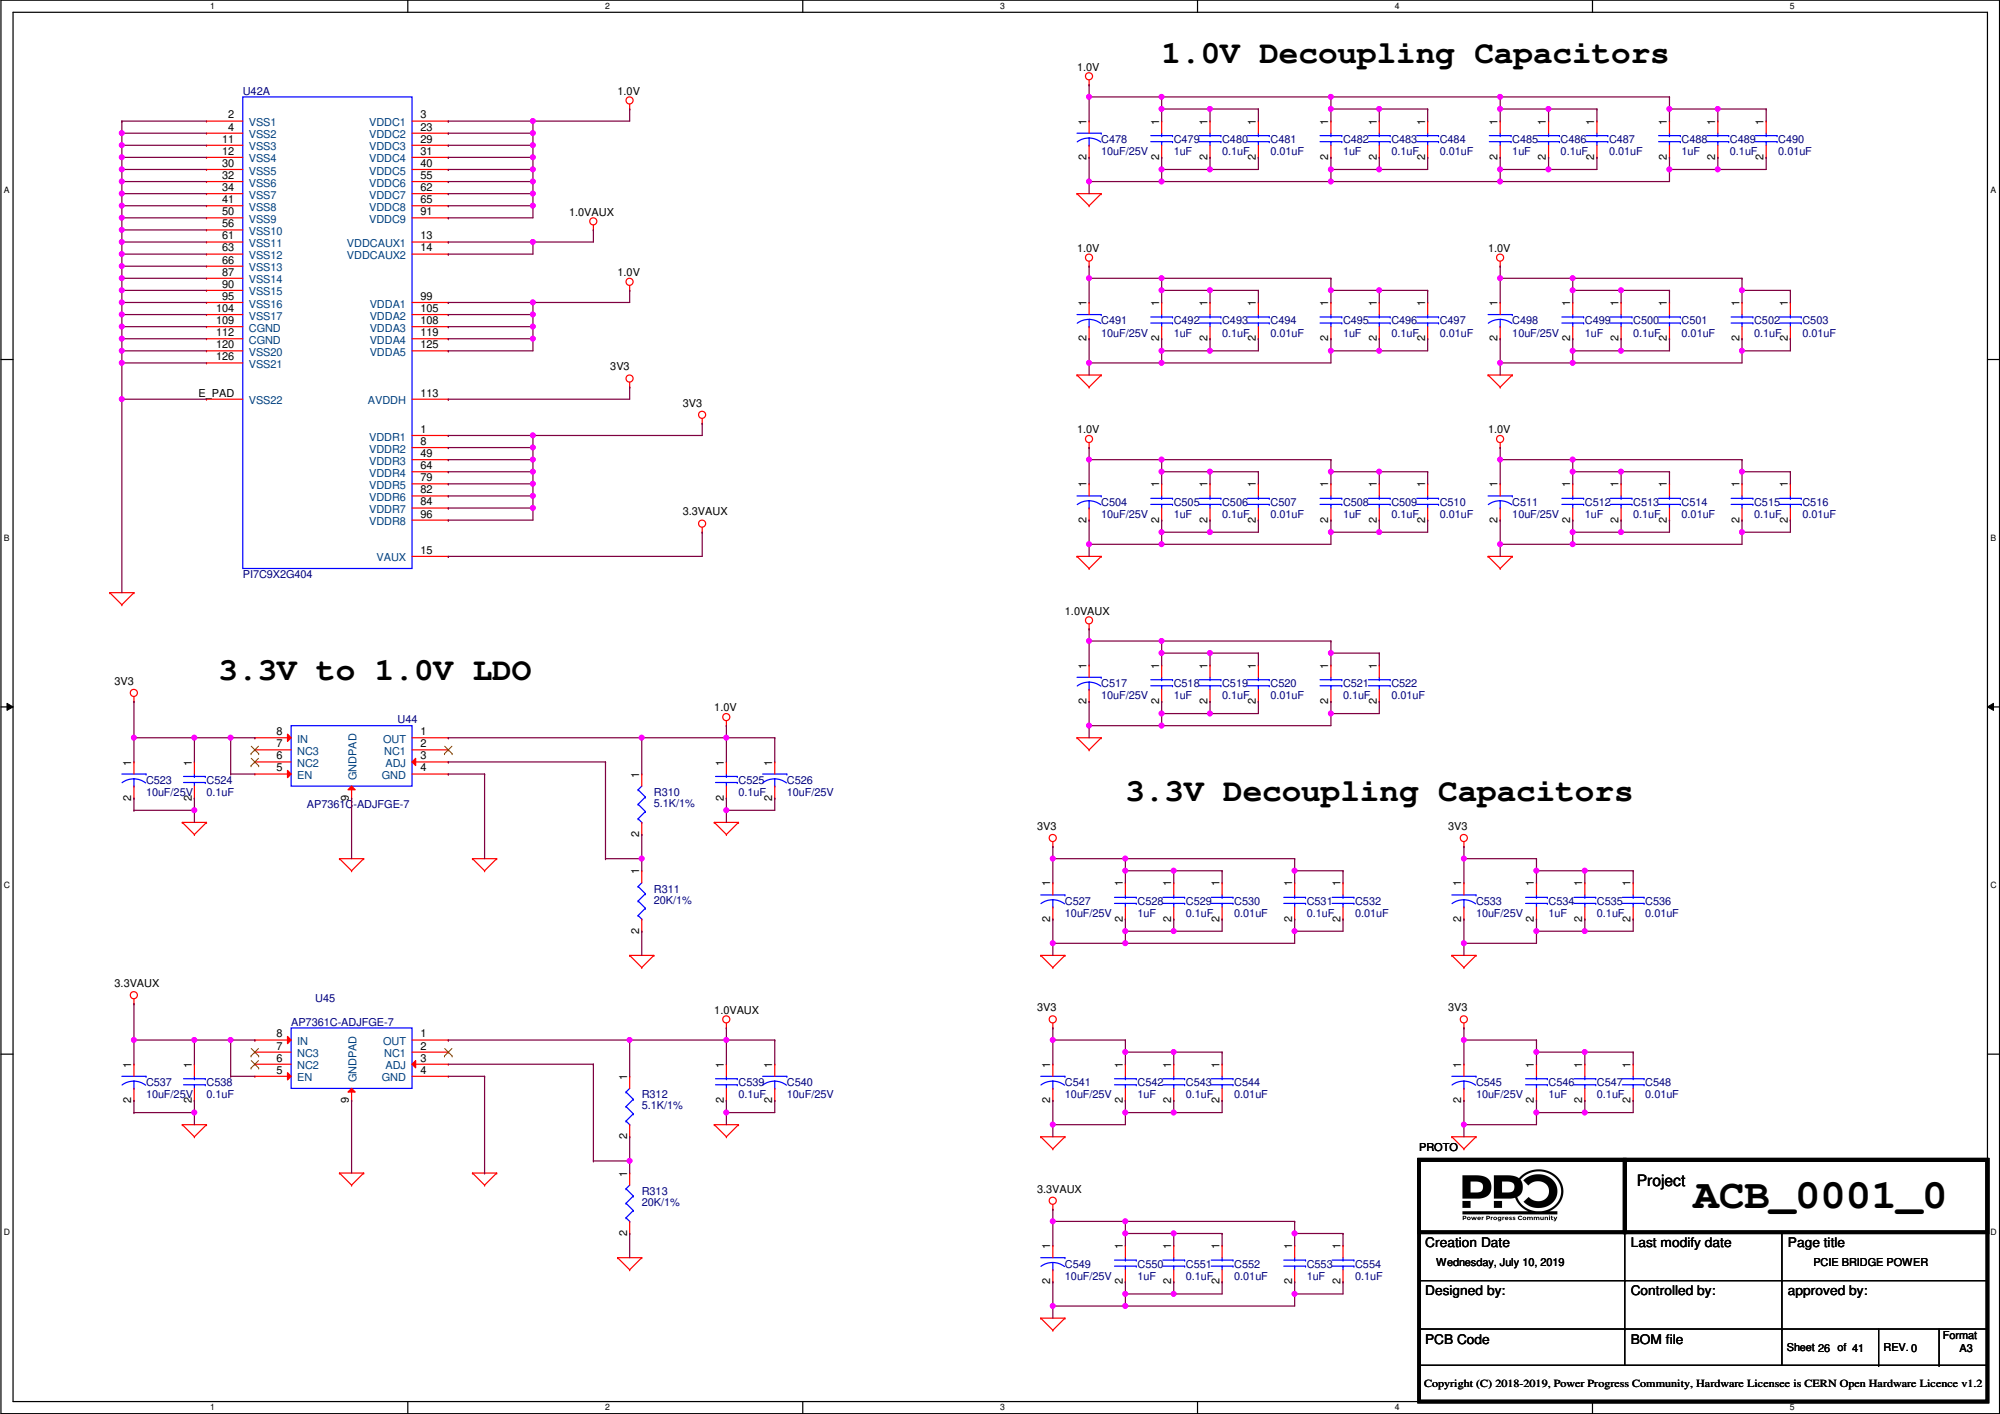
[picture p108: page 26]

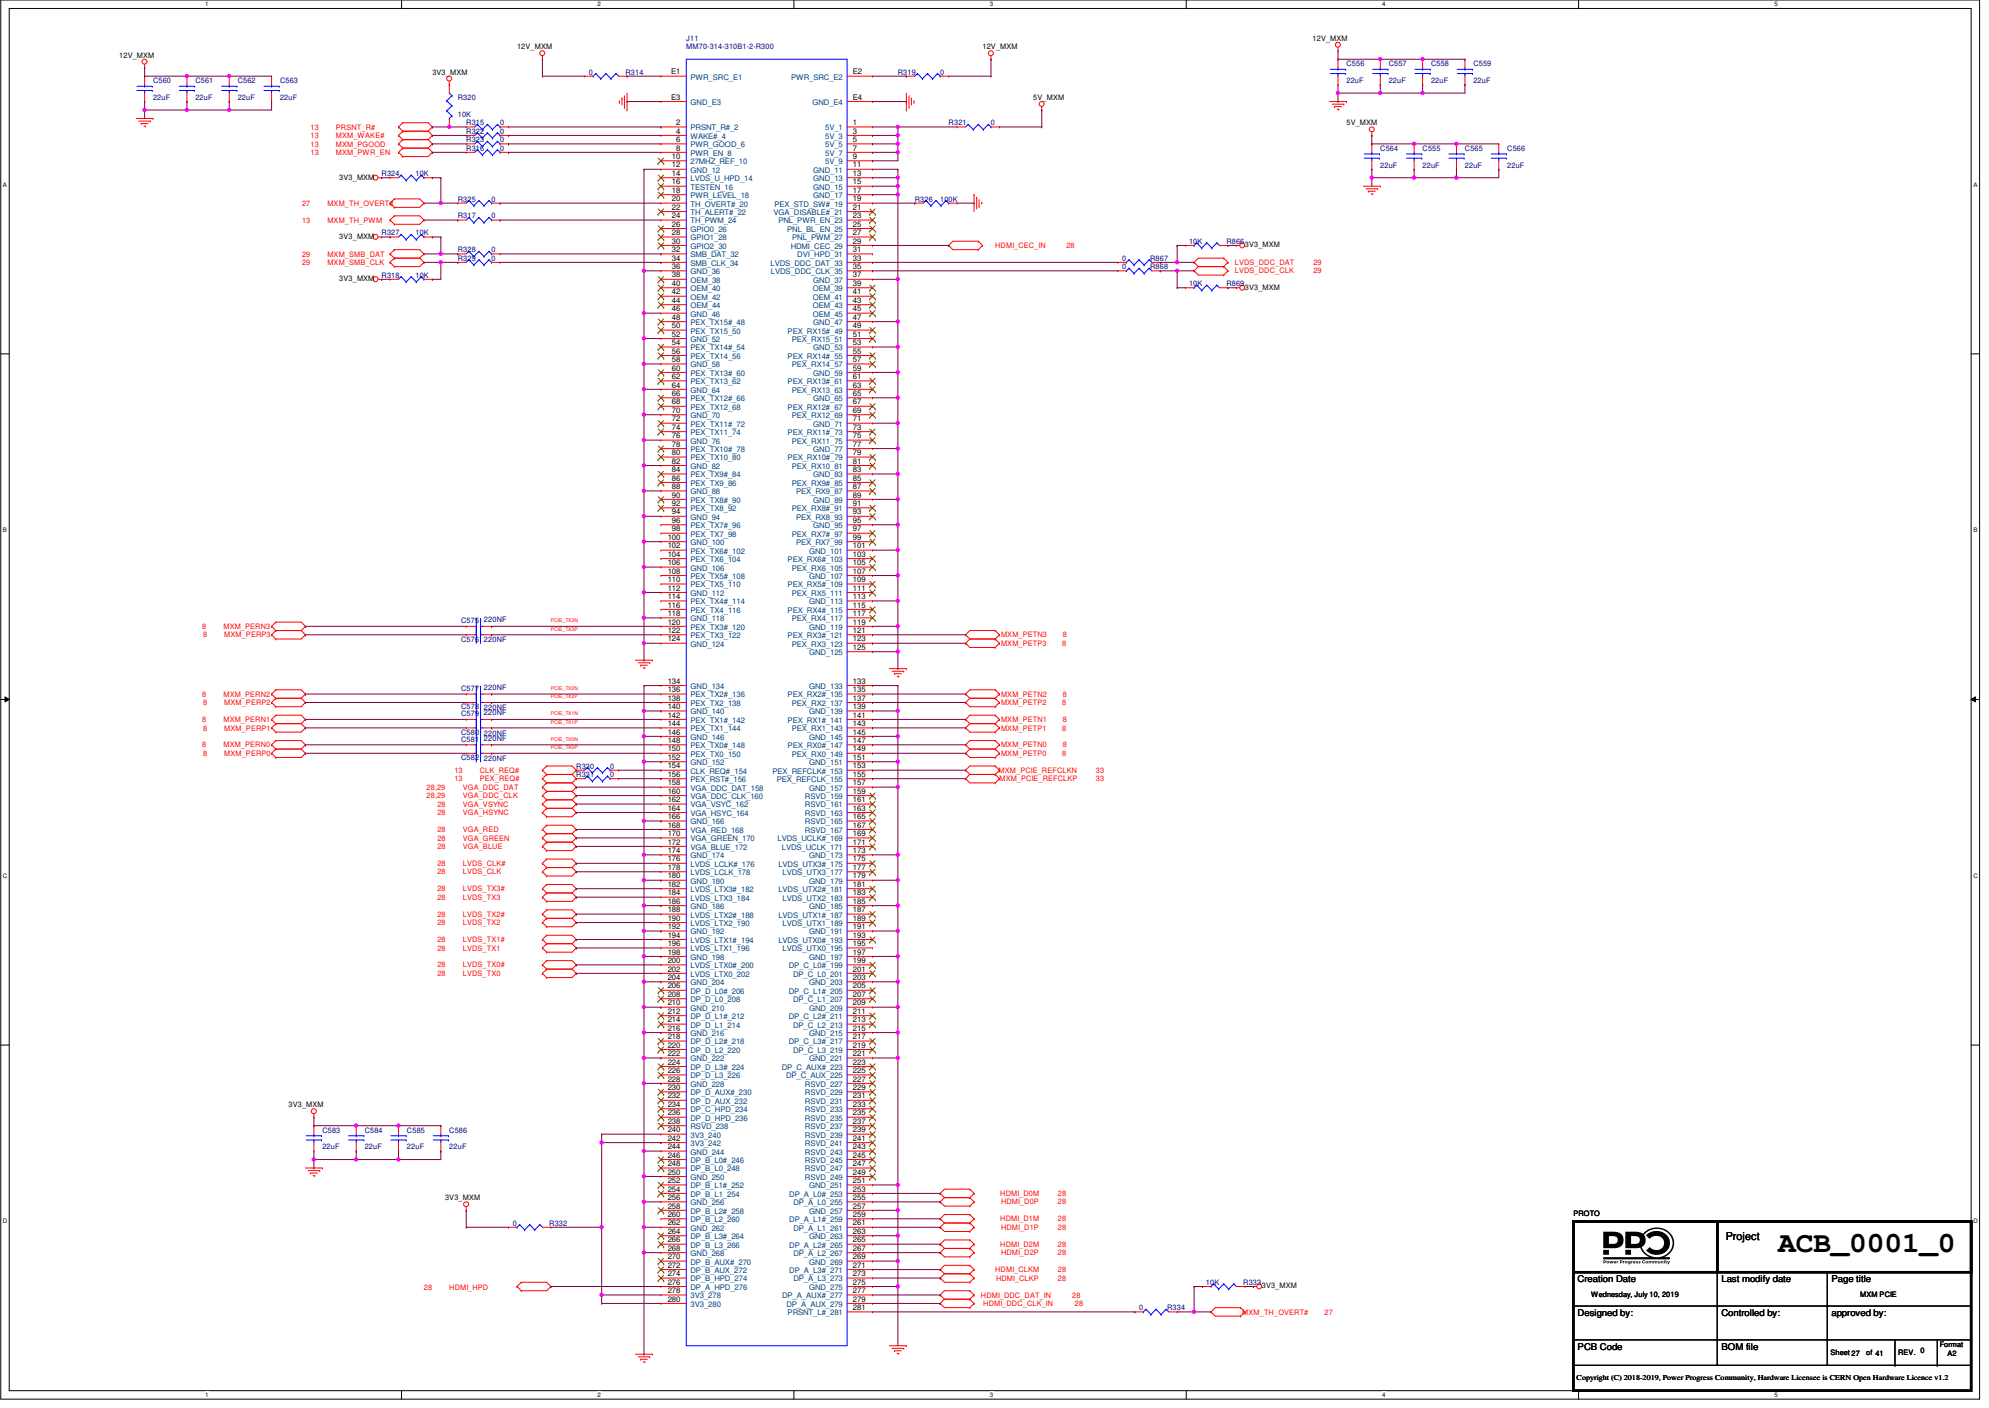
[picture p109: page 27]

# HDMI Port protections and Connector

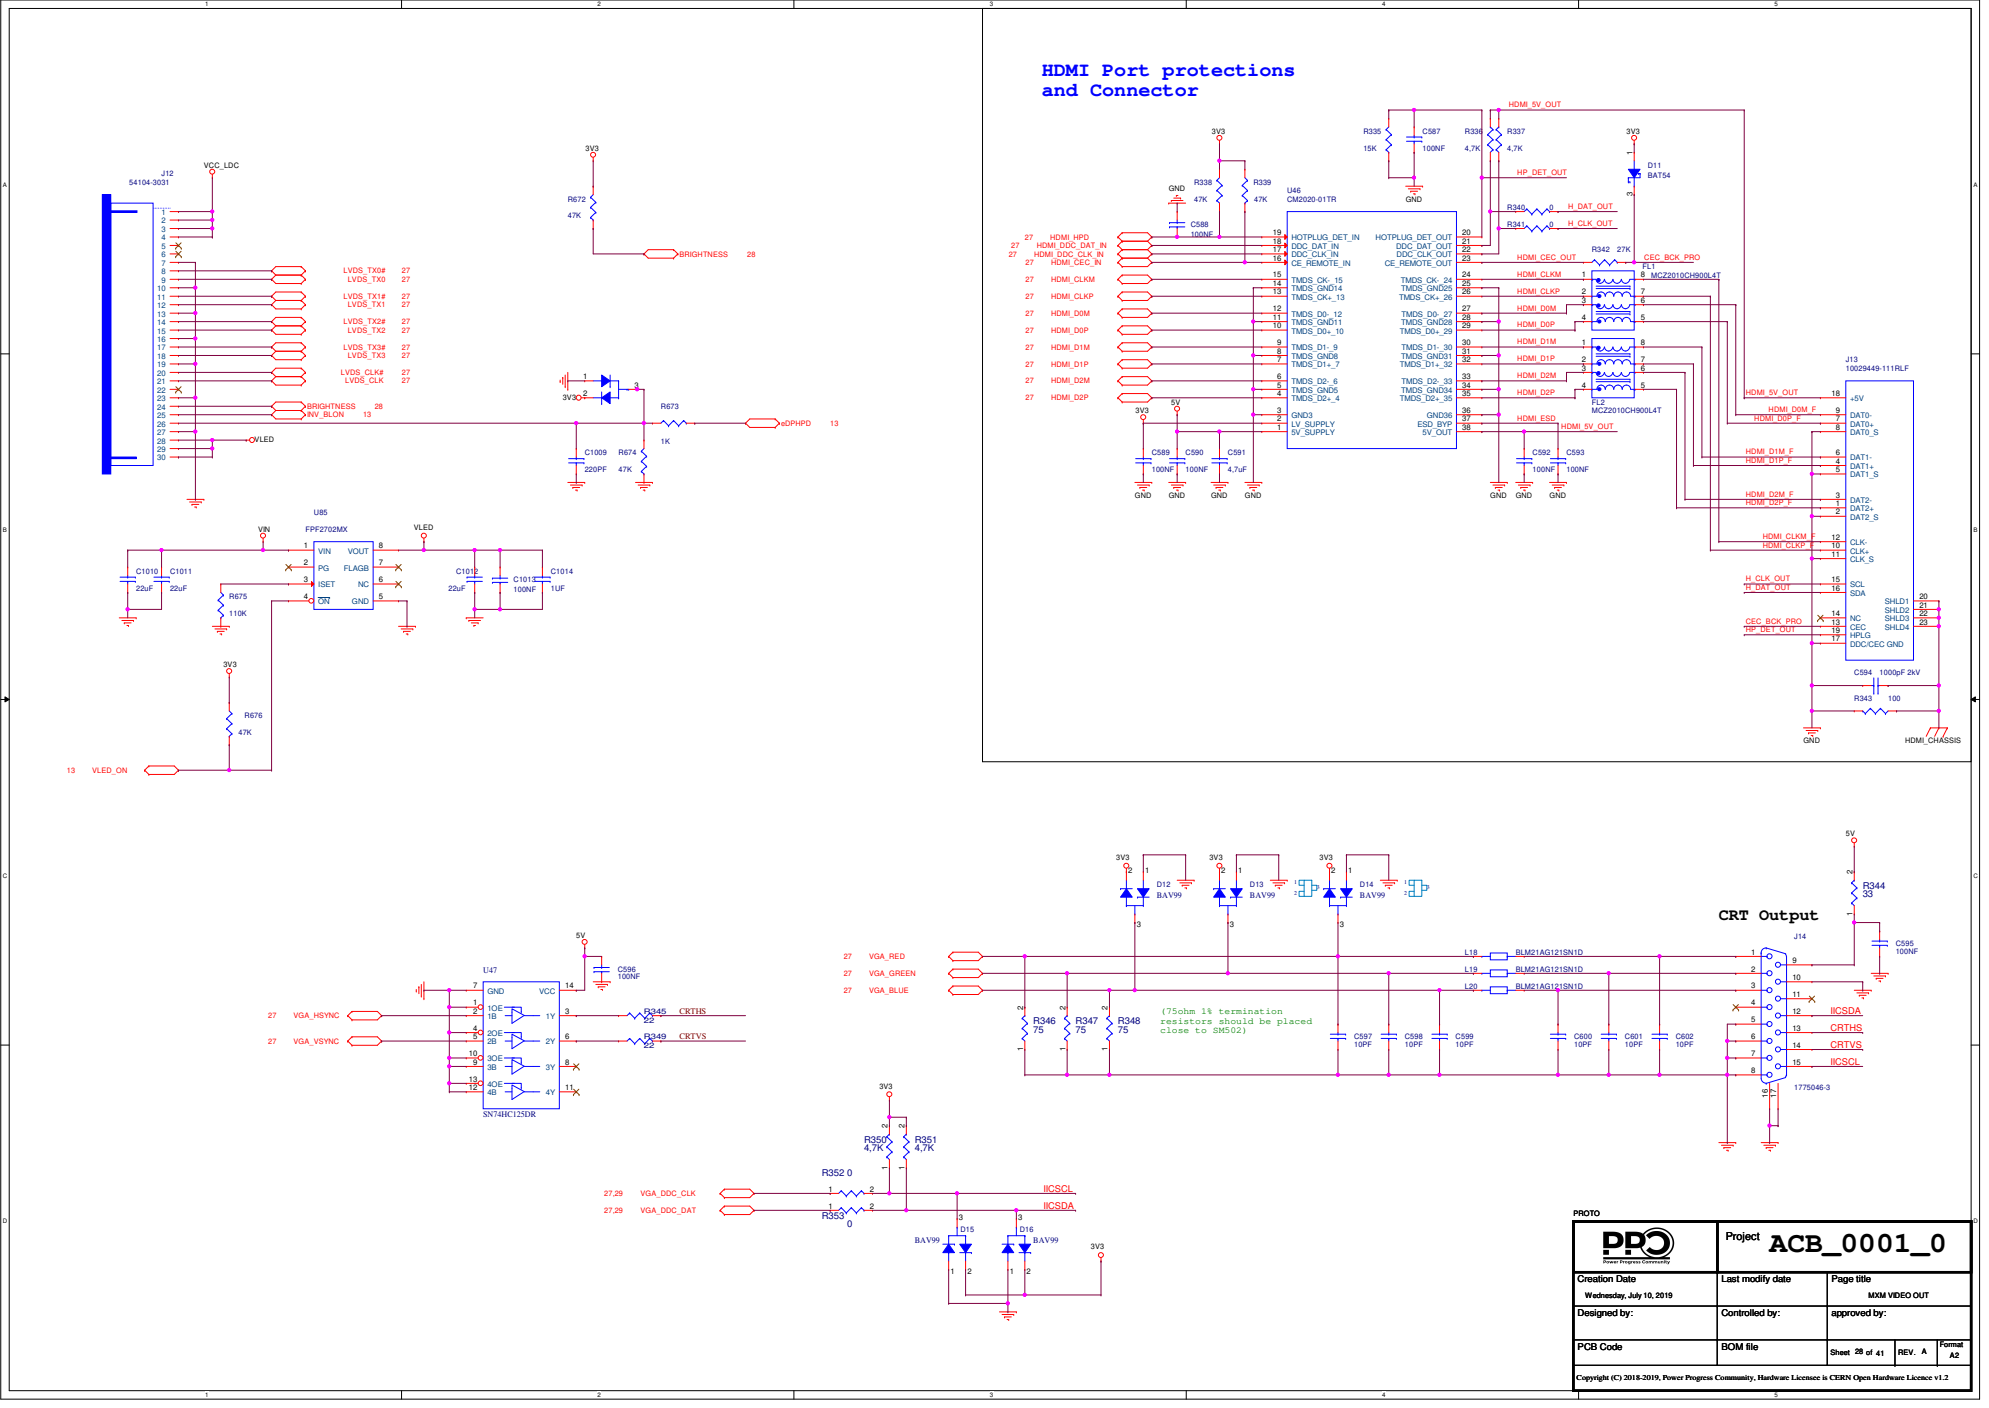
[picture p110: page 28]

(75ohm 1% termination
resistors should be placed
close to SM502)

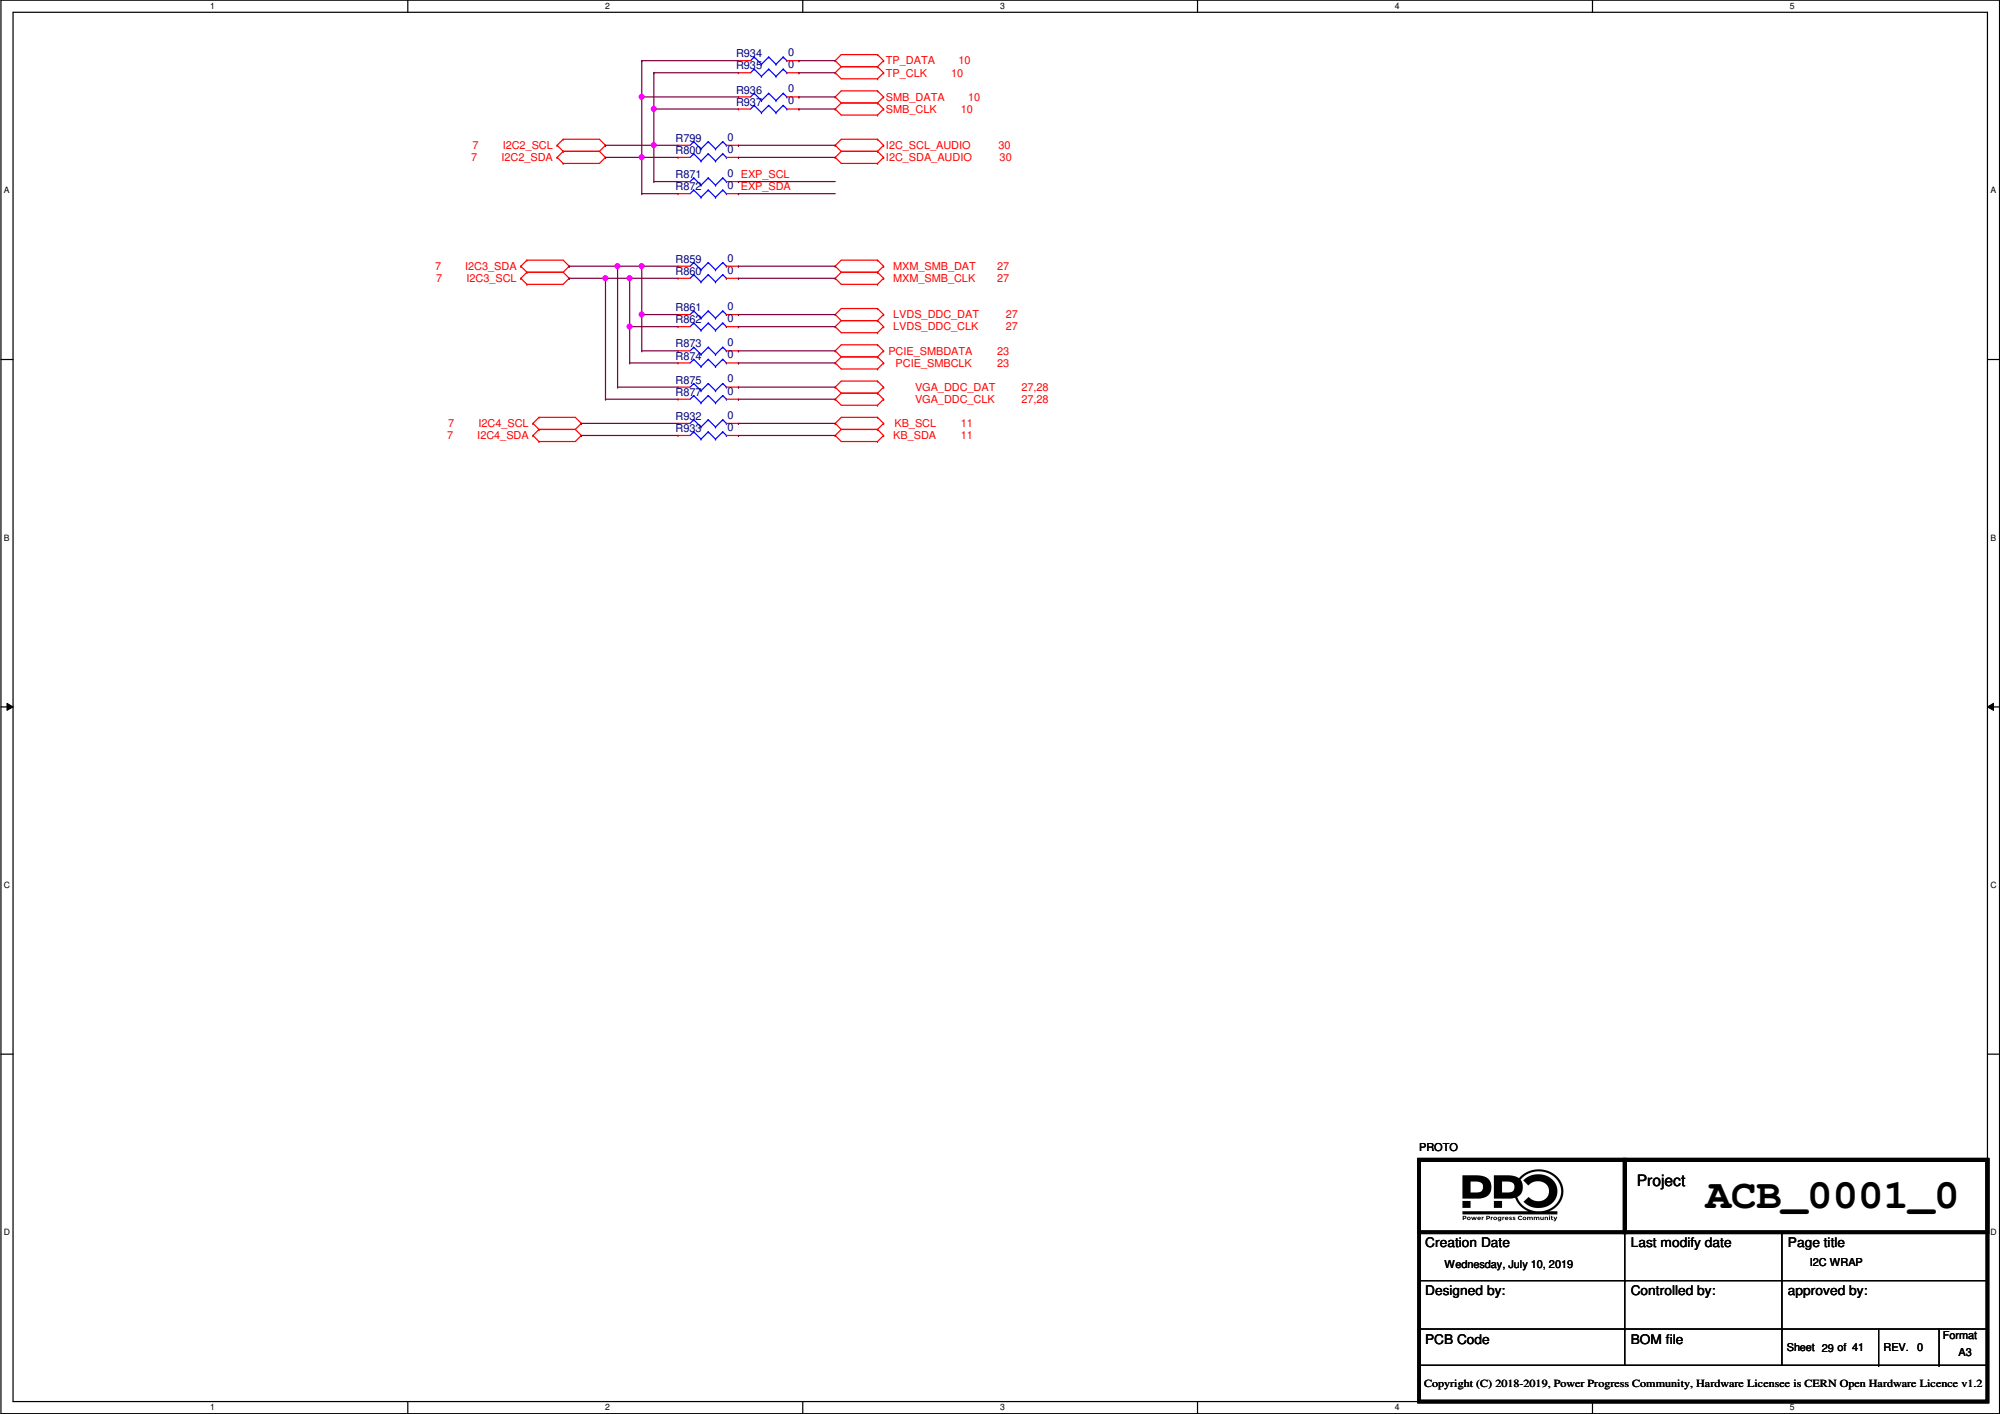
[picture p111: page 29]

Power Switches | Codec

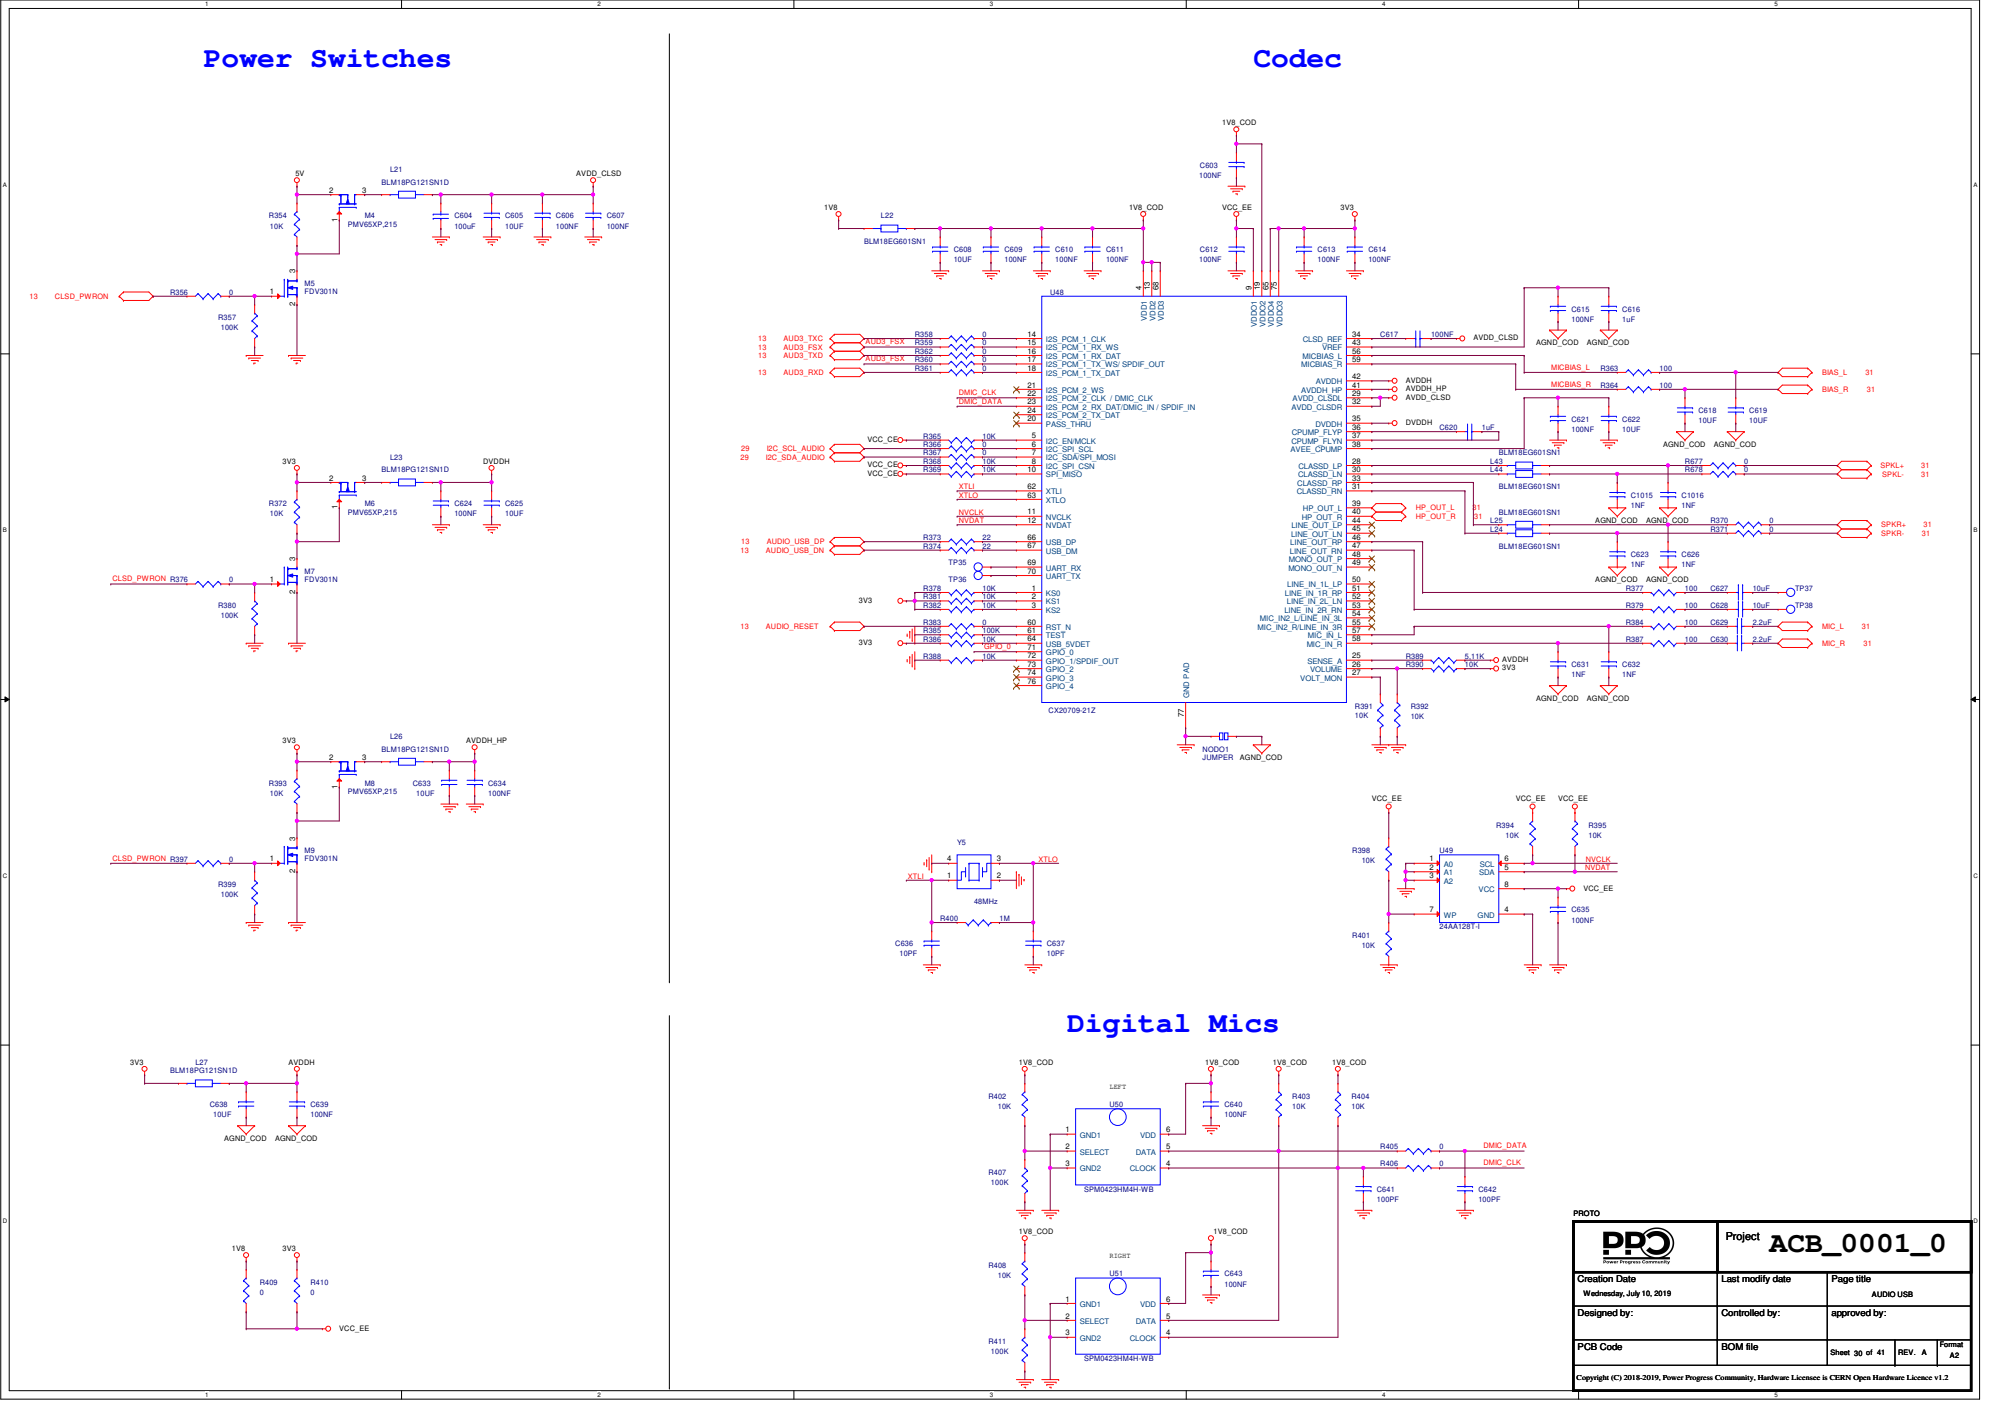
[picture p112: page 30]

# Analog MICs

30 | MIC_L 30 | MIC_R

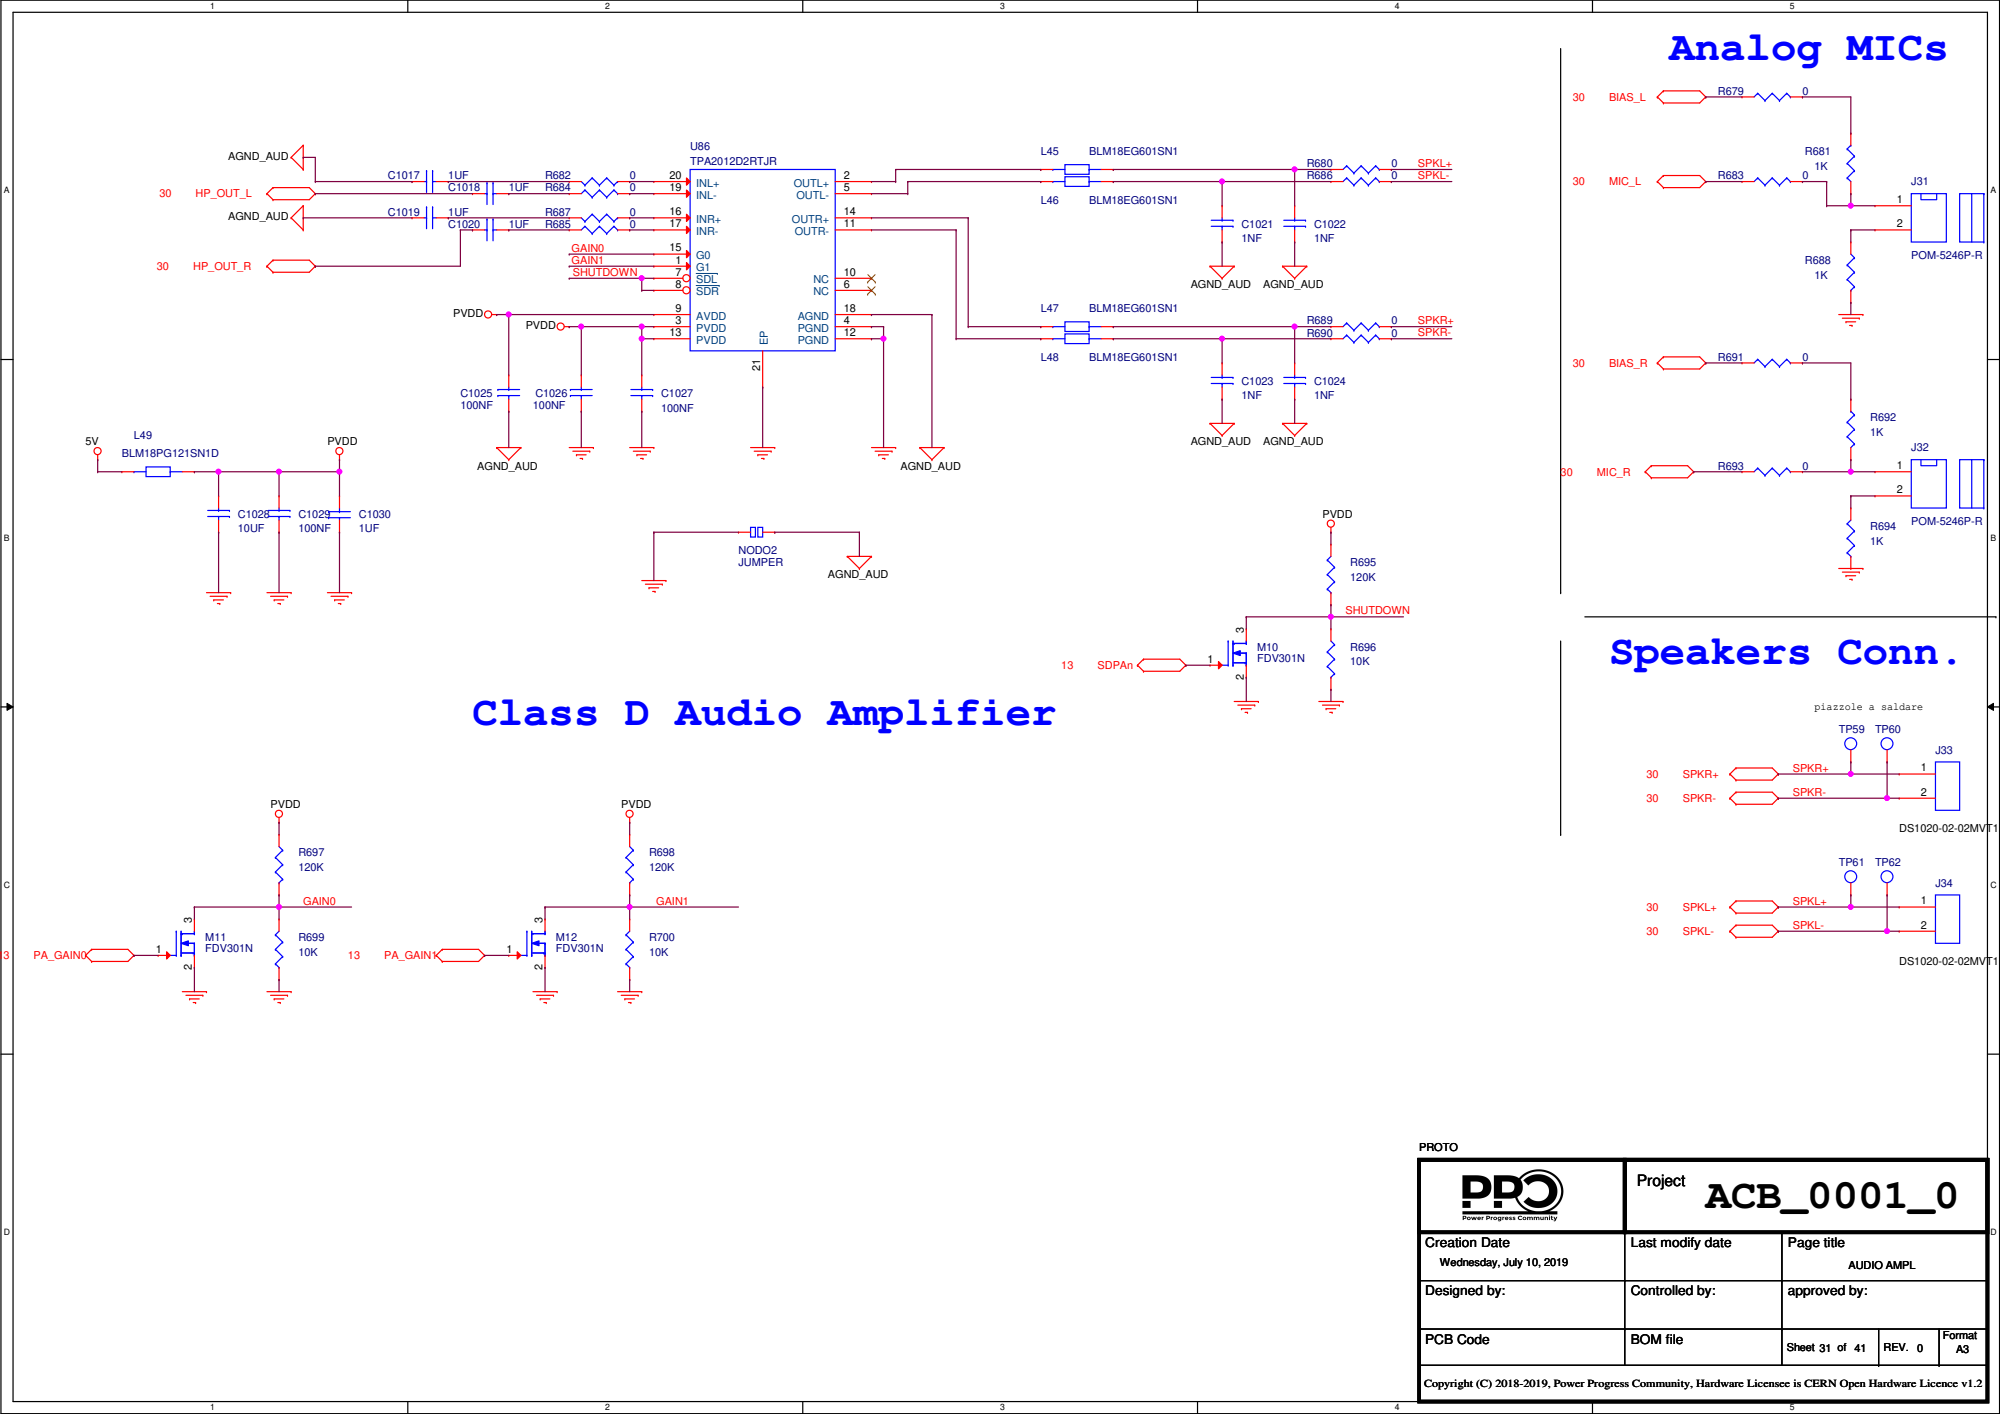
[picture p113: page 31]

# SYSTEM CLOCK GENERATORs

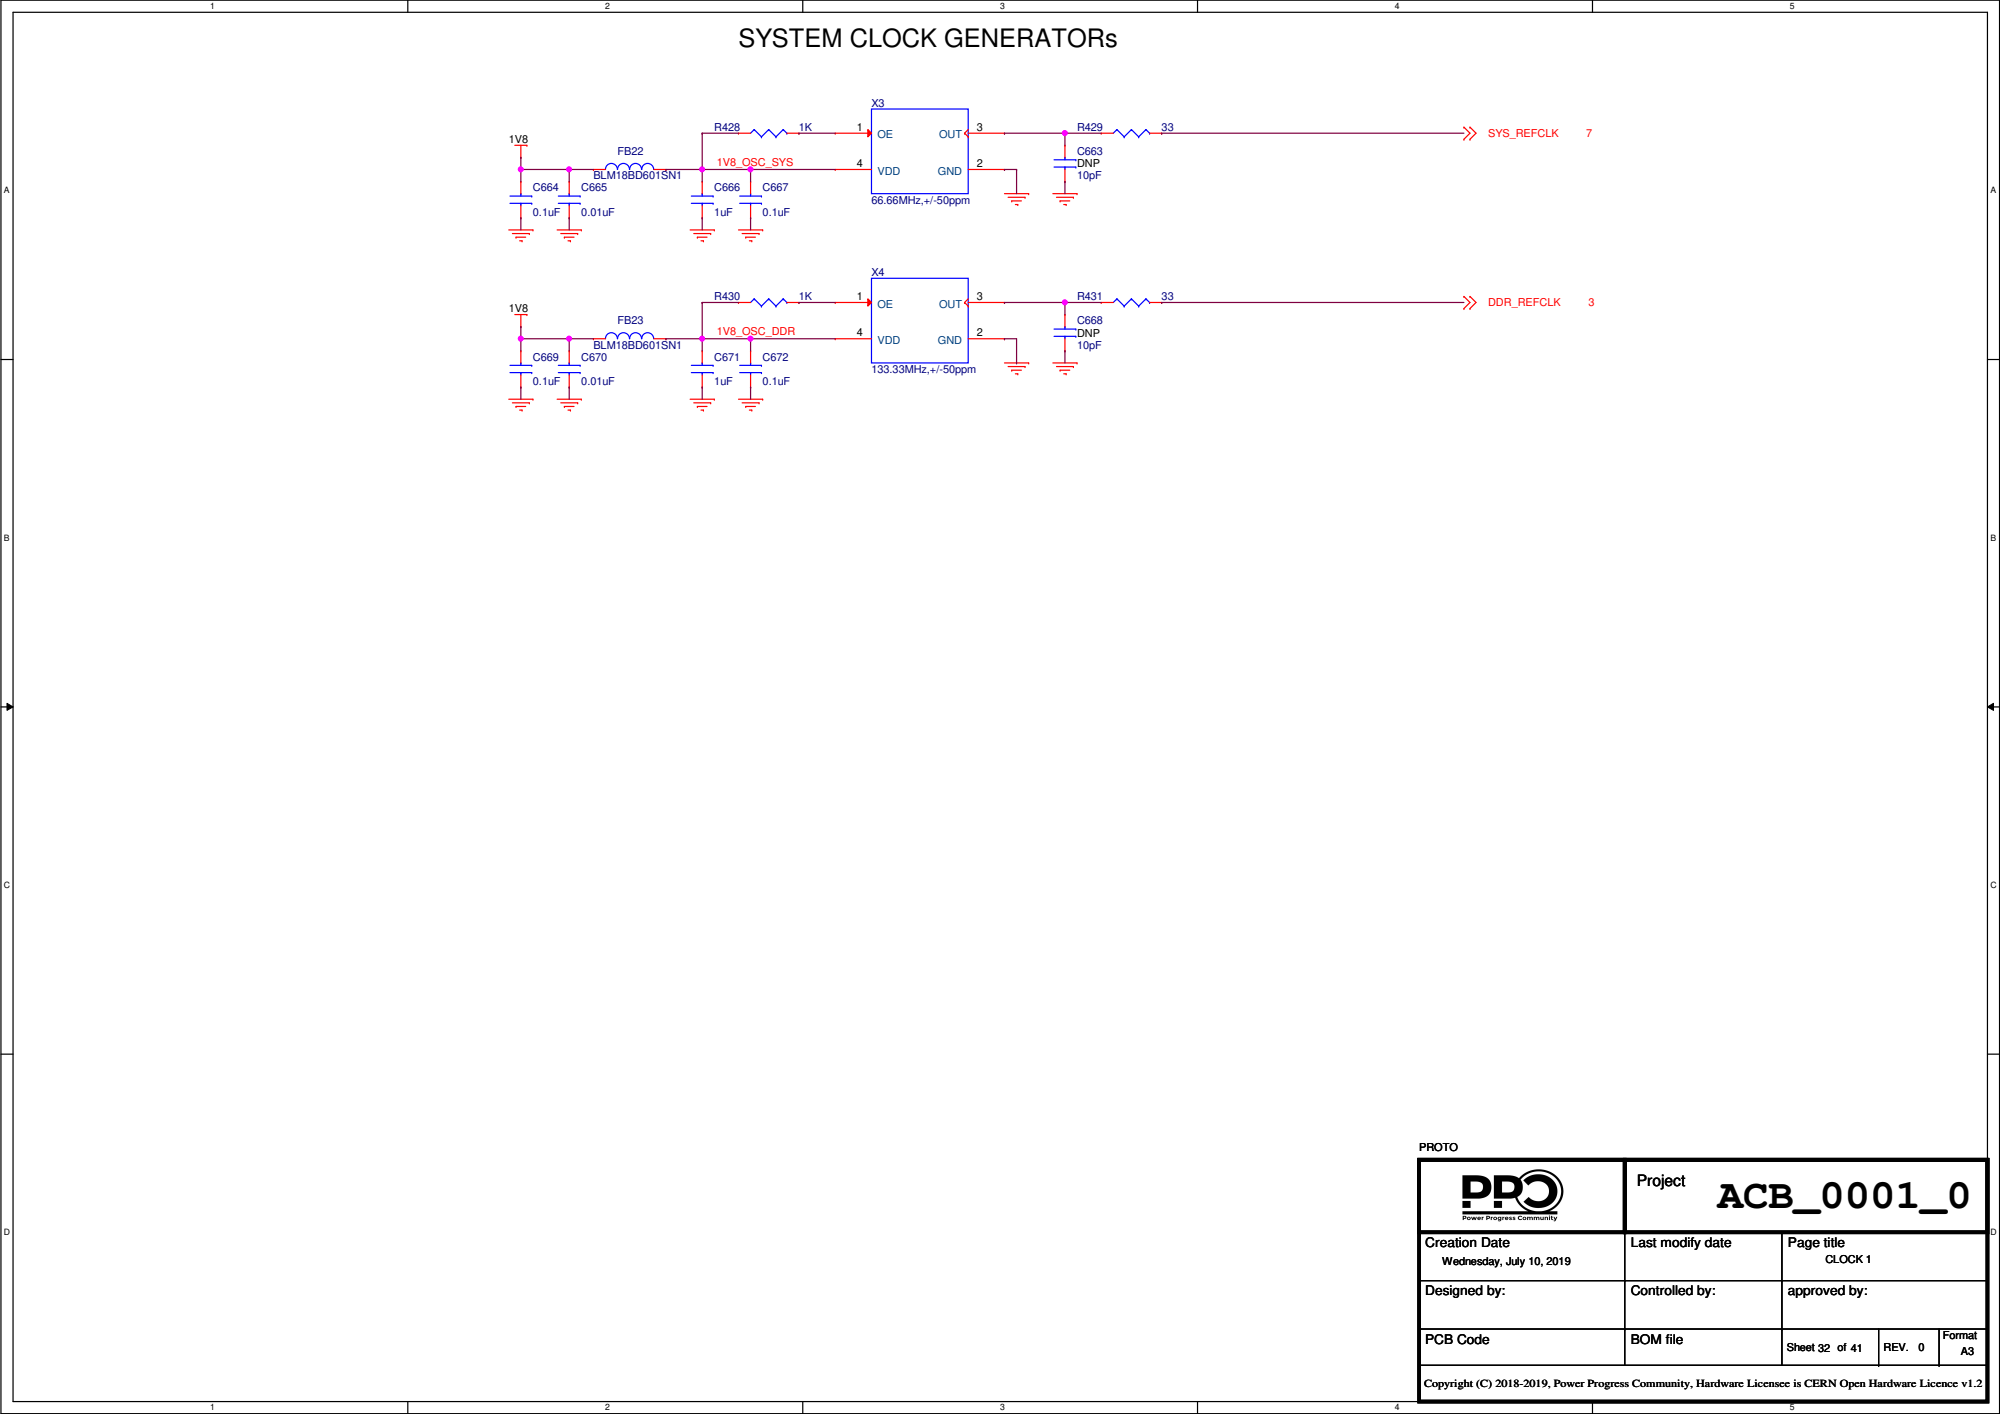
[picture p114: page 32]

# SYSTEM CLOCK GENERATORs (cont.)

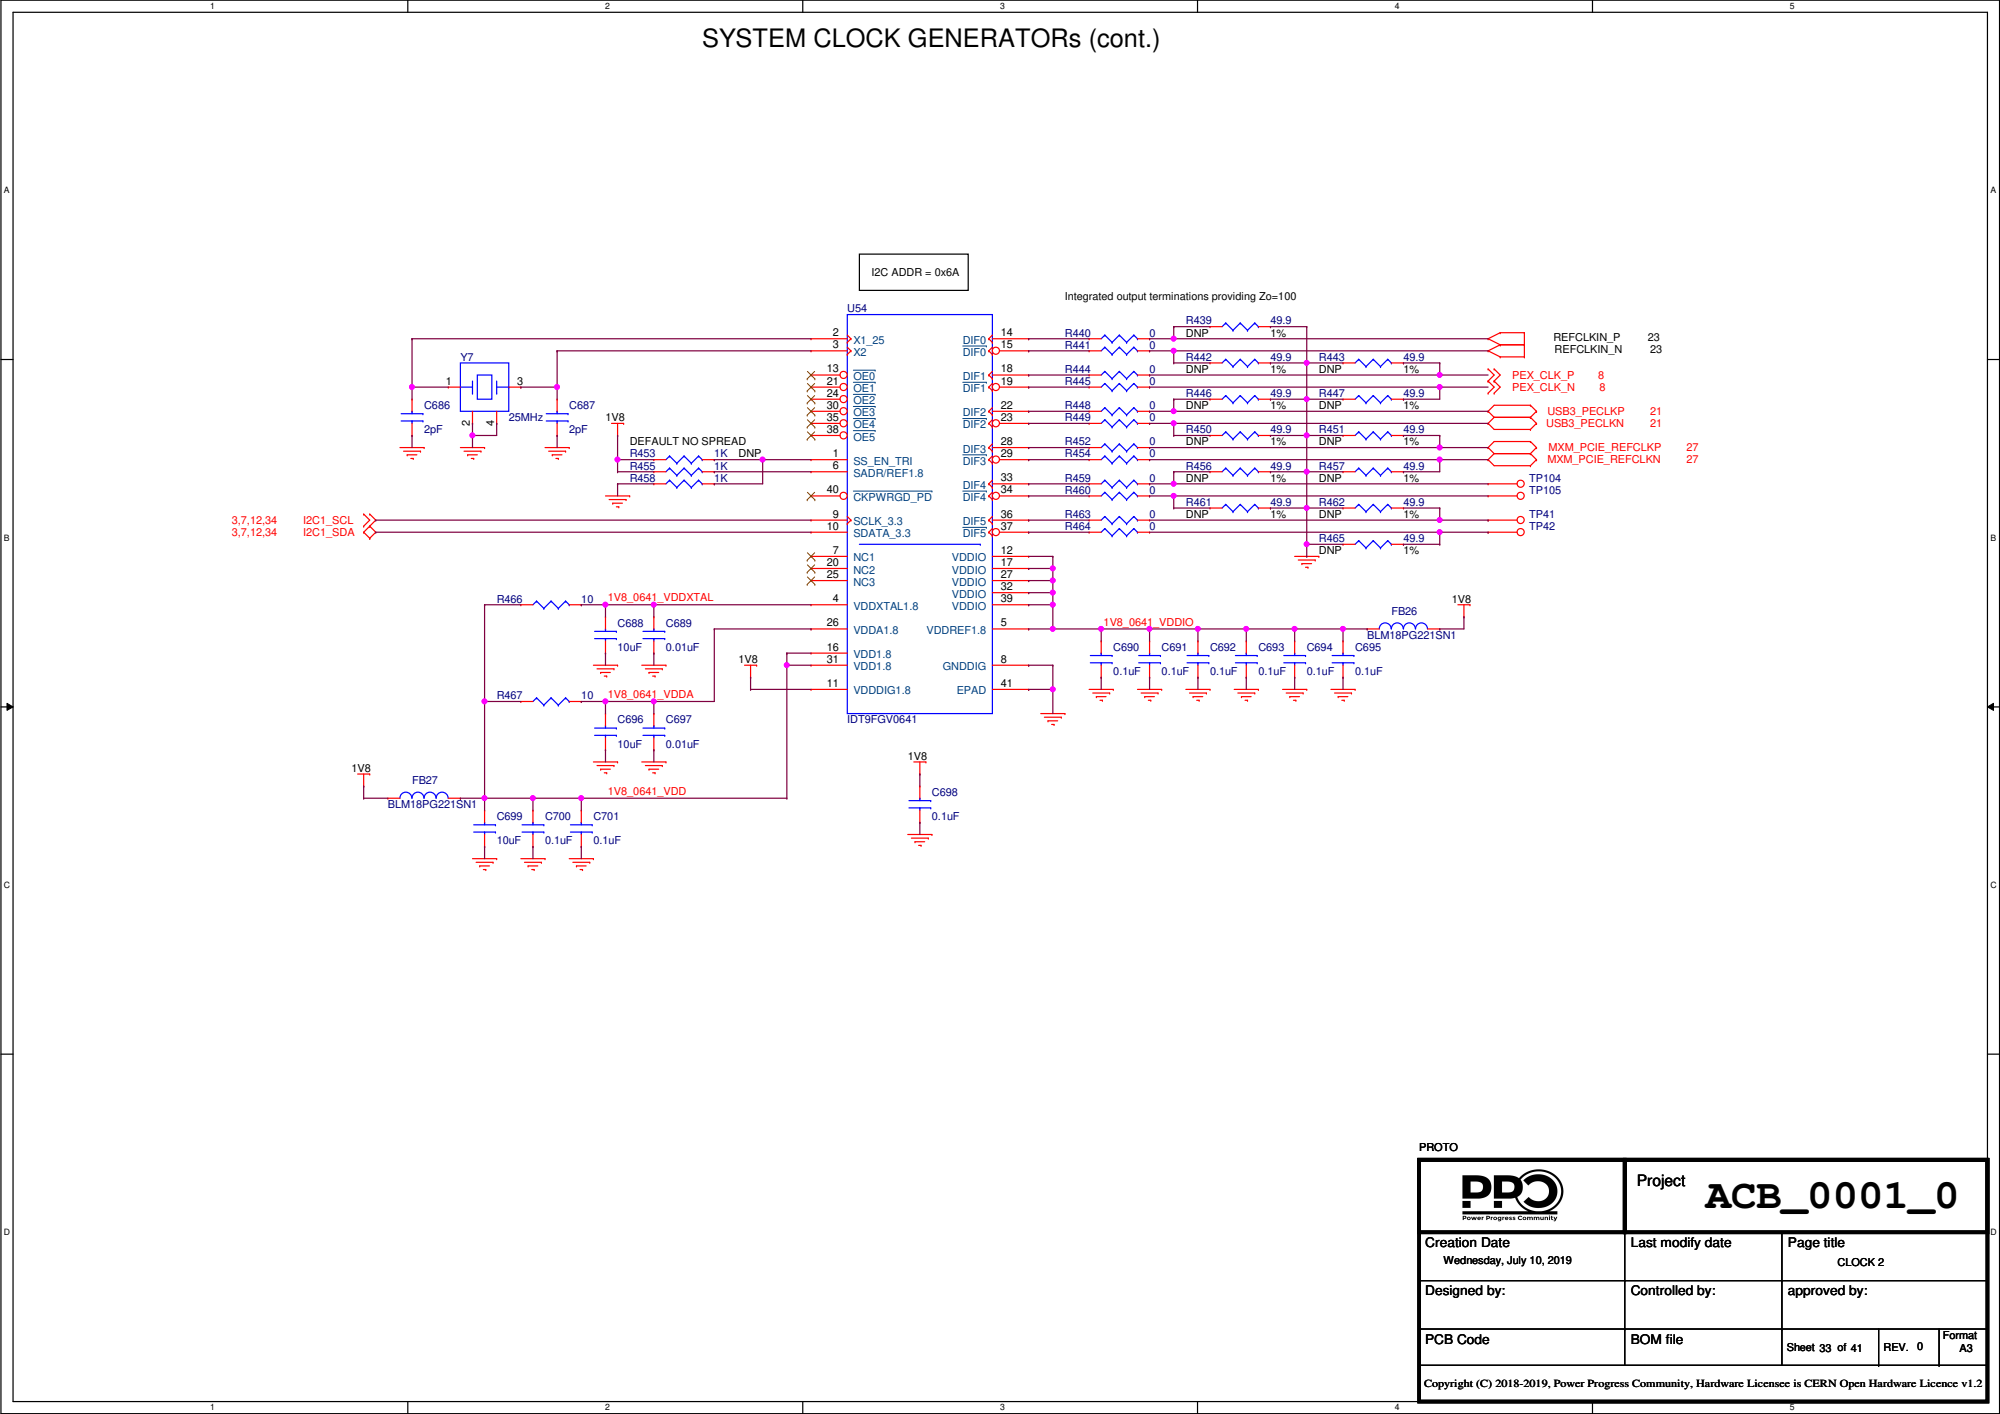
[picture p115: page 33]

Integrated output terminations providing Zo=100

# T2080 CORE POWER CONVERTOR

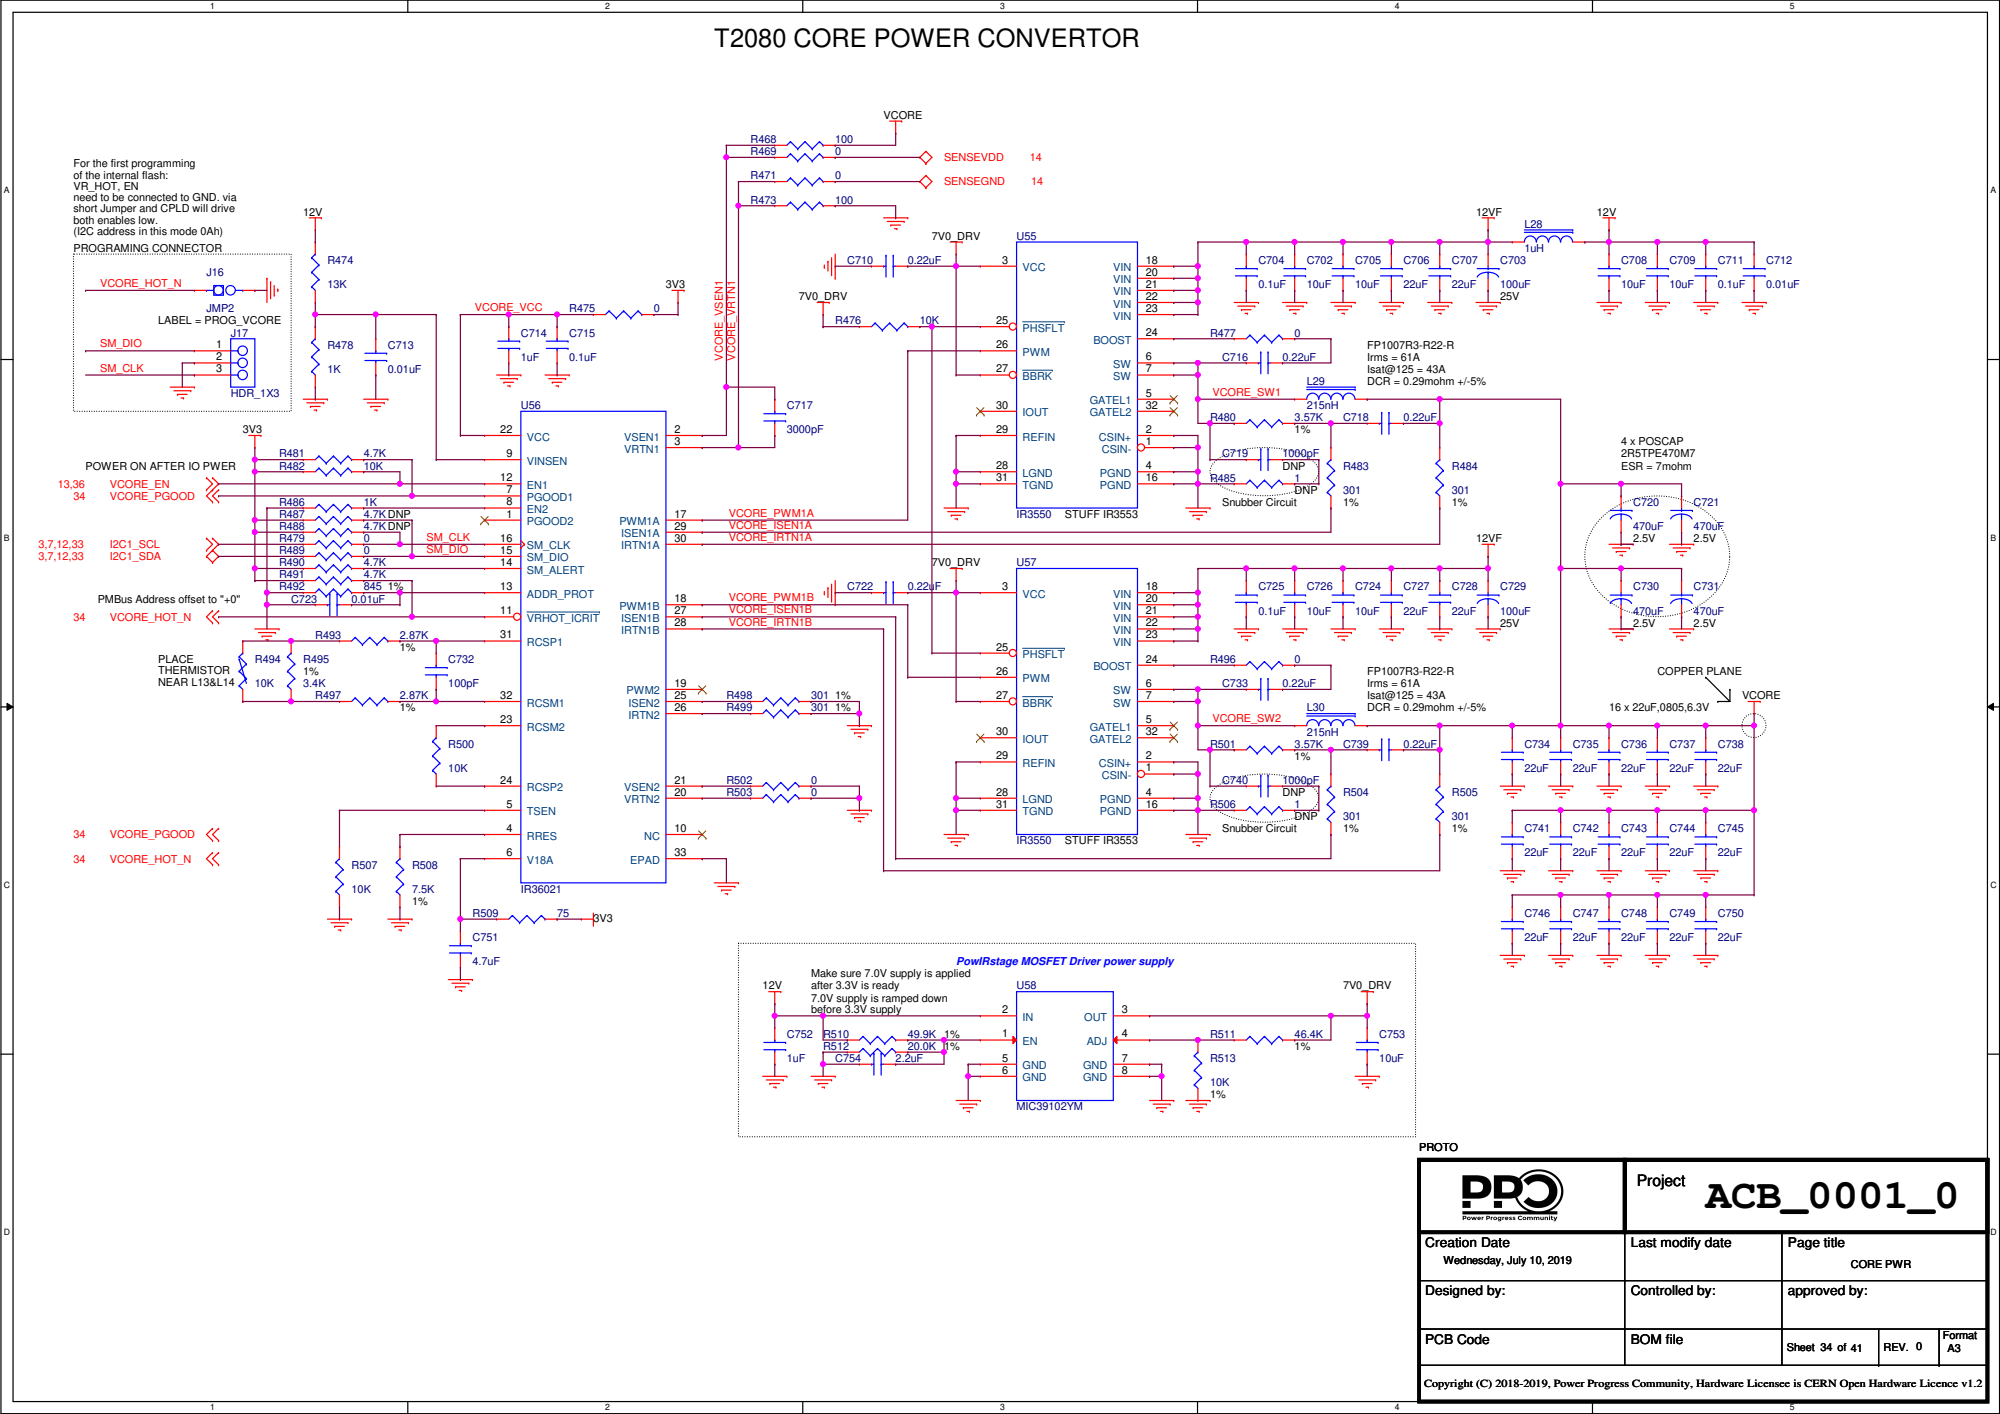
[picture p116: page 34]

For the first programming
of the internal flash:
VR_HOT, EN
need to be connected to GND. via
short Jumper and CPLD will drive
both enables low.
(I2C address in this mode 0Ah)
PROGRAMING CONNECTOR

POWER ON AFTER IO PWER

PMBus Address offset to "+0"

PowIRstage MOSFET Driver power supply

Make sure 7.0V supply is applied
after 3.3V is ready
7.0V supply is ramped down
before 3.3V supply

## MAX 10A

# SYSTEM POWER CONVERTORs

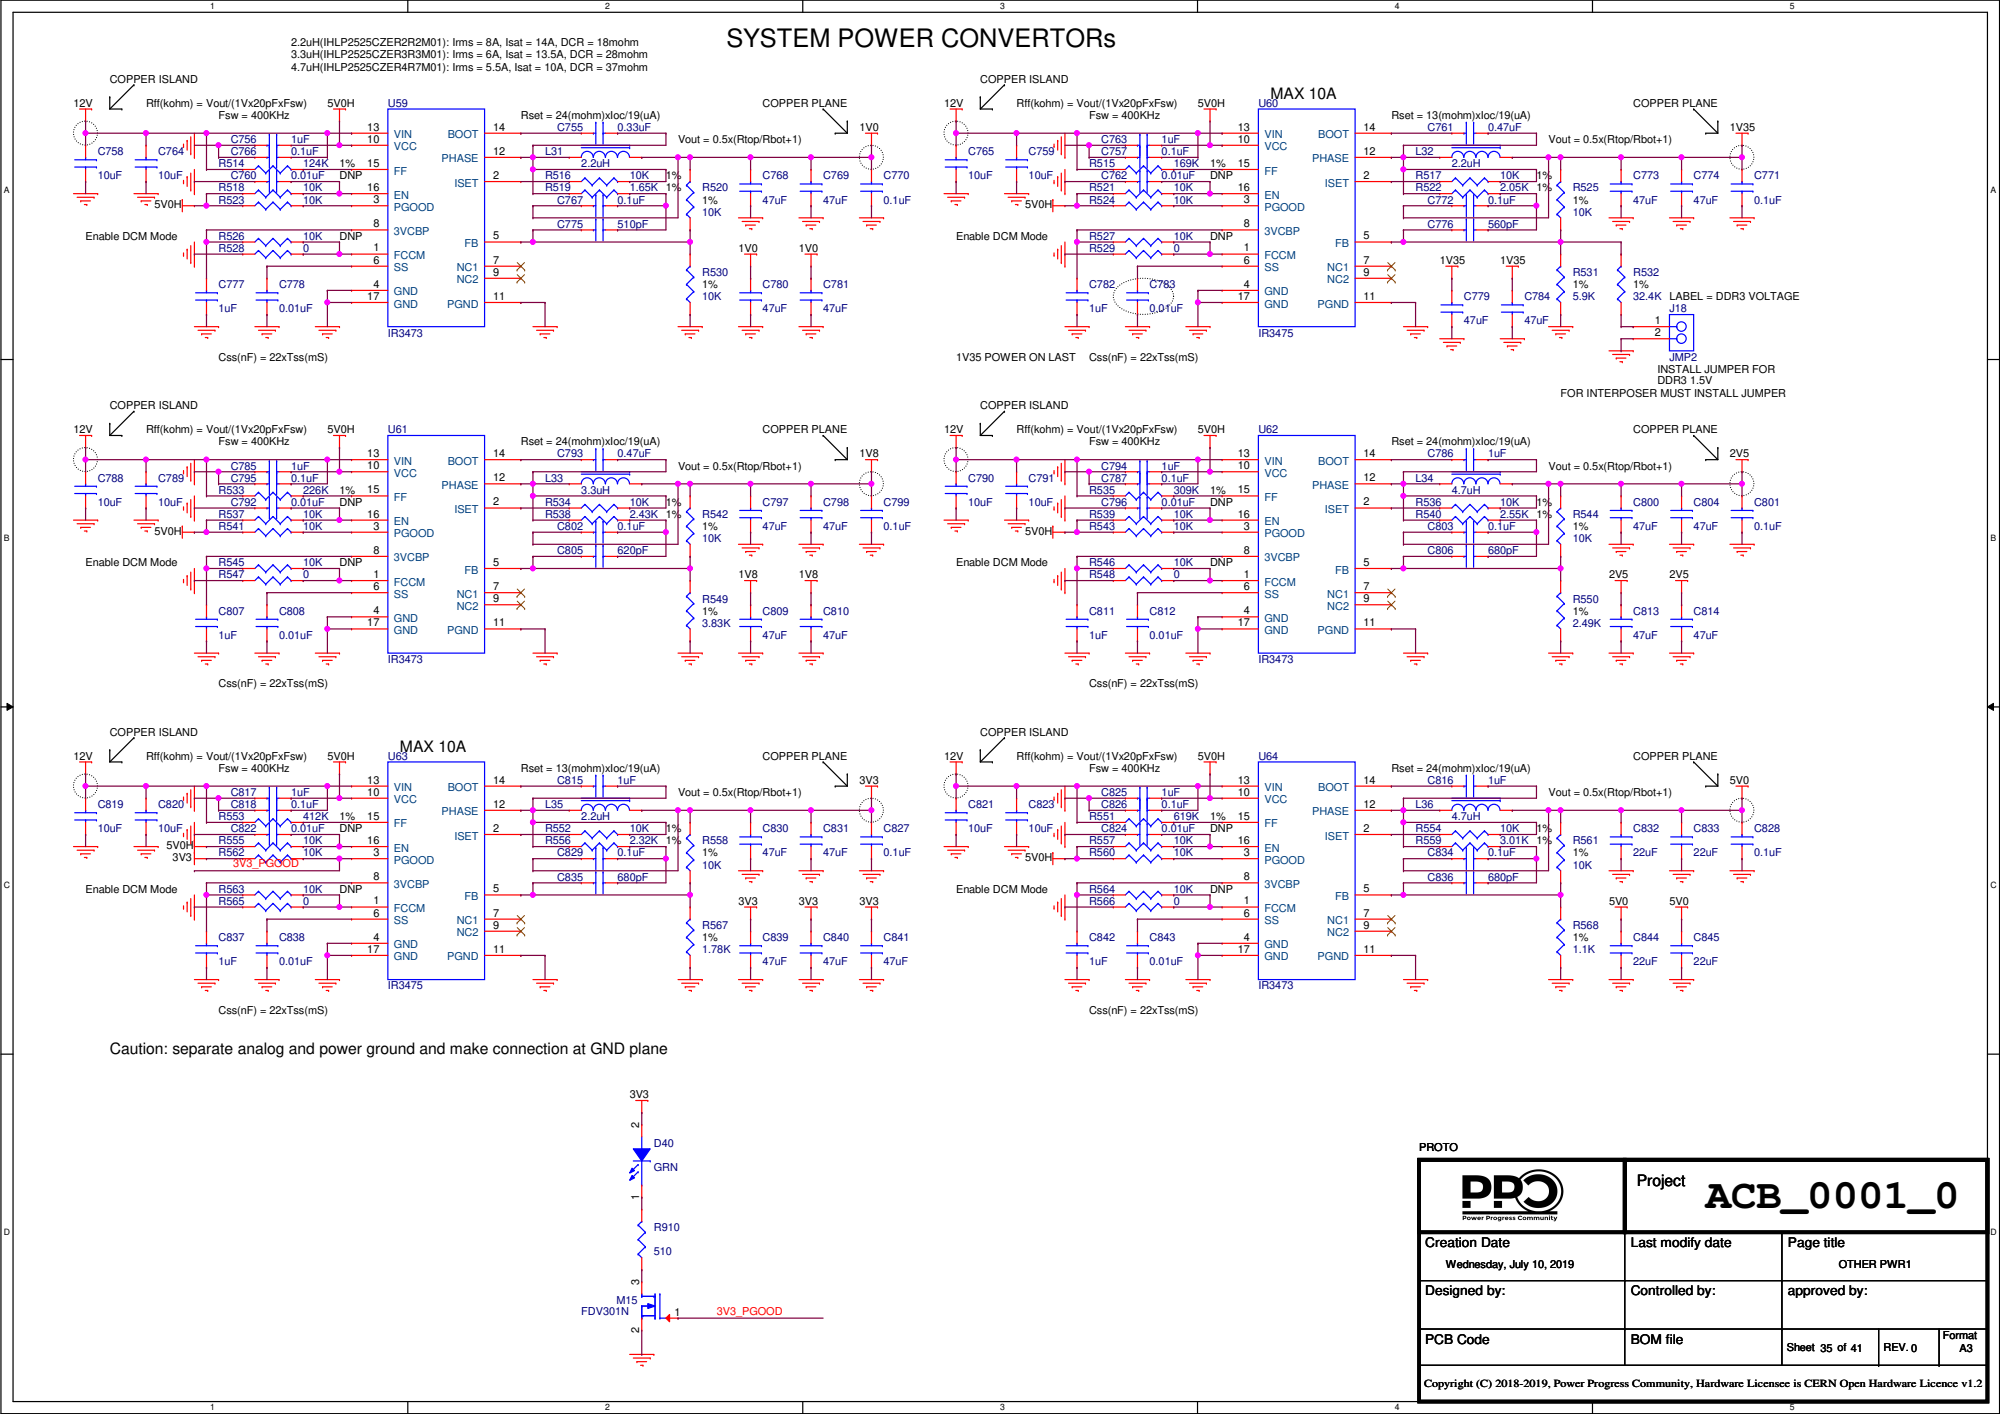
[picture p117: page 35]

Rset = 24(mohm)xIoc/19(uA)

Rset = 13(mohm)xIoc/19(uA)

FOR INTERPOSER MUST INSTALL JUMPER

Caution: separate analog and power ground and make connection at GND plane

# SYSTEM POWER CONVERTORs (cont.)

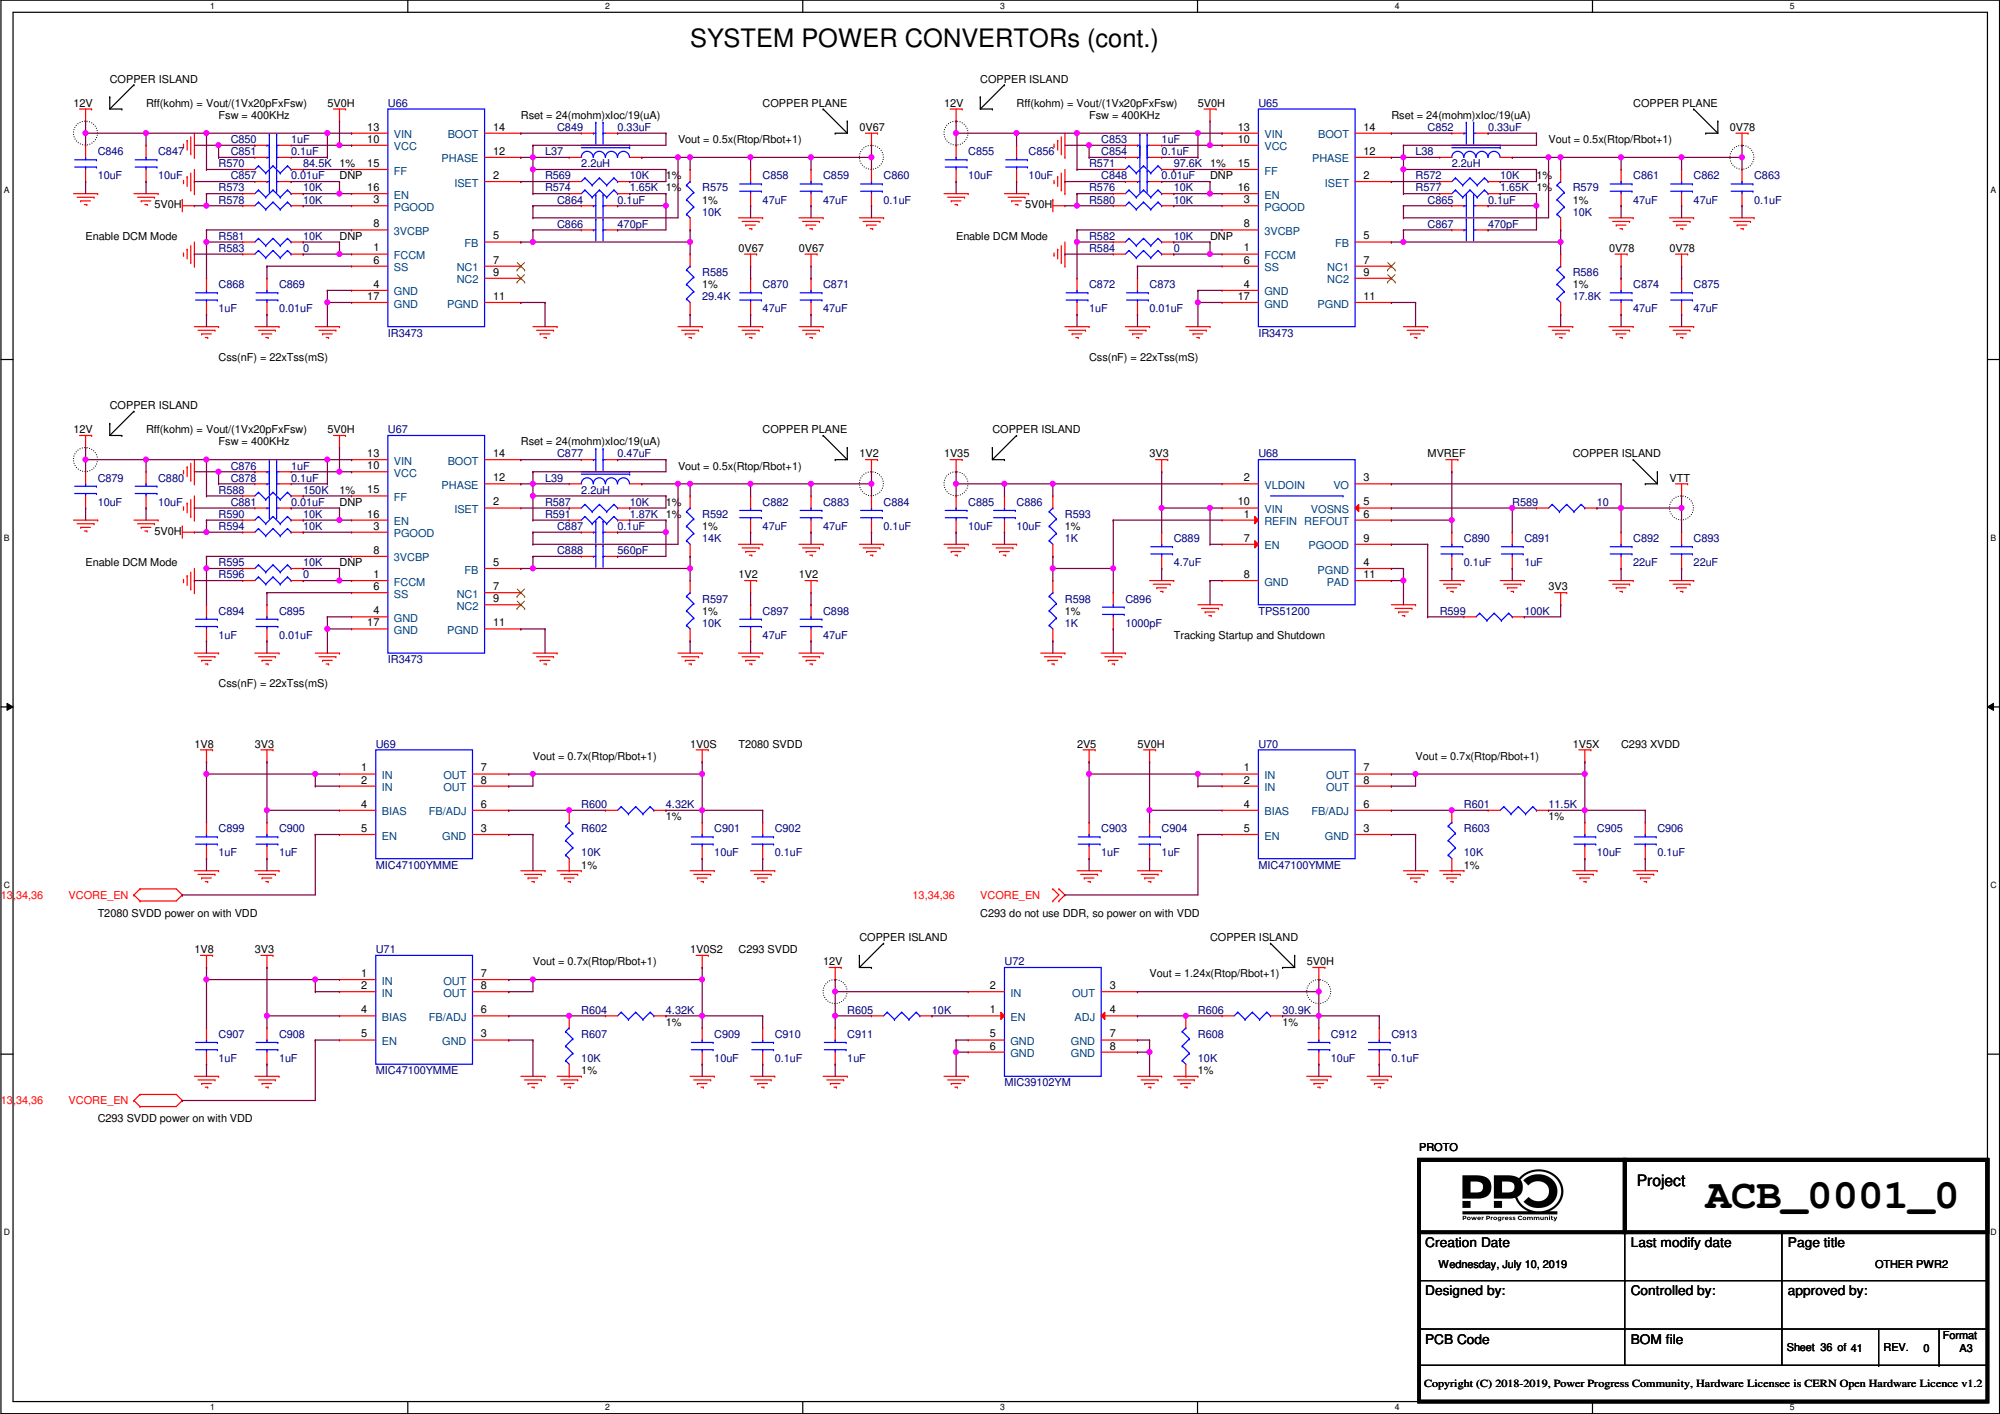
[picture p118: page 36]

Rset = 24(mohm)xIoc/19(uA)

Tracking Startup and Shutdown

C293 SVDD power on with VDD

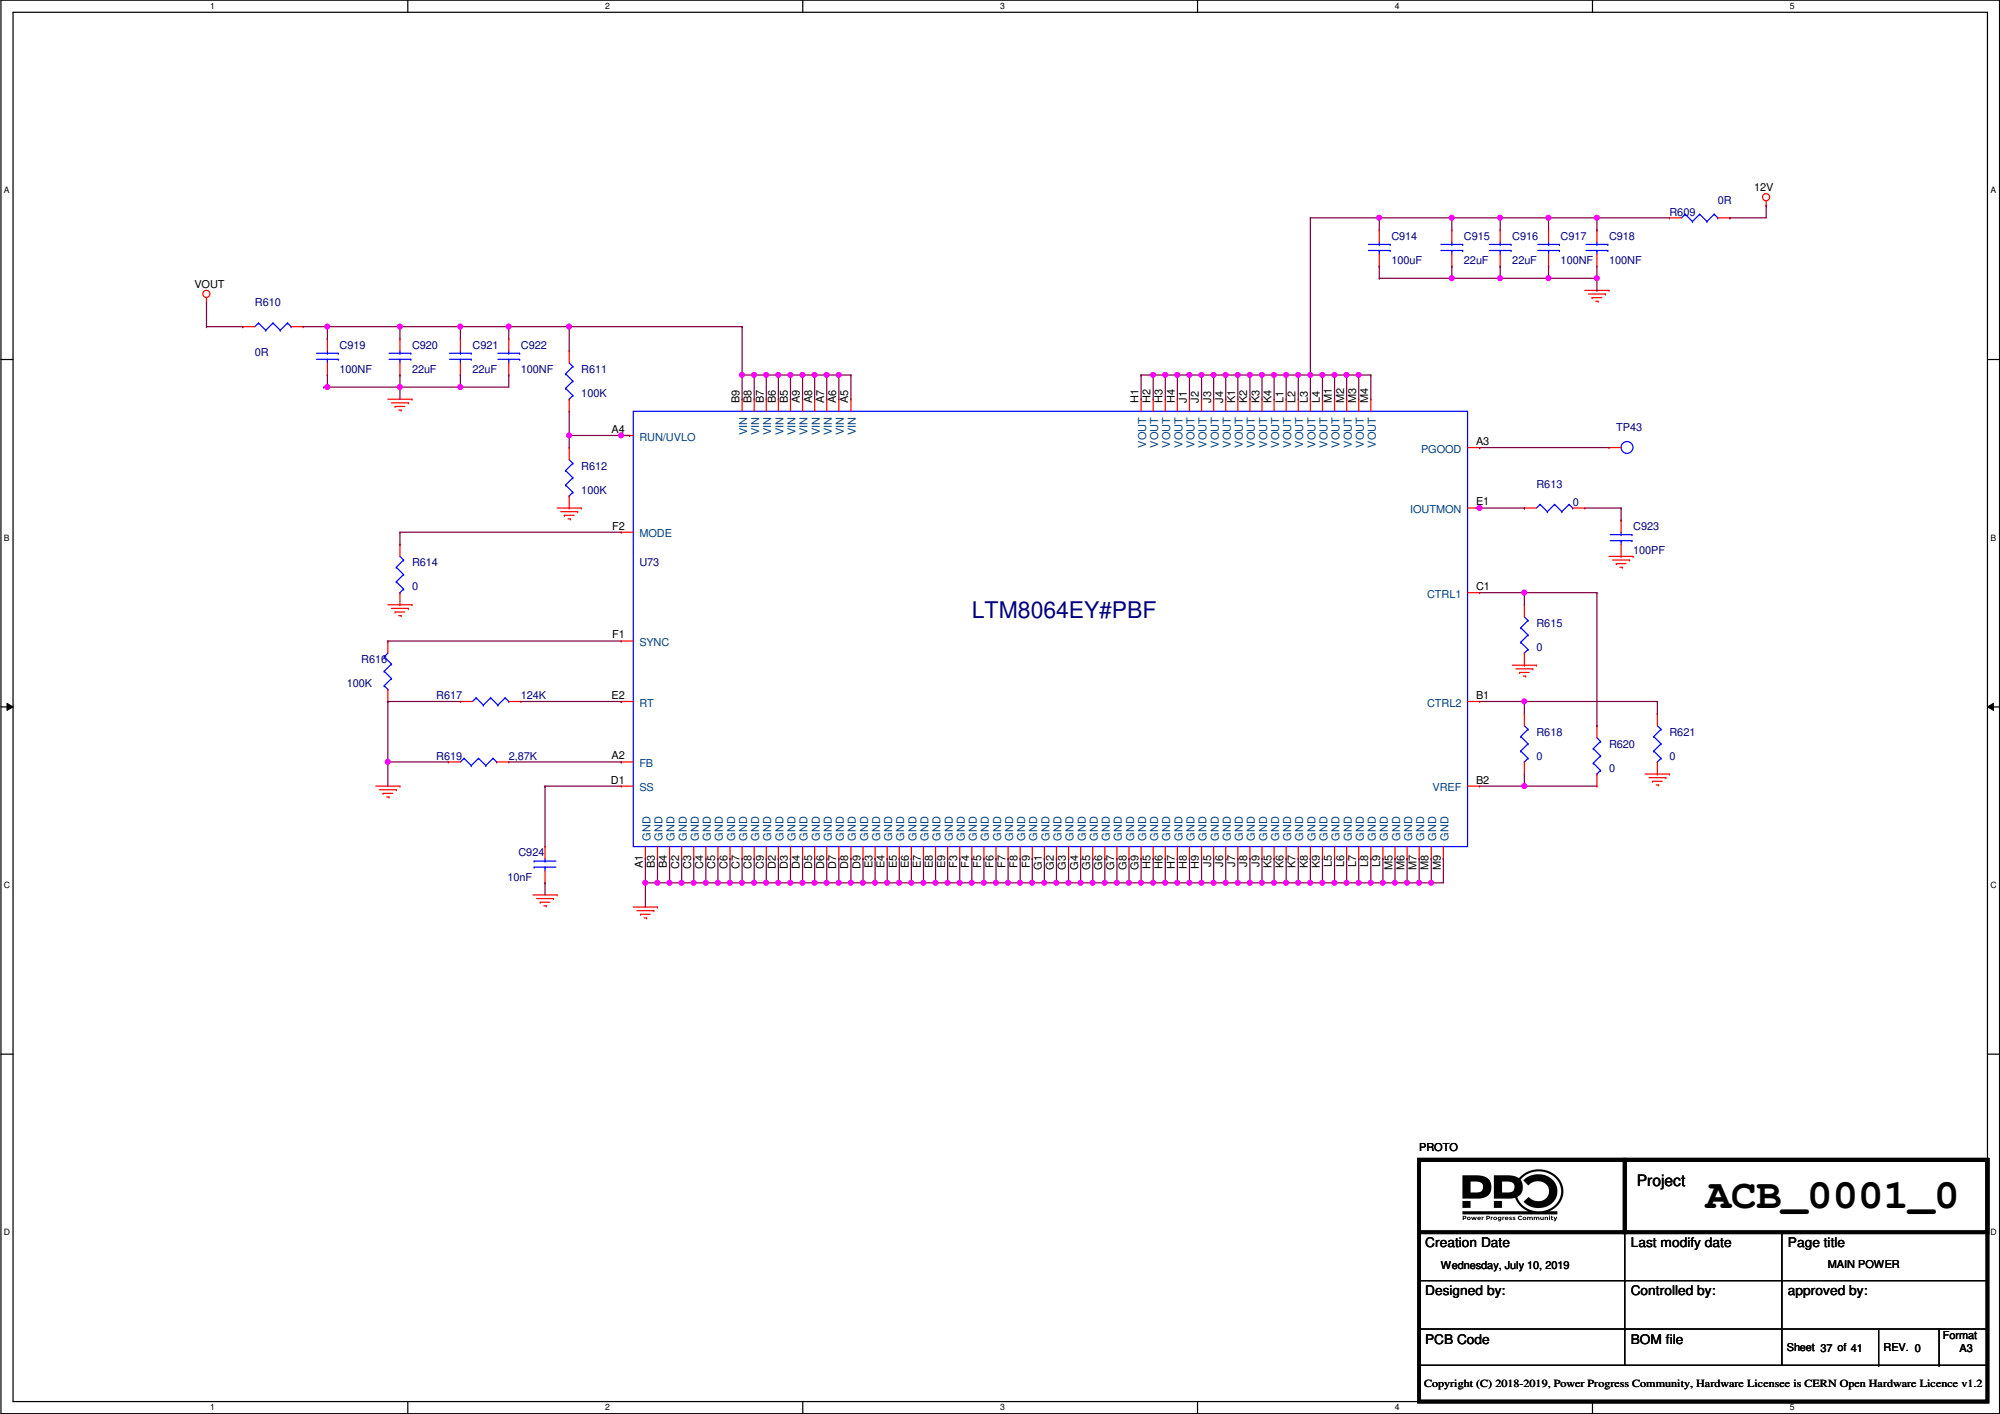
[picture p119: page 37]

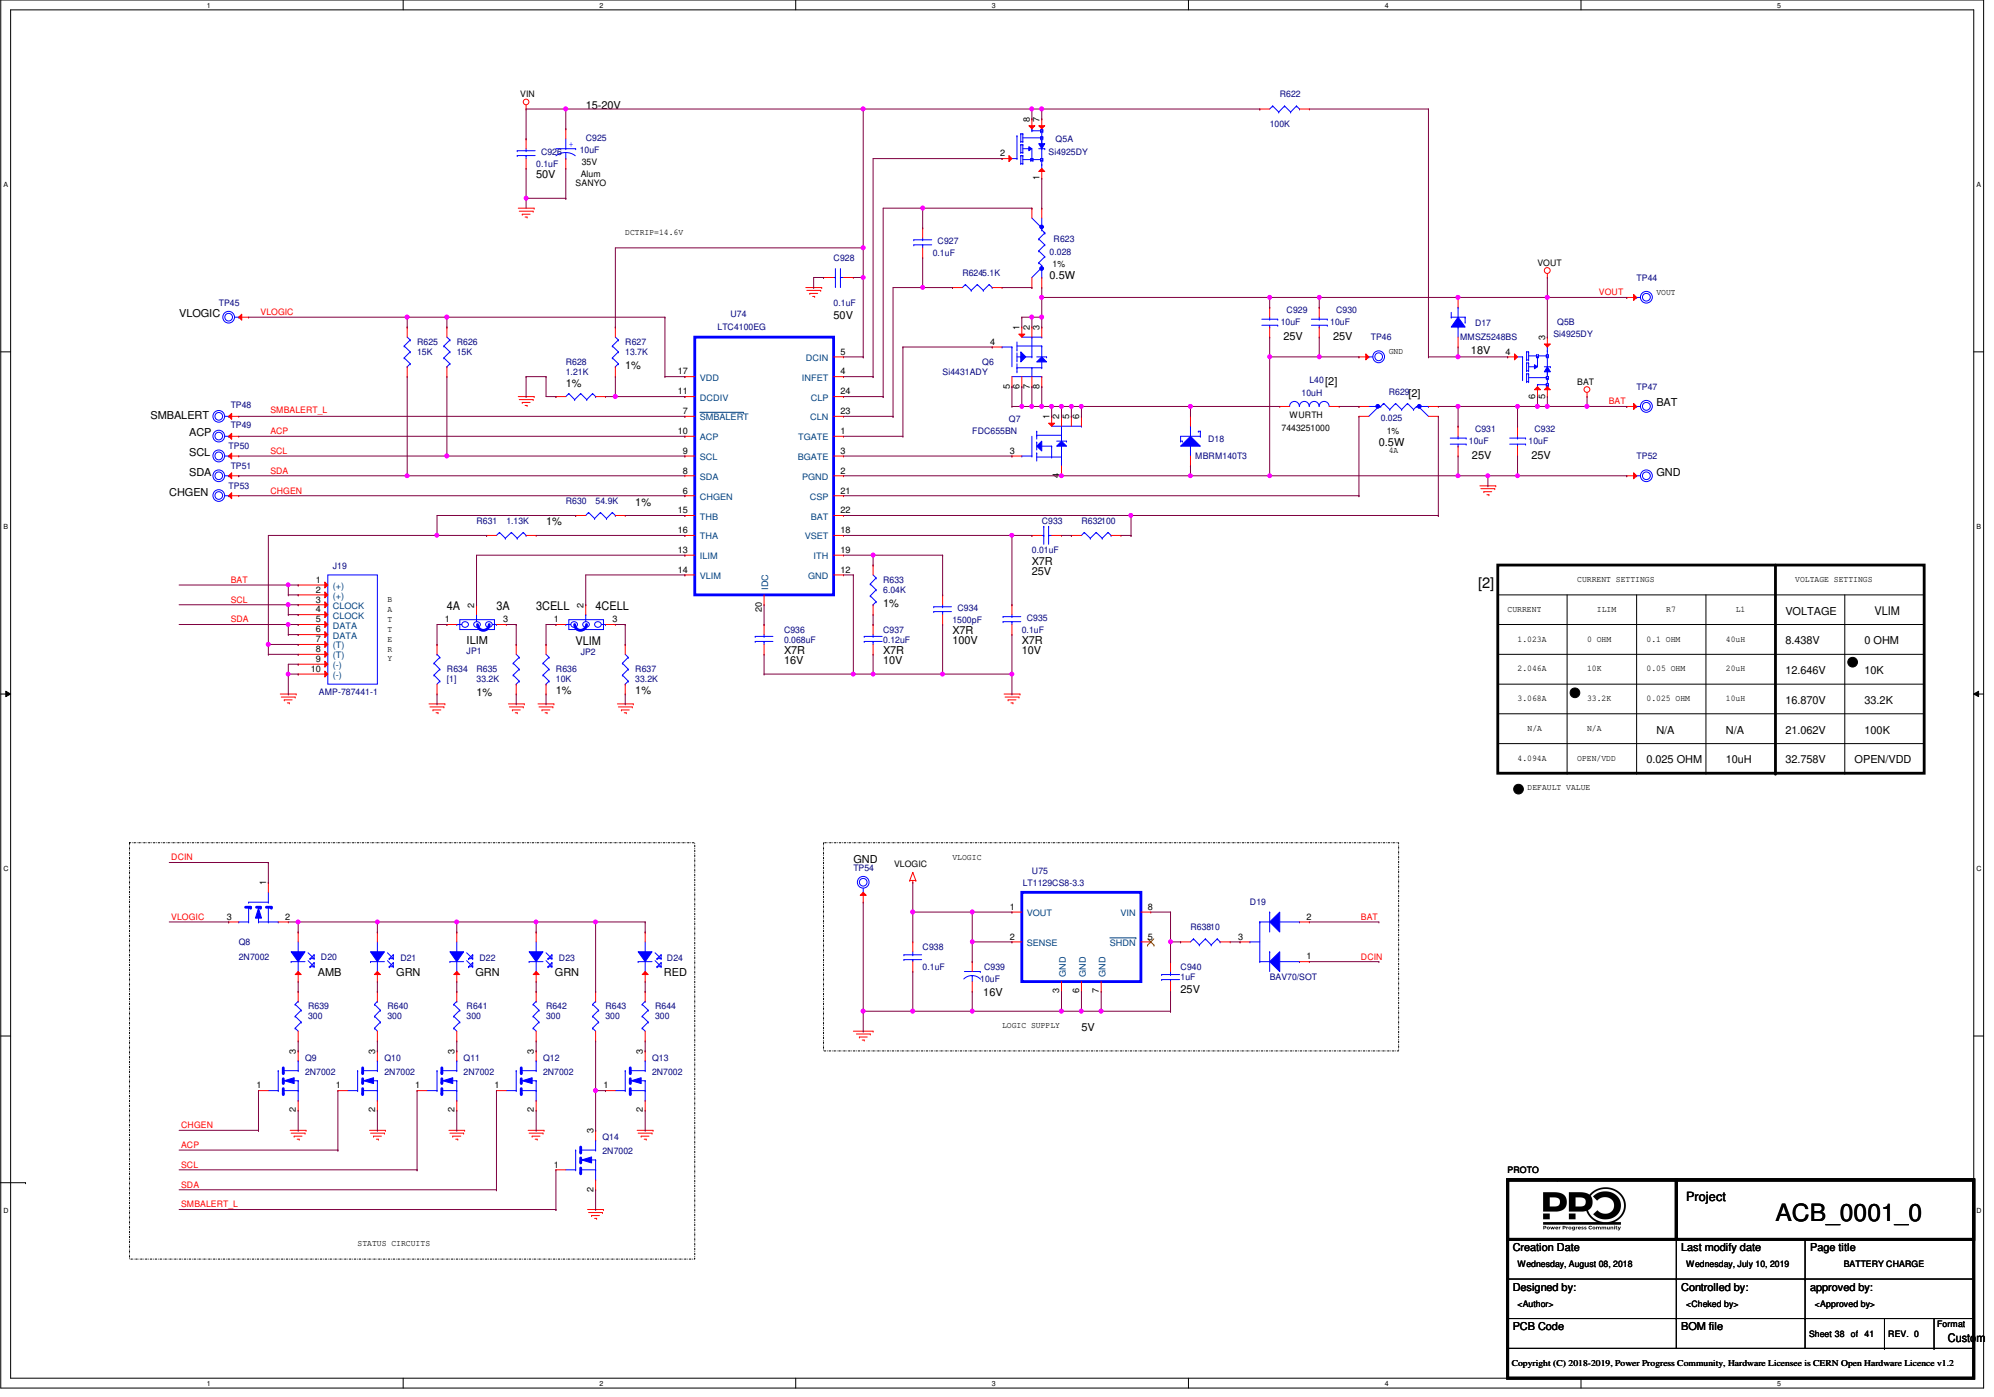
[picture p120: page 38]

# SYSTEM POWER INPUT

## REMOTE RESET

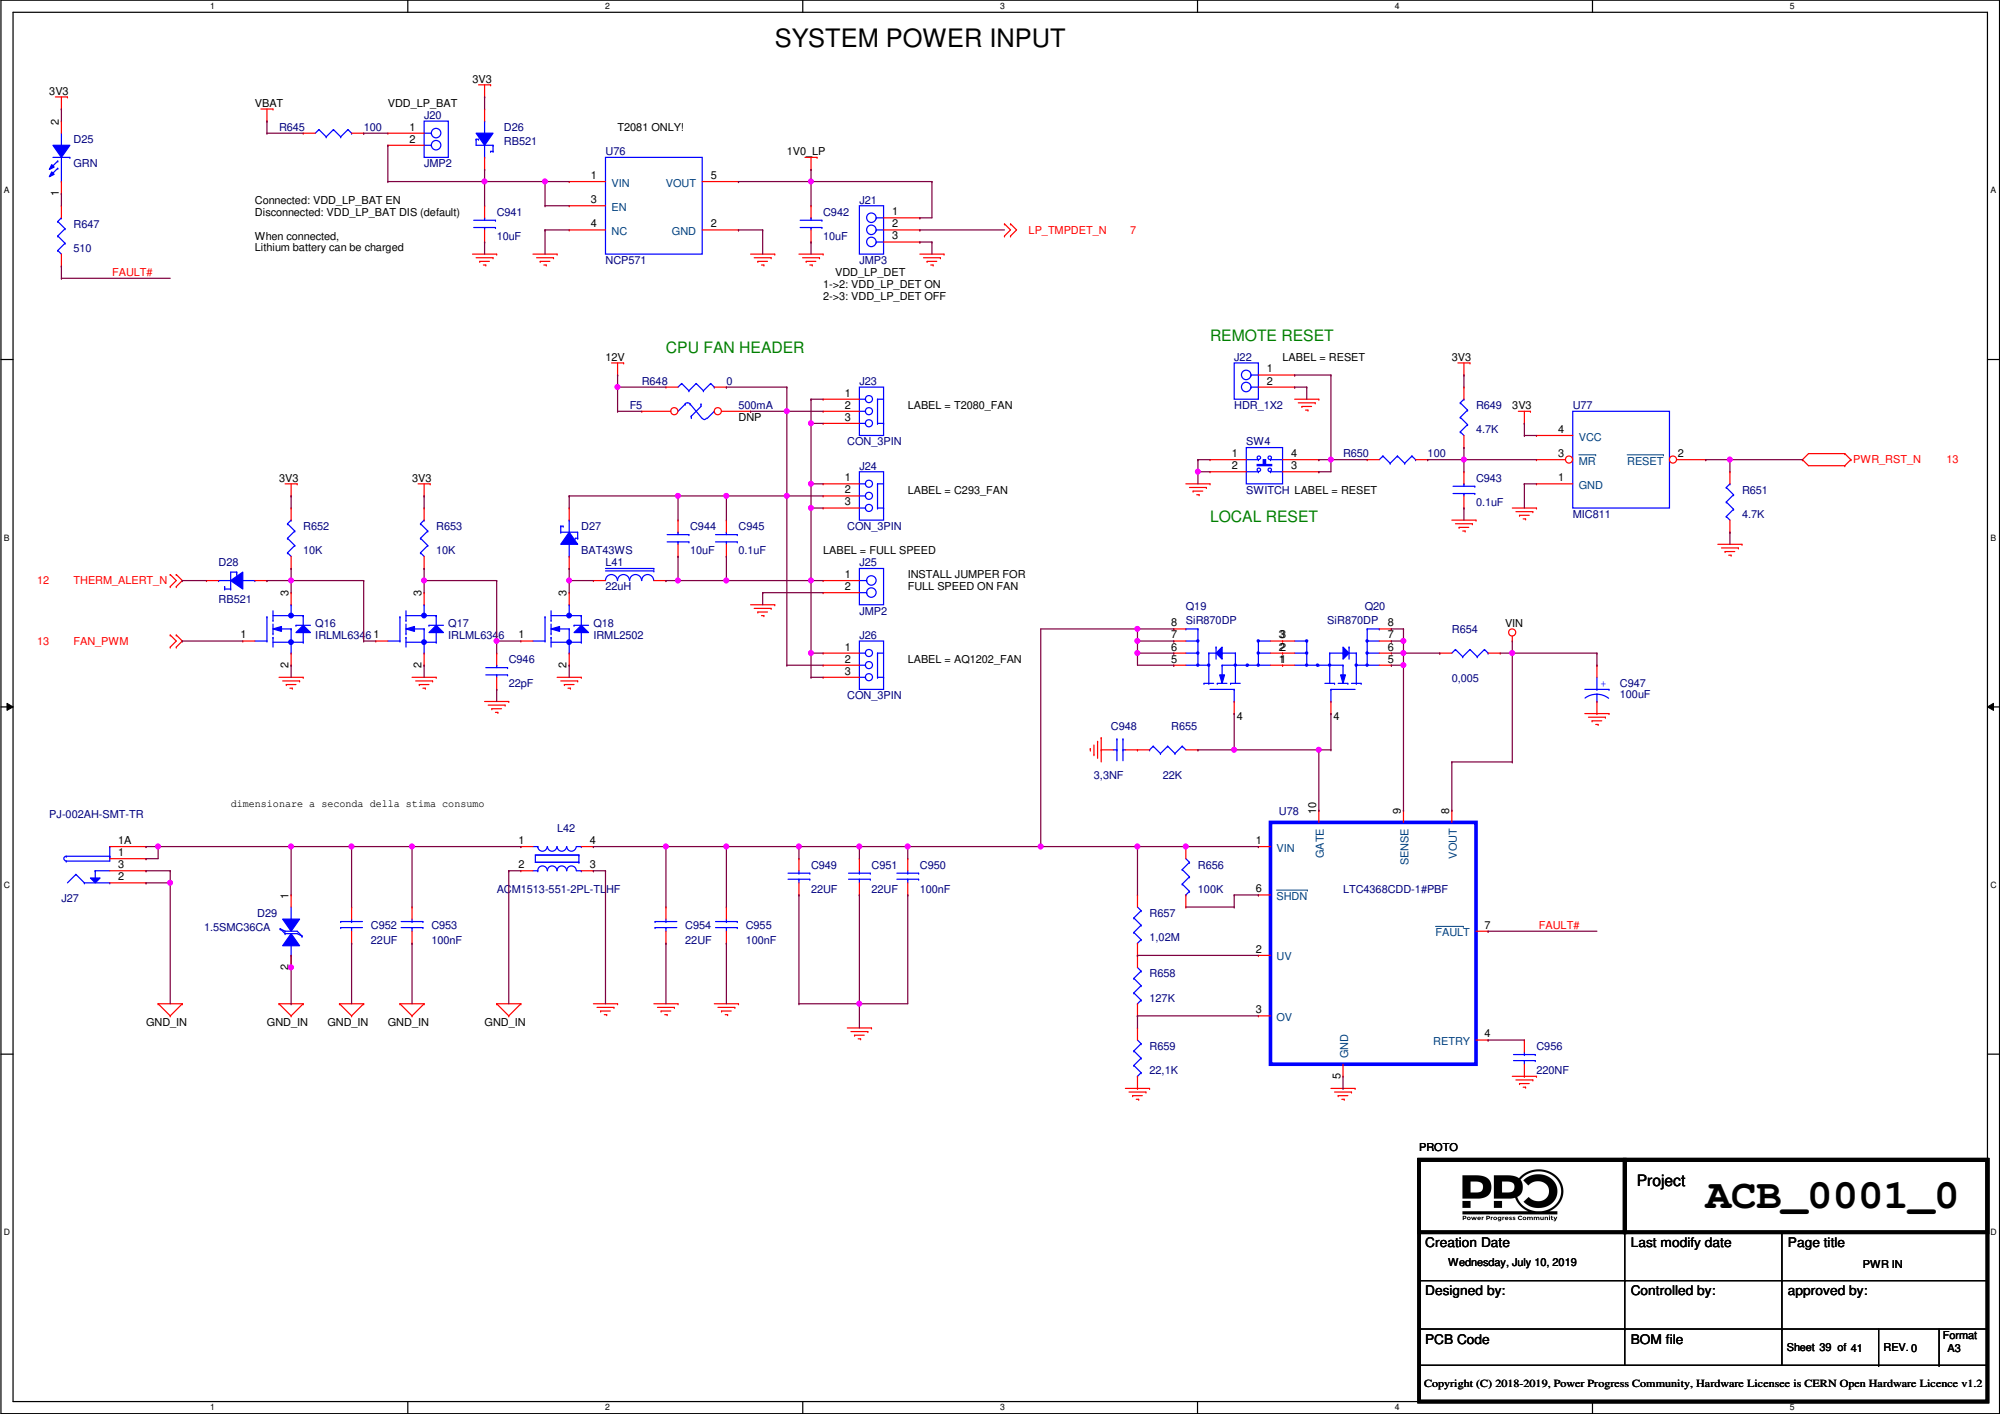
[picture p121: page 39]

When connected,
Lithium battery can be charged

INSTALL JUMPER FOR
FULL SPEED ON FAN

dimensionare a seconda della stima consumo

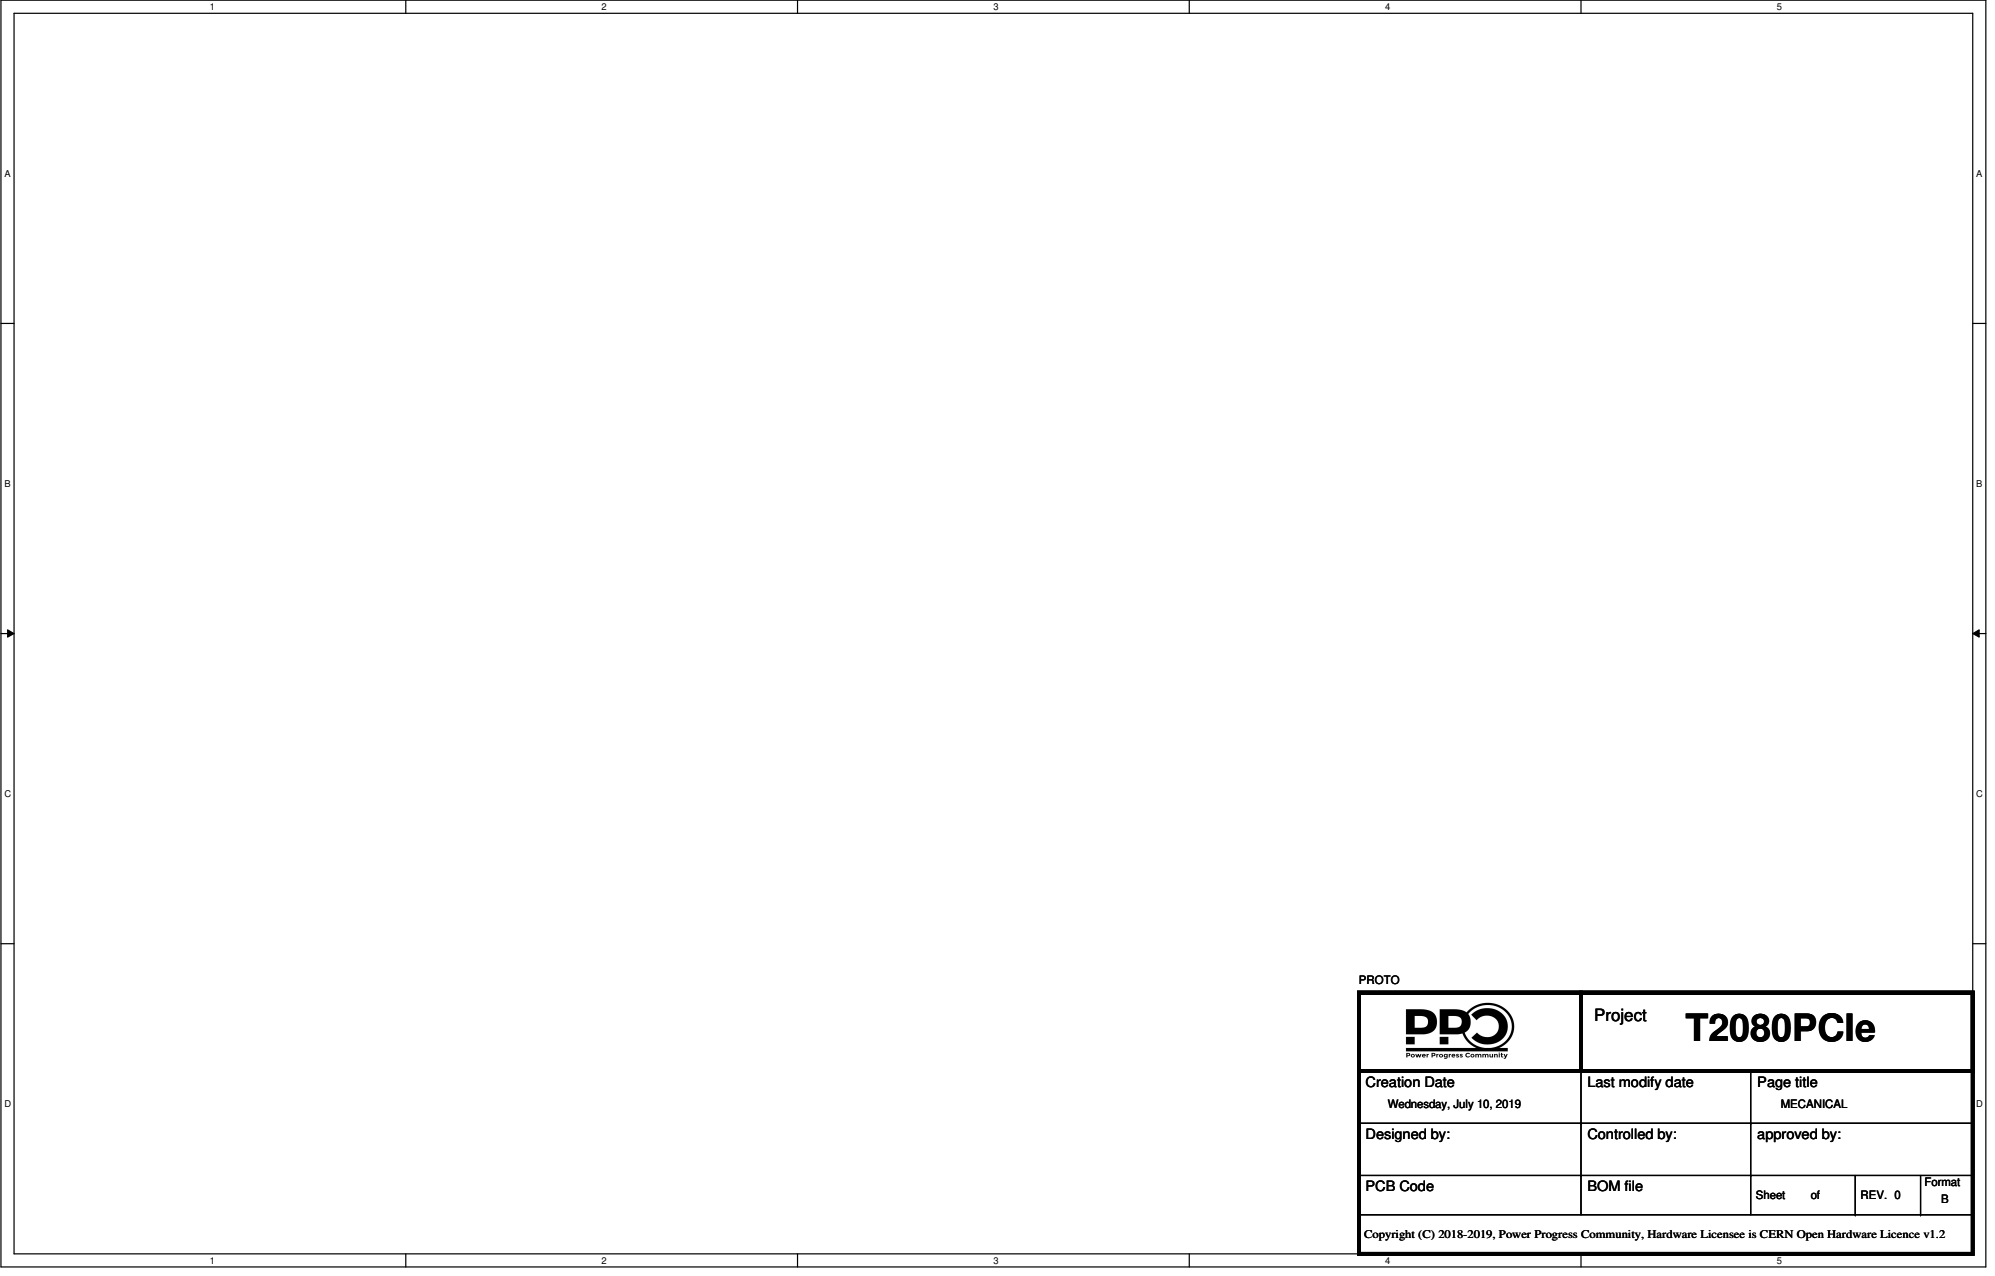
[picture p122: page 40]
Project; Creation Date; Last modify date; Designed by:; Controlled by:; approved by:; PCB Code; BOM file; Sheet; REV.; Format; Page title; MECANICAL; T2080PCIe; Wednesday, July 10, 2019; PROTO

Copyright (C) 2018-2019, Power Progress Community, Hardware Licensee is CERN Open Hardware Licence v1.2

# CHANGE LIST

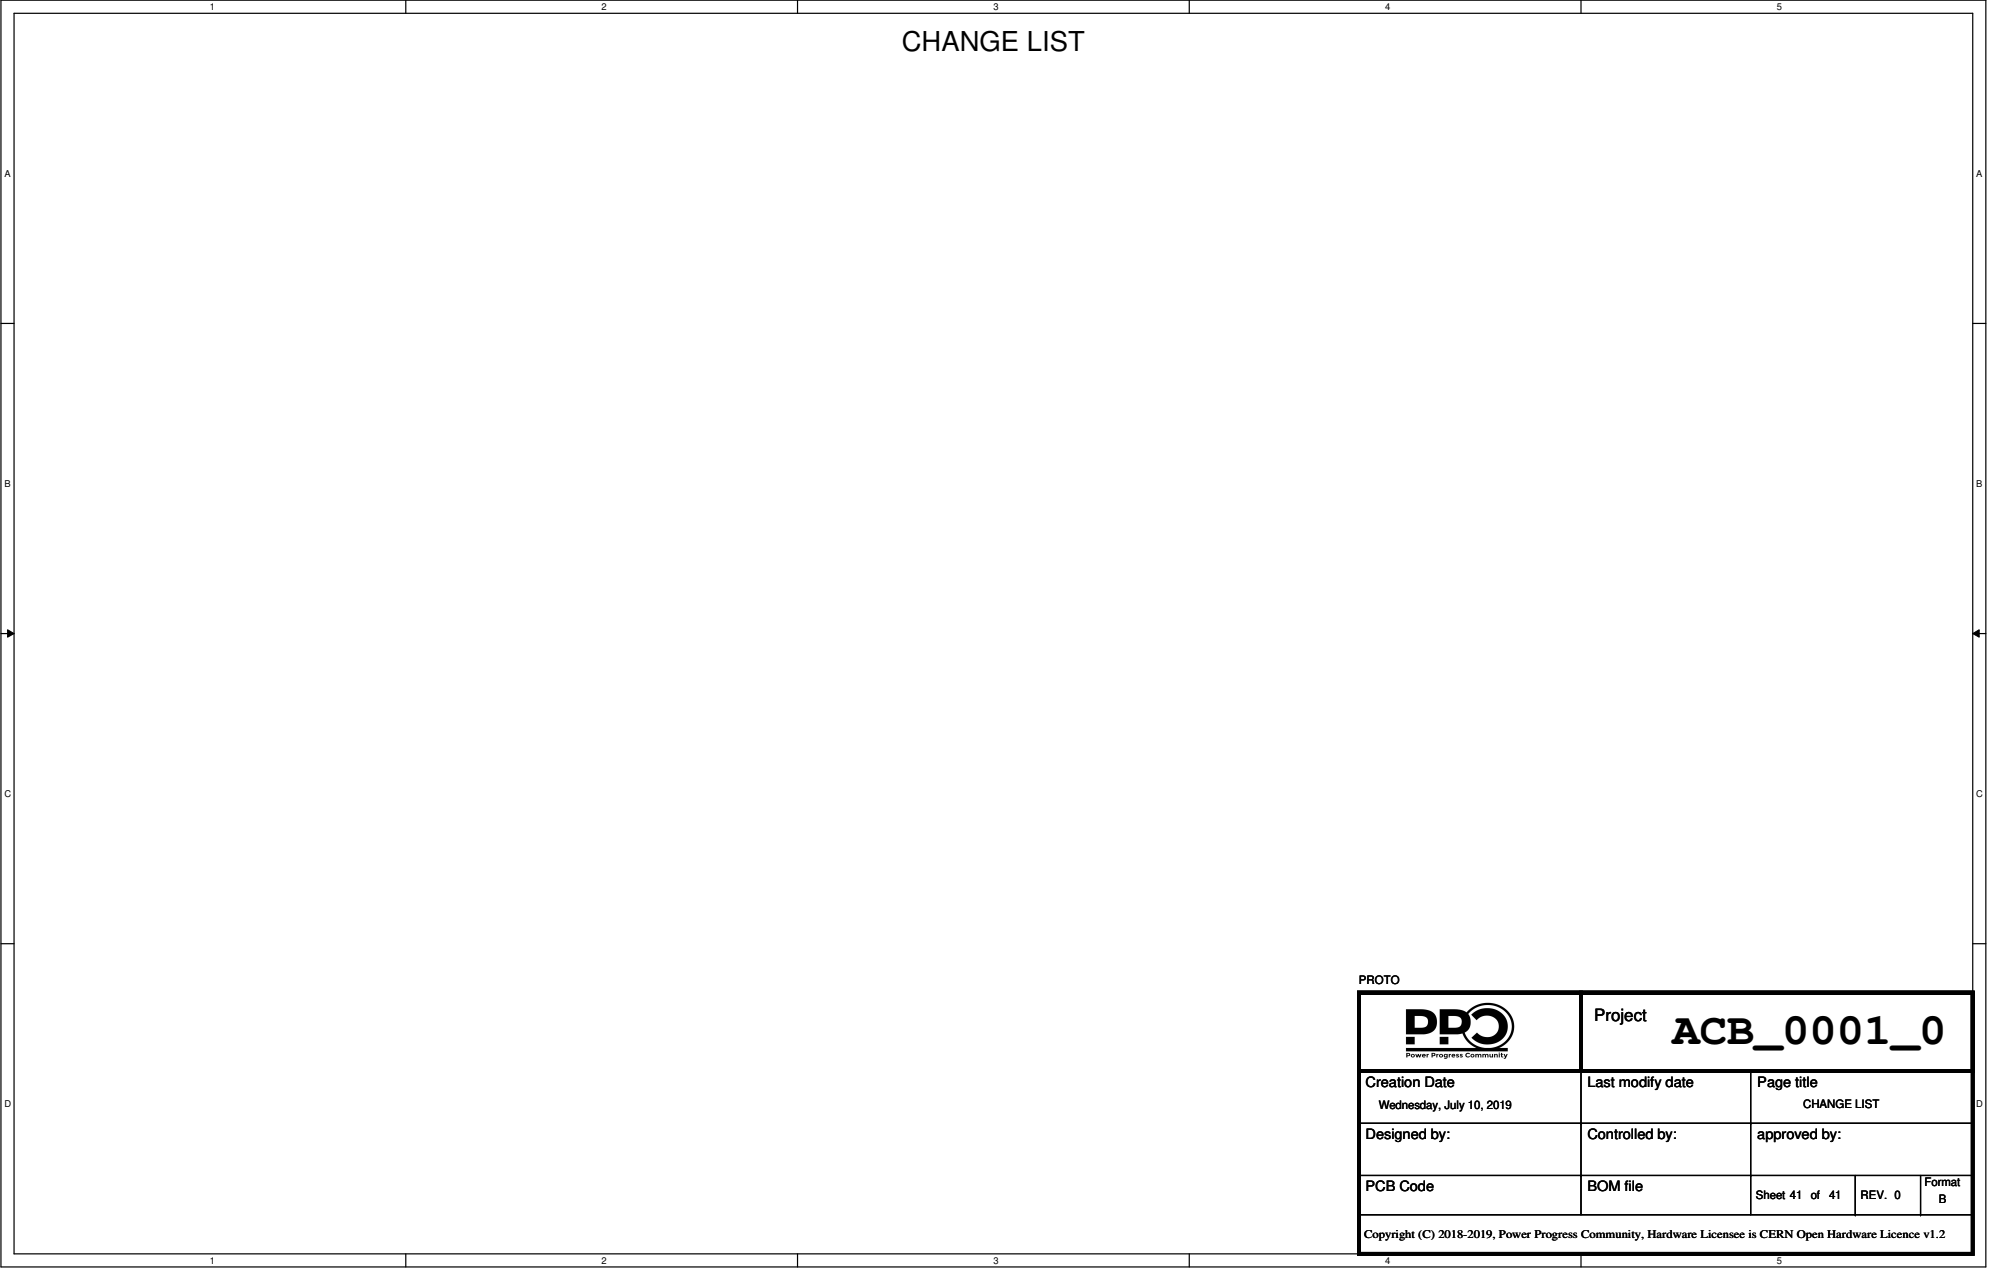
[picture p123: page 41]
ACB_0001_0 Project; Creation Date; Last modify date; Designed by:; Controlled by:; approved by:; PCB Code; BOM file; Sheet; REV.; Format; Page title; CHANGE LIST; Wednesday, July 10, 2019; PROTO; Project

Copyright (C) 2018-2019, Power Progress Community, Hardware Licensee is CERN Open Hardware Licence v1.2
