unofficialImportFromGitlab-PPC/powerpc-laptop-mobo/PDF_design/PPC_notebook_electrical_schematics_v0.2.pdf

## Version Control

# Version

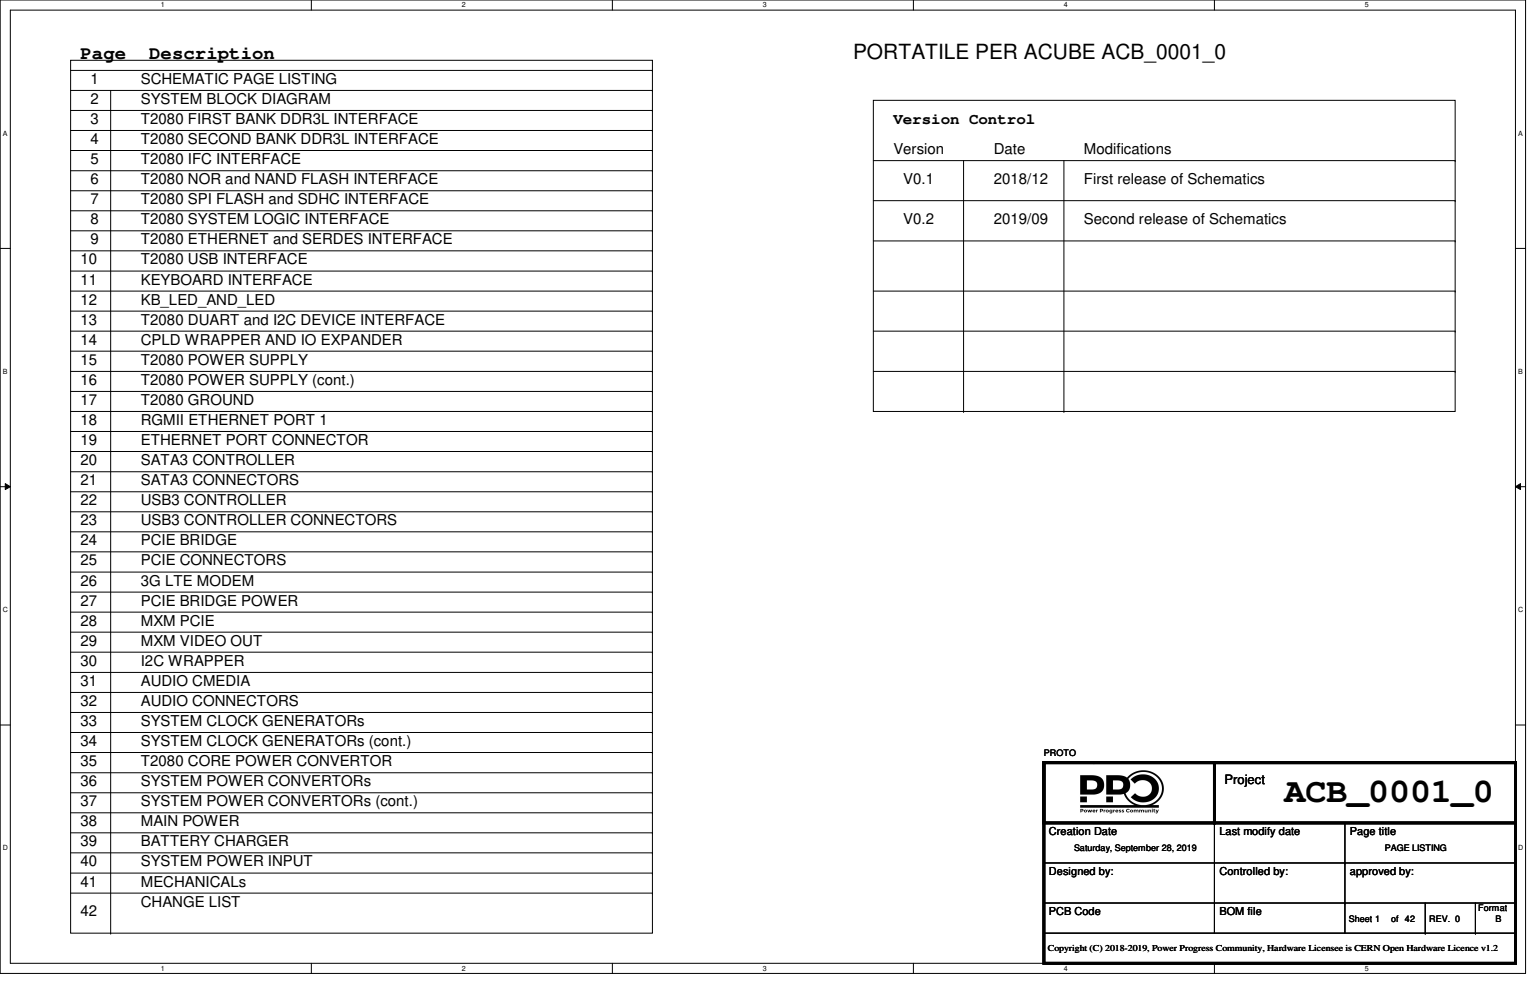
[picture p124: page 1]
Date; Modifications; Page; Description; PORTATILE PER ACUBE ACB_0001_0; SCHEMATIC PAGE LISTING; ACB_0001_0; MECHANICALs CHANGE LIST; Second release of Schematics; Project; Creation Date; Last modify date; Designed by:; Controlled by:; approved by:; PCB Code; BOM file; Sheet; REV.; Format; Page title; PAGE LISTING; Saturday, September 28, 2019; PROTO

SYSTEM BLOCK DIAGRAM
T2080 FIRST BANK DDR3L INTERFACE
T2080 SECOND BANK DDR3L INTERFACE
T2080 IFC INTERFACE
T2080 NOR and NAND FLASH INTERFACE
T2080 SPI FLASH and SDHC INTERFACE
T2080 SYSTEM LOGIC INTERFACE
T2080 ETHERNET and SERDES INTERFACE
T2080 USB INTERFACE
KEYBOARD INTERFACE
KB_LED_AND_LED
T2080 DUART and I2C DEVICE INTERFACE
CPLD WRAPPER AND IO EXPANDER
T2080 POWER SUPPLY
T2080 POWER SUPPLY (cont.)
T2080 GROUND
RGMII ETHERNET PORT 1
ETHERNET PORT CONNECTOR
SATA3 CONTROLLER
SATA3 CONNECTORS
USB3 CONTROLLER
USB3 CONTROLLER CONNECTORS
PCIE BRIDGE
PCIE CONNECTORS
3G LTE MODEM
PCIE BRIDGE POWER
MXM PCIE
MXM VIDEO OUT
I2C WRAPPER
AUDIO CMEDIA
AUDIO CONNECTORS
SYSTEM CLOCK GENERATORs
SYSTEM CLOCK GENERATORs (cont.)
T2080 CORE POWER CONVERTOR
SYSTEM POWER CONVERTORs
SYSTEM POWER CONVERTORs (cont.)
MAIN POWER
BATTERY CHARGER
SYSTEM POWER INPUT

First release of Schematics

Copyright (C) 2018-2019, Power Progress Community, Hardware Licensee is CERN Open Hardware Licence v1.2

# SYSTEM BLOCK DIAGRAM

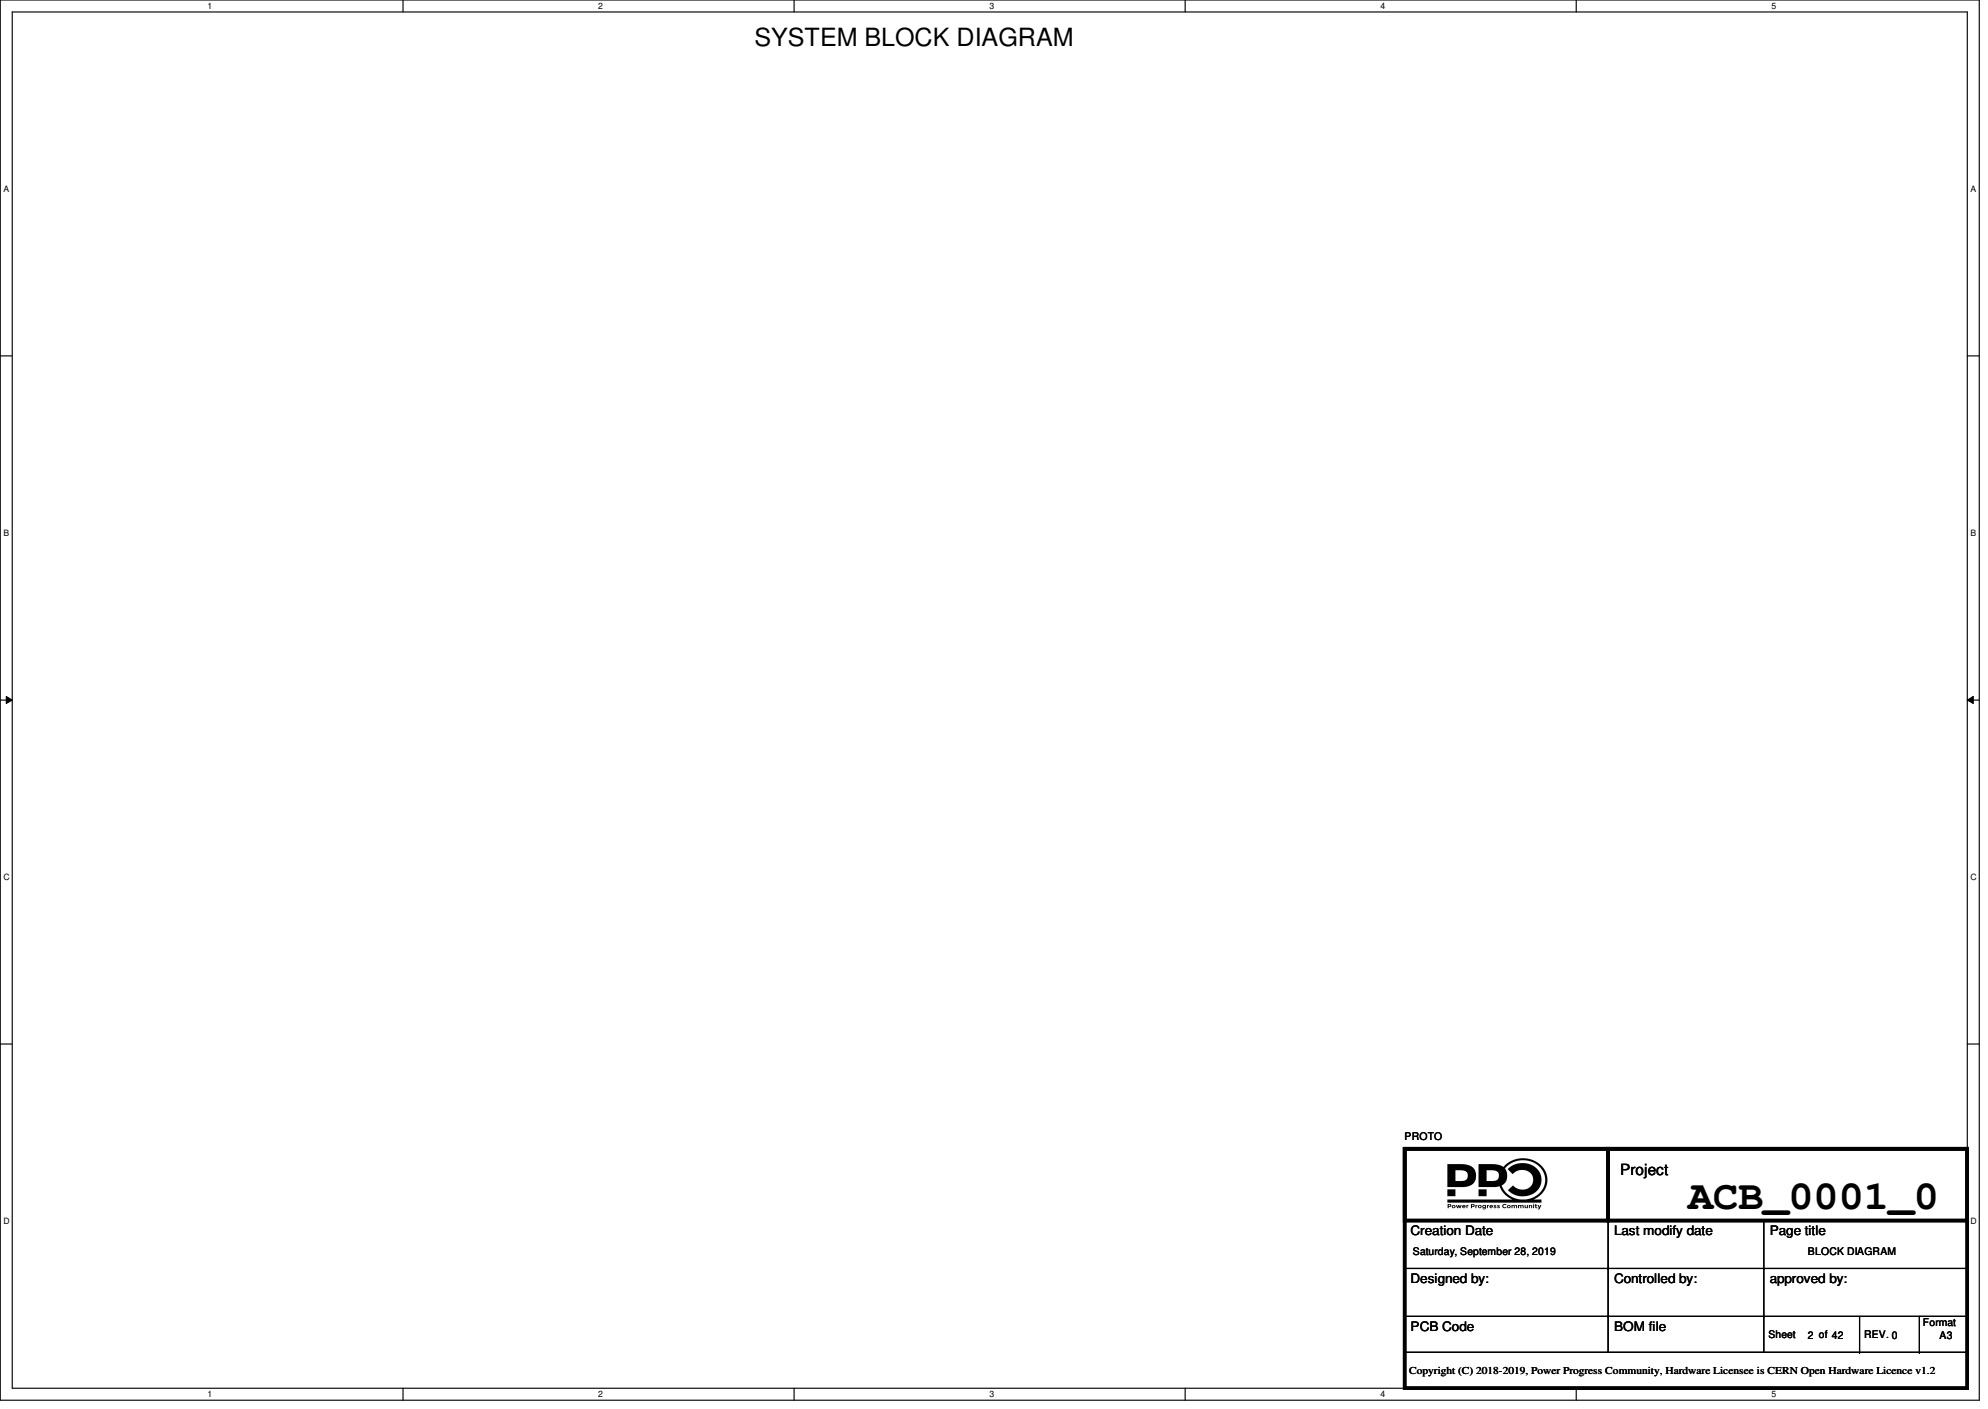
[picture p125: page 2]
ACB_0001_0; Project; Creation Date; Last modify date; Designed by:; Controlled by:; approved by:; PCB Code; BOM file; Sheet; REV.; Format; Page title; BLOCK DIAGRAM; Saturday, September 28, 2019; PROTO

Copyright (C) 2018-2019, Power Progress Community, Hardware Licensee is CERN Open Hardware Licence v1.2

# T2080 DDR3L MEMORY INTERFACE

## 1.35V DDR3L SDRAM SODIMM

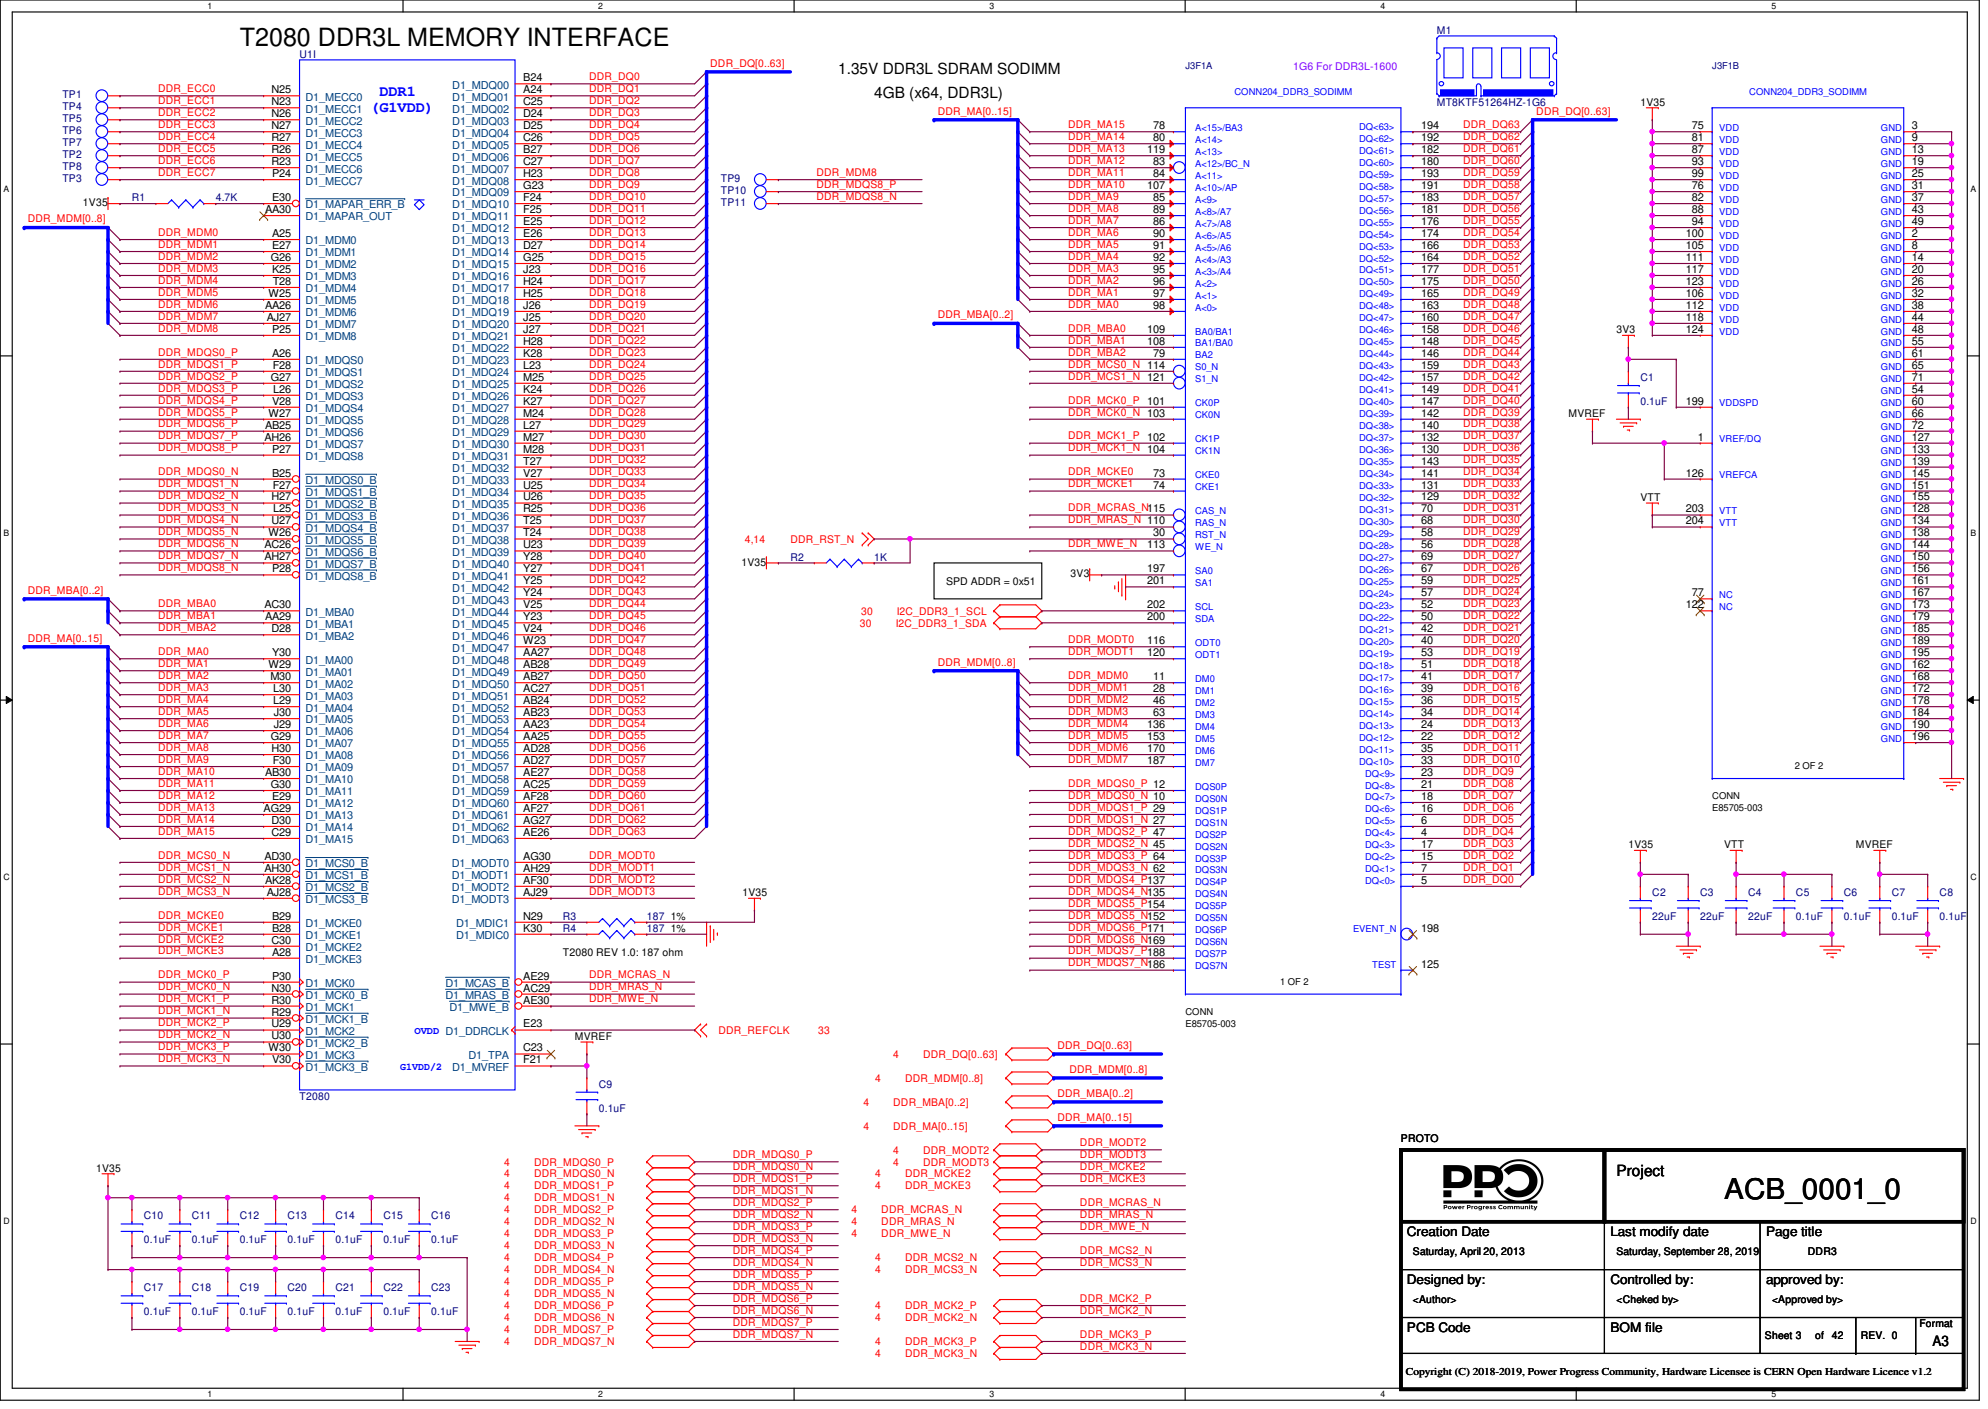
[picture p126: page 3]

81 | 9
87 | 13
93 | 19
99 | 25
76 | 31
82 | 37
88 | 43
94 | 49
100 | 2
105 | 8
111 | 14
117 | 20
123 | 26
106 | 32
112 | 38
118 | 44
124 | 48

A | A

## 4GB (x64, DDR3L)

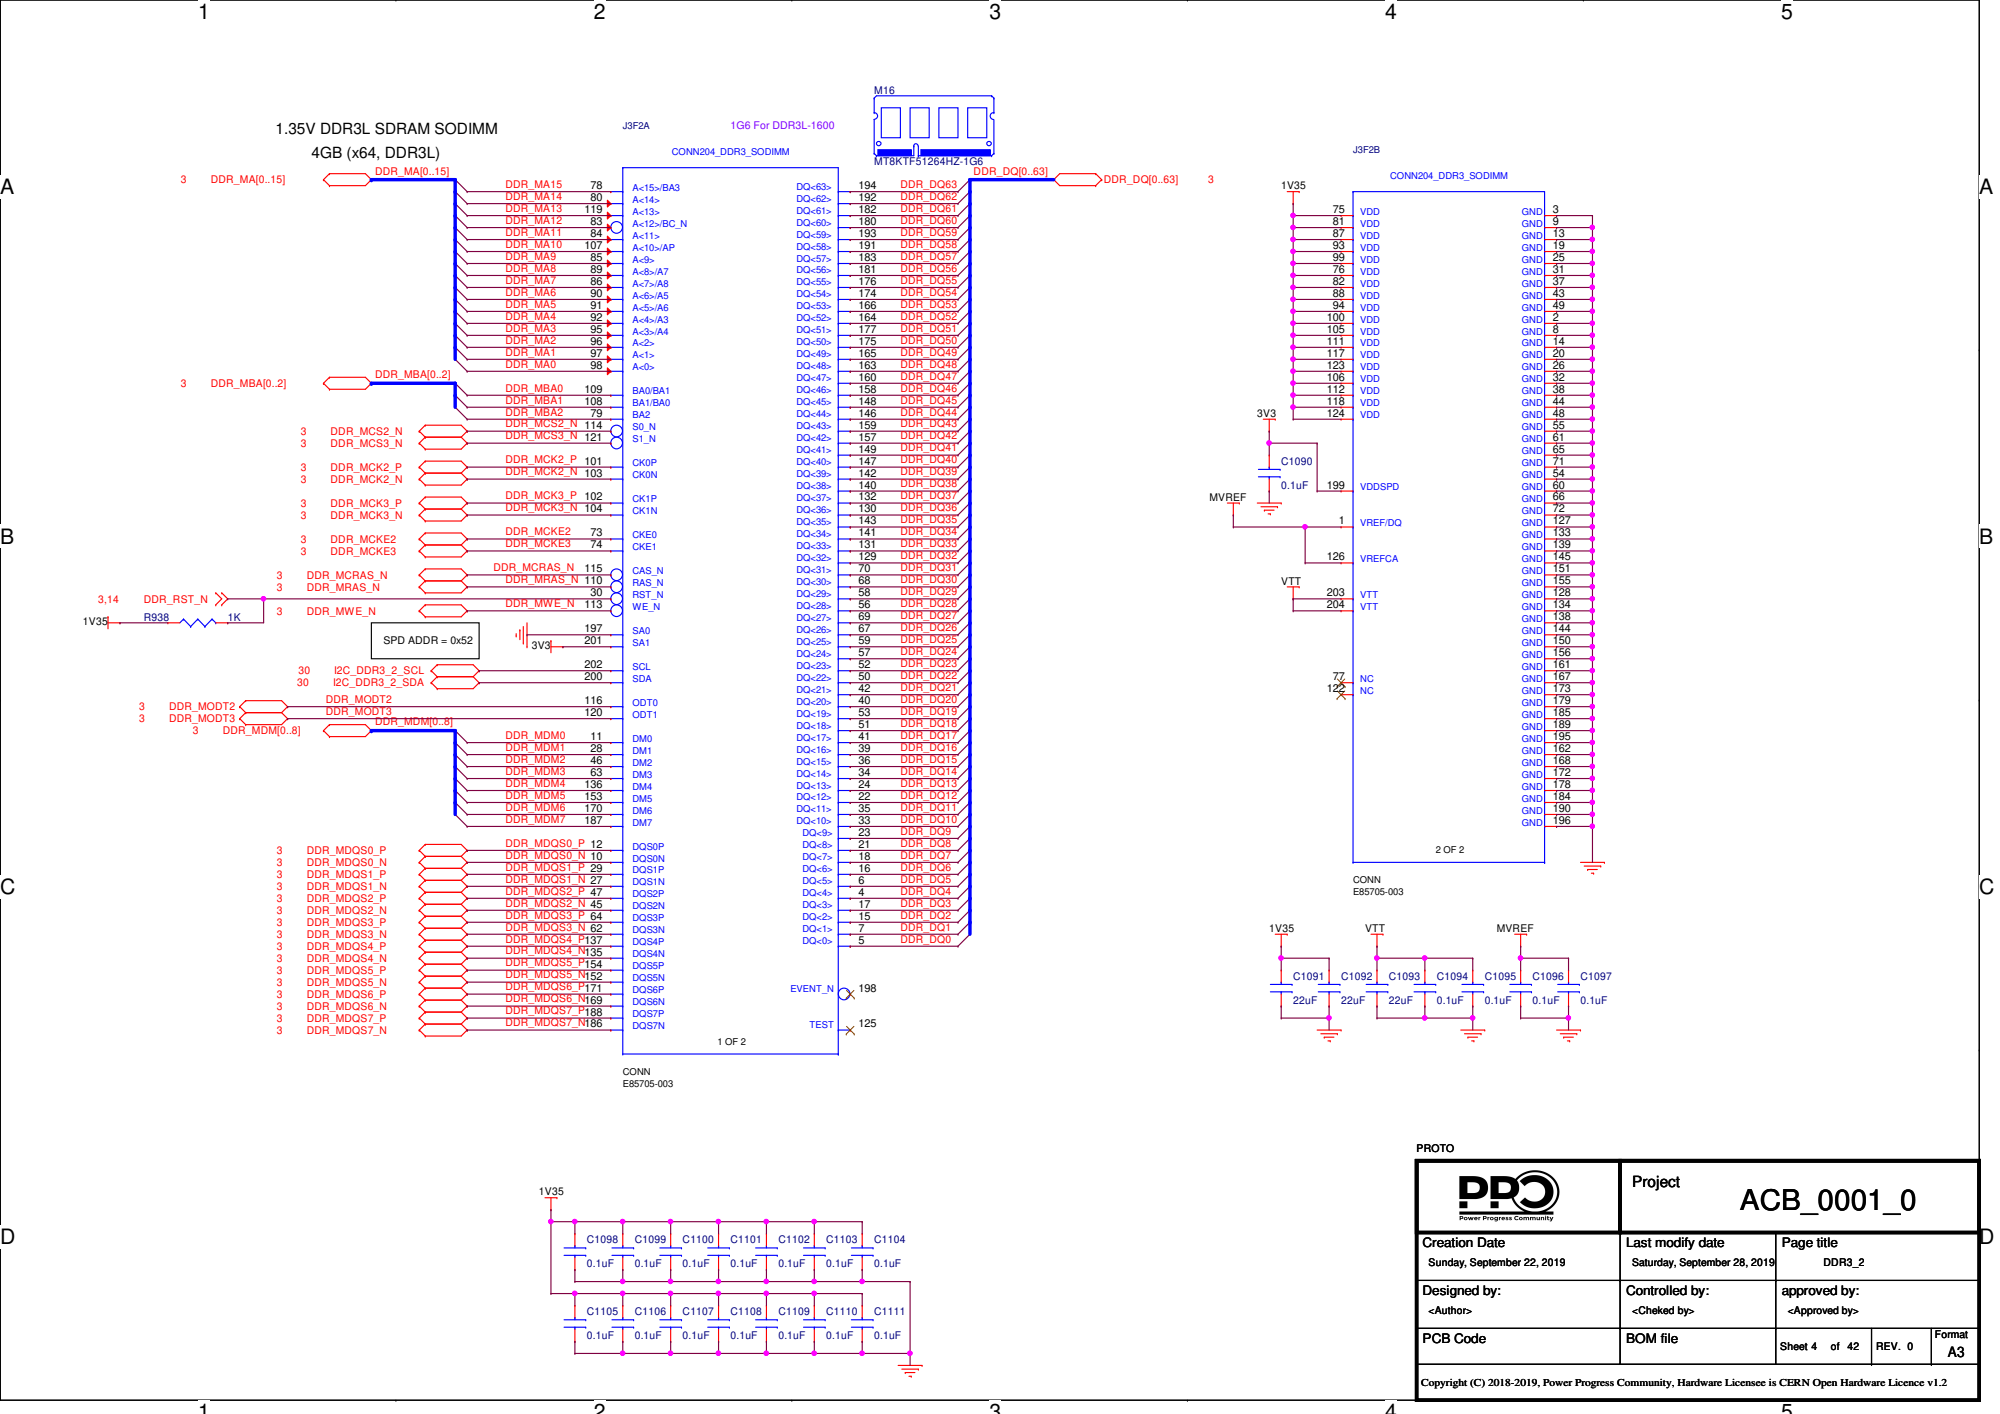
[picture p127: page 4]
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

# T2080 IFC INTERFACE

## T2080 RESET CONFIGURATION

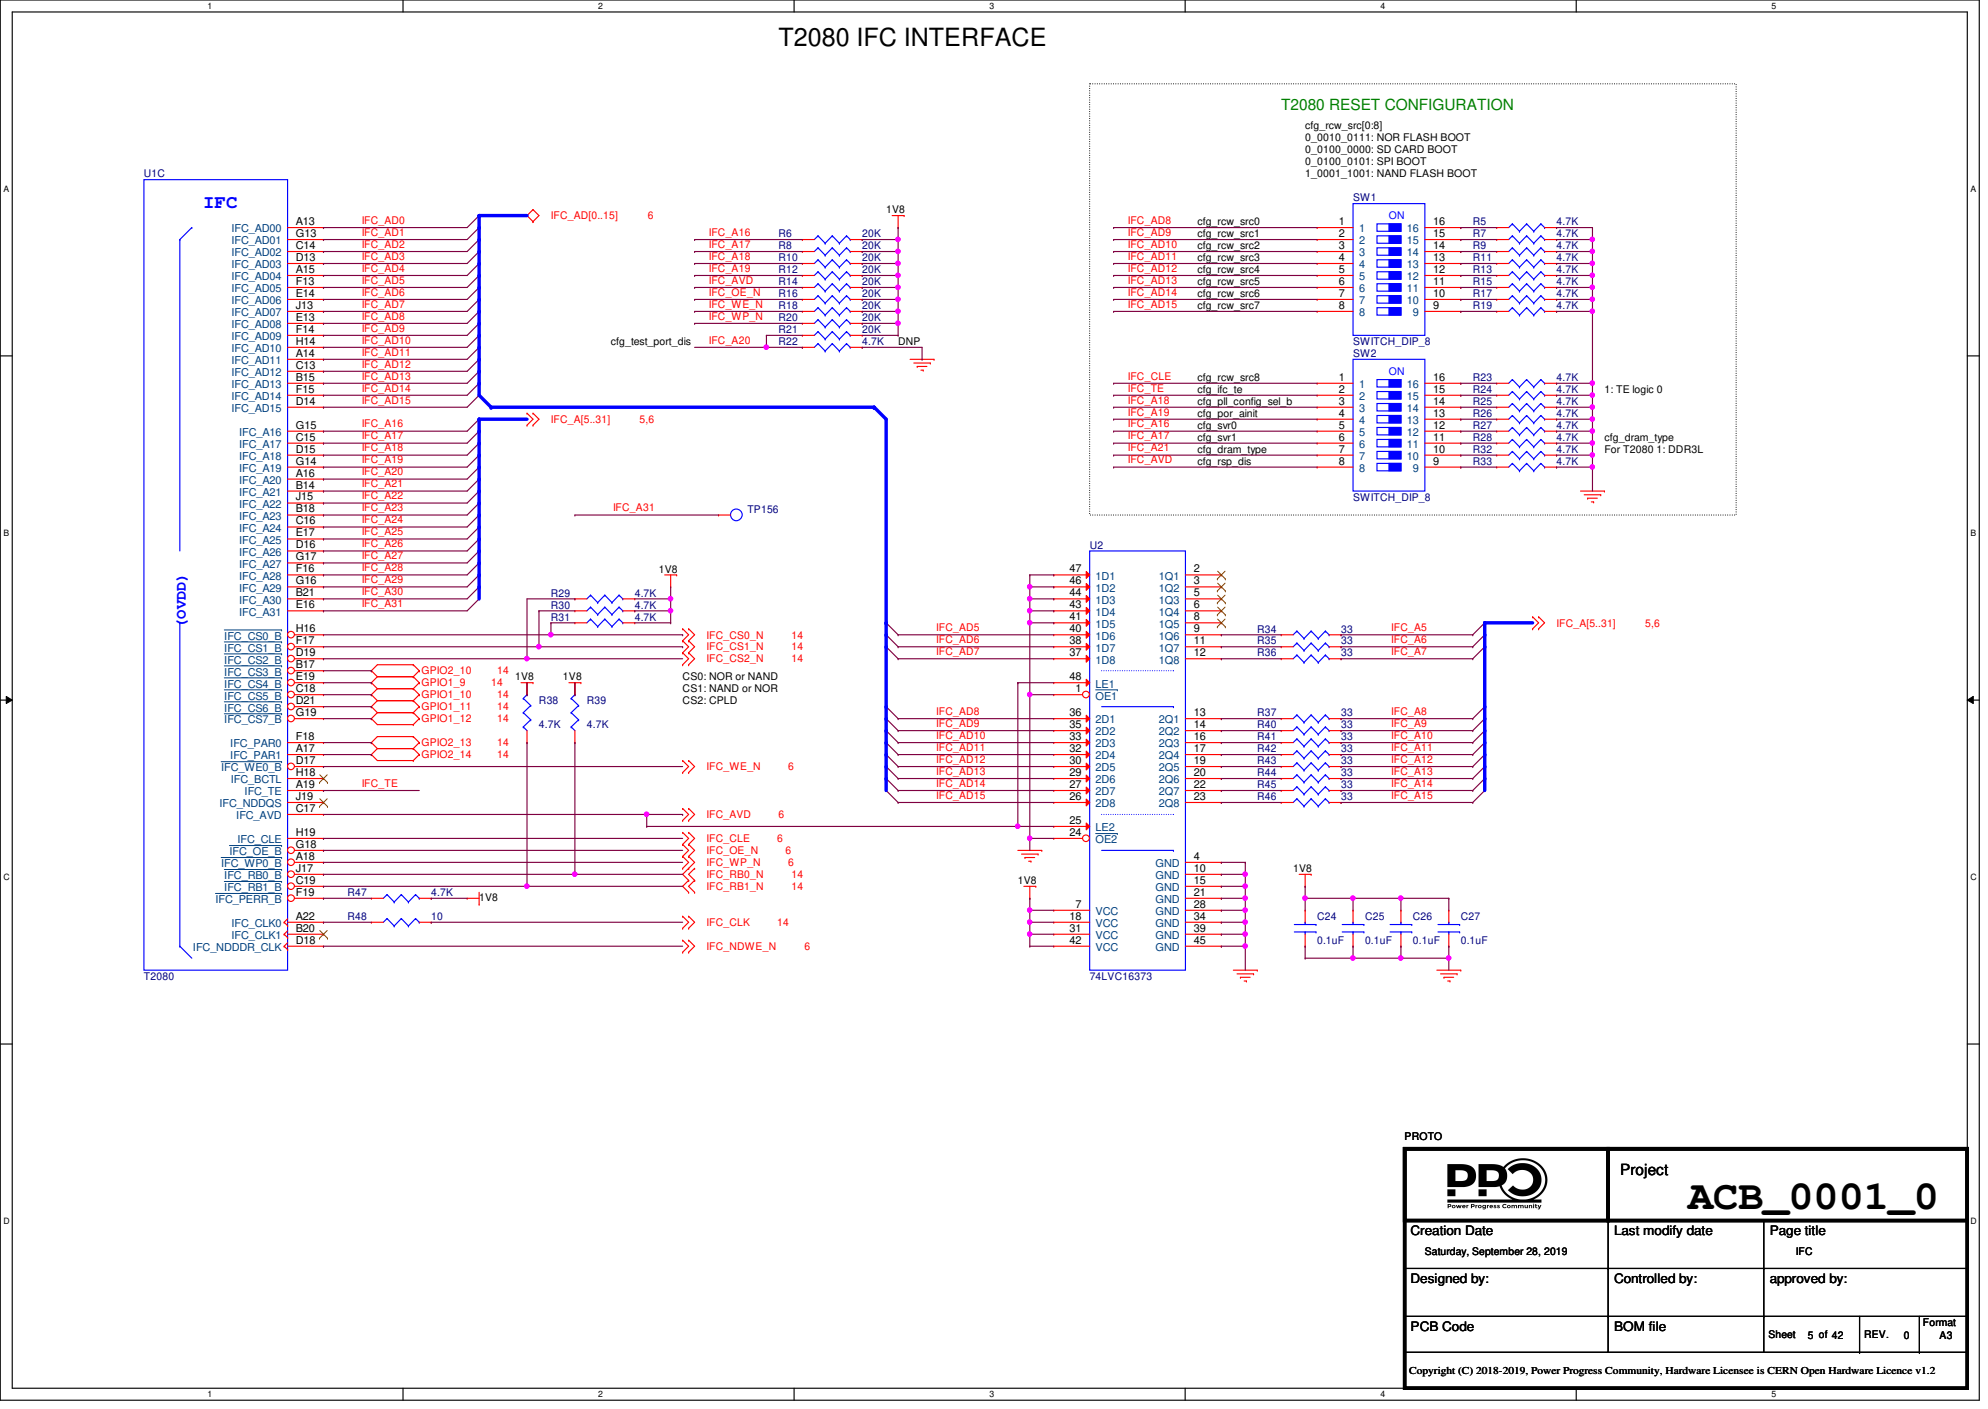
[picture p128: page 5]

## 128MB 16-BIT NOR FLASH

# T2080 NOR and NAND FLASH INTERFACE

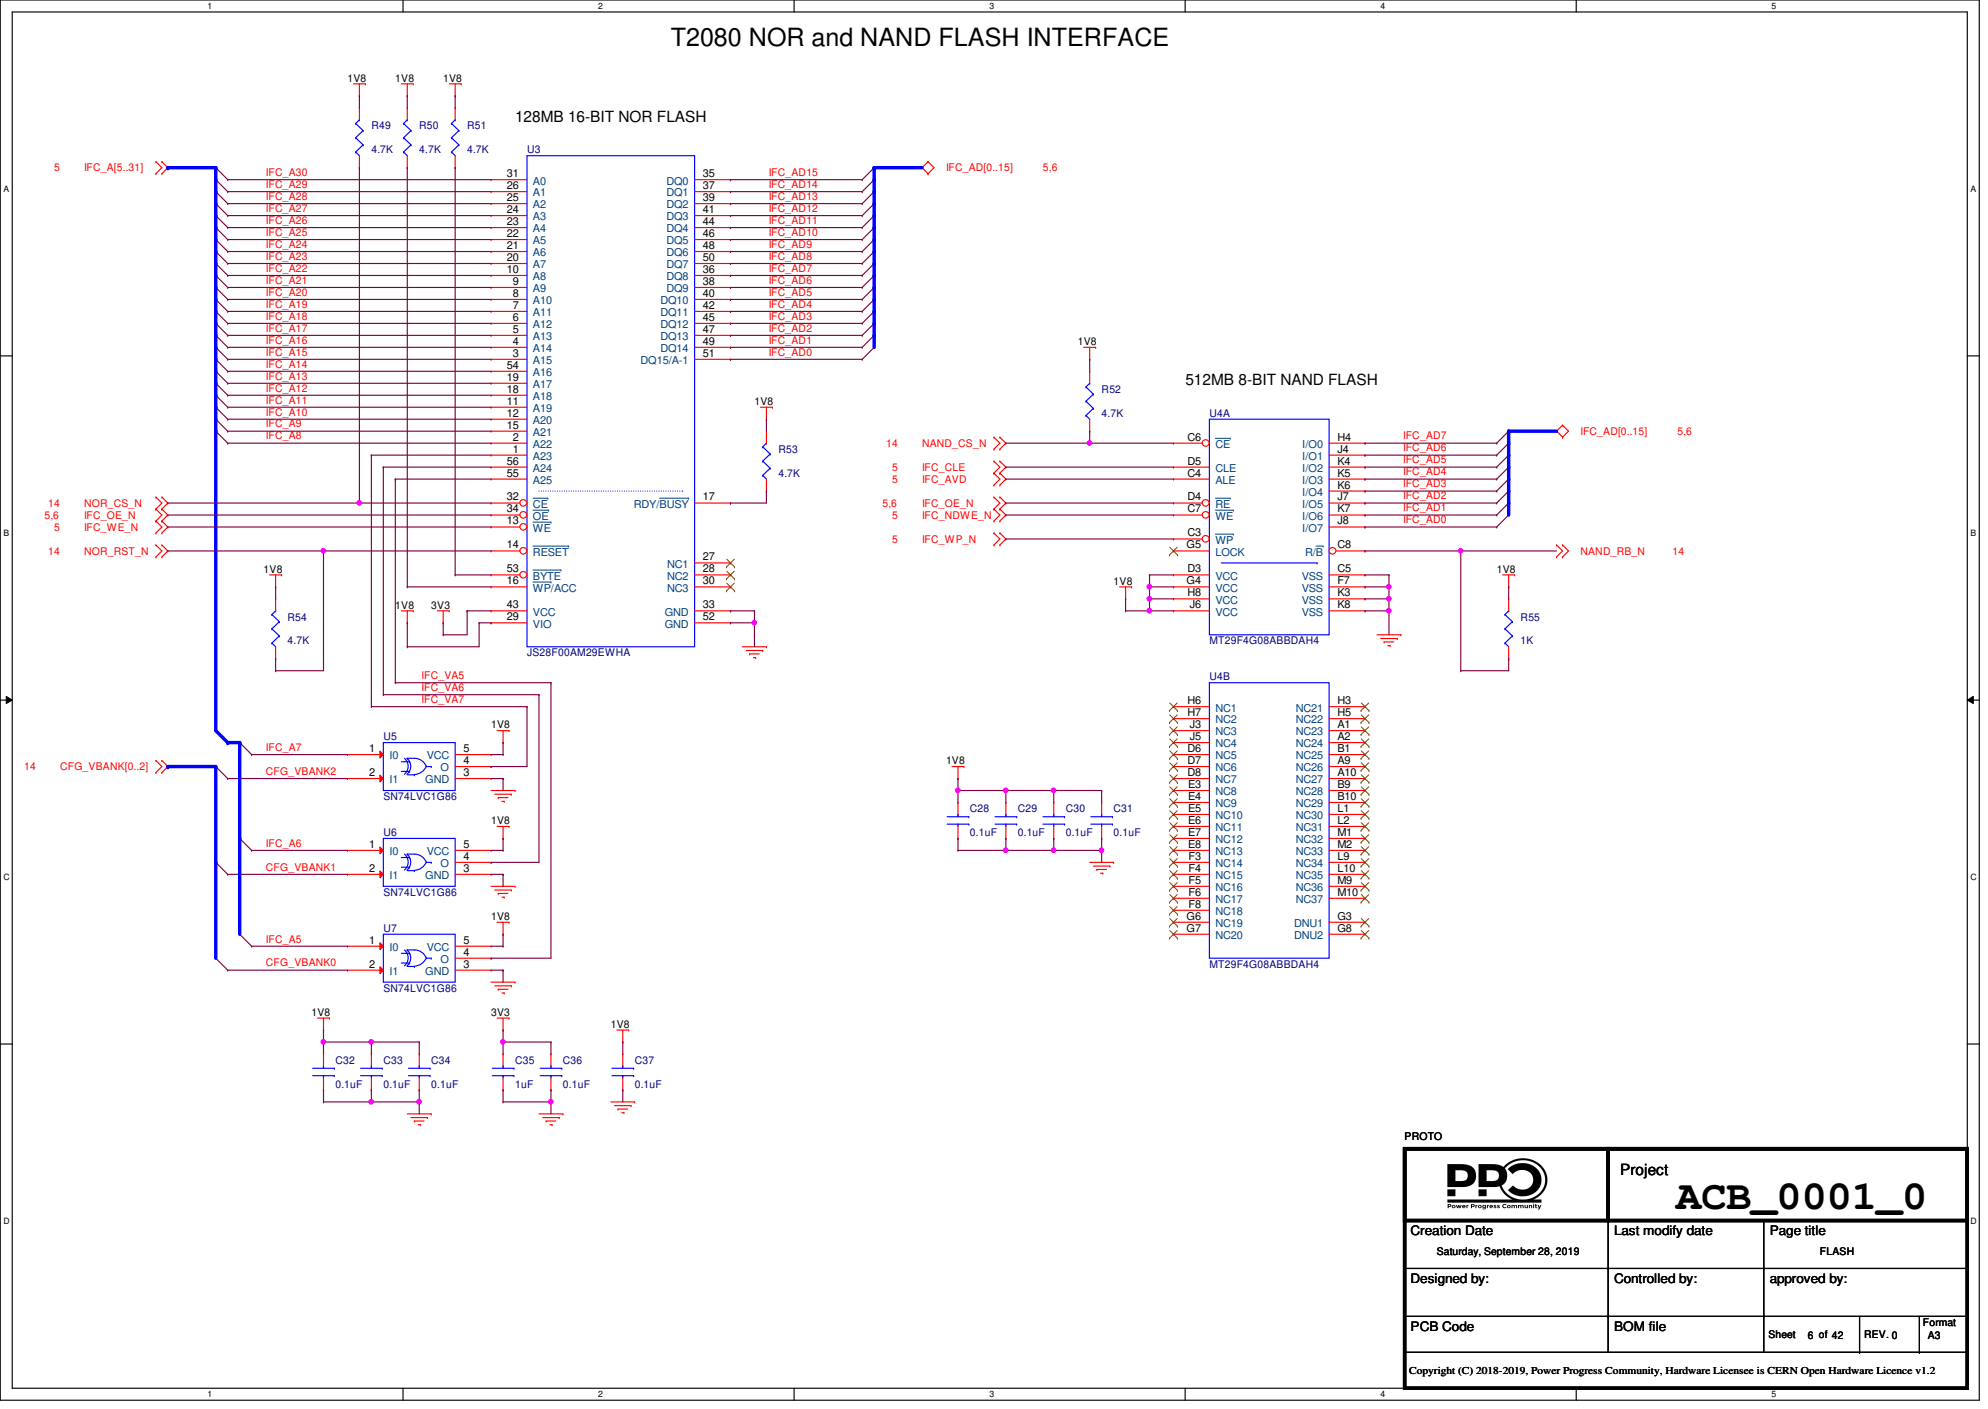
[picture p129: page 6]

## 64MB SERIAL FLASH

# T2080 SPI FLASH and SDHC INTERFACE

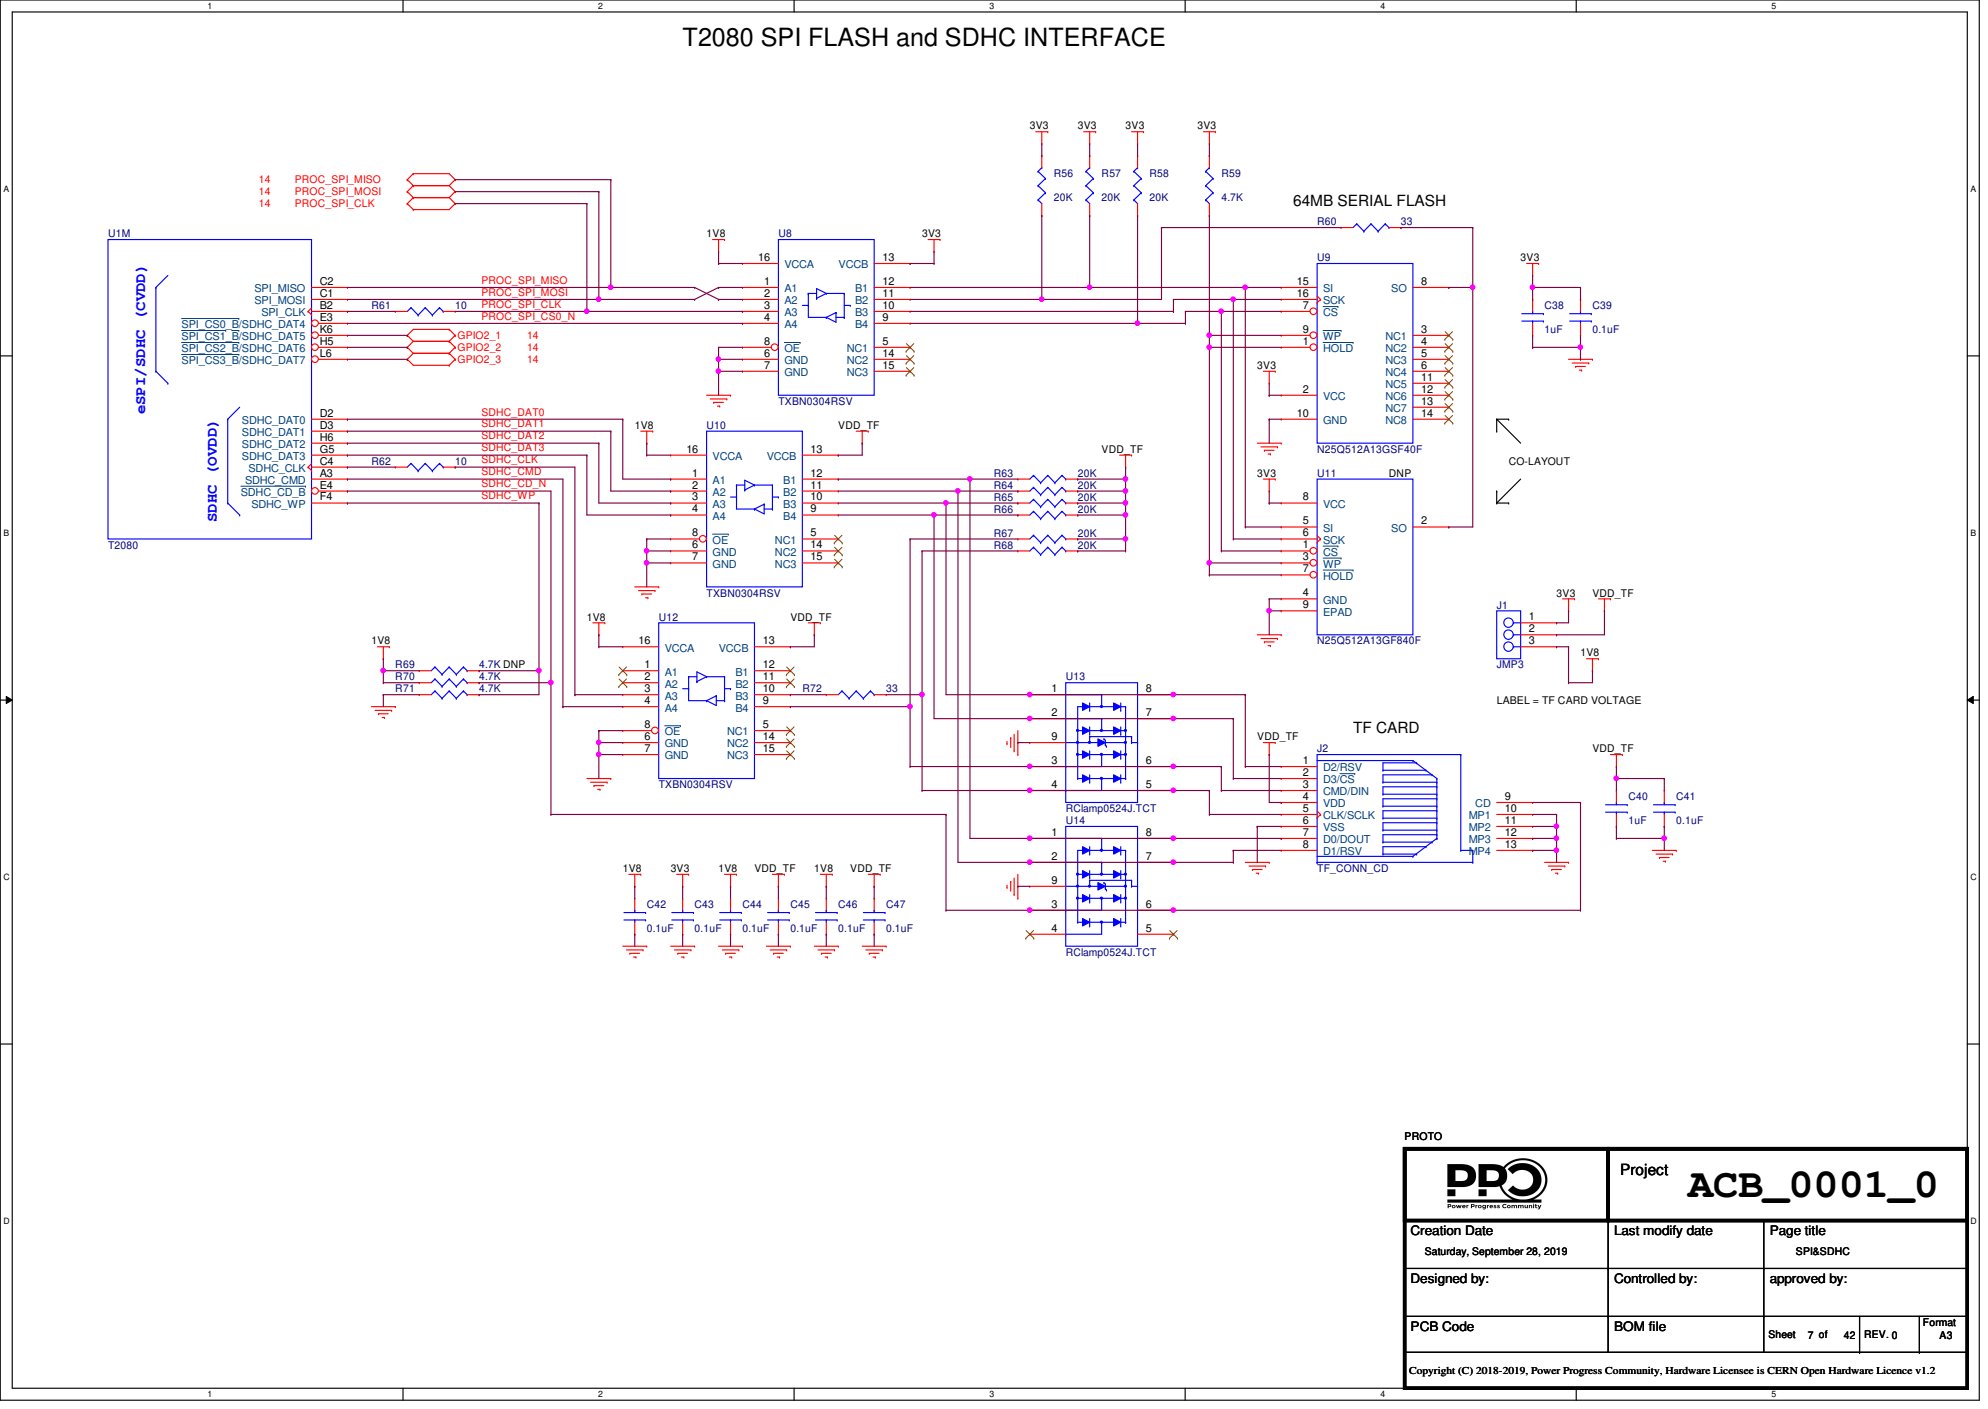
[picture p130: page 7]

LABEL = TF CARD VOLTAGE

D1/RSV 8

TF_CONN_CD 6

# T2080 SYSTEM LOGIC INTERFACE

# CNTR & MISC

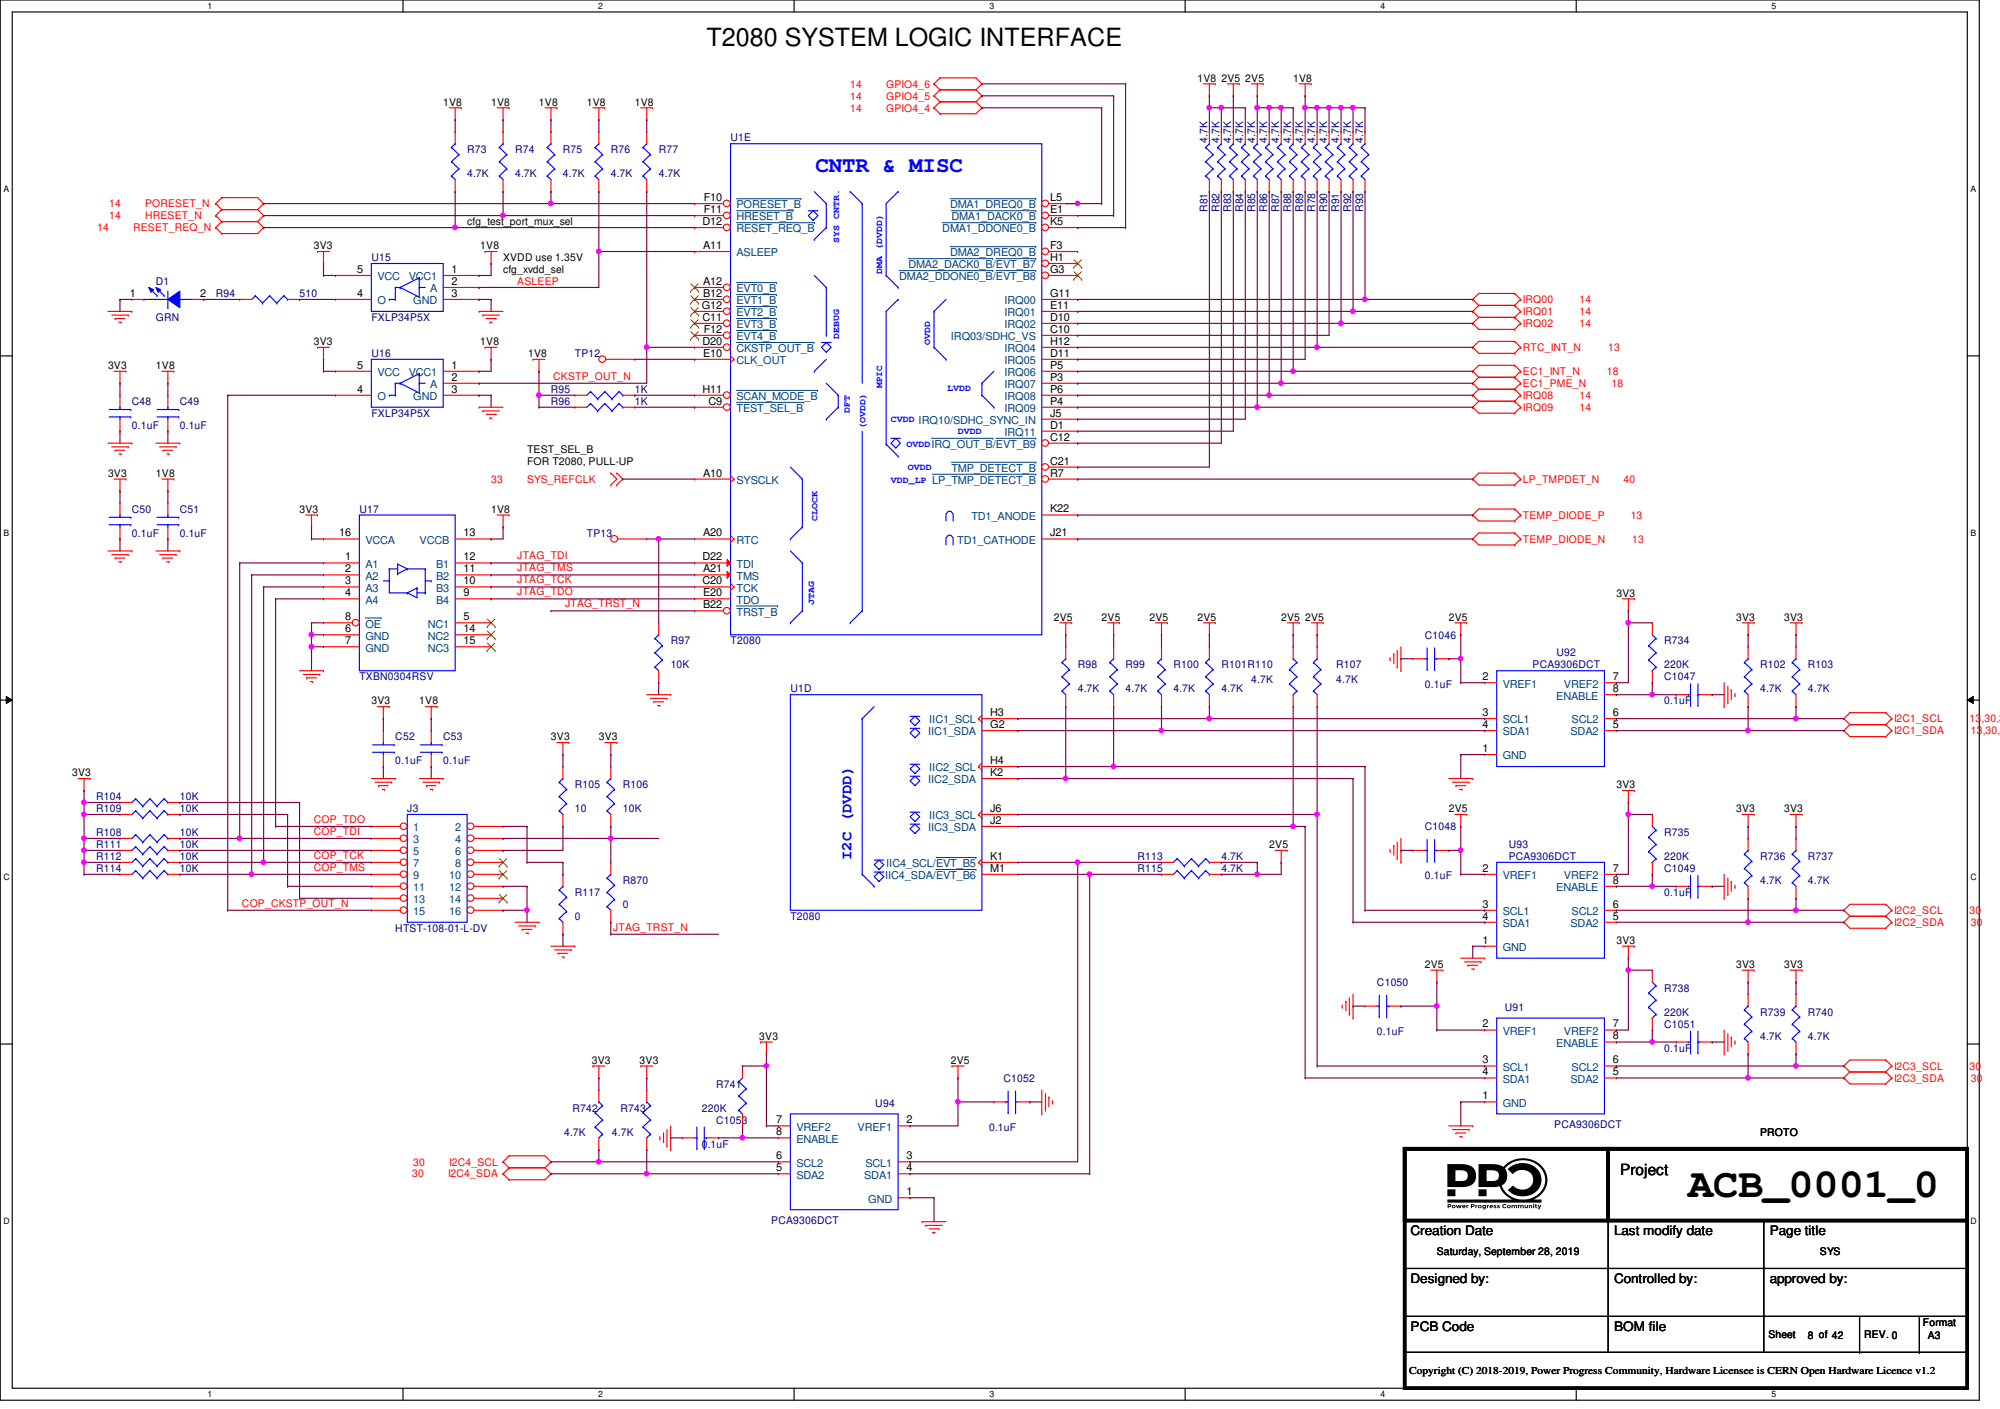
[picture p131: page 8]

COP_TCK
COP_TMS

# T2080 ETHERNET and SERDES INTERFACE

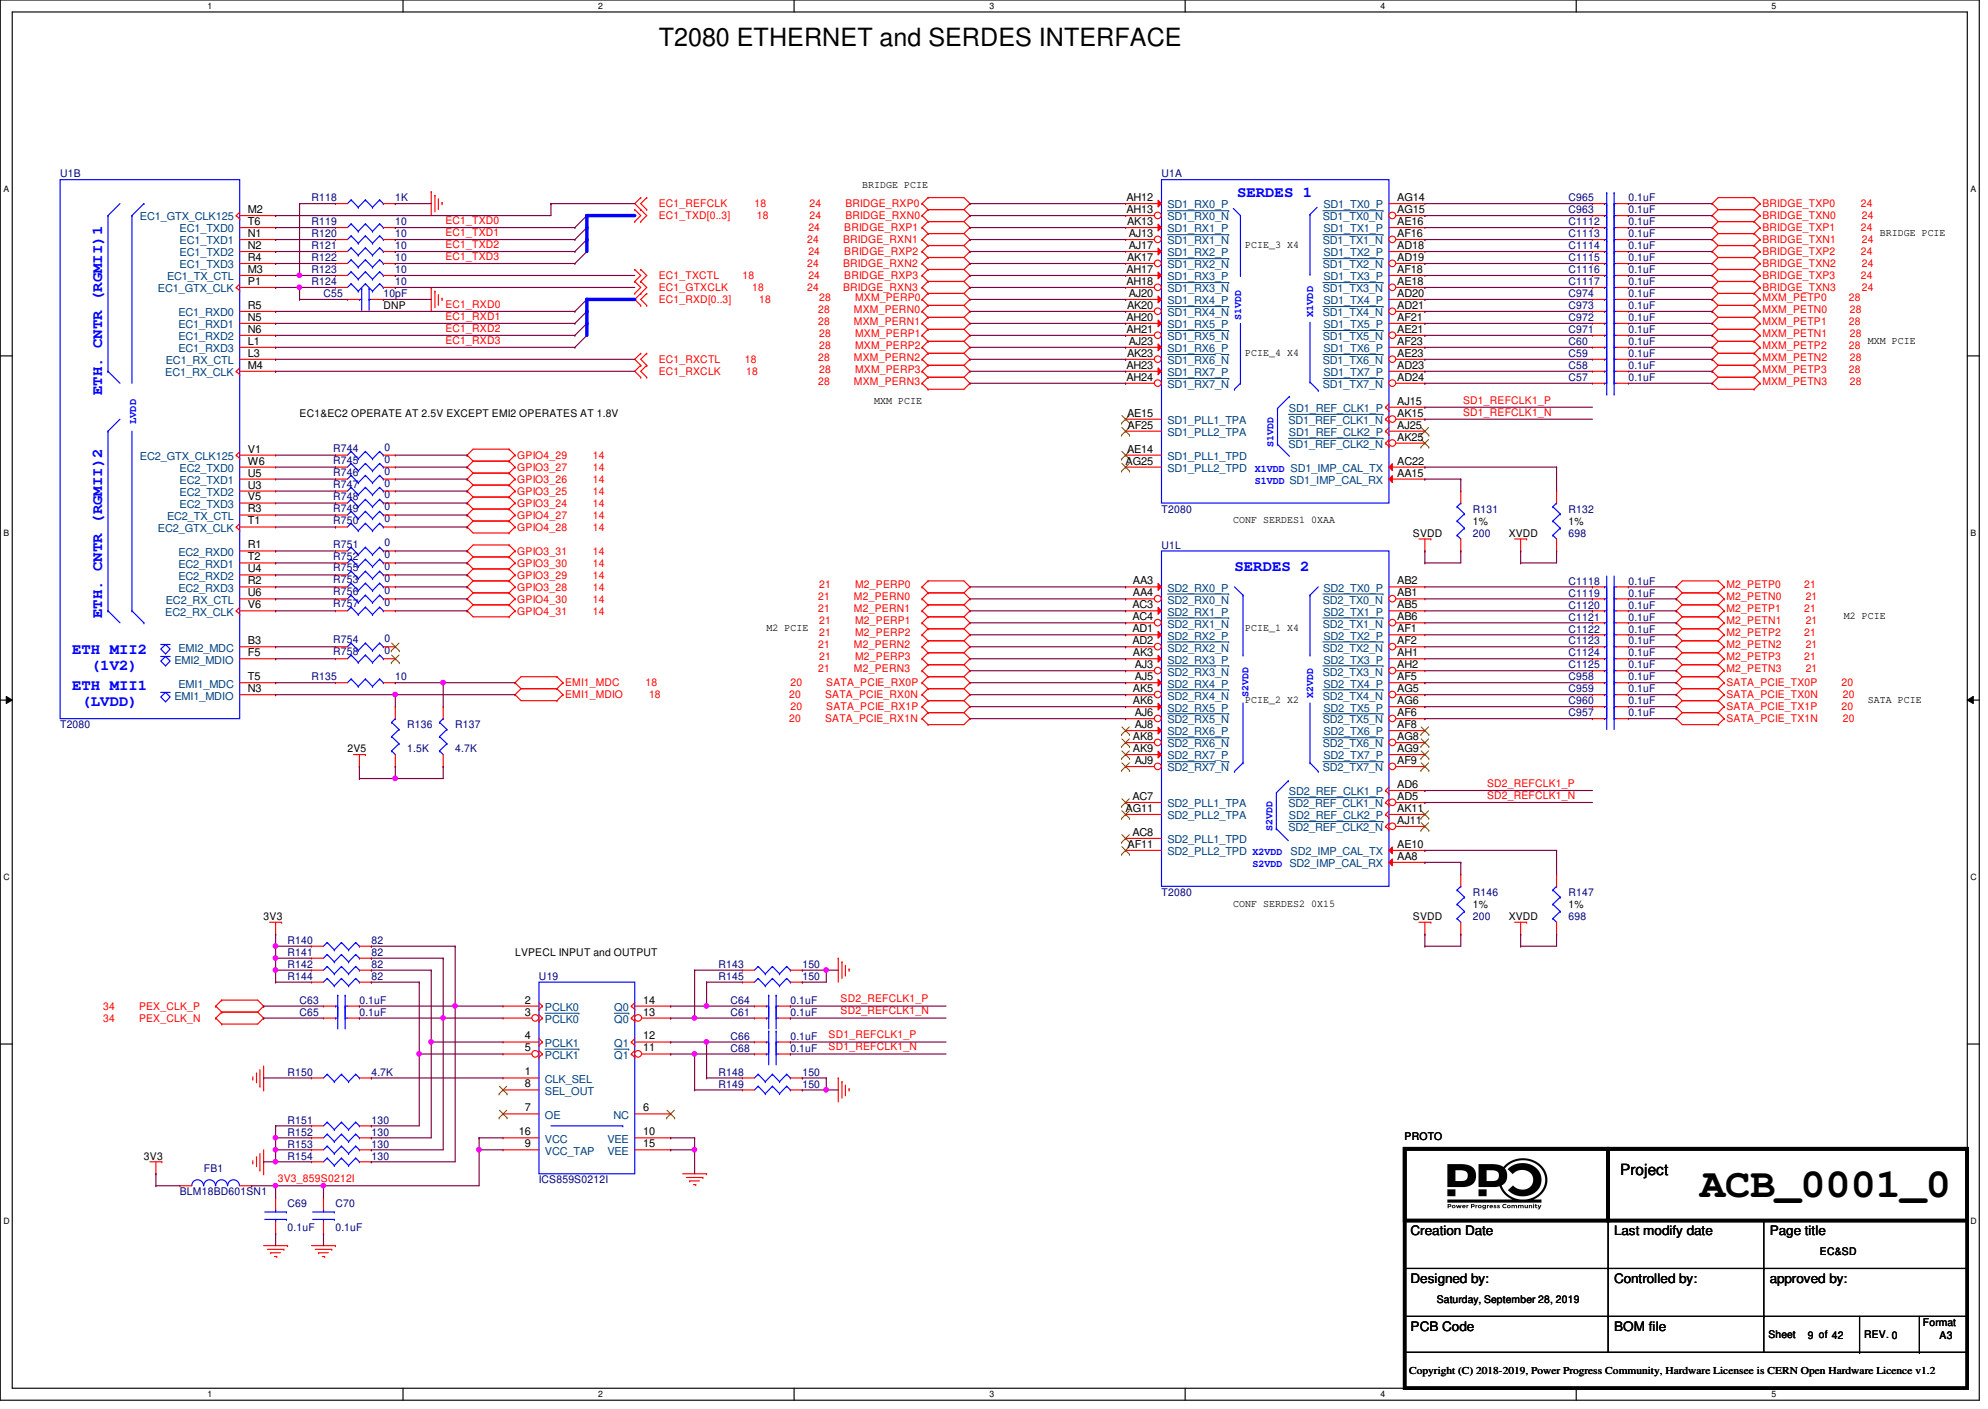
[picture p132: page 9]

ETH. CNTR (RGMII)1 ETH. CNTR (RGMII)2

EC1&EC2 OPERATE AT 2.5V EXCEPT EMI2 OPERATES AT 1.8V

LVPECL INPUT and OUTPUT

# T2080 USB INTERFACE

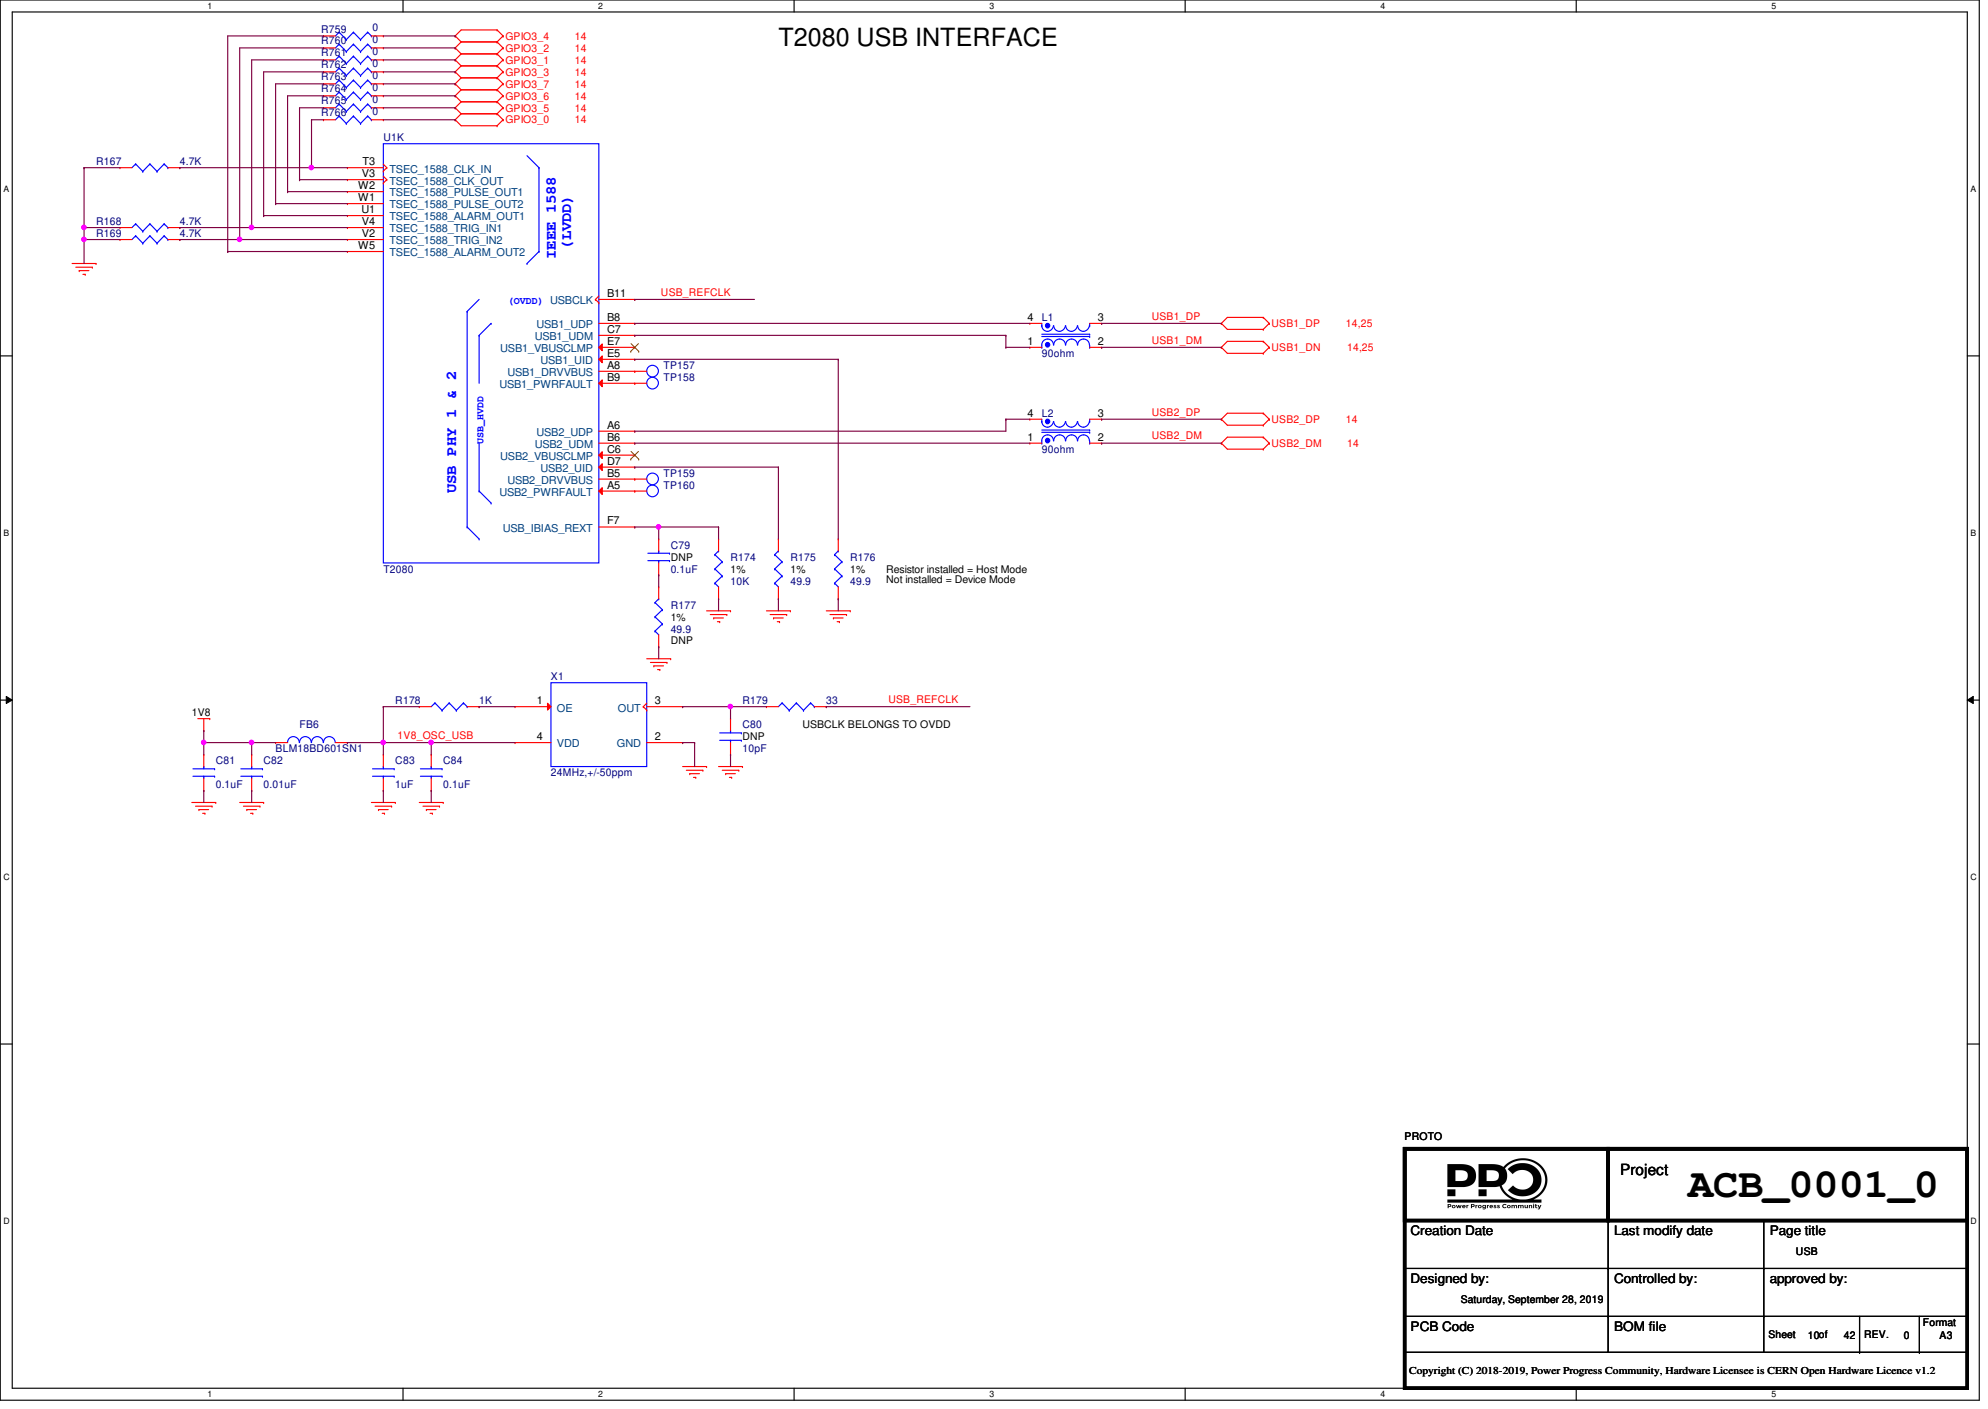
[picture p133: page 10]

Resistor installed = Host Mode
Not installed = Device Mode

USBCLK BELONGS TO OVDD

A | A

SK5126

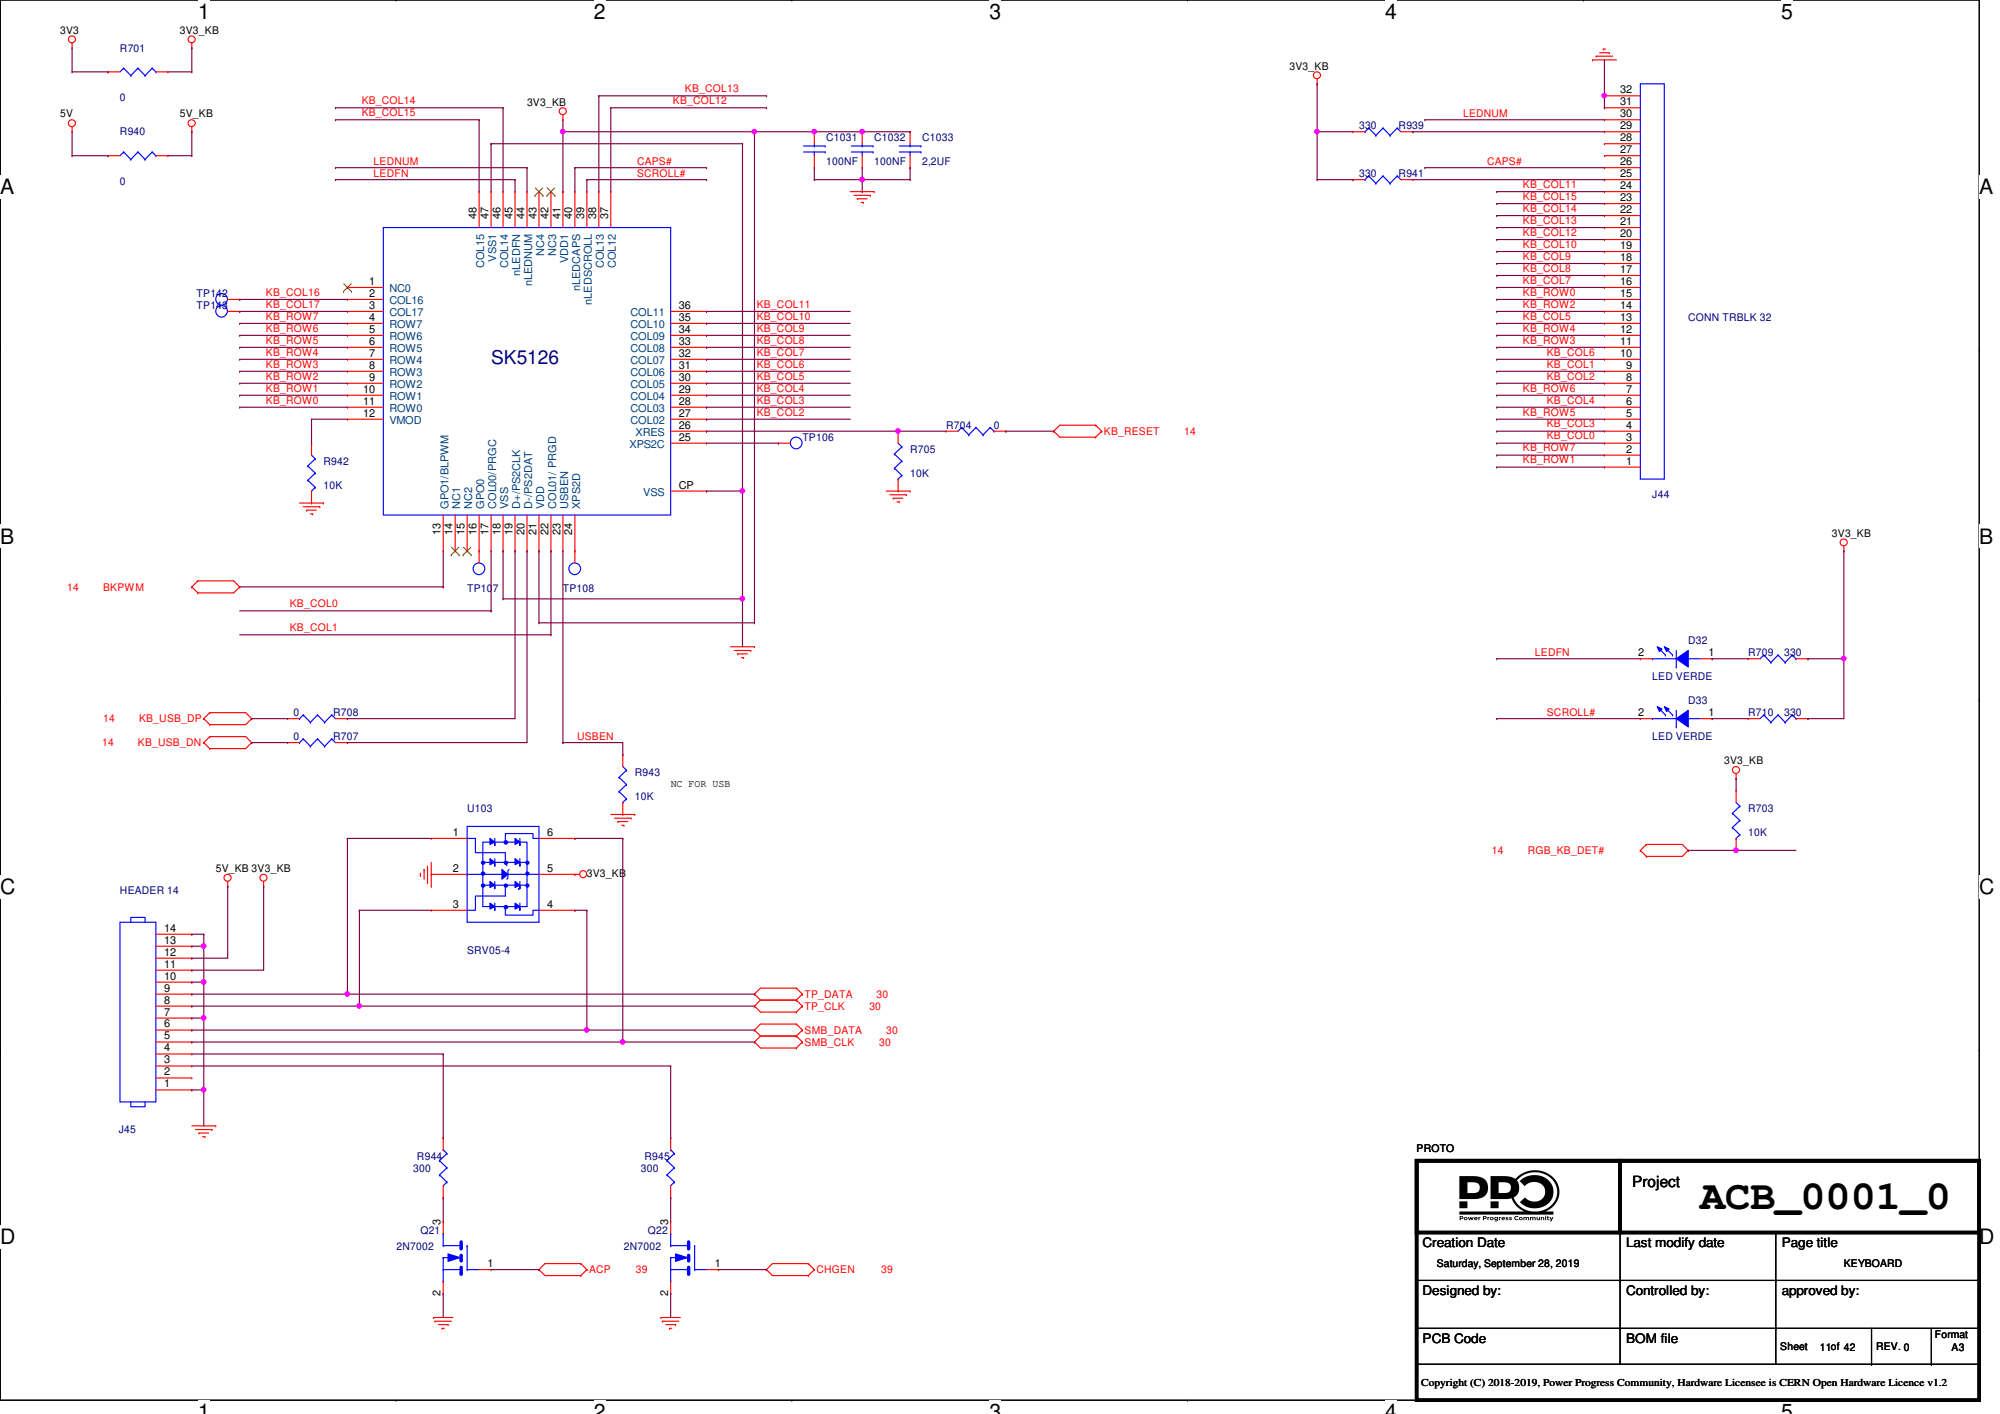
[picture p134: page 11]

A | A

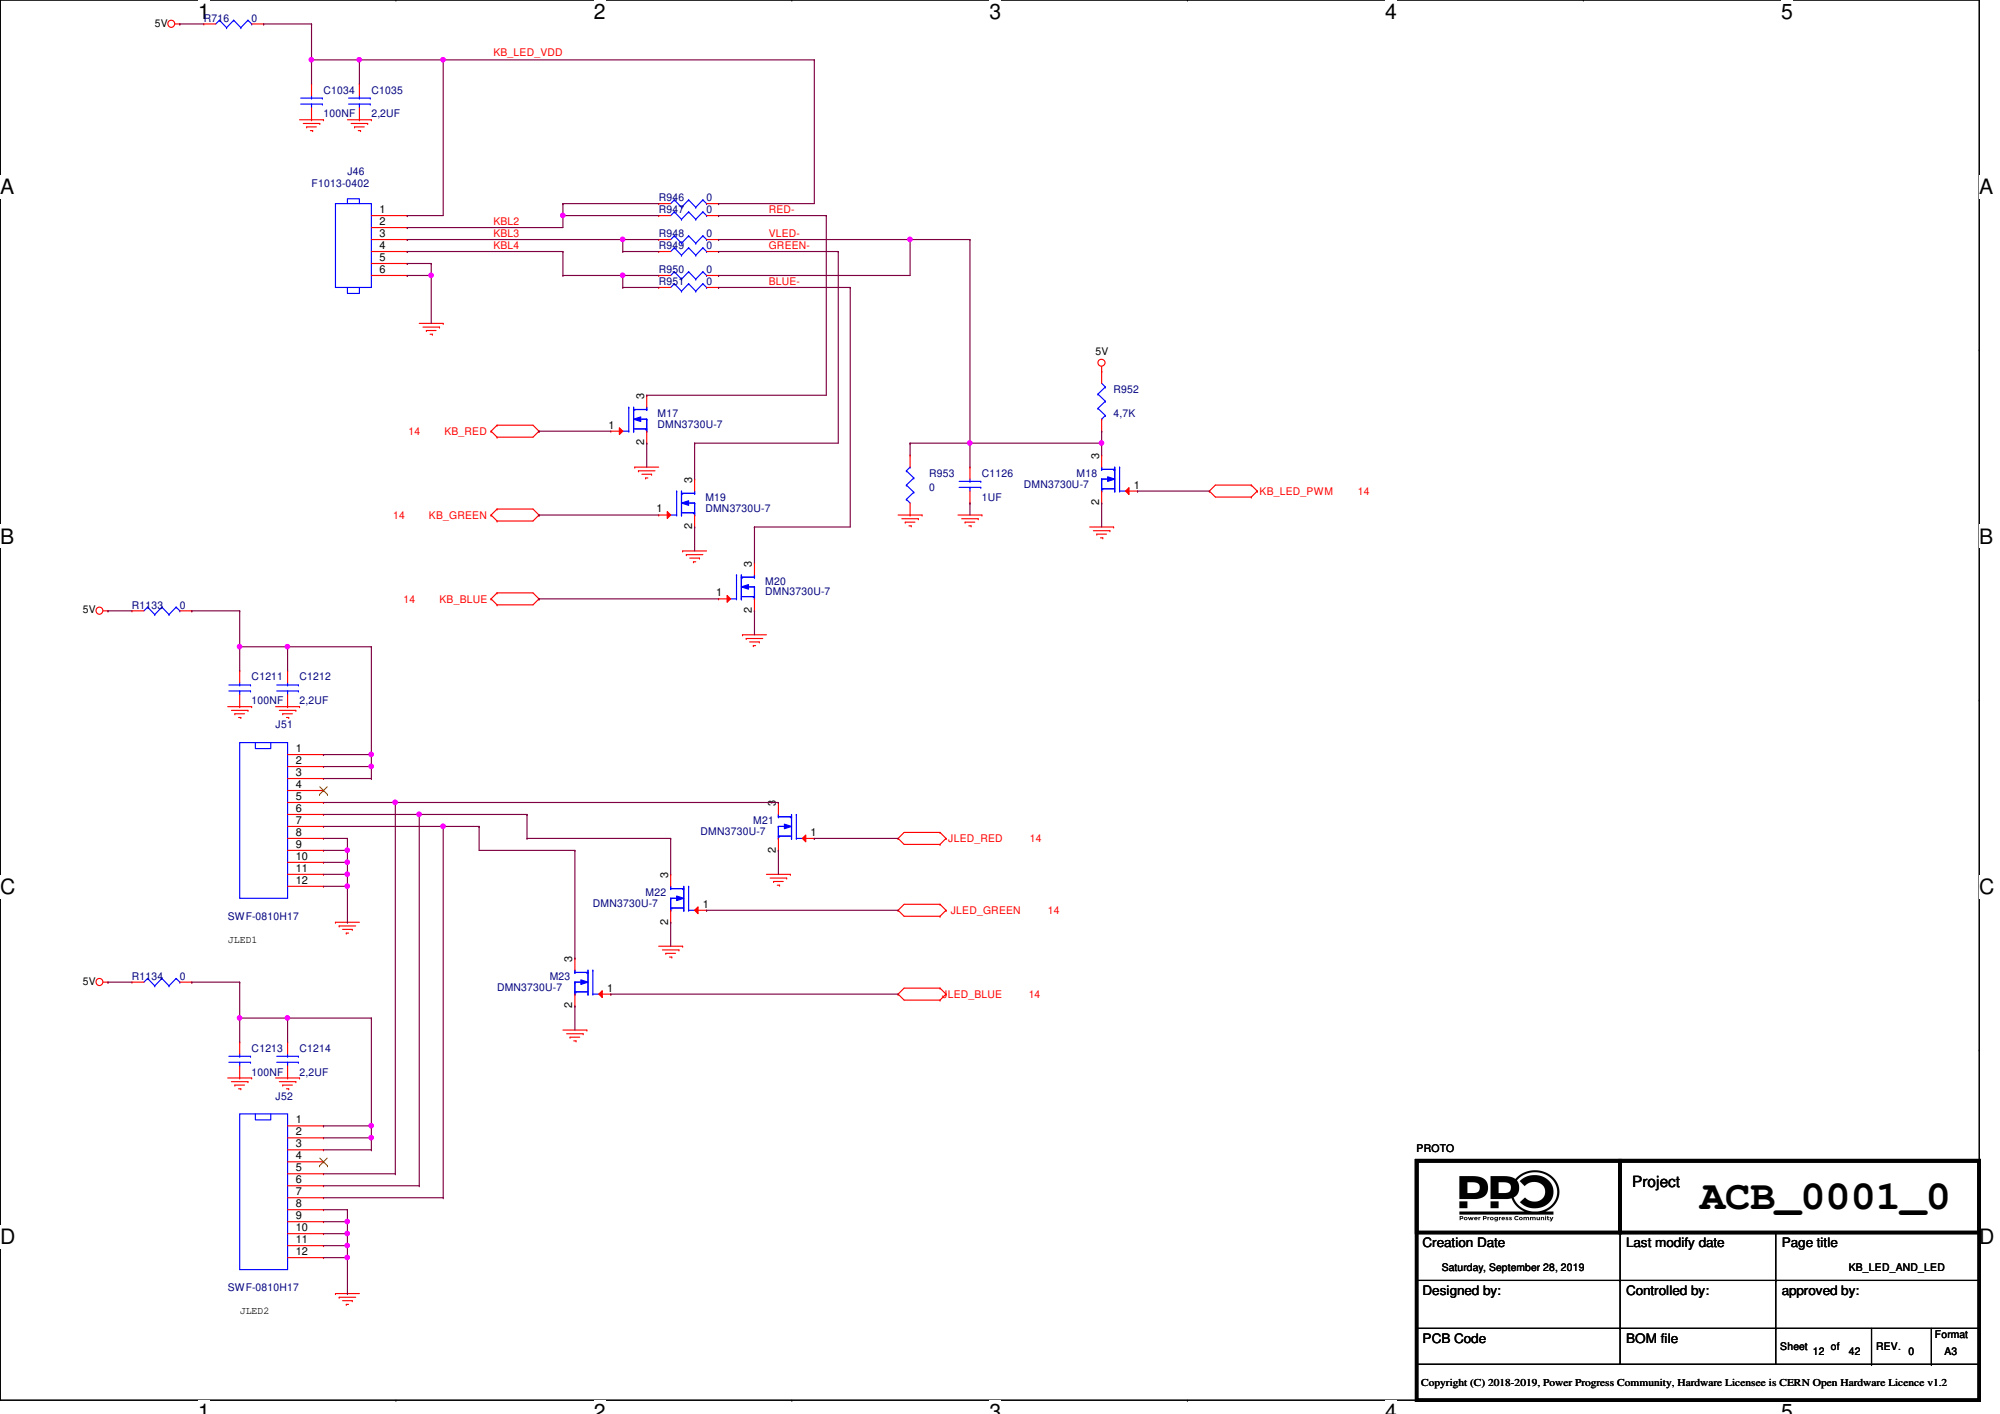
[picture p135: page 12]

# T2080 DUART and I2C DEVICE INTERFACE

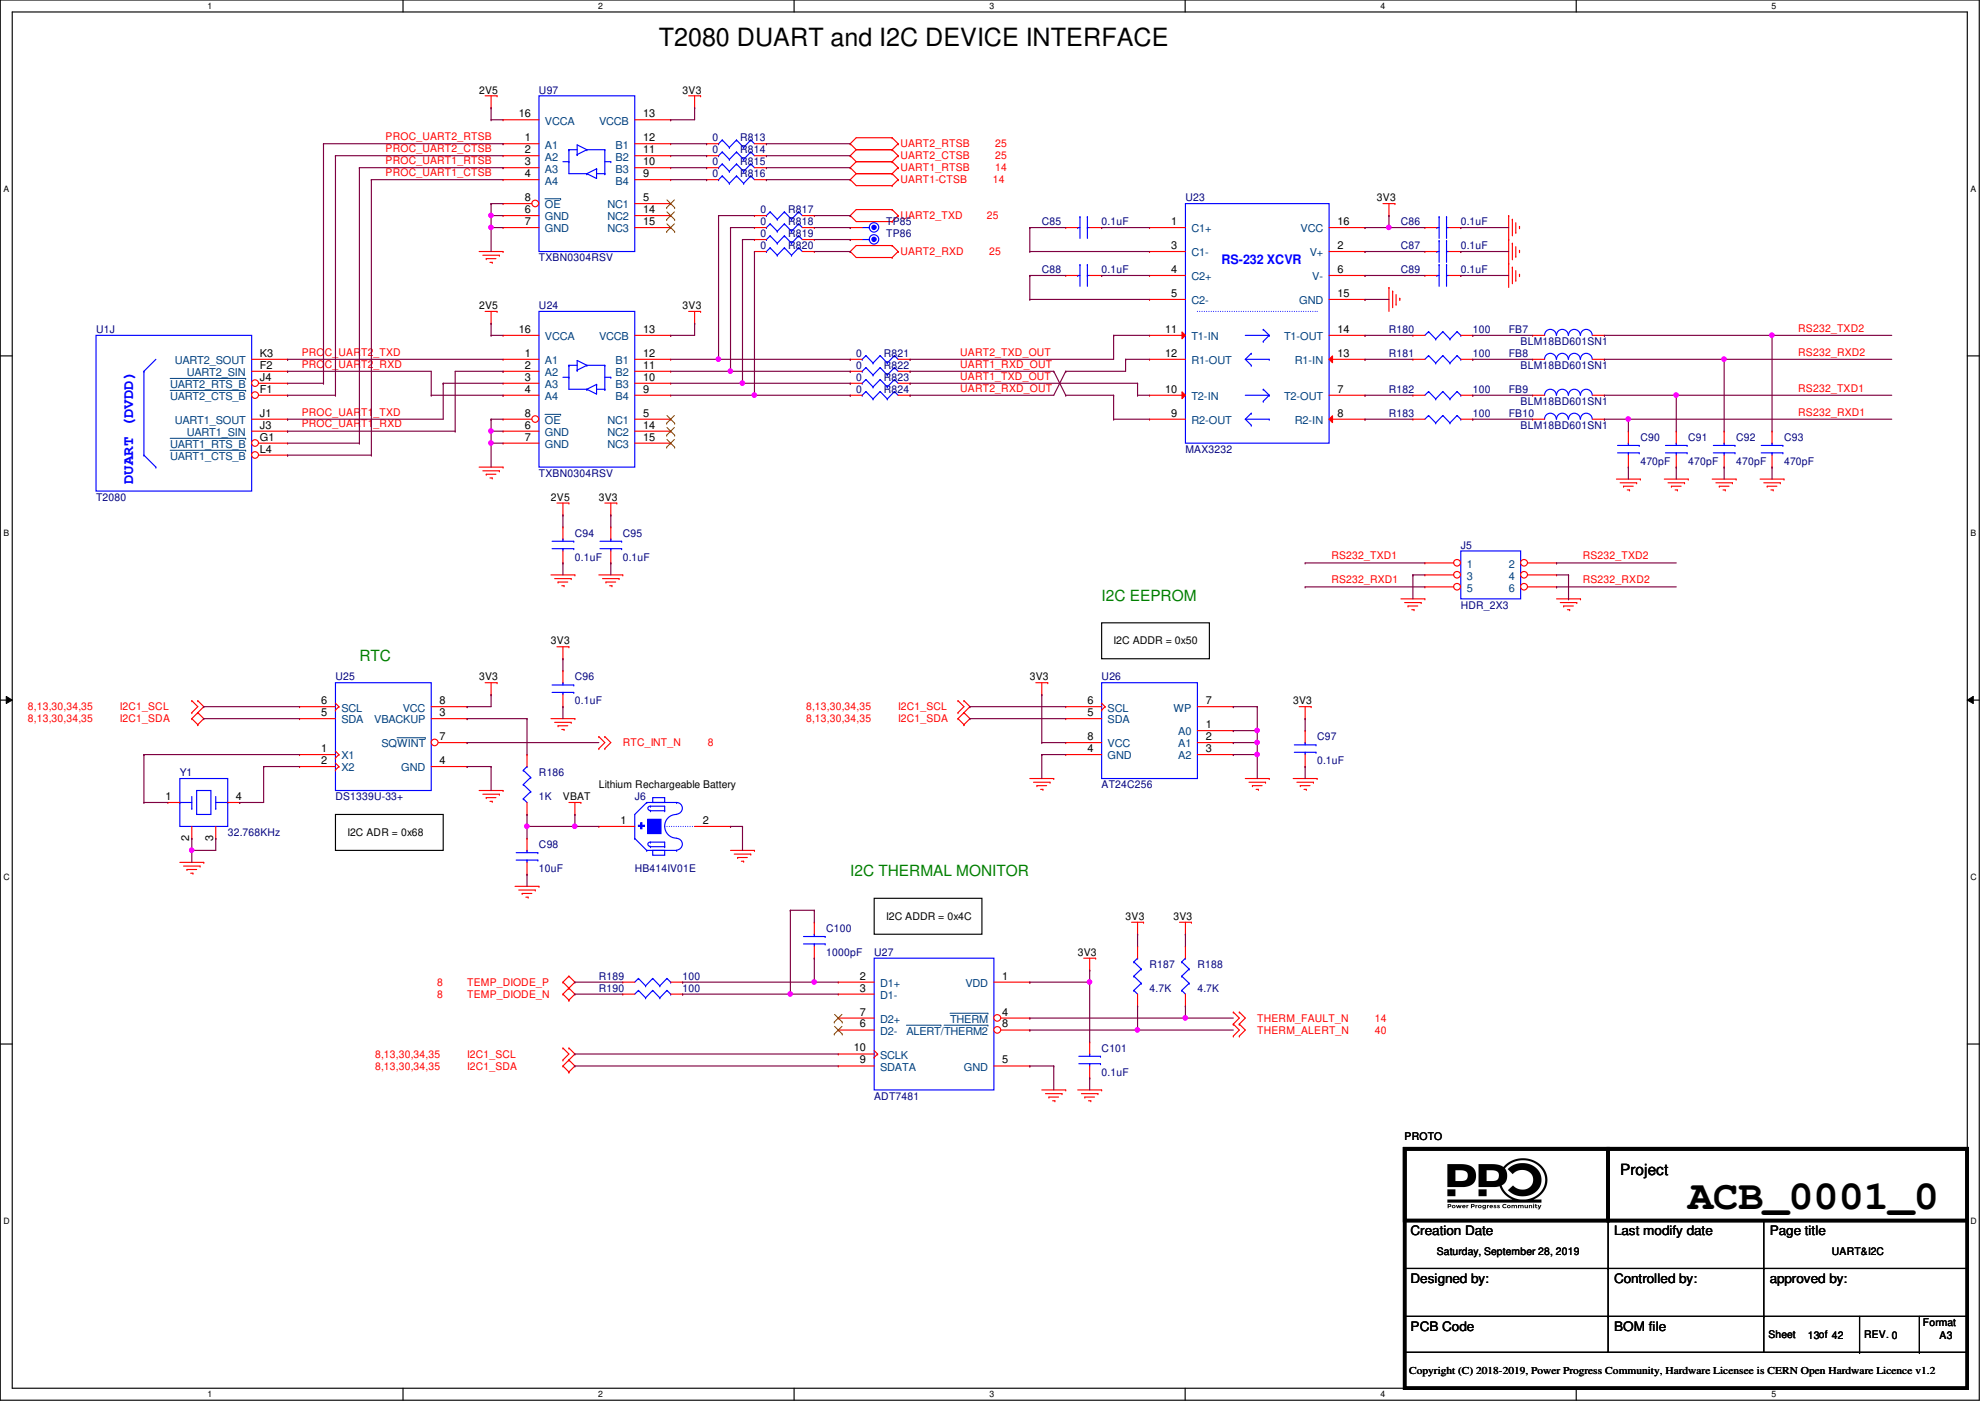
[picture p136: page 13]

A

A

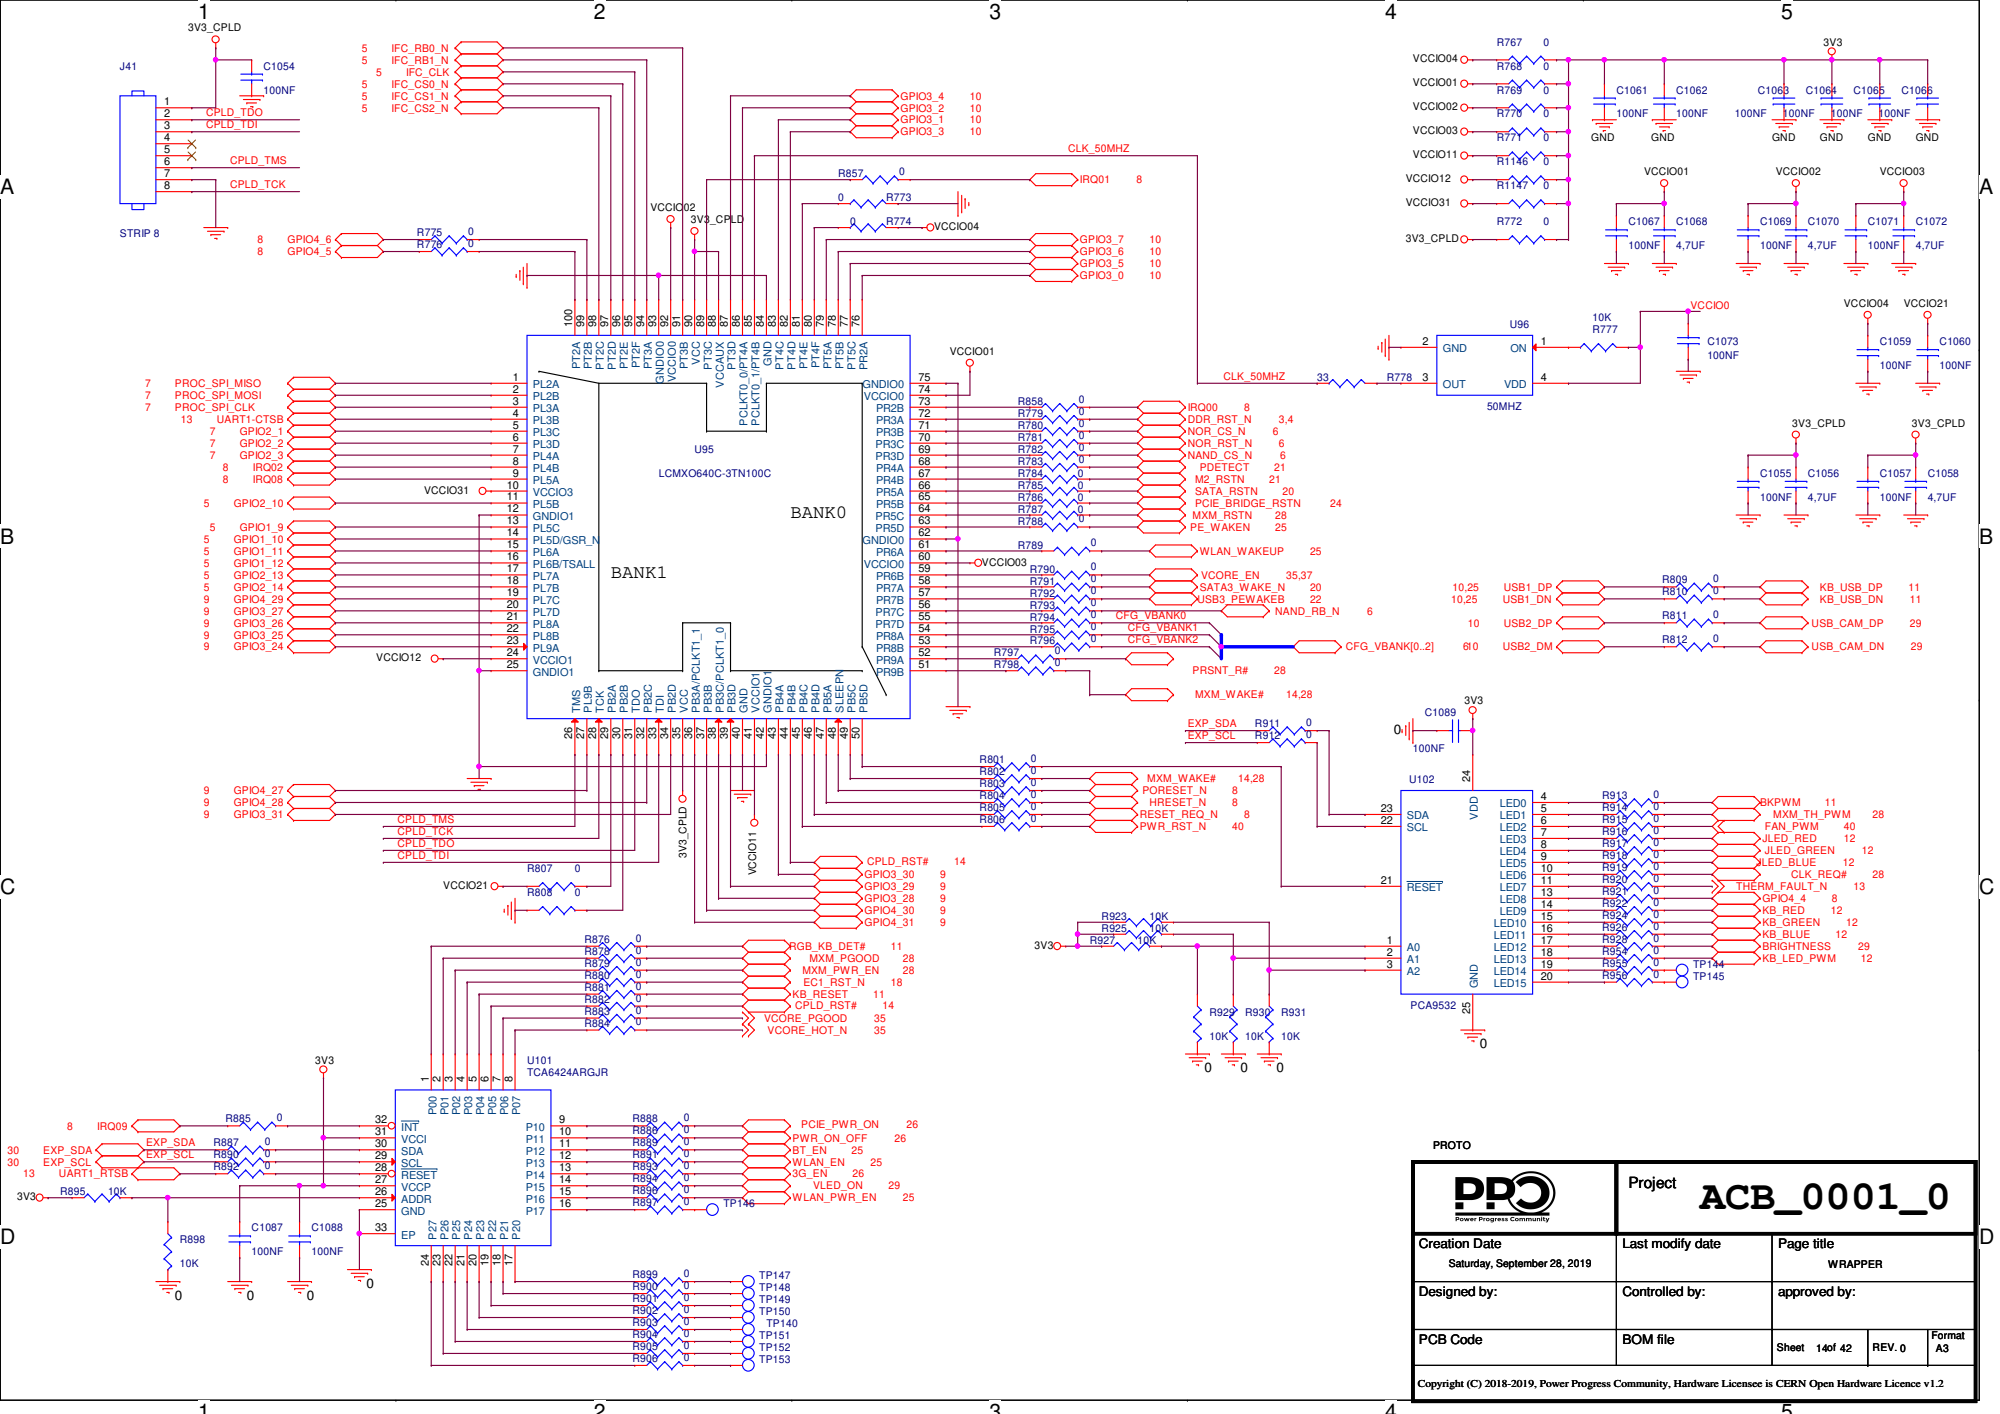
[picture p137: page 14]

# T2080 POWER SUPPLY

PS

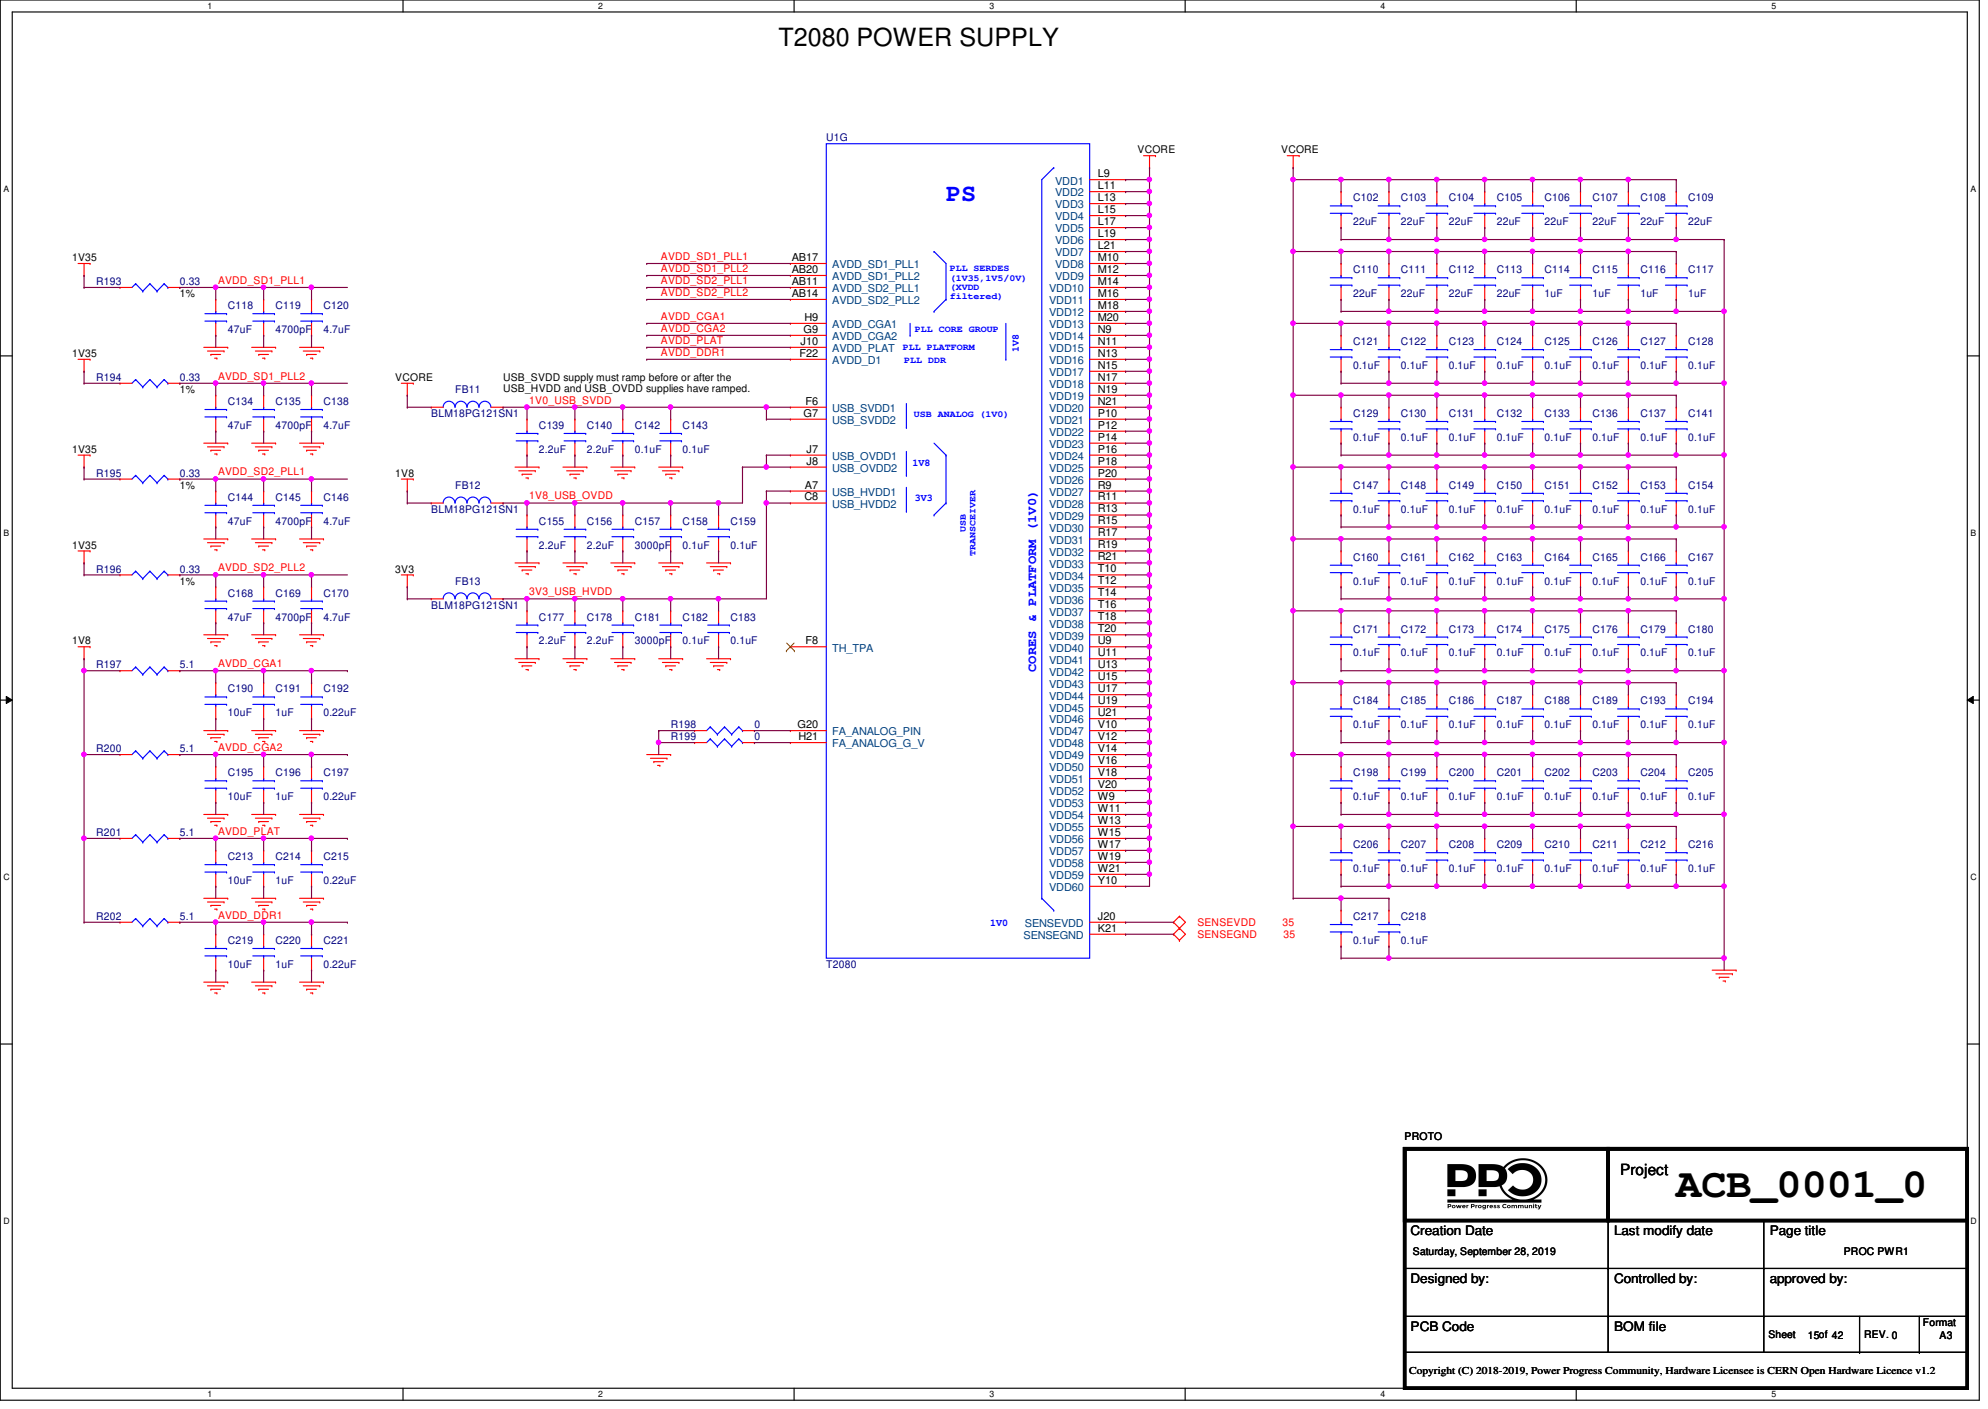
[picture p138: page 15]

USB_SVDD supply must ramp before or after the
USB_HVDD and USB_OVDD supplies have ramped.
1V0_USB_SVDD

# T2080 POWER SUPPLY (cont.)

PS

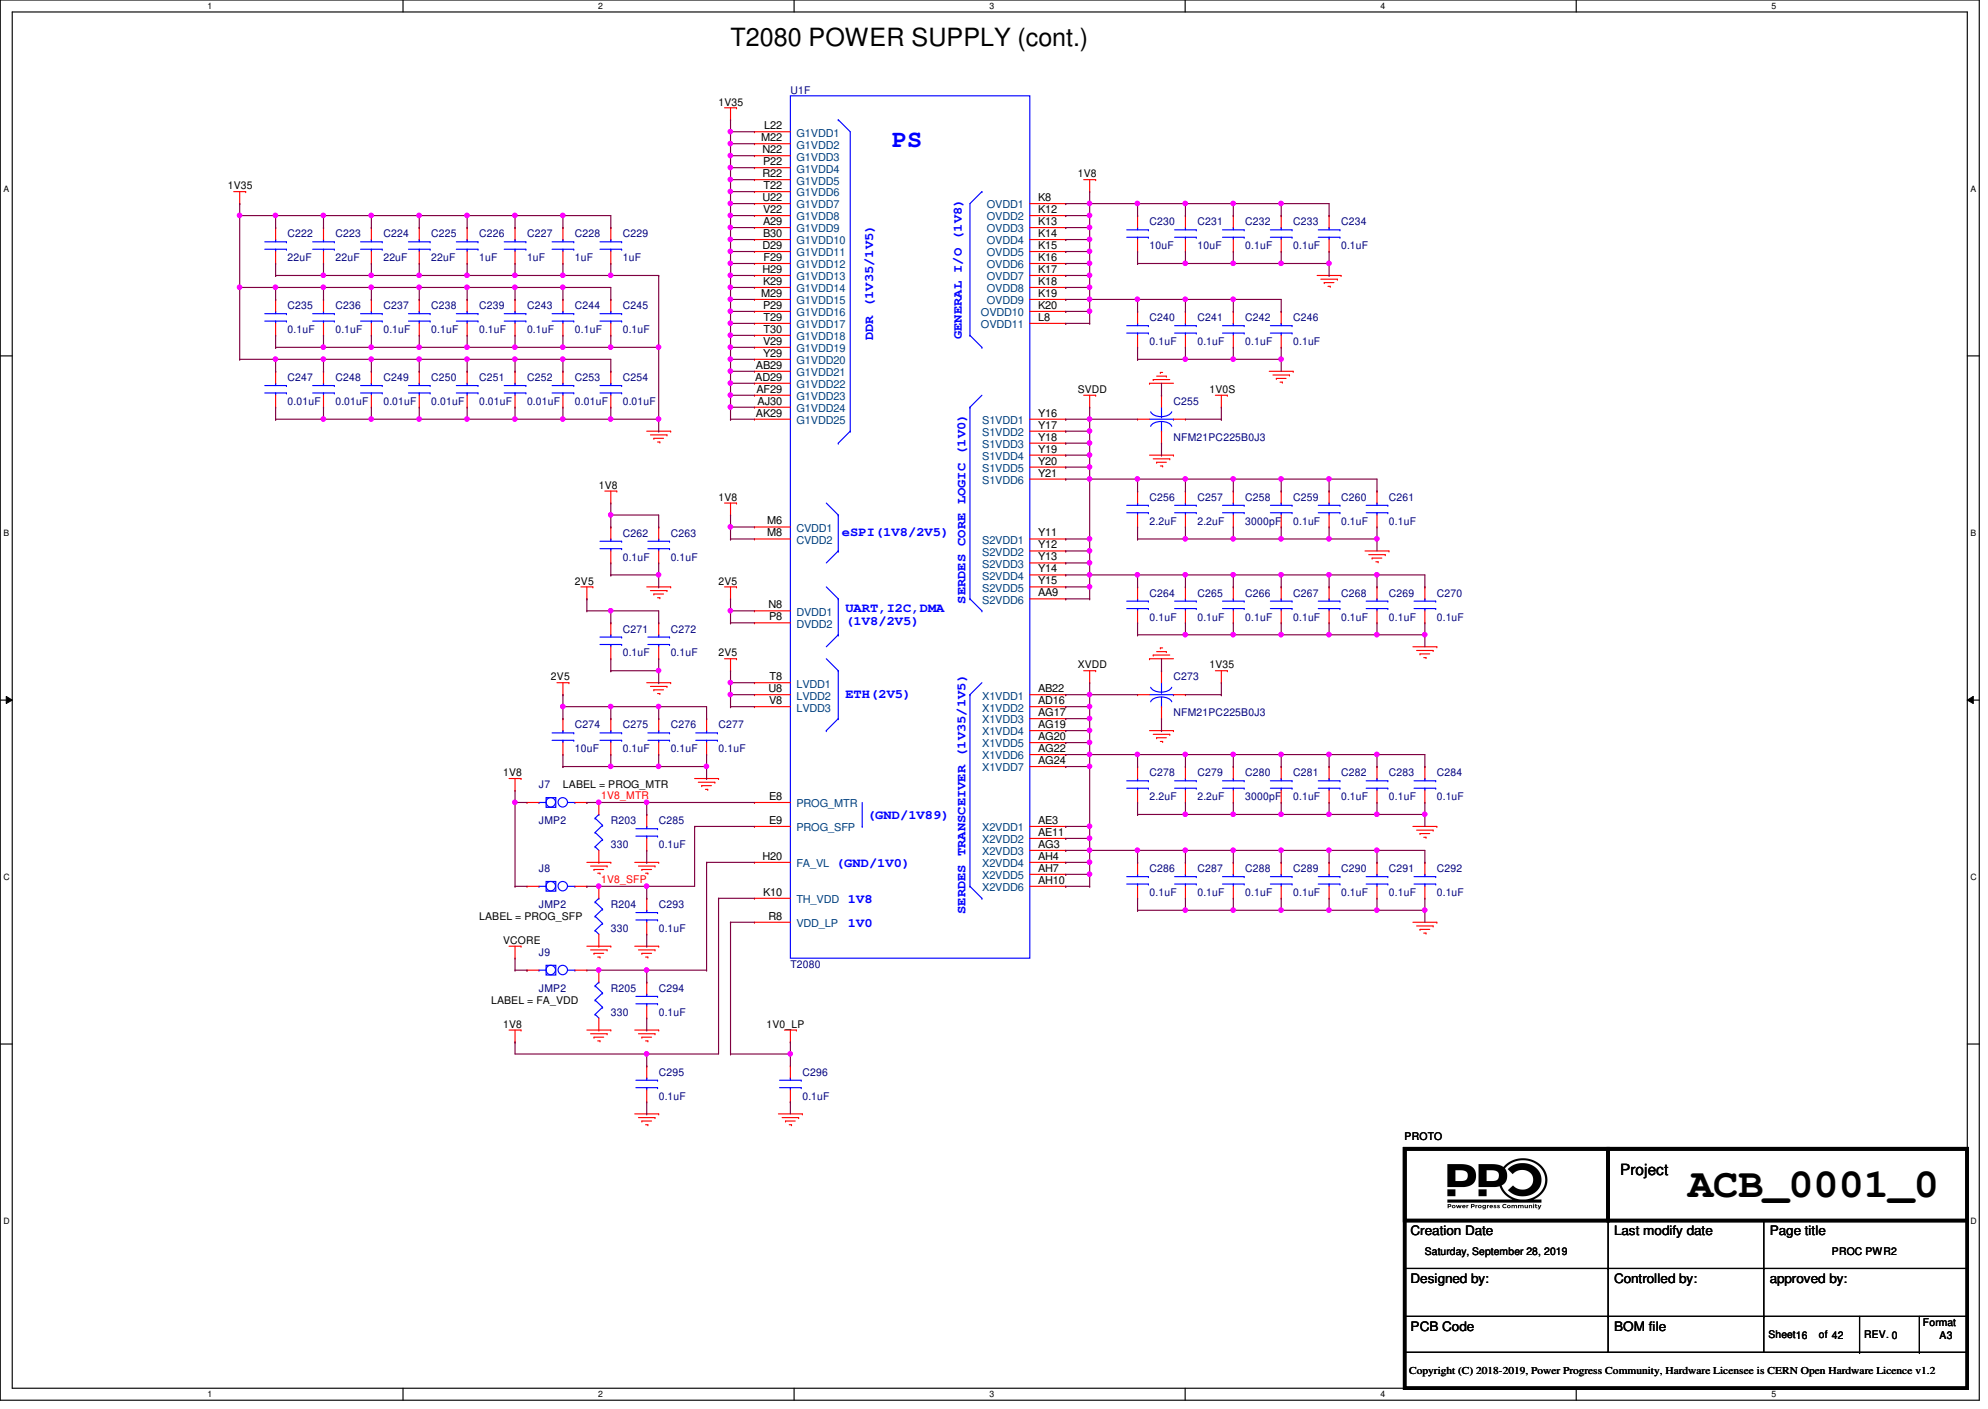
[picture p139: page 16]

GENERAL I/O (1V8) SERDES CORE LOGIC (1V0) SERDES TRANSCEIVER (1V35/1V5) (GND/1V89) (GND/1V0)

# GND

# GND

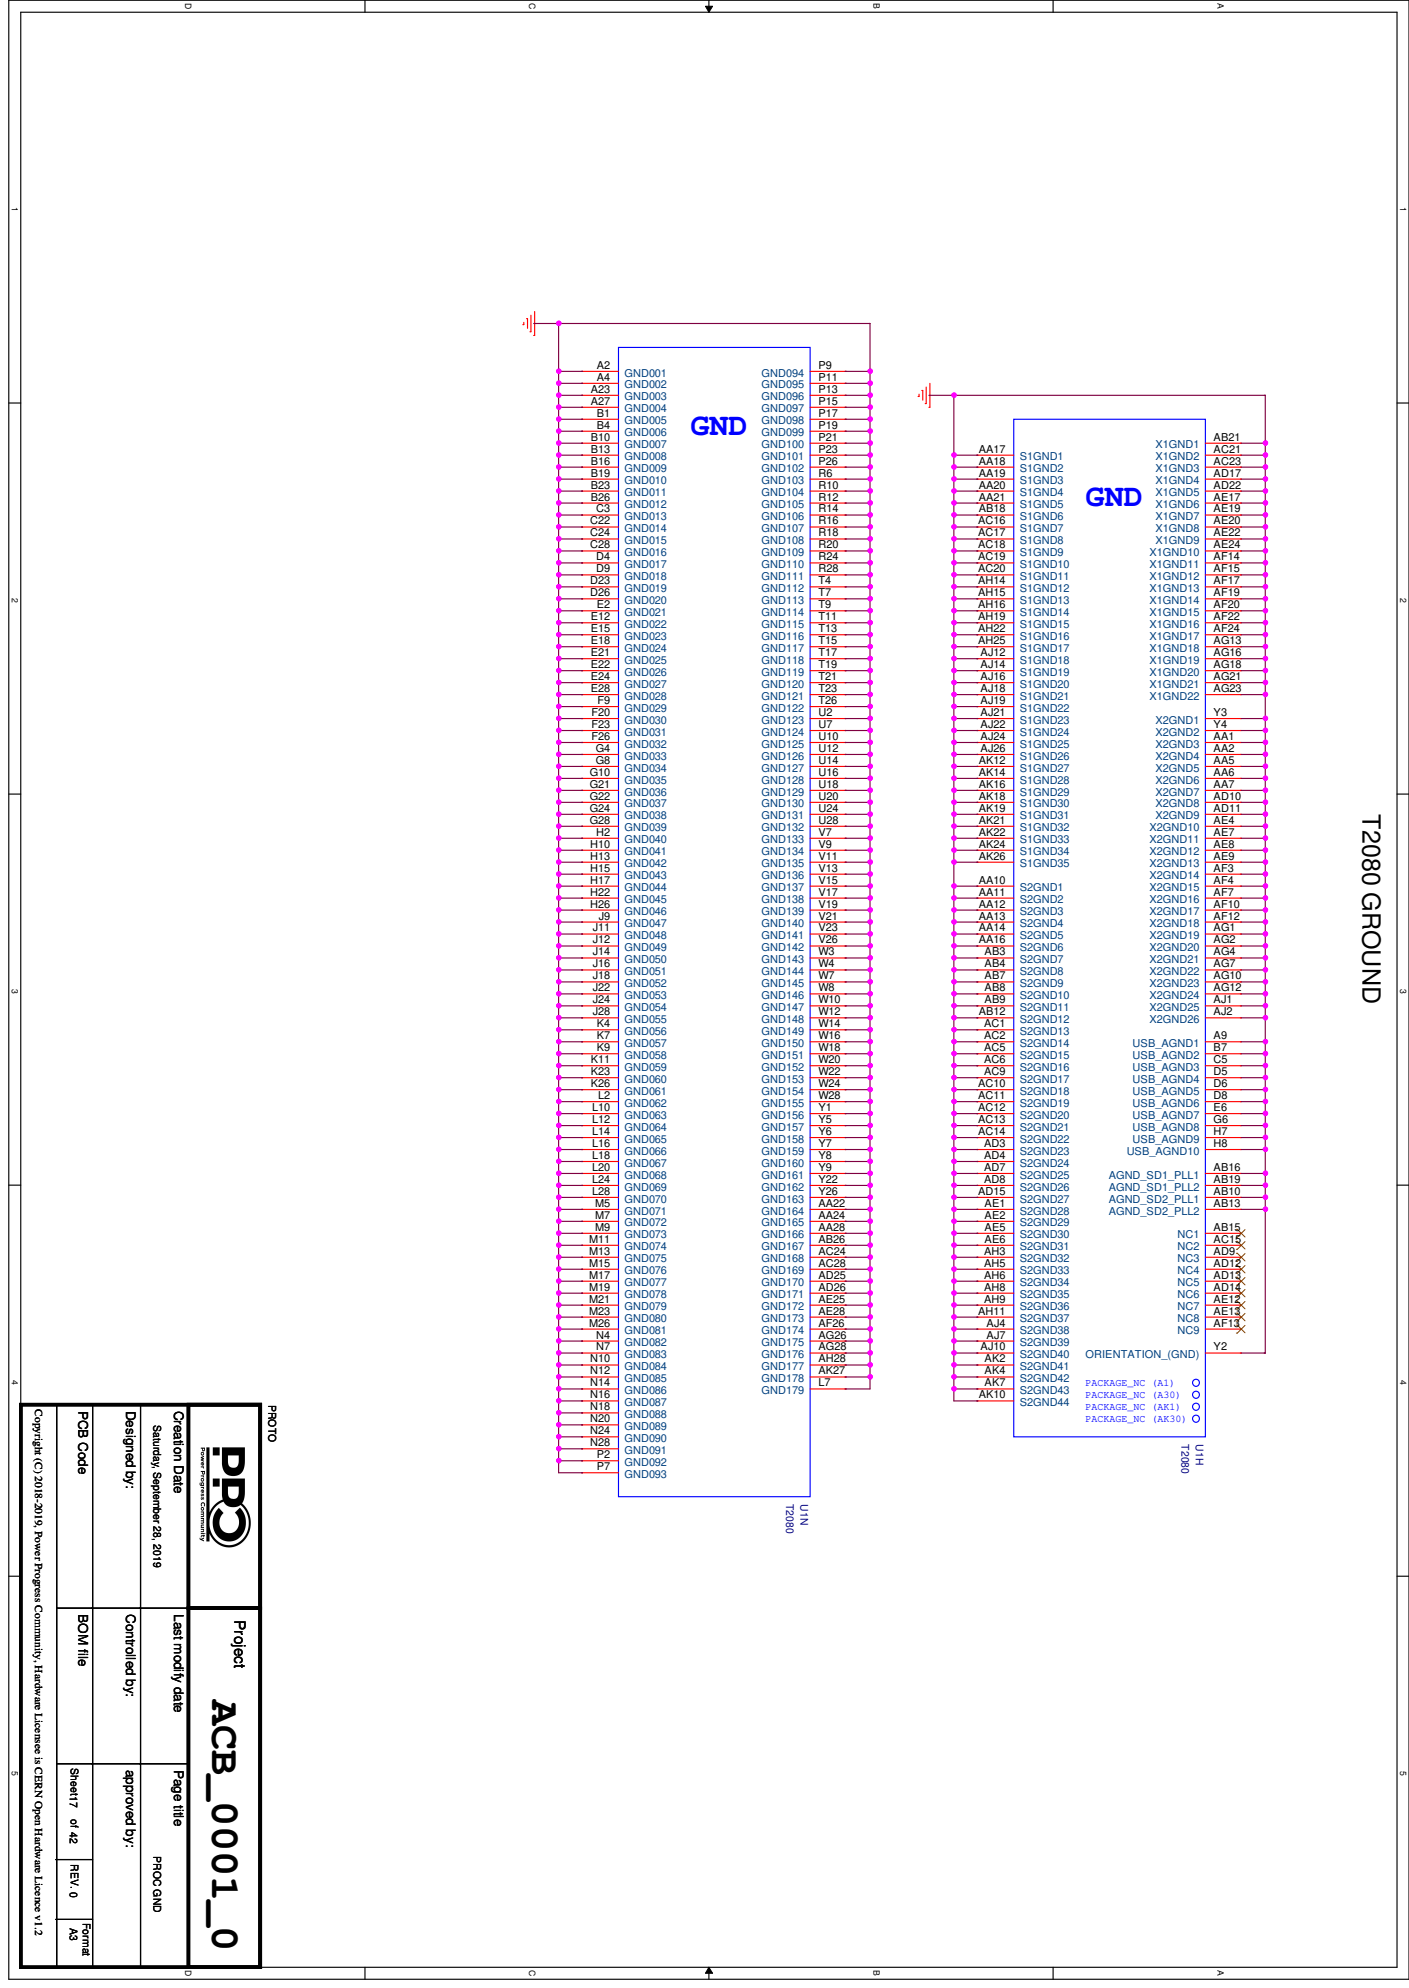
[picture p140: page 17]

Copyright (C) 2018-2019, Power Progress Community, Hardware Licensee is CERN Open Hardware Licence v1.2

PCB Code BOM file

Designed by: Controlled by: approved by:

Creation Date Last modify date

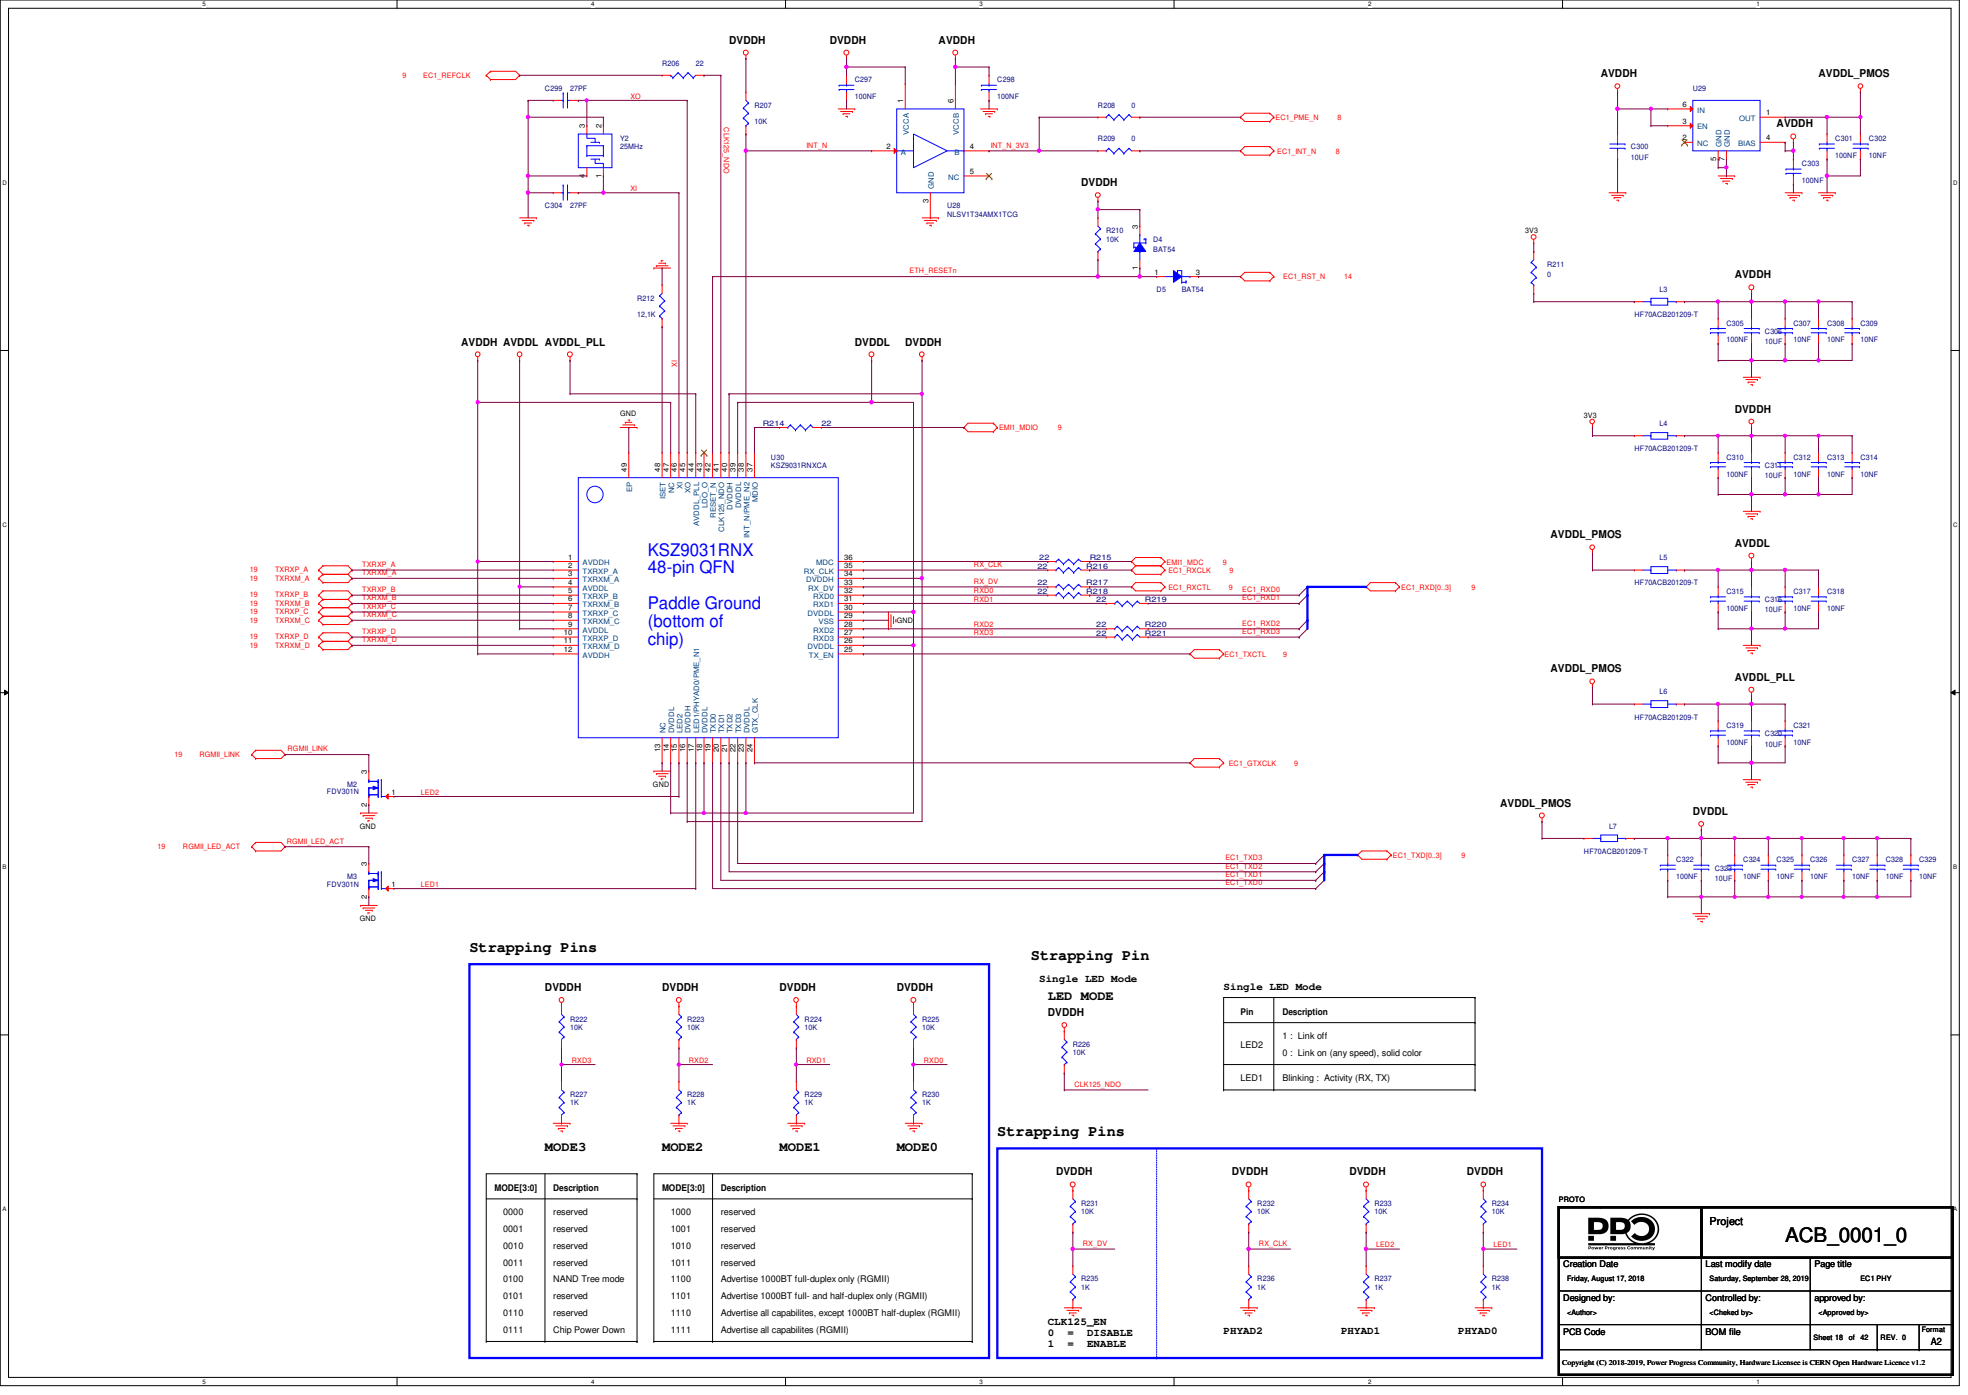
[picture p141: page 18]

Pin | Description

LED2 | 1 : Link off 0 : Link on (any speed), solid color

Blinking : Activity (RX, TX)

Advertise 1000BT full-duplex only (RGMII)

Advertise 1000BT full- and half-duplex only (RGMII)

Advertise all capabilites, except 1000BT half-duplex (RGMII)

5 | 4 | 3 | 2 | 1

D

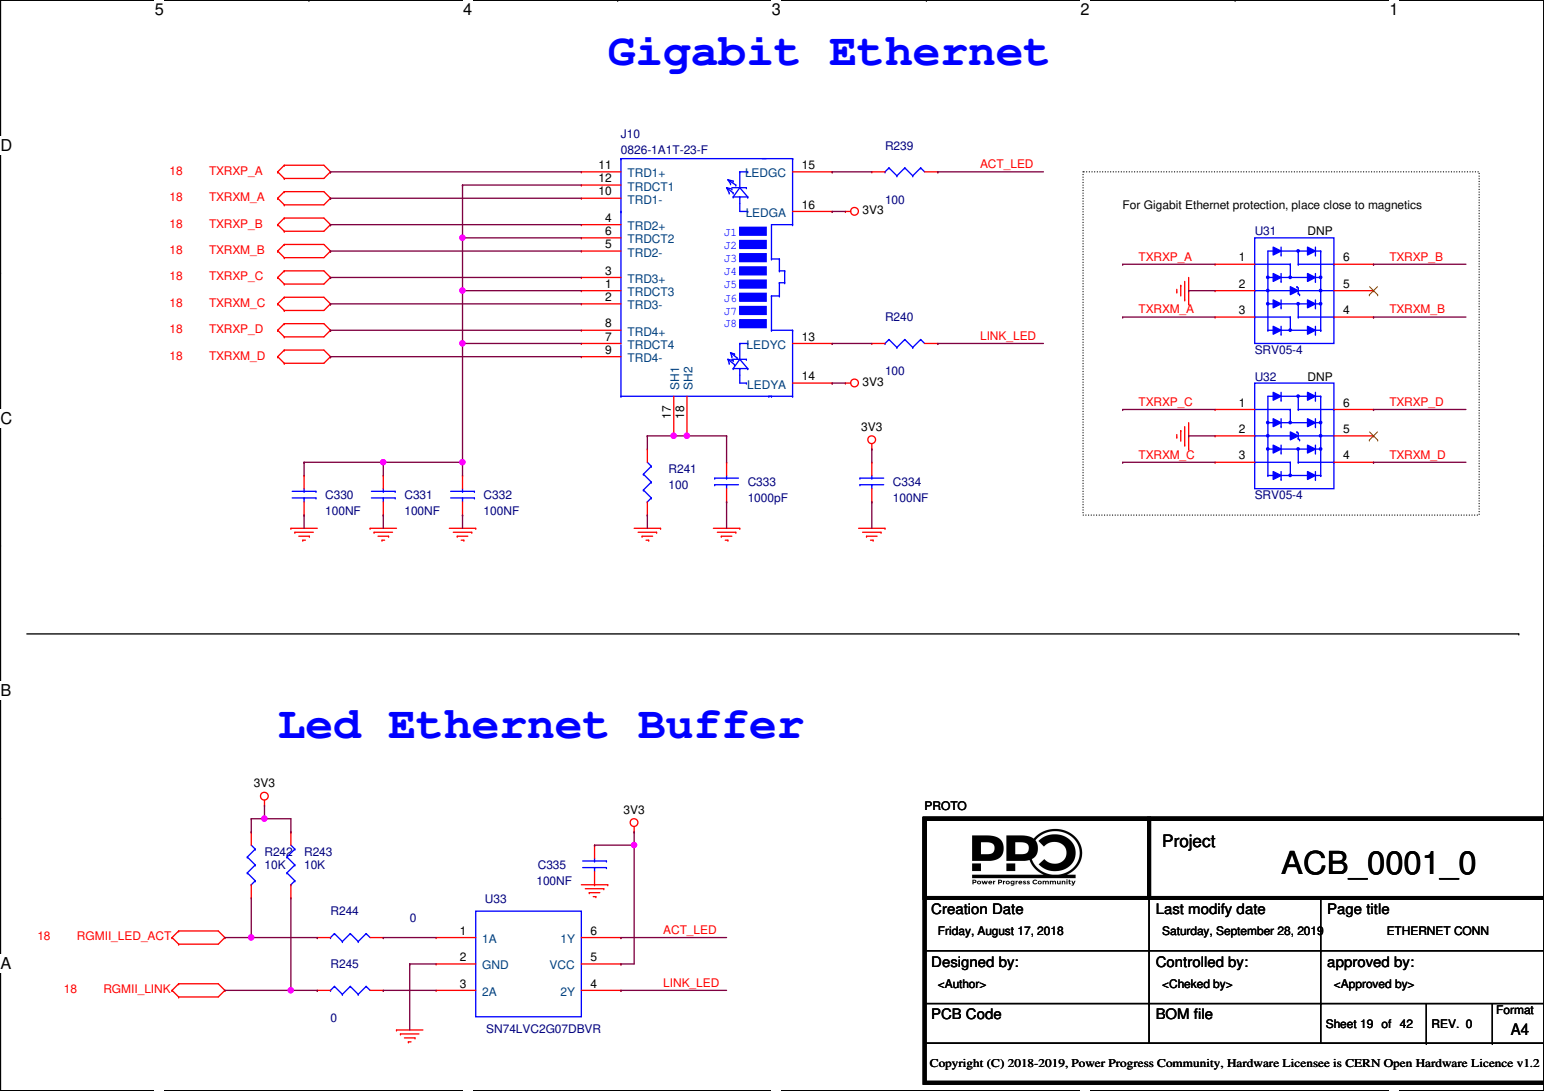
[picture p142: page 19]

For Gigabit Ethernet protection, place close to magnetics

# MagniPlus -SATA Interface

PERST_N | 61 VDD_6 | 62 GPIO0 | 63 TST0 | 64 TST1 | 65 TST2 | 66 TST3 | 67 VDDIO_2 | 68 GPIO1 | 69 GPIO2 | 70 VDD_7 | 71 TST4 | 72 TST5 | 73 TST6 | 74 GPIO6 | 75 GPIO7 | 76

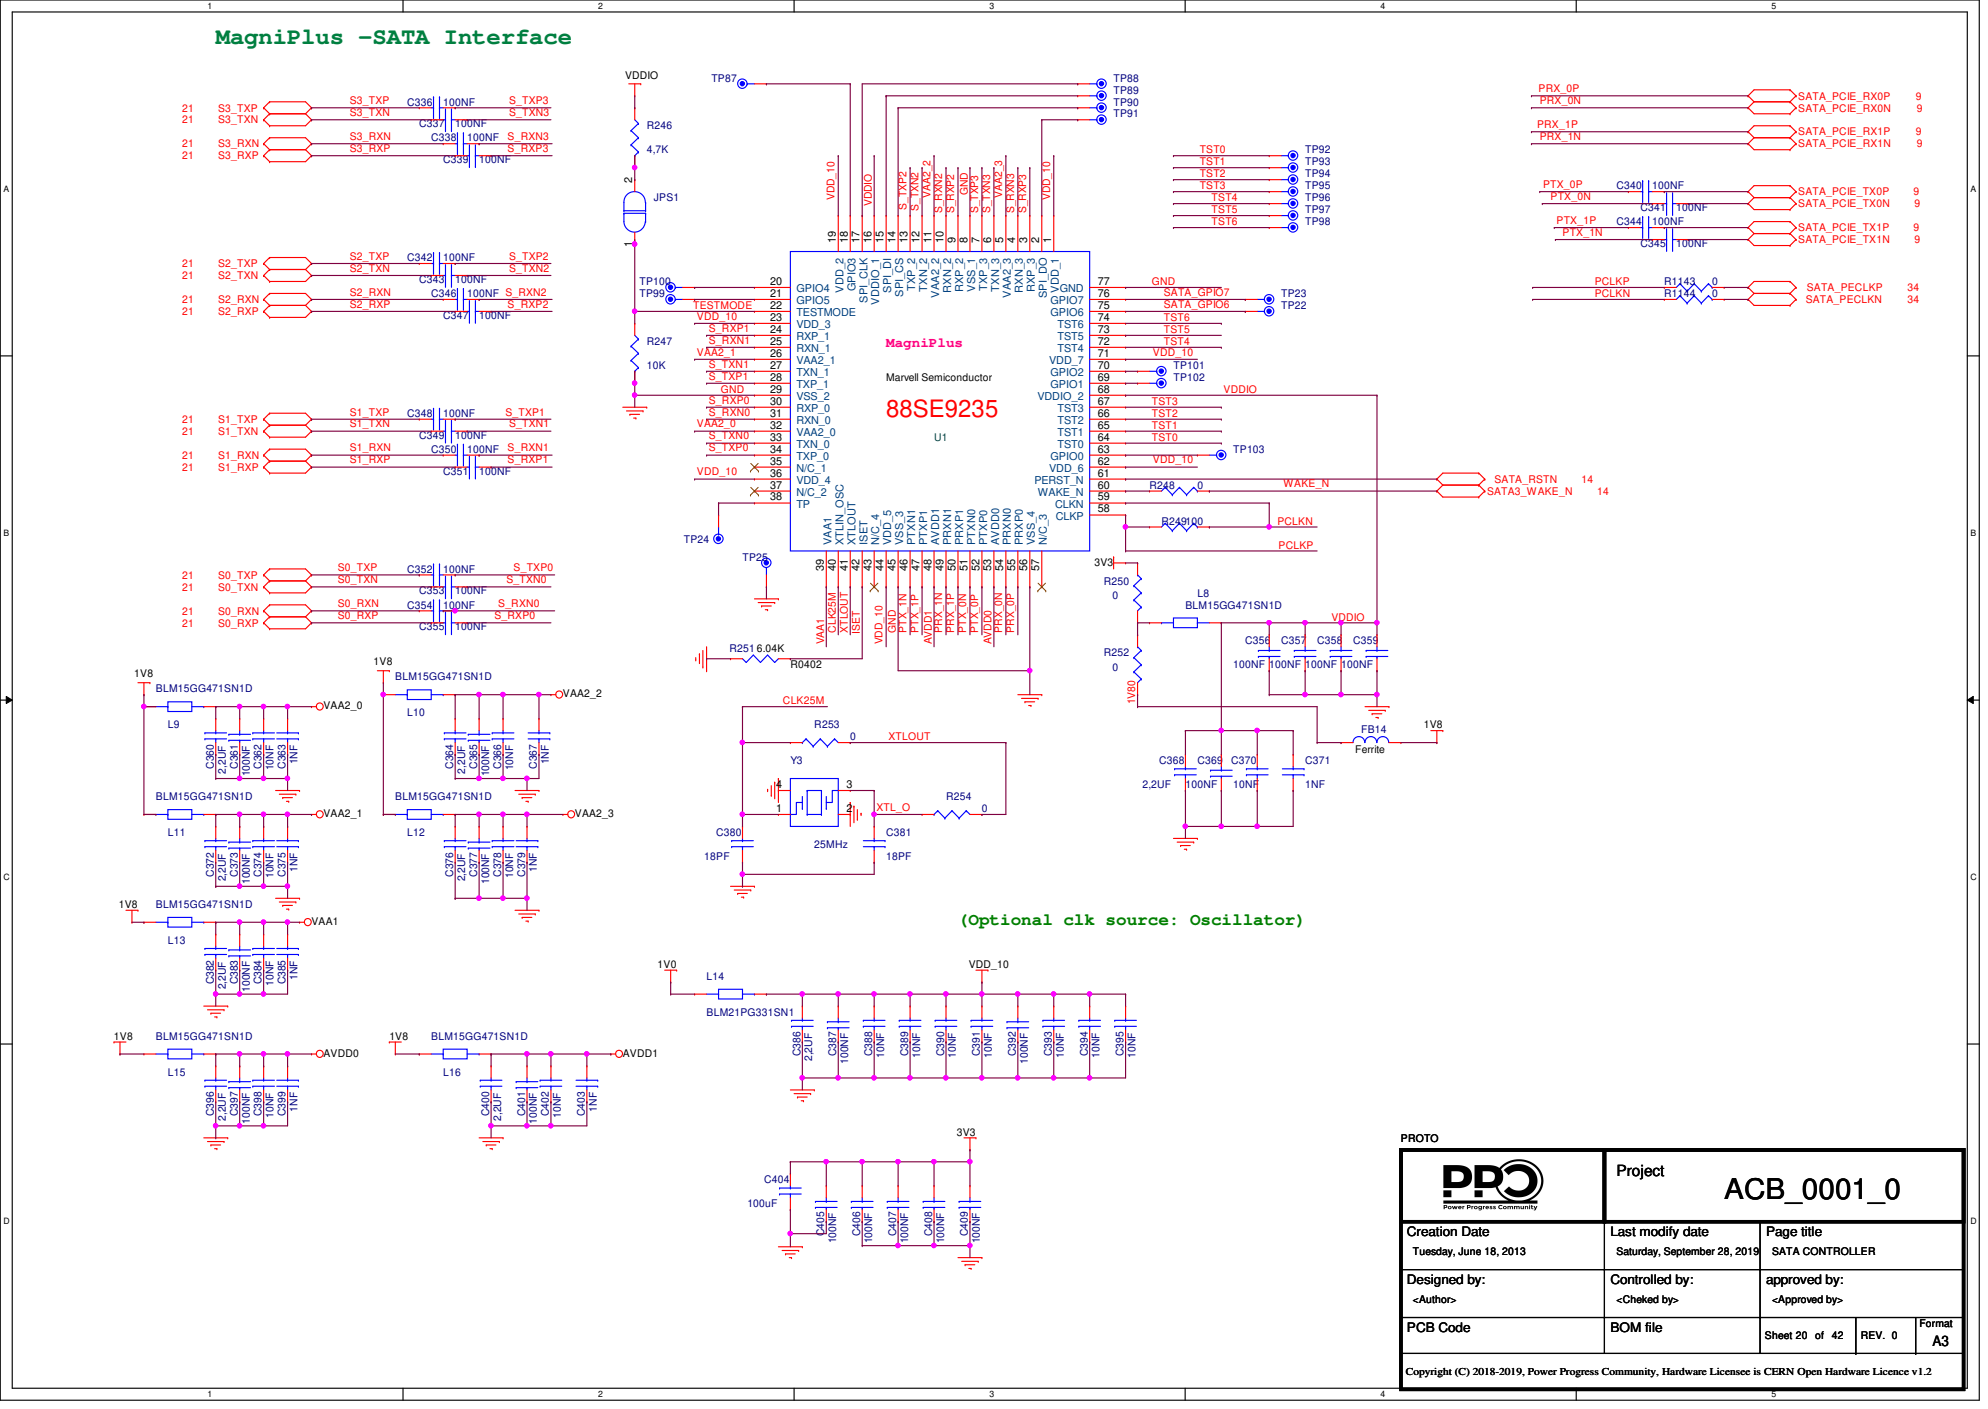
[picture p143: page 20]

(Optional clk source: Oscillator)

A | A

# HDD CONNECTOR

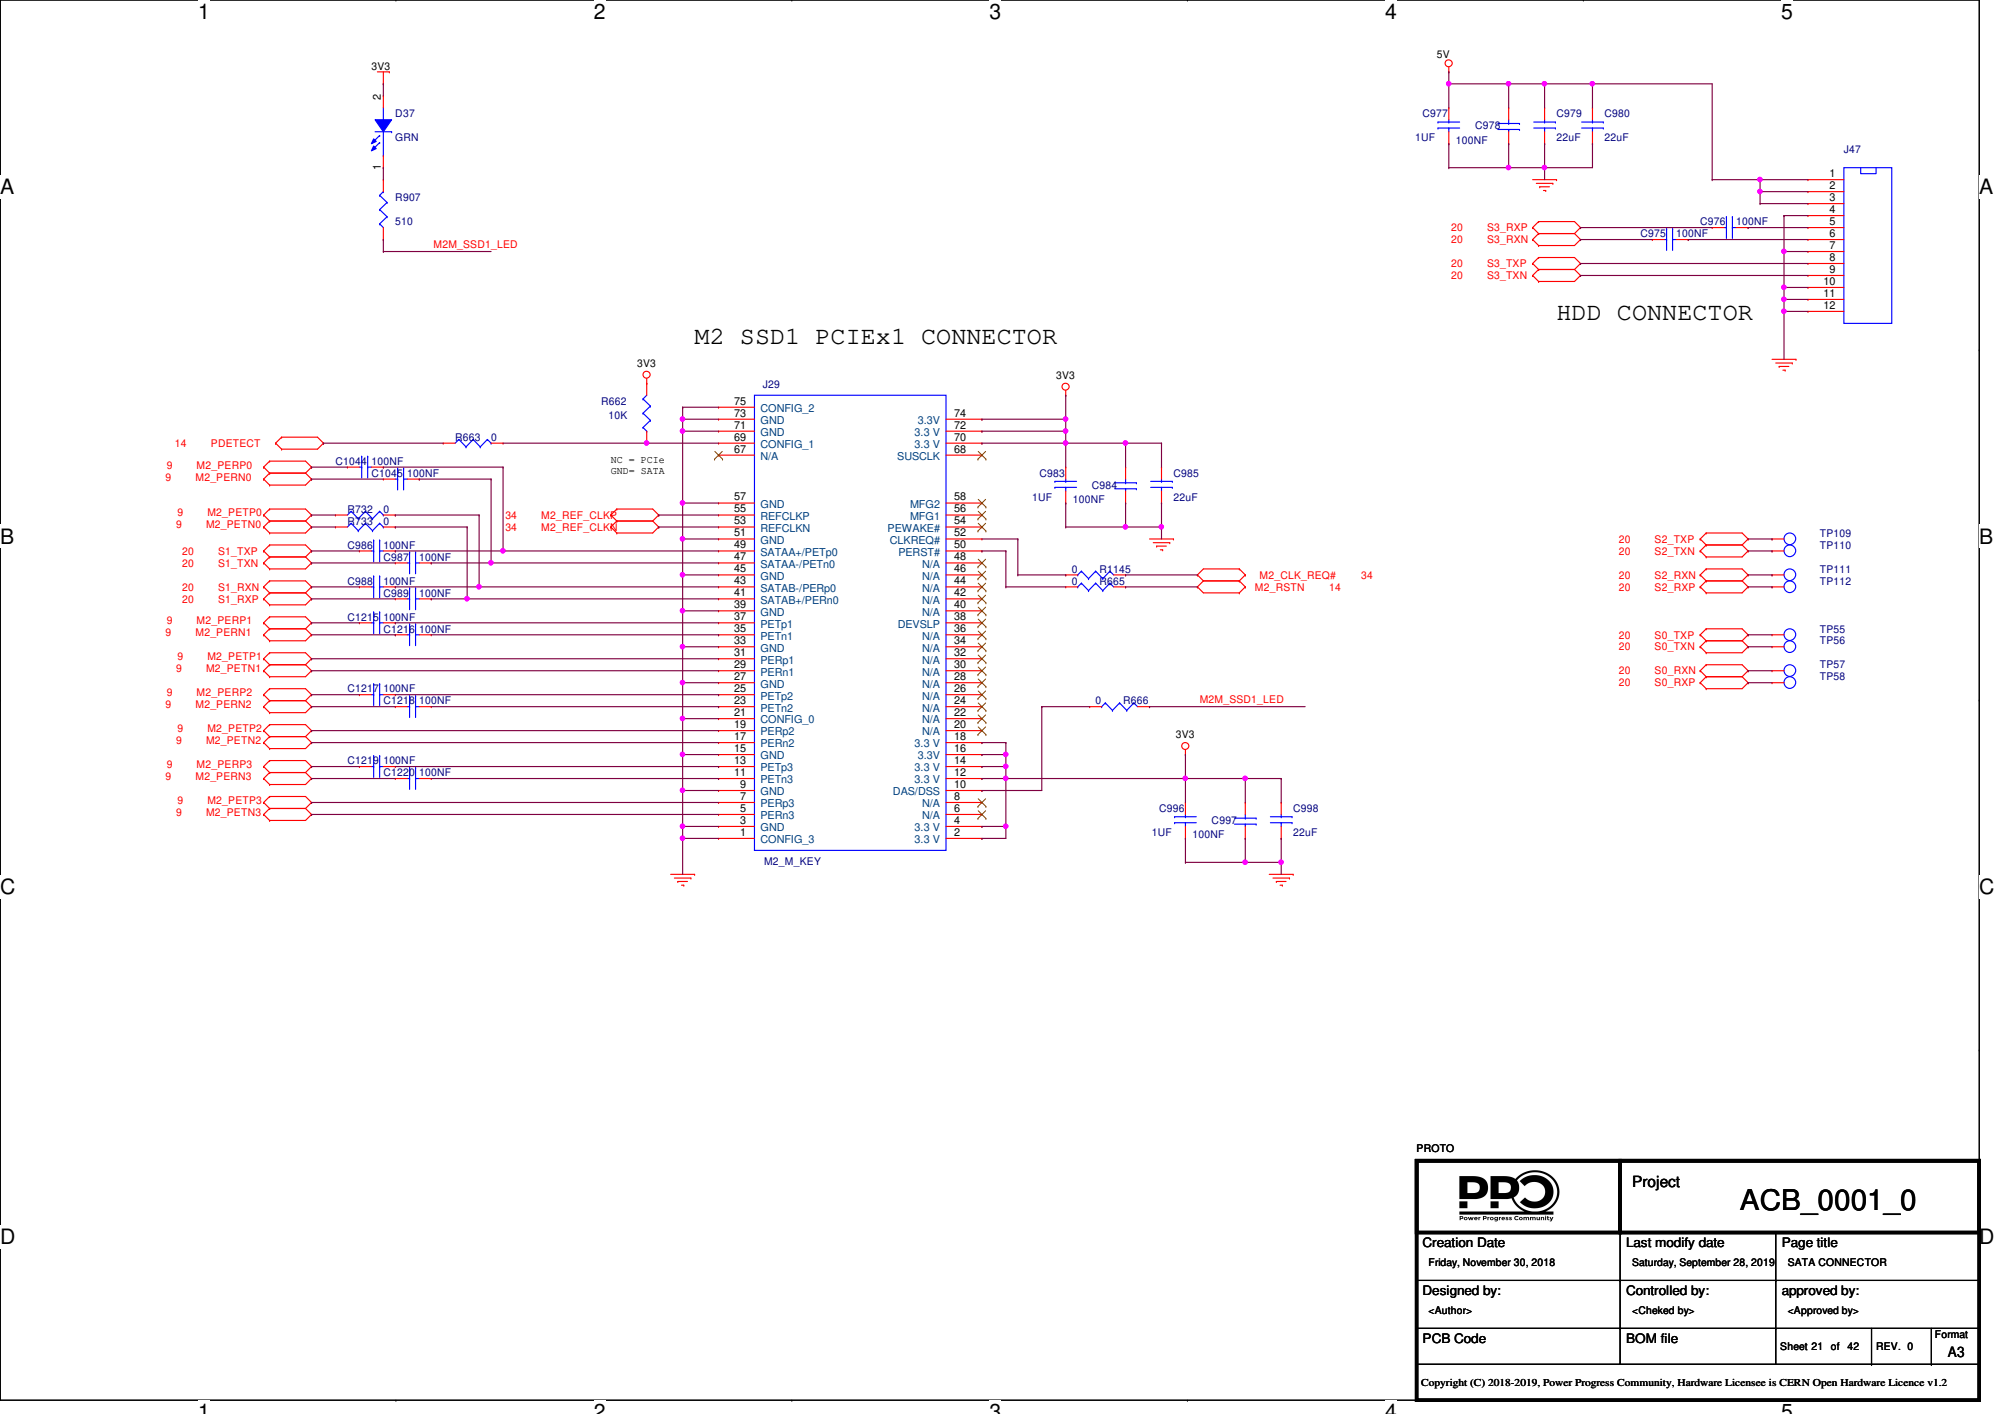
[picture p144: page 21]

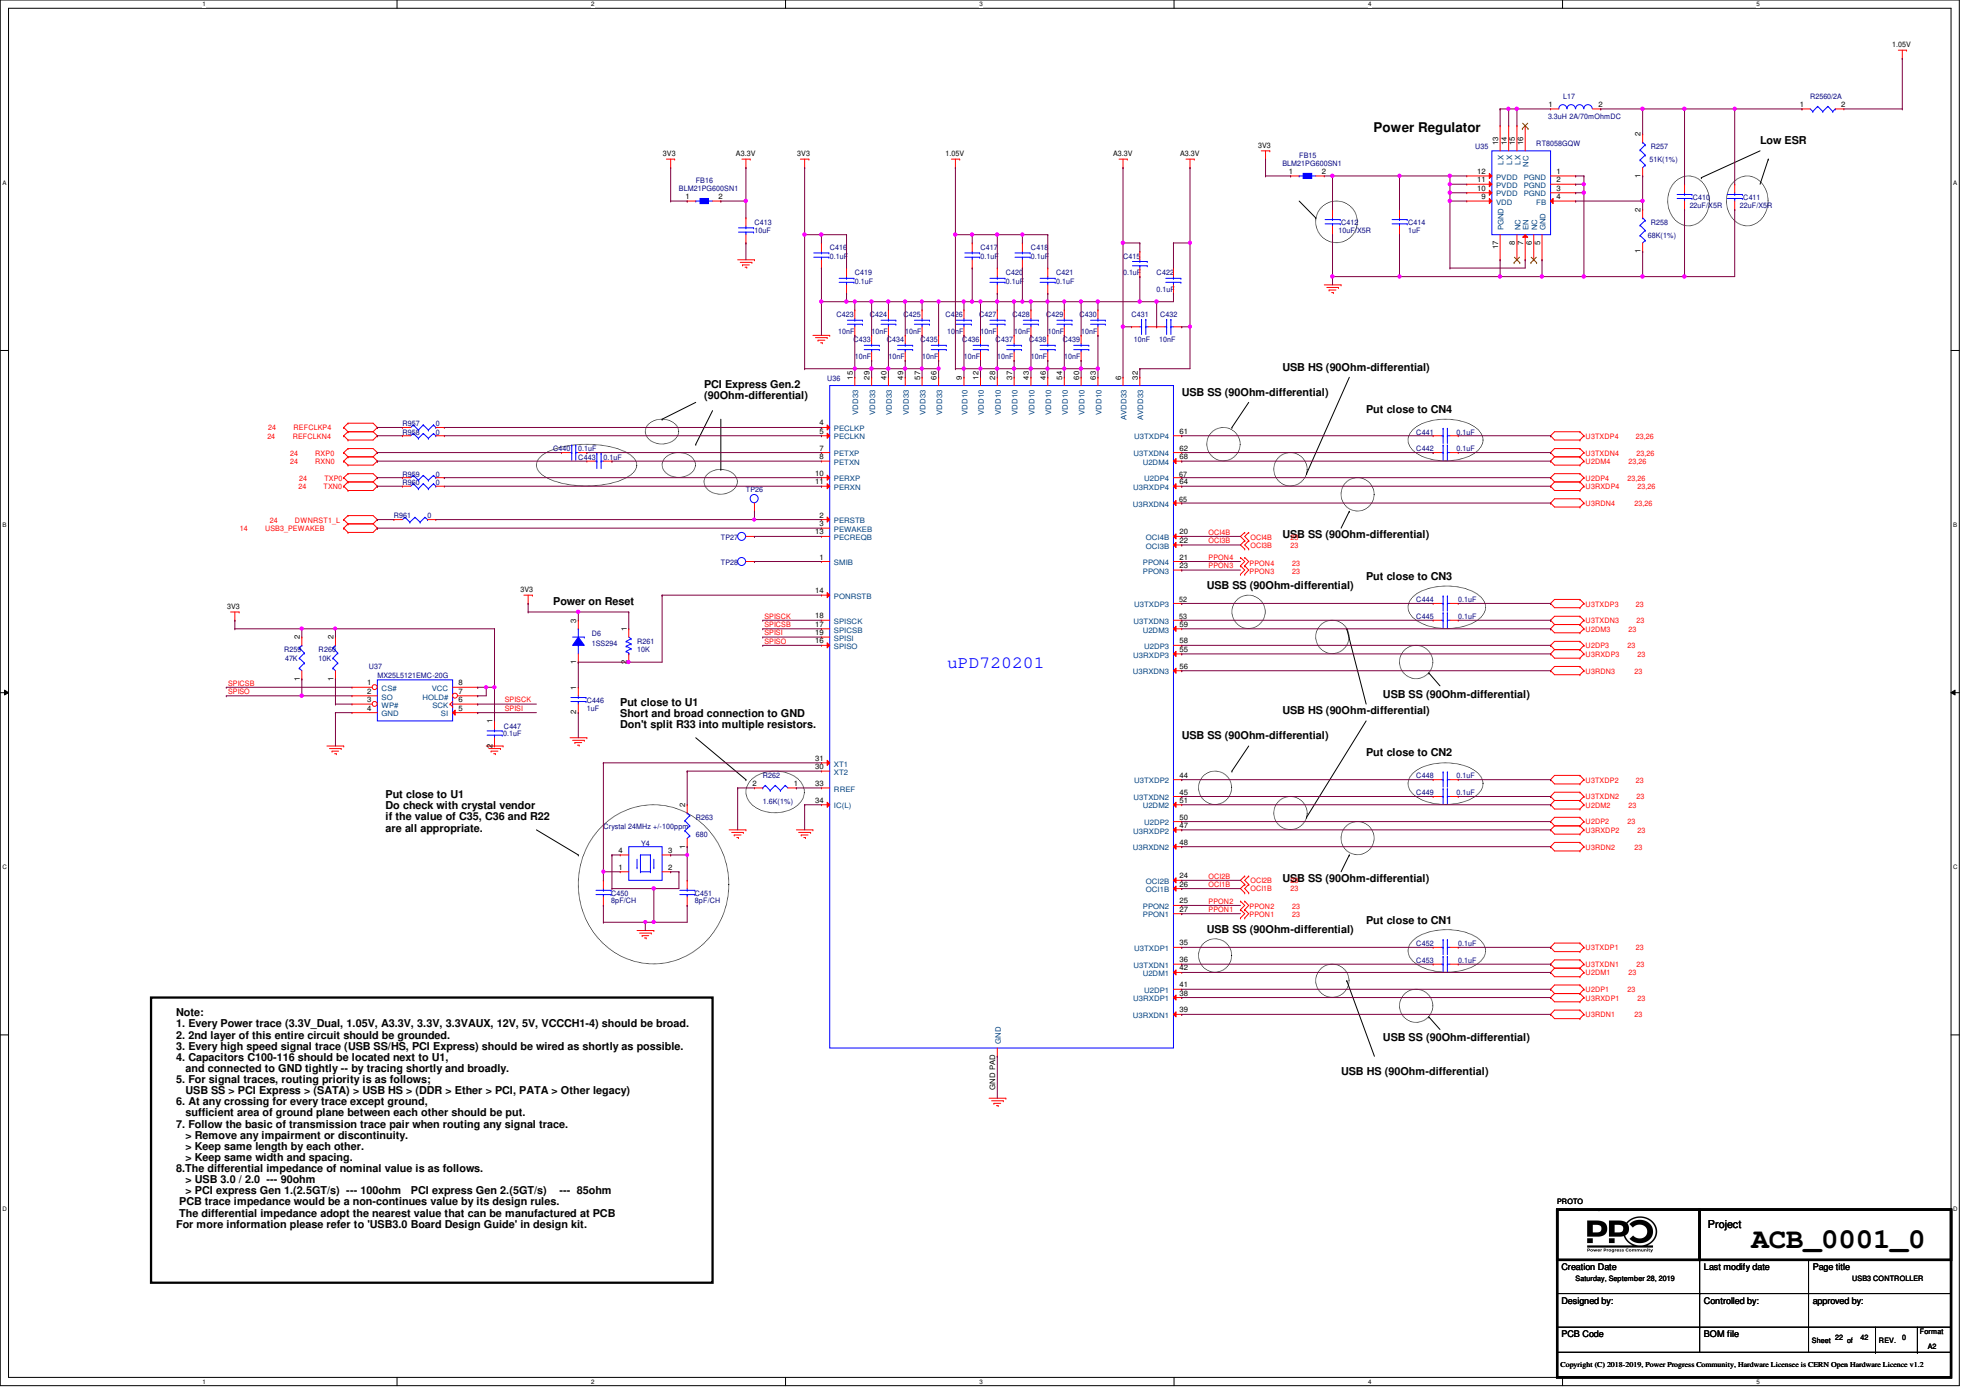
[picture p145: page 22]

Put close to U1
Short and broad connection to GND
Don't split R33 into multiple resistors.

Do check with crystal vendor
if the value of C35, C36 and R22
are all appropriate.

Note:
1. Every Power trace (3.3V_Dual, 1.05V, A3.3V, 3.3V, 3.3VAUX, 12V, 5V, VCCCH1-4) should be broad.
2. 2nd layer of this entire circuit should be grounded.
3. Every high speed signal trace (USB SS/HS, PCI Express) should be wired as shortly as possible.
4. Capacitors C100-116 should be located next to U1,
and connected to GND tightly -- by tracing shortly and broadly.
5. For signal traces, routing priority is as follows;
USB SS > PCI Express > (SATA) > USB HS > (DDR > Ether > PCI, PATA > Other legacy)
6. At any crossing for every trace except ground,
sufficient area of ground plane between each other should be put.
7. Follow the basic of transmission trace pair when routing any signal trace.
> Remove any impairment or discontinuity.
> Keep same length by each other.
> Keep same width and spacing.
8.The differential impedance of nominal value is as follows.
> USB 3.0 / 2.0 --- 90ohm
PCB trace impedance would be a non-continues value by its design rules.
The differential impedance adopt the nearest value that can be manufactured at PCB
For more information please refer to 'USB3.0 Board Design Guide' in design kit.

# SS/CL

# SS/CL

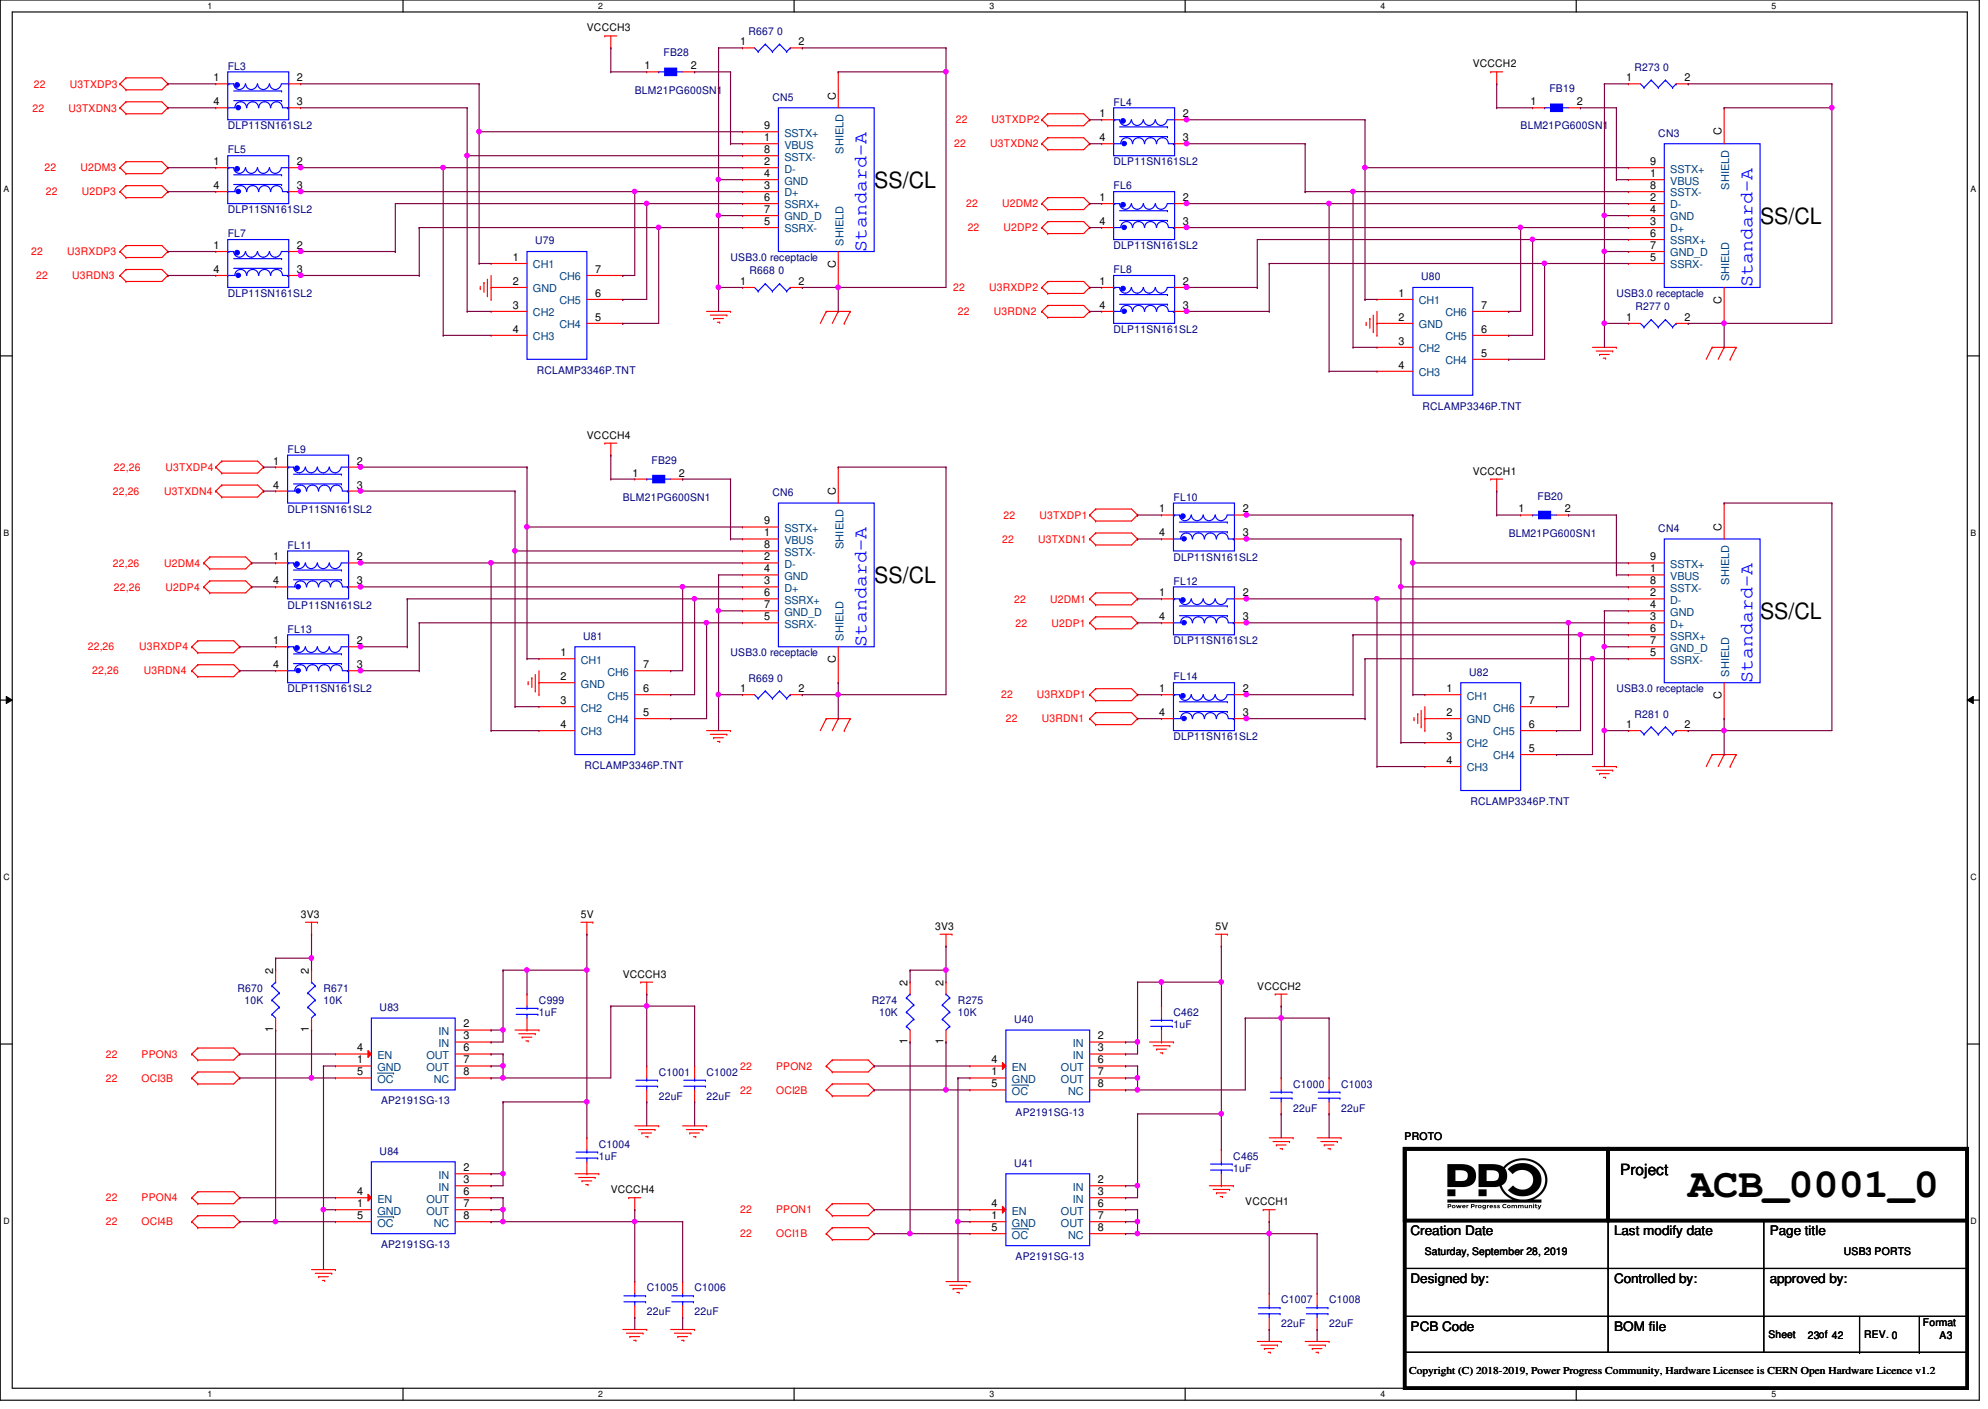
[picture p146: page 23]

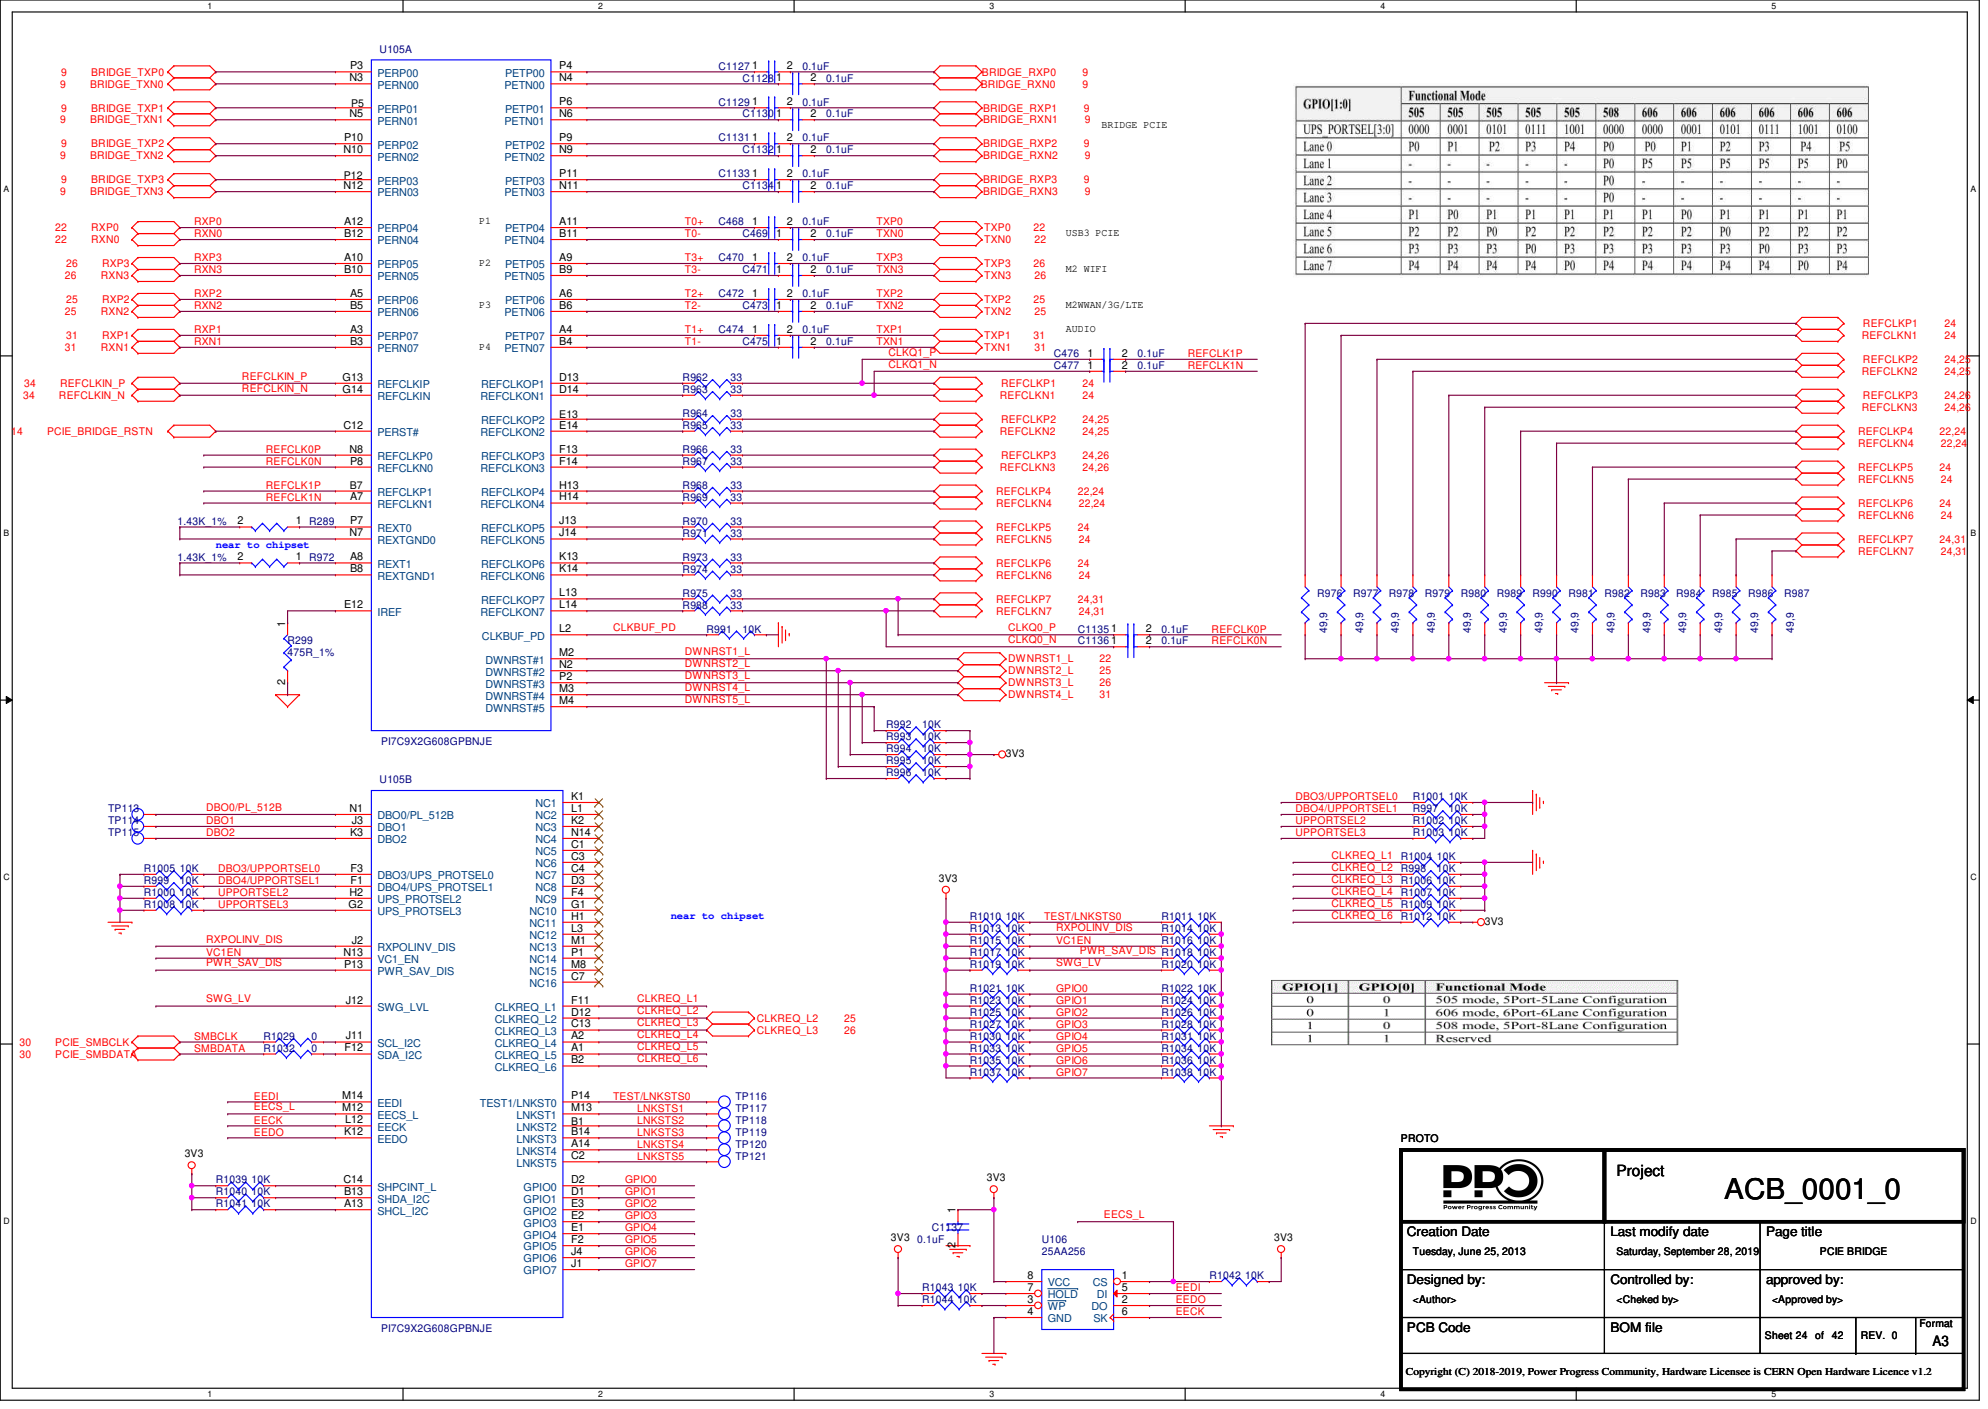
[picture p147: page 24]

A | A

# M2 WLAN+BT PCIEx1 CONNECTOR

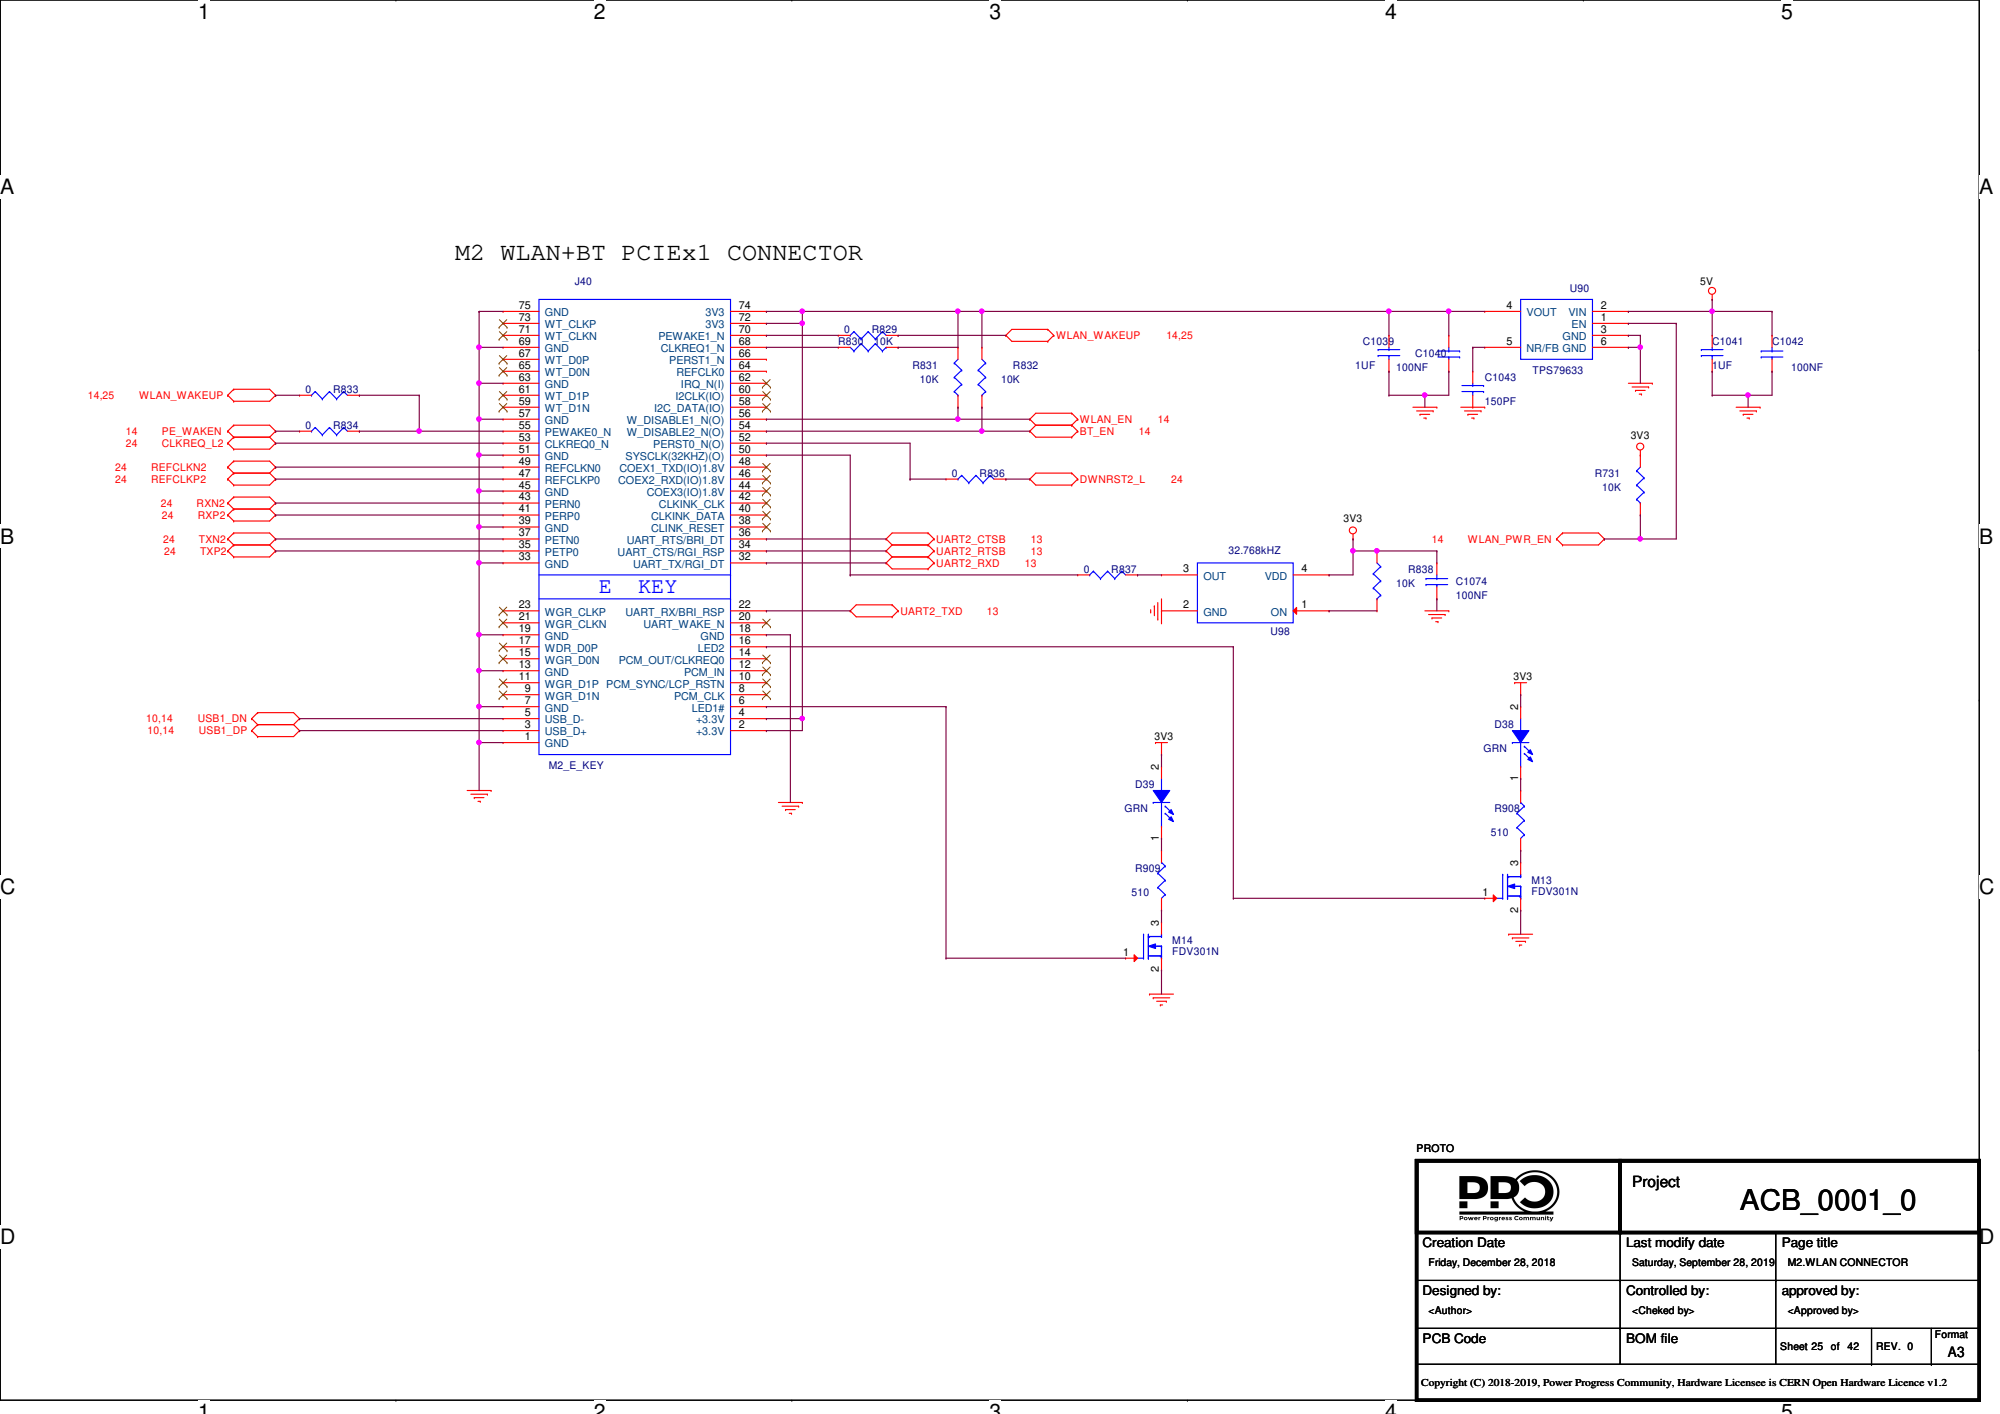
[picture p148: page 25]

A | A

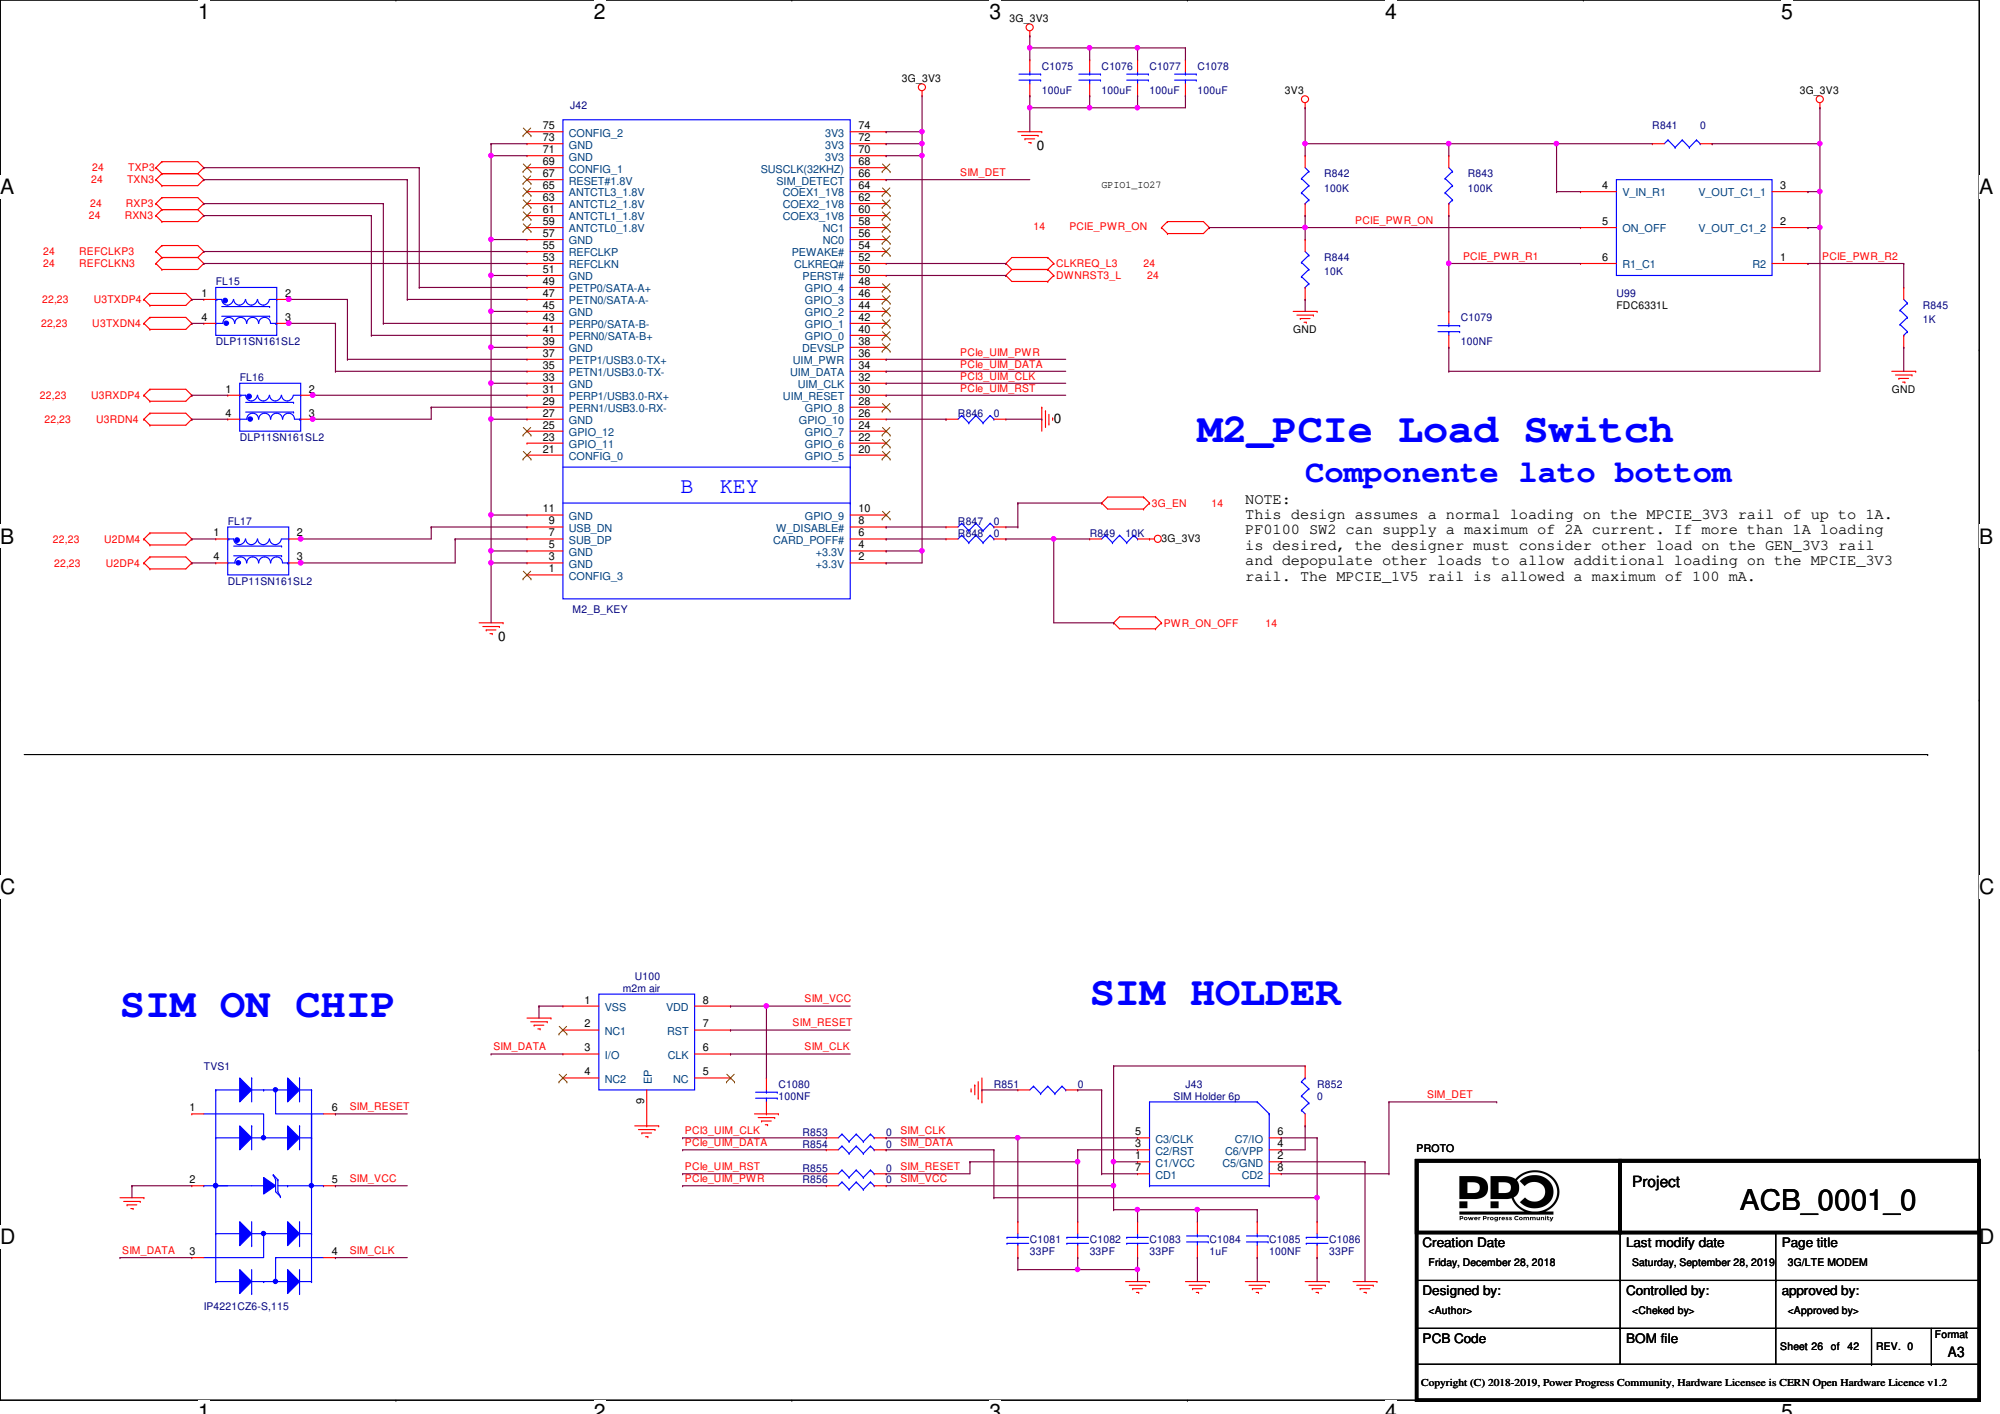
[picture p149: page 26]

NOTE:
This design assumes a normal loading on the MPCIE_3V3 rail of up to 1A.
PF0100 SW2 can supply a maximum of 2A current. If more than 1A loading
is desired, the designer must consider other load on the GEN_3V3 rail
and depopulate other loads to allow additional loading on the MPCIE_3V3
rail. The MPCIE_1V5 rail is allowed a maximum of 100 mA.

# 1.0V Decoupling Capacitors

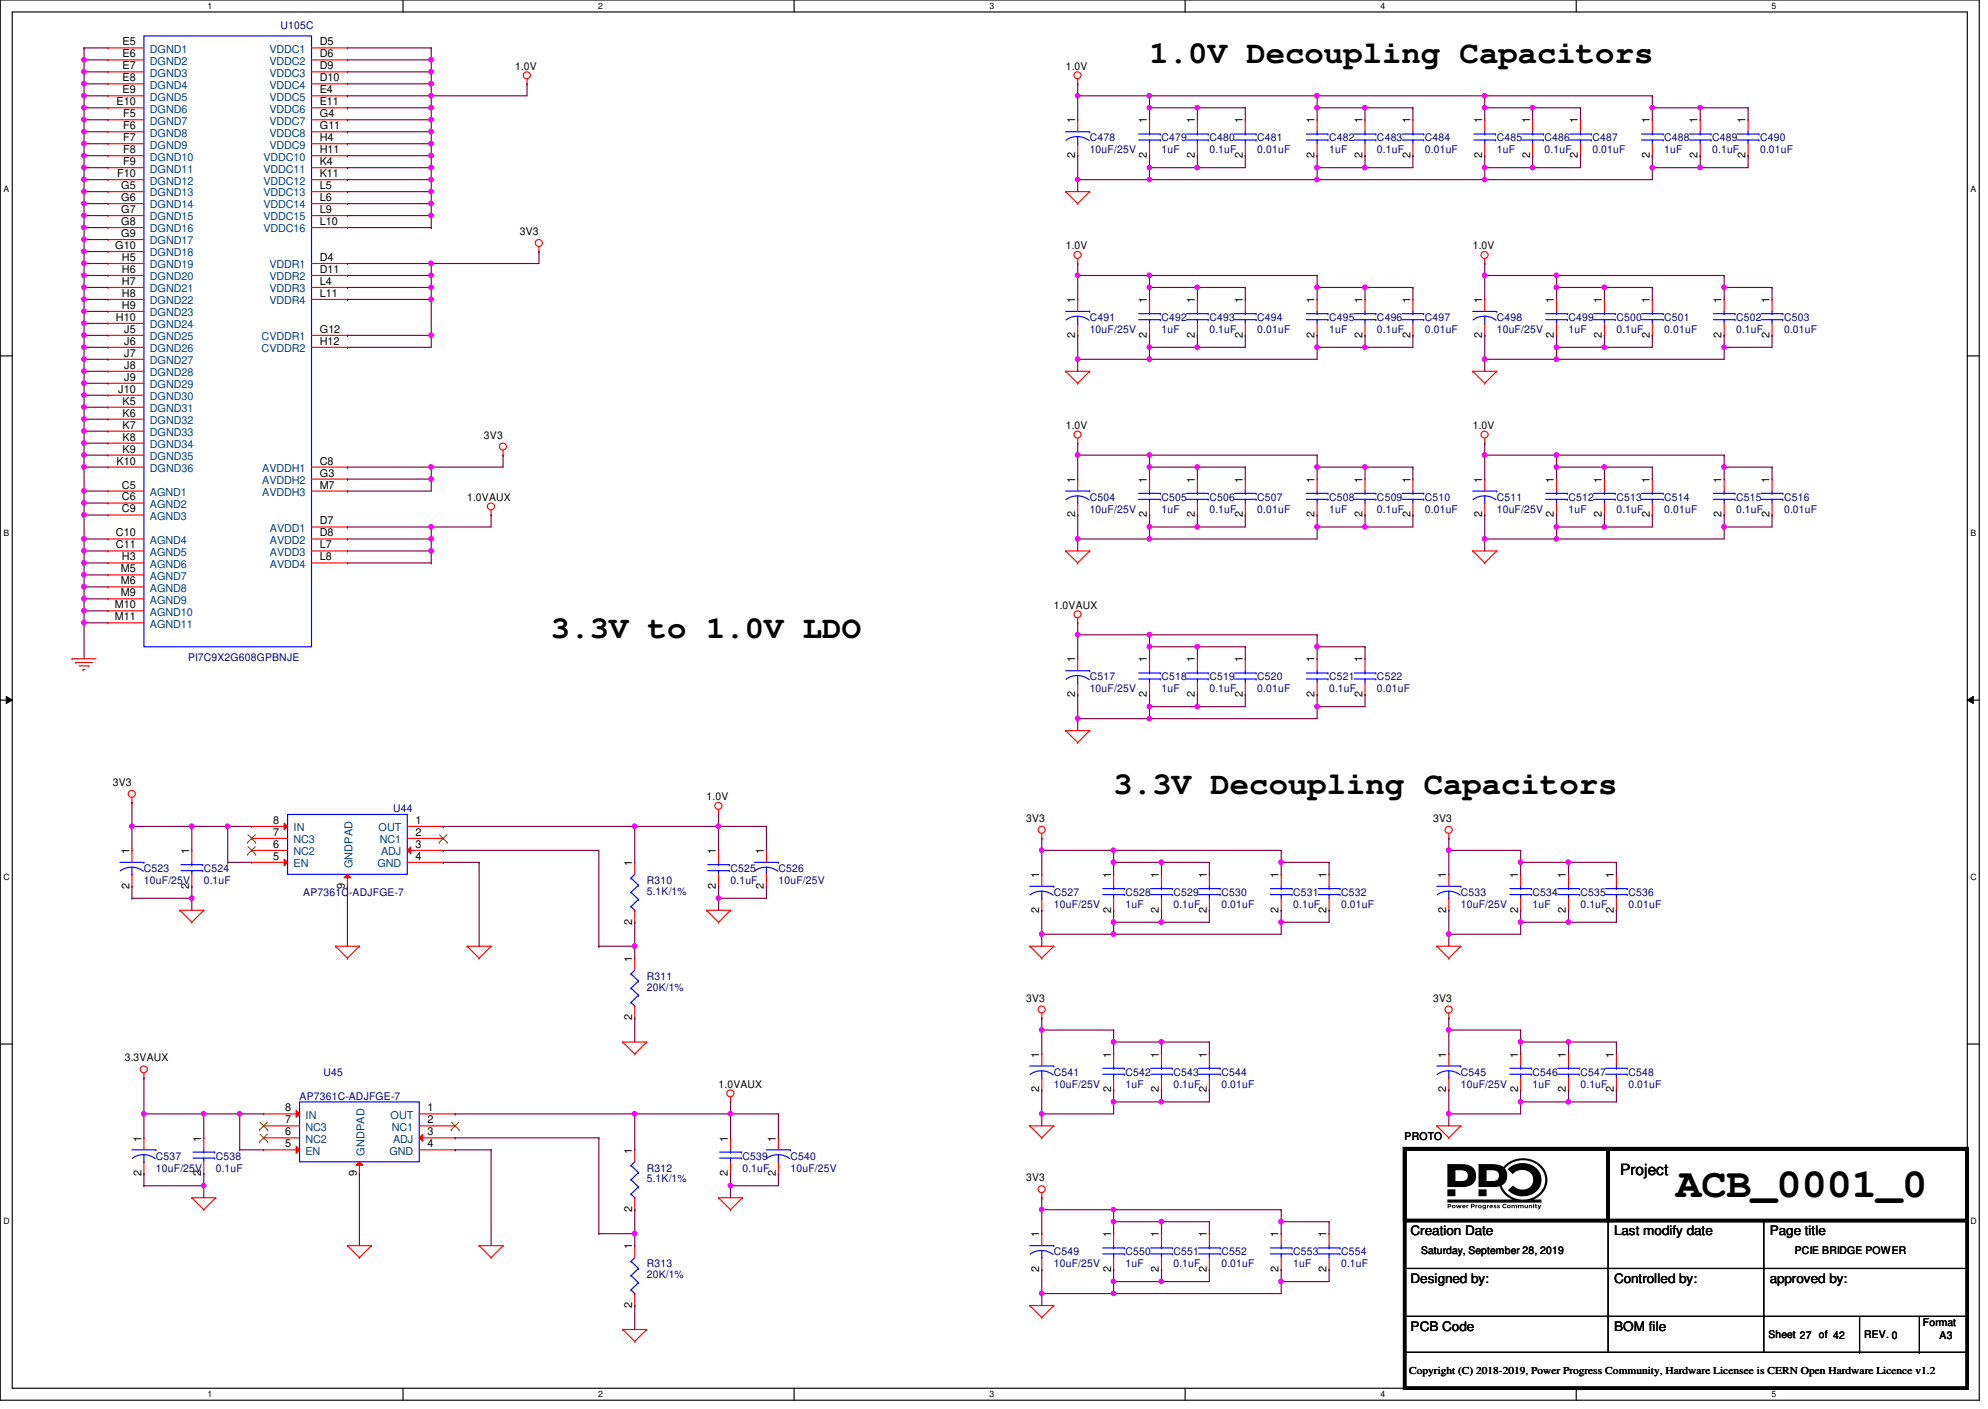
[picture p150: page 27]

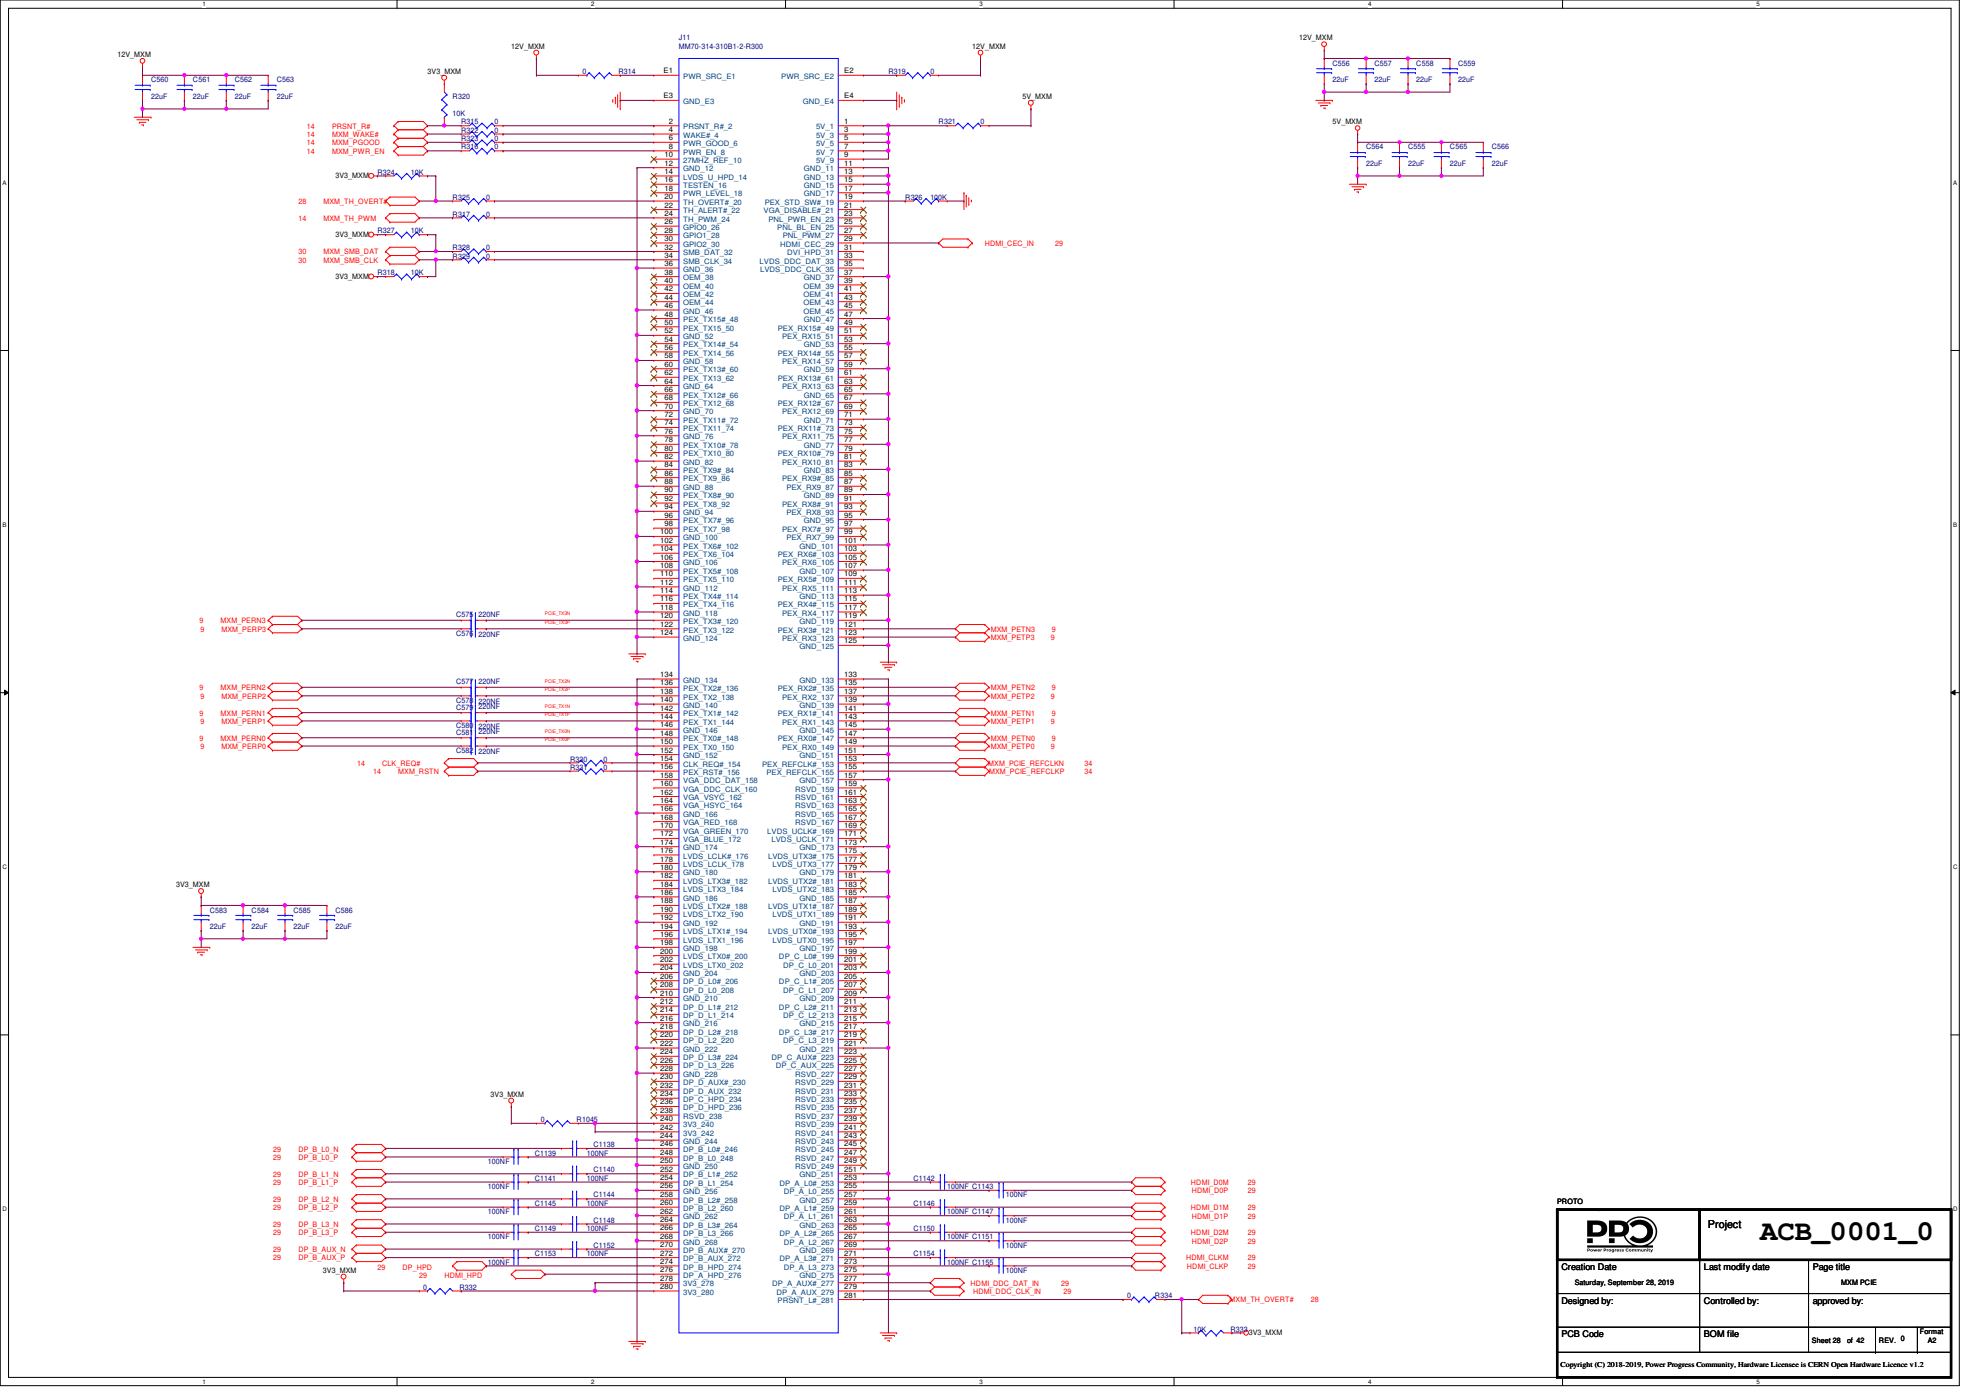
[picture p151: page 28]

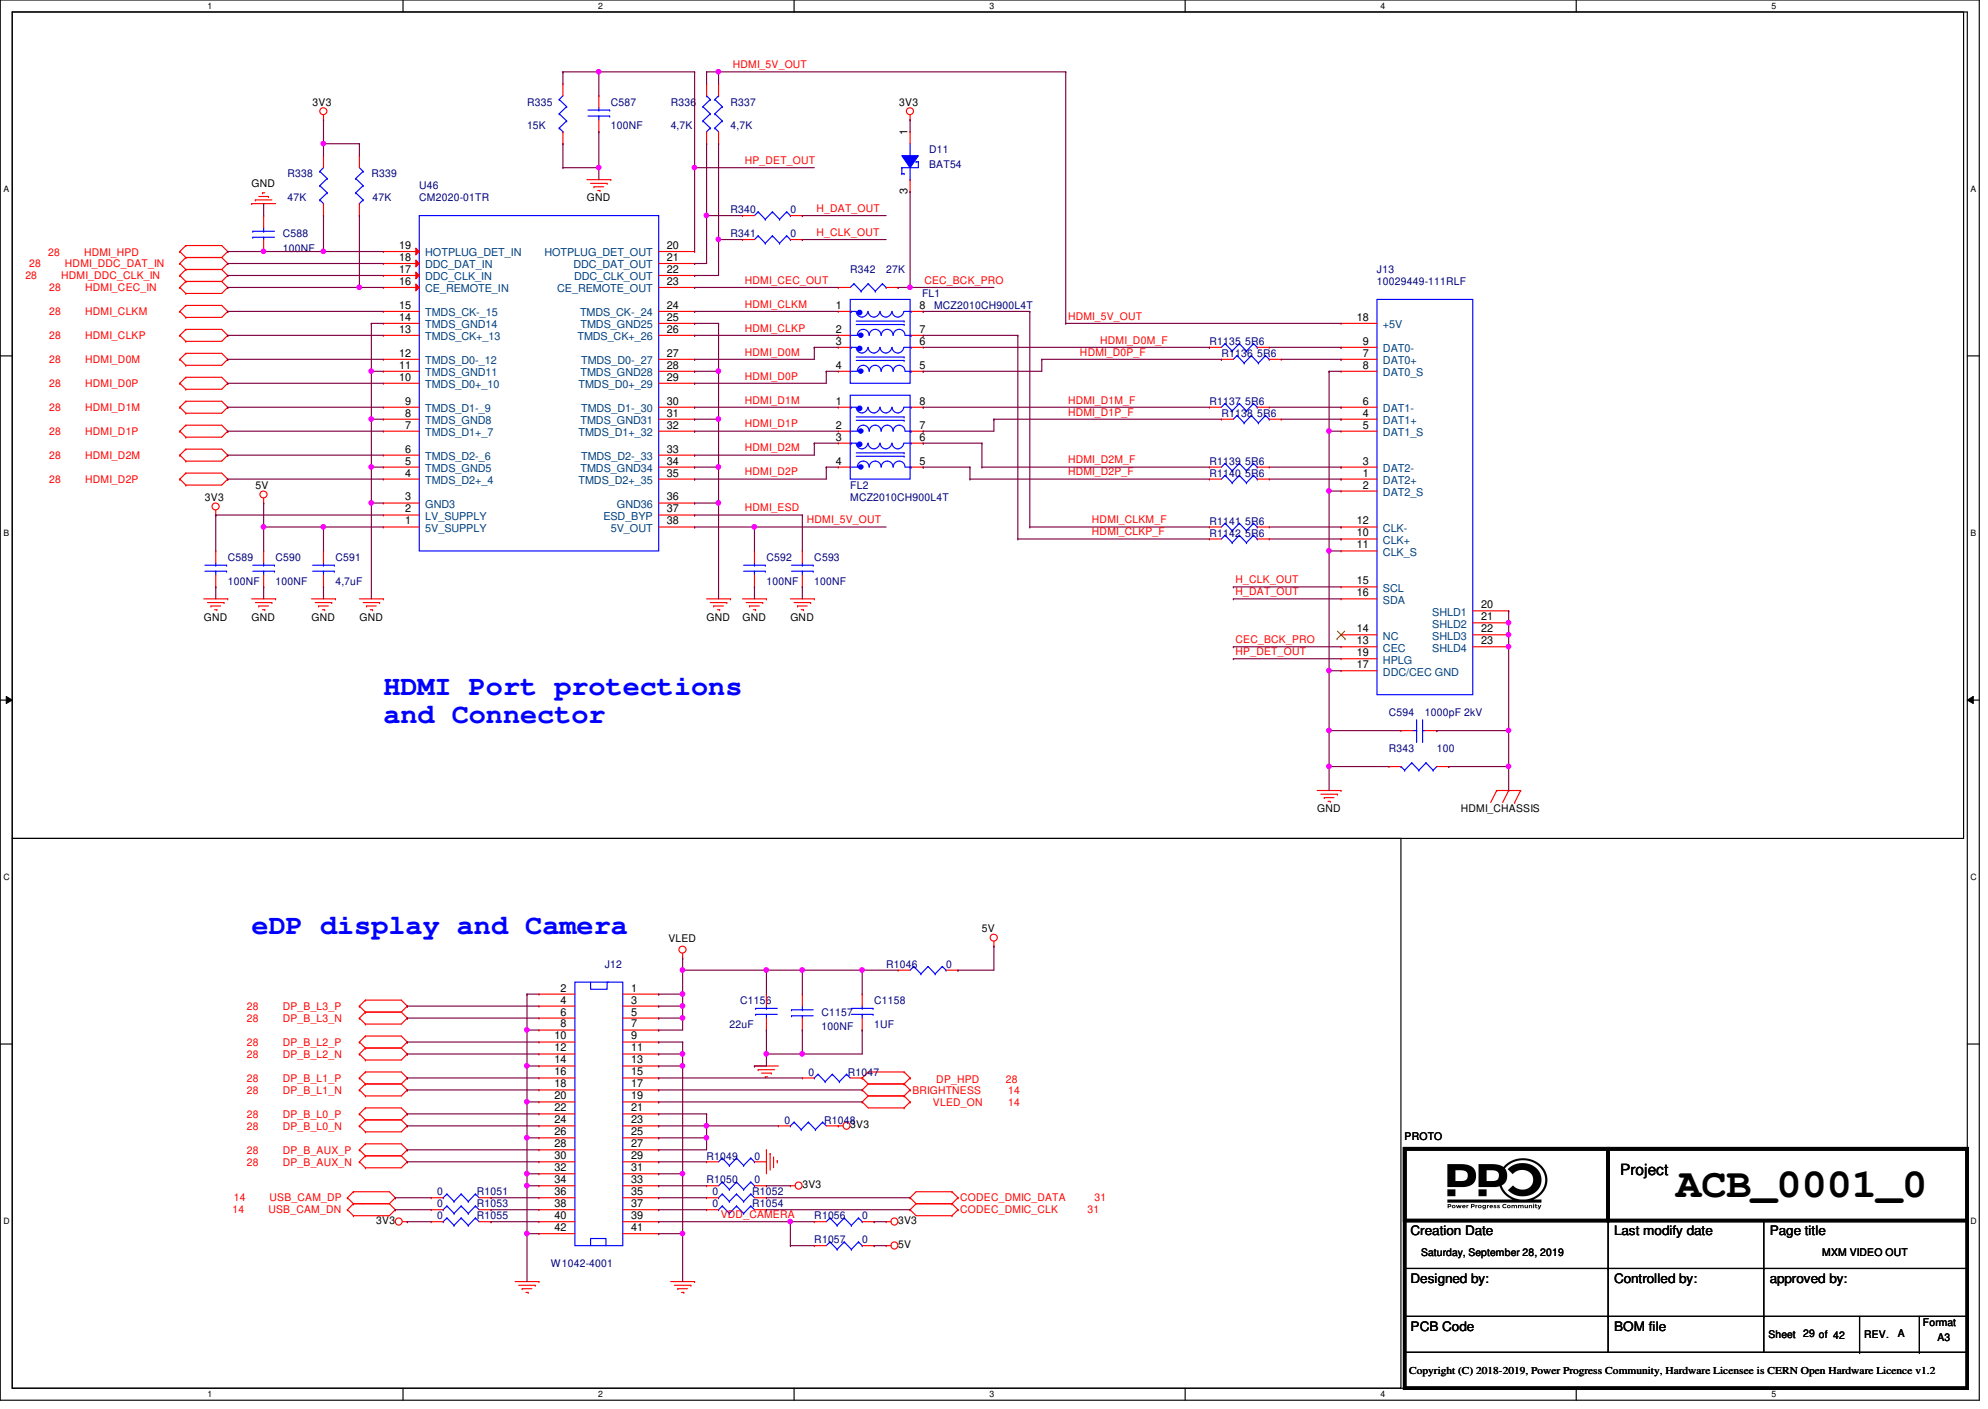
[picture p152: page 29]

eDP display and Camera

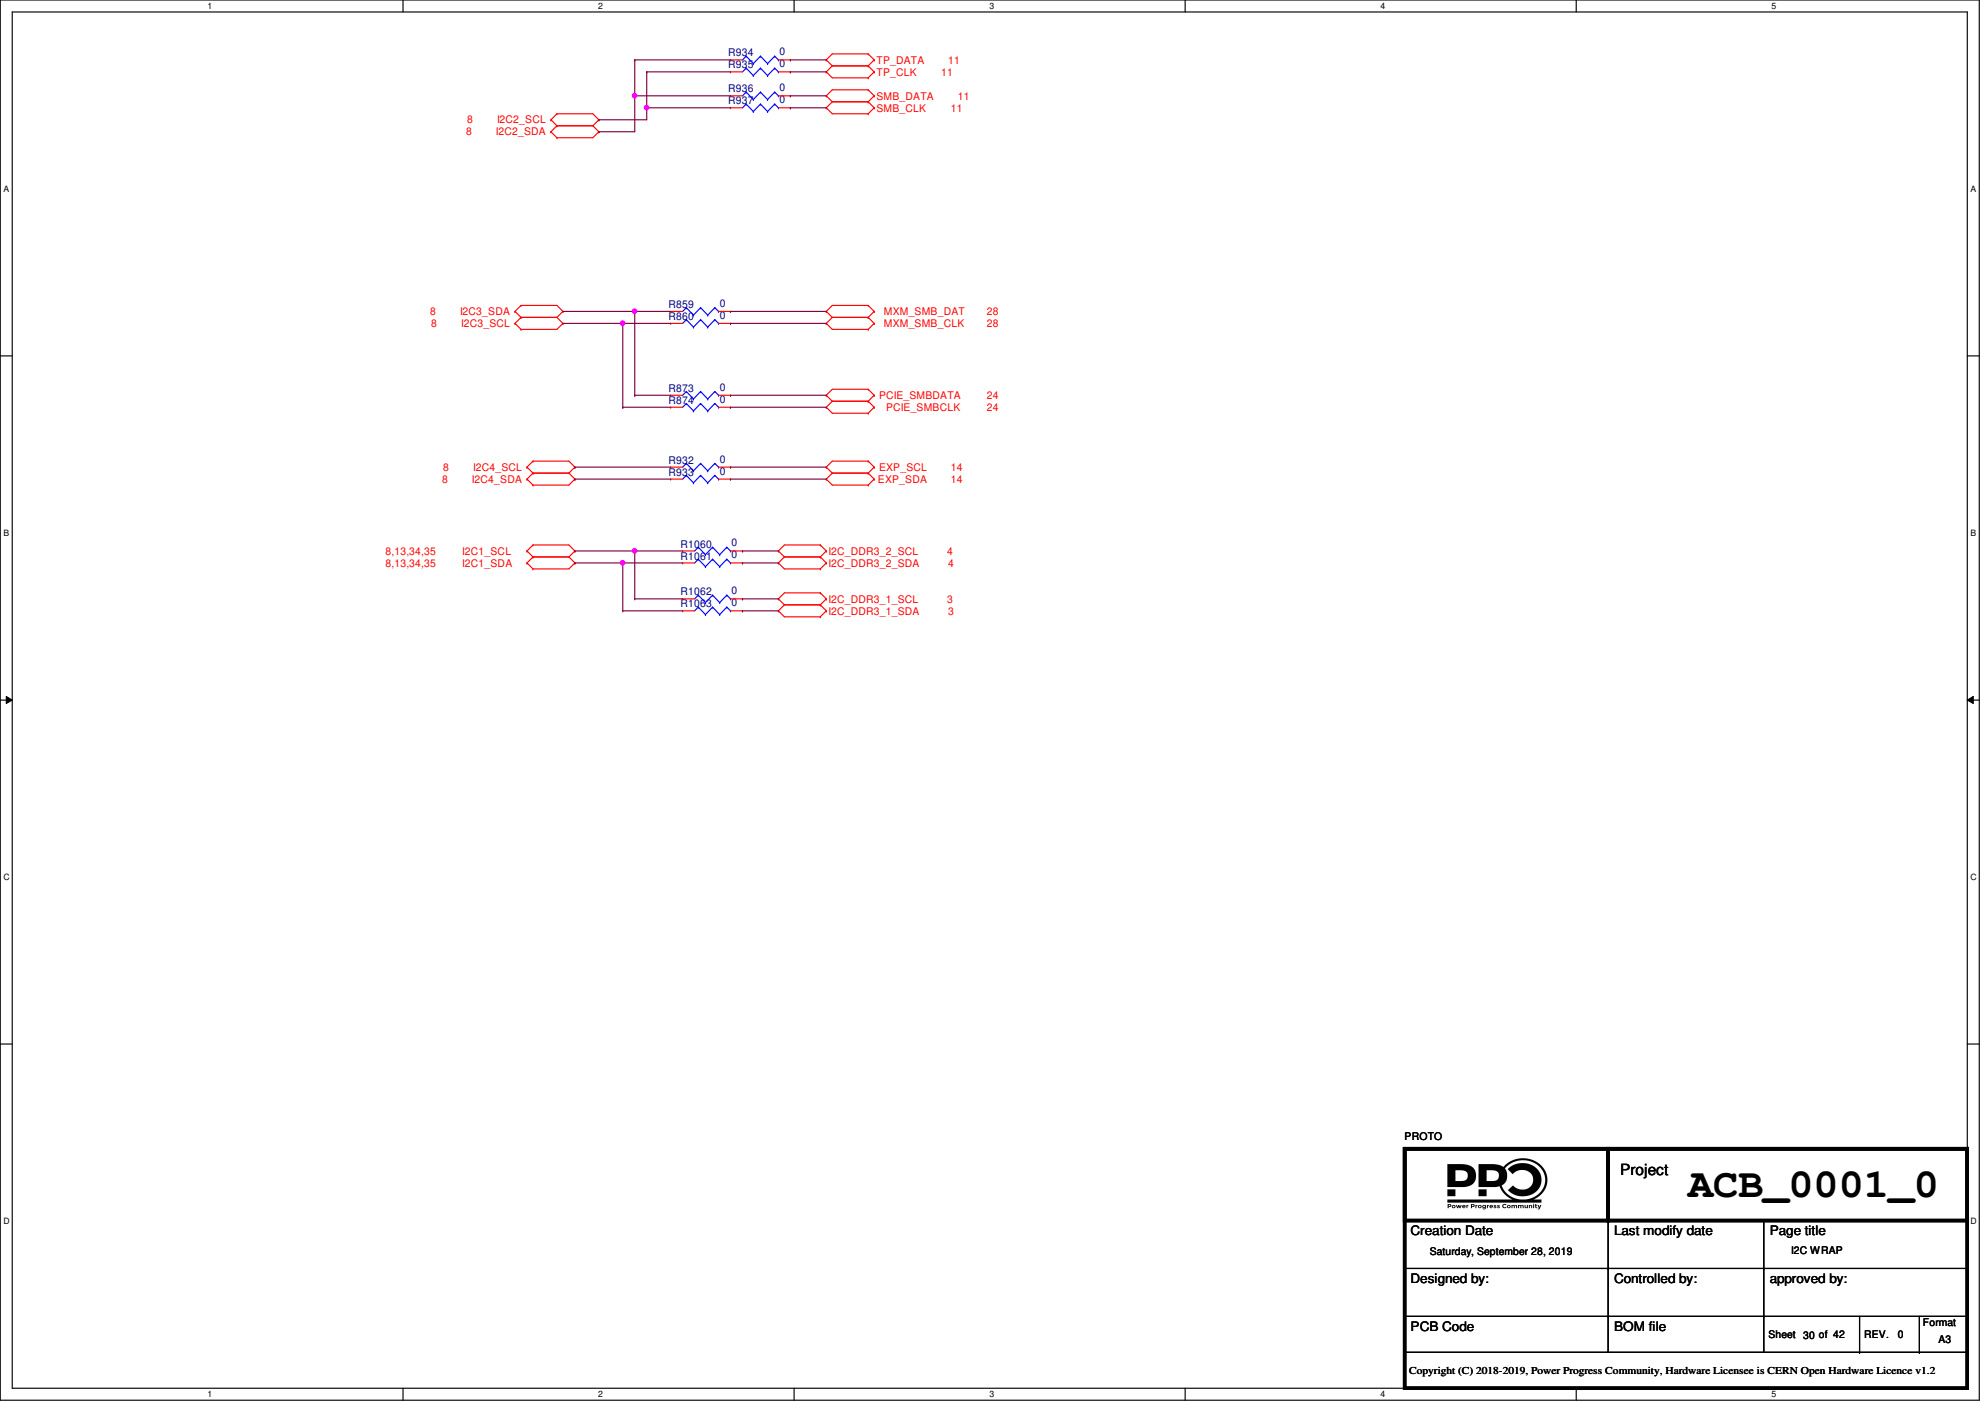
[picture p153: page 30]

Anti-pop noise Ctrl.

## CRYSTAL

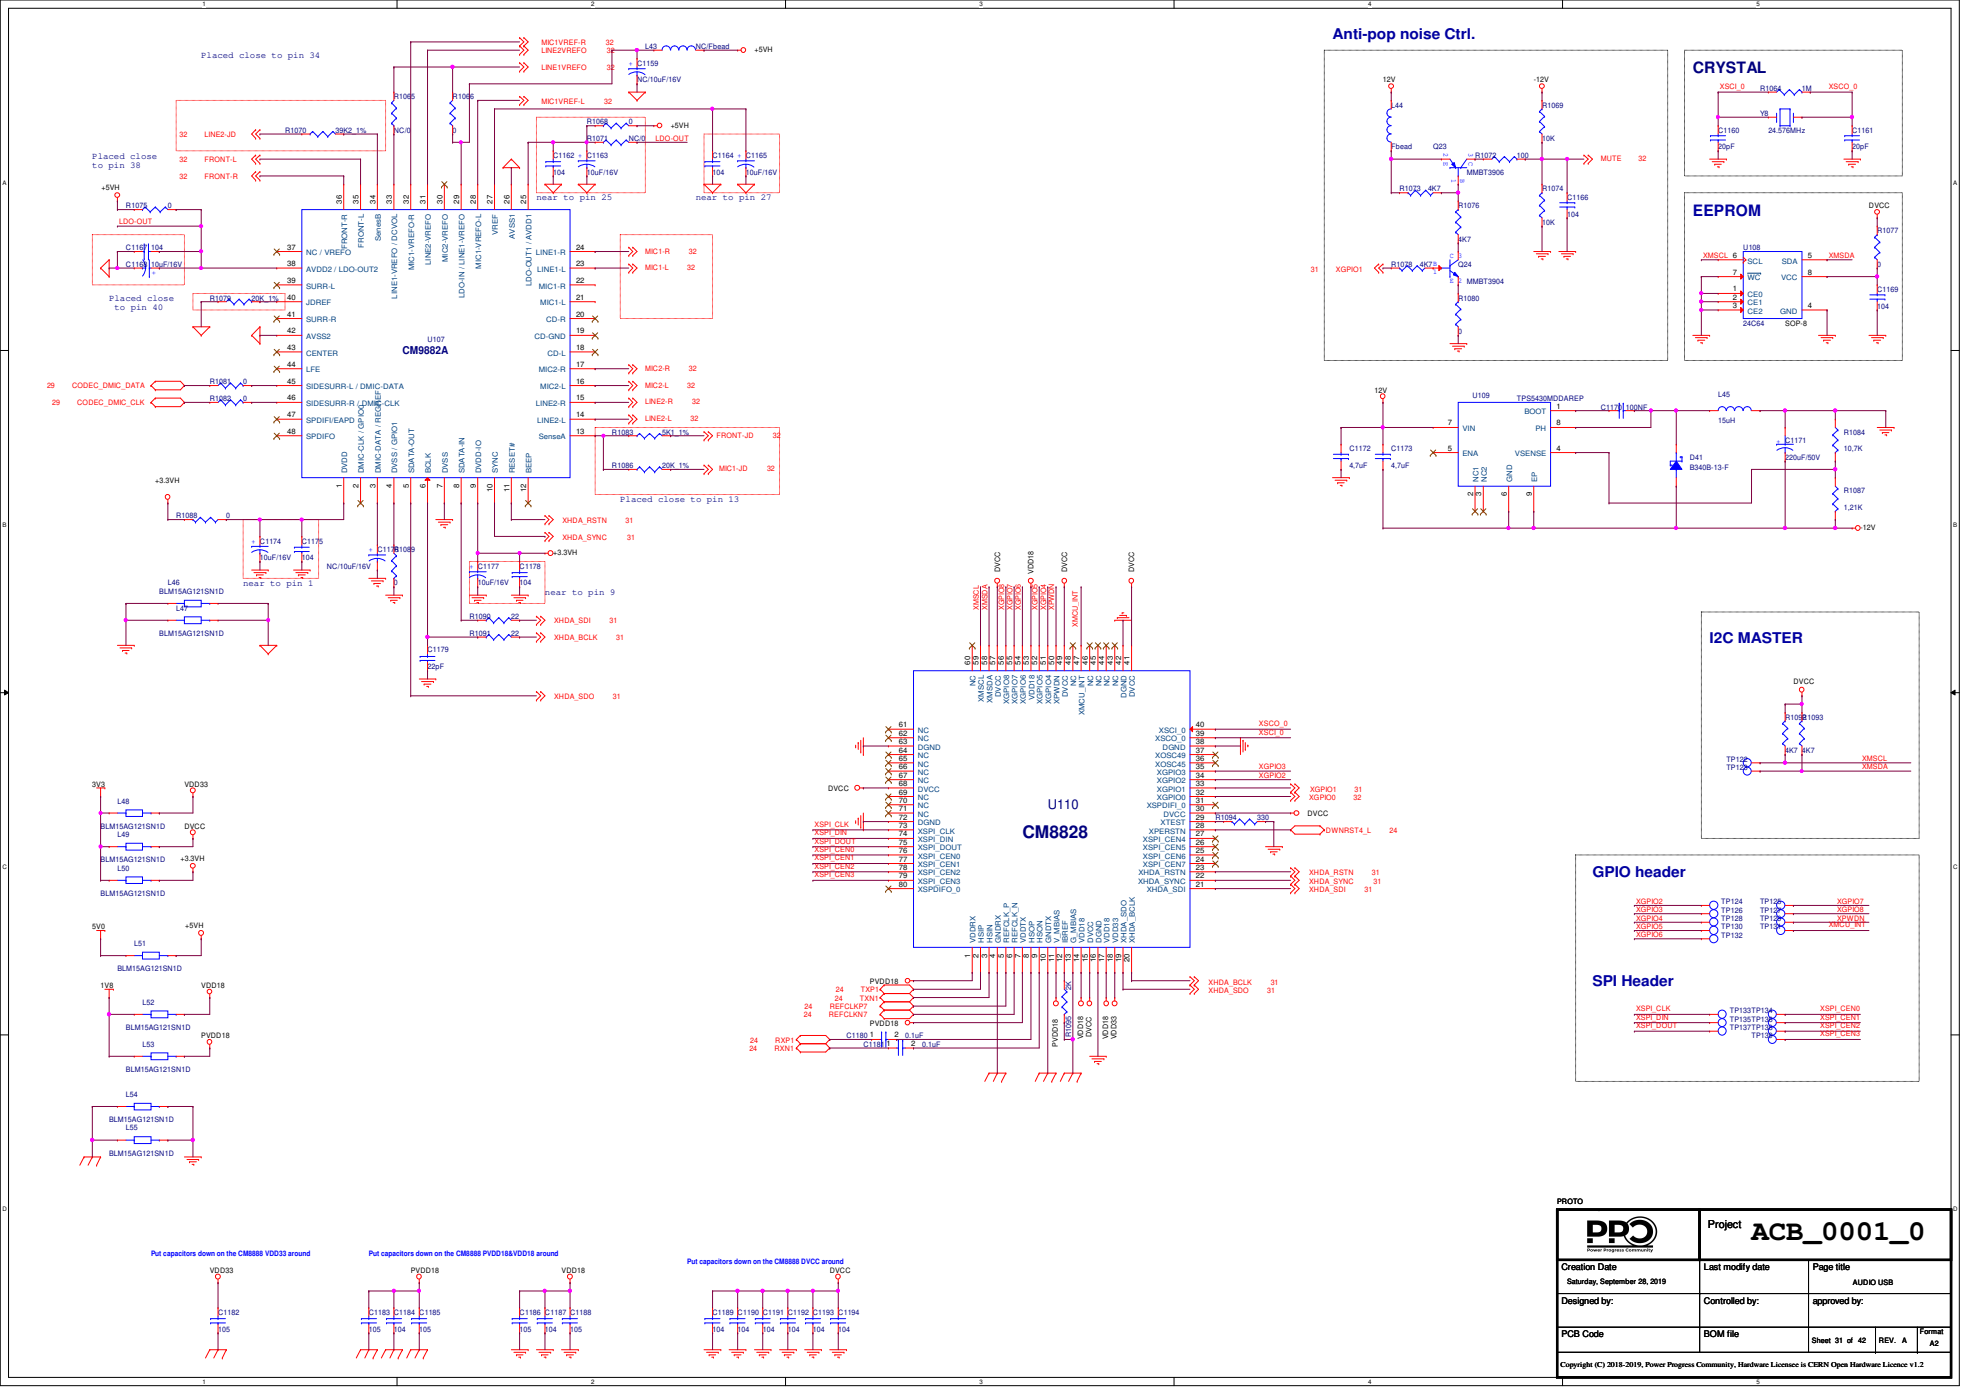
[picture p154: page 31]

Placed close to pin 34

Placed close to pin 13

Put capacitors down on the CM8888 VDD33 around

Put capacitors down on the CM8888 PVDD18&VDD18 around

Put capacitors down on the CM8888 DVCC around

# EXTERNAL JACK

# EXT MIC IN

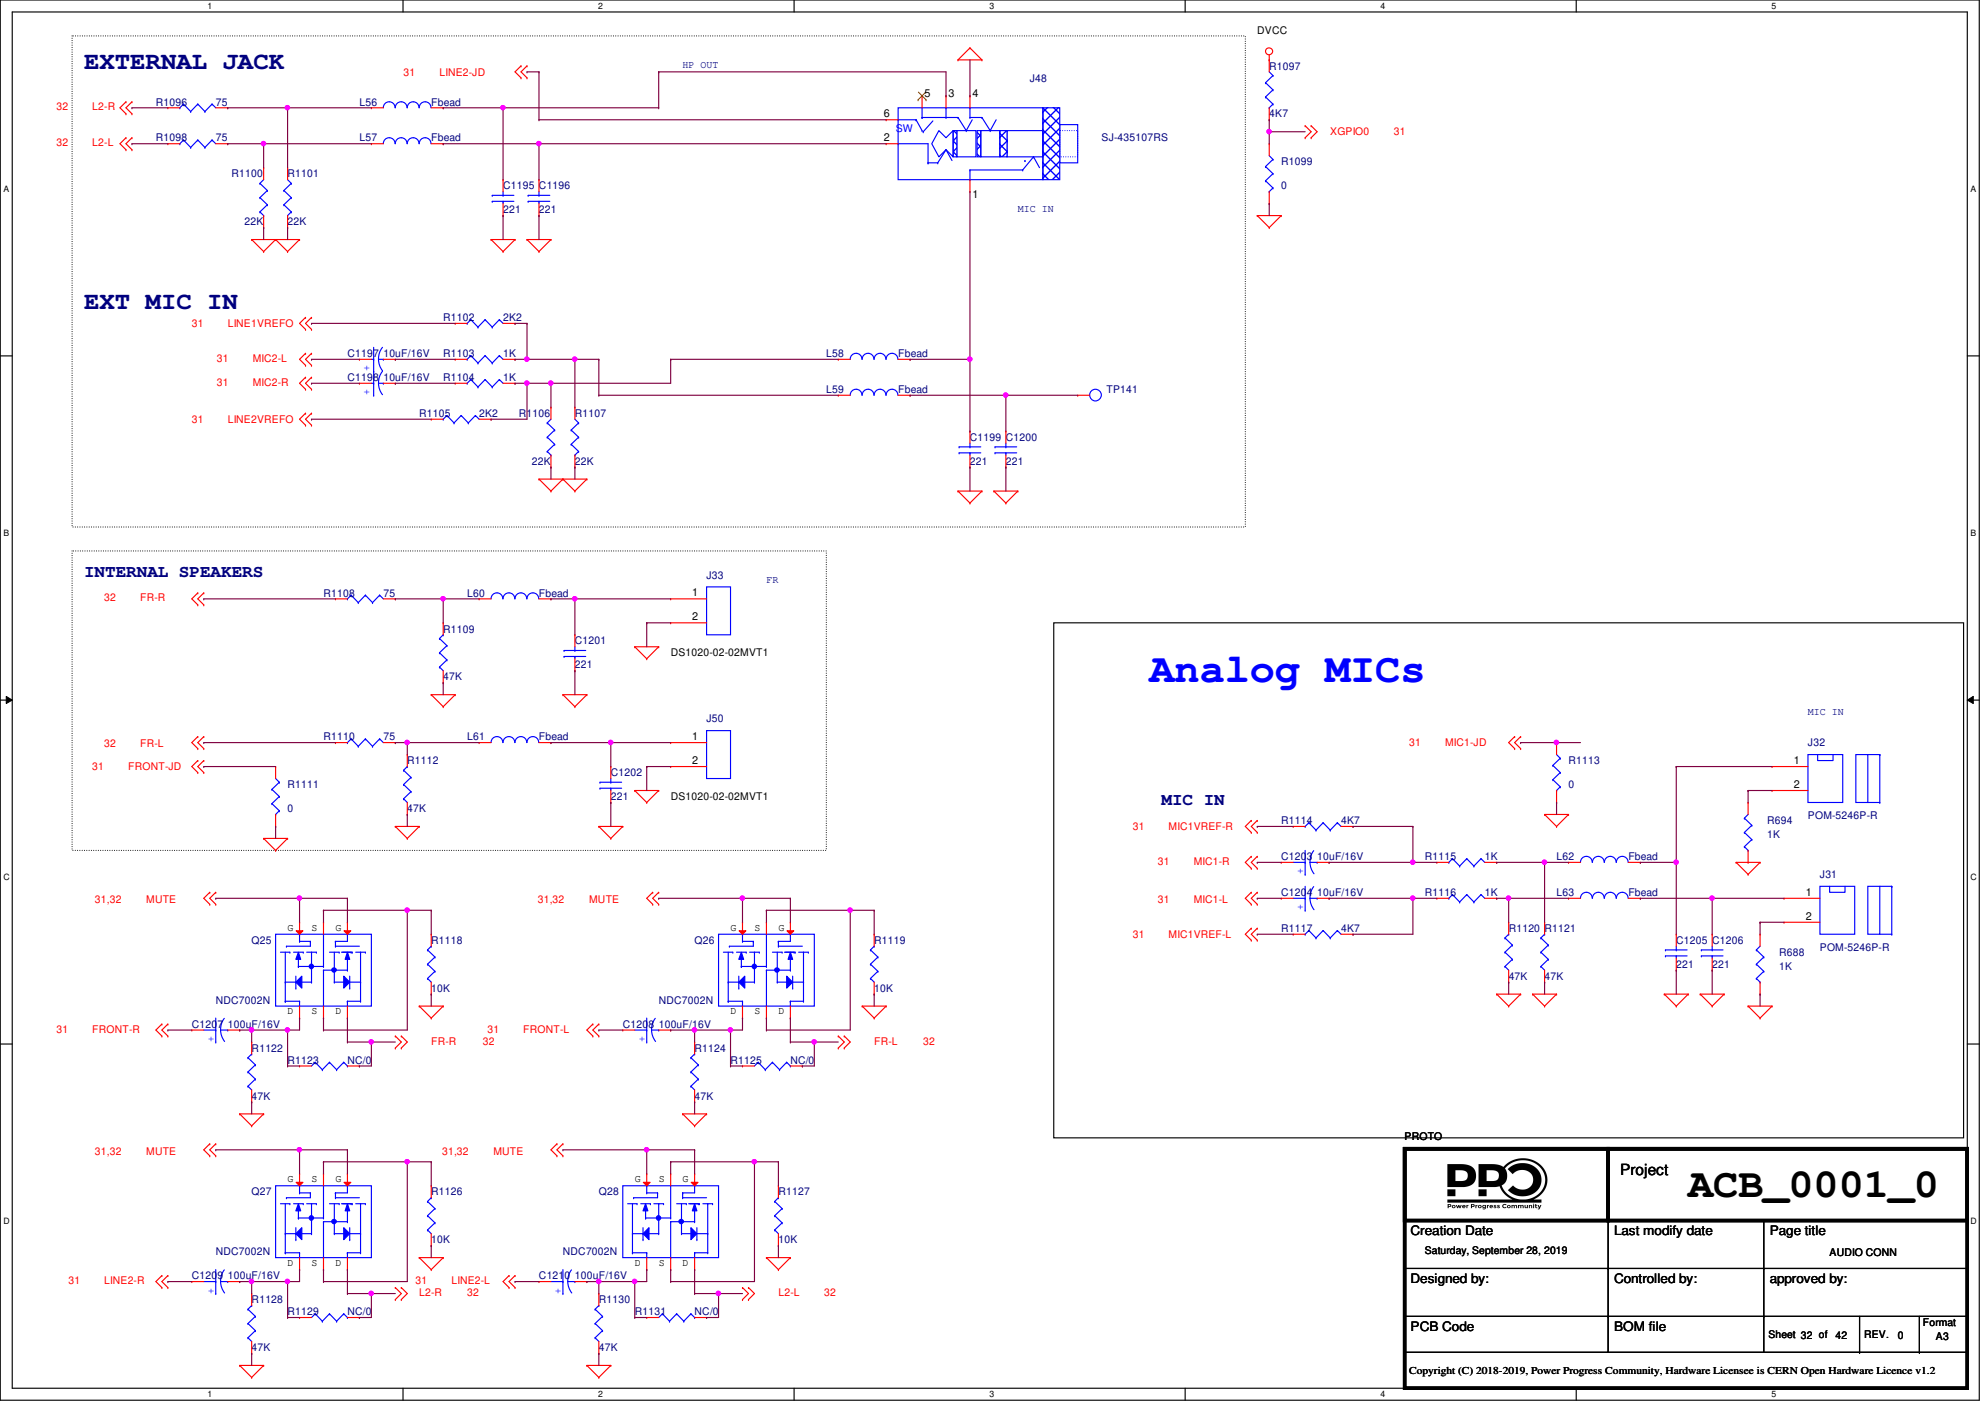
[picture p155: page 32]

# SYSTEM CLOCK GENERATORs

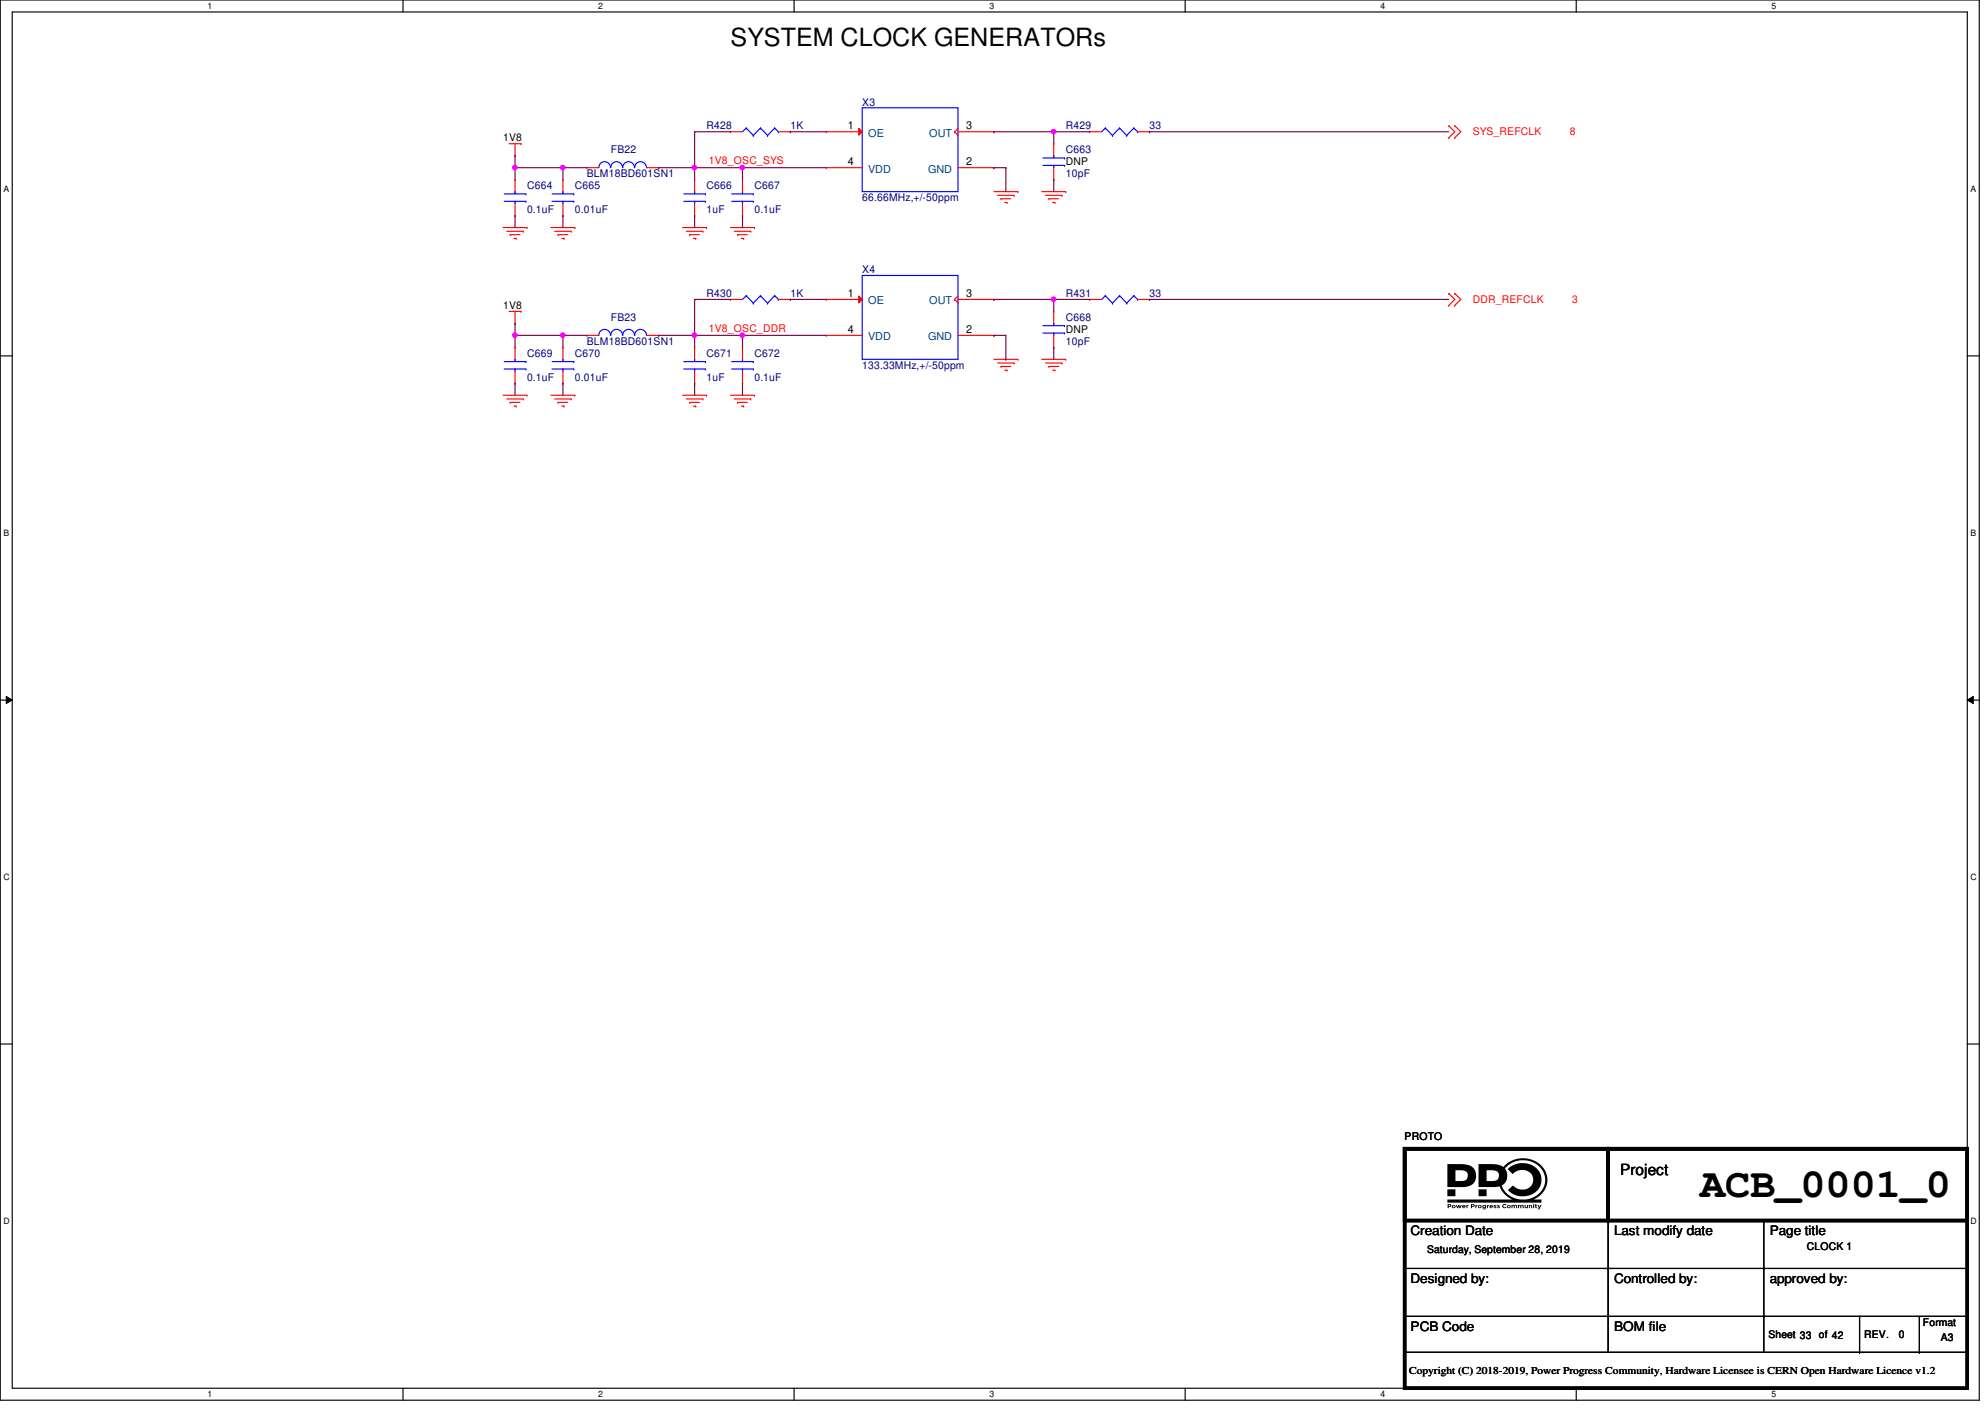
[picture p156: page 33]

# SYSTEM CLOCK GENERATORs (cont.)

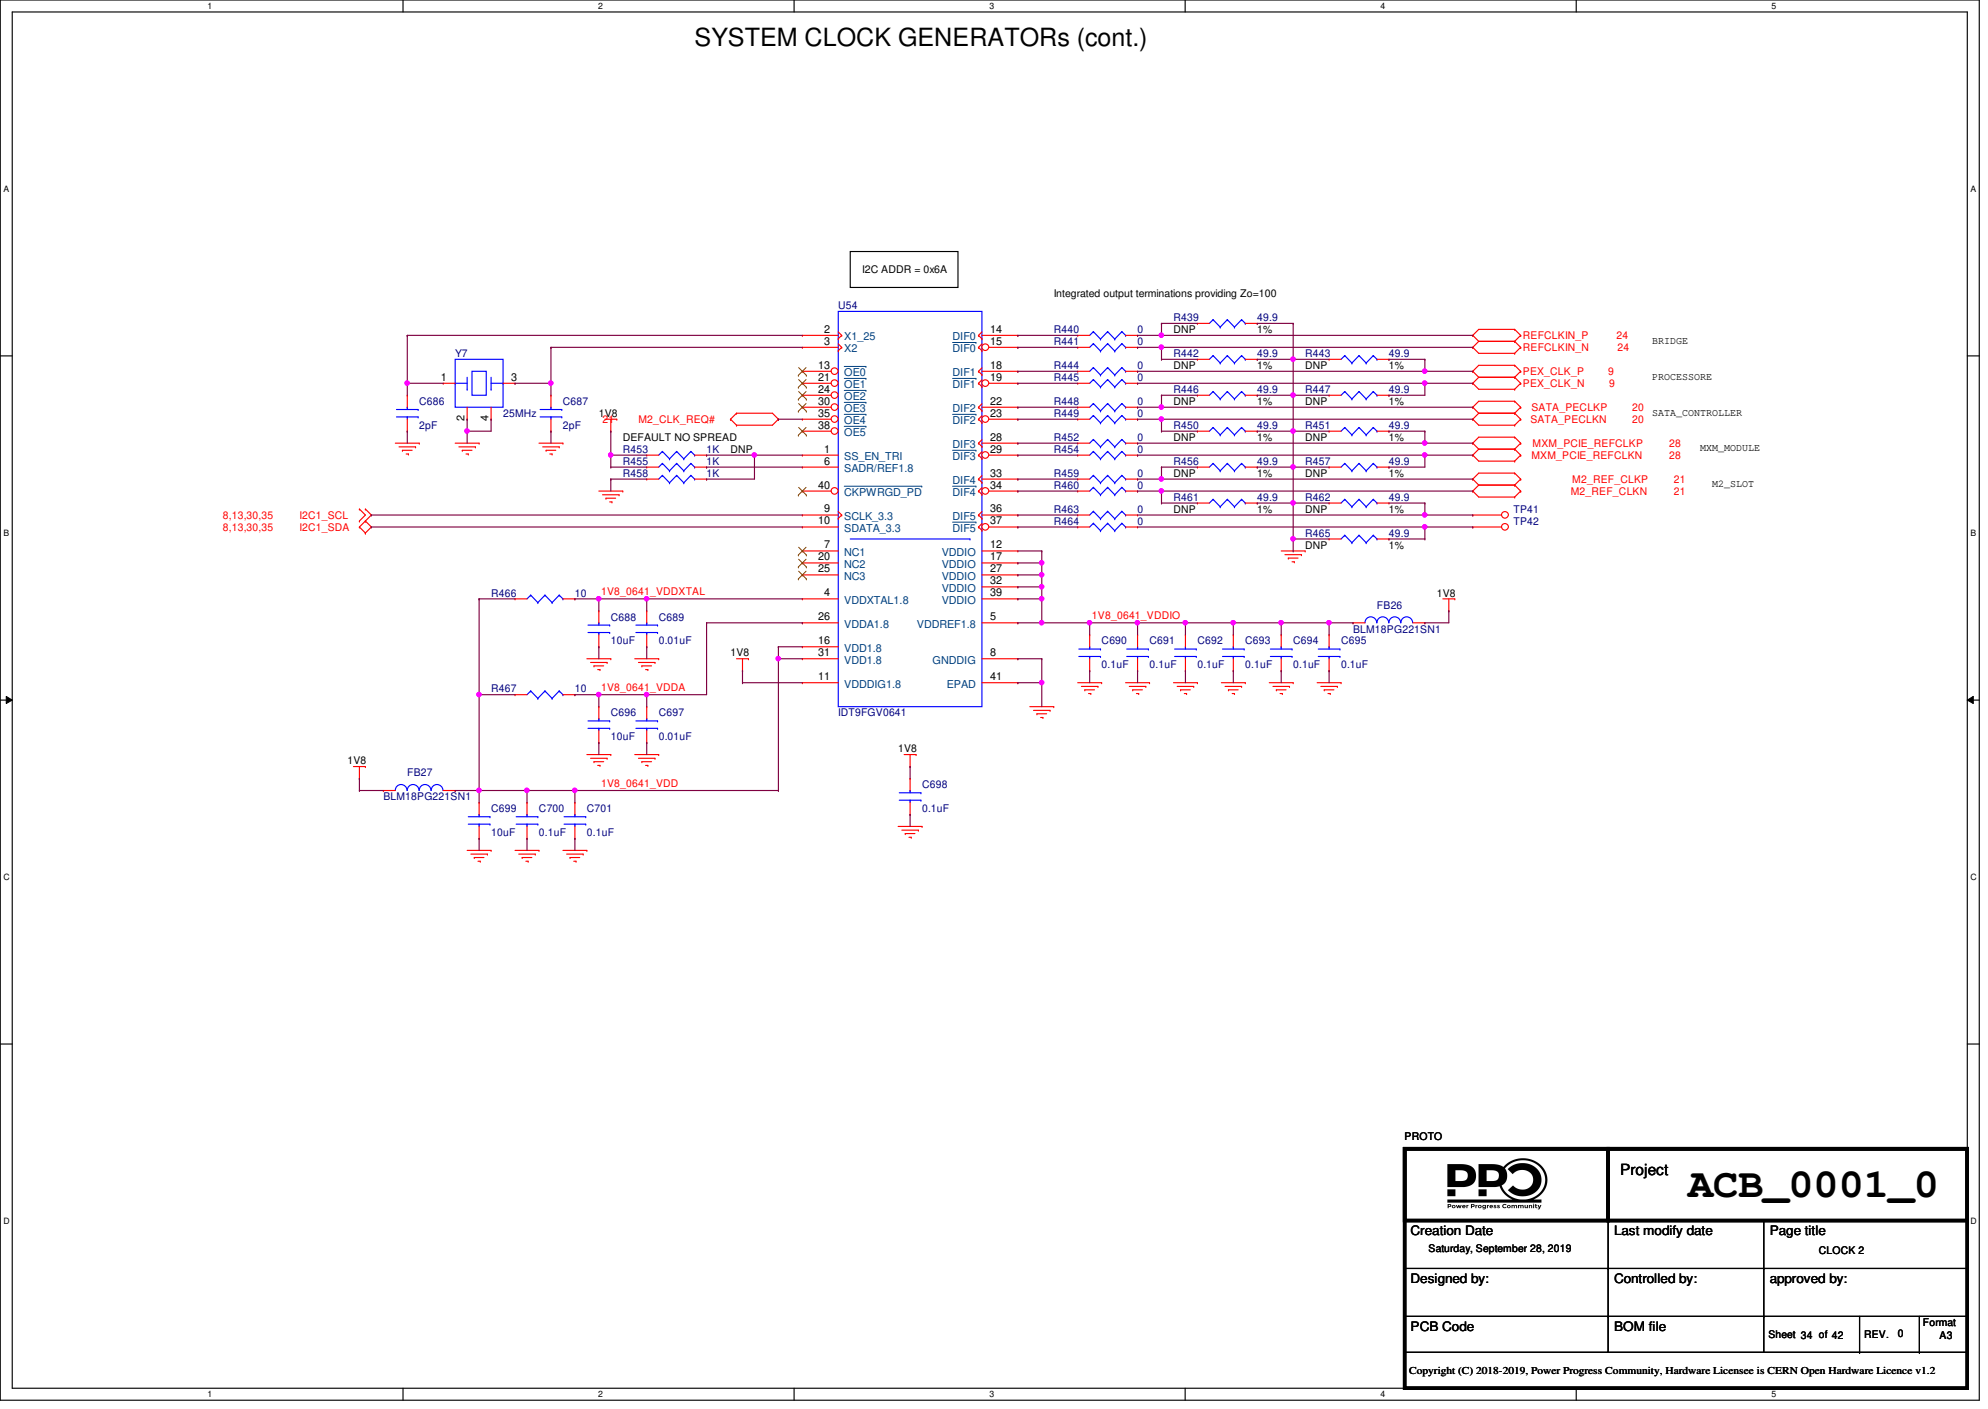
[picture p157: page 34]

Integrated output terminations providing Zo=100

# T2080 CORE POWER CONVERTOR

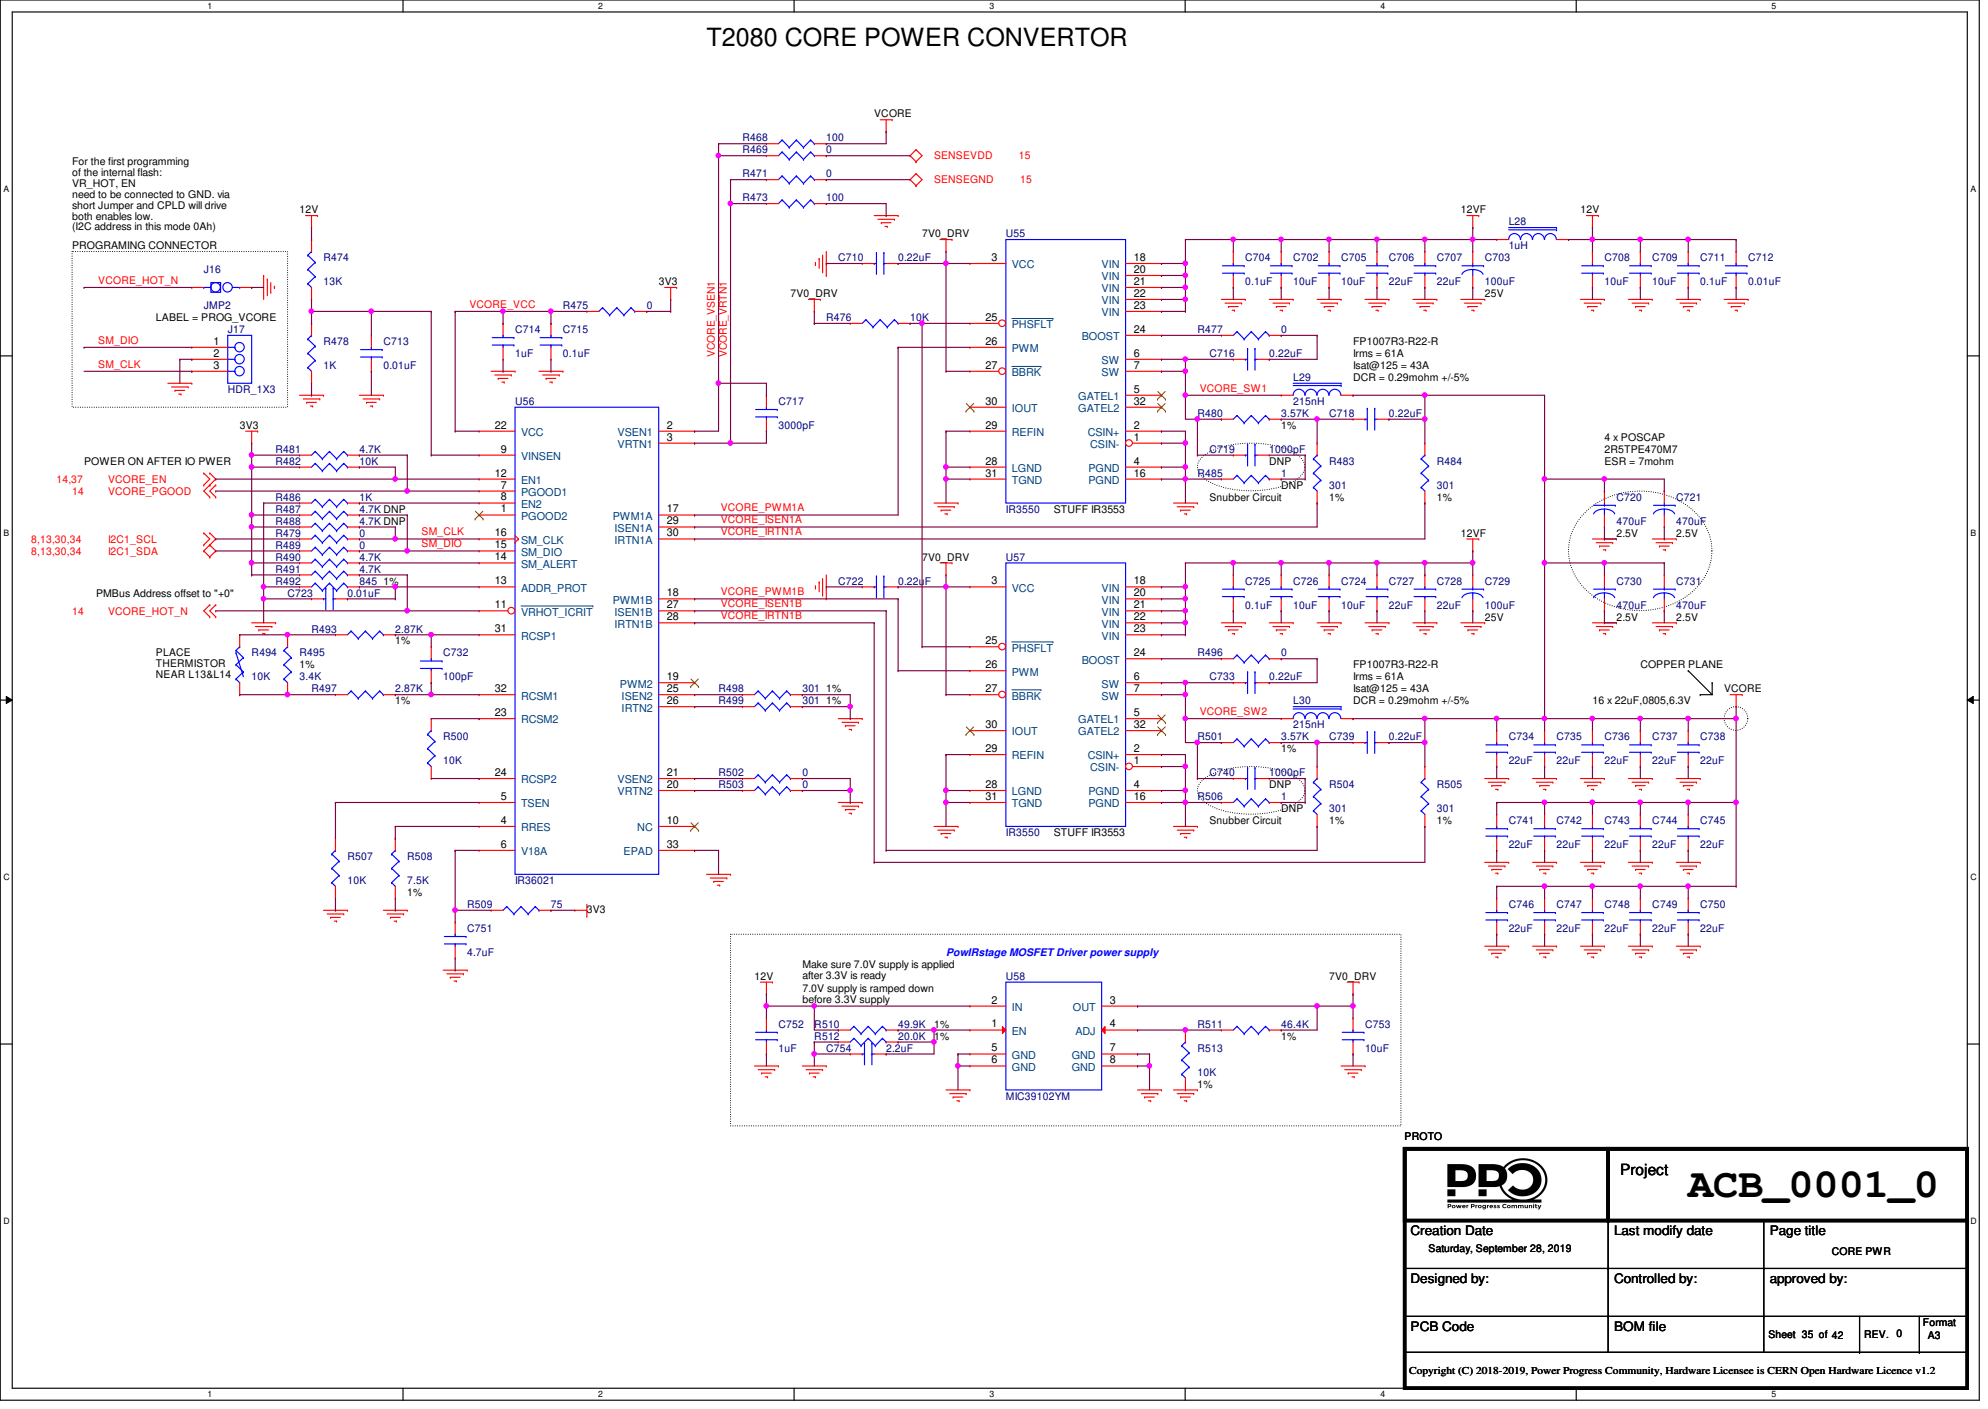
[picture p158: page 35]

For the first programming
of the internal flash:
VR_HOT, EN
need to be connected to GND. via
short Jumper and CPLD will drive
both enables low.
(I2C address in this mode 0Ah)
PROGRAMING CONNECTOR

POWER ON AFTER IO PWER

PMBus Address offset to "+0"

Make sure 7.0V supply is applied
after 3.3V is ready
7.0V supply is ramped down
before 3.3V supply

PowIRstage MOSFET Driver power supply

## MAX 10A

# SYSTEM POWER CONVERTORs

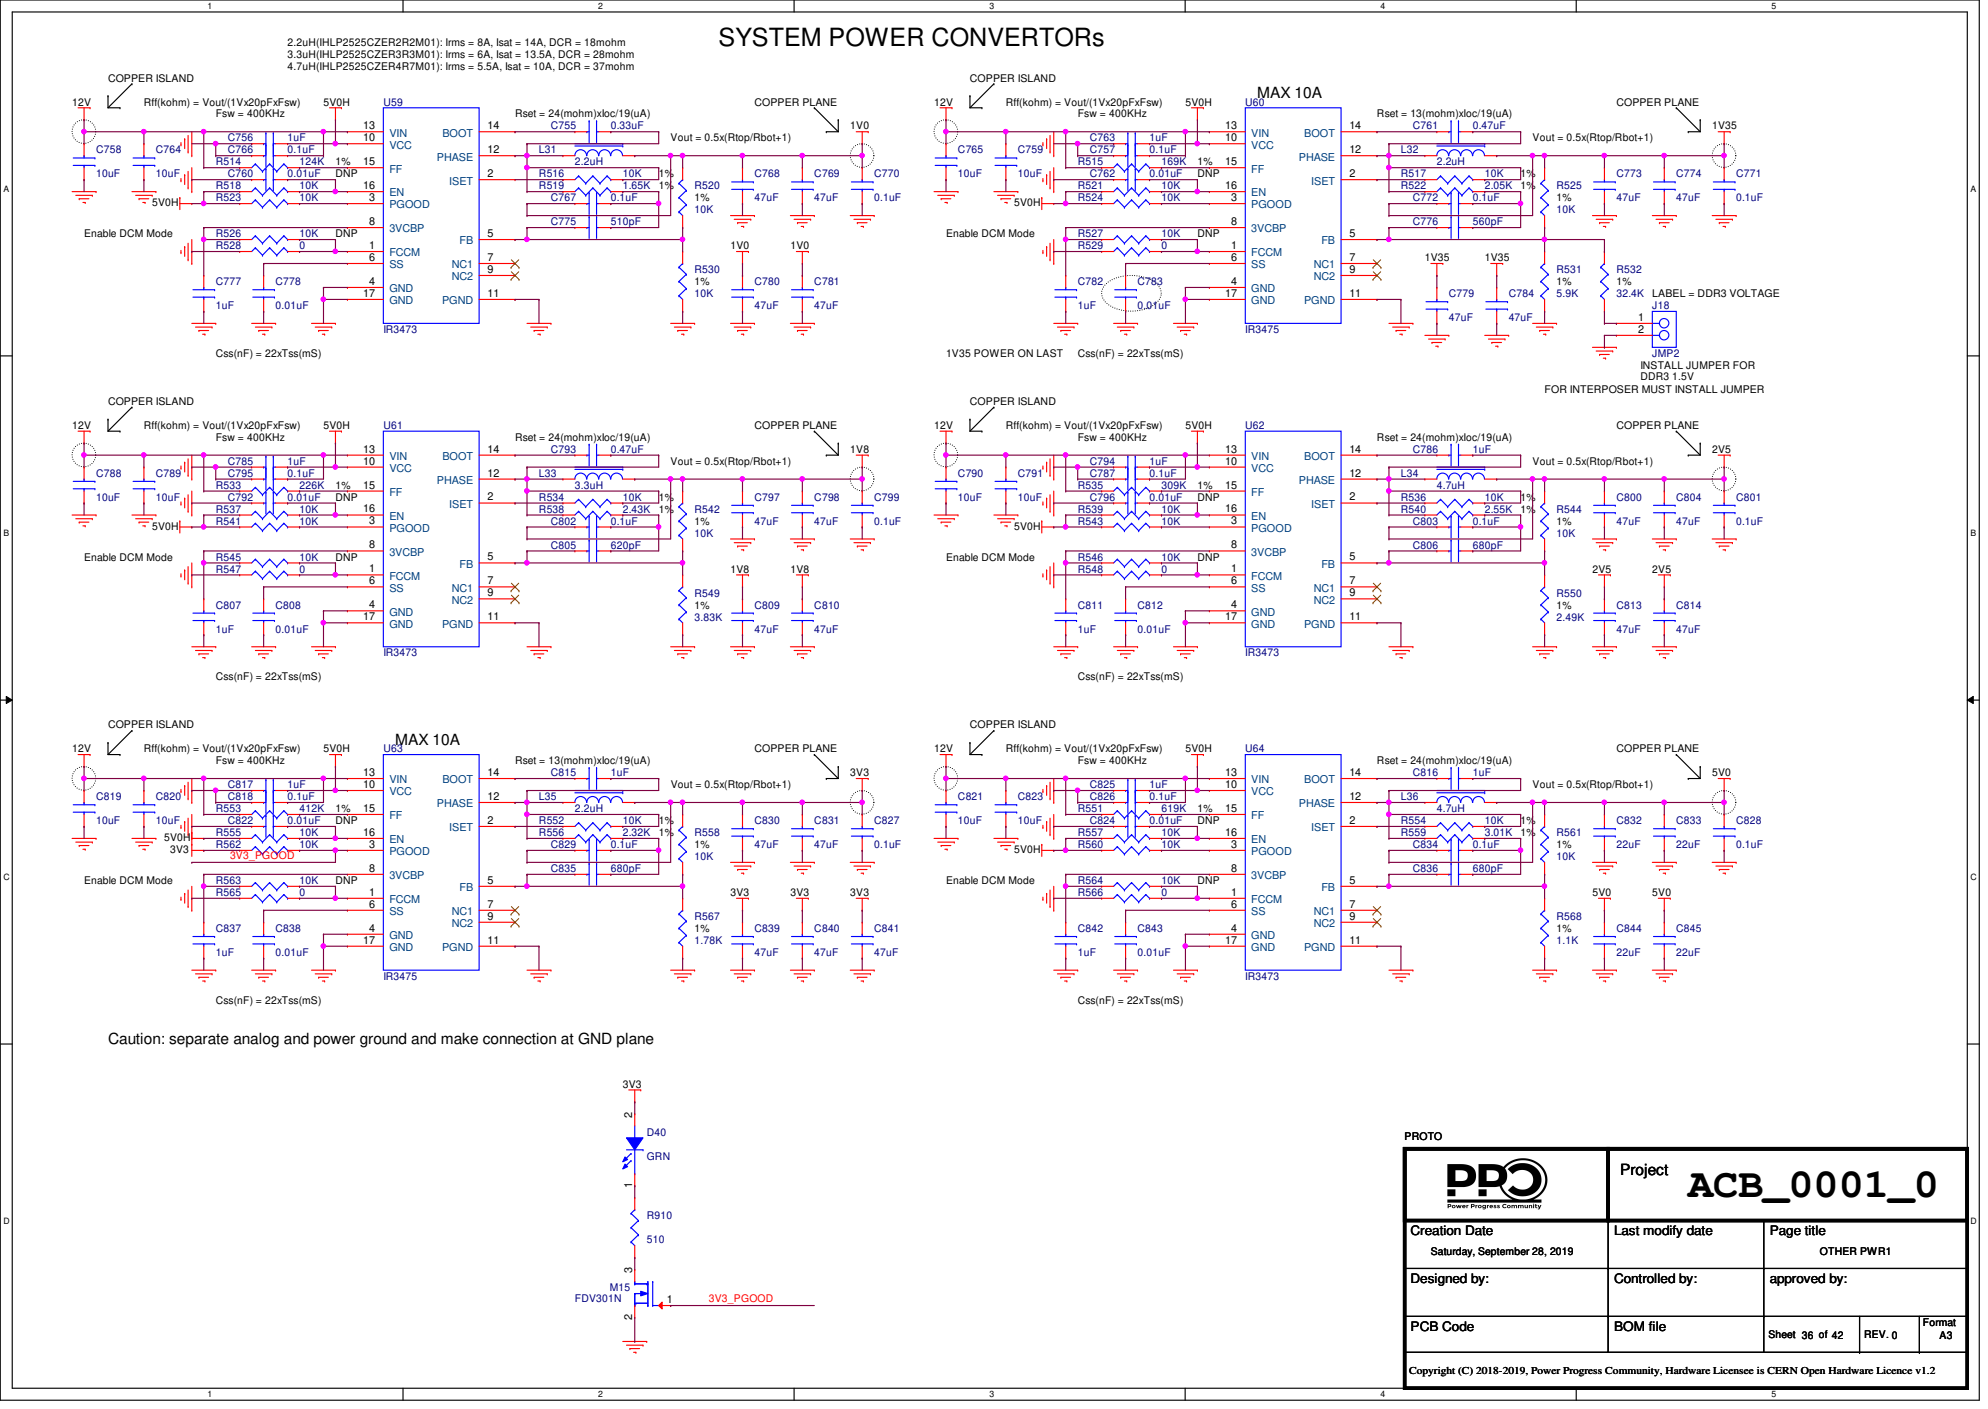
[picture p159: page 36]

Rset = 24(mohm)xIoc/19(uA)

Rset = 13(mohm)xIoc/19(uA)

FOR INTERPOSER MUST INSTALL JUMPER

Caution: separate analog and power ground and make connection at GND plane

# SYSTEM POWER CONVERTORs (cont.)

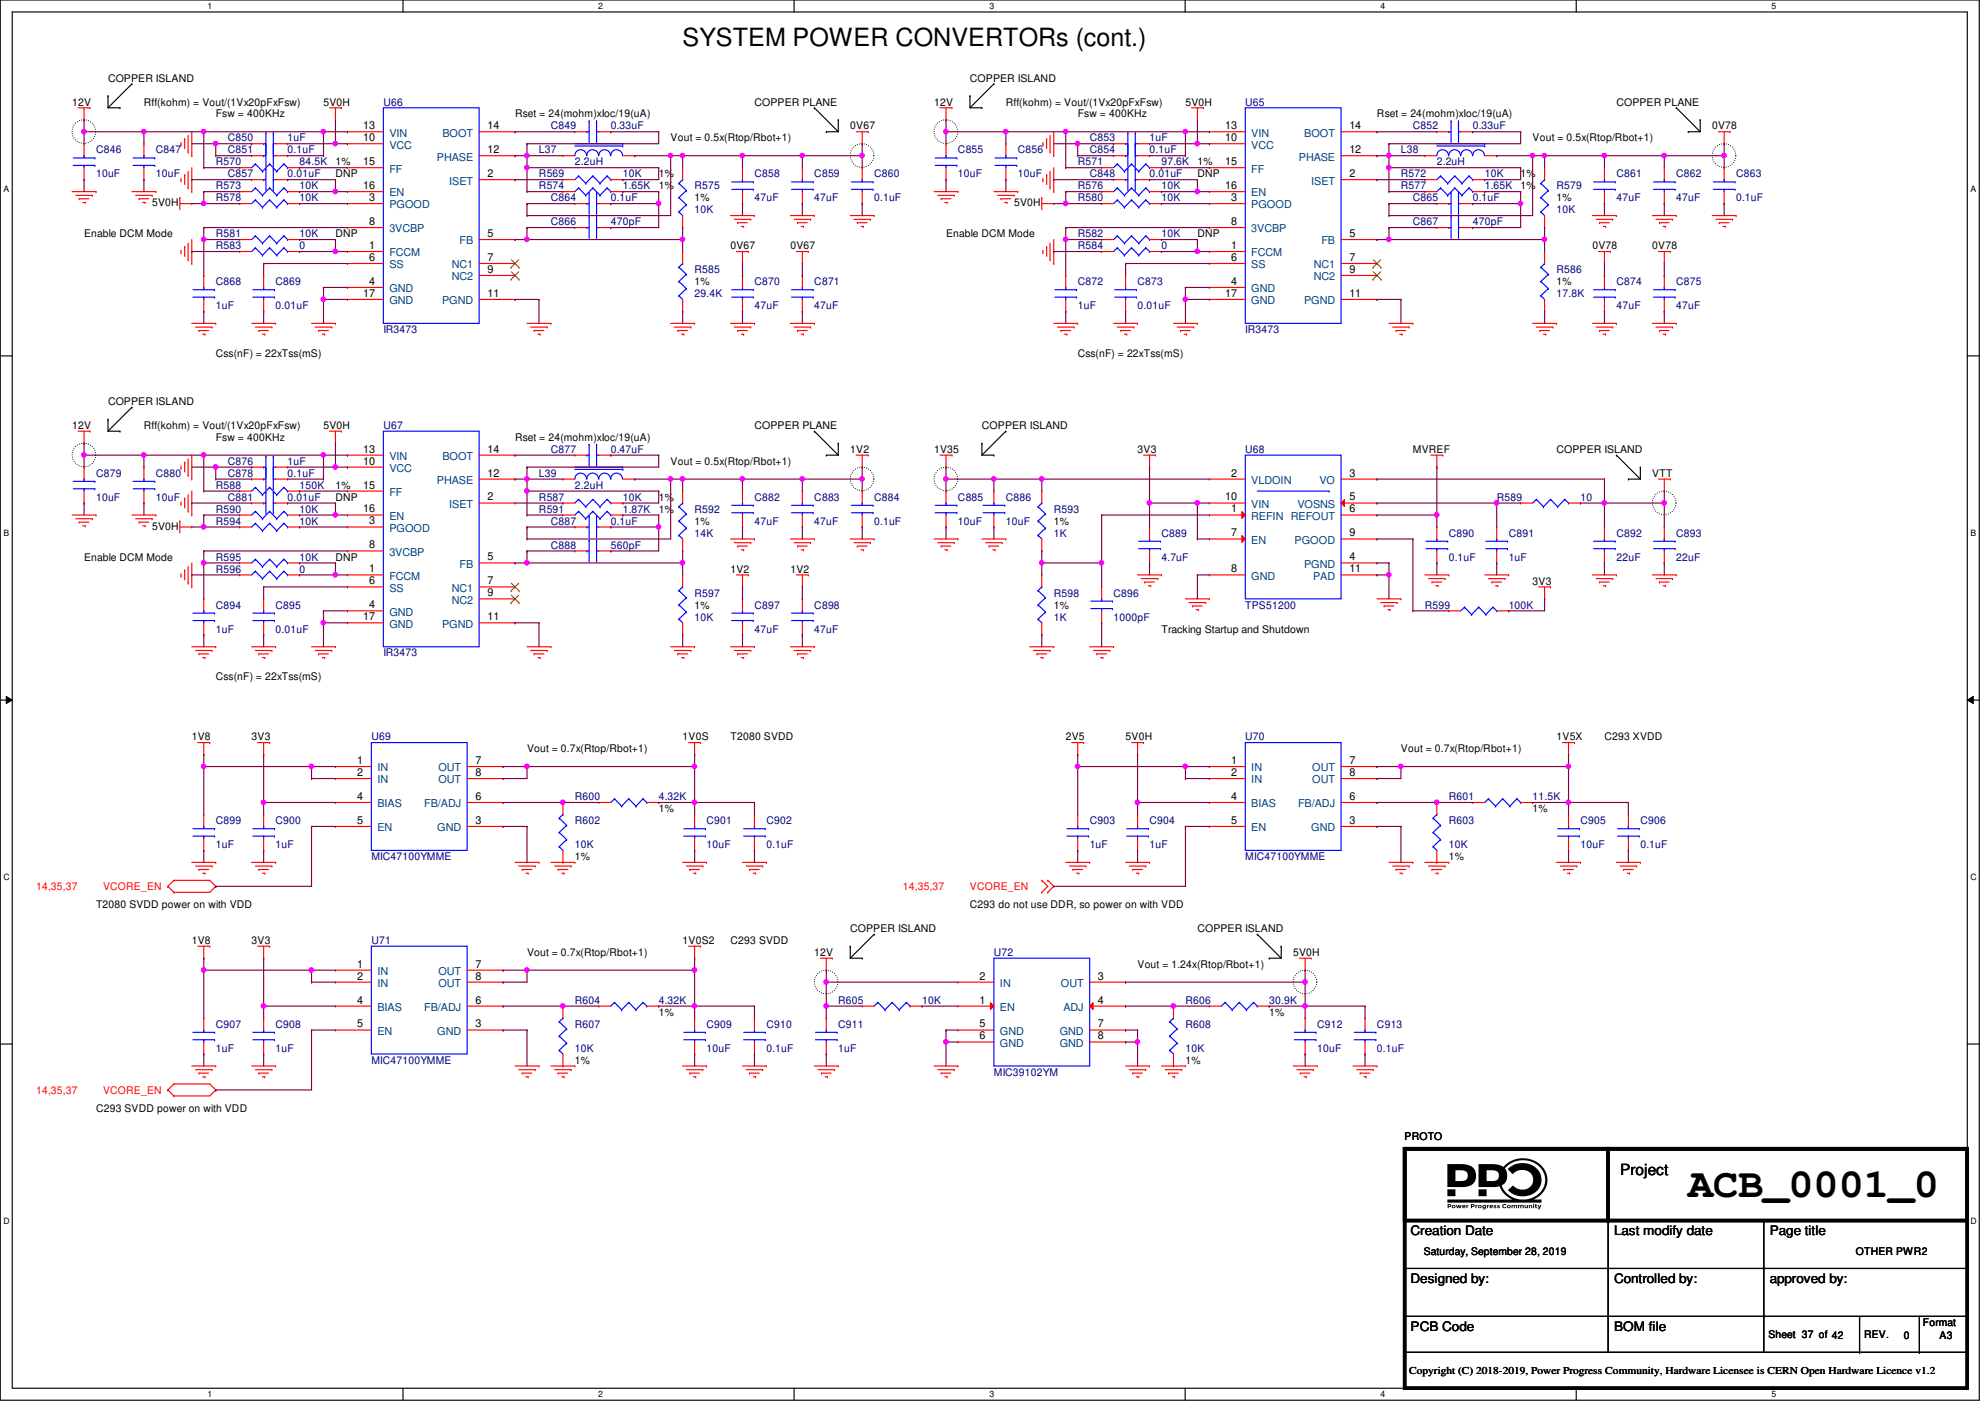
[picture p160: page 37]

Rset = 24(mohm)xIoc/19(uA)

Tracking Startup and Shutdown

C293 SVDD power on with VDD

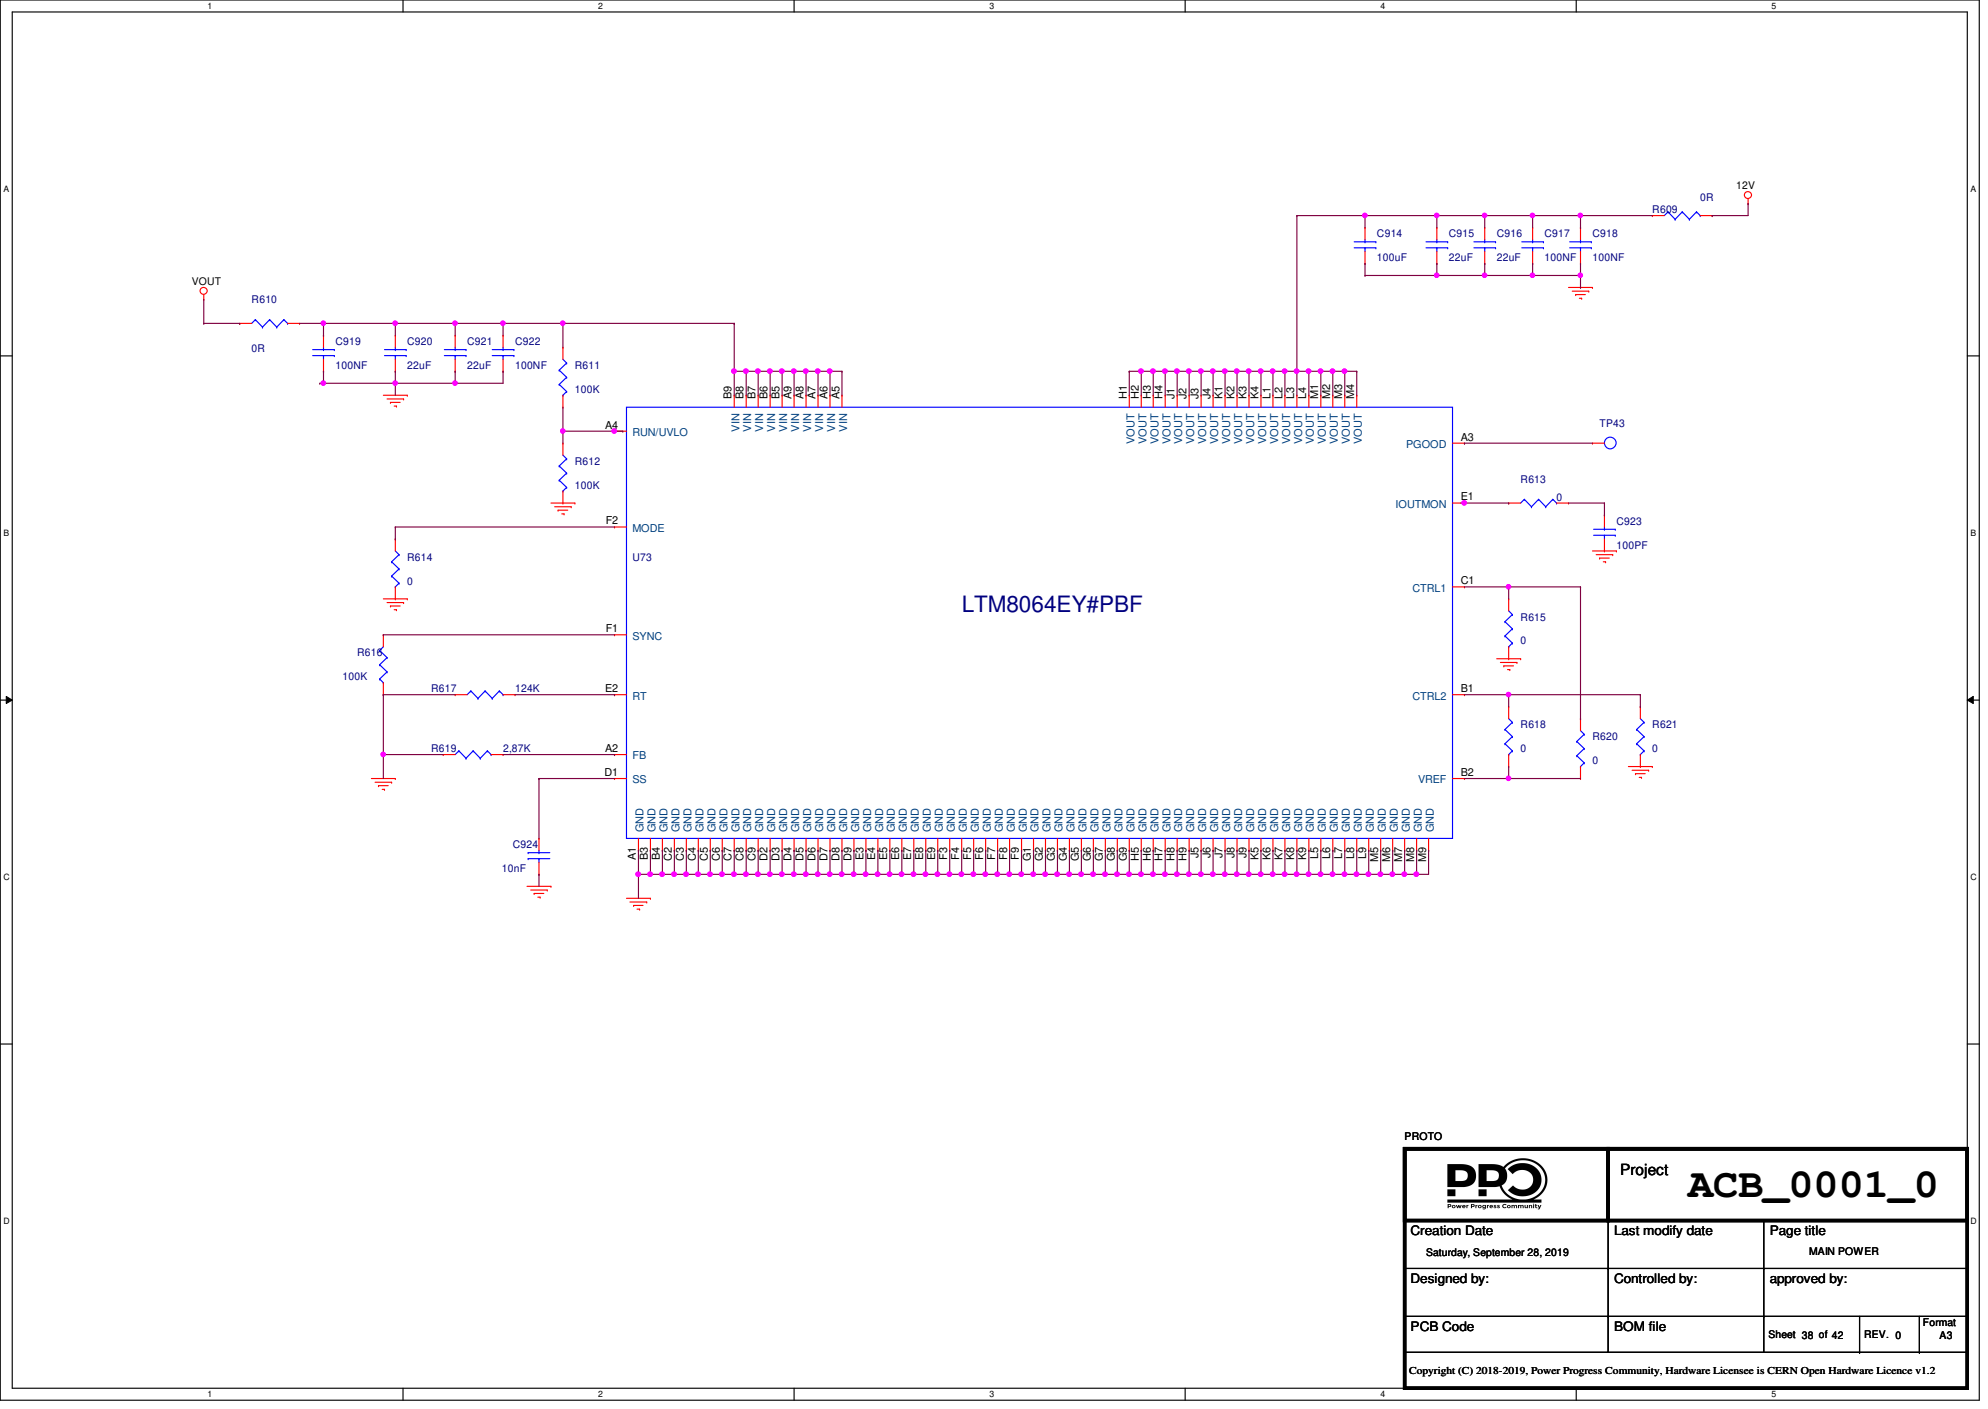
[picture p161: page 38]

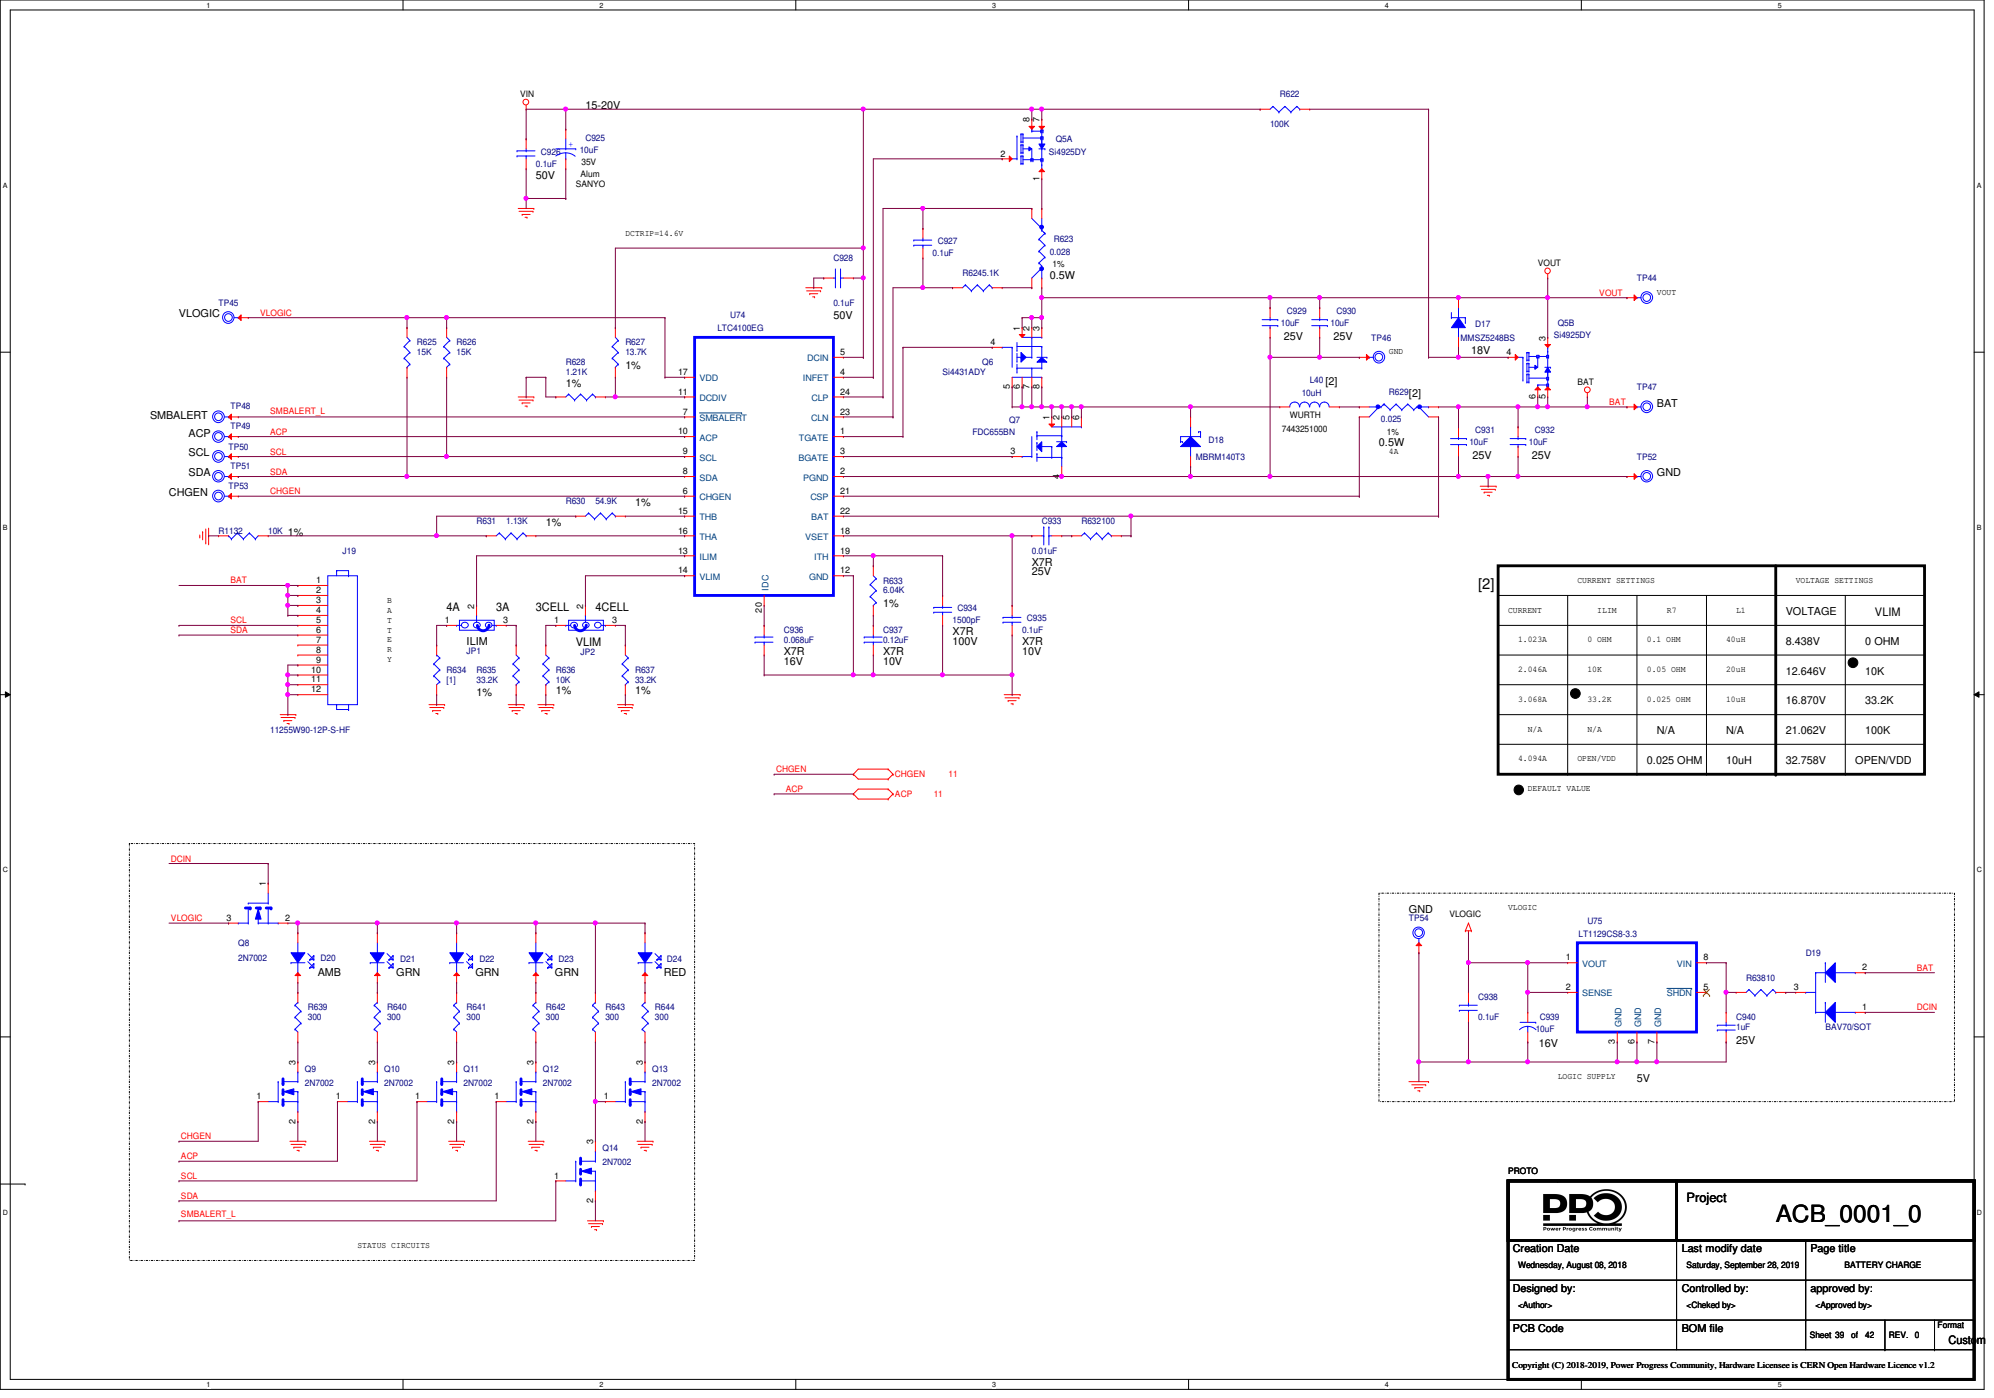
[picture p162: page 39]

# SYSTEM POWER INPUT

## REMOTE RESET

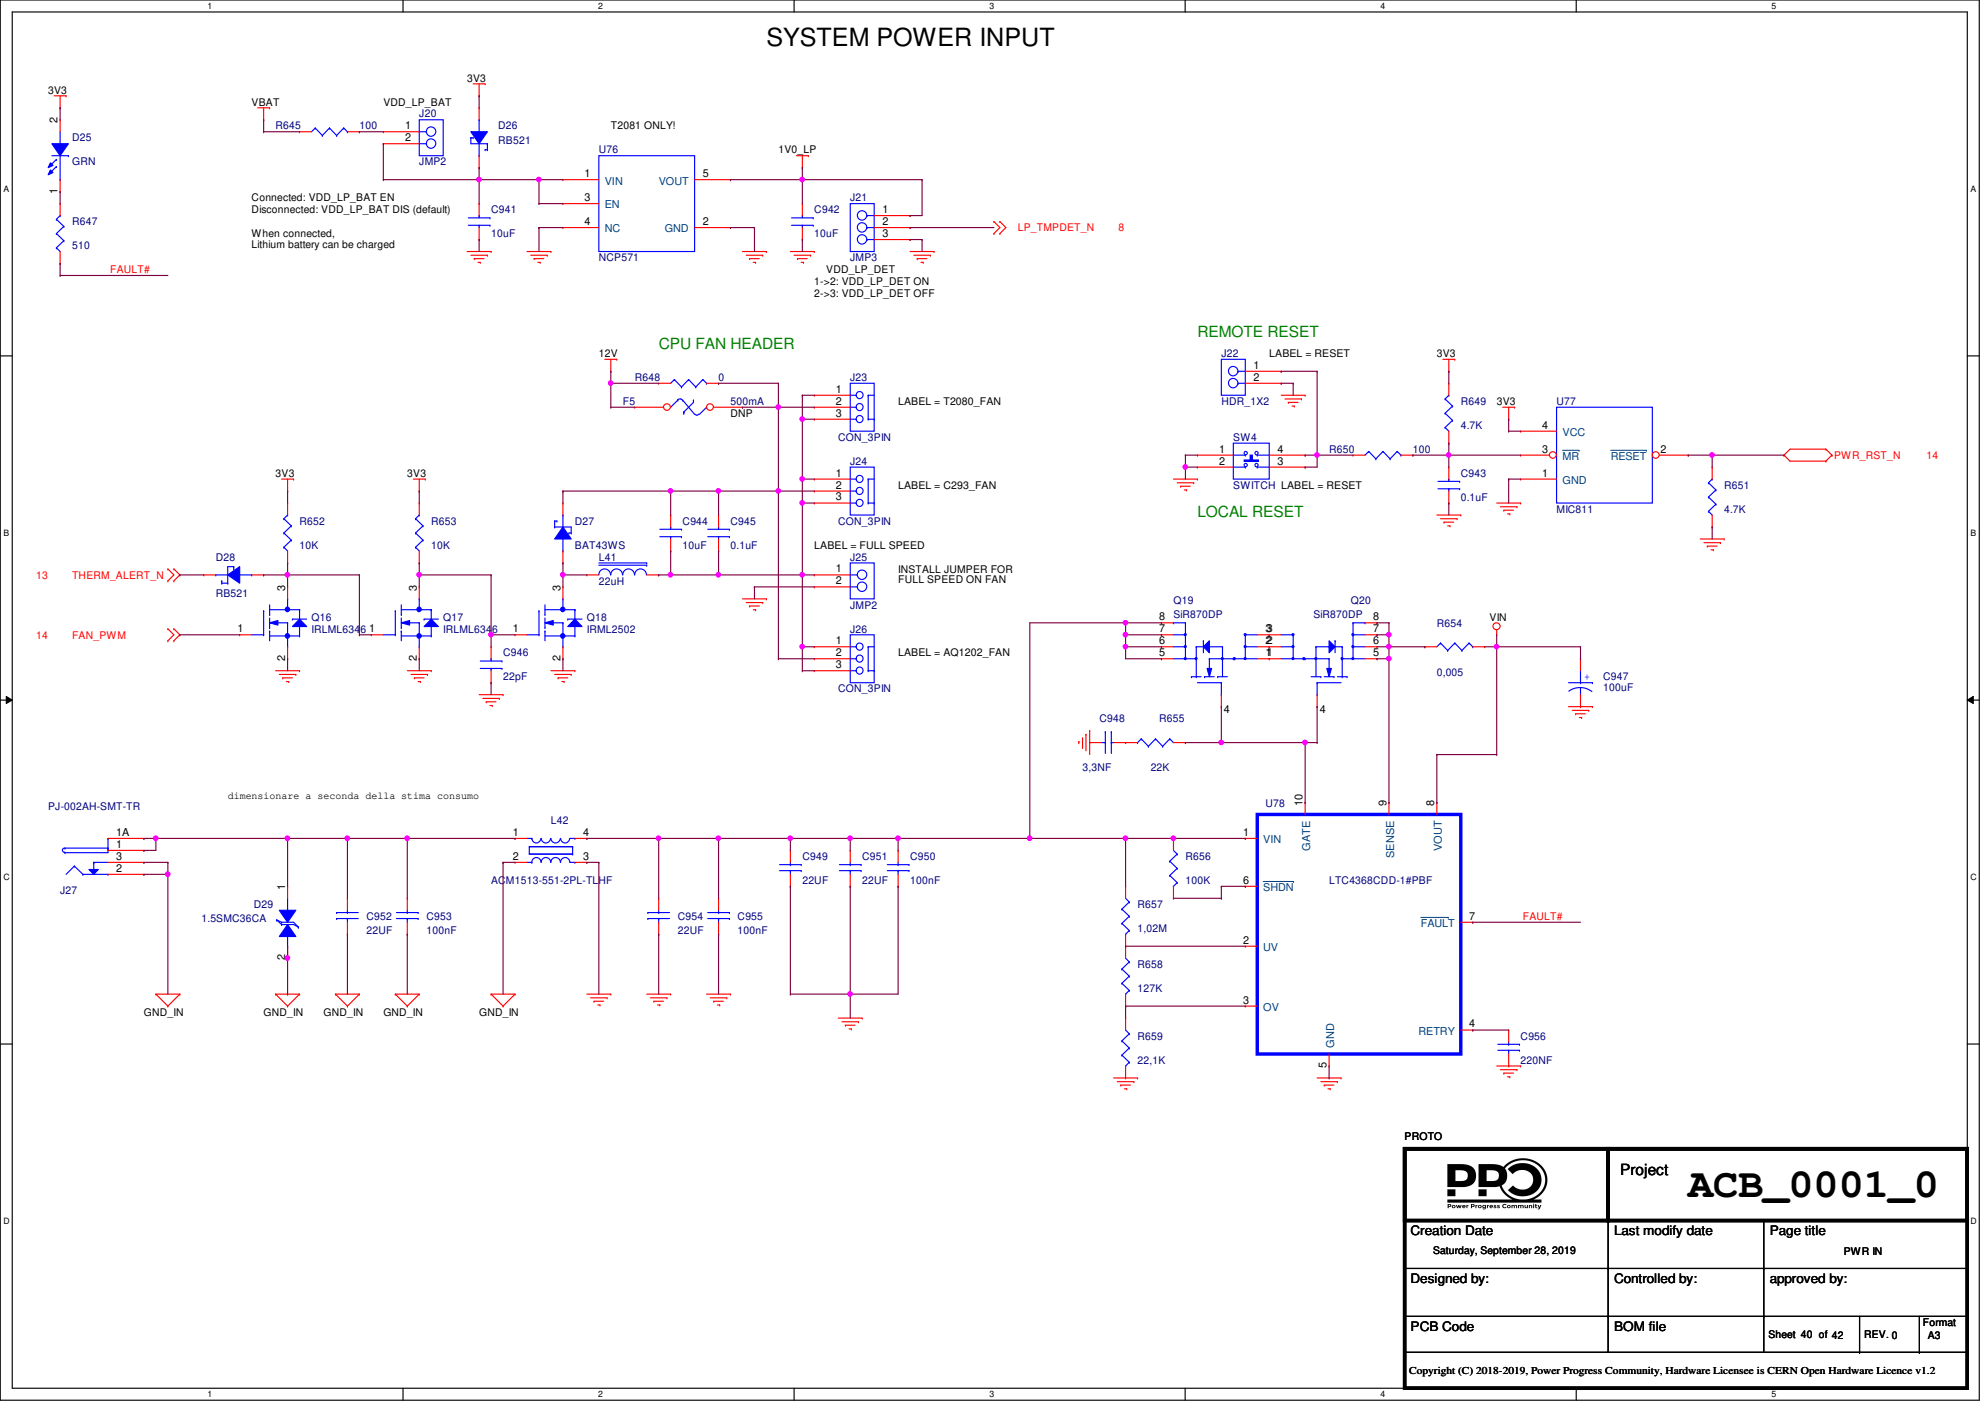
[picture p163: page 40]

When connected,
Lithium battery can be charged

INSTALL JUMPER FOR
FULL SPEED ON FAN

dimensionare a seconda della stima consumo

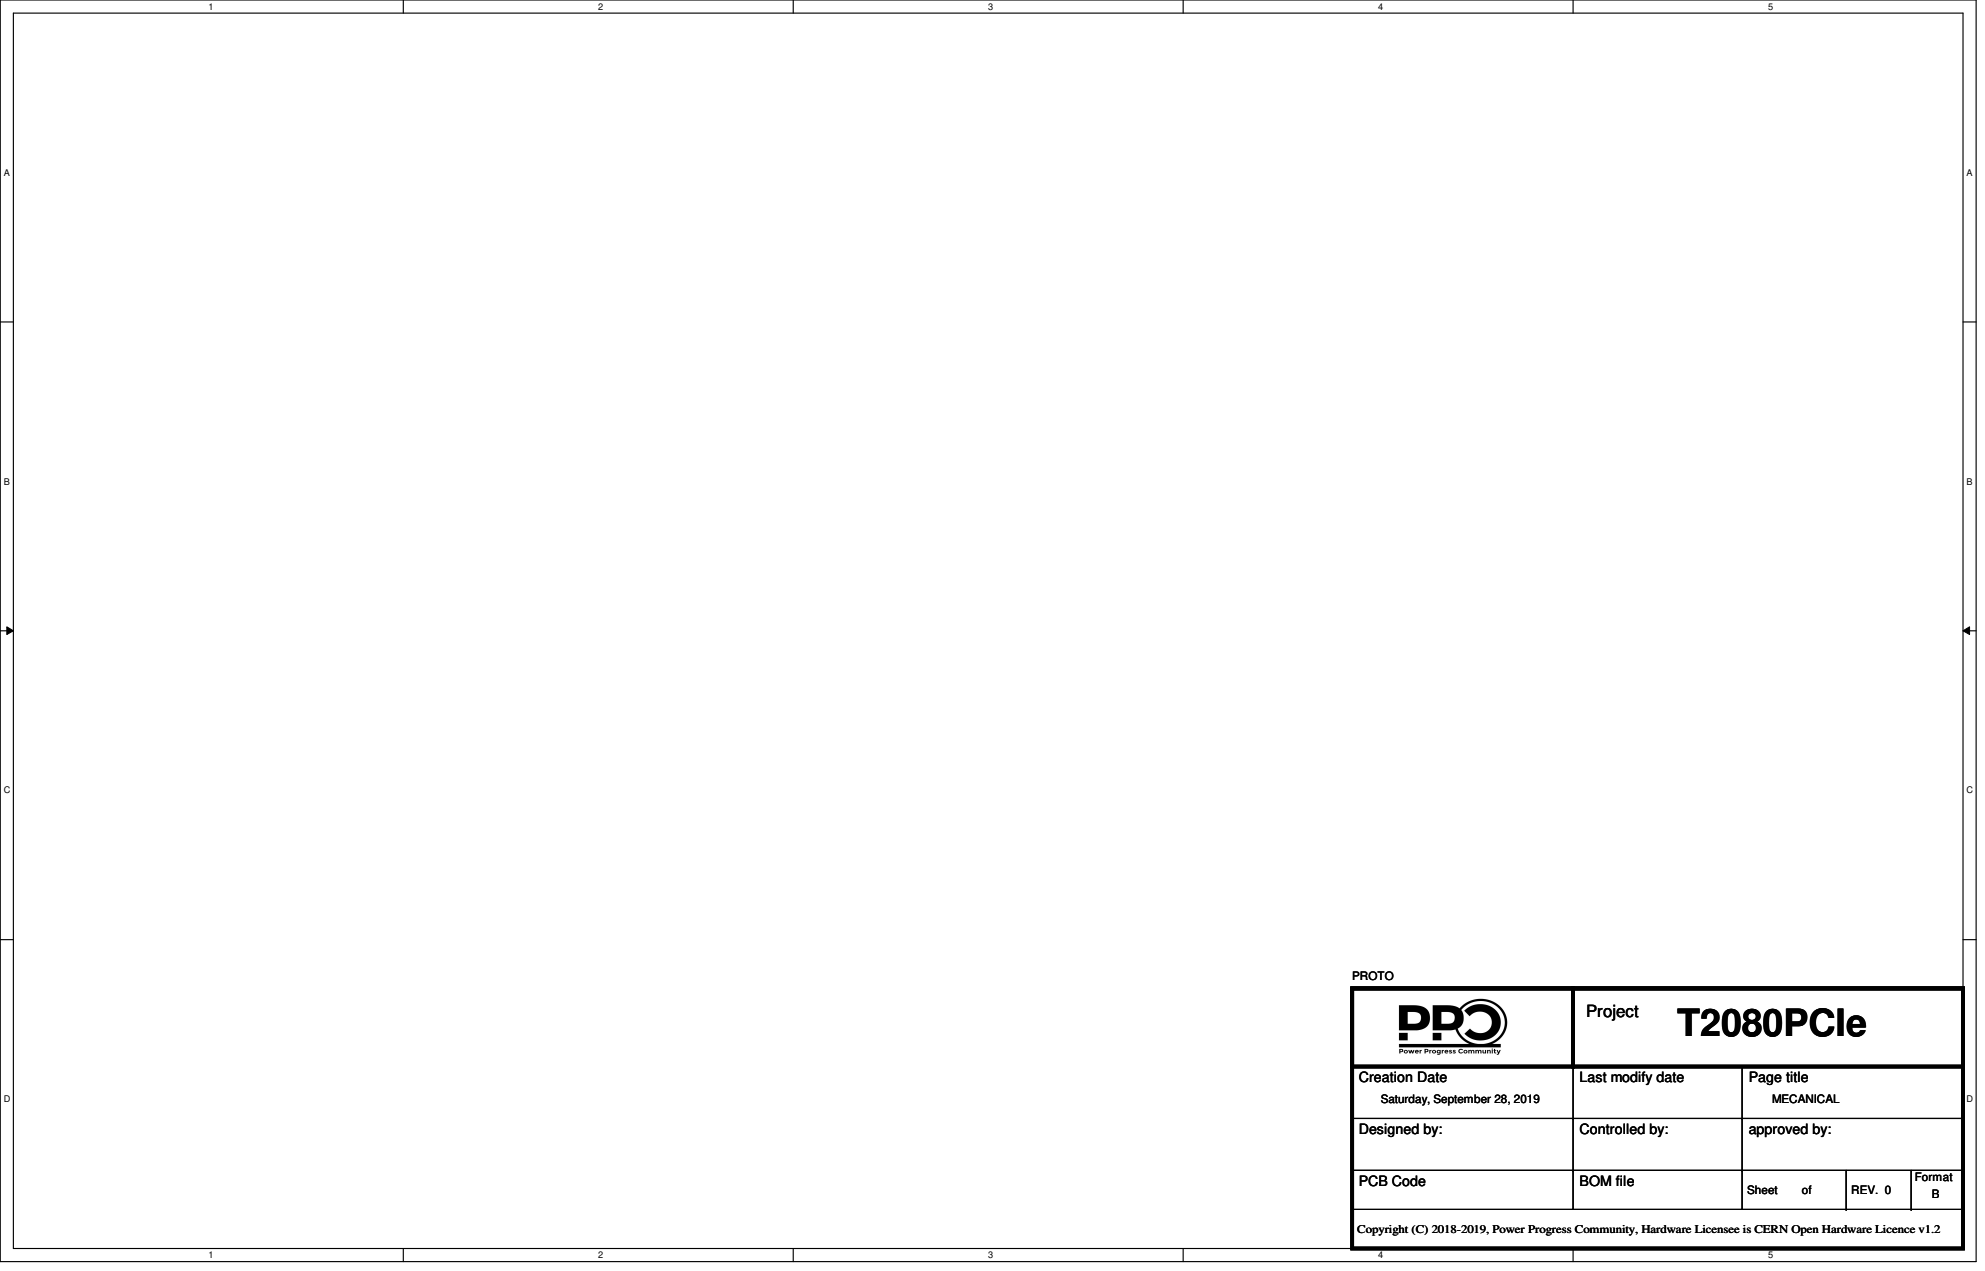
[picture p164: page 41]
Project; Creation Date; Last modify date; Designed by:; Controlled by:; approved by:; PCB Code; BOM file; Sheet; REV.; Format; Page title; MECANICAL; T2080PCIe; Saturday, September 28, 2019; PROTO

Copyright (C) 2018-2019, Power Progress Community, Hardware Licensee is CERN Open Hardware Licence v1.2

# CHANGE LIST

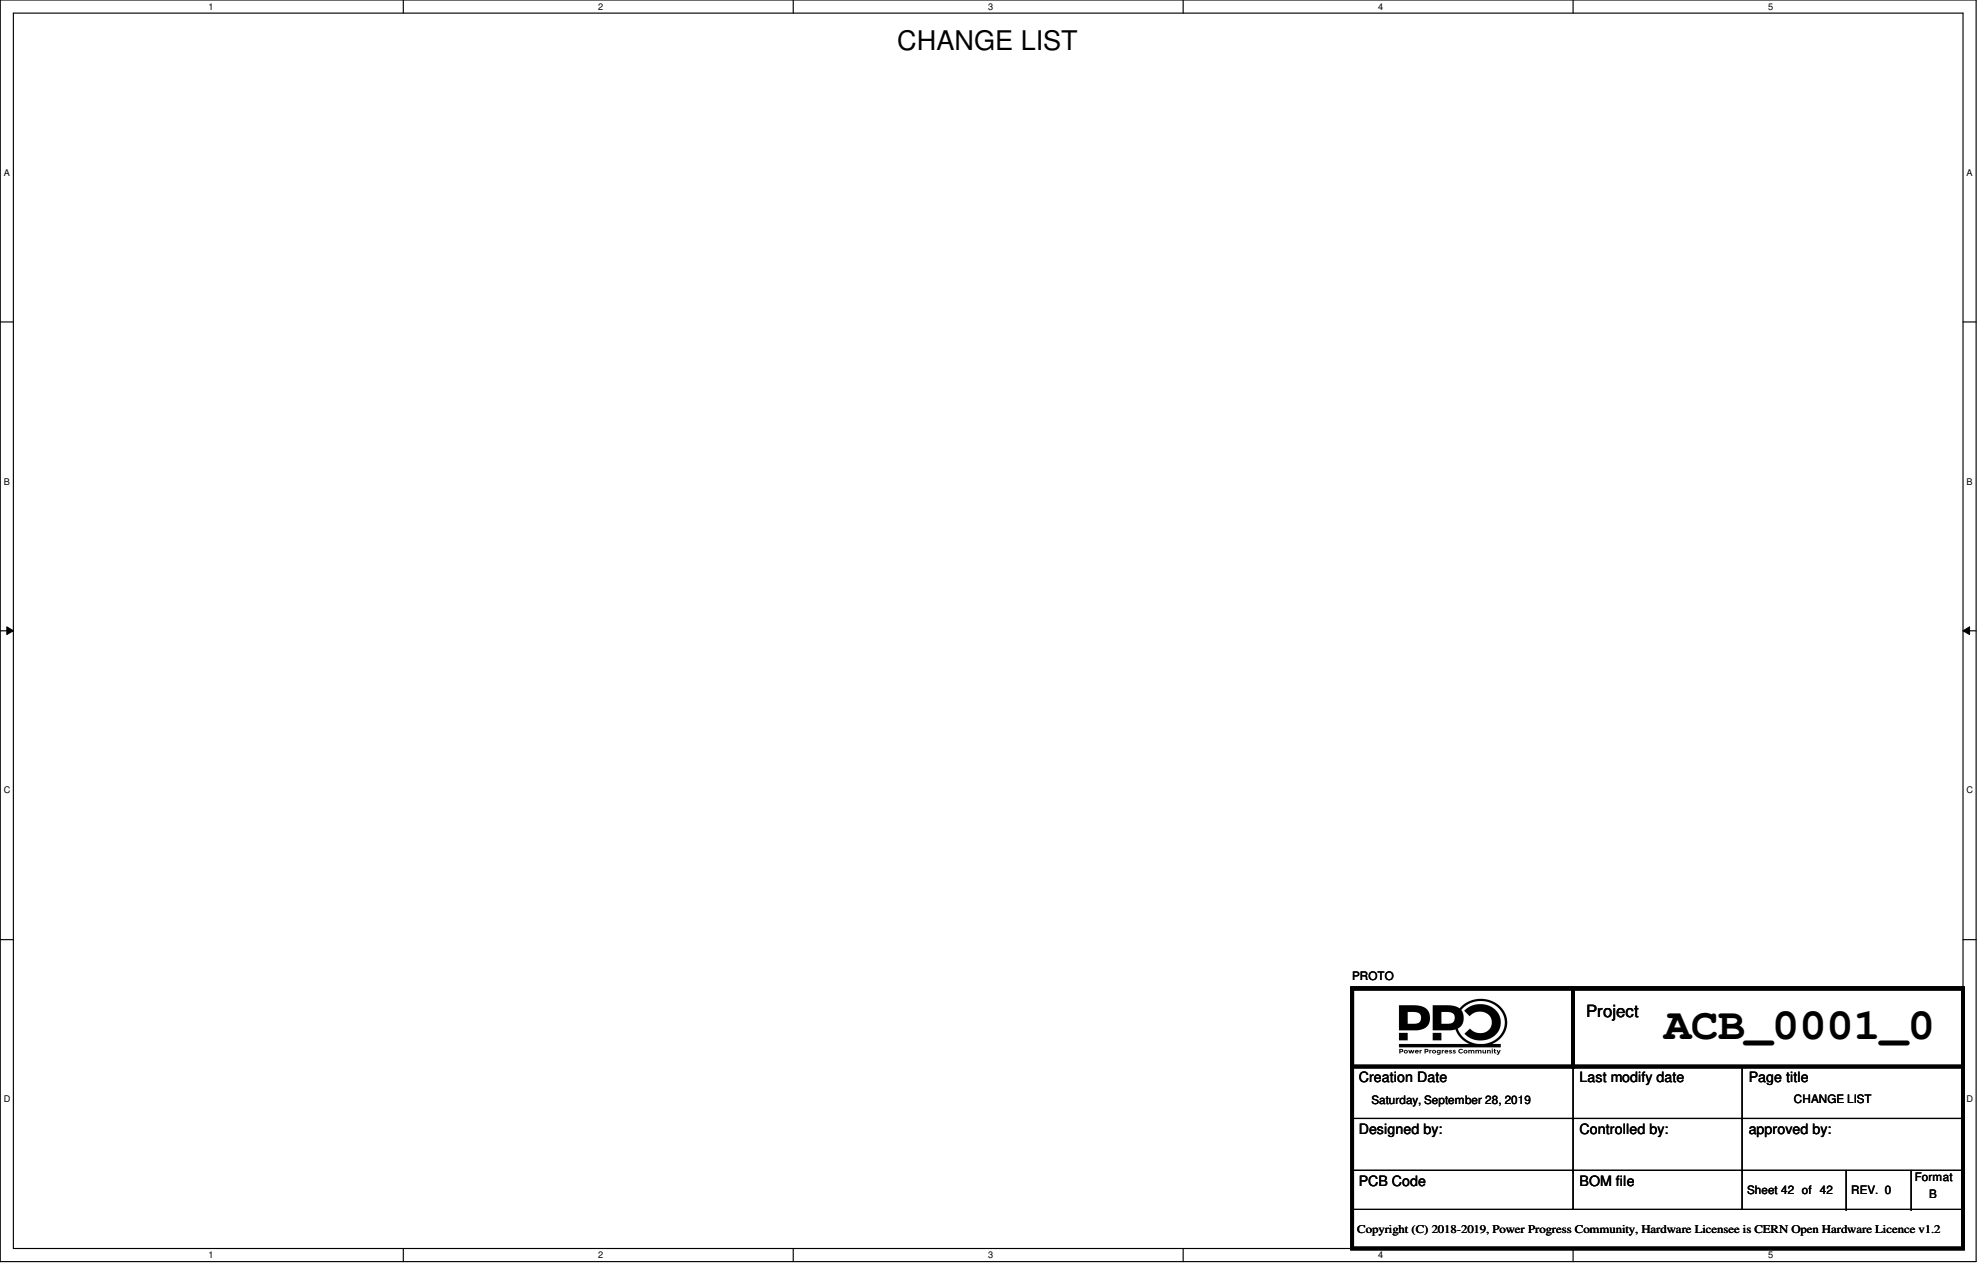
[picture p165: page 42]
ACB_0001_0 Project; Creation Date; Last modify date; Designed by:; Controlled by:; approved by:; PCB Code; BOM file; Sheet; REV.; Format; Page title; CHANGE LIST; Saturday, September 28, 2019; PROTO; Project

Copyright (C) 2018-2019, Power Progress Community, Hardware Licensee is CERN Open Hardware Licence v1.2
