unofficialImportFromGitlab-PPC/powerpc-laptop-mobo/(list of files, drawings)

Other design files:
AltiumDesigner/Imported Mas100n1 ACUBE_PORTABILE R_0.PrjPcb/Mas100n1 ACUBE_PORTABILE R_0.PrjPcb
AltiumDesigner/Imported PPC_notebook_electrical_schematics_v0.6.PrjPcb/01 Page Listing.SchDoc
AltiumDesigner/Imported PPC_notebook_electrical_schematics_v0.6.PrjPcb/02 Block Diagram.SchDoc
AltiumDesigner/Imported PPC_notebook_electrical_schematics_v0.6.PrjPcb/03 DDR3.SchDoc
AltiumDesigner/Imported PPC_notebook_electrical_schematics_v0.6.PrjPcb/03B_DDR3_2.SchDoc
AltiumDesigner/Imported PPC_notebook_electrical_schematics_v0.6.PrjPcb/04 IFC.SchDoc
AltiumDesigner/Imported PPC_notebook_electrical_schematics_v0.6.PrjPcb/05 Flash.SchDoc
AltiumDesigner/Imported PPC_notebook_electrical_schematics_v0.6.PrjPcb/06 SPI&SDHC.SchDoc
AltiumDesigner/Imported PPC_notebook_electrical_schematics_v0.6.PrjPcb/07 SYS.SchDoc
AltiumDesigner/Imported PPC_notebook_electrical_schematics_v0.6.PrjPcb/08 EC&SD.SchDoc
AltiumDesigner/Imported PPC_notebook_electrical_schematics_v0.6.PrjPcb/09 USB.SchDoc
AltiumDesigner/Imported PPC_notebook_electrical_schematics_v0.6.PrjPcb/09A_USB_HUB.SchDoc
AltiumDesigner/Imported PPC_notebook_electrical_schematics_v0.6.PrjPcb/09B KEYBOARD.SchDoc
AltiumDesigner/Imported PPC_notebook_electrical_schematics_v0.6.PrjPcb/09C_KB_LED_AND_LED.SchDoc
AltiumDesigner/Imported PPC_notebook_electrical_schematics_v0.6.PrjPcb/10 UART&I2C.SchDoc
AltiumDesigner/Imported PPC_notebook_electrical_schematics_v0.6.PrjPcb/10B_WRAPPER.SchDoc
AltiumDesigner/Imported PPC_notebook_electrical_schematics_v0.6.PrjPcb/11 Proc Pwr1.SchDoc
AltiumDesigner/Imported PPC_notebook_electrical_schematics_v0.6.PrjPcb/12 Proc Pwr2.SchDoc
AltiumDesigner/Imported PPC_notebook_electrical_schematics_v0.6.PrjPcb/13 Proc Gnd.SchDoc
AltiumDesigner/Imported PPC_notebook_electrical_schematics_v0.6.PrjPcb/14 EC1 PHY.SchDoc
AltiumDesigner/Imported PPC_notebook_electrical_schematics_v0.6.PrjPcb/15_ETHERNET_CONN.SchDoc
AltiumDesigner/Imported PPC_notebook_electrical_schematics_v0.6.PrjPcb/16 SATA3 CONTROLLER.SchDoc
AltiumDesigner/Imported PPC_notebook_electrical_schematics_v0.6.PrjPcb/16B Sata Connectors.SchDoc
AltiumDesigner/Imported PPC_notebook_electrical_schematics_v0.6.PrjPcb/17 USB3 CONTROLLER.SchDoc
AltiumDesigner/Imported PPC_notebook_electrical_schematics_v0.6.PrjPcb/18 USB3_ports.SchDoc
AltiumDesigner/Imported PPC_notebook_electrical_schematics_v0.6.PrjPcb/18B_ETHERNET CARD.SchDoc
AltiumDesigner/Imported PPC_notebook_electrical_schematics_v0.6.PrjPcb/19 PCIE BRIDGE.SchDoc
AltiumDesigner/Imported PPC_notebook_electrical_schematics_v0.6.PrjPcb/19B WLAN_CONNECTOR.SchDoc
AltiumDesigner/Imported PPC_notebook_electrical_schematics_v0.6.PrjPcb/19C_3G_LTE_MODEM.SchDoc
AltiumDesigner/Imported PPC_notebook_electrical_schematics_v0.6.PrjPcb/20 PCIE BRIDGE POWER.SchDoc
AltiumDesigner/Imported PPC_notebook_electrical_schematics_v0.6.PrjPcb/21 MXM_PCIe.SchDoc
AltiumDesigner/Imported PPC_notebook_electrical_schematics_v0.6.PrjPcb/22 MXM_VIDEO_OUT.SchDoc
AltiumDesigner/Imported PPC_notebook_electrical_schematics_v0.6.PrjPcb/23 I2C WRAP.SchDoc
AltiumDesigner/Imported PPC_notebook_electrical_schematics_v0.6.PrjPcb/24 AUDIO CMEDIA.SchDoc
AltiumDesigner/Imported PPC_notebook_electrical_schematics_v0.6.PrjPcb/25 AUDIO_CONN.SchDoc
AltiumDesigner/Imported PPC_notebook_electrical_schematics_v0.6.PrjPcb/26 Clock 1.SchDoc
AltiumDesigner/Imported PPC_notebook_electrical_schematics_v0.6.PrjPcb/27 Clock 2.SchDoc
AltiumDesigner/Imported PPC_notebook_electrical_schematics_v0.6.PrjPcb/28 Core Pwr.SchDoc
AltiumDesigner/Imported PPC_notebook_electrical_schematics_v0.6.PrjPcb/29 Other Pwr 1.SchDoc
AltiumDesigner/Imported PPC_notebook_electrical_schematics_v0.6.PrjPcb/30A Other Pwr 2.SchDoc
AltiumDesigner/Imported PPC_notebook_electrical_schematics_v0.6.PrjPcb/30B Main Power.SchDoc
AltiumDesigner/Imported PPC_notebook_electrical_schematics_v0.6.PrjPcb/30C_battery_Charger.SchDoc
AltiumDesigner/Imported PPC_notebook_electrical_schematics_v0.6.PrjPcb/31 Pwr In.SchDoc
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
